ThrudTheBarbarian/pbxl/website/pbxl.rw/Pages/2-Progress/Data/AEAC4389-E904-44D9-B1DD-189116DEF3CA.jpg

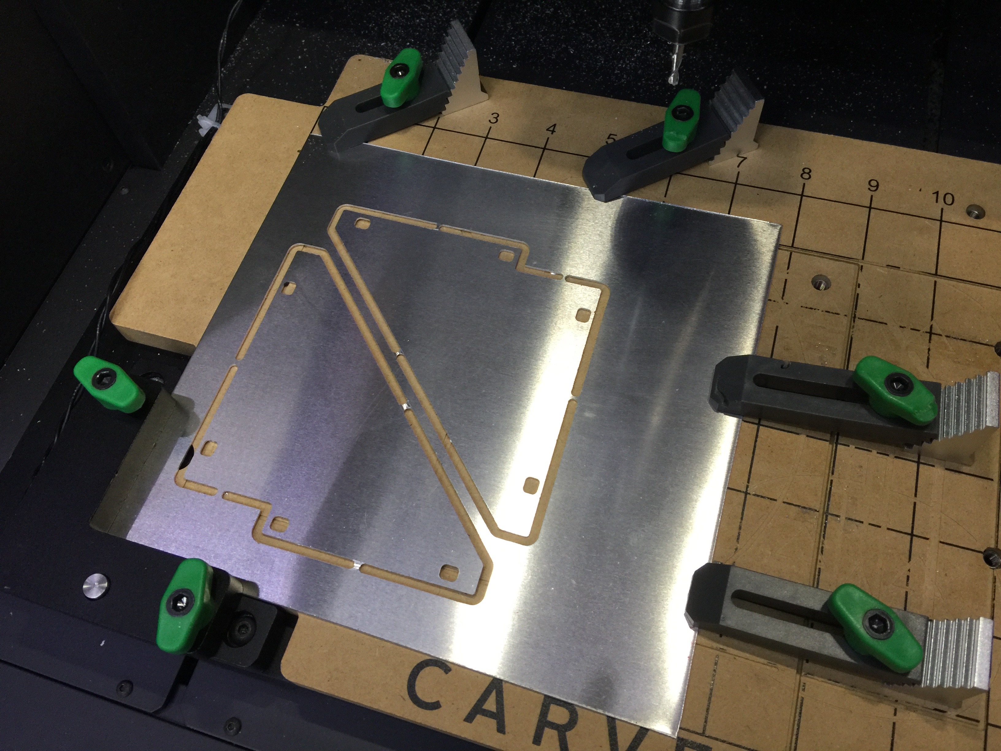
website/pbxl.rw/Pages/2-Progress/Data/AEAC4389-E904-44D9-B1DD-189116DEF3CA.jpg
