ThrudTheBarbarian/pbxl/website/pbxl.rw/Pages/6-The-enclosure/Data/C4889342-5B7F-4F15-AAC2-C0760A052CDE.jpg

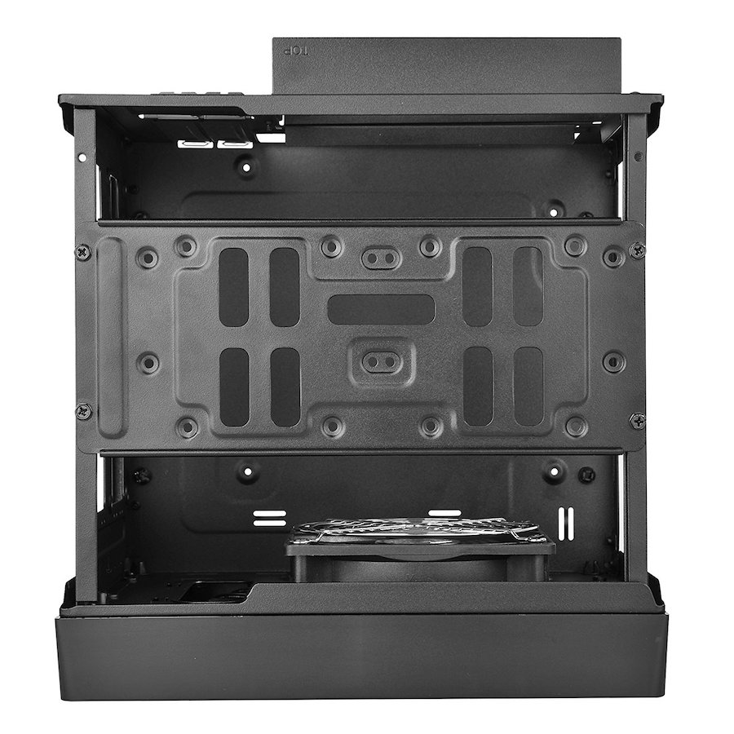
website/pbxl.rw/Pages/6-The-enclosure/Data/C4889342-5B7F-4F15-AAC2-C0760A052CDE.jpg
