ThrudTheBarbarian/pbxl/README.md

# pbxl
Experiment in using an XMOS chip for a low latency serial connection to enable a parallel bus expansion on the Atari XL/XE

# Website
This is very much a work-in-progress, but the website rendered from the source herein [is available here](http://pbxl.oobergeek.net/)
