ThrudTheBarbarian/pbxl/hw/pbxl/pbxl.runs/impl_1/.init_design.begin.rst

<?xml version="1.0"?>
<ProcessHandle Version="1" Minor="0">
    <Process Command=".planAhead." Owner="simon" Host="Vivado" Pid="18662">
    </Process>
</ProcessHandle>
