ThrudTheBarbarian/pbxl/hw/pbxl/pbxl.runs/impl_1/.vivado.begin.rst

<?xml version="1.0"?>
<ProcessHandle Version="1" Minor="0">
    <Process Command="vivado" Owner="simon" Host="Vivado" Pid="18620">
    </Process>
</ProcessHandle>
