ThrudTheBarbarian/pbxl/boards/xe-exerciser/xmosio1.png

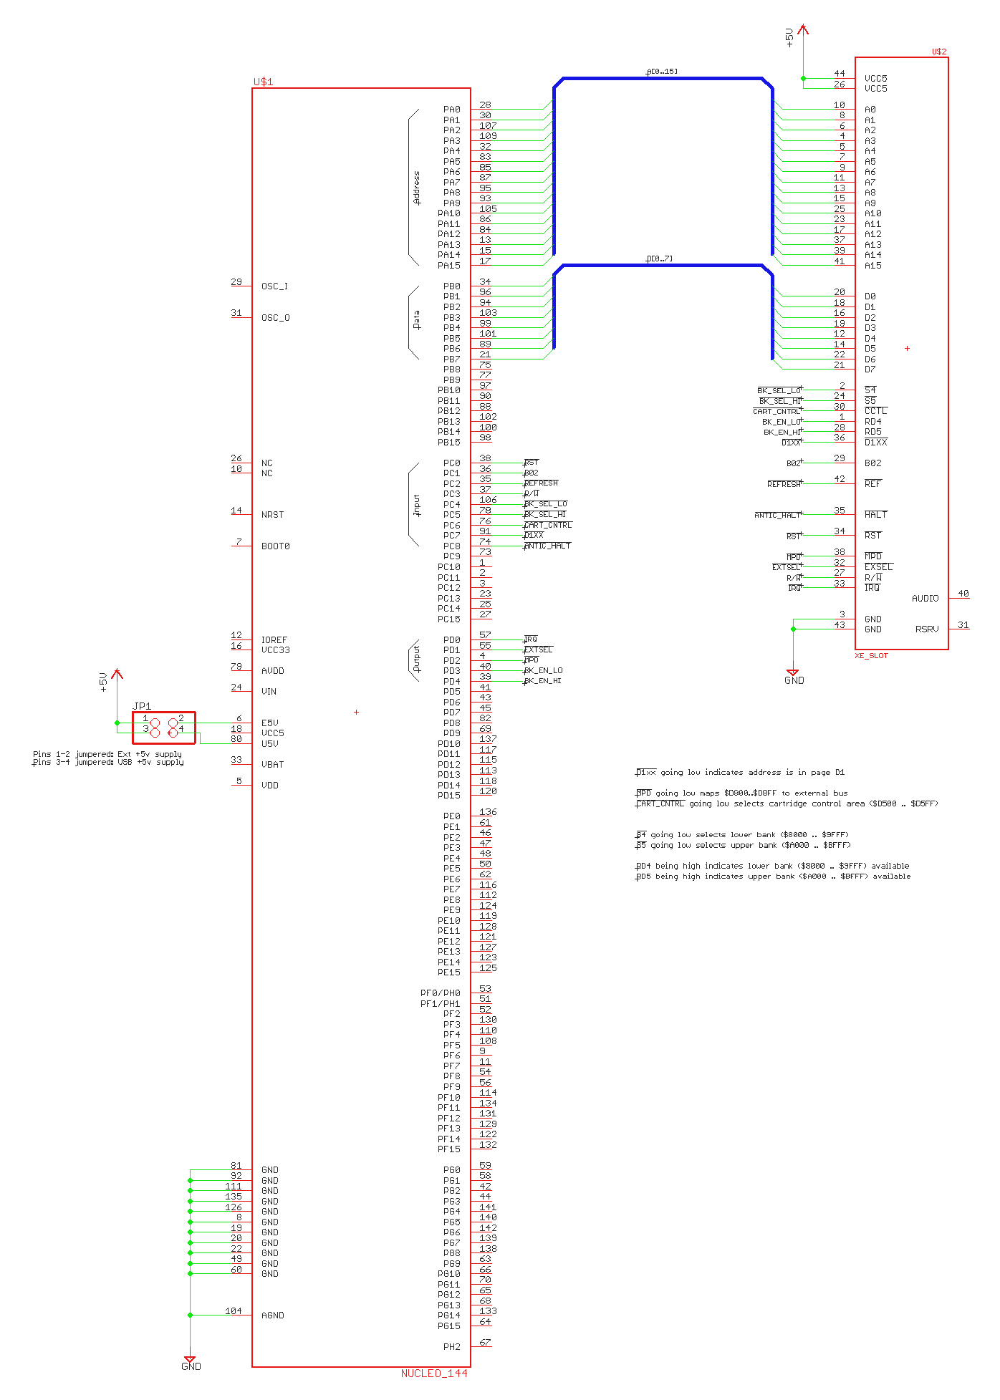
boards/xe-exerciser/xmosio1.png
