ThrudTheBarbarian/pbxl/boards/xio2/psu/3v3.png

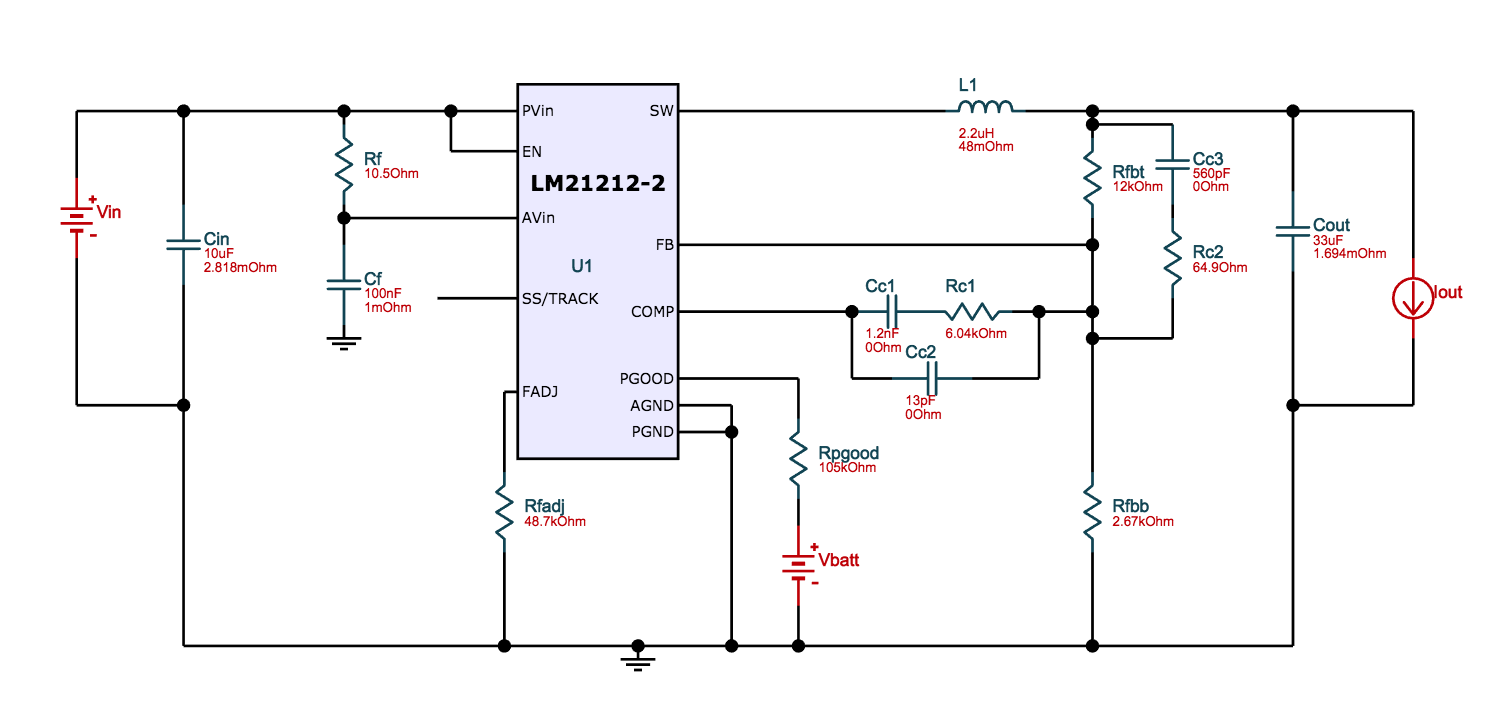
boards/xio2/psu/3v3.png
