ThrudTheBarbarian/pbxl/imgs/xlpb-busIO-rev0.png

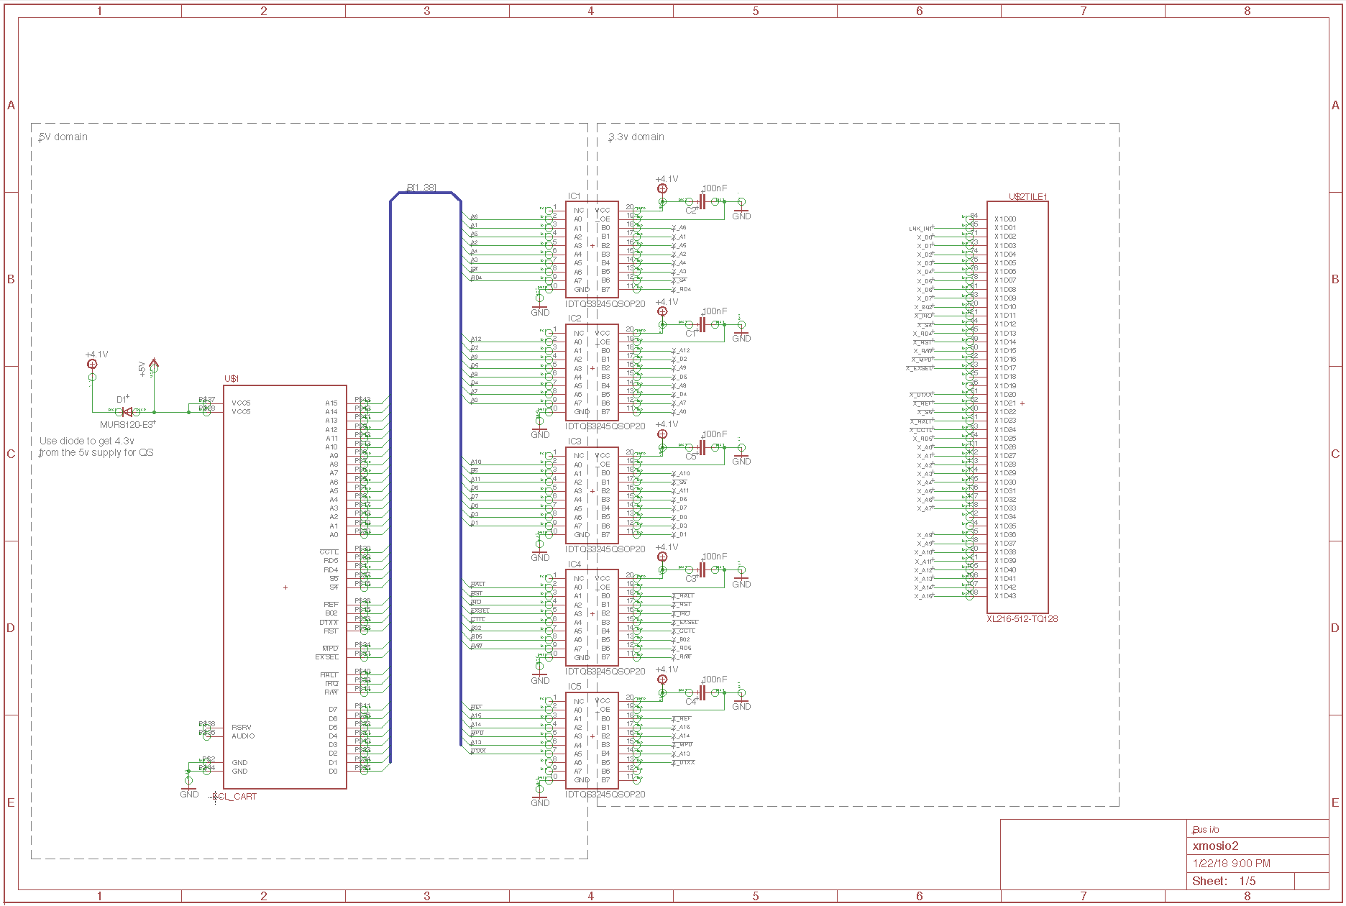
imgs/xlpb-busIO-rev0.png
