ThrudTheBarbarian/pbxl/imgs/xlpb-jtag-rev0.png

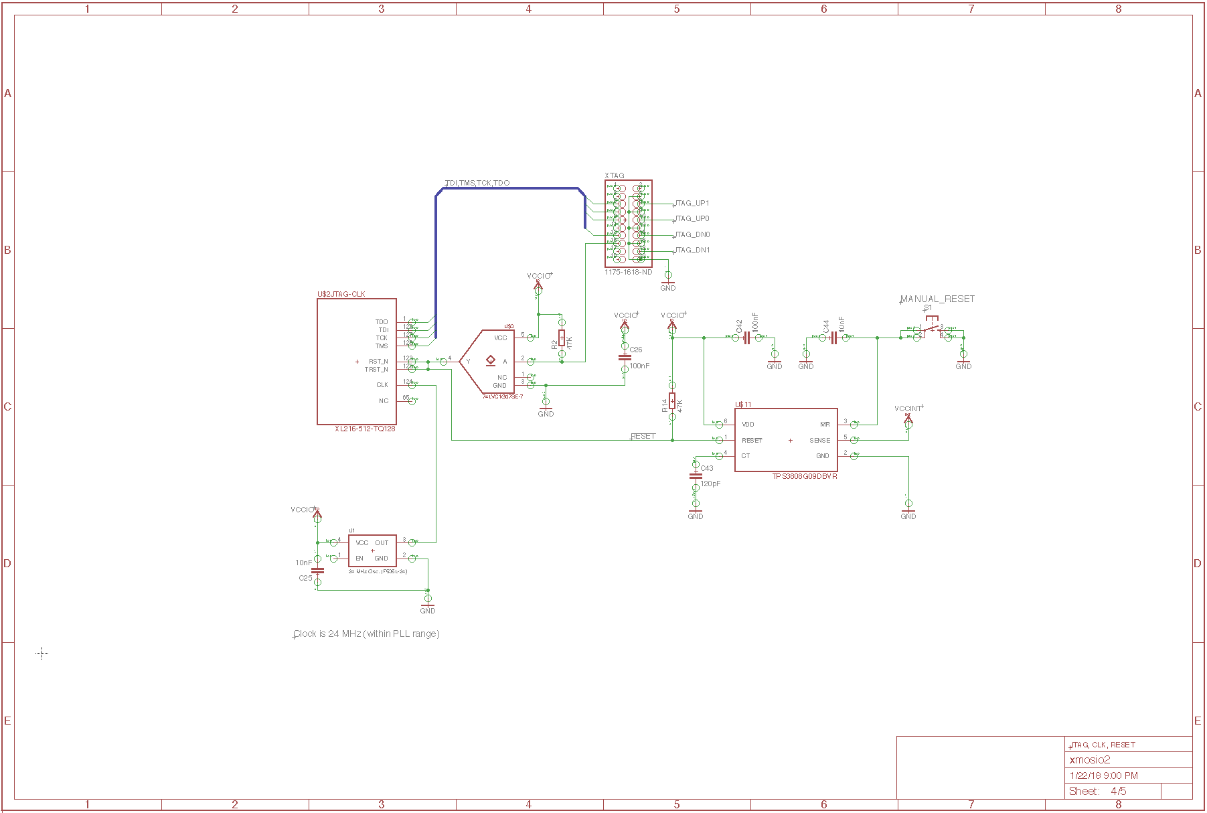
imgs/xlpb-jtag-rev0.png
