ThrudTheBarbarian/pbxl/imgs/xlpb-link-rev0.png

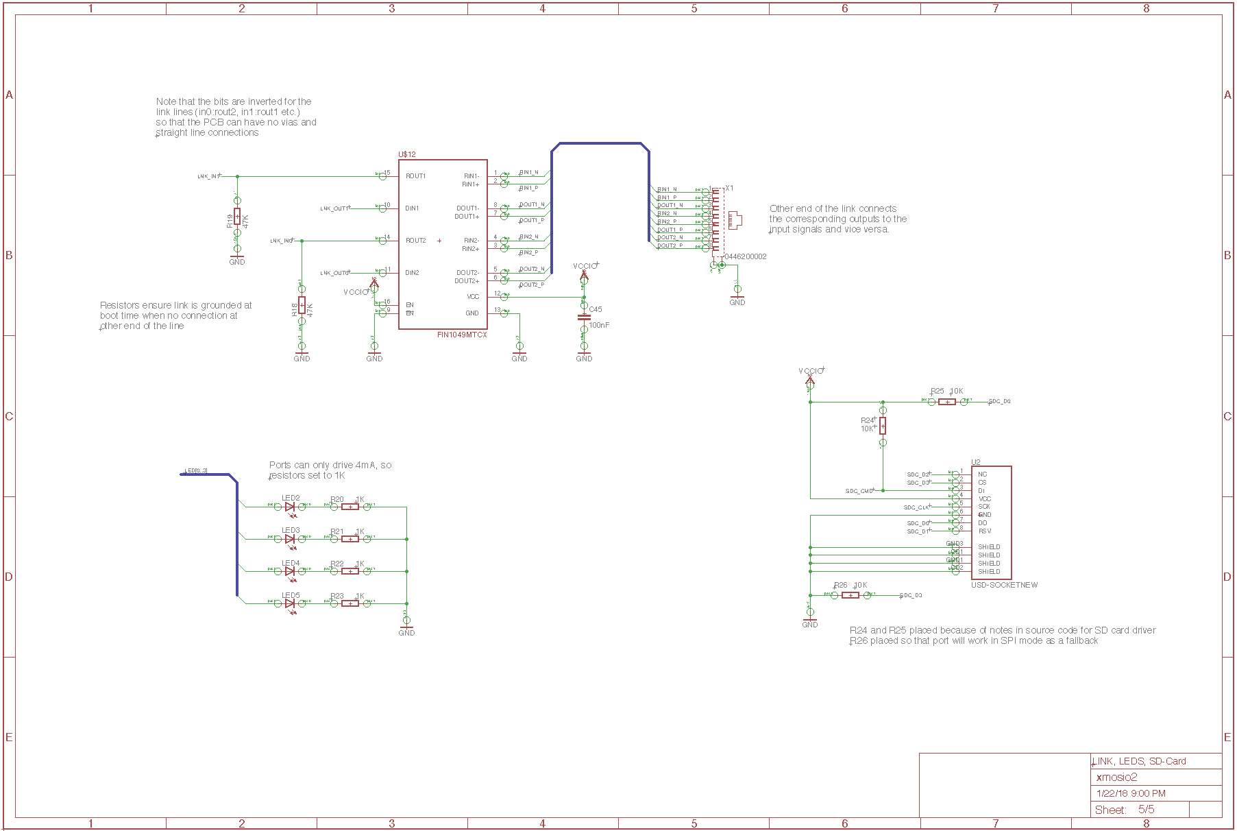
imgs/xlpb-link-rev0.png
