ThrudTheBarbarian/pbxl/imgs/xlpb-memory-rev0.png

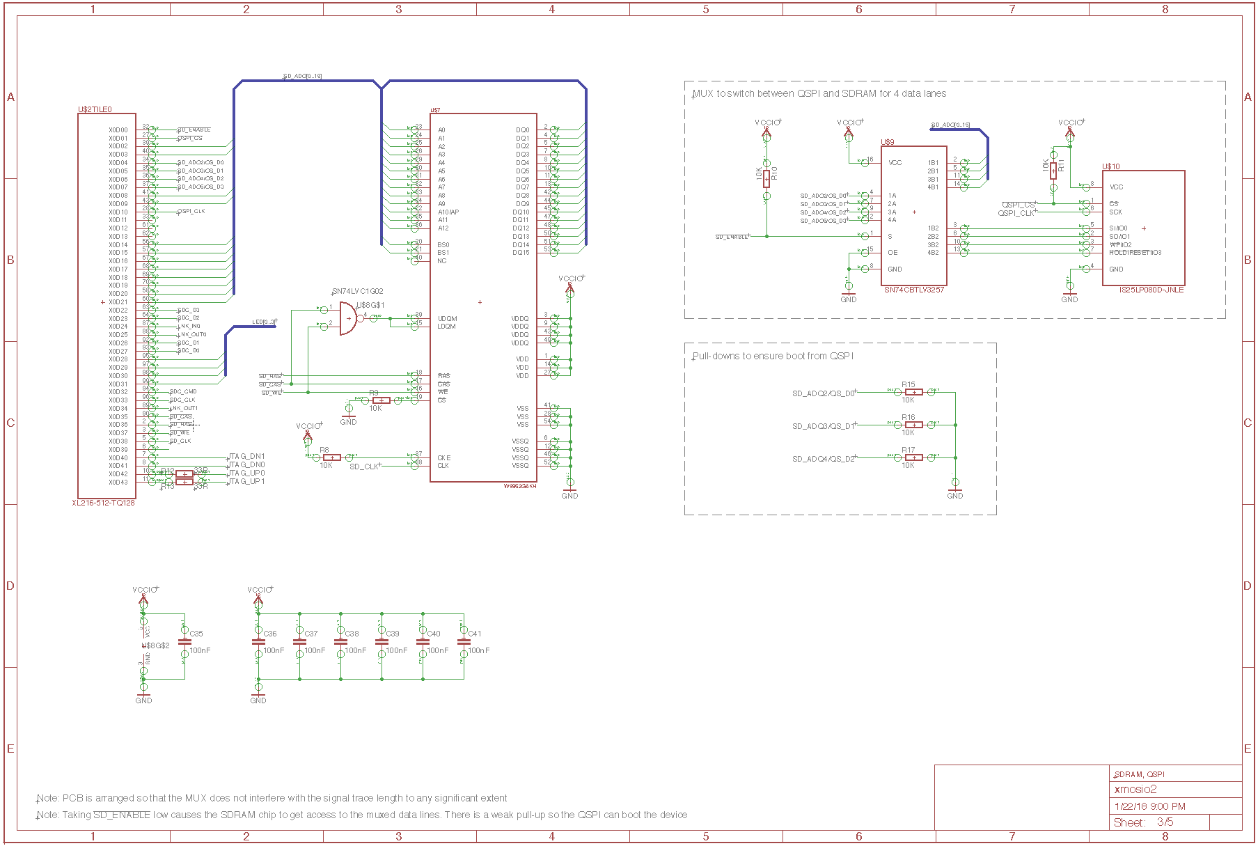
imgs/xlpb-memory-rev0.png
