ThrudTheBarbarian/pbxl/imgs/xlpb-memory-rev1.png

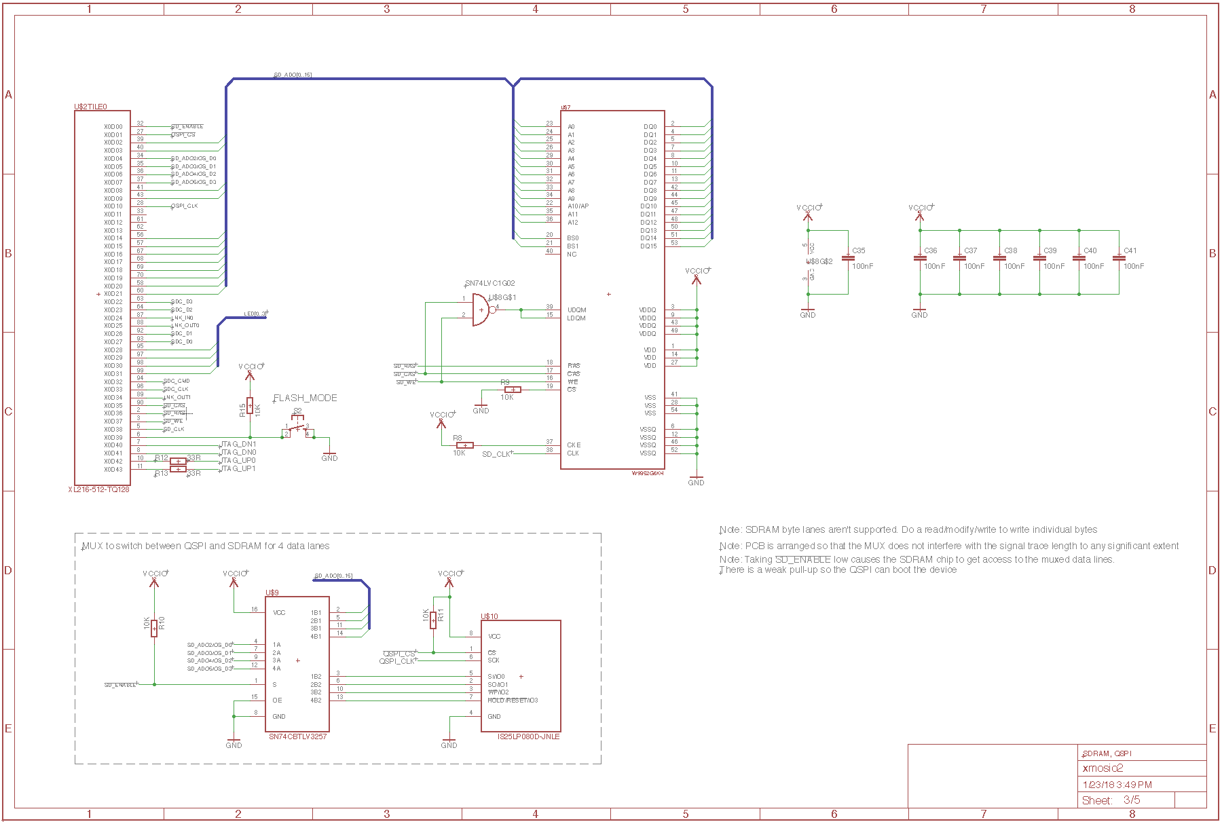
imgs/xlpb-memory-rev1.png
