ThrudTheBarbarian/pbxl/imgs/xlpb-power-rev0.png

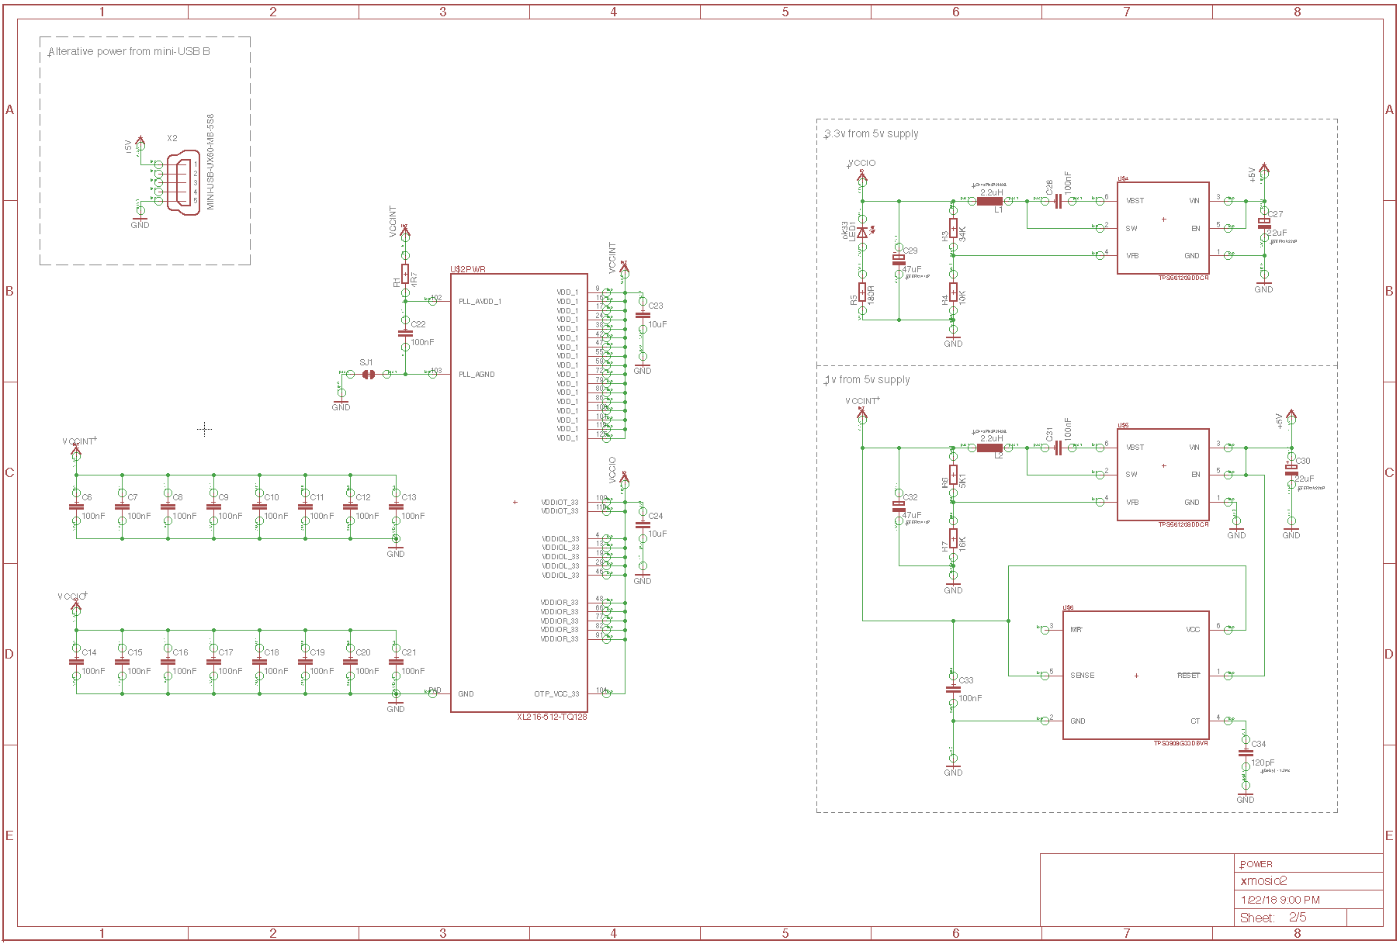
imgs/xlpb-power-rev0.png
