ThrudTheBarbarian/pbxl/imgs/xlpb-power-rev1.png

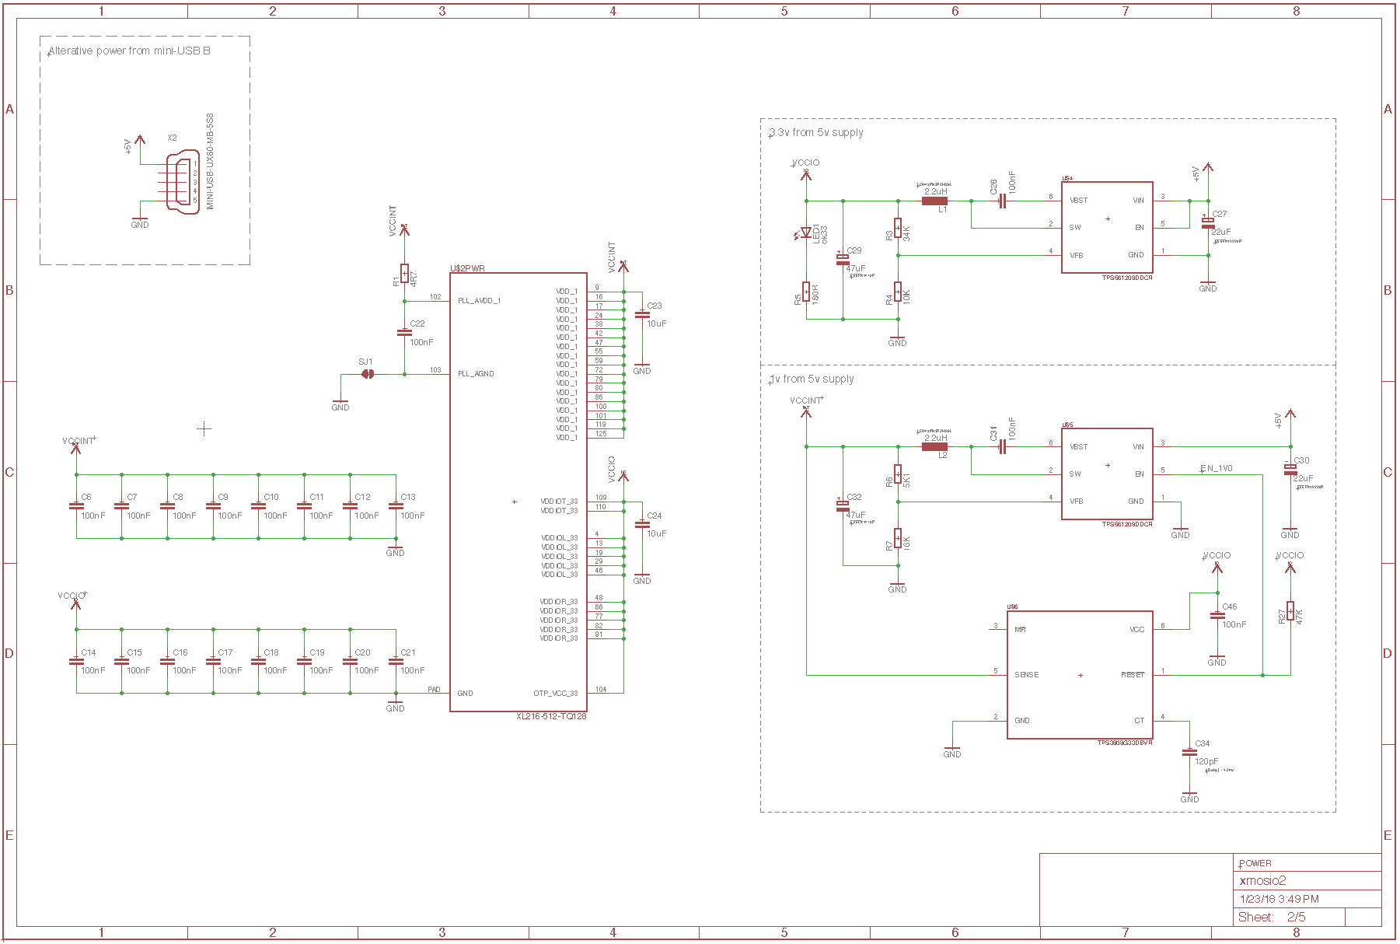
imgs/xlpb-power-rev1.png
