ThrudTheBarbarian/pbxl/imgs/xlpb-routed-board-rev1.png

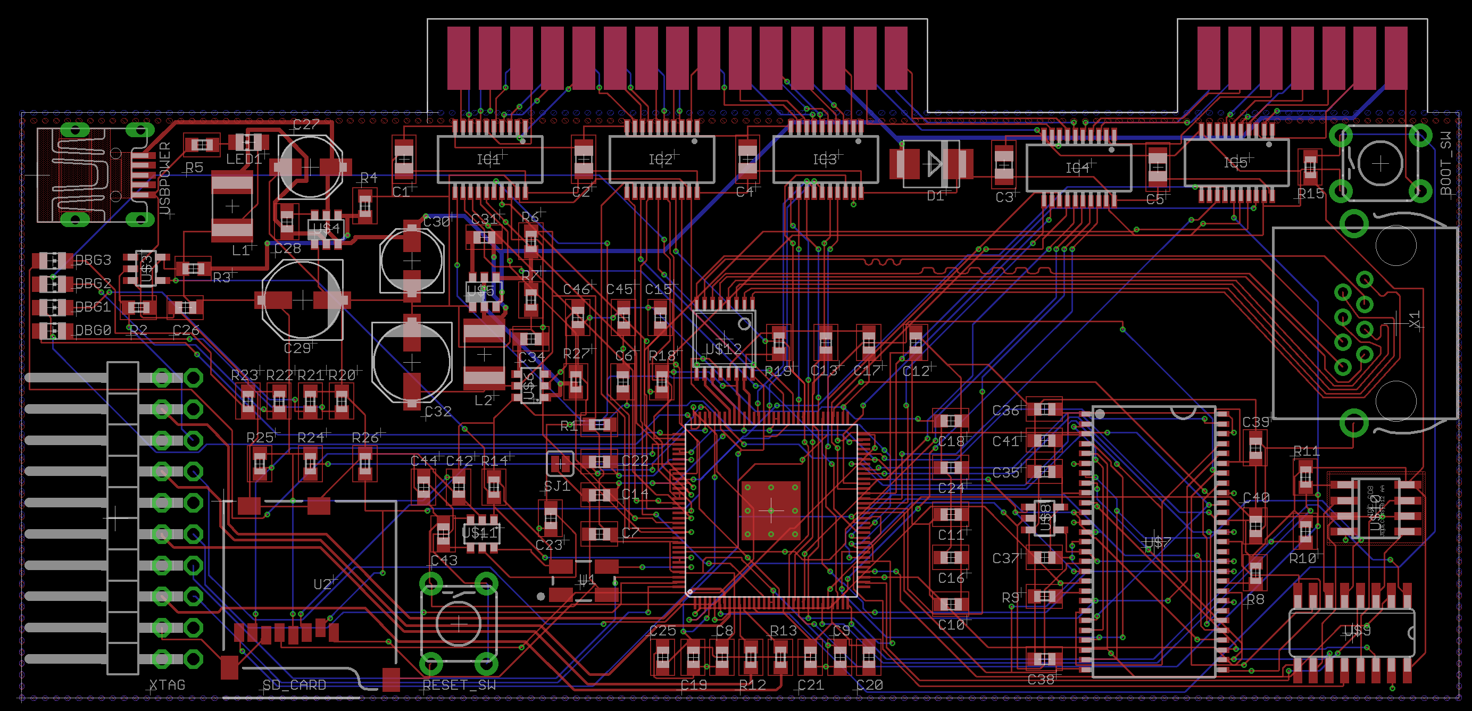
imgs/xlpb-routed-board-rev1.png
