ThrudTheBarbarian/pbxl/imgs/zoomed-in-route.png

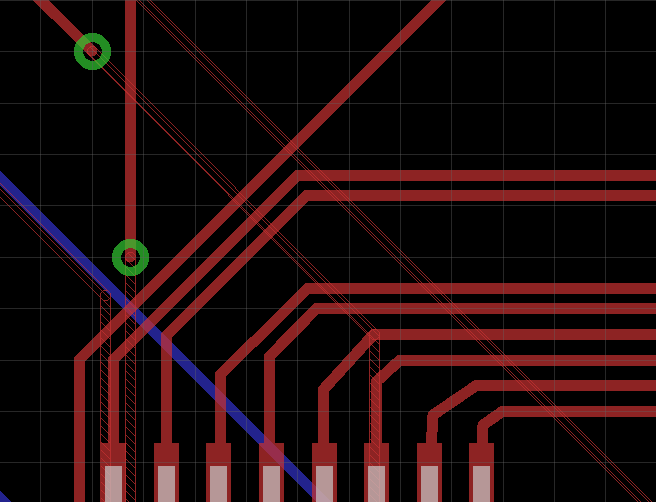
imgs/zoomed-in-route.png
