ThrudTheBarbarian/pbxl/website/pbxl.rw/Pages/2-Progress/Data/1A350FC6-FAAA-49F8-BF6E-91D656A8CBC7.png

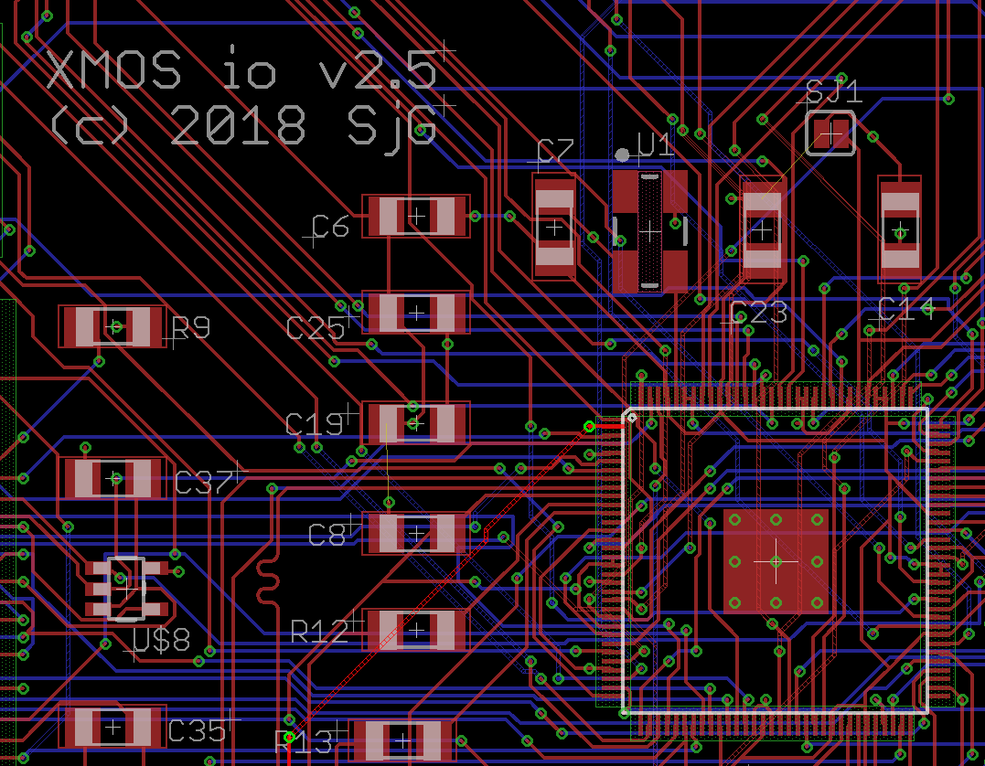
website/pbxl.rw/Pages/2-Progress/Data/1A350FC6-FAAA-49F8-BF6E-91D656A8CBC7.png
