ThrudTheBarbarian/pbxl/website/pbxl.rw/Pages/2-Progress/Data/1B0F9AB8-F616-453C-8693-A7A7A7DEBB77.png

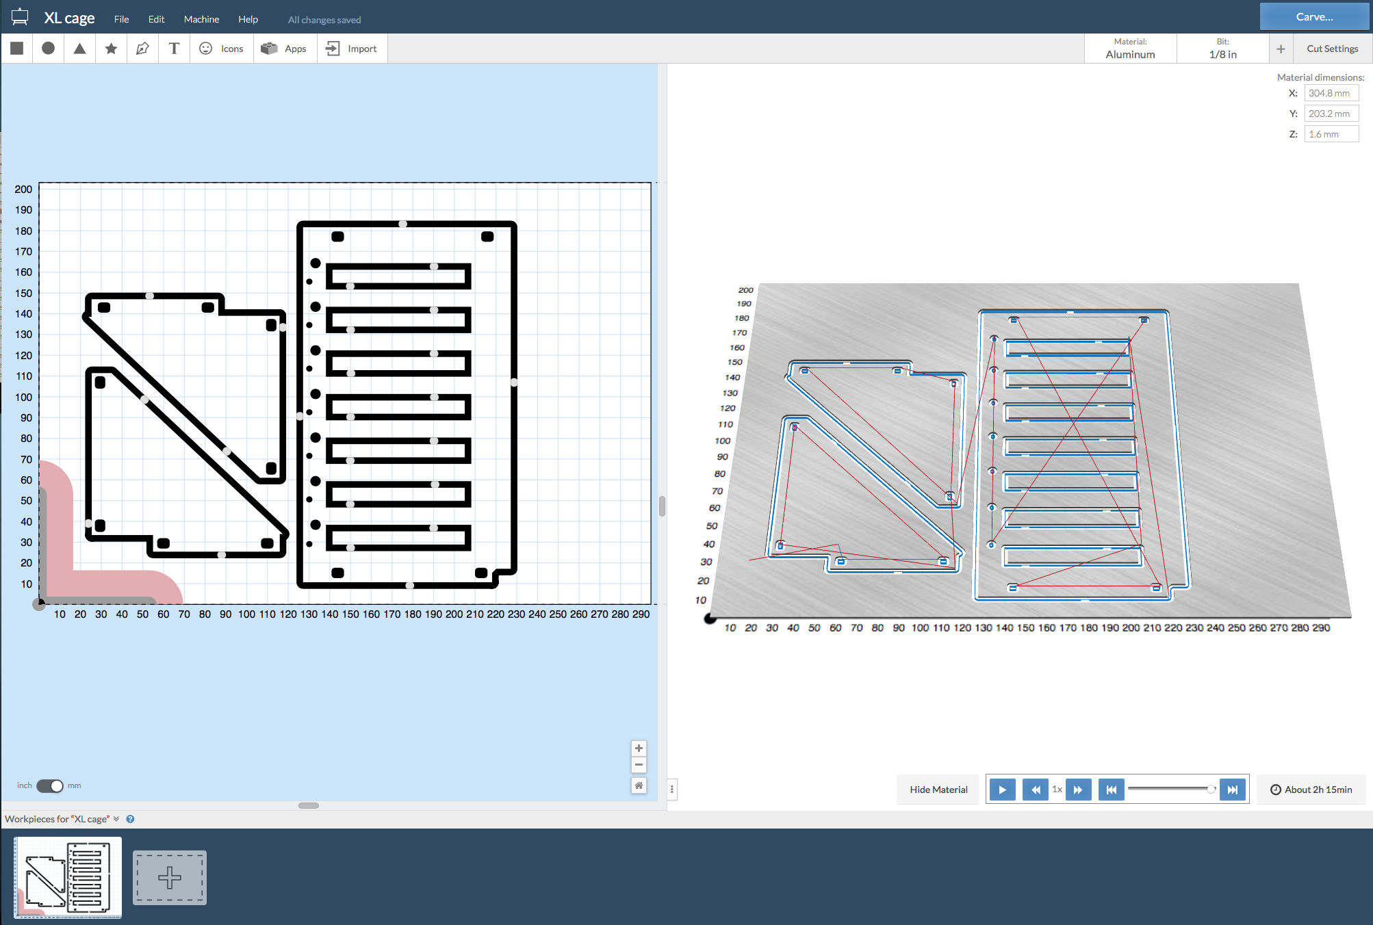
website/pbxl.rw/Pages/2-Progress/Data/1B0F9AB8-F616-453C-8693-A7A7A7DEBB77.png
