ThrudTheBarbarian/pbxl/website/pbxl.rw/Pages/2-Progress/Data/1C7E738A-D3AA-4D1F-9418-3796041D196C.png

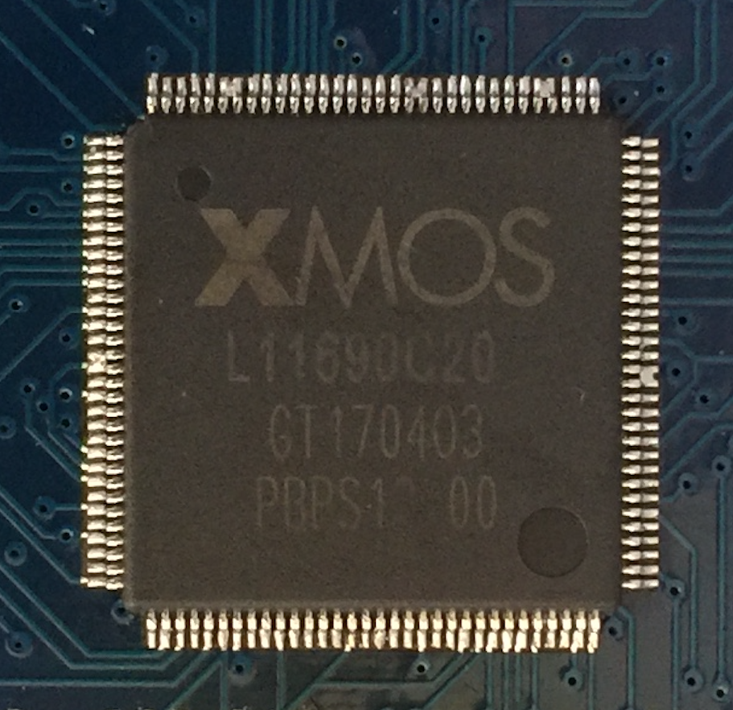
website/pbxl.rw/Pages/2-Progress/Data/1C7E738A-D3AA-4D1F-9418-3796041D196C.png
