ThrudTheBarbarian/pbxl/website/pbxl.rw/Pages/2-Progress/Data/3DAB0634-6217-4E3C-A701-534463F90A3D.jpg

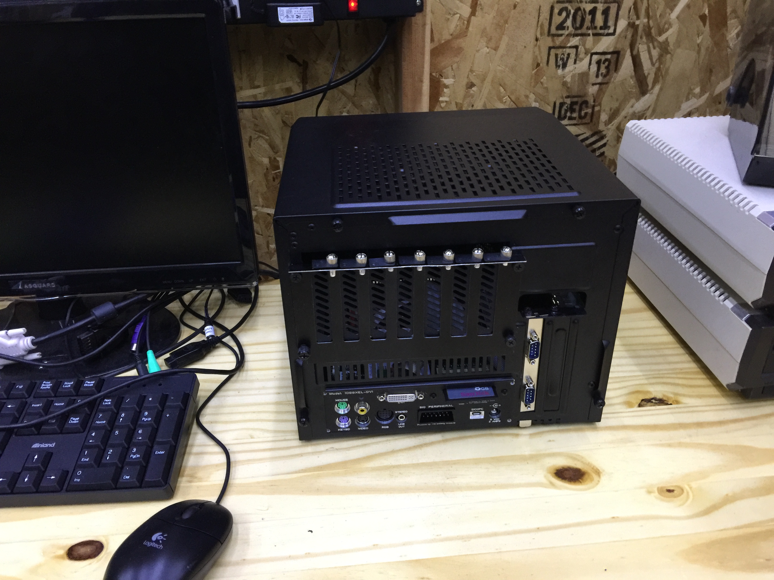
website/pbxl.rw/Pages/2-Progress/Data/3DAB0634-6217-4E3C-A701-534463F90A3D.jpg
