ThrudTheBarbarian/pbxl/website/pbxl.rw/Pages/2-Progress/Data/3F3F6195-A5A8-46CB-91DC-41BE8269B786.jpg

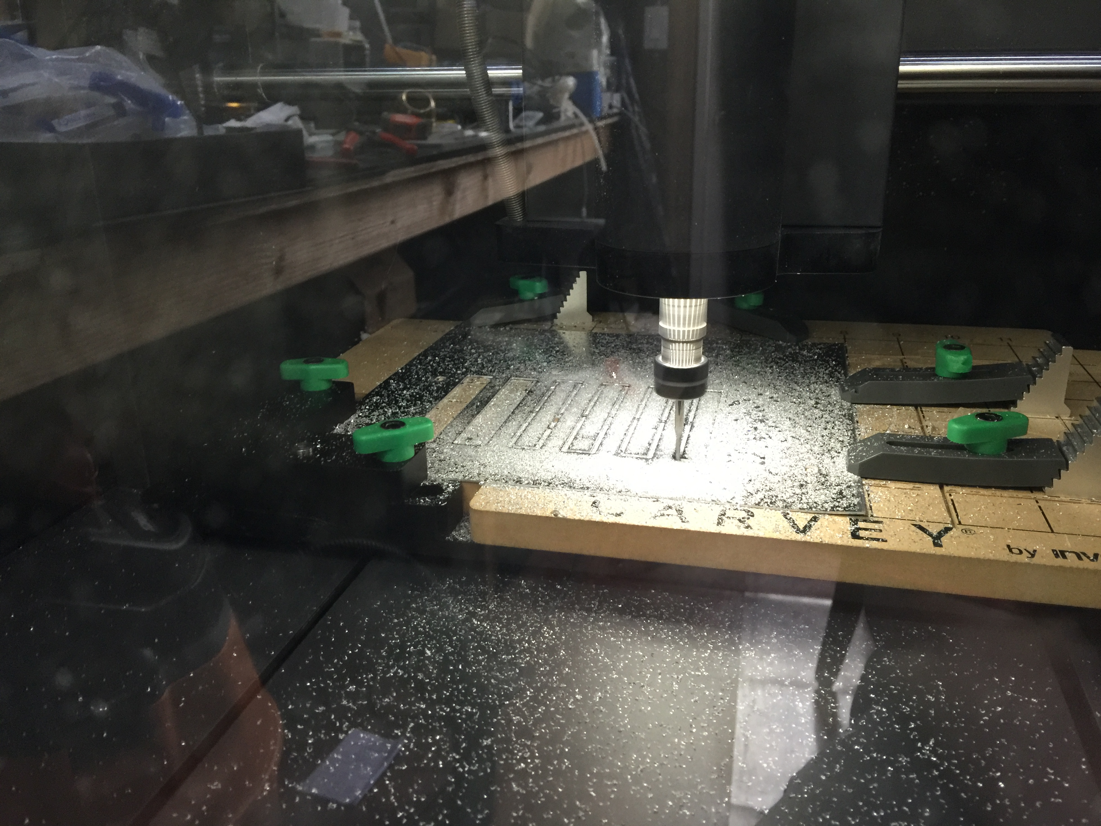
website/pbxl.rw/Pages/2-Progress/Data/3F3F6195-A5A8-46CB-91DC-41BE8269B786.jpg
