ThrudTheBarbarian/pbxl/website/pbxl.rw/Pages/2-Progress/Data/3F03274B-317E-43D0-84CB-64CE96064F75.jpg

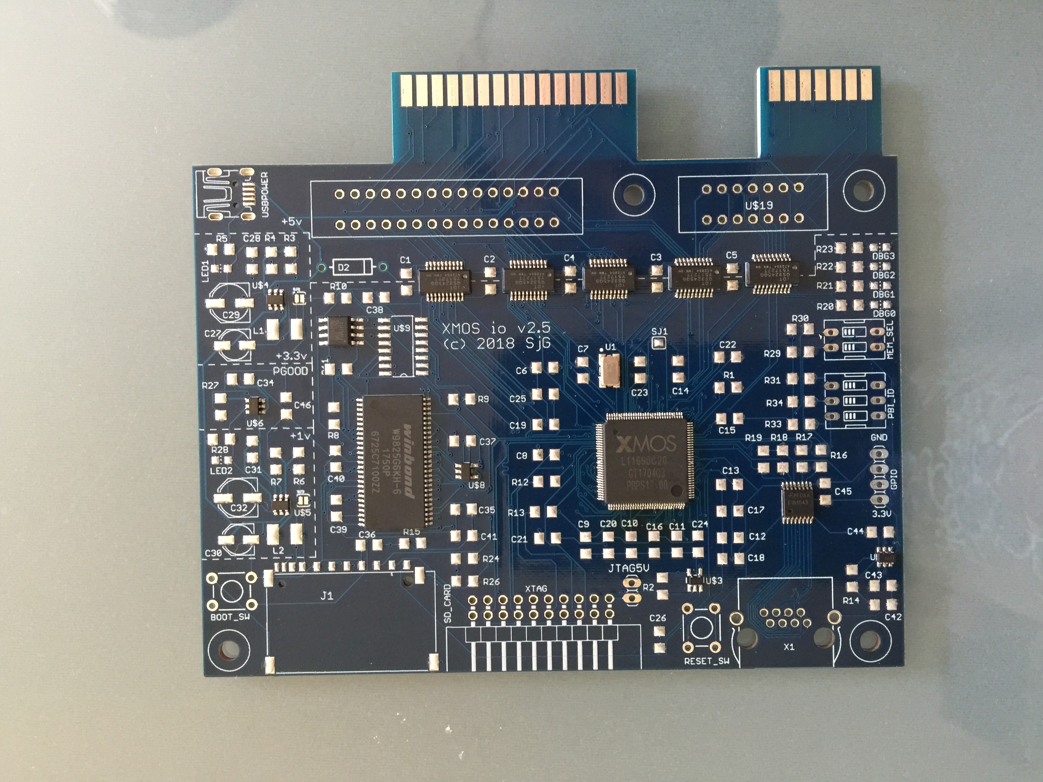
website/pbxl.rw/Pages/2-Progress/Data/3F03274B-317E-43D0-84CB-64CE96064F75.jpg
