ThrudTheBarbarian/pbxl/website/pbxl.rw/Pages/2-Progress/Data/5CC2CB33-A0F2-4685-B665-45586ACAD55F.jpg

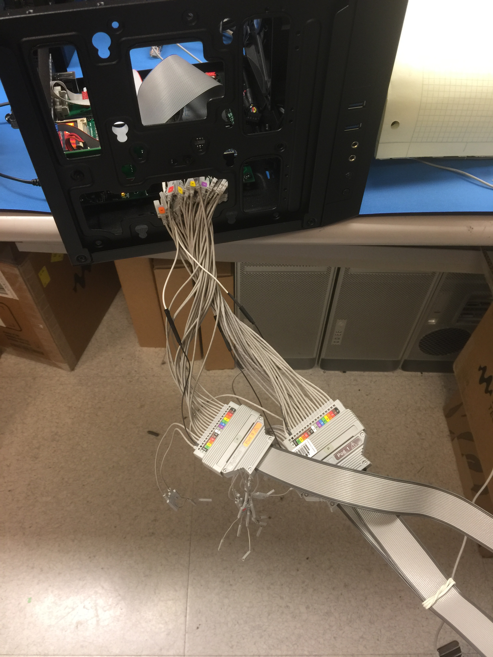
website/pbxl.rw/Pages/2-Progress/Data/5CC2CB33-A0F2-4685-B665-45586ACAD55F.jpg
