ThrudTheBarbarian/pbxl/website/pbxl.rw/Pages/2-Progress/Data/5F7FCE03-E13B-475F-921D-7E2F098FD537.png

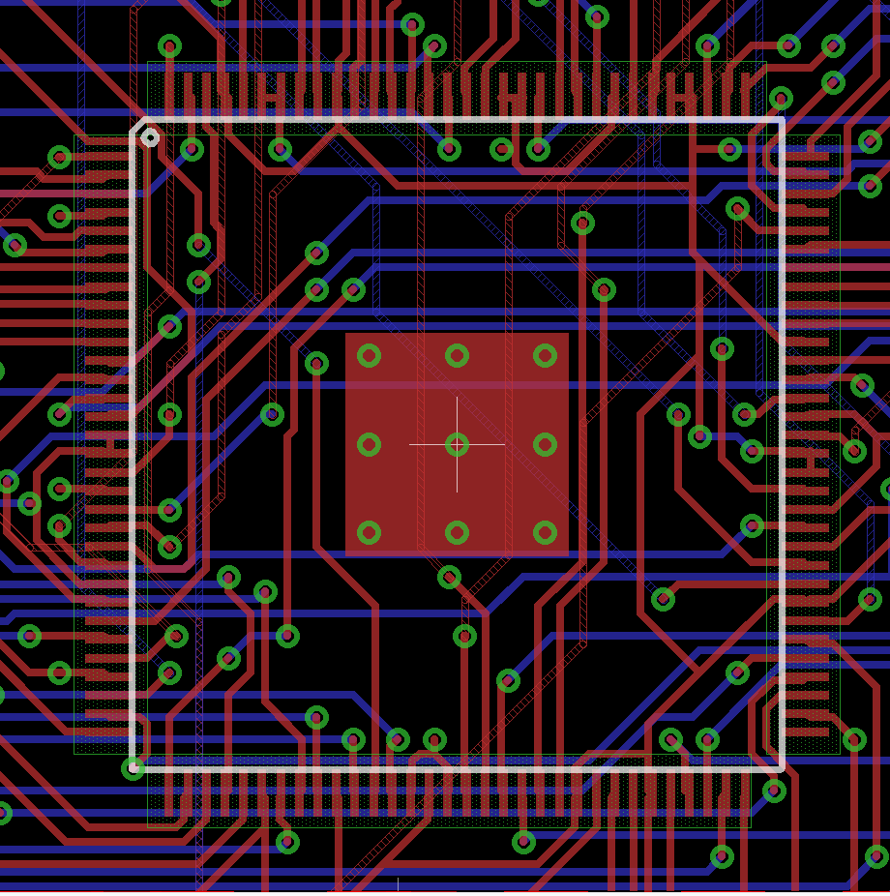
website/pbxl.rw/Pages/2-Progress/Data/5F7FCE03-E13B-475F-921D-7E2F098FD537.png
