ThrudTheBarbarian/pbxl/website/pbxl.rw/Pages/2-Progress/Data/06B7E34B-8387-4882-8F7E-89500C3B1F9D.jpg

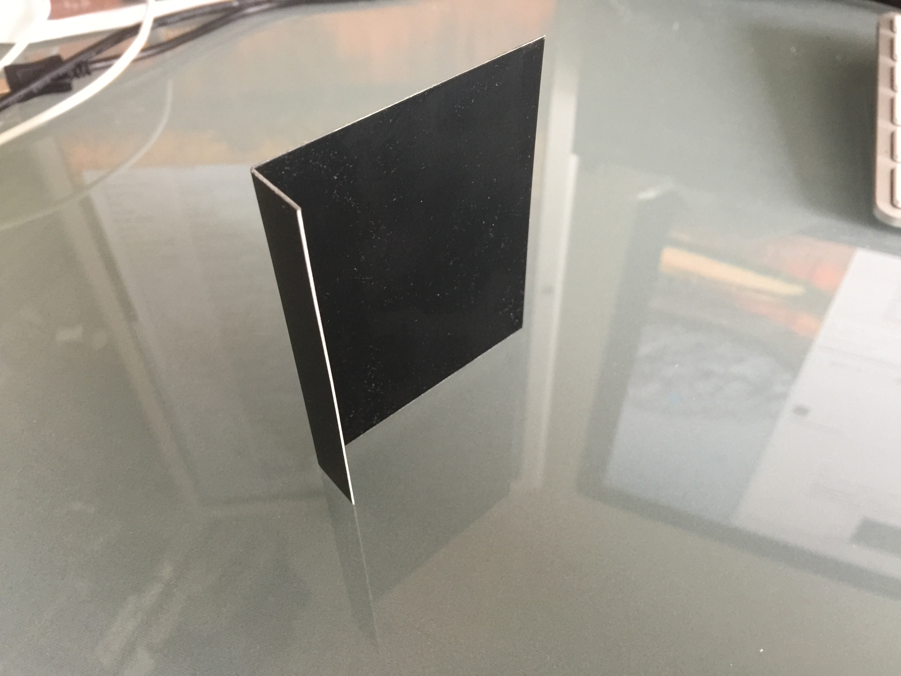
website/pbxl.rw/Pages/2-Progress/Data/06B7E34B-8387-4882-8F7E-89500C3B1F9D.jpg
