ThrudTheBarbarian/pbxl/website/pbxl.rw/Pages/2-Progress/Data/6BC99DC7-3BBD-4747-B467-B94AFF8781F9.jpg

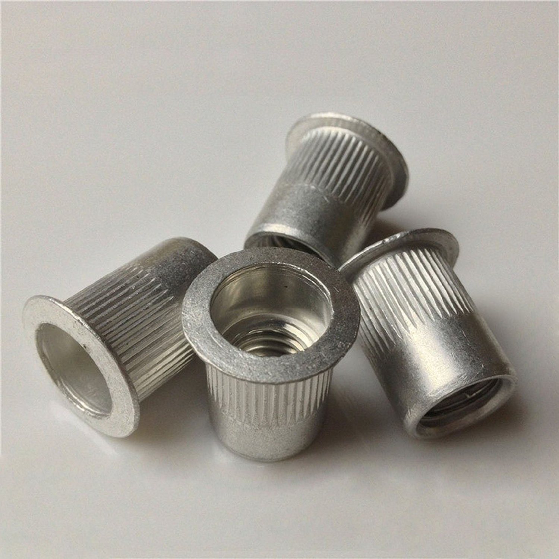
website/pbxl.rw/Pages/2-Progress/Data/6BC99DC7-3BBD-4747-B467-B94AFF8781F9.jpg
