ThrudTheBarbarian/pbxl/website/pbxl.rw/Pages/2-Progress/Data/06FAD4F0-FE67-4289-85A9-1B1E6EAB6E25.jpg

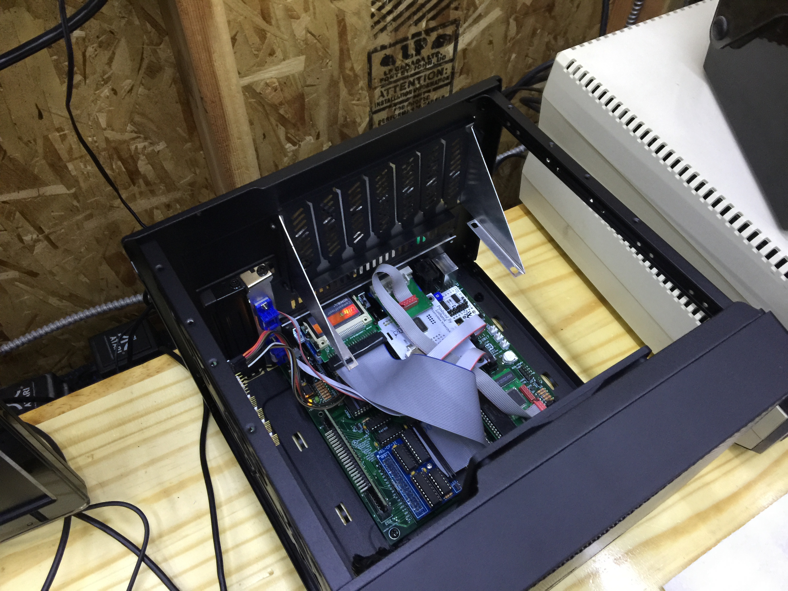
website/pbxl.rw/Pages/2-Progress/Data/06FAD4F0-FE67-4289-85A9-1B1E6EAB6E25.jpg
