ThrudTheBarbarian/pbxl/website/pbxl.rw/Pages/2-Progress/Data/6FC45C67-8954-4B09-AA56-C07B580DA92F.jpg

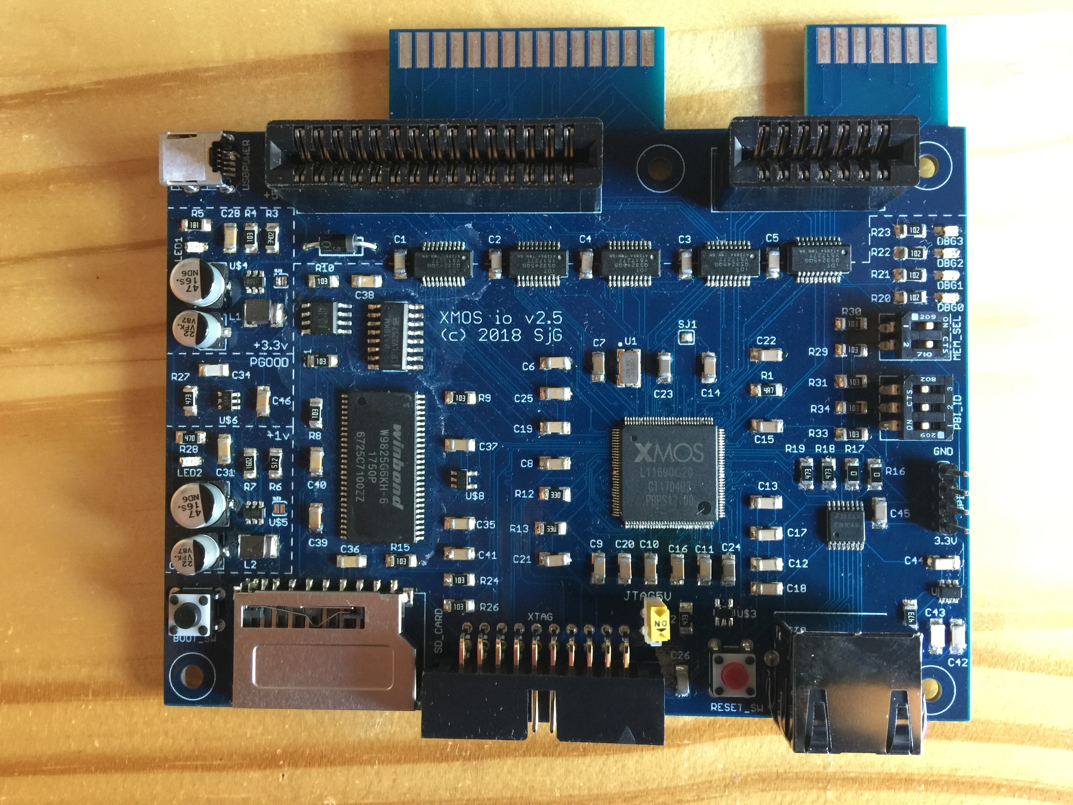
website/pbxl.rw/Pages/2-Progress/Data/6FC45C67-8954-4B09-AA56-C07B580DA92F.jpg
