ThrudTheBarbarian/pbxl/website/pbxl.rw/Pages/2-Progress/Data/7B0A3223-FBE9-4E8A-93E4-F989F4B66E8E.jpg

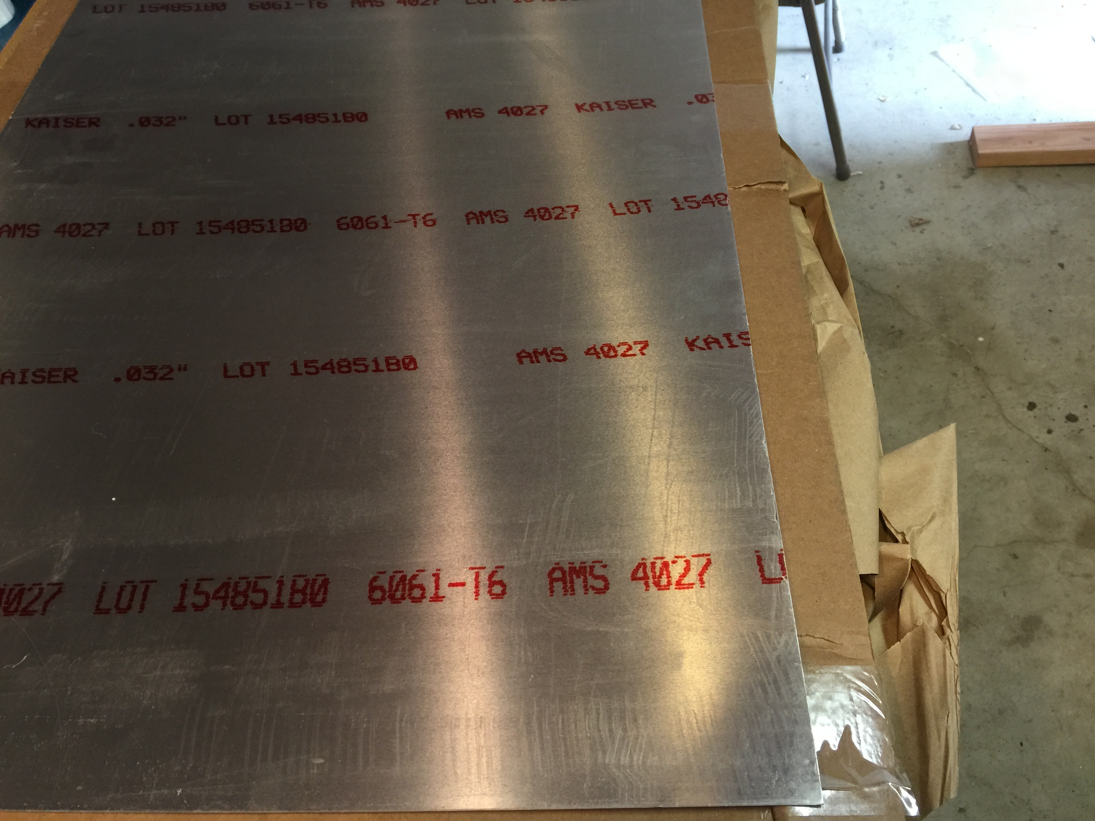
website/pbxl.rw/Pages/2-Progress/Data/7B0A3223-FBE9-4E8A-93E4-F989F4B66E8E.jpg
