ThrudTheBarbarian/pbxl/website/pbxl.rw/Pages/2-Progress/Data/7CF725A2-19D4-4DD7-BCF8-48ADAD6159C0.jpg

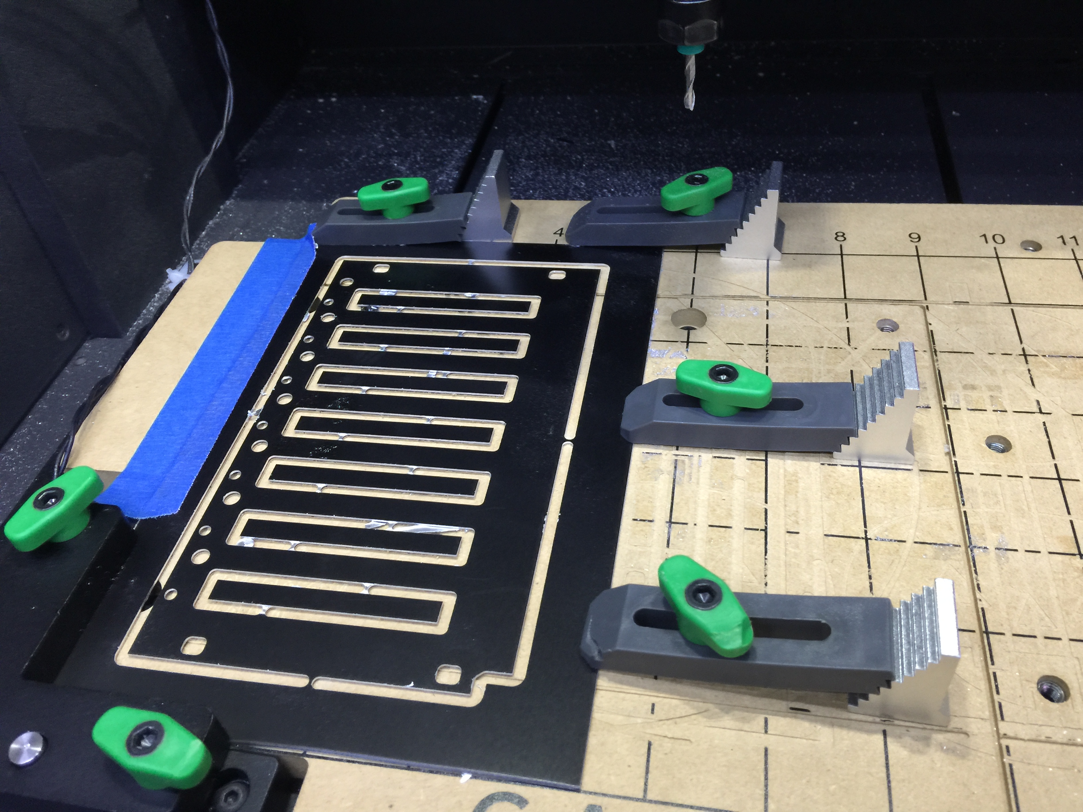
website/pbxl.rw/Pages/2-Progress/Data/7CF725A2-19D4-4DD7-BCF8-48ADAD6159C0.jpg
