ThrudTheBarbarian/pbxl/website/pbxl.rw/Pages/2-Progress/Data/7DB78293-6F2E-43C0-B8BA-ECDFAC49E958.jpg

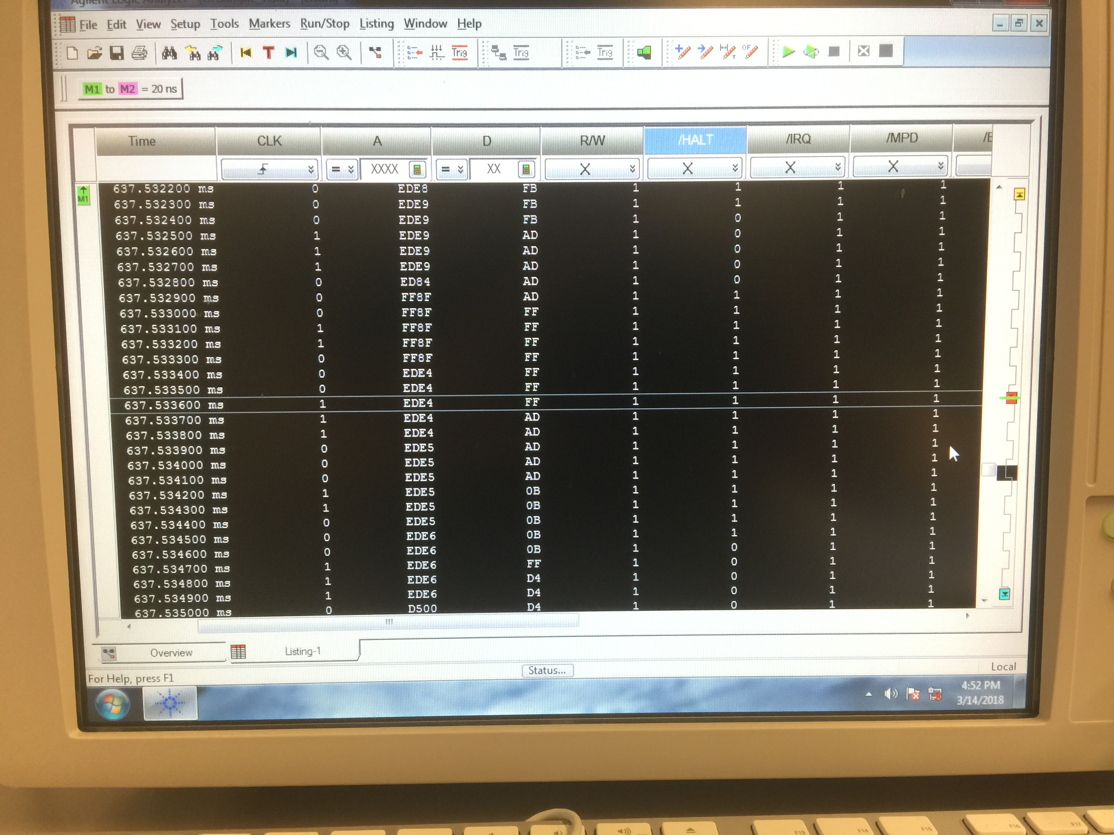
website/pbxl.rw/Pages/2-Progress/Data/7DB78293-6F2E-43C0-B8BA-ECDFAC49E958.jpg
