ThrudTheBarbarian/pbxl/website/pbxl.rw/Pages/2-Progress/Data/8A59CD9B-30BB-4BA9-A502-34492A075070.JPG

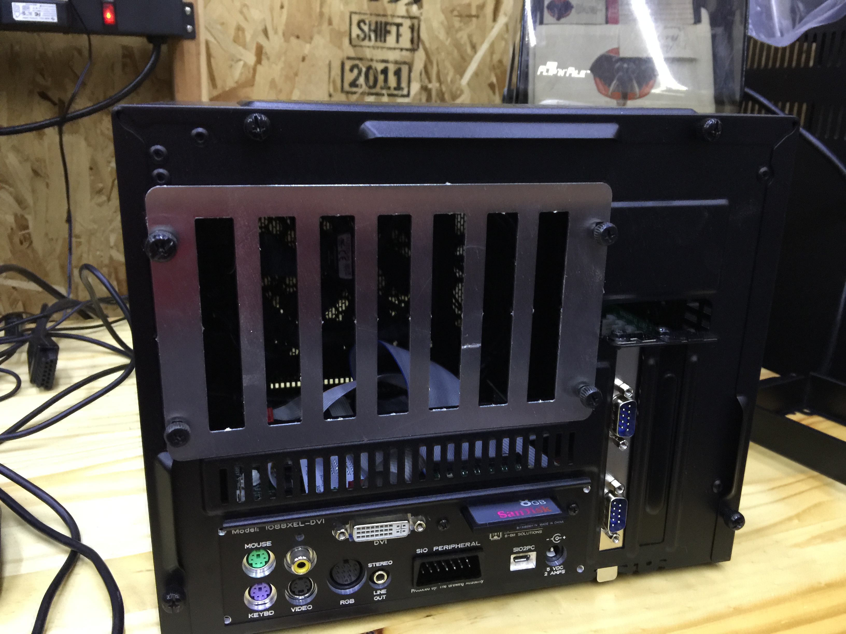
website/pbxl.rw/Pages/2-Progress/Data/8A59CD9B-30BB-4BA9-A502-34492A075070.JPG
