ThrudTheBarbarian/pbxl/website/pbxl.rw/Pages/2-Progress/Data/38C9F0C9-8961-4E3B-AE92-ED53AC3FBF26.jpg

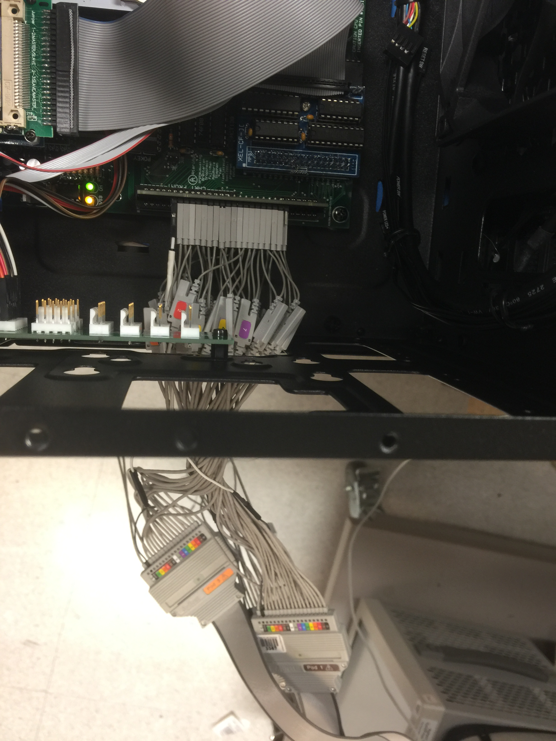
website/pbxl.rw/Pages/2-Progress/Data/38C9F0C9-8961-4E3B-AE92-ED53AC3FBF26.jpg
