ThrudTheBarbarian/pbxl/website/pbxl.rw/Pages/2-Progress/Data/78F31251-1B67-4E1D-B63C-D52C30075A63.jpg

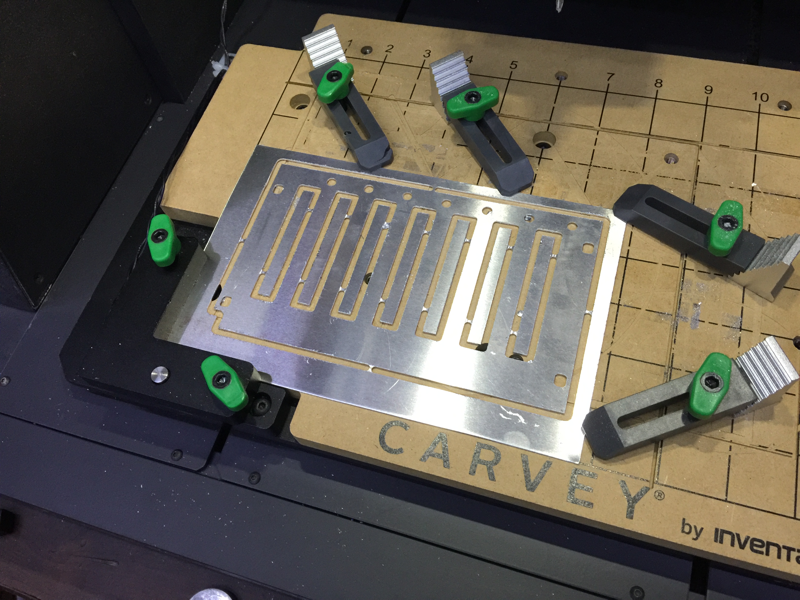
website/pbxl.rw/Pages/2-Progress/Data/78F31251-1B67-4E1D-B63C-D52C30075A63.jpg
