ThrudTheBarbarian/pbxl/website/pbxl.rw/Pages/2-Progress/Data/87D786F8-1D3A-4F75-9190-DF4FFAADDA2C.jpg

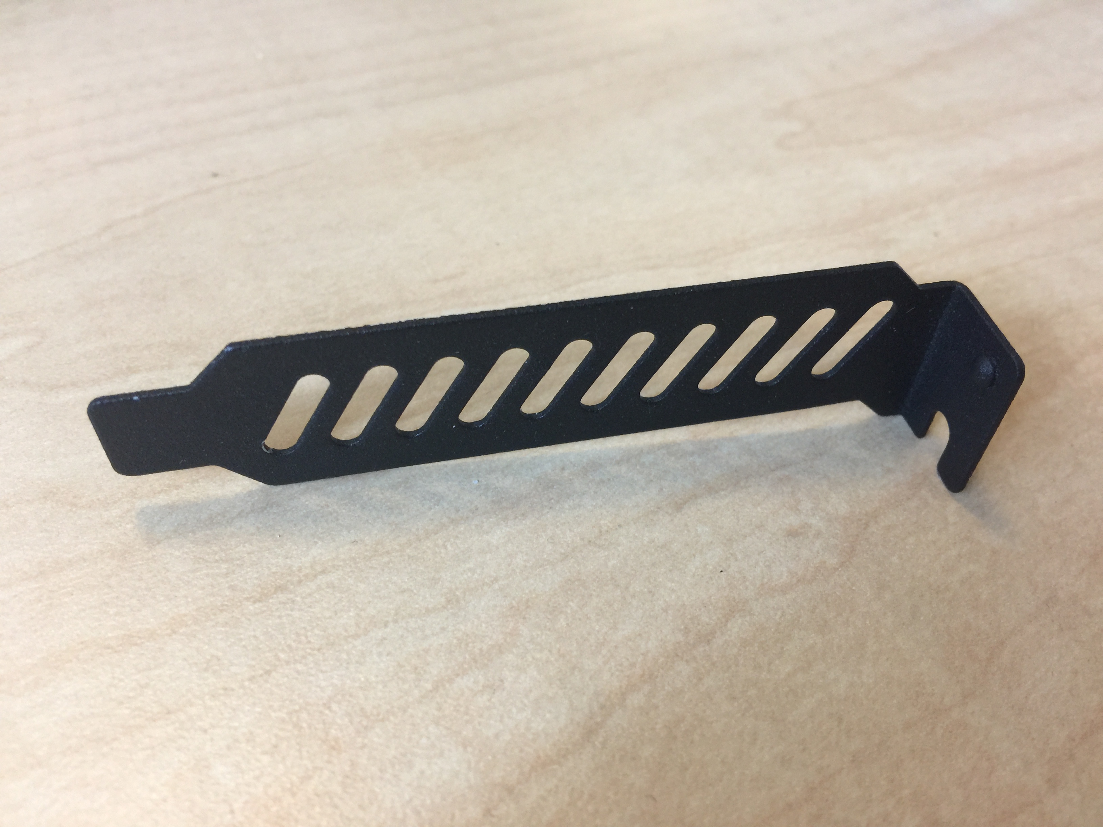
website/pbxl.rw/Pages/2-Progress/Data/87D786F8-1D3A-4F75-9190-DF4FFAADDA2C.jpg
