ThrudTheBarbarian/pbxl/website/pbxl.rw/Pages/2-Progress/Data/146CF28D-24D1-49DC-A463-8CF554C7178F.jpg

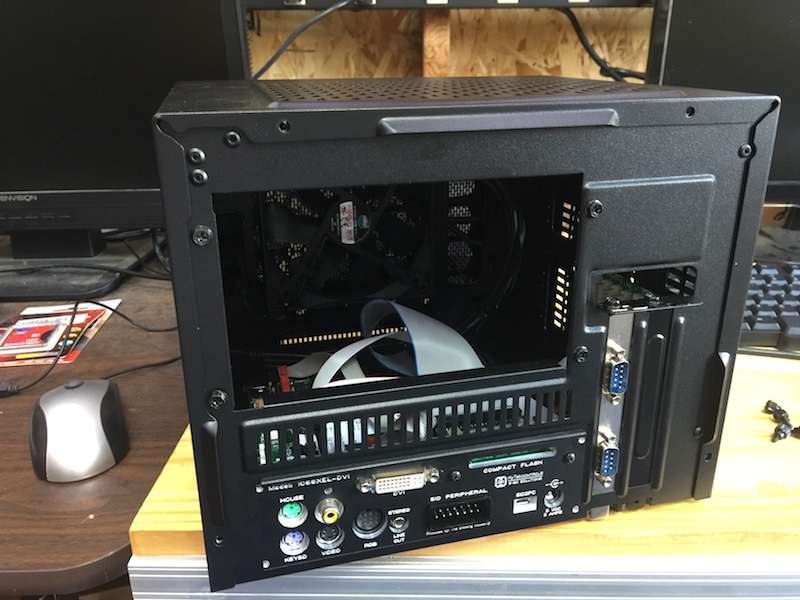
website/pbxl.rw/Pages/2-Progress/Data/146CF28D-24D1-49DC-A463-8CF554C7178F.jpg
