ThrudTheBarbarian/pbxl/website/pbxl.rw/Pages/2-Progress/Data/261C4EFC-F541-462F-B96D-8059C96550FF.png

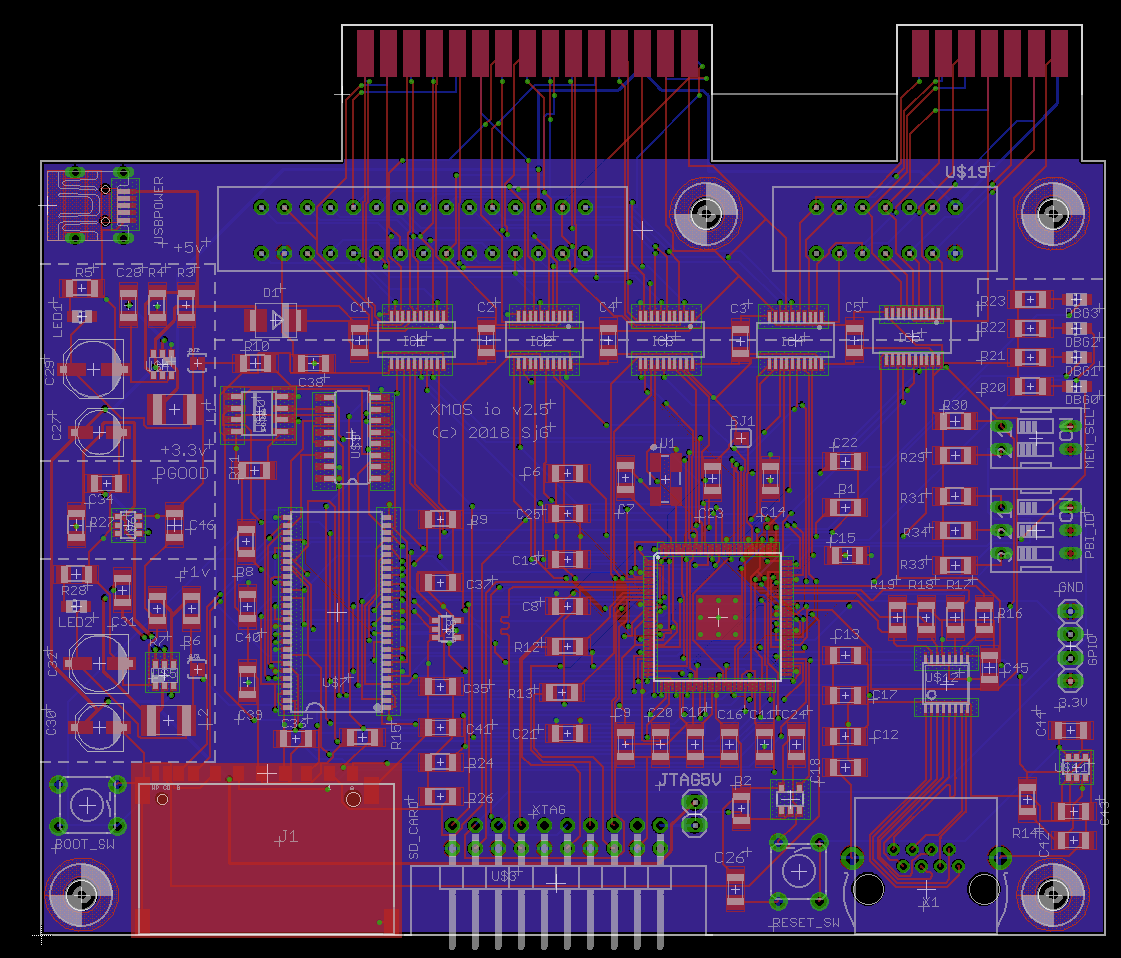
website/pbxl.rw/Pages/2-Progress/Data/261C4EFC-F541-462F-B96D-8059C96550FF.png
