ThrudTheBarbarian/pbxl/website/pbxl.rw/Pages/2-Progress/Data/331CB91B-5984-4092-9C85-3CFB9A391ABF.jpg

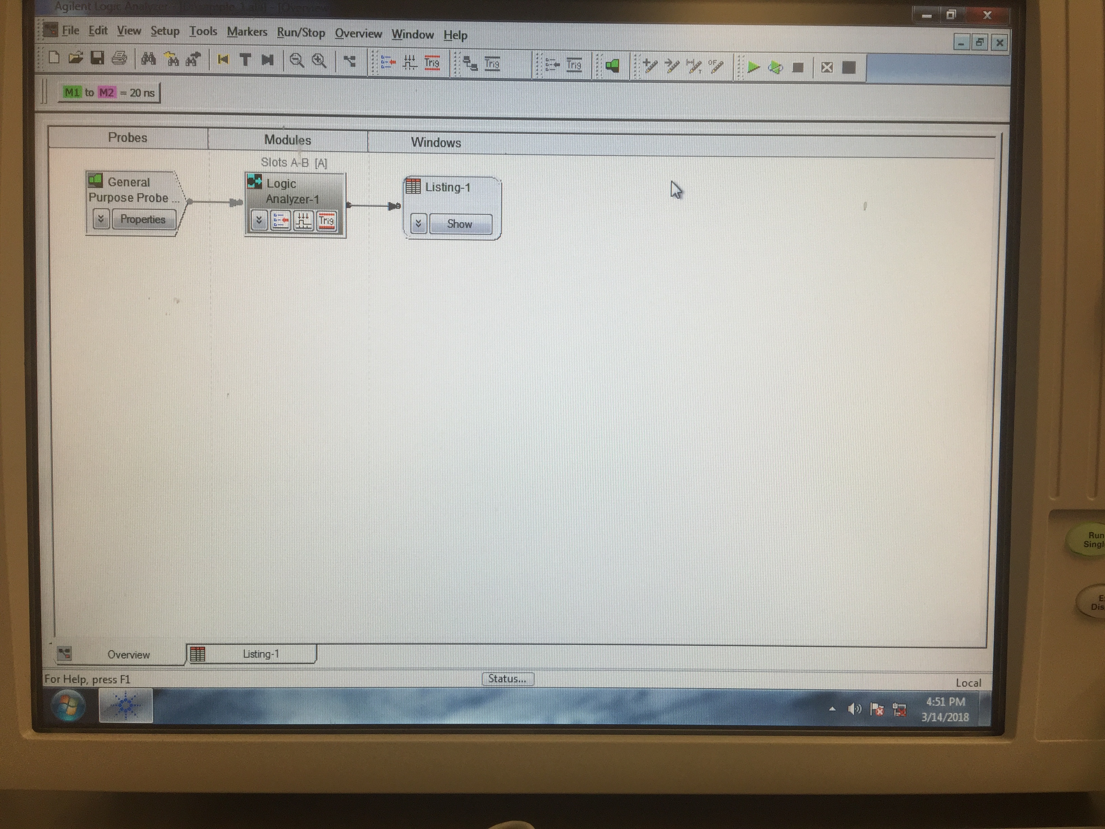
website/pbxl.rw/Pages/2-Progress/Data/331CB91B-5984-4092-9C85-3CFB9A391ABF.jpg
