ThrudTheBarbarian/pbxl/website/pbxl.rw/Pages/2-Progress/Data/589AABD0-D153-48F8-93D9-5920D872CB2B.jpg

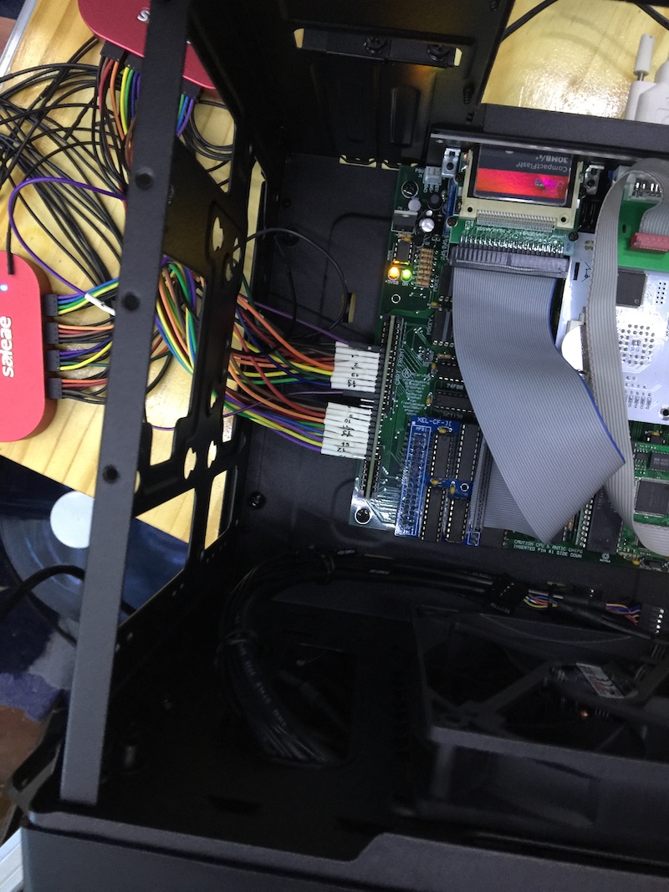
website/pbxl.rw/Pages/2-Progress/Data/589AABD0-D153-48F8-93D9-5920D872CB2B.jpg
