ThrudTheBarbarian/pbxl/website/pbxl.rw/Pages/2-Progress/Data/6675A190-3AD3-4C51-B484-77A3CD570724.png

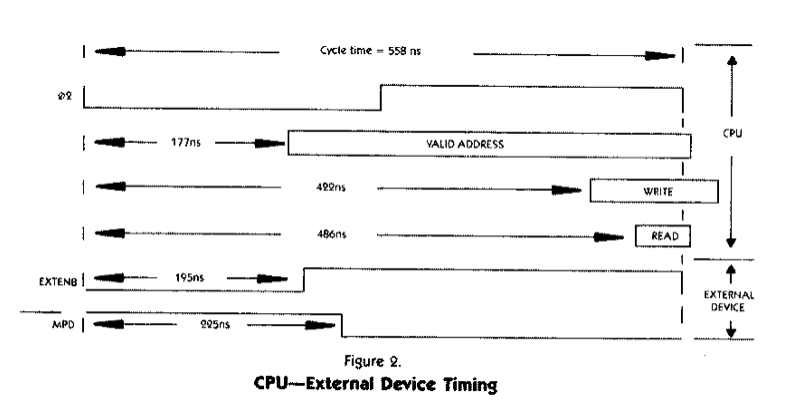
website/pbxl.rw/Pages/2-Progress/Data/6675A190-3AD3-4C51-B484-77A3CD570724.png
