ThrudTheBarbarian/pbxl/website/pbxl.rw/Pages/2-Progress/Data/45282906-F959-4F5A-A95E-FE16CF3B2C88.jpg

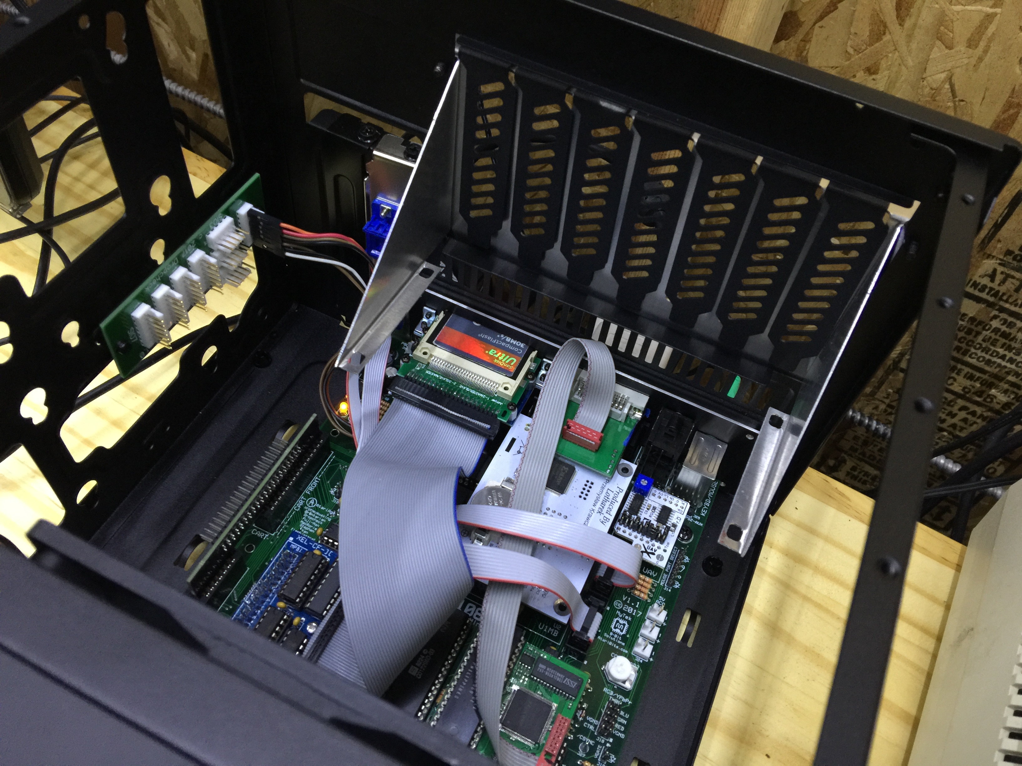
website/pbxl.rw/Pages/2-Progress/Data/45282906-F959-4F5A-A95E-FE16CF3B2C88.jpg
