ThrudTheBarbarian/pbxl/website/pbxl.rw/Pages/2-Progress/Data/82369402-14E8-40AA-8590-1A6C87807267.png

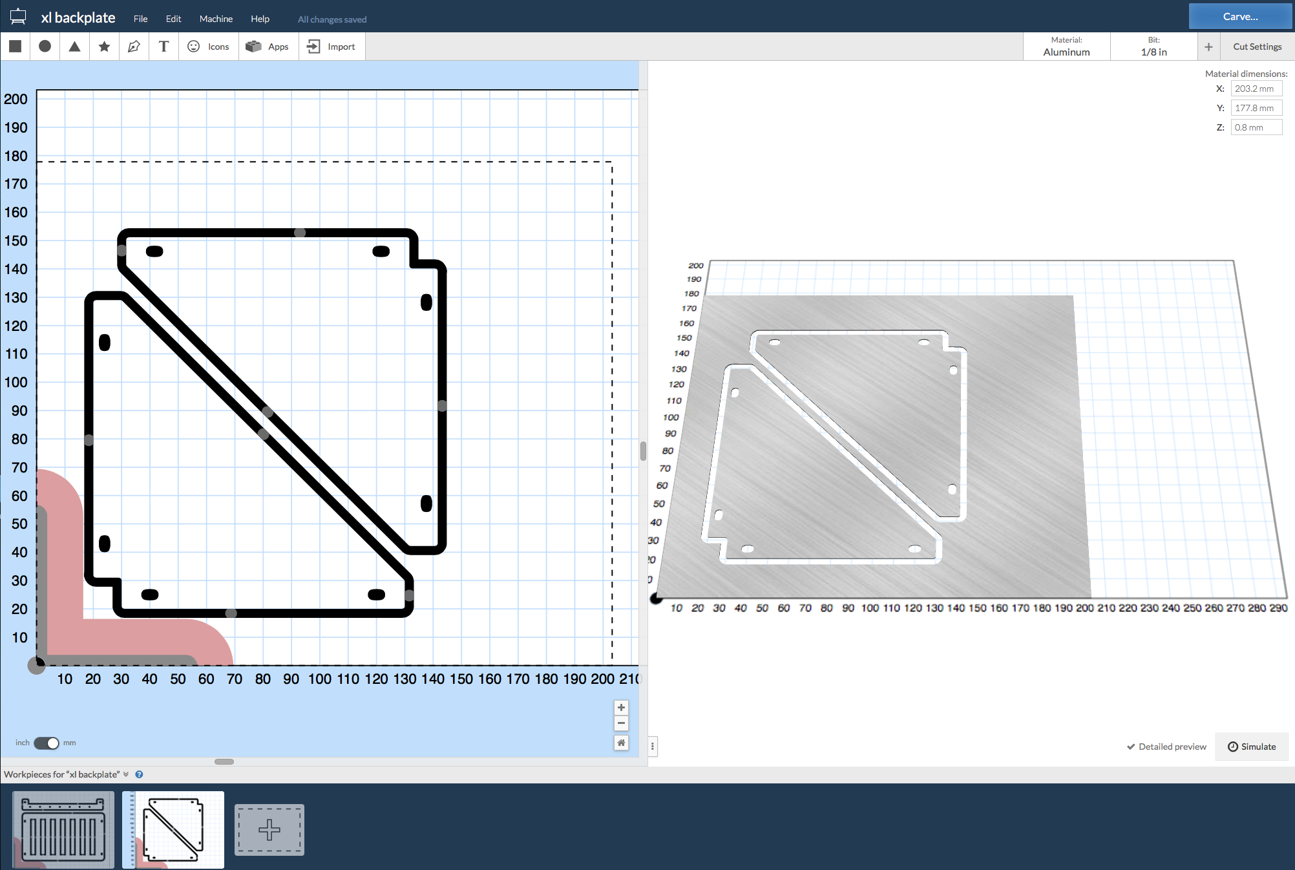
website/pbxl.rw/Pages/2-Progress/Data/82369402-14E8-40AA-8590-1A6C87807267.png
