ThrudTheBarbarian/pbxl/website/pbxl.rw/Pages/2-Progress/Data/A6DD7AC5-D022-4B90-A764-D63F6088FE23.png

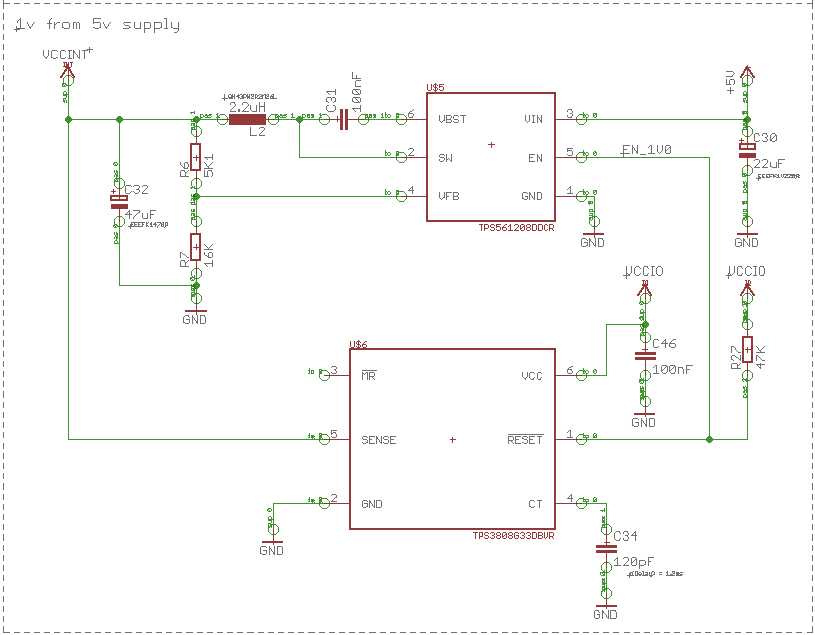
website/pbxl.rw/Pages/2-Progress/Data/A6DD7AC5-D022-4B90-A764-D63F6088FE23.png
