ThrudTheBarbarian/pbxl/website/pbxl.rw/Pages/2-Progress/Data/A2934AA8-5D58-4473-A058-EDF0BA59CC09.png

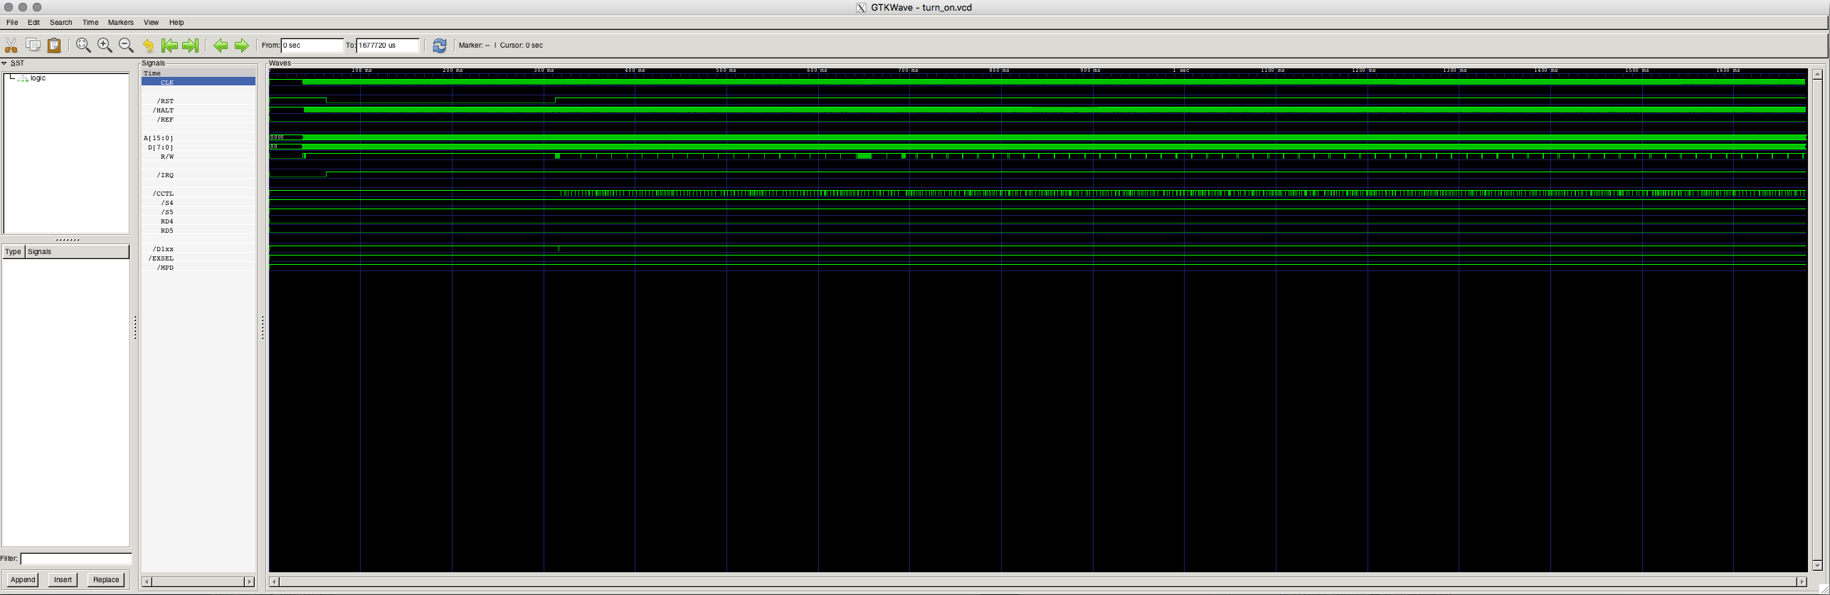
website/pbxl.rw/Pages/2-Progress/Data/A2934AA8-5D58-4473-A058-EDF0BA59CC09.png
