ThrudTheBarbarian/pbxl/website/pbxl.rw/Pages/2-Progress/Data/A16139D2-92C0-49A2-8C9E-1875E58BAA2E.jpg

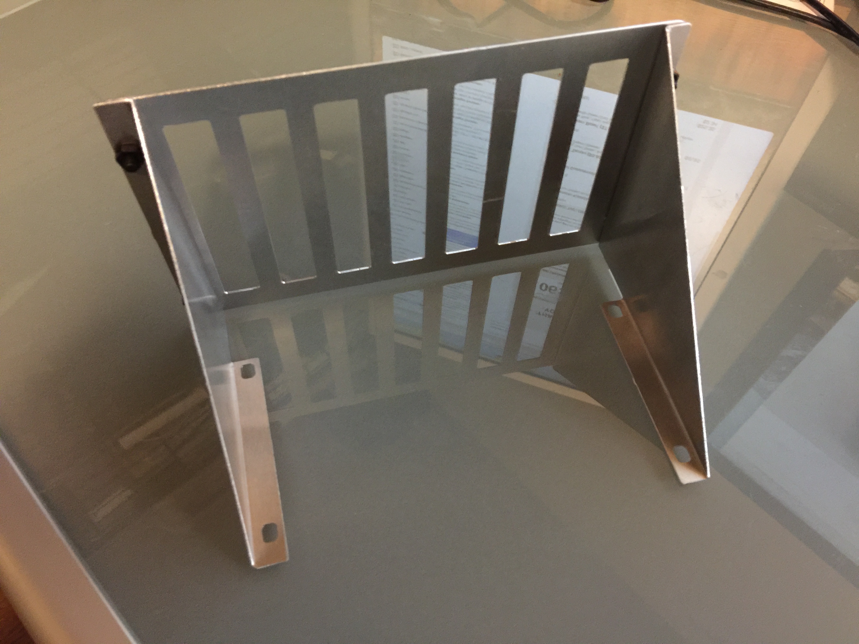
website/pbxl.rw/Pages/2-Progress/Data/A16139D2-92C0-49A2-8C9E-1875E58BAA2E.jpg
