ThrudTheBarbarian/pbxl/website/pbxl.rw/Pages/2-Progress/Data/A88727F7-F2F6-42A9-ADD3-FC5E96ADD854.png

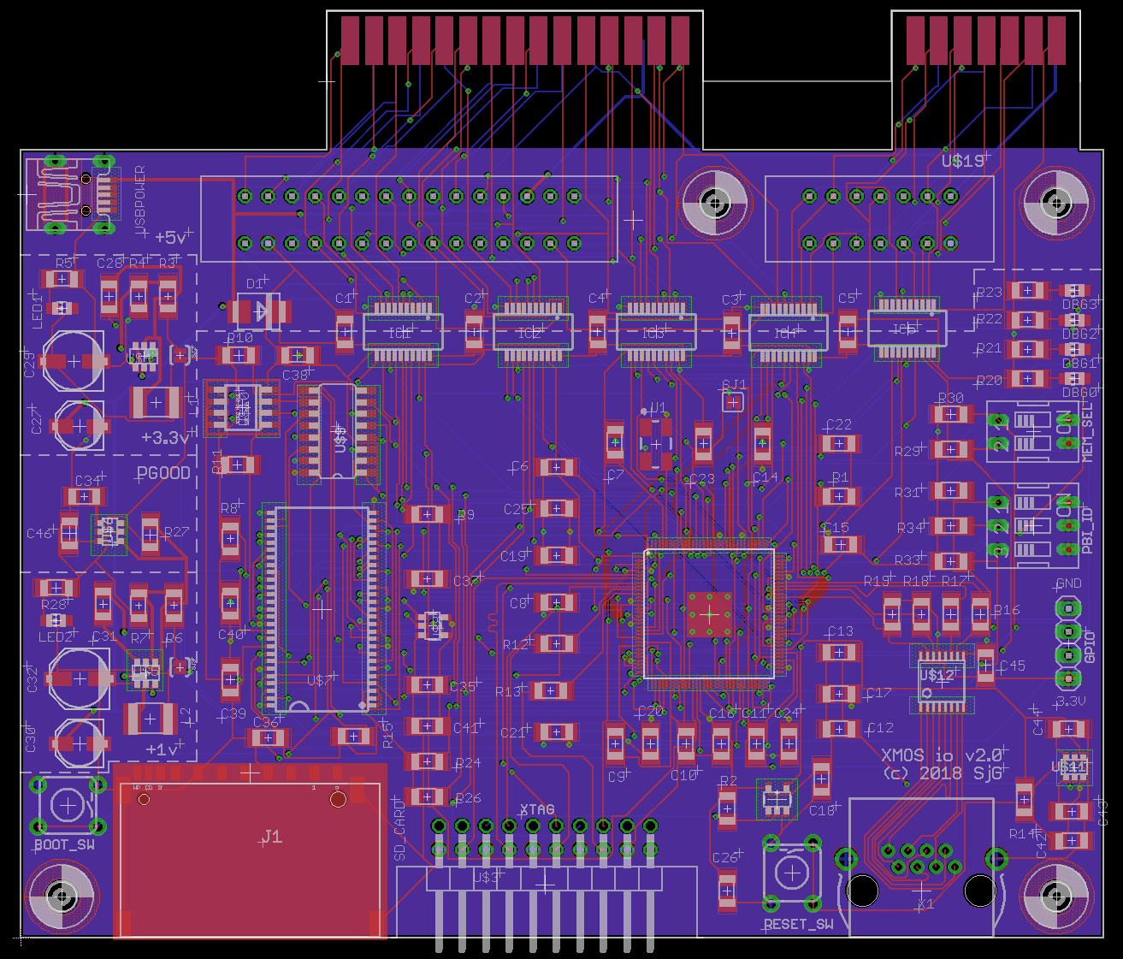
website/pbxl.rw/Pages/2-Progress/Data/A88727F7-F2F6-42A9-ADD3-FC5E96ADD854.png
