ThrudTheBarbarian/pbxl/website/pbxl.rw/Pages/2-Progress/Data/AC8FD956-4C89-40C6-AFB7-C1FC07A9840D.png

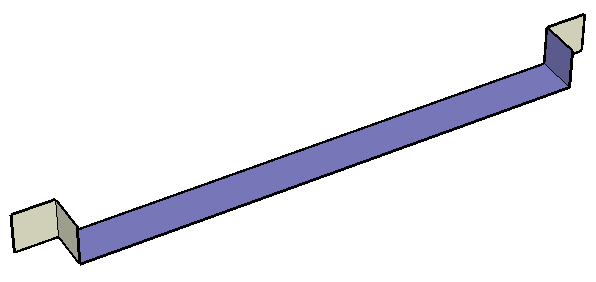
website/pbxl.rw/Pages/2-Progress/Data/AC8FD956-4C89-40C6-AFB7-C1FC07A9840D.png
