ThrudTheBarbarian/pbxl/website/pbxl.rw/Pages/2-Progress/Data/B6DF8273-8B79-47C0-8FD9-C0D449EE5A9A.jpg

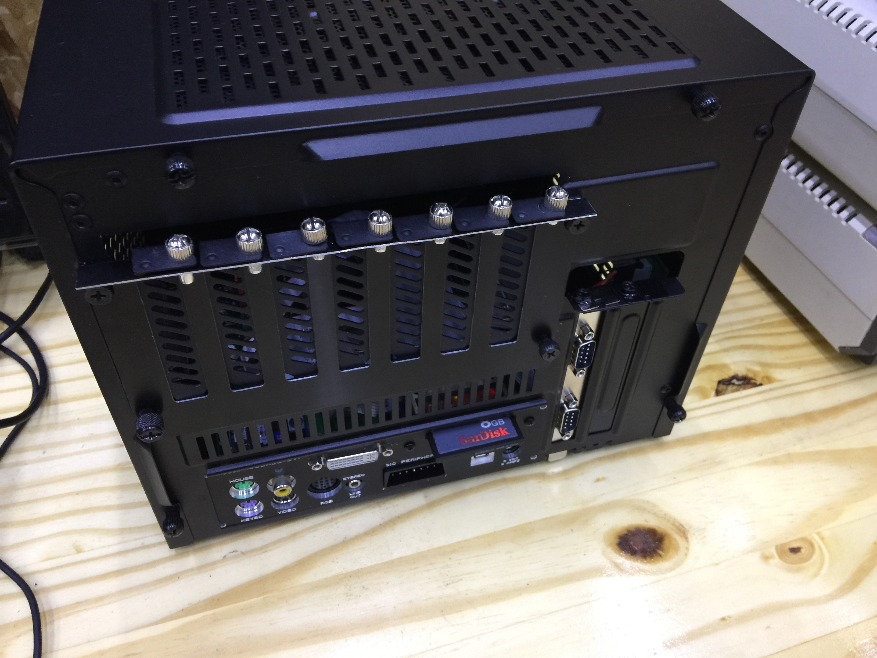
website/pbxl.rw/Pages/2-Progress/Data/B6DF8273-8B79-47C0-8FD9-C0D449EE5A9A.jpg
