ThrudTheBarbarian/pbxl/website/pbxl.rw/Pages/2-Progress/Data/B7114F96-F85A-4B28-BB74-99EFAB77251B.jpg

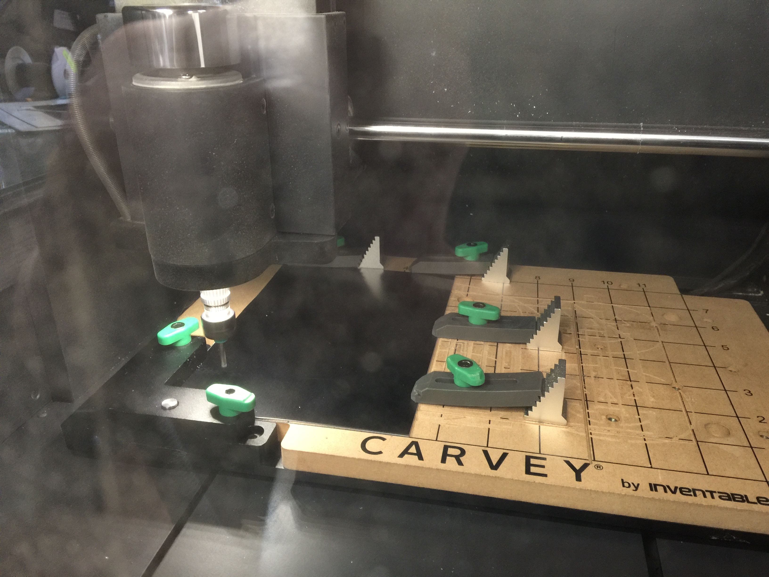
website/pbxl.rw/Pages/2-Progress/Data/B7114F96-F85A-4B28-BB74-99EFAB77251B.jpg
