ThrudTheBarbarian/pbxl/website/pbxl.rw/Pages/2-Progress/Data/B45187A0-F26F-4826-B8A0-4420ED7F6C90.jpg

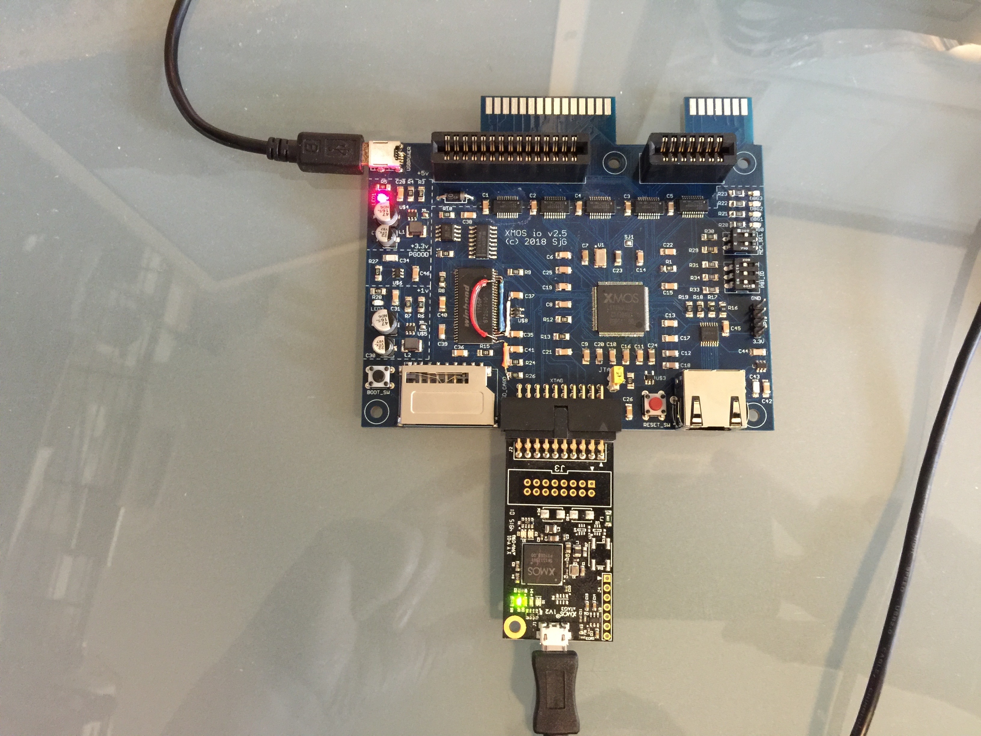
website/pbxl.rw/Pages/2-Progress/Data/B45187A0-F26F-4826-B8A0-4420ED7F6C90.jpg
