ThrudTheBarbarian/pbxl/website/pbxl.rw/Pages/2-Progress/Data/BB25885C-DA74-44DB-BC5F-6EC5020062B4.png

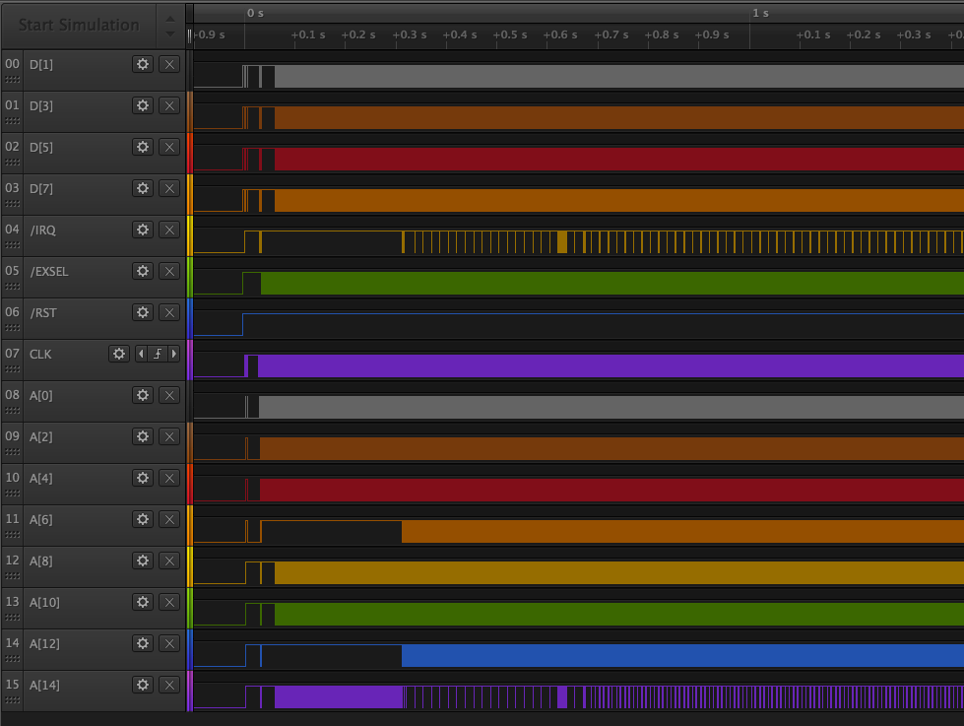
website/pbxl.rw/Pages/2-Progress/Data/BB25885C-DA74-44DB-BC5F-6EC5020062B4.png
