ThrudTheBarbarian/pbxl/website/pbxl.rw/Pages/2-Progress/Data/C0BE3A01-F758-4718-A5FE-A69D795C2E4D.jpg

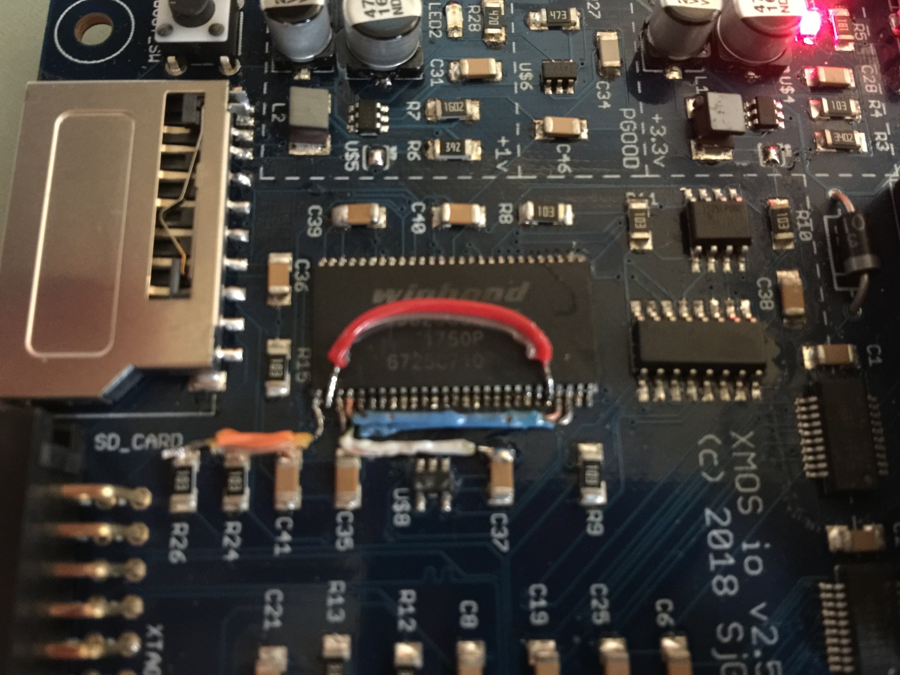
website/pbxl.rw/Pages/2-Progress/Data/C0BE3A01-F758-4718-A5FE-A69D795C2E4D.jpg
