ThrudTheBarbarian/pbxl/website/pbxl.rw/Pages/2-Progress/Data/CFB682DE-7B10-45DA-AEE5-957E081EAF88.png

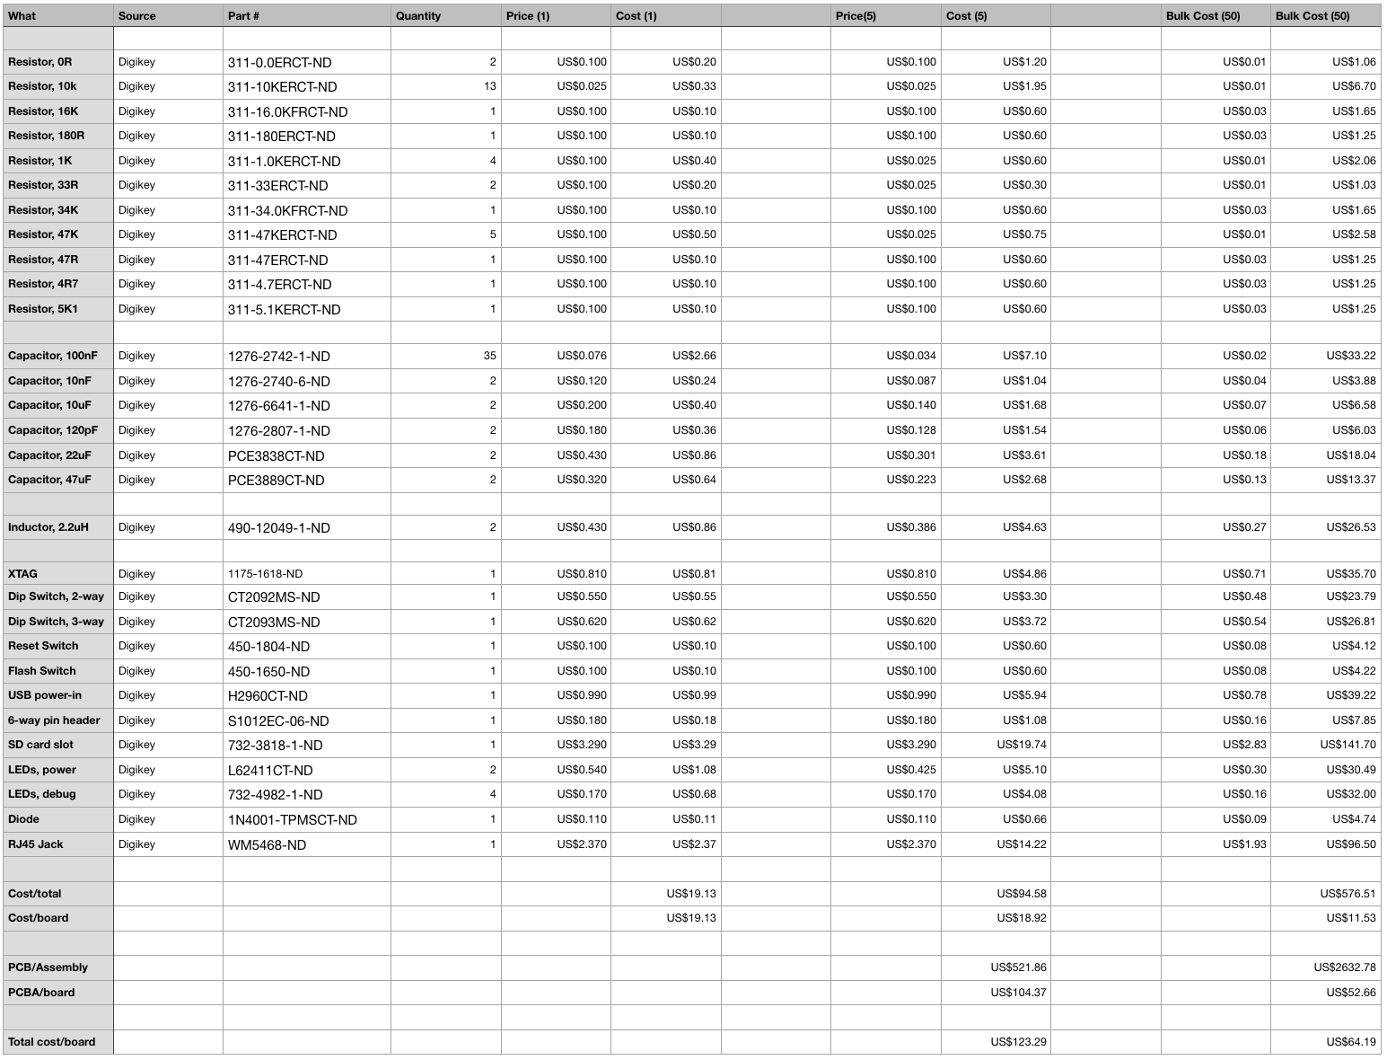
website/pbxl.rw/Pages/2-Progress/Data/CFB682DE-7B10-45DA-AEE5-957E081EAF88.png
