ThrudTheBarbarian/pbxl/website/pbxl.rw/Pages/2-Progress/Data/D1C436AF-8D83-49B9-AD28-31A185A0E86A.jpg

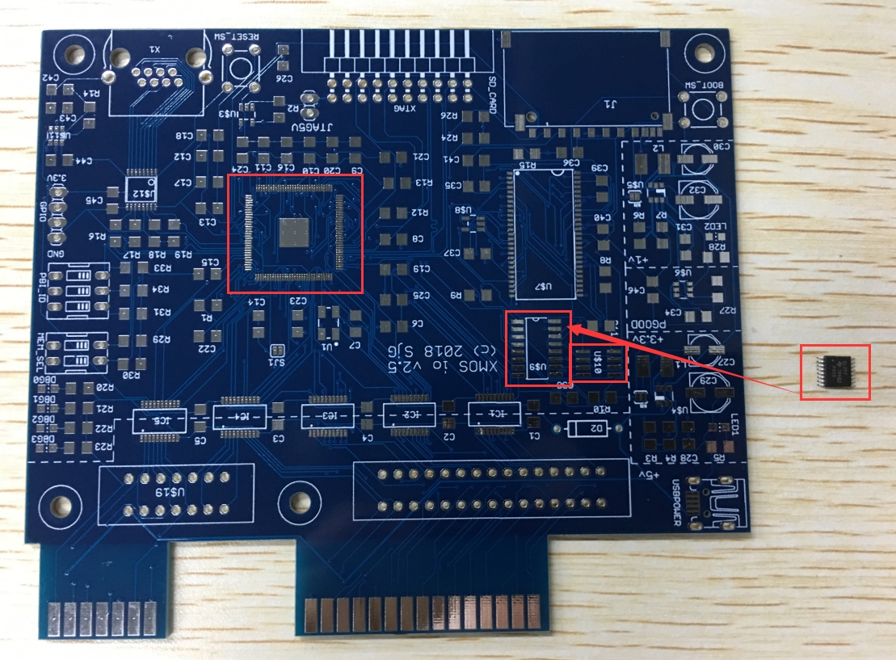
website/pbxl.rw/Pages/2-Progress/Data/D1C436AF-8D83-49B9-AD28-31A185A0E86A.jpg
