ThrudTheBarbarian/pbxl/website/pbxl.rw/Pages/2-Progress/Data/D5DB81C8-ABF0-4D70-8782-67A87FB63F66.jpg

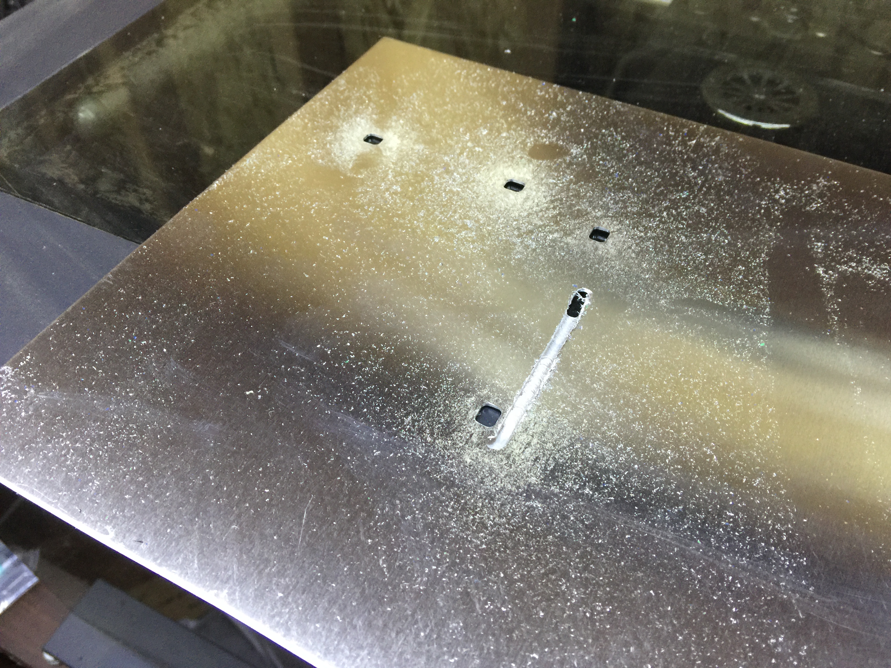
website/pbxl.rw/Pages/2-Progress/Data/D5DB81C8-ABF0-4D70-8782-67A87FB63F66.jpg
