ThrudTheBarbarian/pbxl/website/pbxl.rw/Pages/2-Progress/Data/D7944C23-1750-45FF-9232-091A6A3717B3.jpg

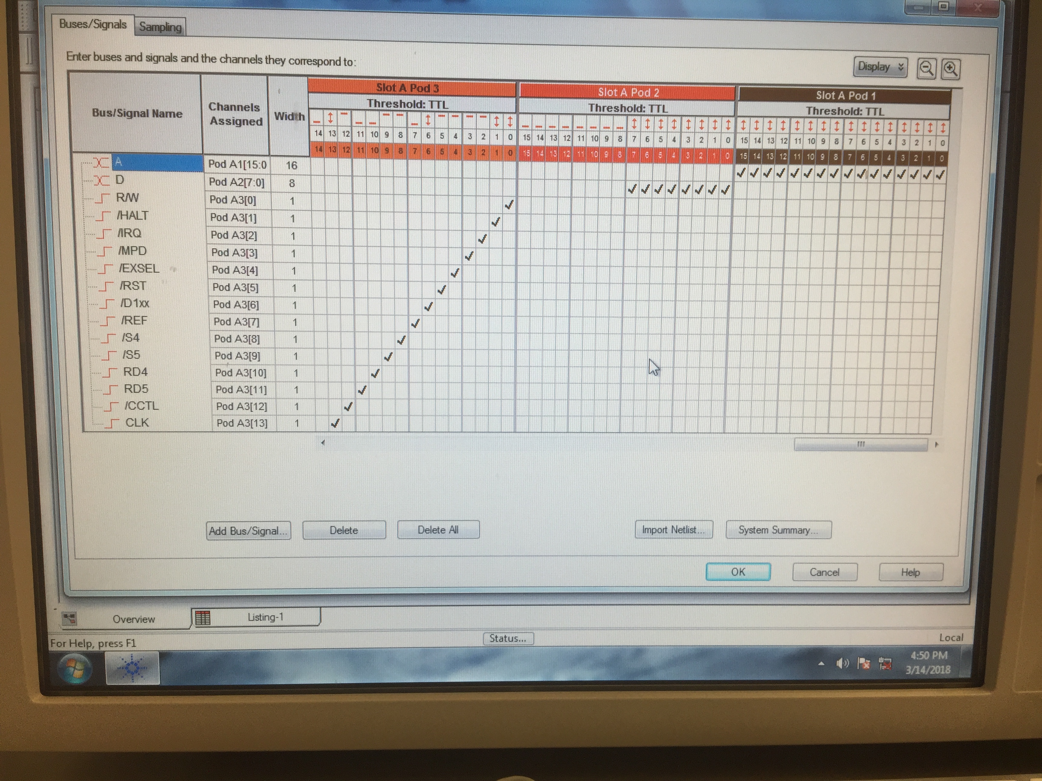
website/pbxl.rw/Pages/2-Progress/Data/D7944C23-1750-45FF-9232-091A6A3717B3.jpg
