ThrudTheBarbarian/pbxl/website/pbxl.rw/Pages/2-Progress/Data/D8520D41-46E7-4EC3-ACCF-3909A682DB44.jpg

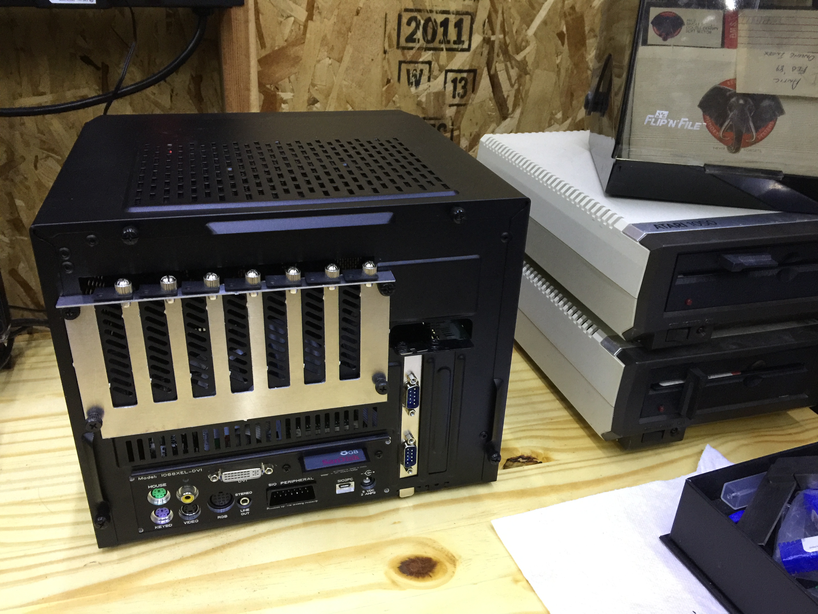
website/pbxl.rw/Pages/2-Progress/Data/D8520D41-46E7-4EC3-ACCF-3909A682DB44.jpg
