ThrudTheBarbarian/pbxl/website/pbxl.rw/Pages/2-Progress/Data/DB3F88DC-6A53-439A-A944-35F645B88EC8.jpg

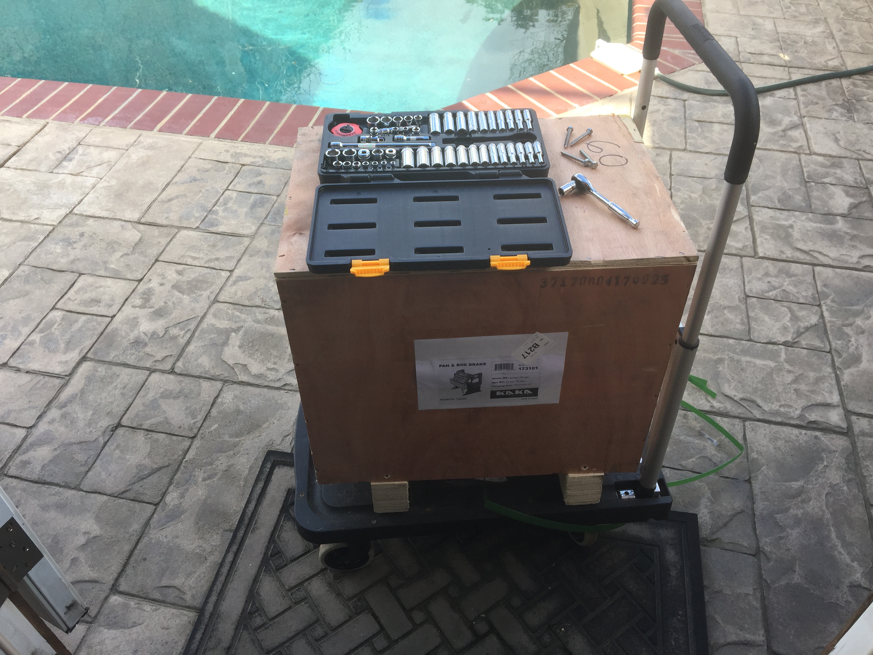
website/pbxl.rw/Pages/2-Progress/Data/DB3F88DC-6A53-439A-A944-35F645B88EC8.jpg
