ThrudTheBarbarian/pbxl/website/pbxl.rw/Pages/2-Progress/Data/DCC796F3-8E62-4DAA-9A6B-33CB4E6FF8F5.jpg

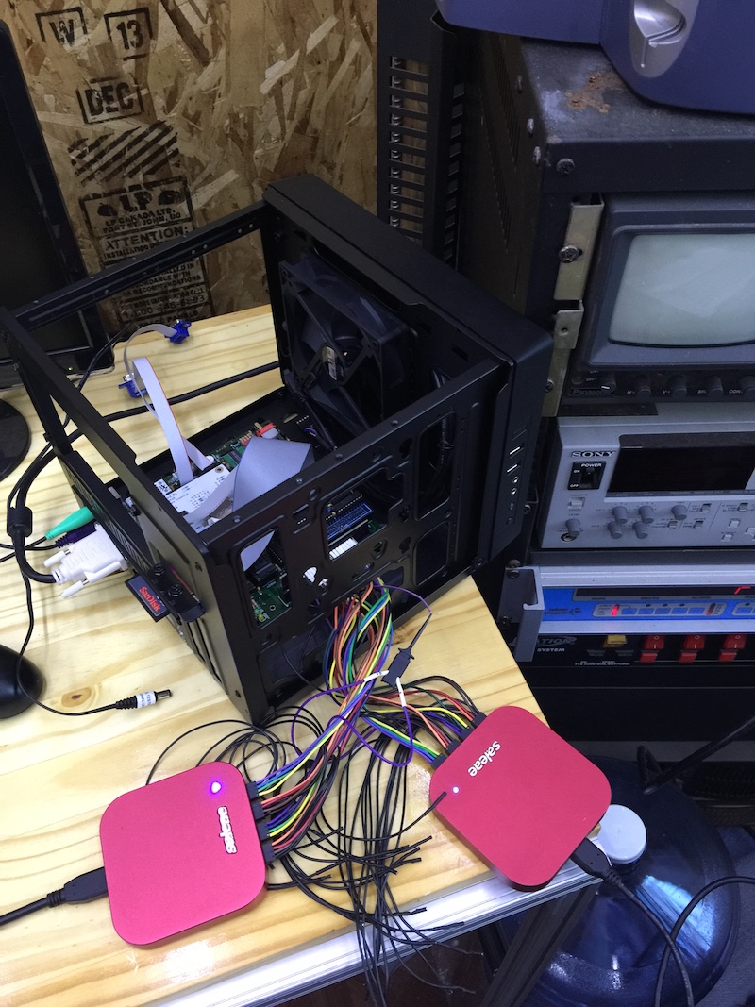
website/pbxl.rw/Pages/2-Progress/Data/DCC796F3-8E62-4DAA-9A6B-33CB4E6FF8F5.jpg
