ThrudTheBarbarian/pbxl/website/pbxl.rw/Pages/2-Progress/Data/DF3951EA-8D8B-4525-BED2-0F28436C87BA.jpg

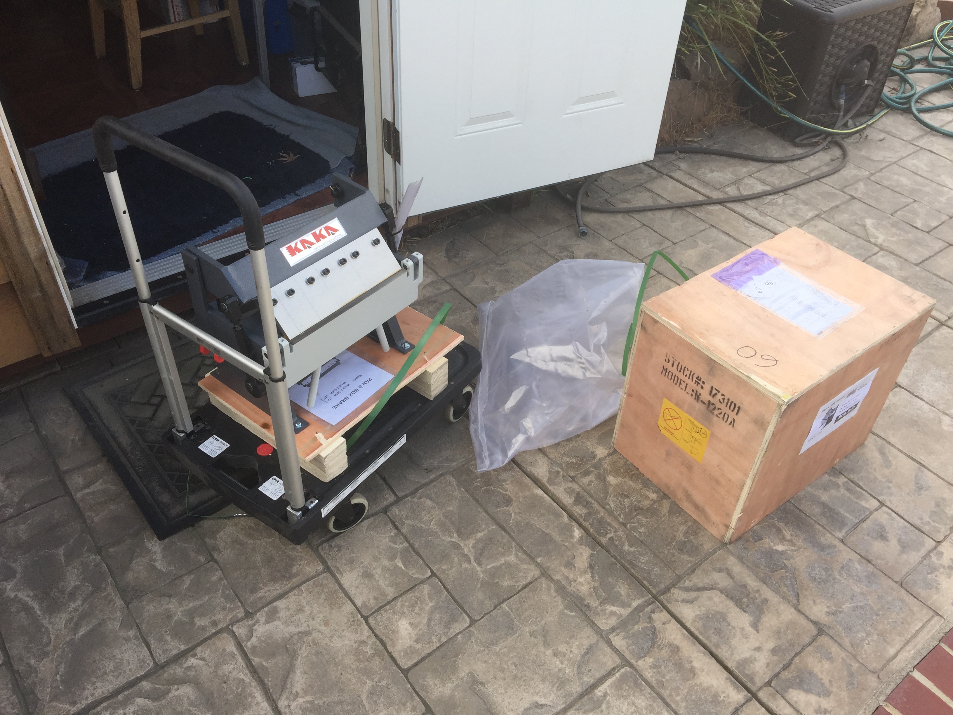
website/pbxl.rw/Pages/2-Progress/Data/DF3951EA-8D8B-4525-BED2-0F28436C87BA.jpg
