ThrudTheBarbarian/pbxl/website/pbxl.rw/Pages/2-Progress/Data/E445CAB0-1863-4663-99D9-233D3ED9F70E.png

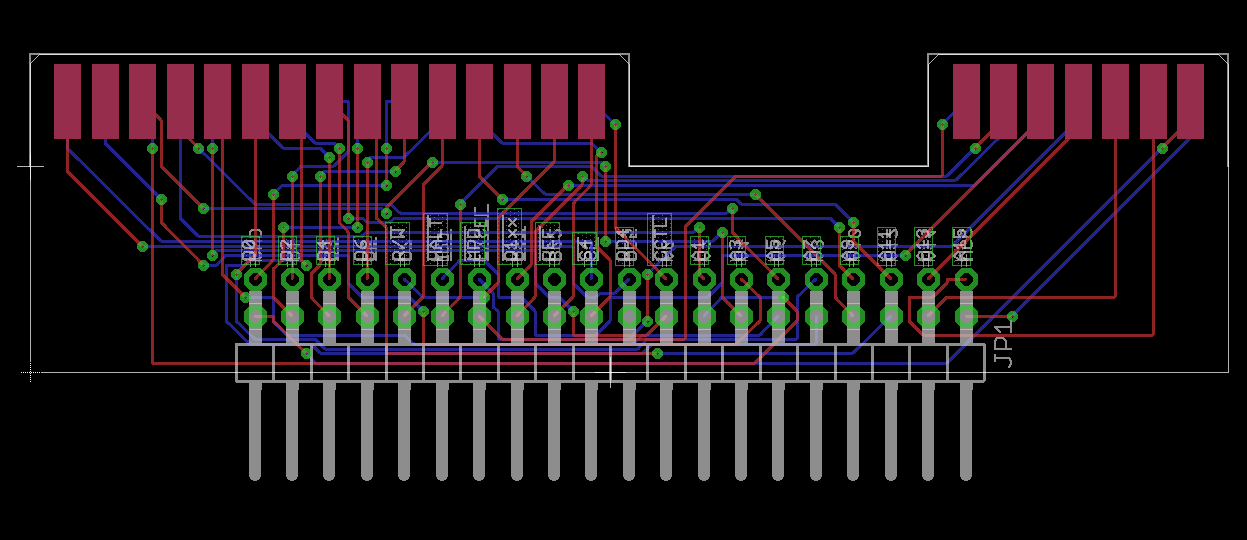
website/pbxl.rw/Pages/2-Progress/Data/E445CAB0-1863-4663-99D9-233D3ED9F70E.png
