ThrudTheBarbarian/pbxl/website/pbxl.rw/Pages/2-Progress/Data/E530C799-76DF-4D09-950D-A2A87CCC2CC5.png

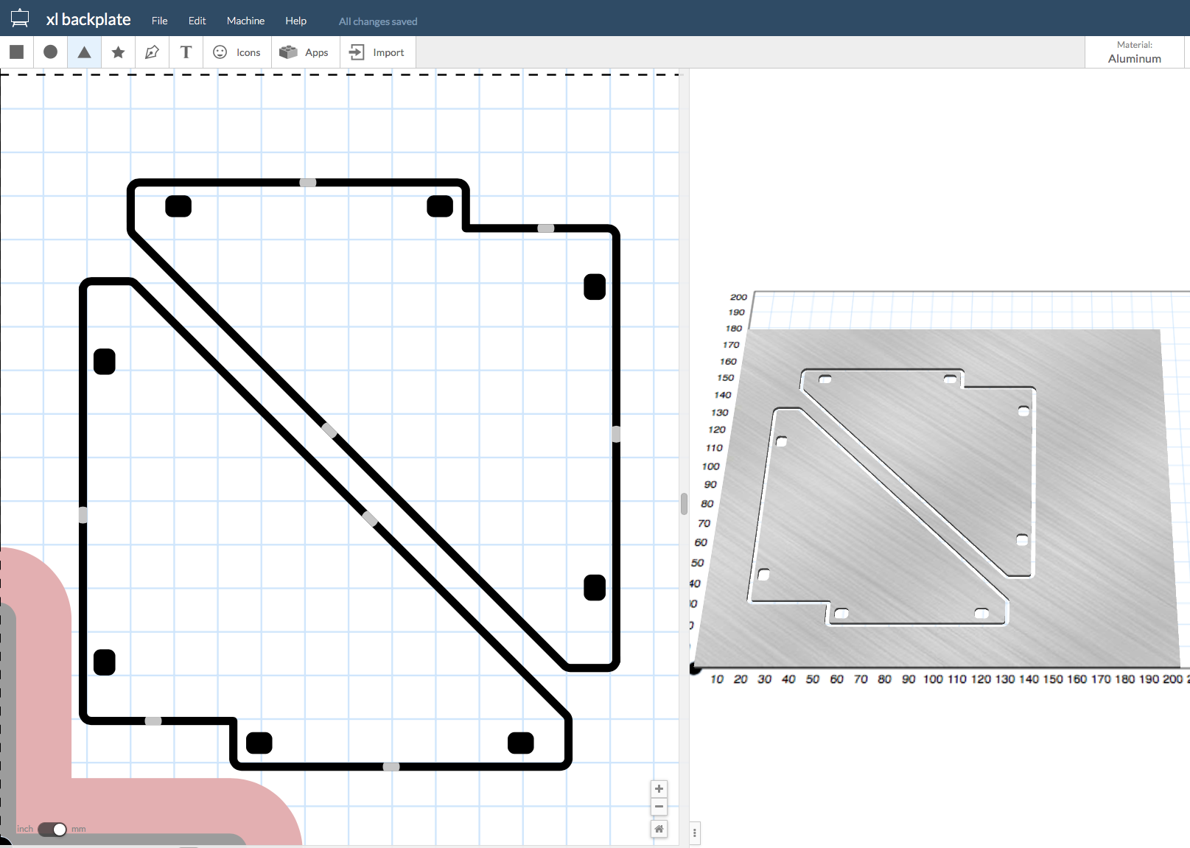
website/pbxl.rw/Pages/2-Progress/Data/E530C799-76DF-4D09-950D-A2A87CCC2CC5.png
