ThrudTheBarbarian/pbxl/website/pbxl.rw/Pages/2-Progress/Data/E590FEB3-E240-43C0-8AFB-A93F93A2E492.jpg

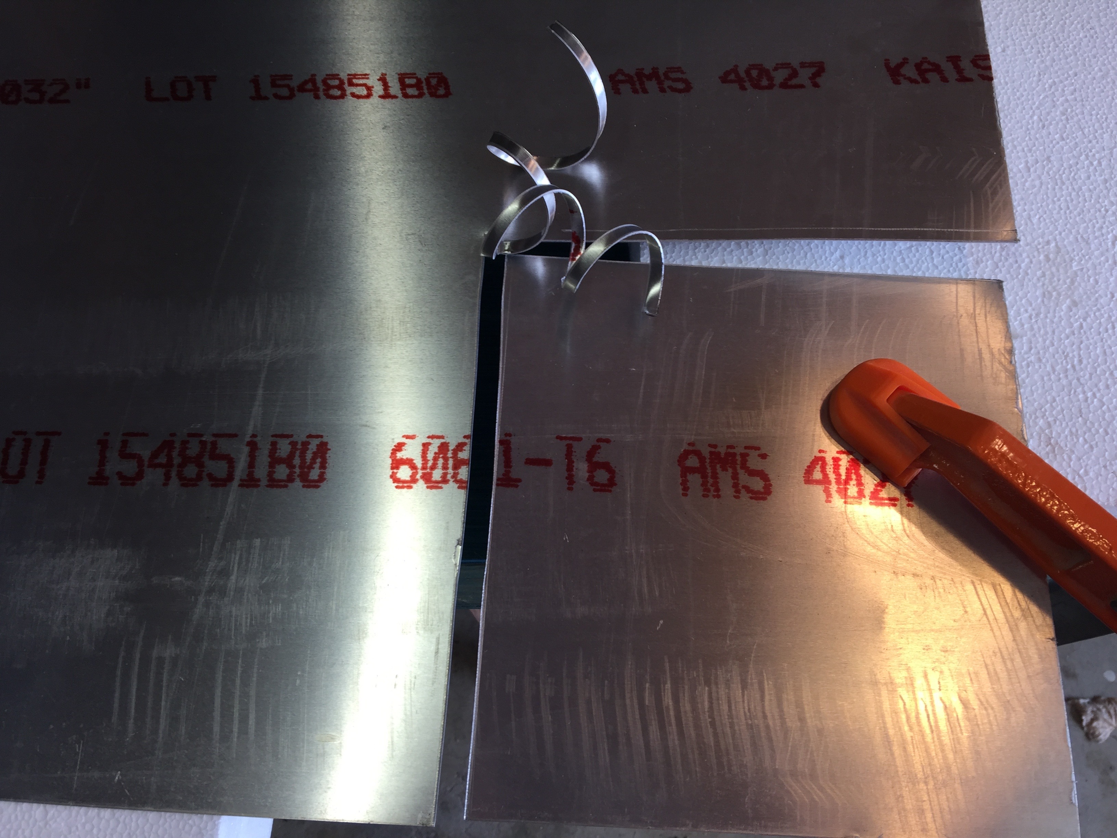
website/pbxl.rw/Pages/2-Progress/Data/E590FEB3-E240-43C0-8AFB-A93F93A2E492.jpg
