ThrudTheBarbarian/pbxl/website/pbxl.rw/Pages/2-Progress/Data/EBDE493E-234D-483C-BEE6-01FFAE6F1A57.jpg

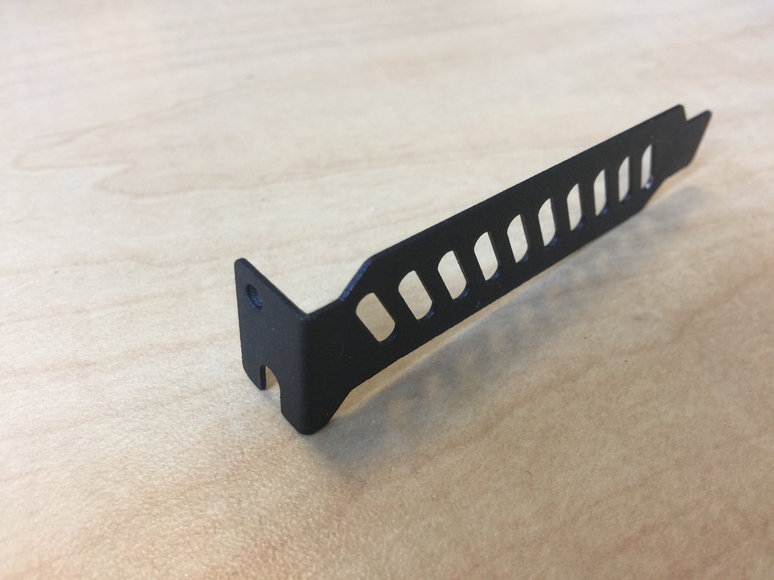
website/pbxl.rw/Pages/2-Progress/Data/EBDE493E-234D-483C-BEE6-01FFAE6F1A57.jpg
