ThrudTheBarbarian/pbxl/website/pbxl.rw/Pages/2-Progress/Data/F7F00349-A713-4A98-959A-40FA8D65E59A.jpg

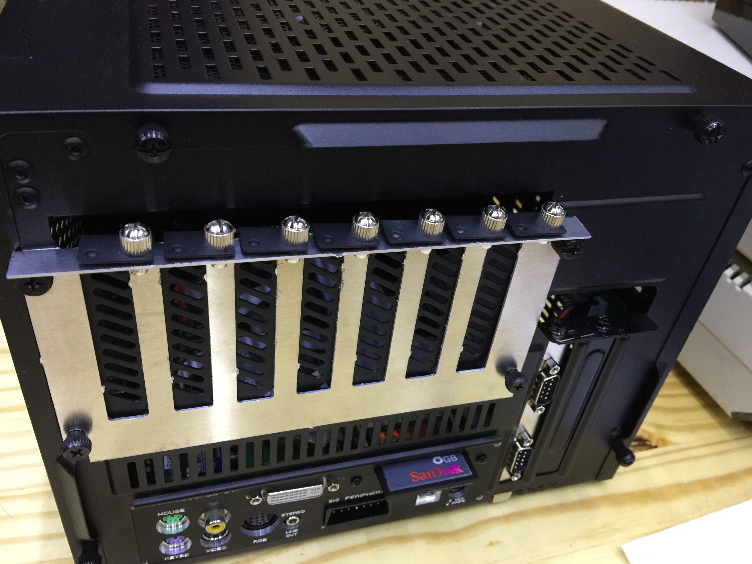
website/pbxl.rw/Pages/2-Progress/Data/F7F00349-A713-4A98-959A-40FA8D65E59A.jpg
