ThrudTheBarbarian/pbxl/website/pbxl.rw/Pages/2-Progress/Data/F41C7EBC-DC7A-47FB-87FA-54A247C47D12.jpg

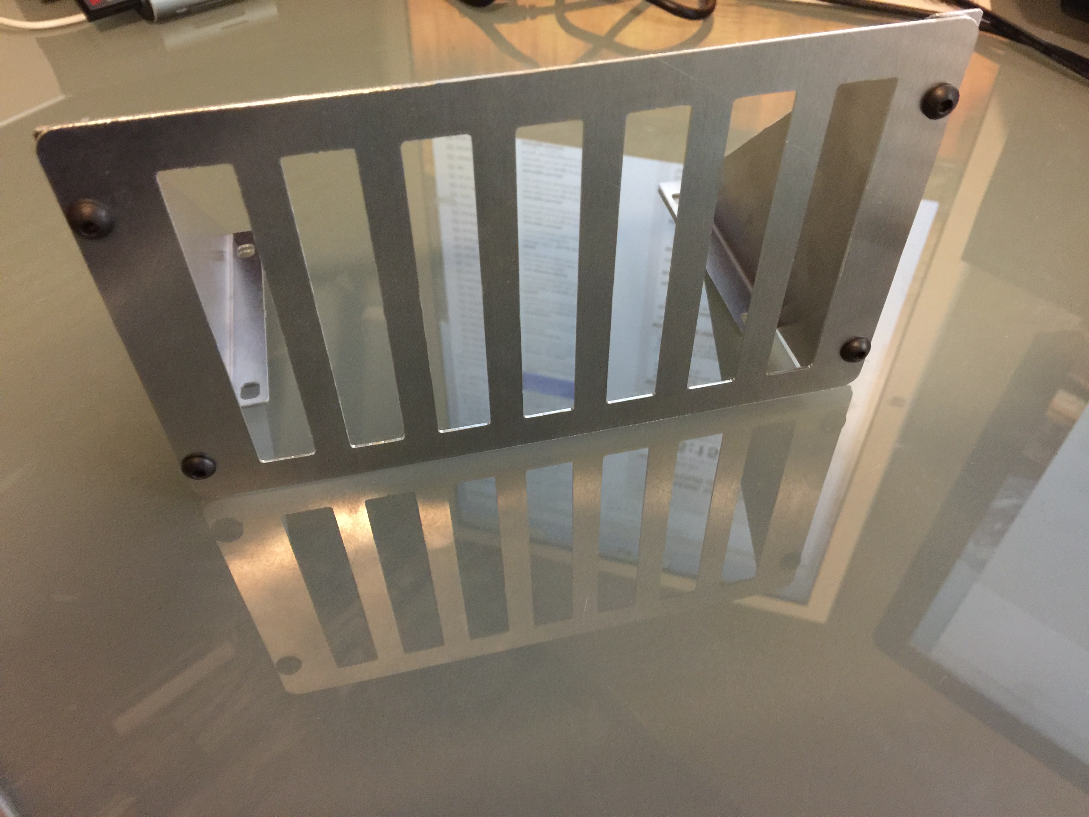
website/pbxl.rw/Pages/2-Progress/Data/F41C7EBC-DC7A-47FB-87FA-54A247C47D12.jpg
