ThrudTheBarbarian/pbxl/website/pbxl.rw/Pages/2-Progress/Data/F73B7778-95B4-4600-BED9-7BFD2E3639DC.png

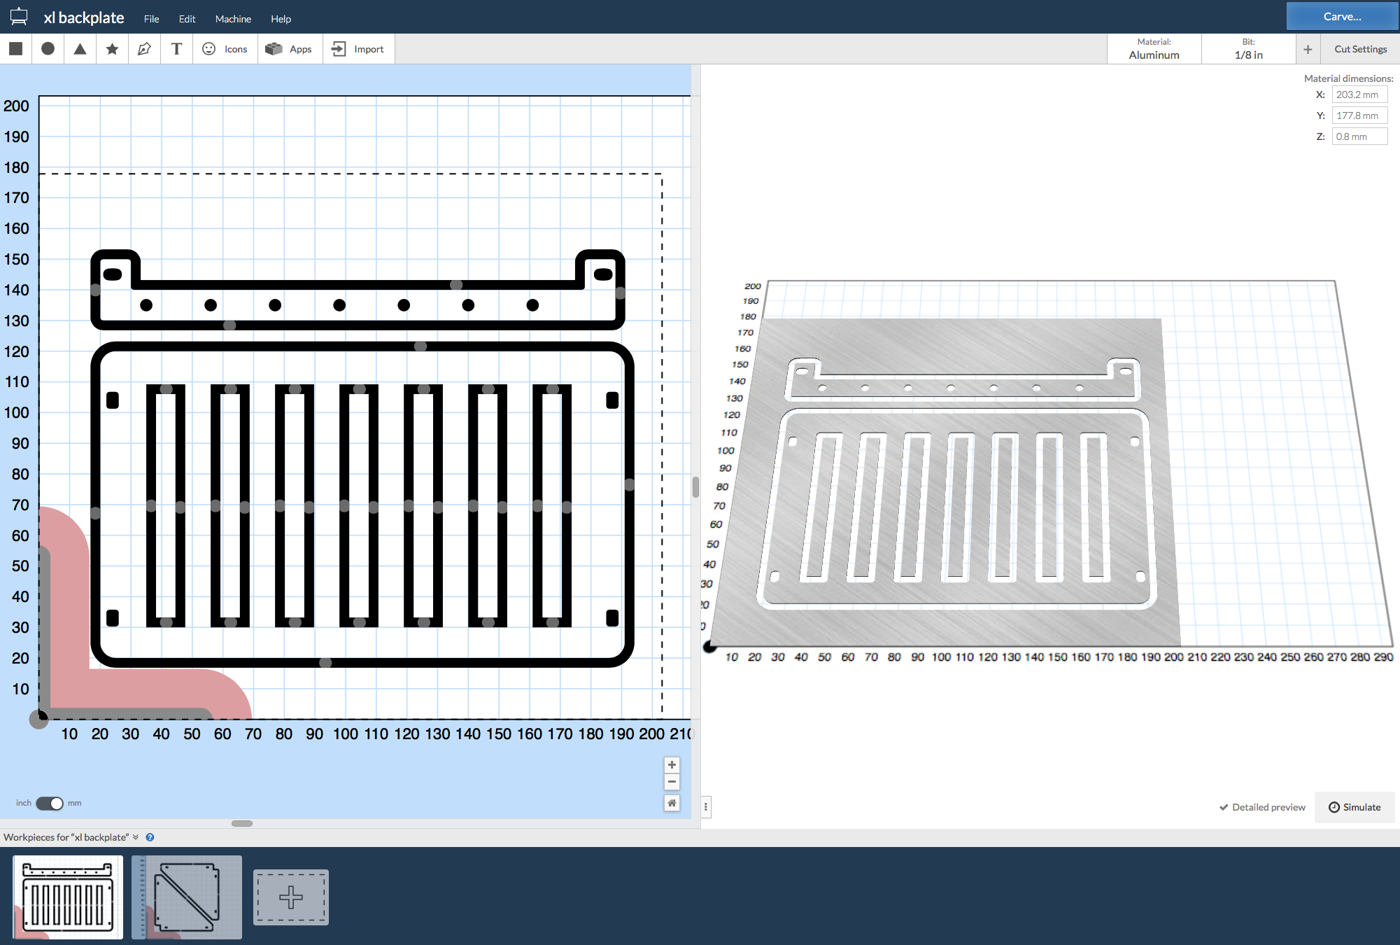
website/pbxl.rw/Pages/2-Progress/Data/F73B7778-95B4-4600-BED9-7BFD2E3639DC.png
