ThrudTheBarbarian/pbxl/website/pbxl.rw/Pages/2-Progress/Data/FDBC1EDF-8A50-4124-A497-71A75E78D663.jpg

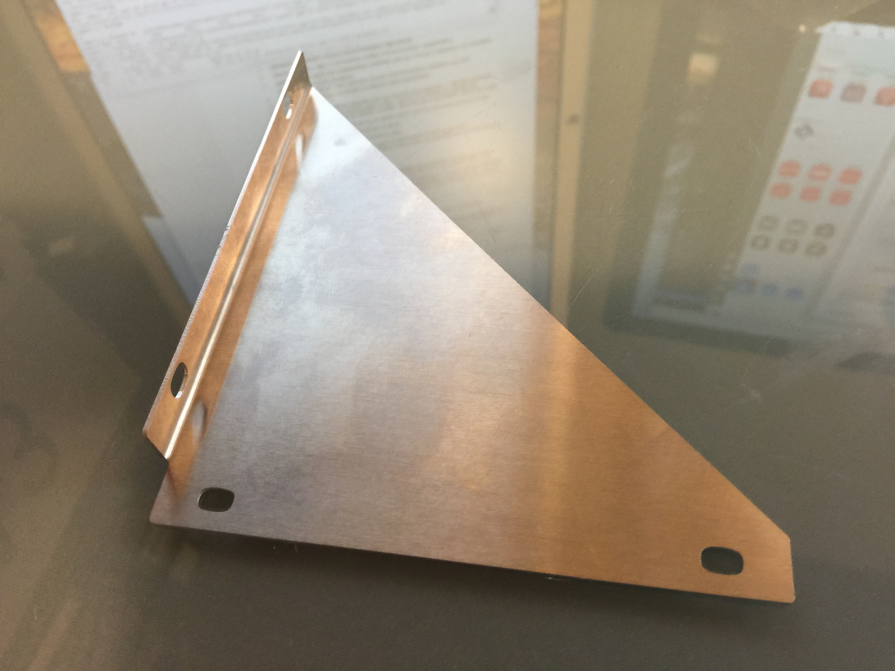
website/pbxl.rw/Pages/2-Progress/Data/FDBC1EDF-8A50-4124-A497-71A75E78D663.jpg
