ThrudTheBarbarian/pbxl/website/pbxl.rw/Pages/4-XE-host-interface/Data/44118A78-9129-46F3-9CF6-D8EB9EAC10F1.png

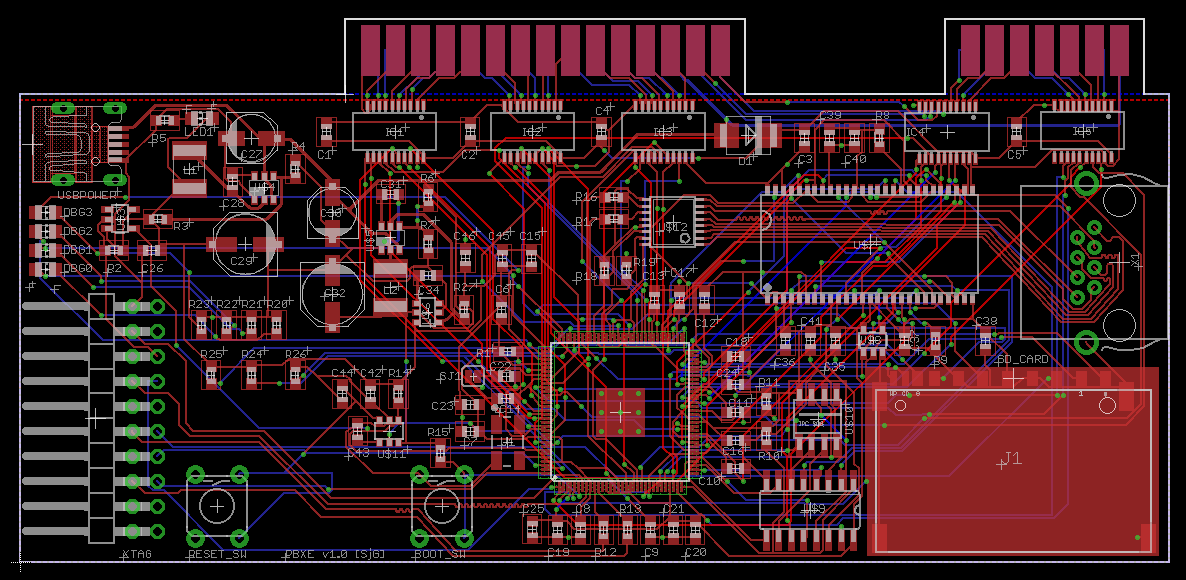
website/pbxl.rw/Pages/4-XE-host-interface/Data/44118A78-9129-46F3-9CF6-D8EB9EAC10F1.png
