ThrudTheBarbarian/pbxl/website/pbxl.rw/Pages/6-The-enclosure/Data/27C27285-6C47-4E54-B190-17540A1E5A02.jpg

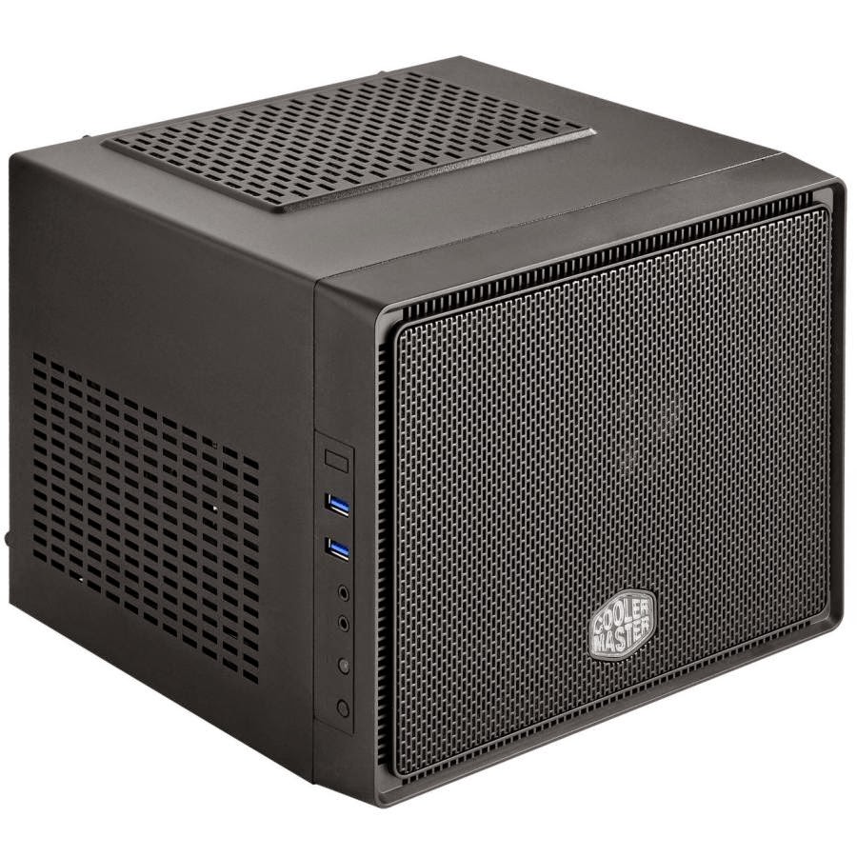
website/pbxl.rw/Pages/6-The-enclosure/Data/27C27285-6C47-4E54-B190-17540A1E5A02.jpg
