ThrudTheBarbarian/pbxl/website/pbxl.rw/Pages/6-The-enclosure/Data/30D5E725-C5A1-47A5-B91E-494CABE6ED99.jpg

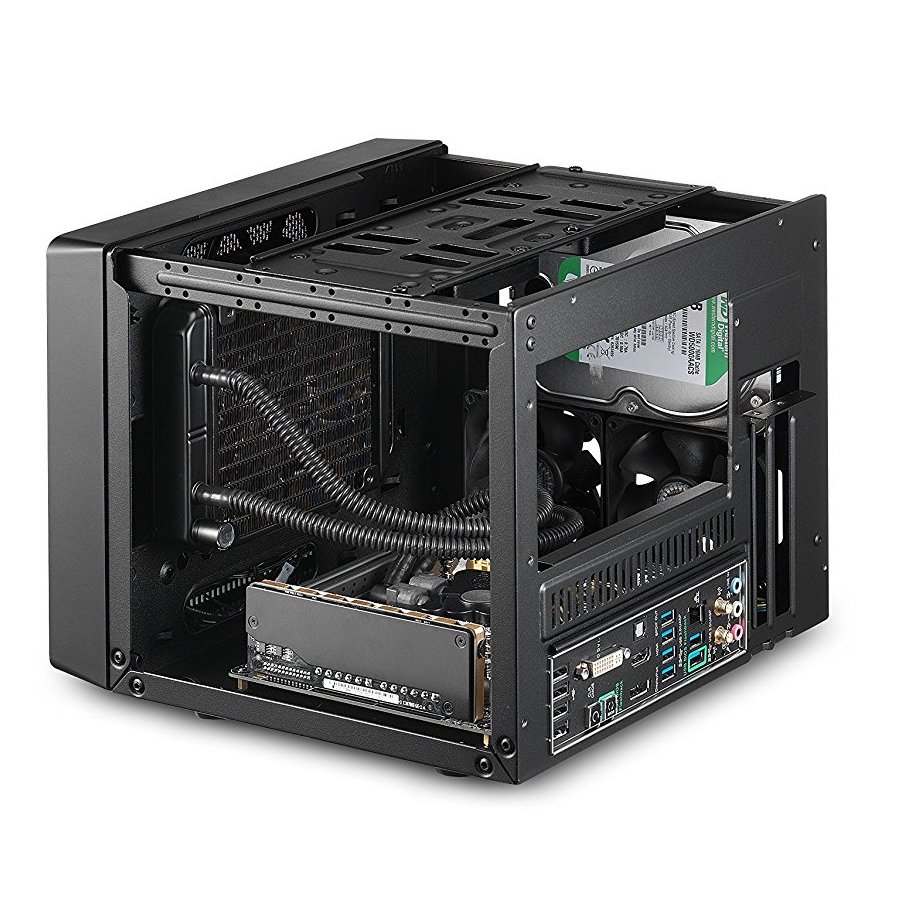
website/pbxl.rw/Pages/6-The-enclosure/Data/30D5E725-C5A1-47A5-B91E-494CABE6ED99.jpg
