ThrudTheBarbarian/pbxl/website/pbxl.rw/Pages/6-The-enclosure/Data/62E57BA1-33AF-46D4-B0F1-0B756D0F4243.jpg

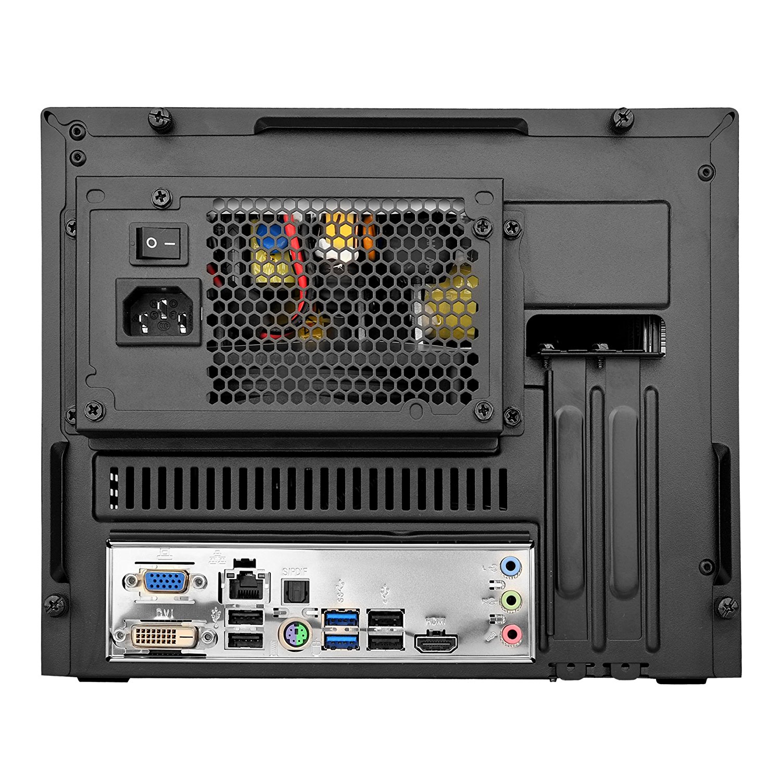
website/pbxl.rw/Pages/6-The-enclosure/Data/62E57BA1-33AF-46D4-B0F1-0B756D0F4243.jpg
