ThrudTheBarbarian/pbxl/boards/xio5/xio5.csv

Part | Value | Device | Package | Description | ALLIED_NUMBER | ALLIED_PRICE-STOCK | DESCRIPTION | HEIGHT | MANUFACTURER_NAME | MANUFACTURER_PART_NUMBER | MOUSER_PART_NUMBER | MOUSER_PRICE-STOCK | NOSTUFF | POPULARITY | RS_PART_NUMBER | RS_PRICE-STOCK | SPICEPREFIX | USE
C1 | 0.1uF | C-EUC0201 | C0201 | CAPACITOR, European symbol |  |  |  |  |  |  |  |  |  |  |  |  | C | GRM033C71C104KE14D
C2 | 0.1uF | C-EUC0201 | C0201 | CAPACITOR, European symbol |  |  |  |  |  |  |  |  |  |  |  |  | C | GRM033C71C104KE14D
C3 | 0.1uF | C-EUC0201 | C0201 | CAPACITOR, European symbol |  |  |  |  |  |  |  |  |  |  |  |  | C | GRM033C71C104KE14D
C4 | 0.1uF | C-EUC0201 | C0201 | CAPACITOR, European symbol |  |  |  |  |  |  |  |  |  |  |  |  | C | GRM033C71C104KE14D
C5 | 0.1uF | C-EUC0201 | C0201 | CAPACITOR, European symbol |  |  |  |  |  |  |  |  |  |  |  |  | C | GRM033C71C104KE14D
C6 | 0.1uF | C-EUC0201 | C0201 | CAPACITOR, European symbol |  |  |  |  |  |  |  |  |  |  |  |  | C | GRM033C71C104KE14D
C7 | 0.1uF | C-EUC0201 | C0201 | CAPACITOR, European symbol |  |  |  |  |  |  |  |  |  |  |  |  | C | GRM033C71C104KE14D
C8 | 0.1uF | C-EUC0201 | C0201 | CAPACITOR, European symbol |  |  |  |  |  |  |  |  |  |  |  |  | C | GRM033C71C104KE14D
C9 | 0.1uF | C-EUC0201 | C0201 | CAPACITOR, European symbol |  |  |  |  |  |  |  |  |  |  |  |  | C | GRM033C71C104KE14D
C10 | 0.1uF | C-EUC0201 | C0201 | CAPACITOR, European symbol |  |  |  |  |  |  |  |  |  |  |  |  | C | GRM033C71C104KE14D
C11 | 0.1uF | C-EUC0201 | C0201 | CAPACITOR, European symbol |  |  |  |  |  |  |  |  |  |  |  |  | C | GRM033C71C104KE14D
C12 | 0.1uF | C-EUC0201 | C0201 | CAPACITOR, European symbol |  |  |  |  |  |  |  |  |  |  |  |  | C | GRM033C71C104KE14D
C13 | 0.1uF | C-EUC0201 | C0201 | CAPACITOR, European symbol |  |  |  |  |  |  |  |  |  |  |  |  | C | GRM033C71C104KE14D
C14 | 0.1uF | C-EUC0201 | C0201 | CAPACITOR, European symbol |  |  |  |  |  |  |  |  |  |  |  |  | C | GRM033C71C104KE14D
C15 | 0.1uF | C-EUC0201 | C0201 | CAPACITOR, European symbol |  |  |  |  |  |  |  |  |  |  |  |  | C | GRM033C71C104KE14D
C16 | 0.1uF | C-EUC0201 | C0201 | CAPACITOR, European symbol |  |  |  |  |  |  |  |  |  |  |  |  | C | GRM033C71C104KE14D
C17 | 0.1uF | C-EUC0201 | C0201 | CAPACITOR, European symbol |  |  |  |  |  |  |  |  |  |  |  |  | C | GRM033C71C104KE14D
C18 | 0.1uF | C-EUC0201 | C0201 | CAPACITOR, European symbol |  |  |  |  |  |  |  |  |  |  |  |  | C | GRM033C71C104KE14D
C53 | 0.1uF | C-EUC0201 | C0201 | CAPACITOR, European symbol |  |  |  |  |  |  |  |  |  |  |  |  | C | GRM033C71C104KE14D
C54 | 0.1uF | C-EUC0201 | C0201 | CAPACITOR, European symbol |  |  |  |  |  |  |  |  |  |  |  |  | C | GRM033C71C104KE14D
C55 | 0.1uF | C-EUC0201 | C0201 | CAPACITOR, European symbol |  |  |  |  |  |  |  |  |  |  |  |  | C | GRM033C71C104KE14D
C56 | 0.1uF | C-EUC0201 | C0201 | CAPACITOR, European symbol |  |  |  |  |  |  |  |  |  |  |  |  | C | GRM033C71C104KE14D
C57 | 0.1uF | C-EUC0201 | C0201 | CAPACITOR, European symbol |  |  |  |  |  |  |  |  |  |  |  |  | C | GRM033C71C104KE14D
C60 | 0.1uF | C-EUC0201 | C0201 | CAPACITOR, European symbol |  |  |  |  |  |  |  |  |  |  |  |  | C | GRM033C71C104KE14D
C63 | 0.1uF | C-EUC0201 | C0201 | CAPACITOR, European symbol |  |  |  |  |  |  |  |  |  |  |  |  | C | GRM033C71C104KE14D
C65 | 0.1uF | C-EUC0201 | C0201 | CAPACITOR, European symbol |  |  |  |  |  |  |  |  |  |  |  |  | C | GRM033C71C104KE14D
C67 | 0.1uF | C-EUC0201 | C0201 | CAPACITOR, European symbol |  |  |  |  |  |  |  |  |  |  |  |  | C | GRM033C71C104KE14D
C68 | 0.1uF | C-EUC0201 | C0201 | CAPACITOR, European symbol |  |  |  |  |  |  |  |  |  |  |  |  | C | GRM033C71C104KE14D
C71 | 0.1uF | C-EUC0201 | C0201 | CAPACITOR, European symbol |  |  |  |  |  |  |  |  |  |  |  |  | C | GRM033C71C104KE14D
C72 | 0.1uF | C-EUC0201 | C0201 | CAPACITOR, European symbol |  |  |  |  |  |  |  |  |  |  |  |  | C | GRM033C71C104KE14D
C81 | 0.1uF | C-EUC0201 | C0201 | CAPACITOR, European symbol |  |  |  |  |  |  |  |  |  |  |  |  | C | GRM033C71C104KE14D
CARTRIDGE | 5650118-1 | A8_CART | A8_CART | This is the Atari Cartridge port part - Digikey part |  |  |  |  |  |  |  |  |  |  |  |  |  | 5650118-1
H3 | MOUNT-HOLE4.1 | MOUNT-HOLE4.1 | 4,1 | MOUNTING HOLE with drill center marker |  |  |  |  |  |  |  |  | 1
H6 | MOUNT-HOLE4.1 | MOUNT-HOLE4.1 | 4,1 | MOUNTING HOLE with drill center marker |  |  |  |  |  |  |  |  | 1
H7 | MOUNT-HOLE4.1 | MOUNT-HOLE4.1 | 4,1 | MOUNTING HOLE with drill center marker |  |  |  |  |  |  |  |  | 1
H8 | MOUNT-HOLE4.1 | MOUNT-HOLE4.1 | 4,1 | MOUNTING HOLE with drill center marker |  |  |  |  |  |  |  |  | 1
IC1 | SN74LVC138APWR | TC74LCX138FT | SOP65P640X120-16N | Toshiba TC74LCX138FT, Decoder, Demultiplexer, 1-of-8, Inverting, 1.65 3.6 V, 16-Pin TSSOP |  |  | Toshiba TC74LCX138FT, Decoder, Demultiplexer, 1-of-8, Inverting, 1.65 3.6 V, 16-Pin TSSOP | 1.2mm | Toshiba | TC74LCX138FT | N/A | https://www.mouser.com/Search/Refine.aspx?Keyword=N%2FA |  |  | 4063409 | http://uk.rs-online.com/web/p/products/4063409 |  | SN74LVC138APWR
IC2 | XRA1405IL24-F | XRA1405IL24-F | QFN50P400X400X100-25N | Interface - I/O Expanders 16 Bit SPI GPIO Expander |  |  | Interface - I/O Expanders 16 Bit SPI GPIO Expander | 1mm | MaxLinear | XRA1405IL24-F | 701-XRA1405IL24-F | https://www.mouser.com/Search/Refine.aspx?Keyword=701-XRA1405IL24-F |  |  |  |  |  | XRA1405IL24-F
J1 | 98424-G52-14ALF | 98424-G52-14ALF | 98424G5214ALF | Headers & Wire Housings Shrd Hdr, SMT,Dbl Rw 14P, Vertical, .76um | 70236917 | https://www.alliedelec.com/amphenolicc-98424-g52-14alf/70236917/ | Headers & Wire Housings Shrd Hdr, SMT,Dbl Rw 14P, Vertical, .76um | 7mm | Amphenol | 98424-G52-14ALF | 649-98424-G52-14ALF | https://www.mouser.com/Search/Refine.aspx?Keyword=649-98424-G52-14ALF |  |  | 1822960 | http://uk.rs-online.com/web/p/products/1822960 |  | 98424-G52-14ALF
JP1 |  | PINHD-1X7 | 1X07 | PIN HEADER |  |  |  |  |  |  |  |  | 1 | 0
JP2 |  | PINHD-2X20_2.00 | 2X20M | PIN HEADER |  |  |  |  |  |  |  |  |  |  |  |  |  | SBH21-NBPN-D20-ST-BK
JP3 |  | PINHD-2X10_2.00 | 2X10M | PIN HEADER |  |  |  |  |  |  |  |  | 1
JP4 |  | PINHD-2X04_2.00 | 2X04M | PIN HEADER |  |  |  |  |  |  |  |  | 1
JP5 |  | PINHD-2X04_2.00 | 2X04M | PIN HEADER |  |  |  |  |  |  |  |  | 1
LD_0P1 | SML-D12D1WT86 | LEDCHIPLED_0603 | CHIPLED_0603 | LED |  |  |  |  |  |  |  |  |  |  |  |  |  | SML-D12D1WT86
LD_1P | SML-D12D1WT86 | LEDCHIPLED_0603 | CHIPLED_0603 | LED |  |  |  |  |  |  |  |  |  |  |  |  |  | SML-D12D1WT86
LD_2P | SML-D12D1WT86 | LEDCHIPLED_0603 | CHIPLED_0603 | LED |  |  |  |  |  |  |  |  |  |  |  |  |  | SML-D12D1WT86
LD_3P | SML-D12D1WT86 | LEDCHIPLED_0603 | CHIPLED_0603 | LED |  |  |  |  |  |  |  |  |  |  |  |  |  | SML-D12D1WT86
LD_4P | SML-D12D1WT86 | LEDCHIPLED_0603 | CHIPLED_0603 | LED |  |  |  |  |  |  |  |  |  |  |  |  |  | SML-D12D1WT86
LVL_AHI | SN74LVC8T245 | SN74LVC8T245 | TSSOP24 |  |  |  |  |  |  |  |  |  |  |  |  |  |  | SN74LVC8T245PWR
LVL_ALO | SN74LVC8T245 | SN74LVC8T245 | TSSOP24 |  |  |  |  |  |  |  |  |  |  |  |  |  |  | SN74LVC8T245PWR
LVL_D | SN74LVC8T245 | SN74LVC8T245 | TSSOP24 |  |  |  |  |  |  |  |  |  |  |  |  |  |  | SN74LVC8T245PWR
R1 | 22R | R-EU_R0201 | R0201 | RESISTOR, European symbol |  |  |  |  |  |  |  |  |  |  |  |  | R | RC0603J220CS
R2 | 10K | R-EU_R0201 | R0201 | RESISTOR, European symbol |  |  |  |  |  |  |  |  |  |  |  |  | R | ERJ-1GNJ103C
R3 | 10K | R-EU_R0201 | R0201 | RESISTOR, European symbol |  |  |  |  |  |  |  |  |  |  |  |  | R | ERJ-1GNJ103C
R4 | 10K | R-EU_R0201 | R0201 | RESISTOR, European symbol |  |  |  |  |  |  |  |  |  |  |  |  | R | ERJ-1GNJ103C
R5 | 10K | R-EU_R0201 | R0201 | RESISTOR, European symbol |  |  |  |  |  |  |  |  |  |  |  |  | R | ERJ-1GNJ103C
R6 | 22R | R-EU_R0201 | R0201 | RESISTOR, European symbol |  |  |  |  |  |  |  |  |  |  |  |  | R | RC0603J220CS
R10 | 10K | R-EU_R0201 | R0201 | RESISTOR, European symbol |  |  |  |  |  |  |  |  |  |  |  |  | R | ERJ-1GNJ103C
R13 | 10K | R-EU_R0201 | R0201 | RESISTOR, European symbol |  |  |  |  |  |  |  |  |  |  |  |  | R | ERJ-1GNJ103C
R19 | 10K | R-EU_R0201 | R0201 | RESISTOR, European symbol |  |  |  |  |  |  |  |  |  |  |  |  | R | ERJ-1GNJ103C
R21 | 10K | R-EU_R0201 | R0201 | RESISTOR, European symbol |  |  |  |  |  |  |  |  |  |  |  |  | R | ERJ-1GNJ103C
R22 | 10K | R-EU_R0201 | R0201 | RESISTOR, European symbol |  |  |  |  |  |  |  |  |  |  |  |  | R | ERJ-1GNJ103C
R25 | 10K | R-EU_R0201 | R0201 | RESISTOR, European symbol |  |  |  |  |  |  |  |  |  |  |  |  | R | ERJ-1GNJ103C
R26 | 10K | R-EU_R0201 | R0201 | RESISTOR, European symbol |  |  |  |  |  |  |  |  |  |  |  |  | R | ERJ-1GNJ103C
R27 | 59R | R-EU_R0402 | R0402 | RESISTOR, European symbol |  |  |  |  |  |  |  |  |  |  |  |  | R | RMCF0402FT59R0
R61 | 10K | R-EU_R0201 | R0201 | RESISTOR, European symbol |  |  |  |  |  |  |  |  |  |  |  |  | R | ERJ-1GNJ103C
R62 | 10K | R-EU_R0201 | R0201 | RESISTOR, European symbol |  |  |  |  |  |  |  |  |  |  |  |  | R | ERJ-1GNJ103C
R63 | 10K | R-EU_R0201 | R0201 | RESISTOR, European symbol |  |  |  |  |  |  |  |  |  |  |  |  | R | ERJ-1GNJ103C
R64 | 10K | R-EU_R0201 | R0201 | RESISTOR, European symbol |  |  |  |  |  |  |  |  |  |  |  |  | R | ERJ-1GNJ103C
R65 | 10K | R-EU_R0201 | R0201 | RESISTOR, European symbol |  |  |  |  |  |  |  |  |  |  |  |  | R | ERJ-1GNJ103C
R98 | 59R | R-EU_R0402 | R0402 | RESISTOR, European symbol |  |  |  |  |  |  |  |  |  |  |  |  | R | RMCF0402FT59R0
R101 | 59R | R-EU_R0402 | R0402 | RESISTOR, European symbol |  |  |  |  |  |  |  |  |  |  |  |  | R | RMCF0402FT59R0
R104 | 59R | R-EU_R0402 | R0402 | RESISTOR, European symbol |  |  |  |  |  |  |  |  |  |  |  |  | R | RMCF0402FT59R0
R107 | 59R | R-EU_R0402 | R0402 | RESISTOR, European symbol |  |  |  |  |  |  |  |  |  |  |  |  | R | RMCF0402FT59R0
SLOT0 | PCIE_64 | PCIE_64 | PCI-E_64 |  |  |  |  |  |  |  |  |  |  |  |  |  |  | 10018783-10201TLF
SLOT1 | PCIE_64 | PCIE_64 | PCI-E_64 |  |  |  |  |  |  |  |  |  |  |  |  |  |  | 10018783-10201TLF
SLOT2 | PCIE_64 | PCIE_64 | PCI-E_64 |  |  |  |  |  |  |  |  |  |  |  |  |  |  | 10018783-10201TLF
SLOT3 | PCIE_64 | PCIE_64 | PCI-E_64 |  |  |  |  |  |  |  |  |  |  |  |  |  |  | 10018783-10201TLF
SLOT4 | PCIE_64 | PCIE_64 | PCI-E_64 |  |  |  |  |  |  |  |  |  |  |  |  |  |  | 10018783-10201TLF
U$1 | MPBI+ | MPBI+ | 2X25 |  |  |  |  |  |  |  |  |  | 1
U$3 | MINI-SAS | MINI-SAS | MINI-SAS | Mini-SAS connector, right angle through hole |  |  |  |  |  |  |  |  |  |  |  |  |  | 1888019-4
U$4 | 74LVC1T45GWSOT866 | 74LVC1T45GWSOT866 | SOT886 |  |  |  |  |  |  |  |  |  |  |  |  |  |  | 74LVCH1T45GS,132
U$5 | 74LVC1T45GWSOT866 | 74LVC1T45GWSOT866 | SOT886 |  |  |  |  |  |  |  |  |  |  |  |  |  |  | 74LVCH1T45GS,132
U$6 | 74LVC1T45GWSOT866 | 74LVC1T45GWSOT866 | SOT886 |  |  |  |  |  |  |  |  |  |  |  |  |  |  | 74LVCH1T45GS,132
U$8 | 74LVC1T45GWSOT866 | 74LVC1T45GWSOT866 | SOT886 |  |  |  |  |  |  |  |  |  |  |  |  |  |  | 74LVCH1T45GS,132
U$9 | 74LVC1T45GWSOT866 | 74LVC1T45GWSOT866 | SOT886 |  |  |  |  |  |  |  |  |  |  |  |  |  |  | 74LVCH1T45GS,132
U$14 | 74LVC1T45GWSOT866 | 74LVC1T45GWSOT866 | SOT886 |  |  |  |  |  |  |  |  |  |  |  |  |  |  | 74LVCH1T45GS,132
U$15 | 74LVC1T45GWSOT866 | 74LVC1T45GWSOT866 | SOT886 |  |  |  |  |  |  |  |  |  |  |  |  |  |  | 74LVCH1T45GS,132
U$16 | 74LVC1T45GWSOT866 | 74LVC1T45GWSOT866 | SOT886 |  |  |  |  |  |  |  |  |  |  |  |  |  |  | 74LVCH1T45GS,132
U$17 | 74LVC1T45GWSOT866 | 74LVC1T45GWSOT866 | SOT886 |  |  |  |  |  |  |  |  |  |  |  |  |  |  | 74LVCH1T45GS,132
ZTURN | ZTURN | ZTURN | ZTURN |  |  |  |  |  |  |  |  |  | 1
