ThrudTheBarbarian/pbxl/boards/xio2/xio2.csv

Part | Value | Device | Package | Description | AVAILABILITY | DATASHEETURL | DESCRIPTION | FREQUENCY | IMAX | MANUFACTURER_NAME | MANUFACTURER_PART_NUMBER | MF | MKTG_PACKAGE | MP | MPN | NOSTUFF | NSID | OC_FARNELL | OC_NEWARK | PACKAGE | PRICE | SPICEPREFIX | USE | VALUE | VENDOR
ADV7125 | ADV7125 | ADV7125 | QFN50P700X700X100-49T495 |  |  |  |  |  |  |  |  |  |  |  |  |  |  |  |  |  |  |  | ADV7125BCPZ170
ARCH_ID | 209-4MS | SW_DIP-4 | EDG-04 | DIP SWITCH |  |  |  |  |  |  |  |  |  |  |  |  |  |  |  |  |  |  | 209-4MS
A_MUX | TS3A27518EPWR | TS3A27518E | TSSOP24 |  |  |  |  |  |  |  |  |  |  |  |  |  |  |  |  |  |  |  | TS3A27518EPWR
BOOT_MODE | 209-3MS | SW_DIP-3 | EDG-03 | DIP SWITCH |  |  |  |  |  |  |  |  |  |  |  |  |  |  |  |  |  |  | 209-3MS
C1 | 10uF | C-EUC0402K | C0402K | CAPACITOR, European symbol |  |  |  |  |  |  |  |  |  |  |  |  |  |  |  |  |  | C | GRM155C80J106ME11D
C2 | 0.1uF | C-EUC0201 | C0201 | CAPACITOR, European symbol |  |  |  |  |  |  |  |  |  |  |  |  |  |  |  |  |  | C | GRM033C71C104KE14D
C3 | 0.1uF | C-EUC0201 | C0201 | CAPACITOR, European symbol |  |  |  |  |  |  |  |  |  |  |  |  |  |  |  |  |  | C | GRM033C71C104KE14D
C4 | 0.1uF | C-EUC0201 | C0201 | CAPACITOR, European symbol |  |  |  |  |  |  |  |  |  |  |  |  |  |  |  |  |  | C | GRM033C71C104KE14D
C5 | 0.1uF | C-EUC0201 | C0201 | CAPACITOR, European symbol |  |  |  |  |  |  |  |  |  |  |  |  |  |  |  |  |  | C | GRM033C71C104KE14D
C6 | 0.1uF | C-EUC0201 | C0201 | CAPACITOR, European symbol |  |  |  |  |  |  |  |  |  |  |  |  |  |  |  |  |  | C | GRM033C71C104KE14D
C7 | 0.1uF | C-EUC0201 | C0201 | CAPACITOR, European symbol |  |  |  |  |  |  |  |  |  |  |  |  |  |  |  |  |  | C | GRM033C71C104KE14D
C8 | 0.1uF | C-EUC0201 | C0201 | CAPACITOR, European symbol |  |  |  |  |  |  |  |  |  |  |  |  |  |  |  |  |  | C | GRM033C71C104KE14D
C9 | 0.1uF | C-EUC0201 | C0201 | CAPACITOR, European symbol |  |  |  |  |  |  |  |  |  |  |  |  |  |  |  |  |  | C | GRM033C71C104KE14D
C10 | 0.1uF | C-EUC0201 | C0201 | CAPACITOR, European symbol |  |  |  |  |  |  |  |  |  |  |  |  |  |  |  |  |  | C | GRM033C71C104KE14D
C11 | 10uF | C-EUC0805 | C0805 | CAPACITOR, European symbol |  |  |  |  |  |  |  |  |  |  |  |  |  |  |  |  |  | C | C2012X6S1C106K085AC
C12 | 22uF | C-EUC2012 | C2012 | CAPACITOR, European symbol |  |  |  |  |  |  |  |  |  |  |  |  |  |  |  |  |  | C | CL21A226MOCLRNC
C13 | 0.1uF | C-EUC0201 | C0201 | CAPACITOR, European symbol |  |  |  |  |  |  |  |  |  |  |  |  |  |  |  |  |  | C | GRM033C71C104KE14D
C14 | 16pF | C-EUC0201 | C0201 | CAPACITOR, European symbol |  |  |  |  |  |  |  |  |  |  |  |  |  |  |  |  |  | C | GRM0335C1H160JA01D
C15 | 16pF | C-EUC0201 | C0201 | CAPACITOR, European symbol |  |  |  |  |  |  |  |  |  |  |  |  |  |  |  |  |  | C | GRM0335C1H160JA01D
C16 | 0.1uF | C-EUC0201 | C0201 | CAPACITOR, European symbol |  |  |  |  |  |  |  |  |  |  |  |  |  |  |  |  |  | C | GRM033C71C104KE14D
C17 | 2.2uF | C-EUC0201 | C0201 | CAPACITOR, European symbol |  |  |  |  |  |  |  |  |  |  |  |  |  |  |  |  |  | C | GRM033R60J225ME47D
C18 | 2.2uF | C-EUC0201 | C0201 | CAPACITOR, European symbol |  |  |  |  |  |  |  |  |  |  |  |  |  |  |  |  |  | C | GRM033R60J225ME47D
C19 | 0.1uF | C-EUC0201 | C0201 | CAPACITOR, European symbol |  |  |  |  |  |  |  |  |  |  |  |  |  |  |  |  |  | C | GRM033C71C104KE14D
C20 | 0.1uF | C-EUC0201 | C0201 | CAPACITOR, European symbol |  |  |  |  |  |  |  |  |  |  |  |  |  |  |  |  |  | C | GRM033C71C104KE14D
C21 | 0.1uF | C-EUC0201 | C0201 | CAPACITOR, European symbol |  |  |  |  |  |  |  |  |  |  |  |  |  |  |  |  |  | C | GRM033C71C104KE14D
C22 | 0.1uF | C-EUC0201 | C0201 | CAPACITOR, European symbol |  |  |  |  |  |  |  |  |  |  |  |  |  |  |  |  |  | C | GRM033C71C104KE14D
C23 | 0.1uF | C-EUC0201 | C0201 | CAPACITOR, European symbol |  |  |  |  |  |  |  |  |  |  |  |  |  |  |  |  |  | C | GRM033C71C104KE14D
C24 | 0.1uF | C-EUC0201 | C0201 | CAPACITOR, European symbol |  |  |  |  |  |  |  |  |  |  |  |  |  |  |  |  |  | C | GRM033C71C104KE14D
C25 | 0.1uF | C-EUC0201 | C0201 | CAPACITOR, European symbol |  |  |  |  |  |  |  |  |  |  |  |  |  |  |  |  |  | C | GRM033C71C104KE14D
C26 | 0.1uF | C-EUC0201 | C0201 | CAPACITOR, European symbol |  |  |  |  |  |  |  |  |  |  |  |  |  |  |  |  |  | C | GRM033C71C104KE14D
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
C145 | 560pF | C-EUC0402 | C0402 | CAPACITOR, European symbol |  |  |  |  |  |  |  |  |  |  |  |  |  |  |  |  |  | C | CL05C561JB5NNNC
C146 | 33uF | C-EUC0805 | C0805 | CAPACITOR, European symbol |  |  |  |  |  |  |  |  |  |  |  |  |  |  |  |  |  | C | C2012X5R1A336M125AC
C167 | 0.1uF | C-EUC0201 | C0201 | CAPACITOR, European symbol |  |  |  |  |  |  |  |  |  |  |  |  |  |  |  |  |  | C | GRM033C71C104KE14D
C168 | 0.1uF | C-EUC0201 | C0201 | CAPACITOR, European symbol |  |  |  |  |  |  |  |  |  |  |  |  |  |  |  |  |  | C | GRM033C71C104KE14D
C169 | 0.1uF | C-EUC0201 | C0201 | CAPACITOR, European symbol |  |  |  |  |  |  |  |  |  |  |  |  |  |  |  |  |  | C | GRM033C71C104KE14D
C170 | 0.1uF | C-EUC0201 | C0201 | CAPACITOR, European symbol |  |  |  |  |  |  |  |  |  |  |  |  |  |  |  |  |  | C | GRM033C71C104KE14D
C171 | 0.1uF | C-EUC0201 | C0201 | CAPACITOR, European symbol |  |  |  |  |  |  |  |  |  |  |  |  |  |  |  |  |  | C | GRM033C71C104KE14D
C172 | 0.1uF | C-EUC0201 | C0201 | CAPACITOR, European symbol |  |  |  |  |  |  |  |  |  |  |  |  |  |  |  |  |  | C | GRM033C71C104KE14D
C173 | 1uF | C-EUC0201 | C0201 | CAPACITOR, European symbol |  |  |  |  |  |  |  |  |  |  |  |  |  |  |  |  |  | C | CL03A105MO3NRNH
C177 | 4.7uF | C-EUC0201 | C0201 | CAPACITOR, European symbol |  |  |  |  |  |  |  |  |  |  |  |  |  |  |  |  |  | C | GRM035R60J475ME15D
CARTRIDGE | 5650118-1 | A8_CART | A8_CART |  |  |  |  |  |  |  |  |  |  |  |  |  |  |  |  |  |  |  | 5650118-1
D1 | BAT54S | BAT54S | SOT23 | Schottky Diodes |  |  |  |  |  |  |  |  |  |  |  |  |  |  |  |  |  |  | BAT54SFILMY
D2 | BAT54S | BAT54S | SOT23 | Schottky Diodes |  |  |  |  |  |  |  |  |  |  |  |  |  |  |  |  |  |  | BAT54SFILMY
DBG0 | YELLOW_LED | LED0603 | CHIPLED_0603 | LED |  |  |  |  |  |  |  |  |  |  |  |  |  |  |  |  |  |  | LTST-C191KFKT
DBG1 | YELLOW_LED | LED0603 | CHIPLED_0603 | LED |  |  |  |  |  |  |  |  |  |  |  |  |  |  |  |  |  |  | LTST-C191KFKT
DBG2 | YELLOW_LED | LED0603 | CHIPLED_0603 | LED |  |  |  |  |  |  |  |  |  |  |  |  |  |  |  |  |  |  | LTST-C191KFKT
EXPANSION |  | PINHD-2X6 | 2X06 | PIN HEADER |  |  |  |  |  |  |  |  |  |  |  | true
EXP_POWER |  | PINHD-1X2 | 1X02 | PIN HEADER |  |  |  |  |  |  |  |  |  |  |  | true
FPGA_1_0 | TLV62095 | TLV62095 | QFN50P310X310X100-16 |  |  |  |  |  |  |  |  |  |  |  |  |  |  |  |  |  |  |  | TLV62095RGTR
FPGA_CFG | W25Q80DVSNIG | SPIFLASH_SOIC8 | SOIC8_150MIL | SOIC8 SPI Flash |  |  |  |  |  |  |  |  |  |  |  |  |  |  |  |  |  |  | MT25QU128ABA1ESE-0SIT TR
FPGA_DONE | LTST-C191KFKT | LED0603 | CHIPLED_0603 | LED |  |  |  |  |  |  |  |  |  |  |  |  |  |  |  |  |  |  | SML-D12D1WT86
FPGA_PROG | XILINX-JTAG | XILINX-JTAG | 332-14 |  |  |  |  |  |  |  |  |  |  |  |  |  |  |  |  |  |  |  | SBH21-NBPN-D07-ST-BK
H1 | MOUNT-HOLE3.2 | MOUNT-HOLE3.2 | 3,2 | MOUNTING HOLE with drill center marker |  |  |  |  |  |  |  |  |  |  |  | true
H2 | MOUNT-HOLE3.2 | MOUNT-HOLE3.2 | 3,2 | MOUNTING HOLE with drill center marker |  |  |  |  |  |  |  |  |  |  |  | true
H4 | MOUNT-HOLE3.2 | MOUNT-HOLE3.2 | 3,2 | MOUNTING HOLE with drill center marker |  |  |  |  |  |  |  |  |  |  |  | true
H5 | MOUNT-HOLE3.2 | MOUNT-HOLE3.2 | 3,2 | MOUNTING HOLE with drill center marker |  |  |  |  |  |  |  |  |  |  |  | true
HOST_IO |  | PINHD-2X20/90 | 2X20/90 | PIN HEADER |  |  |  |  |  |  |  |  |  |  |  | true
IO_EXP | MCP23S17T-E/SS | MCP23S17T-E/SS | SSOP28 |  |  |  |  |  |  |  |  |  |  |  |  |  |  |  |  |  |  |  | MCP23S17T-E/SS
J1 | 12401598E4#2A | 12401598E4#2A | AMPHENOL_12401598E4#2A | Usb Jack 3.1, C Type, 24 Pin, Ho | Unavailable |  | Usb Type C / Tape & Reel |  |  |  |  | Amphenol Commercial |  | 12401598E4#2A |  |  |  |  |  | None | None |  | 12401598E4#2A
L1 | 1.5uH | L-EUL5650M | L5650M | INDUCTOR, European symbol |  |  |  |  |  |  |  |  |  |  |  |  |  |  |  |  |  | L | ASPI-0530LR-1R5M-T2
L2 | 2.2uH | PA4332 | RESC4137X200 |  |  |  |  |  |  |  |  |  |  |  |  |  |  |  |  |  |  |  | PA4332.222NLT
L3 | 470nH | DFE18SANR47MG0L | L0603 |  |  |  |  |  |  |  |  |  |  |  |  |  |  |  |  |  |  |  | DFE18SANR47MG0L
LD_0ACT | LTST-C191KRKT | LEDCHIPLED_0603 | CHIPLED_0603 | LED |  |  |  |  |  |  |  |  |  |  |  |  |  |  |  |  |  |  | 150060RS75000
LD_0P | SML-D12D1WT86 | LEDCHIPLED_0603 | CHIPLED_0603 | LED |  |  |  |  |  |  |  |  |  |  |  |  |  |  |  |  |  |  | SML-D12D1WT86
LD_1ACT | LTST-C191KRKT | LEDCHIPLED_0603 | CHIPLED_0603 | LED |  |  |  |  |  |  |  |  |  |  |  |  |  |  |  |  |  |  | 150060RS75000
LD_1P | SML-D12D1WT86 | LEDCHIPLED_0603 | CHIPLED_0603 | LED |  |  |  |  |  |  |  |  |  |  |  |  |  |  |  |  |  |  | SML-D12D1WT86
LD_2ACT | LTST-C191KRKT | LEDCHIPLED_0603 | CHIPLED_0603 | LED |  |  |  |  |  |  |  |  |  |  |  |  |  |  |  |  |  |  | 150060RS75000
LD_2P | SML-D12D1WT86 | LEDCHIPLED_0603 | CHIPLED_0603 | LED |  |  |  |  |  |  |  |  |  |  |  |  |  |  |  |  |  |  | SML-D12D1WT86
LD_3ACT | LTST-C191KRKT | LEDCHIPLED_0603 | CHIPLED_0603 | LED |  |  |  |  |  |  |  |  |  |  |  |  |  |  |  |  |  |  | 150060RS75000
LD_3P | SML-D12D1WT86 | LEDCHIPLED_0603 | CHIPLED_0603 | LED |  |  |  |  |  |  |  |  |  |  |  |  |  |  |  |  |  |  | SML-D12D1WT86
LD_4ACT | LTST-C191KRKT | LEDCHIPLED_0603 | CHIPLED_0603 | LED |  |  |  |  |  |  |  |  |  |  |  |  |  |  |  |  |  |  | 150060RS75000
LD_4P | SML-D12D1WT86 | LEDCHIPLED_0603 | CHIPLED_0603 | LED |  |  |  |  |  |  |  |  |  |  |  |  |  |  |  |  |  |  | SML-D12D1WT86
LD_7DBG0 | IN-S63BTA | LEDCHIPLED_0603 | CHIPLED_0603 | LED |  |  |  |  |  |  |  |  |  |  |  |  |  |  |  |  |  |  | ASMT-RA45-AP932
LD_7DBG1 | IN-S63BTA | LEDCHIPLED_0603 | CHIPLED_0603 | LED |  |  |  |  |  |  |  |  |  |  |  |  |  |  |  |  |  |  | ASMT-RA45-AP932
LD_7DBG2 | IN-S63BTA | LEDCHIPLED_0603 | CHIPLED_0603 | LED |  |  |  |  |  |  |  |  |  |  |  |  |  |  |  |  |  |  | ASMT-RA45-AP932
LD_AUX | LTST-S270GKT | LEDCHIPLED_0603 | CHIPLED_0603 | LED |  |  |  |  |  |  |  |  |  |  |  |  |  |  |  |  |  |  | LTST-S270GKT
LD_INT | LTST-S270GKT | LEDCHIPLED_0603 | CHIPLED_0603 | LED |  |  |  |  |  |  |  |  |  |  |  |  |  |  |  |  |  |  | LTST-S270GKT
LD_V33 | LTST-S270GKT | LEDCHIPLED_0603 | CHIPLED_0603 | LED |  |  |  |  |  |  |  |  |  |  |  |  |  |  |  |  |  |  | LTST-S270GKT
LVL_AHI | SN74LVC8T245 | SN74LVC8T245 | TSSOP24 |  |  |  |  |  |  |  |  |  |  |  |  |  |  |  |  |  |  |  | SN74LVC8T245PWR
LVL_ALO | SN74LVC8T245 | SN74LVC8T245 | TSSOP24 |  |  |  |  |  |  |  |  |  |  |  |  |  |  |  |  |  |  |  | SN74LVC8T245PWR
LVL_D | SN74LVC8T245 | SN74LVC8T245 | TSSOP24 |  |  |  |  |  |  |  |  |  |  |  |  |  |  |  |  |  |  |  | SN74LVC8T245PWR
MEM_ID | 209-2MS | SW_DIP-2 | EDG-02 | DIP SWITCH |  |  |  |  |  |  |  |  |  |  |  |  |  |  |  |  |  |  | 209-2MS
MUX-HI | IDTQS3VH257 | IDTQS3VH257 | SO16 |  |  |  |  |  |  |  |  |  |  |  |  |  |  |  |  |  |  |  | QS3VH257S1G
MUX-LO | IDTQS3VH257 | IDTQS3VH257 | SO16 |  |  |  |  |  |  |  |  |  |  |  |  |  |  |  |  |  |  |  | QS3VH257S1G
OSC1 | 50 MHz oscillator | OSCILLATOR3.2X2.5 | OSC_3.2X2.5MM | Oscillators |  |  |  |  |  |  |  |  |  |  |  |  |  |  |  |  |  |  | SIT8008BI-23-33S-50.000000G
PEXT_10 |  | PINHD-1X2 | 1X02 | PIN HEADER |  |  |  |  |  |  |  |  |  |  |  | true
PEXT_18 |  | PINHD-1X2 | 1X02 | PIN HEADER |  |  |  |  |  |  |  |  |  |  |  | true
PEXT_33 |  | PINHD-2X2 | 2X02 | PIN HEADER |  |  |  |  |  |  |  |  |  |  |  | true
PID | 209-3MS | SW_DIP-3 | EDG-03 | DIP SWITCH |  |  |  |  |  |  |  |  |  |  |  |  |  |  |  |  |  |  | 209-3MS
POWER | dc5vin | CONN-POWER-JACK-2.1MM(DC-005) | DCJ3P-14.2X11.0X9.0MM | 320120003 |  |  |  |  |  |  |  |  |  |  | DC-005 |  |  |  |  |  |  |  | PJ-102AH | DC-005
PSW | NCP380 | NCP380 | SOT23-6 |  |  |  |  |  |  |  |  |  |  |  |  |  |  |  |  |  |  |  | NCP380HSNAJAAT1G
Q1 | BSS138 | BSS123 | SOT23 | N-CHANNEL MOS FET |  |  |  |  |  |  |  |  |  |  |  |  |  |  |  |  |  |  | BSS138
Q2 | BSS138 | BSS123 | SOT23 | N-CHANNEL MOS FET |  |  |  |  |  |  |  |  |  |  |  |  |  |  |  |  |  |  | BSS138
Q3 | BC817-16LT3G | TRANSISTOR_NPN | SOT23-R | NPN Transistor |  |  |  |  |  |  |  |  |  |  |  |  |  |  |  |  |  |  | BC817-16LT3G
Q4 | BC817-16LT3G | TRANSISTOR_NPN | SOT23-R | NPN Transistor |  |  |  |  |  |  |  |  |  |  |  |  |  |  |  |  |  |  | BC817-16LT3G
R1 | 0R | R-EU_R0201 | R0201 | RESISTOR, European symbol |  |  |  |  |  |  |  |  |  |  |  |  |  |  |  |  |  | R | RC0201JR-070RL
R2 | 130R | R-EU_R0402 | R0402 | RESISTOR, European symbol |  |  |  |  |  |  |  |  |  |  |  |  |  |  |  |  |  | R | RMCF0402JT130R
R3 | 130R | R-EU_R0402 | R0402 | RESISTOR, European symbol |  |  |  |  |  |  |  |  |  |  |  |  |  |  |  |  |  | R | RMCF0402JT130R
R4 | 130R | R-EU_R0402 | R0402 | RESISTOR, European symbol |  |  |  |  |  |  |  |  |  |  |  |  |  |  |  |  |  | R | RMCF0402JT130R
R5 | 0R | R-EU_R0201 | R0201 | RESISTOR, European symbol |  |  |  |  |  |  |  |  |  |  |  | TRUE |  |  |  |  |  | R
R6 | 47K | R-EU_R0201 | R0201 | RESISTOR, European symbol |  |  |  |  |  |  |  |  |  |  |  |  |  |  |  |  |  | R | RMCF0201JT47K0
R7 | 47K | R-EU_R0201 | R0201 | RESISTOR, European symbol |  |  |  |  |  |  |  |  |  |  |  |  |  |  |  |  |  | R | RMCF0201JT47K0
R8 | 47K | R-EU_R0201 | R0201 | RESISTOR, European symbol |  |  |  |  |  |  |  |  |  |  |  |  |  |  |  |  |  | R | RMCF0201JT47K0
R9 | 47K | R-EU_R0201 | R0201 | RESISTOR, European symbol |  |  |  |  |  |  |  |  |  |  |  |  |  |  |  |  |  | R | RMCF0201JT47K0
R10 | 560R | R-EU_R0201 | R0201 | RESISTOR, European symbol |  |  |  |  |  |  |  |  |  |  |  |  |  |  |  |  |  | R | RC0201FR-07560RL
R11 | 1K | R-EU_R0201 | R0201 | RESISTOR, European symbol |  |  |  |  |  |  |  |  |  |  |  |  |  |  |  |  |  | R | RC0201JR-071KL
R12 | 1K | R-EU_R0201 | R0201 | RESISTOR, European symbol |  |  |  |  |  |  |  |  |  |  |  |  |  |  |  |  |  | R | RC0201JR-071KL
R13 | 1K | R-EU_R0201 | R0201 | RESISTOR, European symbol |  |  |  |  |  |  |  |  |  |  |  |  |  |  |  |  |  | R | RC0201JR-071KL
R14 | 47K | R-EU_R0201 | R0201 | RESISTOR, European symbol |  |  |  |  |  |  |  |  |  |  |  |  |  |  |  |  |  | R | RMCF0201JT47K0
R15 | 47K | R-EU_R0201 | R0201 | RESISTOR, European symbol |  |  |  |  |  |  |  |  |  |  |  |  |  |  |  |  |  | R | RMCF0201JT47K0
R16 | 47K | R-EU_R0201 | R0201 | RESISTOR, European symbol |  |  |  |  |  |  |  |  |  |  |  |  |  |  |  |  |  | R | RMCF0201JT47K0
R17 | 47K | R-EU_R0201 | R0201 | RESISTOR, European symbol |  |  |  |  |  |  |  |  |  |  |  |  |  |  |  |  |  | R | RMCF0201JT47K0
R18 | 47K | R-EU_R0201 | R0201 | RESISTOR, European symbol |  |  |  |  |  |  |  |  |  |  |  |  |  |  |  |  |  | R | RMCF0201JT47K0
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
R120 | 10K | R-EU_R0201 | R0201 | RESISTOR, European symbol |  |  |  |  |  |  |  |  |  |  |  |  |  |  |  |  |  | R | ERJ-1GNJ103C
R121 | 10K | R-EU_R0201 | R0201 | RESISTOR, European symbol |  |  |  |  |  |  |  |  |  |  |  |  |  |  |  |  |  | R | ERJ-1GNJ103C
R122 | 1K | R-EU_R0201 | R0201 | RESISTOR, European symbol |  |  |  |  |  |  |  |  |  |  |  |  |  |  |  |  |  | R | RC0201JR-071KL
R123 | 1K | R-EU_R0201 | R0201 | RESISTOR, European symbol |  |  |  |  |  |  |  |  |  |  |  |  |  |  |  |  |  | R | RC0201JR-071KL
R124 | 1K | R-EU_R0201 | R0201 | RESISTOR, European symbol |  |  |  |  |  |  |  |  |  |  |  |  |  |  |  |  |  | R | RC0201JR-071KL
R125 | 47K | R-EU_R0201 | R0201 | RESISTOR, European symbol |  |  |  |  |  |  |  |  |  |  |  |  |  |  |  |  |  | R | RMCF0201JT47K0
R126 | 47K | R-EU_R0201 | R0201 | RESISTOR, European symbol |  |  |  |  |  |  |  |  |  |  |  |  |  |  |  |  |  | R | RMCF0201JT47K0
R127 | 47K | R-EU_R0201 | R0201 | RESISTOR, European symbol |  |  |  |  |  |  |  |  |  |  |  |  |  |  |  |  |  | R | RMCF0201JT47K0
R128 | 1K | R-EU_R0201 | R0201 | RESISTOR, European symbol |  |  |  |  |  |  |  |  |  |  |  |  |  |  |  |  |  | R | RC0201JR-071KL
R129 | 499K | R-EU_R0402 | R0402 | RESISTOR, European symbol |  |  |  |  |  |  |  |  |  |  |  |  |  |  |  |  |  | R | ERJ-2RKF4993X
R130 | 40.2K | R-EU_R0402 | R0402 | RESISTOR, European symbol |  |  |  |  |  |  |  |  |  |  |  |  |  |  |  |  |  | R | RMCF0402FT40K2
R131 | 160K | R-EU_R0402 | R0402 | RESISTOR, European symbol |  |  |  |  |  |  |  |  |  |  |  |  |  |  |  |  |  | R | RMCF0402JT160K
R133 | 10.5R | R-EU_R0402 | R0402 | RESISTOR, European symbol |  |  |  |  |  |  |  |  |  |  |  |  |  |  |  |  |  | R | CRCW040210R5FKED
R134 | 48.7K | R-EU_R0402 | R0402 | RESISTOR, European symbol |  |  |  |  |  |  |  |  |  |  |  |  |  |  |  |  |  | R | CRCW040248K7FKED
R135 | 6.04K | R-EU_R0805 | R0805 | RESISTOR, European symbol |  |  |  |  |  |  |  |  |  |  |  |  |  |  |  |  |  | R | ERJ-6ENF6041V
R136 | 12K | R-EU_R0805 | R0805 | RESISTOR, European symbol |  |  |  |  |  |  |  |  |  |  |  |  |  |  |  |  |  | R | RR1220P-123-D
R137 | 2.67K | R-EU_R0402 | R0402 | RESISTOR, European symbol |  |  |  |  |  |  |  |  |  |  |  |  |  |  |  |  |  | R | CRCW04022K67FKED
R138 | 64.9R | R-EU_R0402 | R0402 | RESISTOR, European symbol |  |  |  |  |  |  |  |  |  |  |  |  |  |  |  |  |  | R | CRCW040264R9FKED
R139 | 105K | R-EU_R0201 | R0201 | RESISTOR, European symbol |  |  |  |  |  |  |  |  |  |  |  |  |  |  |  |  |  | R | RC0201FR-07105KL
RESET_S7 | Tac-switch | TAC_SWITCHPTH | TACTILE-PTH | Momentary Switch |  |  |  |  |  |  |  |  |  |  |  |  |  |  |  |  |  |  | 1825910-6
RESET_XIO | TAC_SWITCH | TAC_SWITCHPTH | TACTILE-PTH | Momentary Switch |  |  |  |  |  |  |  |  |  |  |  |  |  |  |  |  |  |  | 1825910-6
SDRAM | IS42S32160F-7TLI | IS42S32160F-7TLI | SOP50P1176X120-86 |  |  |  |  |  |  |  |  |  |  |  |  |  |  |  |  |  |  |  | IS42S32160F-7TLI
SD_SLOT | 5025700893 | MICROSD_MOLEX_5025700893 | 5025700893 | Molex 5025700893 MicroSD Normal Mount SMT Connector |  |  |  |  |  |  |  |  |  |  |  |  |  |  |  |  |  |  | 5025700893
SERIAL0 | 9-way D | DB9 | DB9 | DB9 Connector |  |  |  |  |  |  |  |  |  |  |  |  |  |  |  |  |  |  | D09P33E4GX00LF
SERIAL_BUF0 | MAX3232ECDR | MAX3232CSE | SO16 | True RS-232 Transceivers 3.0V to 5.5V, Low-Power |  |  |  |  |  |  |  |  |  |  | MAX3232CSE |  |  | 9725490 | 90C2890 |  |  |  | MAX3232ECDR
SLOT0 | PCIE_64 | PCIE_64 | PCI-E_64 |  |  |  |  |  |  |  |  |  |  |  |  |  |  |  |  |  |  |  | 10018783-10201TLF
SLOT1 | PCIE_64 | PCIE_64 | PCI-E_64 |  |  |  |  |  |  |  |  |  |  |  |  |  |  |  |  |  |  |  | 10018783-10201TLF
SLOT2 | PCIE_64 | PCIE_64 | PCI-E_64 |  |  |  |  |  |  |  |  |  |  |  |  |  |  |  |  |  |  |  | 10018783-10201TLF
SLOT3 | PCIE_64 | PCIE_64 | PCI-E_64 |  |  |  |  |  |  |  |  |  |  |  |  |  |  |  |  |  |  |  | 10018783-10201TLF
SLOT4 | PCIE_64 | PCIE_64 | PCI-E_64 |  |  |  |  |  |  |  |  |  |  |  |  |  |  |  |  |  |  |  | 10018783-10201TLF
SPI_DBG |  | PINHD-1X5 | 1X05 | PIN HEADER |  |  |  |  |  |  |  |  |  |  |  | true
U$5 | 74LVC1T45GWSOT866 | 74LVC1T45GWSOT866 | SOT886 |  |  |  |  |  |  |  |  |  |  |  |  |  |  |  |  |  |  |  | 74LVCH1T45GS,132
U$6 | 74LVC1T45GWSOT866 | 74LVC1T45GWSOT866 | SOT886 |  |  |  |  |  |  |  |  |  |  |  |  |  |  |  |  |  |  |  | 74LVCH1T45GS,132
U$7 | 74LVC1T45GWSOT866 | 74LVC1T45GWSOT866 | SOT886 |  |  |  |  |  |  |  |  |  |  |  |  |  |  |  |  |  |  |  | 74LVCH1T45GS,132
U$8 | 74LVC1T45GWSOT866 | 74LVC1T45GWSOT866 | SOT886 |  |  |  |  |  |  |  |  |  |  |  |  |  |  |  |  |  |  |  | 74LVCH1T45GS,132
USB | MINI-USB-UX60-MB-5ST | MINI-USB-UX60-MB-5ST | UX60-MB-5ST | MINI USB Connector |  |  |  |  |  |  |  |  |  |  |  |  |  | unknown | unknown |  |  |  | UX60-MB-5ST
USB_ESD | PUSB2X4YH | PUSB2X4YH | SOT363 |  |  |  |  |  |  |  |  |  |  |  |  |  |  |  |  |  |  |  | PUSB2X4YH
VGA | 15-way D | DB15 | DB15 | DB15 / VGA right angle through-hole female connector. |  |  |  |  |  |  |  |  |  |  |  |  |  |  |  |  |  |  | ICD15S13E4GX00LF
VREG_18 | TPS62087RLTR | TPS62087RLTR | RLT0007A |  |  | httpwww.ti.comproducttps62087 |  | 100000.0 | 3.0 | Texas Instruments | TPS62087RLTR |  | TPS62087 |  |  |  | TPS62087RLTR |  |  | TPS62087 |  |  | TPS62087RLTR |  | Texas Instruments
VREG_33 | LM21212 | LM21212 | HTSSOP20 |  |  |  |  |  |  |  |  |  |  |  |  |  |  |  |  |  |  |  | LM21212MHX-2/NOPB
VREG_MON | TPS3808G33DBVR | TPS3808DBVR | SOT23-6 |  |  |  |  |  |  |  |  |  |  |  |  |  |  |  |  |  |  |  | TPS3808G33DBVR
VREG_VGA | AD1580ARTZ | AD1580ARTZ | SOT23 |  |  |  |  |  |  |  |  |  |  |  |  |  |  |  |  |  |  |  | AD1580ARTZ-REEL7
XC7S25 | XC7S25 | XC7S25 | BGA196C100P14X14_1500X1500X146 |  |  |  |  |  |  |  |  |  |  |  |  |  |  |  |  |  |  |  | XC7S25-2FTGB196I
XIO | STM32H743-XIO | STM32H743-XIO | BGA289C80P17X17_1400X1400X110 |  |  |  |  |  |  |  |  |  |  |  |  |  |  |  |  |  |  |  | STM32H743XIH6
XIO-SWD | XIO_JTAG | STM_DEBUG | SWD_DEBUG |  |  |  |  |  |  |  |  |  |  |  |  |  |  |  |  |  |  |  | FTSH-105-01-LM-DV-K-P-TR
XSPI5_DBG |  | PINHD-1X3 | 1X03 | PIN HEADER |  |  |  |  |  |  |  |  |  |  |  | TRUE
XSPI6_DBG |  | PINHD-1X3 | 1X03 | PIN HEADER |  |  |  |  |  |  |  |  |  |  |  | TRUE
Y2 | FA-238 25.0000MB-K3 | CRYSTALTHIN | CRYSTAL_3.2X2.5 | Crystals |  |  |  |  |  |  |  |  |  |  |  |  |  |  |  |  |  |  | FA-238 25.0000MB-K3
