ThrudTheBarbarian/pbxl/boards/xio2/errata.html

# Problems on the boards from run #1

- VREG_33 chip is rotated by 180 degrees. Placement error

# Suggestions for rev-2

- Place pin-1 markers on MUX-HI and MUX-LO
- Place 'ON SIDE' text for all DIP switches
- Place better pin-1 marker for VREG_33
- Place pin-1 marker for IO_EXP
- Move XSPI6_DBG up slightly, to compensate for Xilinx connector
- Place +/- around all LEDs
- Check cartridge placement so close to serial port
- Add gnd connectors
- Add pinouts for serial i/o (2 and 6)>
- USART2 has TX/RX inverted at the 9-way D>
- Move the SD card closer to the MCU, swap position with DIP switches
