ThrudTheBarbarian/pbxl/boards/xio2/xio2.pdf

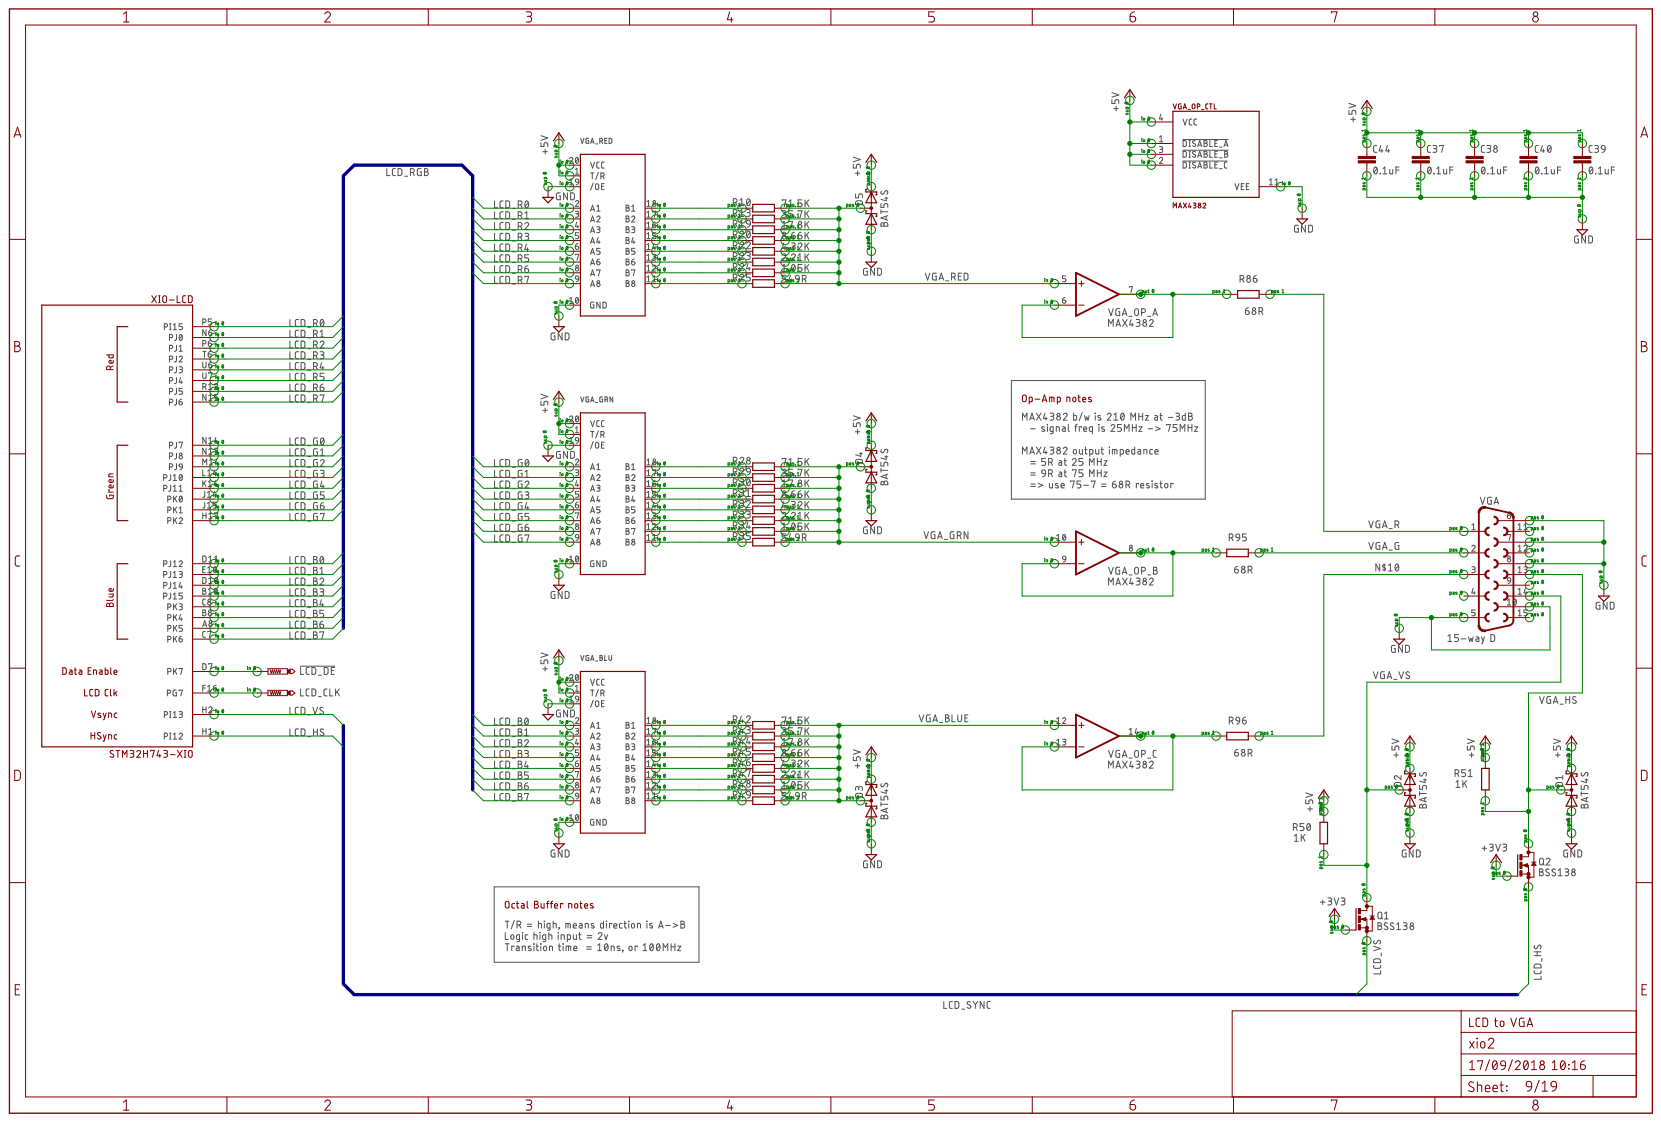
[picture p97: page 1]
