ThrudTheBarbarian/pbxl/(list of files, drawings)

Other design files:
boards/xio5/xio5.dsn
