ThrudTheBarbarian/pbxl/boards/xe-lvl/xe-lvl.brd

## EAGLE design boards/xe-lvl/xe-lvl.brd (2019-09-23)

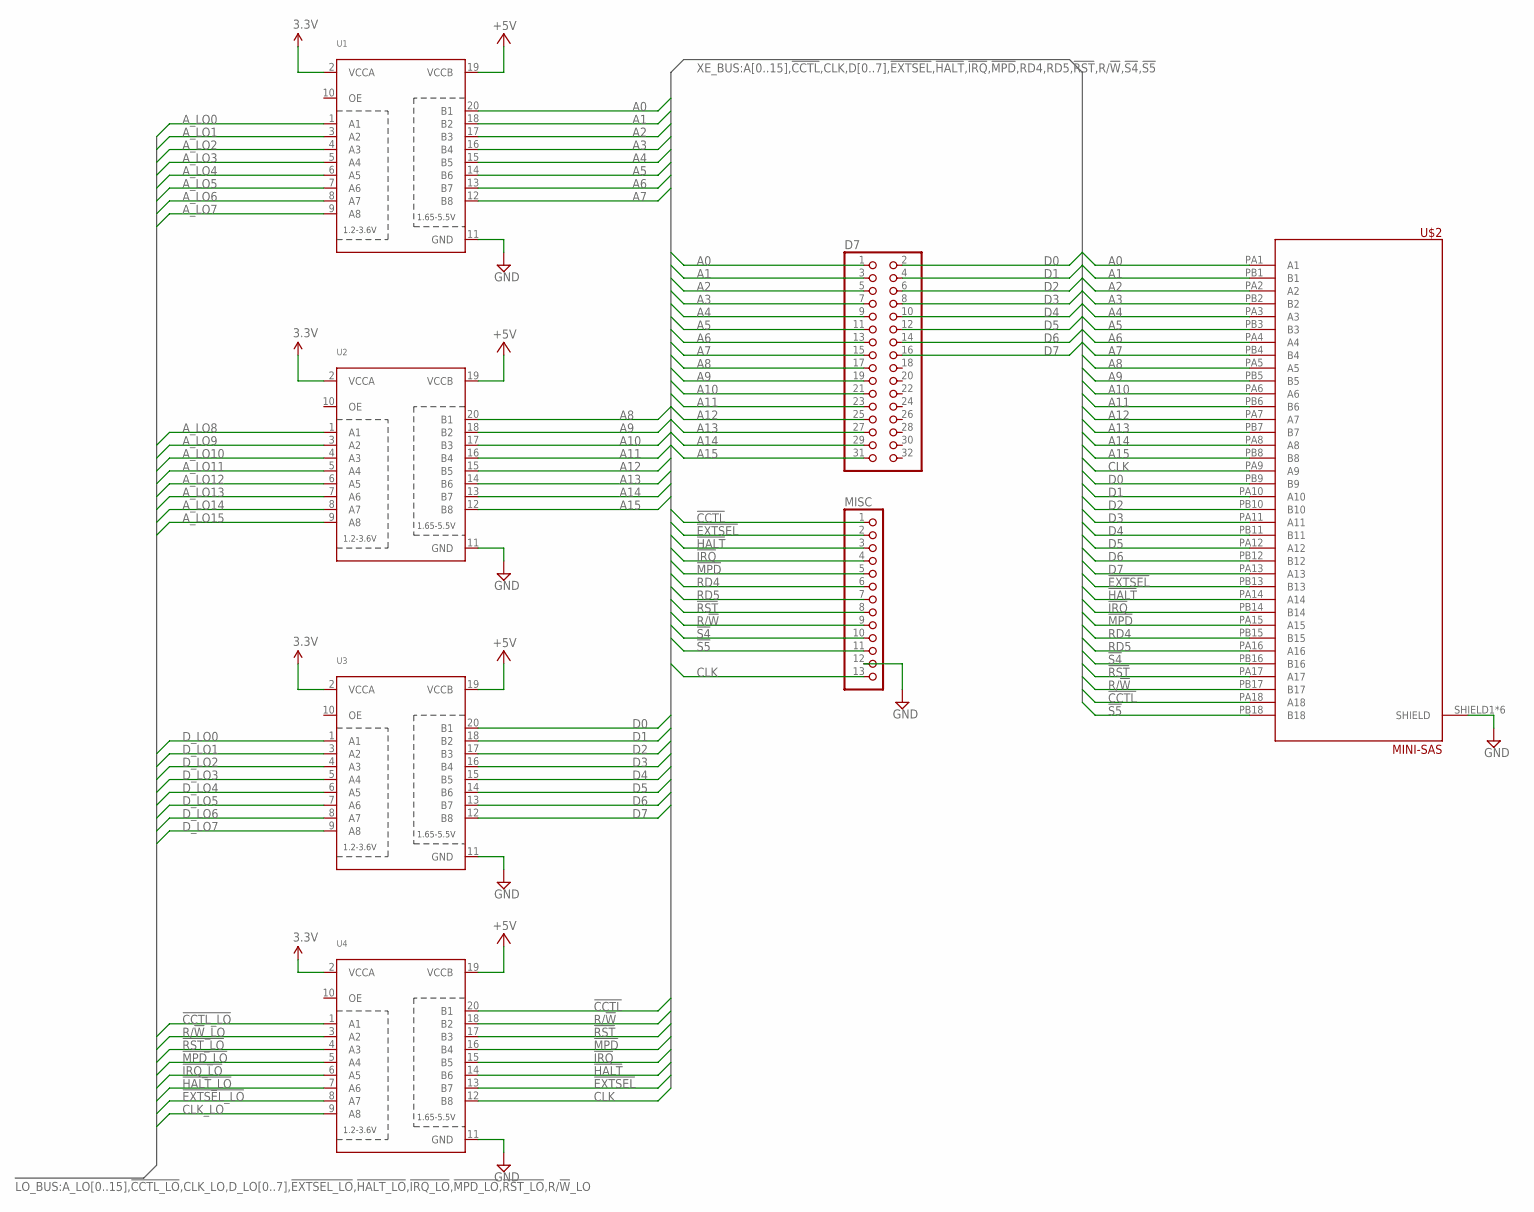
[picture p98: schematic xe-lvl.sch, sheet 1, BUS i/o]

Parts:
D7: PINHD-2X16; 2X16
MISC: PINHD-1X13; 1X13
U1, U2, U3, U4: TXB0108PWR; TSSOP20
U$2: MINI-SAS

Connections:
3.3V: U1.2 (VCCA), U2.2 (VCCA), U3.2 (VCCA), U4.2 (VCCA); also elsewhere on the board
!CCTL!: MISC.1, U4.20 (B1), U$2.PA18 (A18)
!CCTL_LO!: U4.1 (A1)
!EXTSEL!: MISC.2, U4.13 (B7), U$2.PB13 (B13)
!EXTSEL_LO!: U4.8 (A7)
!HALT!: MISC.3, U4.14 (B6), U$2.PA14 (A14)
!HALT_LO!: U4.7 (A6)
!IRQ!: MISC.4, U4.15 (B5), U$2.PB14 (B14)
!IRQ_LO!: U4.6 (A5)
!MPD!: MISC.5, U4.16 (B4), U$2.PA15 (A15)
!MPD_LO!: U4.5 (A4)
!RST!: MISC.8, U4.17 (B3), U$2.PA17 (A17); also elsewhere on the board
!RST_LO!: U4.4 (A3)
!S4!: MISC.10, U$2.PB16 (B16)
!S5!: MISC.11, U$2.PB18 (B18)
+5V: U1.19 (VCCB), U2.19 (VCCB), U3.19 (VCCB), U4.19 (VCCB); also elsewhere on the board
A0: D7.1, U1.20 (B1), U$2.PA1 (A1)
A1: D7.3, U1.18 (B2), U$2.PB1 (B1)
A2: D7.5, U1.17 (B3), U$2.PA2 (A2)
A3: D7.7, U1.16 (B4), U$2.PB2 (B2)
A4: D7.9, U1.15 (B5), U$2.PA3 (A3)
A5: D7.11, U1.14 (B6), U$2.PB3 (B3)
A6: D7.13, U1.13 (B7), U$2.PA4 (A4)
A7: D7.15, U1.12 (B8), U$2.PB4 (B4)
A8: D7.17, U2.20 (B1), U$2.PA5 (A5)
A9: D7.19, U2.18 (B2), U$2.PB5 (B5)
A10: D7.21, U2.17 (B3), U$2.PA6 (A6)
A11: D7.23, U2.16 (B4), U$2.PB6 (B6)
A12: D7.25, U2.15 (B5), U$2.PA7 (A7)
A13: D7.27, U2.14 (B6), U$2.PB7 (B7)
A14: D7.29, U2.13 (B7), U$2.PA8 (A8)
A15: D7.31, U2.12 (B8), U$2.PB8 (B8)
A_LO0: U1.1 (A1)
A_LO1: U1.3 (A2)
A_LO2: U1.4 (A3)
A_LO3: U1.5 (A4)
A_LO4: U1.6 (A5)
A_LO5: U1.7 (A6)
A_LO6: U1.8 (A7)
A_LO7: U1.9 (A8)
A_LO8: U2.1 (A1)
A_LO9: U2.3 (A2)
A_LO10: U2.4 (A3)
A_LO11: U2.5 (A4)
A_LO12: U2.6 (A5)
A_LO13: U2.7 (A6)
A_LO14: U2.8 (A7)
A_LO15: U2.9 (A8)
CLK: MISC.13, U4.12 (B8), U$2.PA9 (A9)
CLK_LO: U4.9 (A8)
D0: D7.2, U3.20 (B1), U$2.PB9 (B9)
D1: D7.4, U3.18 (B2), U$2.PA10 (A10)
D2: D7.6, U3.17 (B3), U$2.PB10 (B10)
D3: D7.8, U3.16 (B4), U$2.PA11 (A11)
D4: D7.10, U3.15 (B5), U$2.PB11 (B11)
D5: D7.12, U3.14 (B6), U$2.PA12 (A12)
D6: D7.14, U3.13 (B7), U$2.PB12 (B12)
D7: D7.16, U3.12 (B8), U$2.PA13 (A13)
D_LO0: U3.1 (A1)
D_LO1: U3.3 (A2)
D_LO2: U3.4 (A3)
D_LO3: U3.5 (A4)
D_LO4: U3.6 (A5)
D_LO5: U3.7 (A6)
D_LO6: U3.8 (A7)
D_LO7: U3.9 (A8)
GND: MISC.12, U1.11 (GND), U2.11 (GND), U3.11 (GND), U4.11 (GND), U$2.SHIELD1 (SHIELD), U$2.SHIELD2 (SHIELD), U$2.SHIELD3 (SHIELD), U$2.SHIELD4 (SHIELD), U$2.SHIELD5 (SHIELD), U$2.SHIELD6 (SHIELD); also elsewhere on the board
R/!W!: MISC.9, U4.18 (B2), U$2.PB17 (B17)
R/!W!_LO: U4.3 (A2)
RD4: MISC.6, U$2.PB15 (B15)
RD5: MISC.7, U$2.PA16 (A16)

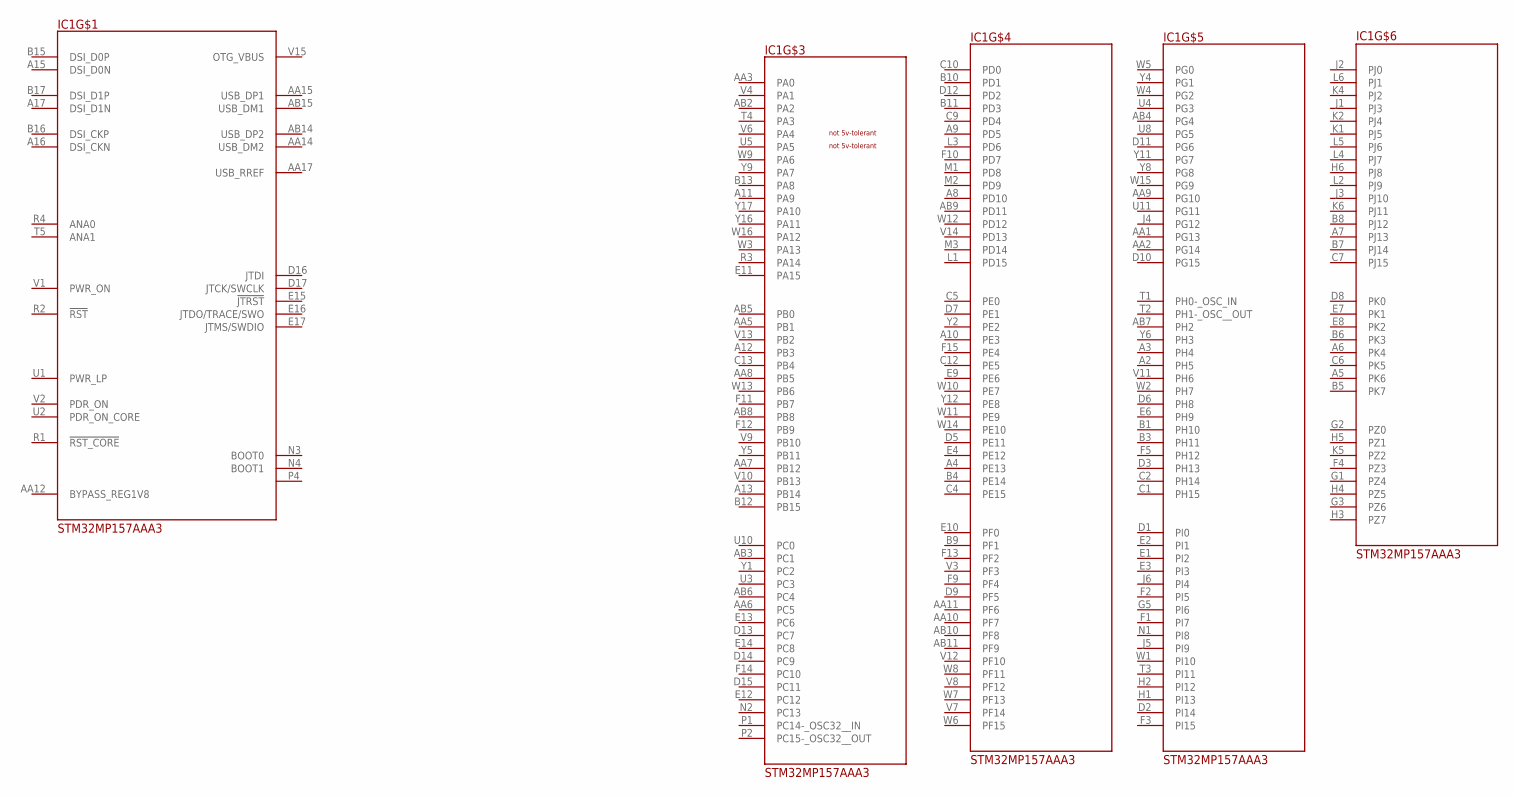
[picture p99: schematic xe-lvl.sch, sheet 2]

Parts:
IC1: STM32MP157AAA3; BGA448C80P22X22_1800X1800X127

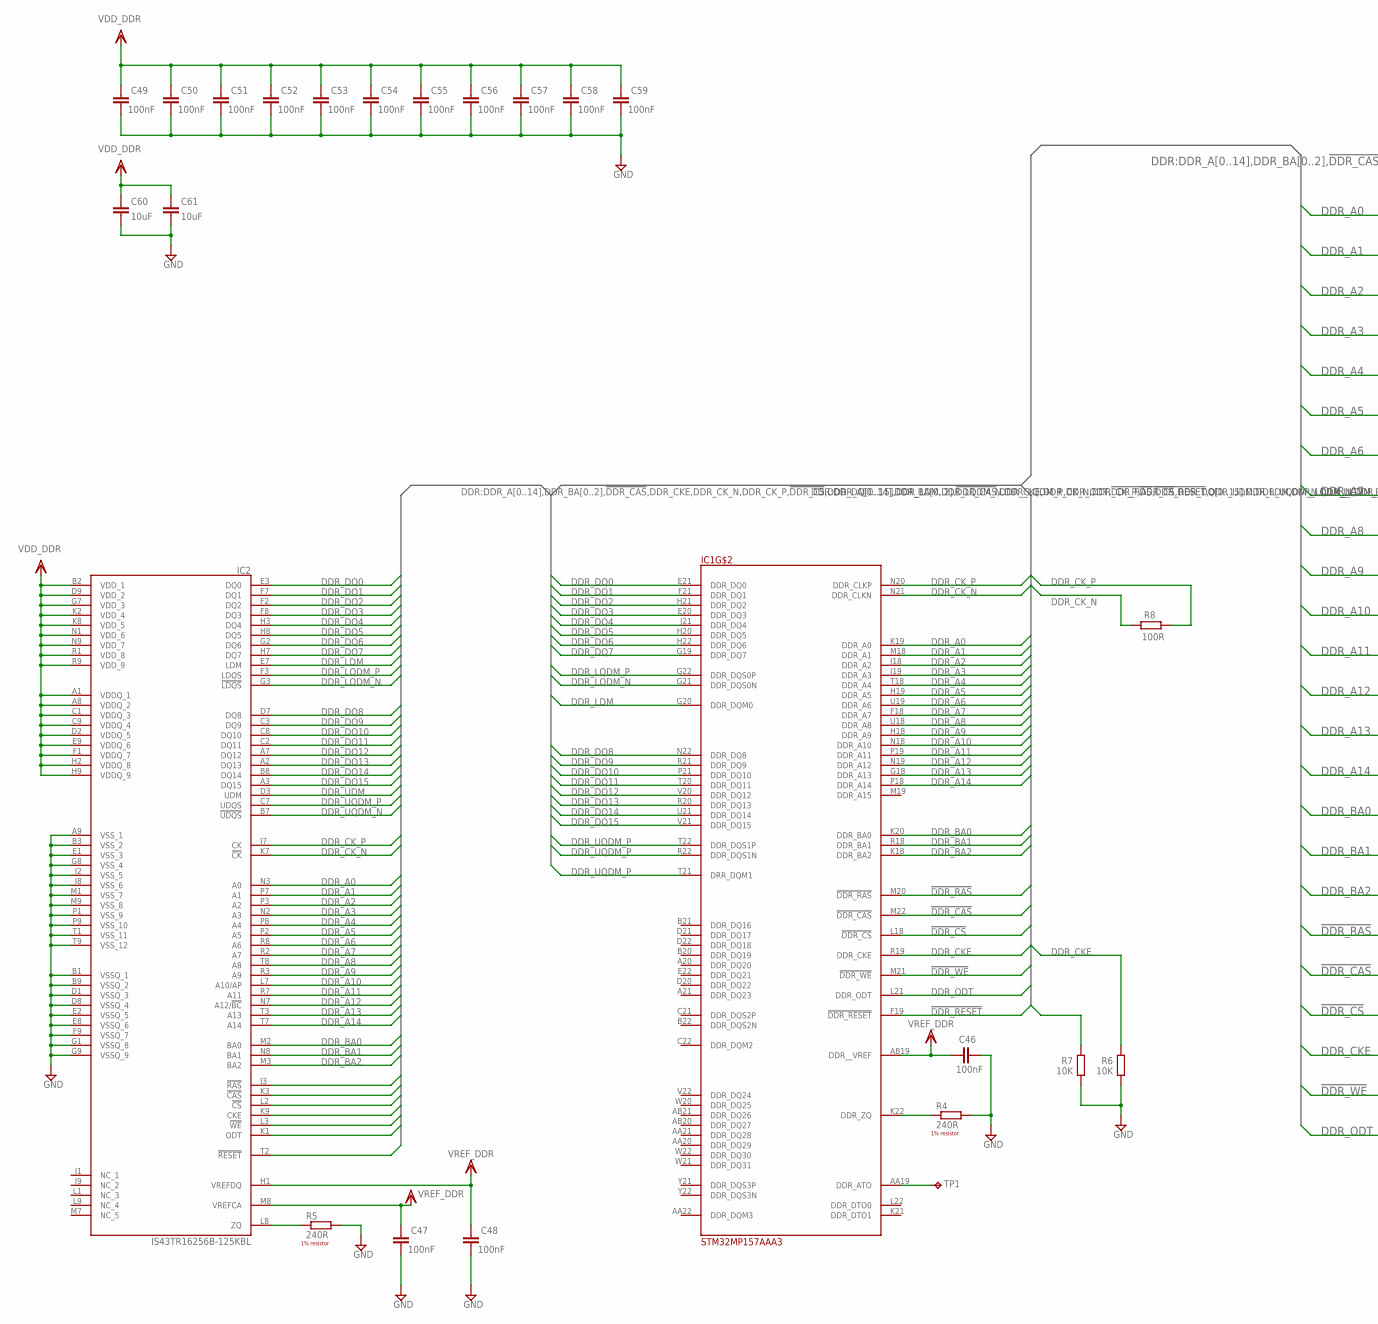
[picture p100: schematic xe-lvl.sch, sheet 3, Memory, part in row 1, column 1]

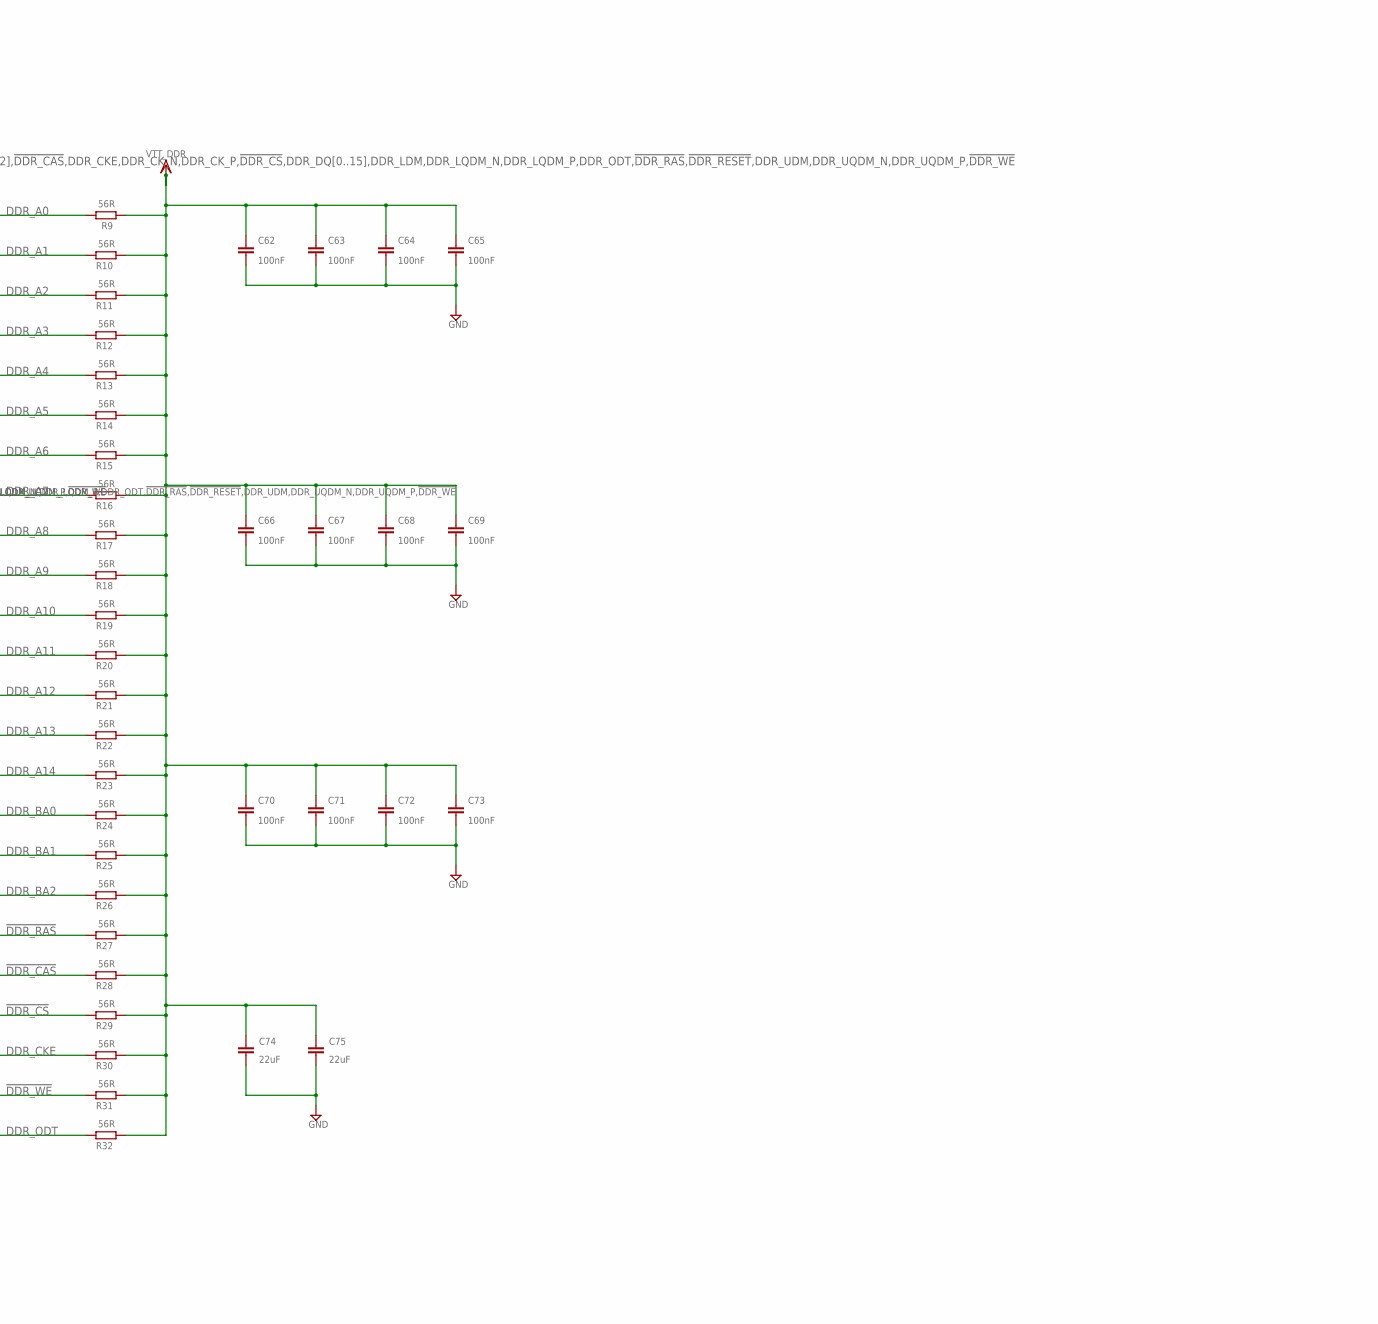
[picture p101: schematic xe-lvl.sch, sheet 3, Memory, part in row 1, column 2]

Parts:
C46, C47, C48, C49, C50, C51, C52, C53, C54, C55, C56, C57, C58, C59, C62, C63, C64, C65, C66, C67, C68, C69, C70, C71, C72, C73: 100nF; C0201
C60, C61: 10uF; C0402
C74, C75: 22uF; C0402
IC1: STM32MP157AAA3; BGA448C80P22X22_1800X1800X127
IC2: IS43TR16256B-125KBL; BGA96C80P9X16_800X1400X120
R4, R5: 240R; R0201
R6, R7: 10K; R0201
R8: 100R; R0201
R9, R10, R11, R12, R13, R14, R15, R16, R17, R18, R19, R20, R21, R22, R23, R24, R25, R26, R27, R28, R29, R30, R31, R32: 56R; R0201
TP1: TPB1,27; B1,27

Connections:
!DDR_CAS!: IC1.M22 (!DDR_CAS!), IC2.K3 (!CAS!), R28.1
!DDR_CS!: IC1.L18 (!DDR_CS!), IC2.L2 (!CS!), R29.1
!DDR_RAS!: IC1.M20 (!DDR_RAS!), IC2.J3 (!RAS!), R27.1
!DDR_RESET!: IC1.F19 (!DDR_RESET!), IC2.T2 (!RESET!), R7.2
!DDR_WE!: IC1.M21 (!DDR_WE!), IC2.L3 (!WE!), R31.1
DDR_A0: IC1.K19 (DDR_A0), IC2.N3 (A0), R9.1
DDR_A1: IC1.M18 (DDR_A1), IC2.P7 (A1), R10.1
DDR_A2: IC1.J18 (DDR_A2), IC2.P3 (A2), R11.1
DDR_A3: IC1.J19 (DDR_A3), IC2.N2 (A3), R12.1
DDR_A4: IC1.T18 (DDR_A4), IC2.P8 (A4), R13.1
DDR_A5: IC1.H19 (DDR_A5), IC2.P2 (A5), R14.1
DDR_A6: IC1.U19 (DDR_A6), IC2.R8 (A6), R15.1
DDR_A7: IC1.F18 (DDR_A7), IC2.R2 (A7), R16.1
DDR_A8: IC1.U18 (DDR_A8), IC2.T8 (A8), R17.1
DDR_A9: IC1.H18 (DDR_A9), IC2.R3 (A9), R18.1
DDR_A10: IC1.N18 (DDR_A10), IC2.L7 (A10/AP), R19.1
DDR_A11: IC1.P19 (DDR_A11), IC2.R7 (A11), R20.1
DDR_A12: IC1.N19 (DDR_A12), IC2.N7 (A12/!BC!), R21.1
DDR_A13: IC1.G18 (DDR_A13), IC2.T3 (A13), R22.1
DDR_A14: IC1.P18 (DDR_A14), IC2.T7 (A14), R23.1
DDR_BA0: IC1.K20 (DDR_BA0), IC2.M2 (BA0), R24.1
DDR_BA1: IC1.R18 (DDR_BA1), IC2.N8 (BA1), R25.1
DDR_BA2: IC1.K18 (DDR_BA2), IC2.M3 (BA2), R26.1
DDR_CKE: IC1.R19 (DDR_CKE), IC2.K9 (CKE), R6.2, R30.1
DDR_CK_N: IC1.N21 (DDR_CLKN), IC2.K7 (!CK!), R8.2
DDR_CK_P: IC1.N20 (DDR_CLKP), IC2.J7 (CK), R8.1
DDR_DQ0: IC1.E21 (DDR_DQ0), IC2.E3 (DQ0)
DDR_DQ1: IC1.F21 (DDR_DQ1), IC2.F7 (DQ1)
DDR_DQ2: IC1.H21 (DDR_DQ2), IC2.F2 (DQ2)
DDR_DQ3: IC1.E20 (DDR_DQ3), IC2.F8 (DQ3)
DDR_DQ4: IC1.J21 (DDR_DQ4), IC2.H3 (DQ4)
DDR_DQ5: IC1.H20 (DDR_DQ5), IC2.H8 (DQ5)
DDR_DQ6: IC1.H22 (DDR_DQ6), IC2.G2 (DQ6)
DDR_DQ7: IC1.G19 (DDR_DQ7), IC2.H7 (DQ7)
DDR_DQ8: IC1.N22 (DDR_DQ8), IC2.D7 (DQ8)
DDR_DQ9: IC1.R21 (DDR_DQ9), IC2.C3 (DQ9)
DDR_DQ10: IC1.P21 (DDR_DQ10), IC2.C8 (DQ10)
DDR_DQ11: IC1.T20 (DDR_DQ11), IC2.C2 (DQ11)
DDR_DQ12: IC1.V20 (DDR_DQ12), IC2.A7 (DQ12)
DDR_DQ13: IC1.R20 (DDR_DQ13), IC2.A2 (DQ13)
DDR_DQ14: IC1.U21 (DDR_DQ14), IC2.B8 (DQ14)
DDR_DQ15: IC1.V21 (DDR_DQ15), IC2.A3 (DQ15)
DDR_LDM: IC1.G20 (DDR_DQM0), IC2.E7 (LDM)
DDR_LQDM_N: IC1.G21 (DDR_DQS0N), IC2.G3 (!LDQS!)
DDR_LQDM_P: IC1.G22 (DDR_DQS0P), IC2.F3 (LDQS)
DDR_ODT: IC1.L21 (DDR_ODT), IC2.K1 (ODT), R32.1
DDR_UDM: IC1.T21 (DRR_DQM1), IC2.D3 (UDM)
DDR_UQDM_N: IC1.R22 (DDR_DQS1N), IC2.B7 (!UDQS!)
DDR_UQDM_P: IC1.T22 (DDR_DQS1P), IC2.C7 (UDQS)
GND: C46.2, C47.1, C48.1, C49.1, C50.1, C51.1, C52.1, C53.1, C54.1, C55.1, C56.1, C57.1, C58.1, C59.1, C60.2, C61.2, C62.1, C63.1, C64.1, C65.1, C66.1, C67.1, C68.1, C69.1, C70.1, C71.1, C72.1, C73.1, C74.1, C75.1, IC2.A9 (VSS_1), IC2.B1 (VSSQ_1), IC2.B3 (VSS_2), IC2.B9 (VSSQ_2), IC2.D1 (VSSQ_3), IC2.D8 (VSSQ_4), IC2.E1 (VSS_3), IC2.E2 (VSSQ_5), IC2.E8 (VSSQ_6), IC2.F9 (VSSQ_7), IC2.G1 (VSSQ_8), IC2.G8 (VSS_4), IC2.G9 (VSSQ_9), IC2.J2 (VSS_5), IC2.J8 (VSS_6), IC2.M1 (VSS_7), IC2.M9 (VSS_8), IC2.P1 (VSS_9), IC2.P9 (VSS_10), IC2.T1 (VSS_11), IC2.T9 (VSS_12), R4.2, R5.2, R6.1, R7.1; also elsewhere on the board
unnamed: IC1.K22 (DDR_ZQ), R4.1
unnamed: IC1.AA19 (DDR_ATO), TP1.TP
unnamed: IC2.L8 (ZQ), R5.1
VDD_DDR: C49.2, C50.2, C51.2, C52.2, C53.2, C54.2, C55.2, C56.2, C57.2, C58.2, C59.2, C60.1, C61.1, IC2.A1 (VDDQ_1), IC2.A8 (VDDQ_2), IC2.B2 (VDD_1), IC2.C1 (VDDQ_3), IC2.C9 (VDDQ_4), IC2.D2 (VDDQ_5), IC2.D9 (VDD_2), IC2.E9 (VDDQ_6), IC2.F1 (VDDQ_7), IC2.G7 (VDD_3), IC2.H2 (VDDQ_8), IC2.H9 (VDDQ_9), IC2.K2 (VDD_4), IC2.K8 (VDD_5), IC2.N1 (VDD_6), IC2.N9 (VDD_7), IC2.R1 (VDD_8), IC2.R9 (VDD_9); also elsewhere on the board
VREF_DDR: C46.1, C47.2, C48.2, IC1.AB19 (DDR__VREF), IC2.H1 (VREFDQ), IC2.M8 (VREFCA); also elsewhere on the board
VTT_DDR: C62.2, C63.2, C64.2, C65.2, C66.2, C67.2, C68.2, C69.2, C70.2, C71.2, C72.2, C73.2, C74.2, C75.2, R9.2, R10.2, R11.2, R12.2, R13.2, R14.2, R15.2, R16.2, R17.2, R18.2, R19.2, R20.2, R21.2, R22.2, R23.2, R24.2, R25.2, R26.2, R27.2, R28.2, R29.2, R30.2, R31.2, R32.2; also elsewhere on the board

Notes on the sheet:
1% resistor

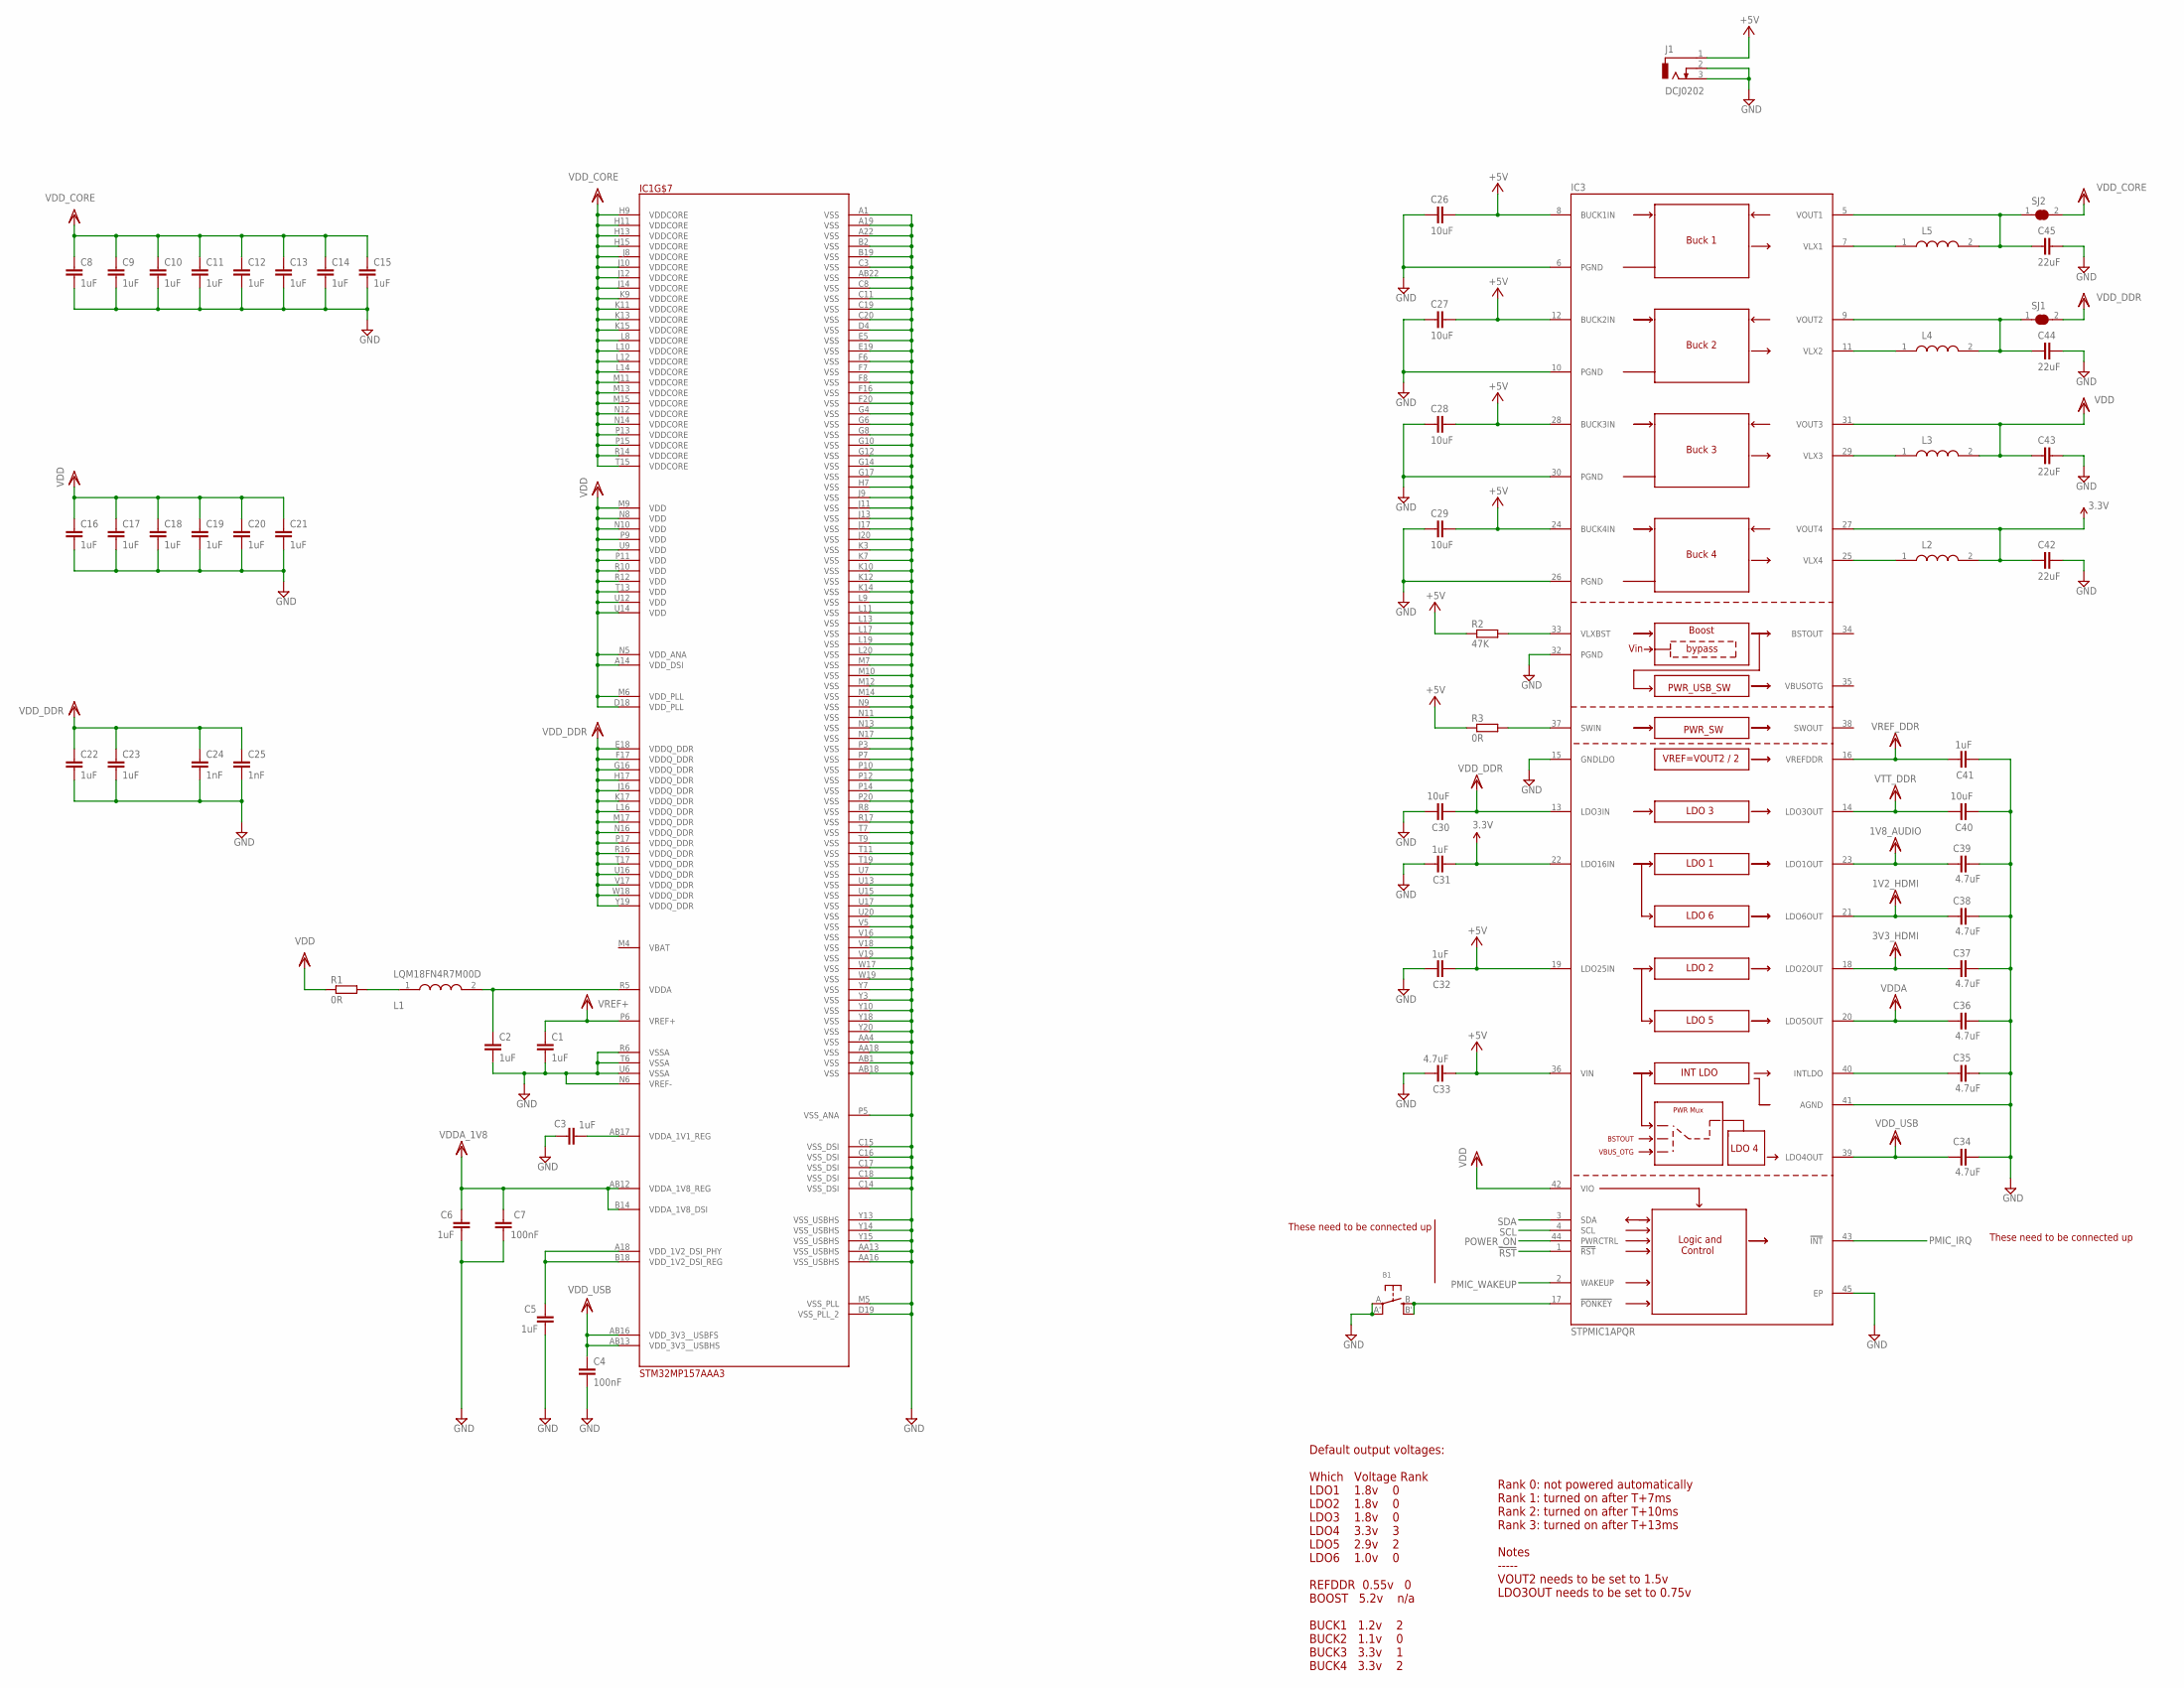
[picture p102: schematic xe-lvl.sch, sheet 4, STM Power]

Parts:
B1: SWITCH_TACT_SMT; EVQ-Q2
C1, C2, C3, C5, C6, C8, C9, C10, C11, C12, C13, C14, C15, C16, C17, C18, C19, C20, C21, C22, C23, C31, C32, C41: 1uF; C0201
C4, C7: 100nF; C0201
C24, C25: 1nF; C0201
C26, C27, C28, C29, C30, C40: 10uF; C0402
C33, C34, C35, C36, C37, C38, C39: 4.7uF; C0201
C42, C43, C44, C45: 22uF; C0402
IC1: STM32MP157AAA3; BGA448C80P22X22_1800X1800X127
IC3: STPMIC1APQR; QFN40P500X600X80-45N
J1: DCJ0202
L1: LQM18FN4R7M00D; INDC1608X90N
L2, L3, L4, L5: DFE252012P-1ROM=P2; INDC2520X120N
R1, R3: 0R; R0201
R2: 47K; R0201
SJ1, SJ2: SOLDERJUMPER_CLOSEDPERM

Connections:
1V2_HDMI: C38.1, IC3.21 (LDO6OUT)
1V8_AUDIO: C39.1, IC3.23 (LDO1OUT)
3.3V: C31.1, C42.1, IC3.22 (LDO16IN), IC3.27 (VOUT4), L2.2; also elsewhere on the board
3V3_HDMI: C37.1, IC3.18 (LDO2OUT)
!RST!: IC3.1 (!RST!); also elsewhere on the board
+5V: C26.2, C27.2, C28.2, C29.2, C32.1, C33.1, IC3.8 (BUCK1IN), IC3.12 (BUCK2IN), IC3.19 (LDO25IN), IC3.24 (BUCK4IN), IC3.28 (BUCK3IN), IC3.36 (VIN), J1.1, R2.1, R3.1; also elsewhere on the board
GND: B1.A, B1.A' (P1), C1.2, C2.2, C3.1, C4.2, C5.1, C6.1, C7.1, C8.2, C9.2, C10.2, C11.2, C12.2, C13.2, C14.2, C15.2, C16.2, C17.2, C18.2, C19.2, C20.2, C21.2, C22.2, C23.2, C24.2, C25.2, C26.1, C27.1, C28.1, C29.1, C30.2, C31.2, C32.2, C33.2, C34.2, C35.2, C36.2, C37.2, C38.2, C39.2, C40.1, C41.1, C42.2, C43.2, C44.2, C45.2, IC1.A1 (VSS), IC1.A19 (VSS), IC1.A22 (VSS), IC1.AA4 (VSS), IC1.AA13 (VSS_USBHS), IC1.AA16 (VSS_USBHS), IC1.AA18 (VSS), IC1.AB1 (VSS), IC1.AB18 (VSS), IC1.AB22 (VSS), IC1.B2 (VSS), IC1.B19 (VSS), IC1.C3 (VSS), IC1.C8 (VSS), IC1.C11 (VSS), IC1.C14 (VSS_DSI), IC1.C15 (VSS_DSI), IC1.C16 (VSS_DSI), IC1.C17 (VSS_DSI), IC1.C18 (VSS_DSI), IC1.C19 (VSS), IC1.C20 (VSS), IC1.D4 (VSS), IC1.D19 (VSS_PLL_2), IC1.E5 (VSS), IC1.E19 (VSS), IC1.F6 (VSS), IC1.F7 (VSS), IC1.F8 (VSS), IC1.F16 (VSS), IC1.F20 (VSS), IC1.G4 (VSS), IC1.G6 (VSS), IC1.G8 (VSS), IC1.G10 (VSS), IC1.G12 (VSS), IC1.G14 (VSS), IC1.G17 (VSS), IC1.H7 (VSS), IC1.J9 (VSS), IC1.J11 (VSS), IC1.J13 (VSS), IC1.J17 (VSS), IC1.J20 (VSS), IC1.K3 (VSS), IC1.K7 (VSS), IC1.K10 (VSS), IC1.K12 (VSS), IC1.K14 (VSS), IC1.L9 (VSS), IC1.L11 (VSS), IC1.L13 (VSS), IC1.L17 (VSS), IC1.L19 (VSS), IC1.L20 (VSS), IC1.M5 (VSS_PLL), IC1.M7 (VSS), IC1.M10 (VSS), IC1.M12 (VSS), IC1.M14 (VSS), IC1.N6 (VREF-), IC1.N9 (VSS), IC1.N11 (VSS), IC1.N13 (VSS), IC1.N17 (VSS), IC1.P3 (VSS), IC1.P5 (VSS_ANA), IC1.P7 (VSS), IC1.P10 (VSS), IC1.P12 (VSS), IC1.P14 (VSS), IC1.P20 (VSS), IC1.R6 (VSSA), IC1.R8 (VSS), IC1.R17 (VSS), IC1.T6 (VSSA), IC1.T7 (VSS), IC1.T9 (VSS), IC1.T11 (VSS), IC1.T19 (VSS), IC1.U6 (VSSA), IC1.U7 (VSS), IC1.U13 (VSS), IC1.U15 (VSS), IC1.U17 (VSS), IC1.U20 (VSS), IC1.V5 (VSS), IC1.V16 (VSS), IC1.V18 (VSS), IC1.V19 (VSS), IC1.W17 (VSS), IC1.W19 (VSS), IC1.Y3 (VSS), IC1.Y7 (VSS), IC1.Y10 (VSS), IC1.Y13 (VSS_USBHS), IC1.Y14 (VSS_USBHS), IC1.Y15 (VSS_USBHS), IC1.Y18 (VSS), IC1.Y20 (VSS), IC3.6 (PGND), IC3.10 (PGND), IC3.15 (GNDLDO), IC3.26 (PGND), IC3.30 (PGND), IC3.32 (PGND), IC3.41 (AGND), IC3.45 (EP), J1.2, J1.3; also elsewhere on the board
unnamed: C2.1, IC1.R5 (VDDA), L1.2
unnamed: L1.1, R1.2
unnamed: C3.2, IC1.AB17 (VDDA_1V1_REG)
unnamed: C5.2, IC1.A18 (VDD_1V2_DSI_PHY), IC1.B18 (VDD_1V2_DSI_REG)
unnamed: IC3.33 (VLXBST), R2.2
unnamed: B1.B (S), B1.B' (S1), IC3.17 (!PONKEY!)
unnamed: IC3.37 (SWIN), R3.2
unnamed: C35.1, IC3.40 (INTLDO)
unnamed: IC3.25 (VLX4), L2.1
unnamed: IC3.29 (VLX3), L3.1
unnamed: IC3.11 (VLX2), L4.1
unnamed: C44.1, IC3.9 (VOUT2), L4.2, SJ1.1
unnamed: IC3.7 (VLX1), L5.1
unnamed: C45.1, IC3.5 (VOUT1), L5.2, SJ2.1
PMIC_IRQ: IC3.43 (!INT!)
PMIC_WAKEUP: IC3.2 (WAKEUP)
POWER_ON: IC3.44 (PWRCTRL)
SCL: IC3.4 (SCL)
SDA: IC3.3 (SDA)
VDD: C16.1, C17.1, C18.1, C19.1, C20.1, C21.1, C43.1, IC1.A14 (VDD_DSI), IC1.D18 (VDD_PLL), IC1.M6 (VDD_PLL), IC1.M9 (VDD), IC1.N5 (VDD_ANA), IC1.N8 (VDD), IC1.N10 (VDD), IC1.P9 (VDD), IC1.P11 (VDD), IC1.R10 (VDD), IC1.R12 (VDD), IC1.T13 (VDD), IC1.U9 (VDD), IC1.U12 (VDD), IC1.U14 (VDD), IC3.31 (VOUT3), IC3.42 (VIO), L3.2, R1.1
VDDA: C36.1, IC3.20 (LDO5OUT)
VDDA_1V8: C6.2, C7.2, IC1.AB12 (VDDA_1V8_REG), IC1.B14 (VDDA_1V8_DSI)
VDD_CORE: C8.1, C9.1, C10.1, C11.1, C12.1, C13.1, C14.1, C15.1, IC1.H9 (VDDCORE), IC1.H11 (VDDCORE), IC1.H13 (VDDCORE), IC1.H15 (VDDCORE), IC1.J8 (VDDCORE), IC1.J10 (VDDCORE), IC1.J12 (VDDCORE), IC1.J14 (VDDCORE), IC1.K9 (VDDCORE), IC1.K11 (VDDCORE), IC1.K13 (VDDCORE), IC1.K15 (VDDCORE), IC1.L8 (VDDCORE), IC1.L10 (VDDCORE), IC1.L12 (VDDCORE), IC1.L14 (VDDCORE), IC1.M11 (VDDCORE), IC1.M13 (VDDCORE), IC1.M15 (VDDCORE), IC1.N12 (VDDCORE), IC1.N14 (VDDCORE), IC1.P13 (VDDCORE), IC1.P15 (VDDCORE), IC1.R14 (VDDCORE), IC1.T15 (VDDCORE), SJ2.2
VDD_DDR: C22.1, C23.1, C24.1, C25.1, C30.1, IC1.E18 (VDDQ_DDR), IC1.F17 (VDDQ_DDR), IC1.G16 (VDDQ_DDR), IC1.H17 (VDDQ_DDR), IC1.J16 (VDDQ_DDR), IC1.K17 (VDDQ_DDR), IC1.L16 (VDDQ_DDR), IC1.M17 (VDDQ_DDR), IC1.N16 (VDDQ_DDR), IC1.P17 (VDDQ_DDR), IC1.R16 (VDDQ_DDR), IC1.T17 (VDDQ_DDR), IC1.U16 (VDDQ_DDR), IC1.V17 (VDDQ_DDR), IC1.W18 (VDDQ_DDR), IC1.Y19 (VDDQ_DDR), IC3.13 (LDO3IN), SJ1.2; also elsewhere on the board
VDD_USB: C4.1, C34.1, IC1.AB13 (VDD_3V3__USBHS), IC1.AB16 (VDD_3V3__USBFS), IC3.39 (LDO4OUT)
VREF+: C1.1, IC1.P6 (VREF+)
VREF_DDR: C41.2, IC3.16 (VREFDDR); also elsewhere on the board
VTT_DDR: C40.2, IC3.14 (LDO3OUT); also elsewhere on the board

Notes on the sheet:
These need to be connected up
Default output voltages: Which Voltage Rank LDO1 1.8v 0 LDO2 1.8v 0 LDO3 1.8v 0 LDO4 3.3v 3 LDO5 2.9v 2 LDO6 1.0v 0 REFDDR 0.55v 0 BOOST 5.2v n/a BUCK1 1.2v 2 BUCK2 1.1v 0 BUCK3 3.3v 1 BUCK4 3.3v 2
Rank 0: not powered automatically Rank 1: turned on after T+7ms Rank 2: turned on after T+10ms Rank 3: turned on after T+13ms Notes ----- VOUT2 needs to be set to 1.5v LDO3OUT needs to be set to 0.75v

Board: 4 copper layers, 127 parts (48 on the bottom side), 117 nets, no tracks yet.
