ThrudTheBarbarian/pbxl/boards/xio6/xio.brd

## EAGLE design boards/xio6/xio.brd (2019-09-23)

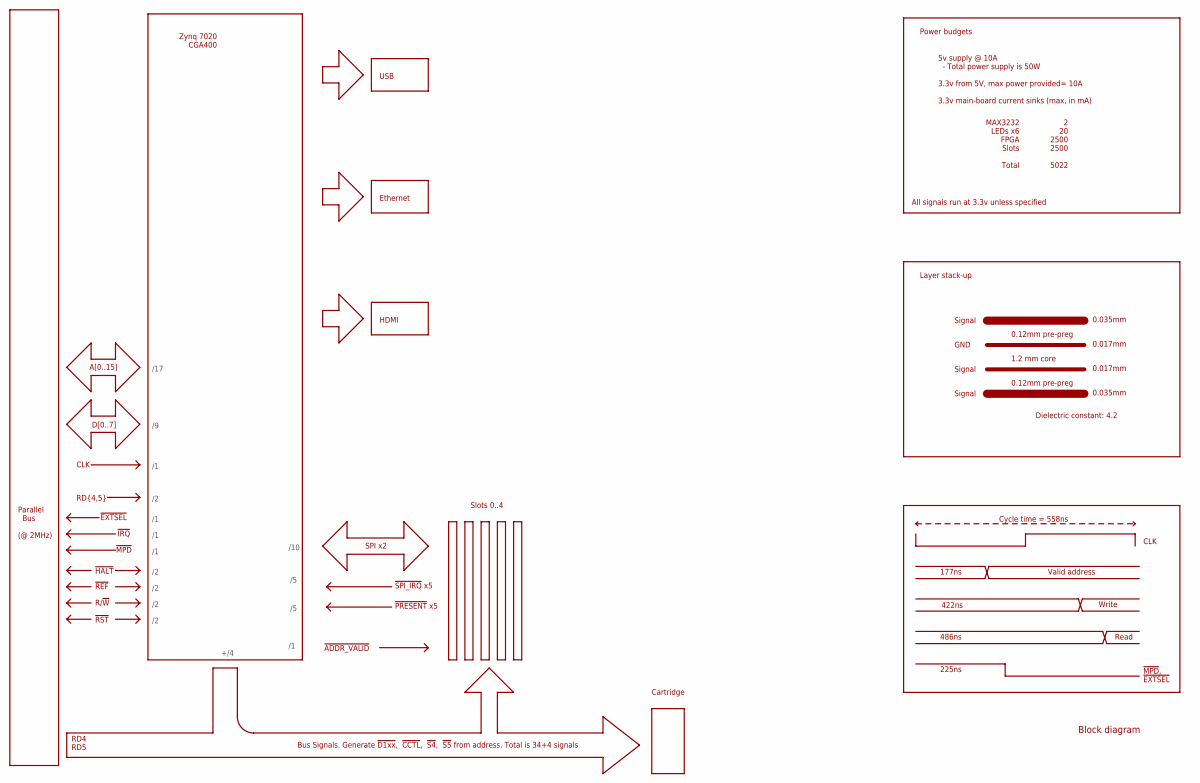
[picture p103: schematic xio.sch, sheet 1, Block diagram]

Notes on the sheet:
Slots 0..4
Bus Signals. Generate !D1xx!, !CCTL!, !S4!, !S5! from address. Total is 34+4 signals
5v supply @ 10A - Total power supply is 50W 3.3v from 5V, max power provided= 10A 3.3v main-board current sinks (max, in mA)
MAX3232 LEDs x6 FPGA Slots Total
2 20 2500 2500 5022
1.2 mm core
0.12mm pre-preg
0.035mm
0.017mm
Layer stack-up
GND
Dielectric constant: 4.2
Cycle time = 558ns
Valid address
Write
Read
177ns
422ns
486ns
225ns
!MPD!, !EXTSEL!
CLK
Power budgets
Zynq 7020 CGA400
HDMI
Signal
Block diagram
Parallel Bus (@ 2MHz)
A[0..15]
D[0..7]
RD{4,5}
!MPD!
!IRQ!
!EXTSEL!
!HALT!
!REF!
R/!W!
/17
!ADDR_VALID!
+/4
Cartridge
All signals run at 3.3v unless specified
!RST!
SPI x2
!SPI_IRQ! x5
/10
RD4 RD5
!PRESENT! x5
Ethernet
USB

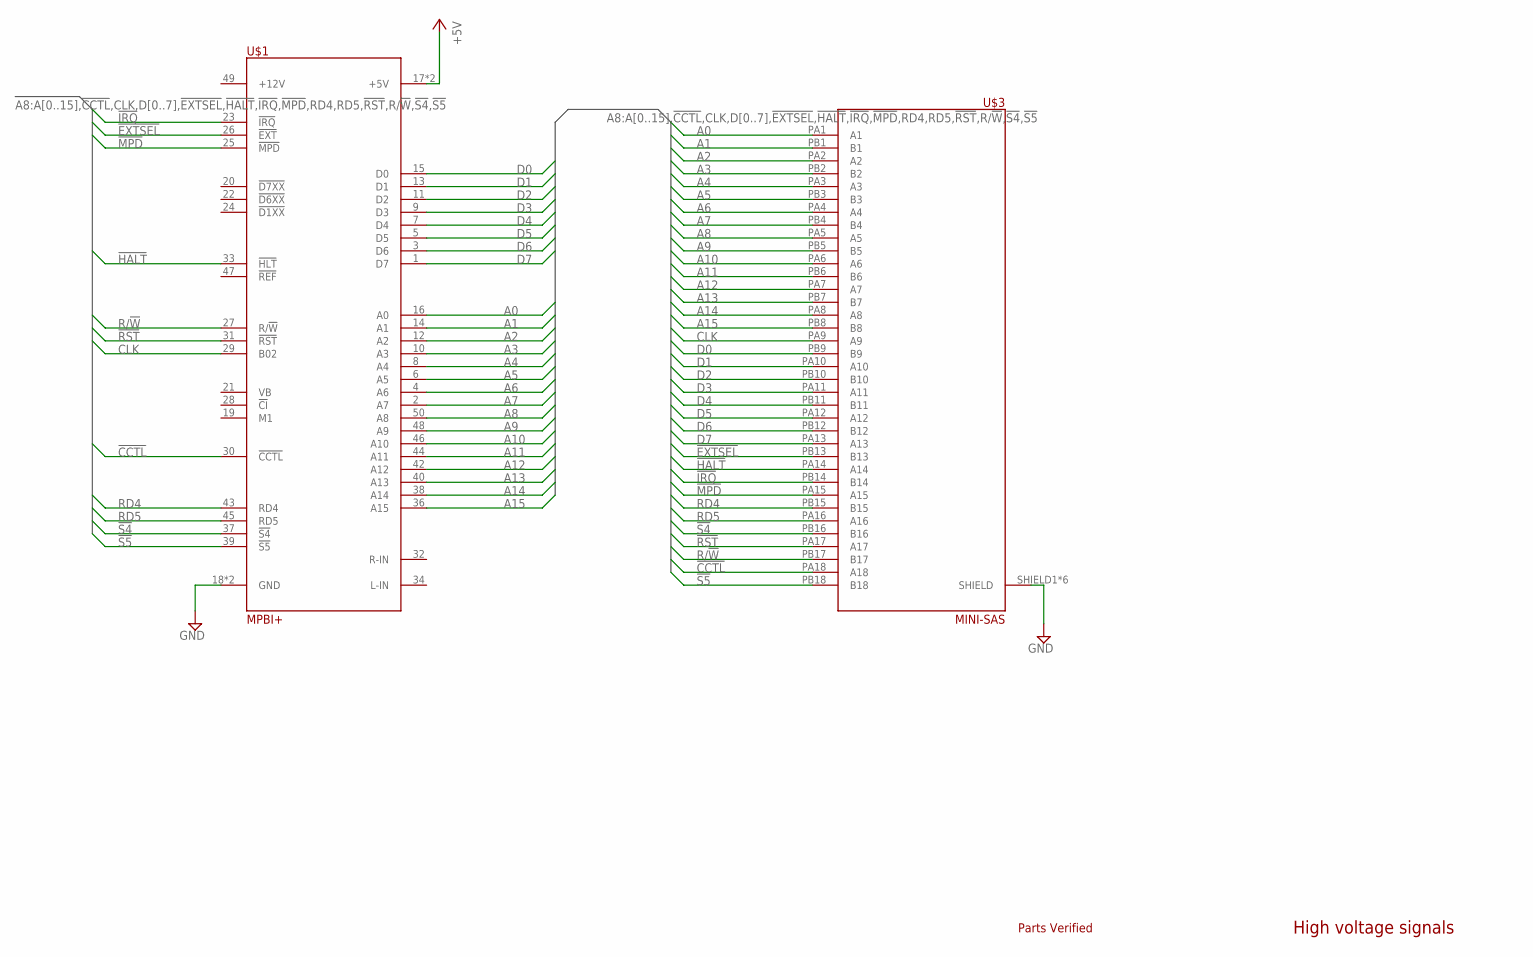
[picture p104: schematic xio.sch, sheet 2, High voltage signalling]

Parts:
U$1: MPBI+; 2X25
U$3: MINI-SAS

Connections:
!CCTL!: U$1.30 (!CCTL!), U$3.PA18 (A18)
!EXTSEL!: U$1.26 (!EXT!), U$3.PB13 (B13)
!HALT!: U$1.33 (!HLT!), U$3.PA14 (A14)
!IRQ!: U$1.23 (!IRQ!), U$3.PB14 (B14)
!MPD!: U$1.25 (!MPD!), U$3.PA15 (A15)
!RST!: U$1.31 (!RST!), U$3.PA17 (A17)
!S4!: U$1.37 (!S4!), U$3.PB16 (B16)
!S5!: U$1.39 (!S5!), U$3.PB18 (B18)
+5V: U$1.17 (+5V), U$1.41 (+5V); also elsewhere on the board
A0: U$1.16 (A0), U$3.PA1 (A1); also elsewhere on the board
A1: U$1.14 (A1), U$3.PB1 (B1); also elsewhere on the board
A2: U$1.12 (A2), U$3.PA2 (A2); also elsewhere on the board
A3: U$1.10 (A3), U$3.PB2 (B2); also elsewhere on the board
A4: U$1.8 (A4), U$3.PA3 (A3); also elsewhere on the board
A5: U$1.6 (A5), U$3.PB3 (B3); also elsewhere on the board
A6: U$1.4 (A6), U$3.PA4 (A4); also elsewhere on the board
A7: U$1.2 (A7), U$3.PB4 (B4); also elsewhere on the board
A8: U$1.50 (A8), U$3.PA5 (A5); also elsewhere on the board
A9: U$1.48 (A9), U$3.PB5 (B5); also elsewhere on the board
A10: U$1.46 (A10), U$3.PA6 (A6); also elsewhere on the board
A11: U$1.44 (A11), U$3.PB6 (B6); also elsewhere on the board
A12: U$1.42 (A12), U$3.PA7 (A7); also elsewhere on the board
A13: U$1.40 (A13), U$3.PB7 (B7); also elsewhere on the board
A14: U$1.38 (A14), U$3.PA8 (A8); also elsewhere on the board
A15: U$1.36 (A15), U$3.PB8 (B8); also elsewhere on the board
CLK: U$1.29 (B02), U$3.PA9 (A9)
D0: U$1.15 (D0), U$3.PB9 (B9); also elsewhere on the board
D1: U$1.13 (D1), U$3.PA10 (A10); also elsewhere on the board
D2: U$1.11 (D2), U$3.PB10 (B10); also elsewhere on the board
D3: U$1.9 (D3), U$3.PA11 (A11); also elsewhere on the board
D4: U$1.7 (D4), U$3.PB11 (B11); also elsewhere on the board
D5: U$1.5 (D5), U$3.PA12 (A12); also elsewhere on the board
D6: U$1.3 (D6), U$3.PB12 (B12); also elsewhere on the board
D7: U$1.1 (D7), U$3.PA13 (A13); also elsewhere on the board
GND: U$1.18 (GND), U$1.35 (GND), U$3.SHIELD1 (SHIELD), U$3.SHIELD2 (SHIELD), U$3.SHIELD3 (SHIELD), U$3.SHIELD4 (SHIELD), U$3.SHIELD5 (SHIELD), U$3.SHIELD6 (SHIELD); also elsewhere on the board
R/!W!: U$1.27 (R/!W!), U$3.PB17 (B17)
RD4: U$1.43 (RD4), U$3.PB15 (B15)
RD5: U$1.45 (RD5), U$3.PA16 (A16)

Notes on the sheet:
High voltage signals
Parts Verified
