ThrudTheBarbarian/pbxl/boards/xio6/xio.brd

## EAGLE design boards/xio6/xio.brd (continued)

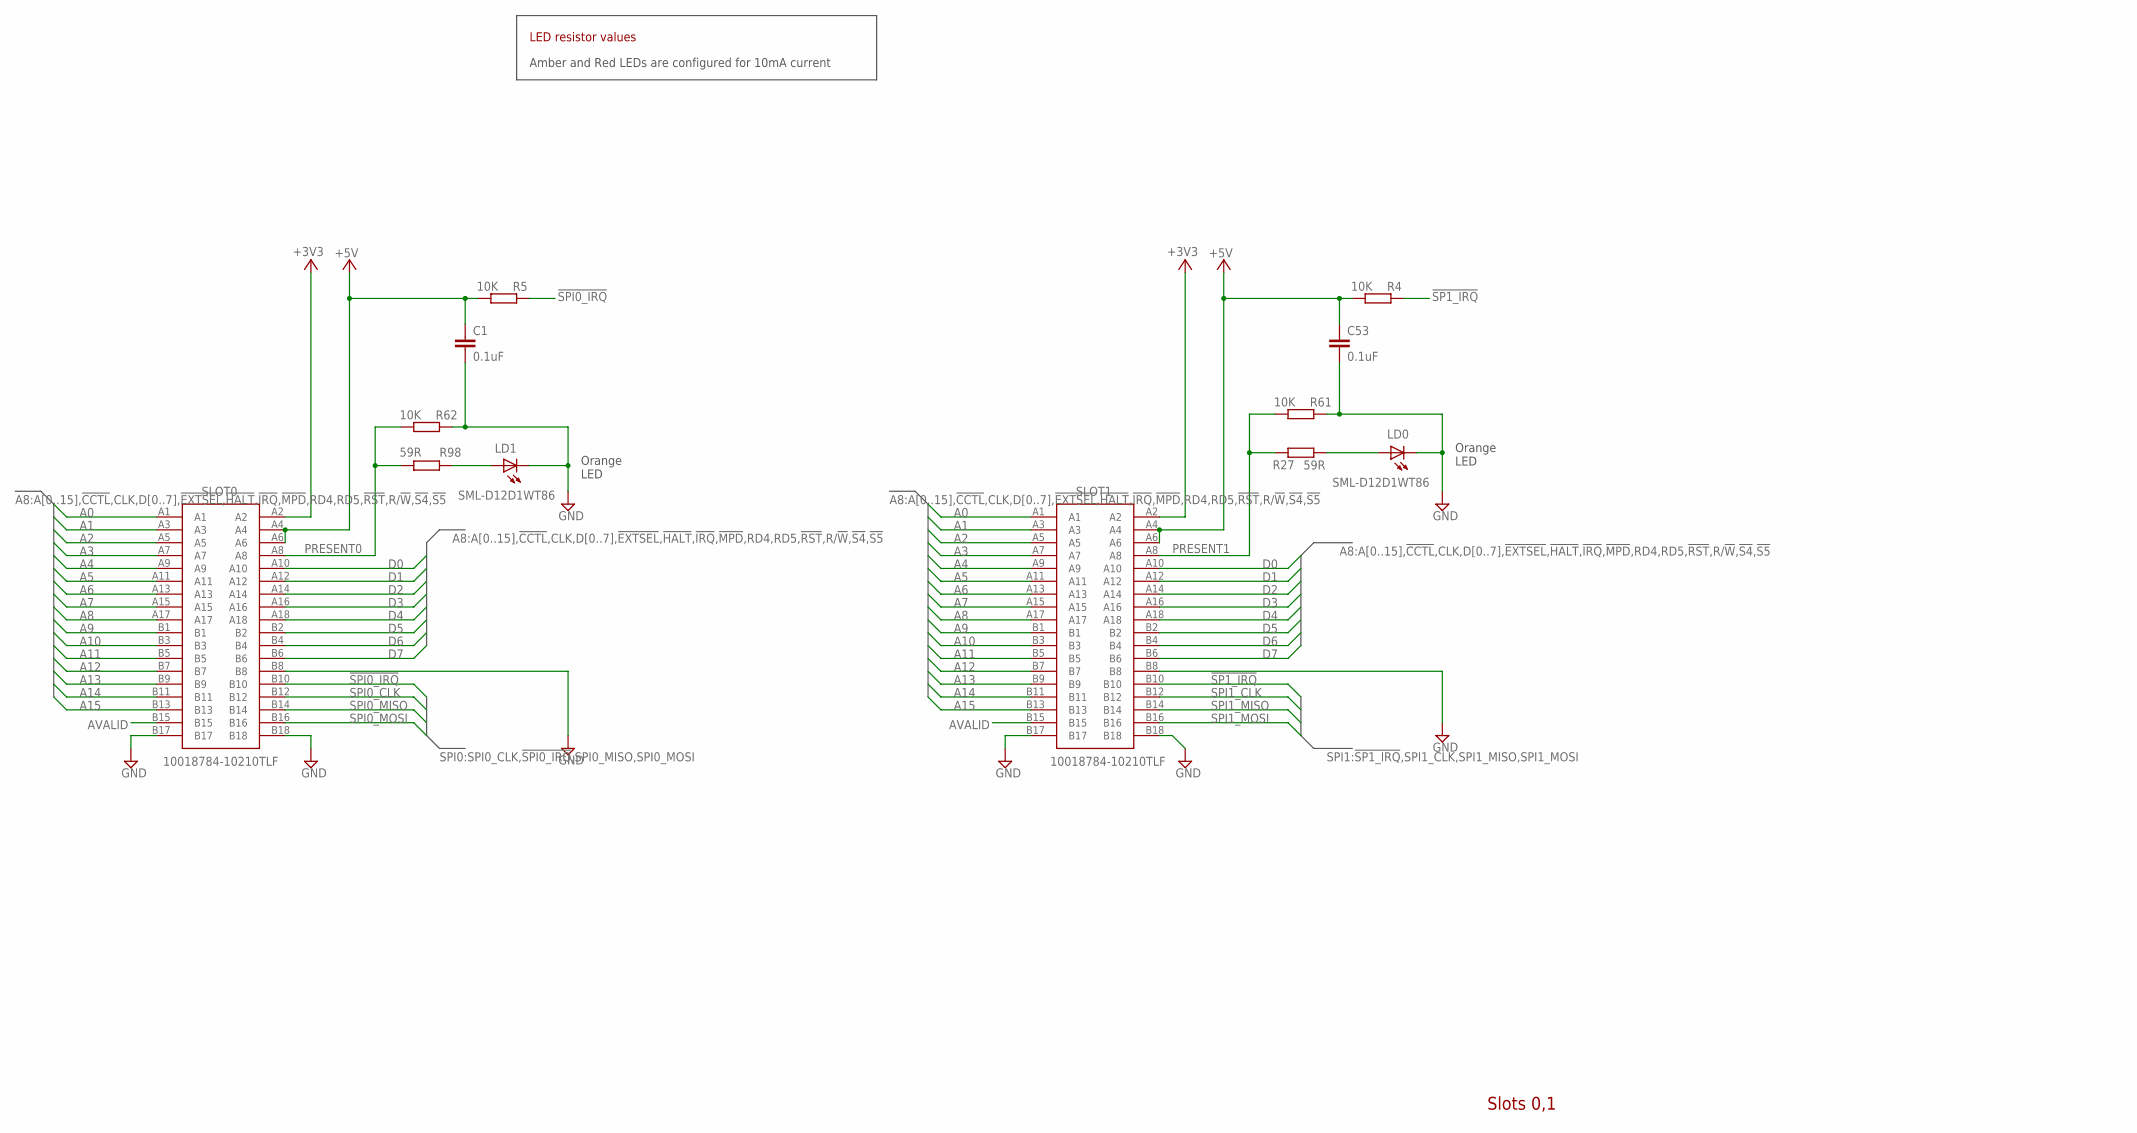
[picture p105: schematic xio.sch, sheet 3, Expansion slots 0 & 1]

Parts:
C1, C53: 0.1uF; C0201
LD0, LD1: SML-D12D1WT86; CHIPLED_0603
R4, R5, R61, R62: 10K; R0201
R27, R98: 59R; R0402
SLOT0, SLOT1: 10018784-10210TLF; 1001878410210TLF

Connections:
!SP1_IRQ!: R4.2, SLOT1.B10
!SPI0_IRQ!: R5.2, SLOT0.B10
+3V3: SLOT0.A2, SLOT1.A2; also elsewhere on the board
+5V: C1.1, C53.1, R4.1, R5.1, SLOT0.A4, SLOT0.A6, SLOT1.A4, SLOT1.A6; also elsewhere on the board
A0: SLOT0.A1, SLOT1.A1; also elsewhere on the board
A1: SLOT0.A3, SLOT1.A3; also elsewhere on the board
A2: SLOT0.A5, SLOT1.A5; also elsewhere on the board
A3: SLOT0.A7, SLOT1.A7; also elsewhere on the board
A4: SLOT0.A9, SLOT1.A9; also elsewhere on the board
A5: SLOT0.A11, SLOT1.A11; also elsewhere on the board
A6: SLOT0.A13, SLOT1.A13; also elsewhere on the board
A7: SLOT0.A15, SLOT1.A15; also elsewhere on the board
A8: SLOT0.A17, SLOT1.A17; also elsewhere on the board
A9: SLOT0.B1, SLOT1.B1; also elsewhere on the board
A10: SLOT0.B3, SLOT1.B3; also elsewhere on the board
A11: SLOT0.B5, SLOT1.B5; also elsewhere on the board
A12: SLOT0.B7, SLOT1.B7; also elsewhere on the board
A13: SLOT0.B9, SLOT1.B9; also elsewhere on the board
A14: SLOT0.B11, SLOT1.B11; also elsewhere on the board
A15: SLOT0.B13, SLOT1.B13; also elsewhere on the board
AVALID: SLOT0.B15, SLOT1.B15; also elsewhere on the board
D0: SLOT0.A10, SLOT1.A10; also elsewhere on the board
D1: SLOT0.A12, SLOT1.A12; also elsewhere on the board
D2: SLOT0.A14, SLOT1.A14; also elsewhere on the board
D3: SLOT0.A16, SLOT1.A16; also elsewhere on the board
D4: SLOT0.A18, SLOT1.A18; also elsewhere on the board
D5: SLOT0.B2, SLOT1.B2; also elsewhere on the board
D6: SLOT0.B4, SLOT1.B4; also elsewhere on the board
D7: SLOT0.B6, SLOT1.B6; also elsewhere on the board
GND: C1.2, C53.2, LD0.C, LD1.C, R61.2, R62.2, SLOT0.B8, SLOT0.B17, SLOT0.B18, SLOT1.B8, SLOT1.B17, SLOT1.B18; also elsewhere on the board
unnamed: LD1.A, R98.2
unnamed: LD0.A, R27.2
PRESENT0: R62.1, R98.1, SLOT0.A8
PRESENT1: R27.1, R61.1, SLOT1.A8
SPI0_CLK: SLOT0.B12
SPI0_MISO: SLOT0.B14
SPI0_MOSI: SLOT0.B16
SPI1_CLK: SLOT1.B12
SPI1_MISO: SLOT1.B14
SPI1_MOSI: SLOT1.B16

Notes on the sheet:
Slots 0,1
Orange LED
Amber and Red LEDs are configured for 10mA current
LED resistor values

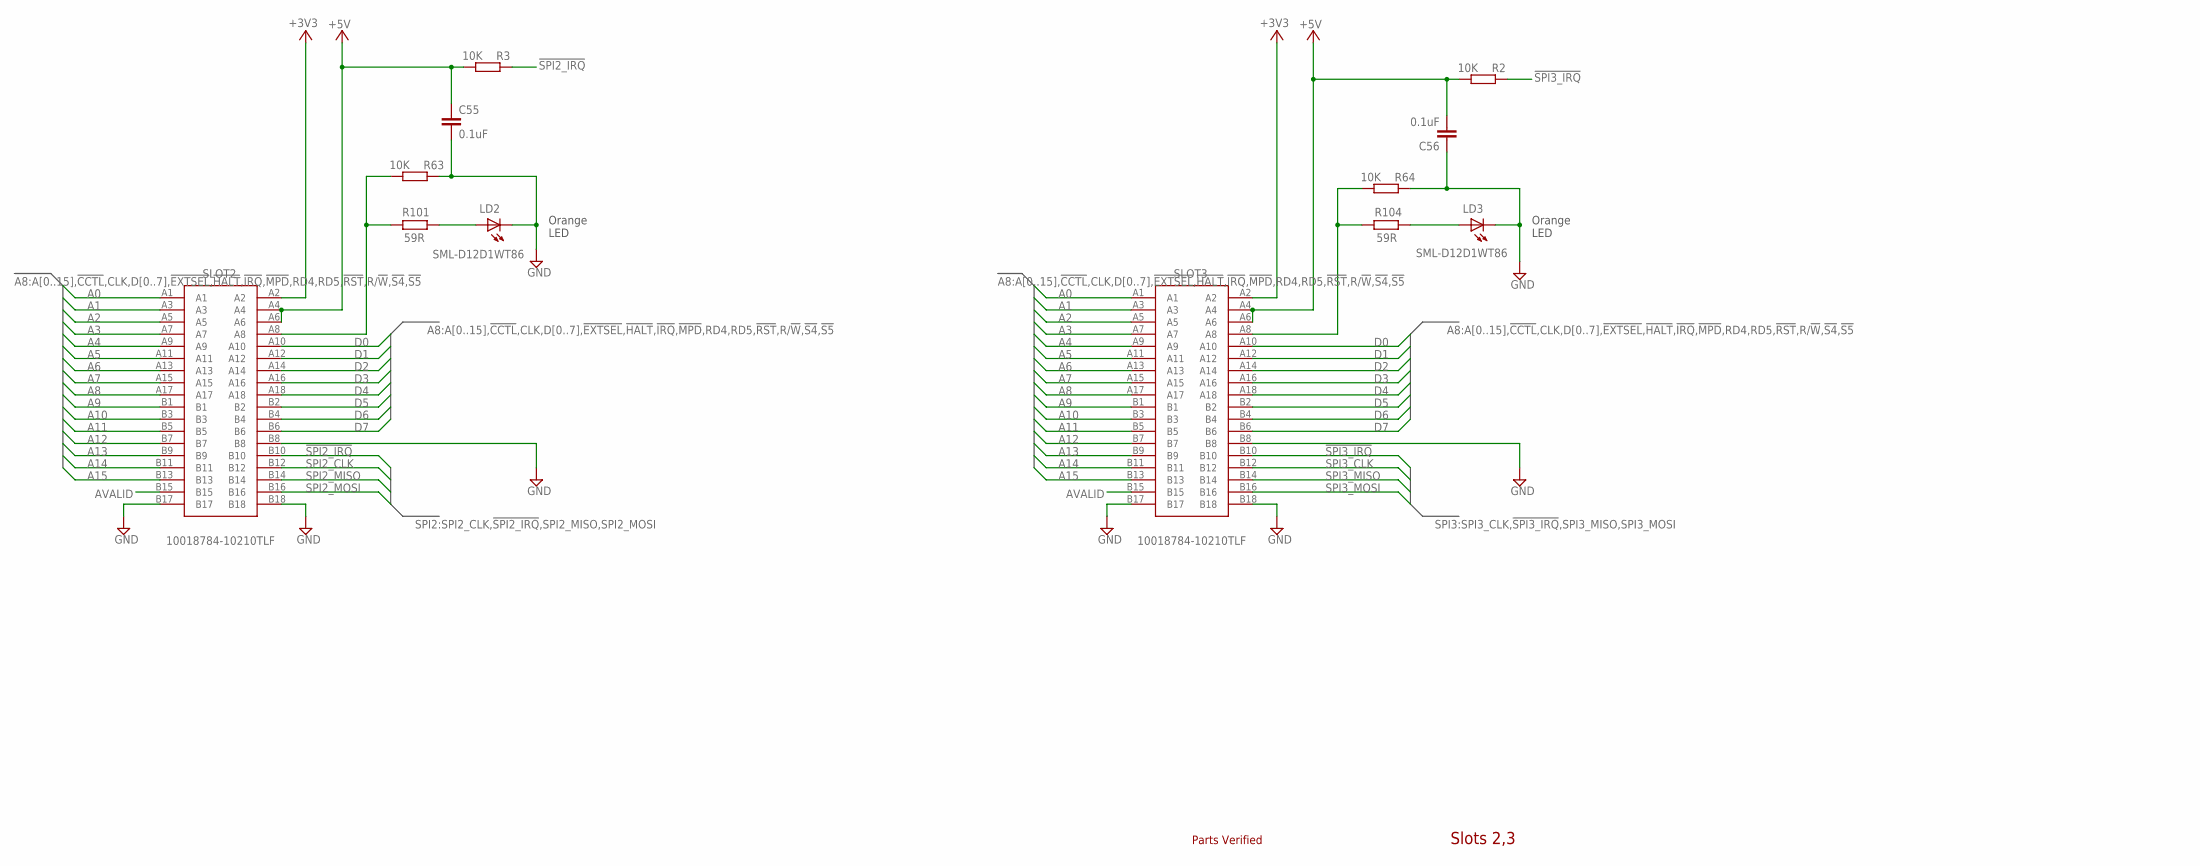
[picture p106: schematic xio.sch, sheet 4, Expansion slots 2 & 3]

Parts:
C55, C56: 0.1uF; C0201
LD2, LD3: SML-D12D1WT86; CHIPLED_0603
R2, R3, R63, R64: 10K; R0201
R101, R104: 59R; R0402
SLOT2, SLOT3: 10018784-10210TLF; 1001878410210TLF

Connections:
!SPI2_IRQ!: R3.2, SLOT2.B10
!SPI3_IRQ!: R2.2, SLOT3.B10
+3V3: SLOT2.A2, SLOT3.A2; also elsewhere on the board
+5V: C55.1, C56.2, R2.1, R3.1, SLOT2.A4, SLOT2.A6, SLOT3.A4, SLOT3.A6; also elsewhere on the board
A0: SLOT2.A1, SLOT3.A1; also elsewhere on the board
A1: SLOT2.A3, SLOT3.A3; also elsewhere on the board
A2: SLOT2.A5, SLOT3.A5; also elsewhere on the board
A3: SLOT2.A7, SLOT3.A7; also elsewhere on the board
A4: SLOT2.A9, SLOT3.A9; also elsewhere on the board
A5: SLOT2.A11, SLOT3.A11; also elsewhere on the board
A6: SLOT2.A13, SLOT3.A13; also elsewhere on the board
A7: SLOT2.A15, SLOT3.A15; also elsewhere on the board
A8: SLOT2.A17, SLOT3.A17; also elsewhere on the board
A9: SLOT2.B1, SLOT3.B1; also elsewhere on the board
A10: SLOT2.B3, SLOT3.B3; also elsewhere on the board
A11: SLOT2.B5, SLOT3.B5; also elsewhere on the board
A12: SLOT2.B7, SLOT3.B7; also elsewhere on the board
A13: SLOT2.B9, SLOT3.B9; also elsewhere on the board
A14: SLOT2.B11, SLOT3.B11; also elsewhere on the board
A15: SLOT2.B13, SLOT3.B13; also elsewhere on the board
AVALID: SLOT2.B15, SLOT3.B15; also elsewhere on the board
D0: SLOT2.A10, SLOT3.A10; also elsewhere on the board
D1: SLOT2.A12, SLOT3.A12; also elsewhere on the board
D2: SLOT2.A14, SLOT3.A14; also elsewhere on the board
D3: SLOT2.A16, SLOT3.A16; also elsewhere on the board
D4: SLOT2.A18, SLOT3.A18; also elsewhere on the board
D5: SLOT2.B2, SLOT3.B2; also elsewhere on the board
D6: SLOT2.B4, SLOT3.B4; also elsewhere on the board
D7: SLOT2.B6, SLOT3.B6; also elsewhere on the board
GND: C55.2, C56.1, LD2.C, LD3.C, R63.2, R64.2, SLOT2.B8, SLOT2.B17, SLOT2.B18, SLOT3.B8, SLOT3.B17, SLOT3.B18; also elsewhere on the board
unnamed: LD2.A, R101.2
unnamed: R64.1, R104.1, SLOT3.A8
unnamed: R63.1, R101.1, SLOT2.A8
unnamed: LD3.A, R104.2
SPI2_CLK: SLOT2.B12
SPI2_MISO: SLOT2.B14
SPI2_MOSI: SLOT2.B16
SPI3_CLK: SLOT3.B12
SPI3_MISO: SLOT3.B14
SPI3_MOSI: SLOT3.B16

Notes on the sheet:
Slots 2,3
Orange LED
Parts Verified

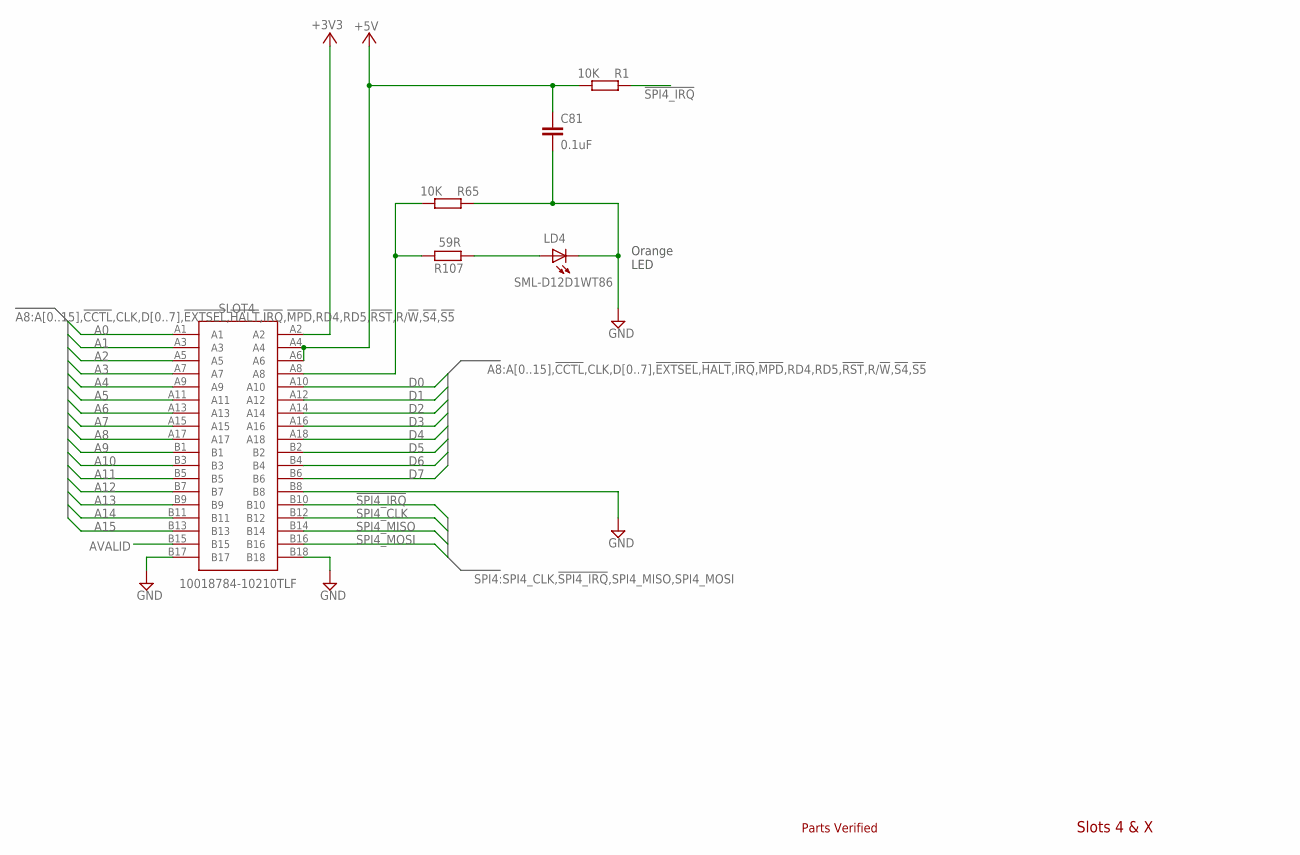
[picture p107: schematic xio.sch, sheet 5, Expansion slot 4 and Internal]

Parts:
C81: 0.1uF; C0201
LD4: SML-D12D1WT86; CHIPLED_0603
R1, R65: 10K; R0201
R107: 59R; R0402
SLOT4: 10018784-10210TLF; 1001878410210TLF

Connections:
!SPI4_IRQ!: R1.2, SLOT4.B10
+3V3: SLOT4.A2; also elsewhere on the board
+5V: C81.1, R1.1, SLOT4.A4, SLOT4.A6; also elsewhere on the board
A0: SLOT4.A1; also elsewhere on the board
A1: SLOT4.A3; also elsewhere on the board
A2: SLOT4.A5; also elsewhere on the board
A3: SLOT4.A7; also elsewhere on the board
A4: SLOT4.A9; also elsewhere on the board
A5: SLOT4.A11; also elsewhere on the board
A6: SLOT4.A13; also elsewhere on the board
A7: SLOT4.A15; also elsewhere on the board
A8: SLOT4.A17; also elsewhere on the board
A9: SLOT4.B1; also elsewhere on the board
A10: SLOT4.B3; also elsewhere on the board
A11: SLOT4.B5; also elsewhere on the board
A12: SLOT4.B7; also elsewhere on the board
A13: SLOT4.B9; also elsewhere on the board
A14: SLOT4.B11; also elsewhere on the board
A15: SLOT4.B13; also elsewhere on the board
AVALID: SLOT4.B15; also elsewhere on the board
D0: SLOT4.A10; also elsewhere on the board
D1: SLOT4.A12; also elsewhere on the board
D2: SLOT4.A14; also elsewhere on the board
D3: SLOT4.A16; also elsewhere on the board
D4: SLOT4.A18; also elsewhere on the board
D5: SLOT4.B2; also elsewhere on the board
D6: SLOT4.B4; also elsewhere on the board
D7: SLOT4.B6; also elsewhere on the board
GND: C81.2, LD4.C, R65.2, SLOT4.B8, SLOT4.B17, SLOT4.B18; also elsewhere on the board
unnamed: R65.1, R107.1, SLOT4.A8
unnamed: LD4.A, R107.2
SPI4_CLK: SLOT4.B12
SPI4_MISO: SLOT4.B14
SPI4_MOSI: SLOT4.B16

Notes on the sheet:
Slots 4 & X
Orange LED
Parts Verified

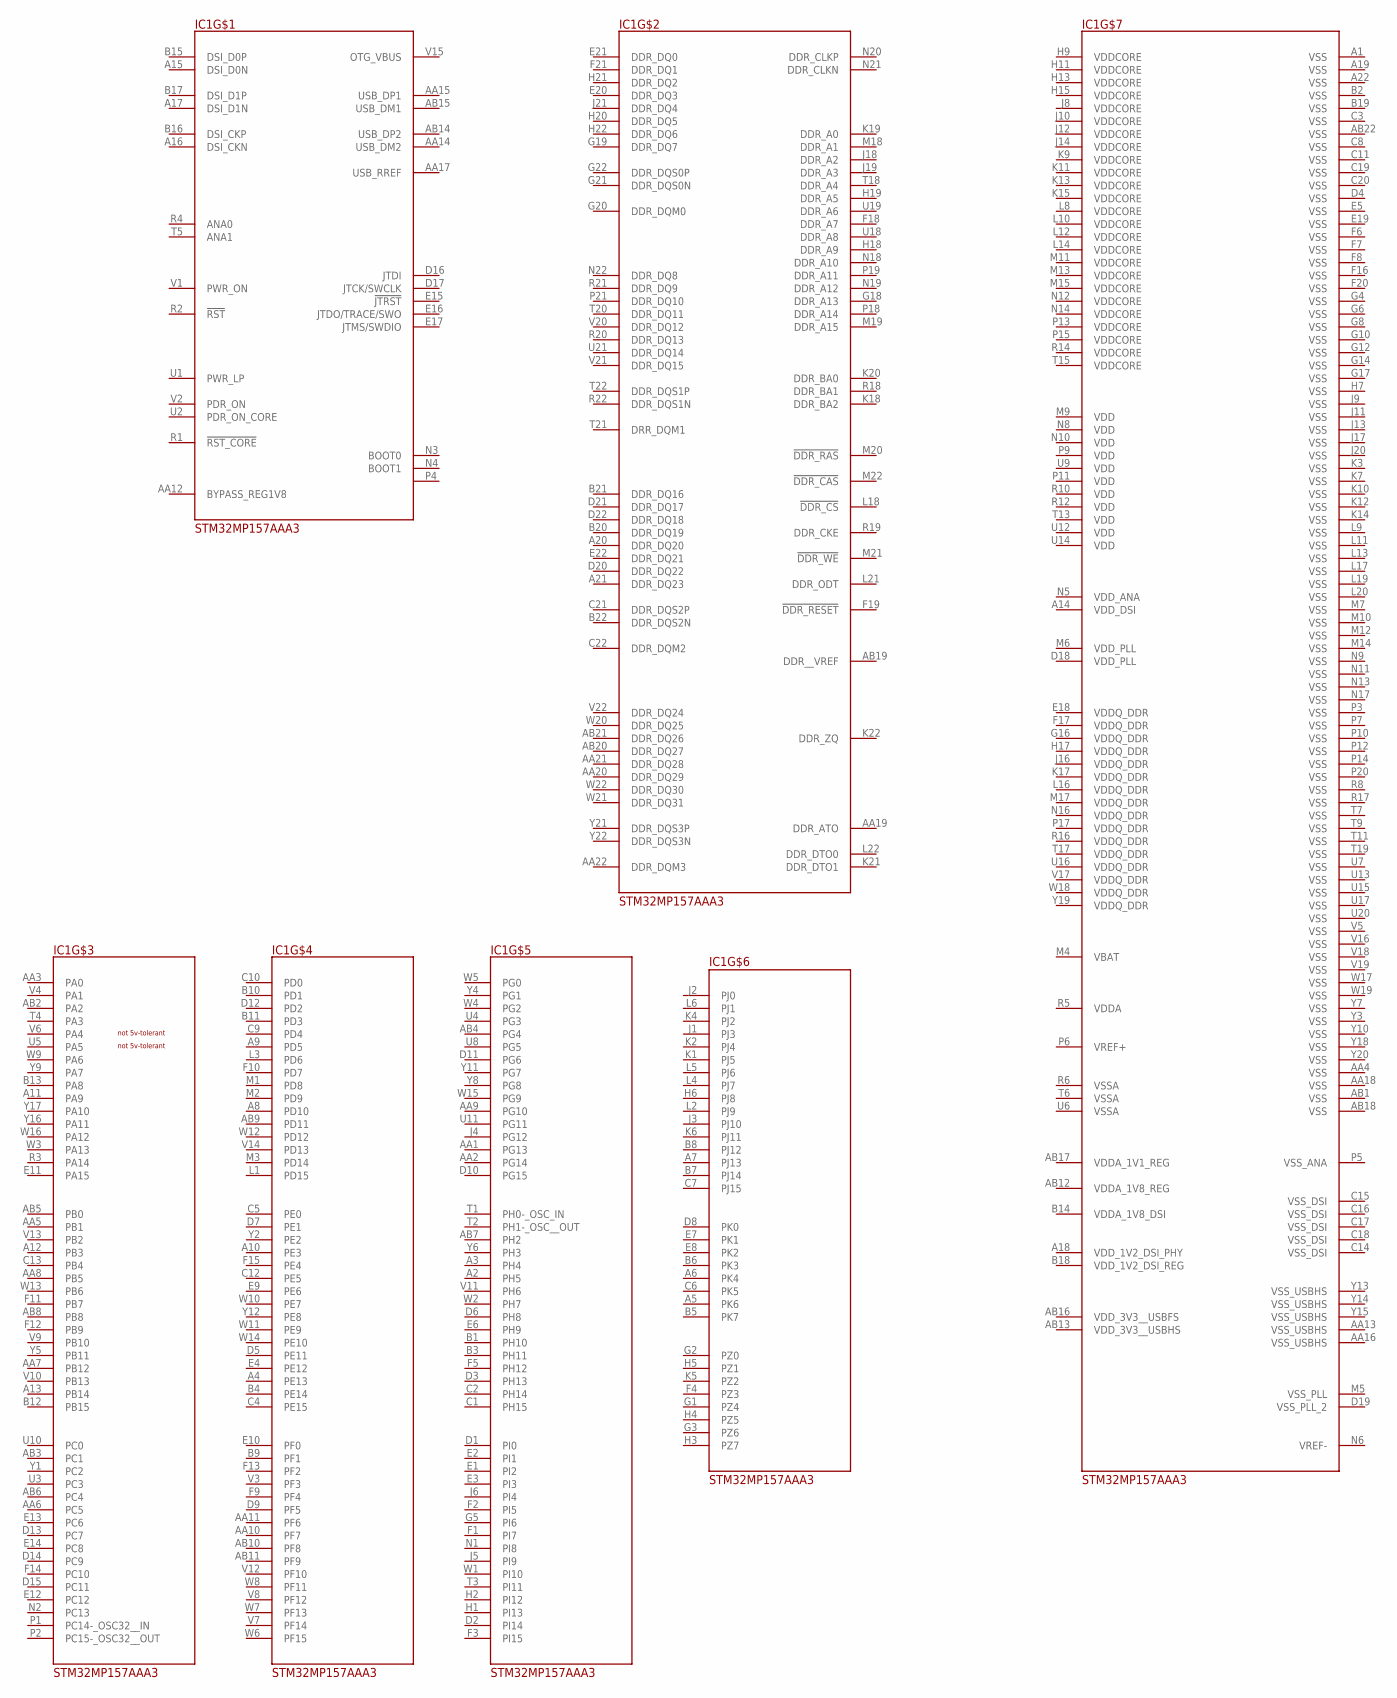
[picture p108: schematic xio.sch, sheet 6]

Parts:
IC1: STM32MP157AAA3; BGA448C80P22X22_1800X1800X127

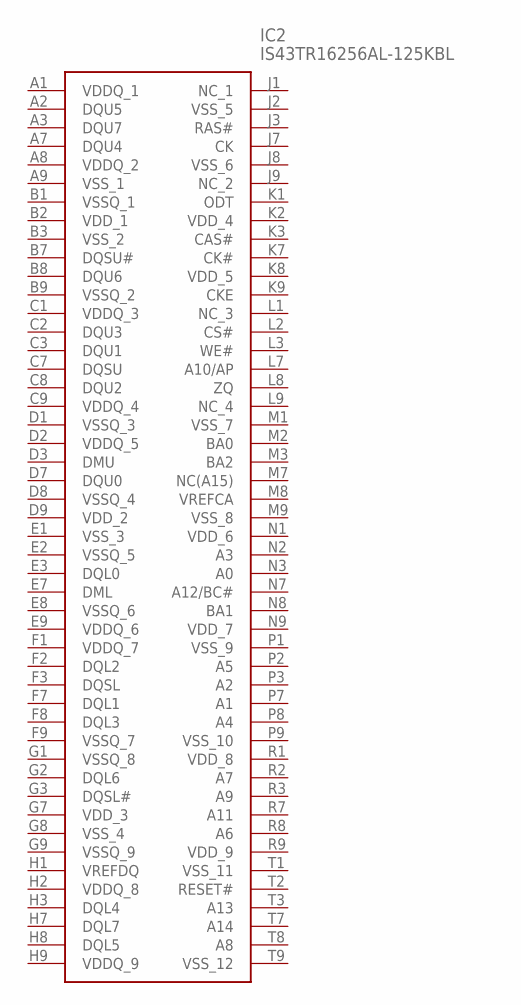
[picture p109: schematic xio.sch, sheet 7]

Parts:
IC2: IS43TR16256AL-125KBL; BGA96C80P9X16_900X1300X120

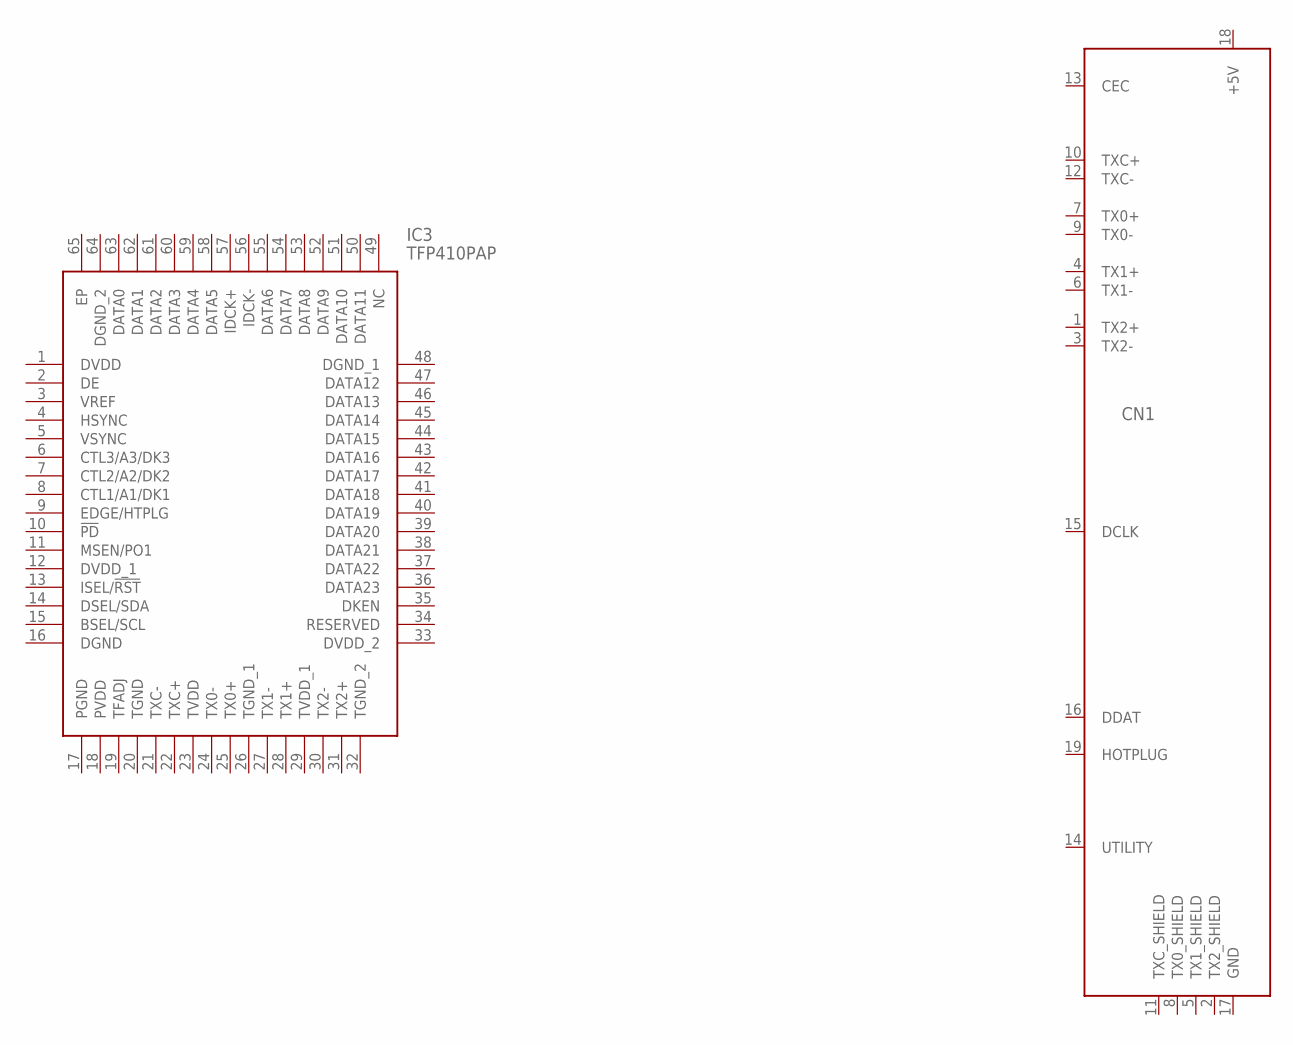
[picture p110: schematic xio.sch, sheet 8]

Parts:
CN1: HDMI_MOLEX_47151-0001
IC3: TFP410PAP; QFP50P1200X1200X120-65N

Connections:
+5V: CN1.18 (+5V); also elsewhere on the board
DGND: IC3.16 (DGND)
DGND_1: IC3.48 (DGND_1)
DGND_2: IC3.64 (DGND_2)
DVDD: IC3.1 (DVDD)
DVDD_1: IC3.12 (DVDD_1)
DVDD_2: IC3.33 (DVDD_2)
GND: CN1.17 (GND), CN1.P$1 (GND), CN1.P$2 (GND), CN1.P$3 (GND), CN1.P$4 (GND); also elsewhere on the board
PGND: IC3.17 (PGND)
PVDD: IC3.18 (PVDD)
TGND: IC3.20 (TGND)
TGND_1: IC3.26 (TGND_1)
TGND_2: IC3.32 (TGND_2)
TVDD: IC3.23 (TVDD)
TVDD_1: IC3.29 (TVDD_1)
TX0_SHIELD: CN1.8 (TX0_SHIELD)
TX1_SHIELD: CN1.5 (TX1_SHIELD)
TX2_SHIELD: CN1.2 (TX2_SHIELD)
TXC_SHIELD: CN1.11 (TXC_SHIELD)

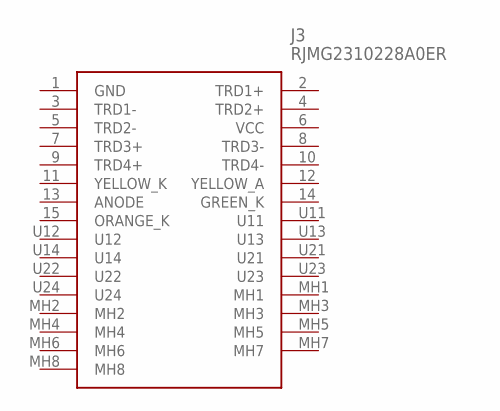
[picture p111: schematic xio.sch, sheet 9]

Parts:
J3: RJMG2310228A0ER

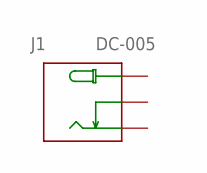
[picture p112: schematic xio.sch, sheet 10]

Parts:
J1: DC-005; DCJ3P-14.2X11.0X9.0MM

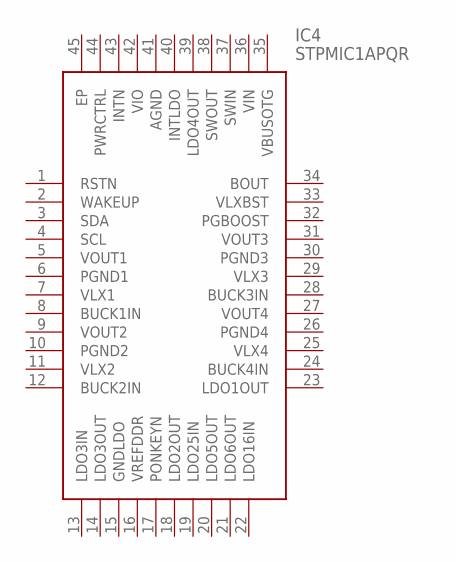
[picture p113: schematic xio.sch, sheet 11]

Parts:
IC4: STPMIC1APQR; QFN40P500X600X80-45N

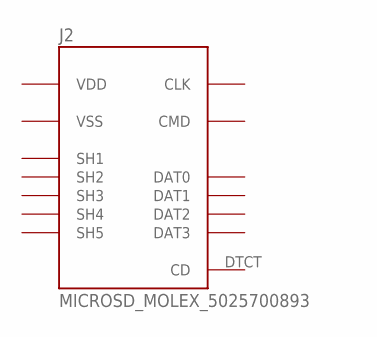
[picture p114: schematic xio.sch, sheet 12]

Parts:
J2: MICROSD_MOLEX_5025700893; 5025700893

Connections:
SH1: J2.GND0 (SH1)
SH2: J2.GND1 (SH2)
SH3: J2.GND2 (SH3)
SH4: J2.GND3 (SH4)
SH5: J2.GND4 (SH5)
VDD: J2.P$4 (VDD)
VSS: J2.P$6 (VSS)

Board: 4 copper layers, 40 parts (0 on the bottom side), 55 nets, no tracks yet.
