ThrudTheBarbarian/pbxl/boards/xio5/xio5.brd

## EAGLE design boards/xio5/xio5.brd (continued)

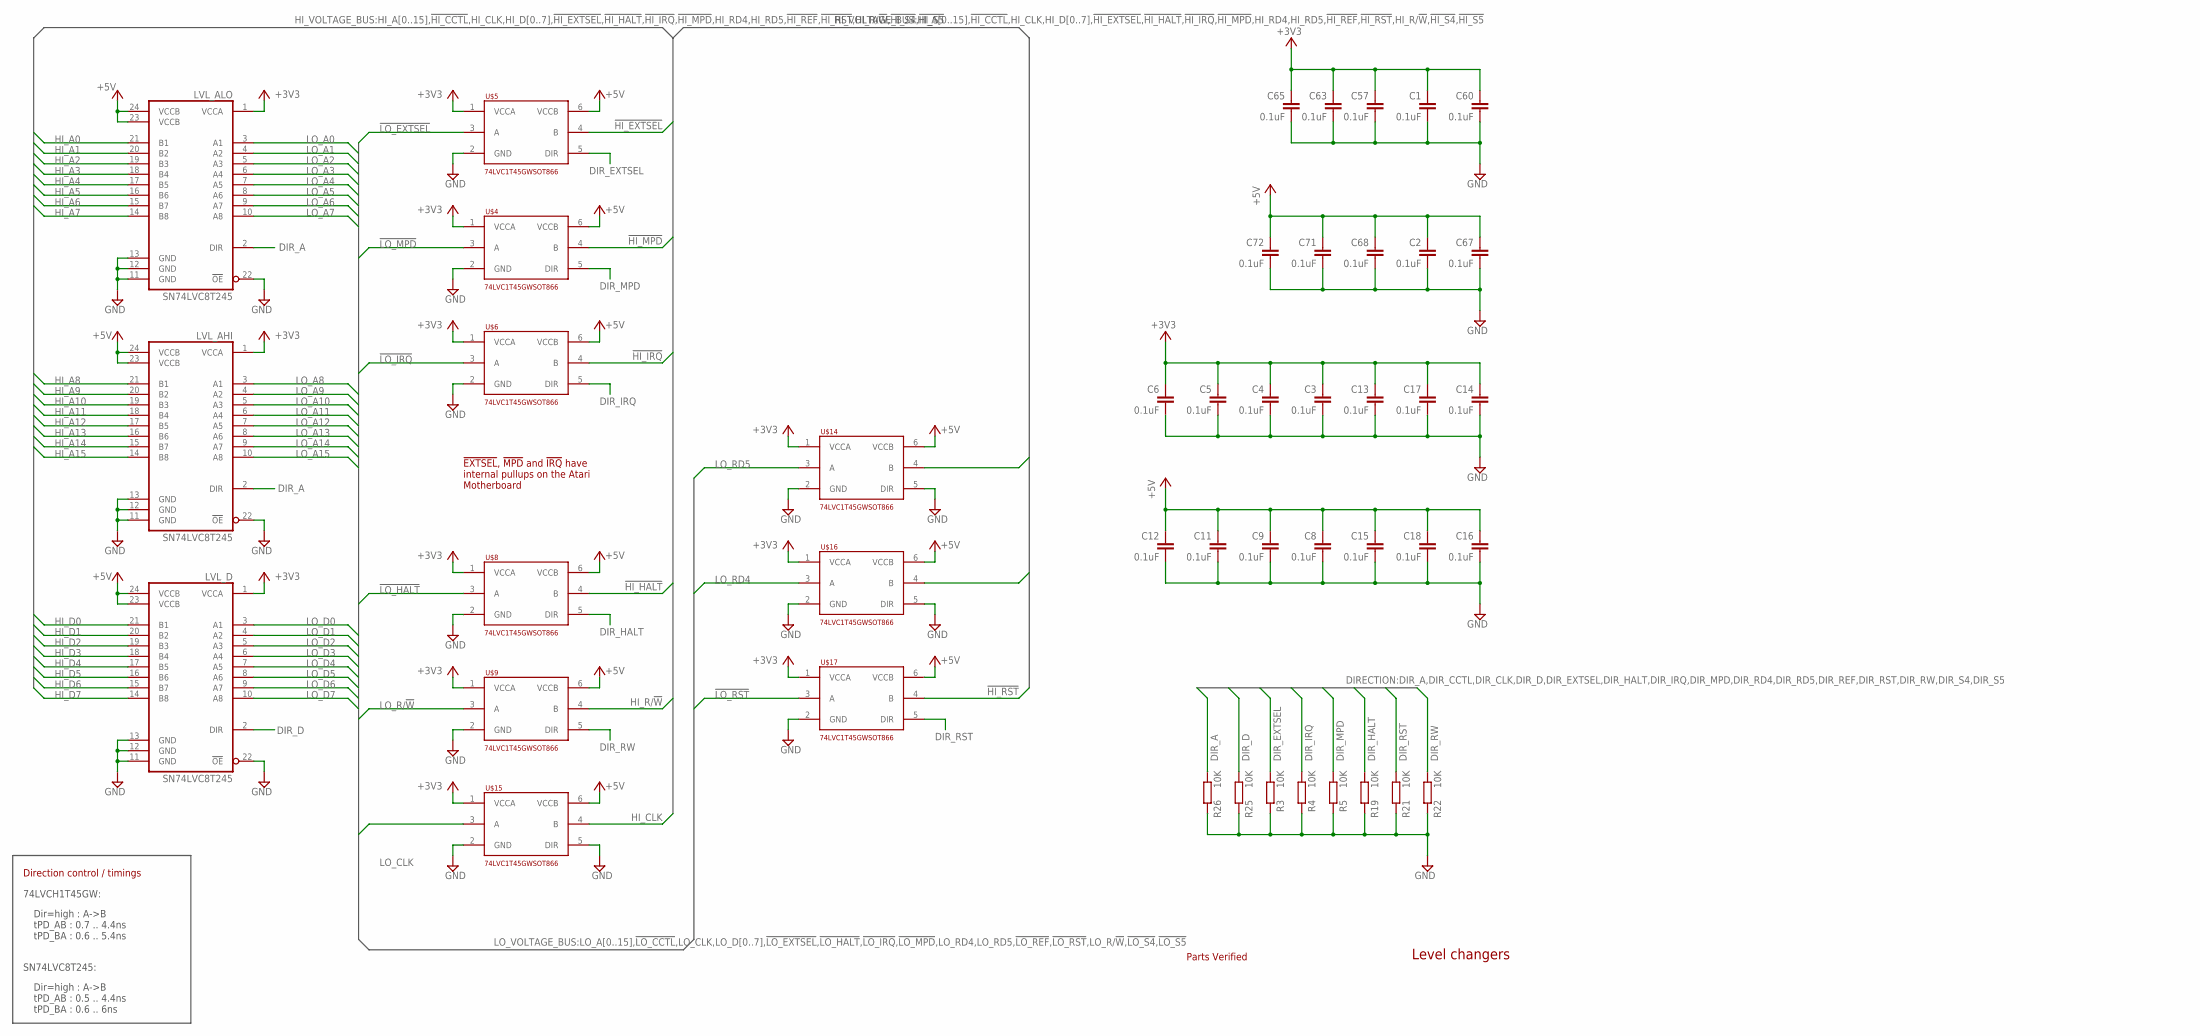
[picture p116: schematic xio5.sch, sheet 3, Level changers]

Parts:
C1, C2, C3, C4, C5, C6, C8, C9, C11, C12, C13, C14, C15, C16, C17, C18, C57, C60, C63, C65, C67, C68, C71, C72: 0.1uF; C0201
LVL_AHI: SN74LVC8T245; TSSOP24
LVL_ALO: SN74LVC8T245; TSSOP24
LVL_D: SN74LVC8T245; TSSOP24
R3, R4, R5, R19, R21, R22, R25, R26: 10K; R0201
U$4, U$5, U$6, U$8, U$9, U$14, U$15, U$16, U$17: 74LVC1T45GWSOT866; SOT886

Connections:
!HI_EXTSEL!: U$5.4 (B); also elsewhere on the board
!HI_HALT!: U$8.4 (B); also elsewhere on the board
!HI_IRQ!: U$6.4 (B); also elsewhere on the board
!HI_MPD!: U$4.4 (B); also elsewhere on the board
!HI_RST!: U$17.4 (B); also elsewhere on the board
!LO_EXTSEL!: U$5.3 (A); also elsewhere on the board
!LO_HALT!: U$8.3 (A); also elsewhere on the board
!LO_IRQ!: U$6.3 (A); also elsewhere on the board
!LO_MPD!: U$4.3 (A); also elsewhere on the board
!LO_RST!: U$17.3 (A); also elsewhere on the board
+3V3: C1.1, C3.1, C4.1, C5.1, C6.1, C13.1, C14.1, C17.1, C57.1, C60.1, C63.1, C65.1, LVL_AHI.1 (VCCA), LVL_ALO.1 (VCCA), LVL_D.1 (VCCA), U$4.1 (VCCA), U$5.1 (VCCA), U$6.1 (VCCA), U$8.1 (VCCA), U$9.1 (VCCA), U$14.1 (VCCA), U$15.1 (VCCA), U$16.1 (VCCA), U$17.1 (VCCA); also elsewhere on the board
+5V: C2.1, C8.1, C9.1, C11.1, C12.1, C15.1, C16.1, C18.1, C67.1, C68.1, C71.1, C72.1, LVL_AHI.23 (VCCB), LVL_AHI.24 (VCCB), LVL_ALO.23 (VCCB), LVL_ALO.24 (VCCB), LVL_D.23 (VCCB), LVL_D.24 (VCCB), U$4.6 (VCCB), U$5.6 (VCCB), U$6.6 (VCCB), U$8.6 (VCCB), U$9.6 (VCCB), U$14.6 (VCCB), U$15.6 (VCCB), U$16.6 (VCCB), U$17.6 (VCCB); also elsewhere on the board
DIR_A: LVL_AHI.2 (DIR), LVL_ALO.2 (DIR), R26.1; also elsewhere on the board
DIR_D: LVL_D.2 (DIR), R25.1; also elsewhere on the board
DIR_EXTSEL: R3.1, U$5.5 (DIR); also elsewhere on the board
DIR_HALT: R19.1, U$8.5 (DIR); also elsewhere on the board
DIR_IRQ: R4.1, U$6.5 (DIR); also elsewhere on the board
DIR_MPD: R5.1, U$4.5 (DIR); also elsewhere on the board
DIR_RST: R21.1, U$17.5 (DIR); also elsewhere on the board
DIR_RW: R22.1, U$9.5 (DIR); also elsewhere on the board
GND: C1.2, C2.2, C3.2, C4.2, C5.2, C6.2, C8.2, C9.2, C11.2, C12.2, C13.2, C14.2, C15.2, C16.2, C17.2, C18.2, C57.2, C60.2, C63.2, C65.2, C67.2, C68.2, C71.2, C72.2, LVL_AHI.11 (GND), LVL_AHI.12 (GND), LVL_AHI.13 (GND), LVL_AHI.22 (!OE!), LVL_ALO.11 (GND), LVL_ALO.12 (GND), LVL_ALO.13 (GND), LVL_ALO.22 (!OE!), LVL_D.11 (GND), LVL_D.12 (GND), LVL_D.13 (GND), LVL_D.22 (!OE!), R3.2, R4.2, R5.2, R19.2, R21.2, R22.2, R25.2, R26.2, U$4.2 (GND), U$5.2 (GND), U$6.2 (GND), U$8.2 (GND), U$9.2 (GND), U$14.2 (GND), U$14.5 (DIR), U$15.2 (GND), U$15.5 (DIR), U$16.2 (GND), U$16.5 (DIR), U$17.2 (GND); also elsewhere on the board
HI_A0: LVL_ALO.21 (B1); also elsewhere on the board
HI_A1: LVL_ALO.20 (B2); also elsewhere on the board
HI_A2: LVL_ALO.19 (B3); also elsewhere on the board
HI_A3: LVL_ALO.18 (B4); also elsewhere on the board
HI_A4: LVL_ALO.17 (B5); also elsewhere on the board
HI_A5: LVL_ALO.16 (B6); also elsewhere on the board
HI_A6: LVL_ALO.15 (B7); also elsewhere on the board
HI_A7: LVL_ALO.14 (B8); also elsewhere on the board
HI_A8: LVL_AHI.21 (B1); also elsewhere on the board
HI_A9: LVL_AHI.20 (B2); also elsewhere on the board
HI_A10: LVL_AHI.19 (B3); also elsewhere on the board
HI_A11: LVL_AHI.18 (B4); also elsewhere on the board
HI_A12: LVL_AHI.17 (B5); also elsewhere on the board
HI_A13: LVL_AHI.16 (B6); also elsewhere on the board
HI_A14: LVL_AHI.15 (B7); also elsewhere on the board
HI_A15: LVL_AHI.14 (B8); also elsewhere on the board
HI_CLK: U$15.4 (B); also elsewhere on the board
HI_D0: LVL_D.21 (B1); also elsewhere on the board
HI_D1: LVL_D.20 (B2); also elsewhere on the board
HI_D2: LVL_D.19 (B3); also elsewhere on the board
HI_D3: LVL_D.18 (B4); also elsewhere on the board
HI_D4: LVL_D.17 (B5); also elsewhere on the board
HI_D5: LVL_D.16 (B6); also elsewhere on the board
HI_D6: LVL_D.15 (B7); also elsewhere on the board
HI_D7: LVL_D.14 (B8); also elsewhere on the board
HI_R/!W!: U$9.4 (B); also elsewhere on the board
HI_RD4: U$16.4 (B); also elsewhere on the board
HI_RD5: U$14.4 (B); also elsewhere on the board
LO_A0: LVL_ALO.3 (A1); also elsewhere on the board
LO_A1: LVL_ALO.4 (A2); also elsewhere on the board
LO_A2: LVL_ALO.5 (A3); also elsewhere on the board
LO_A3: LVL_ALO.6 (A4); also elsewhere on the board
LO_A4: LVL_ALO.7 (A5); also elsewhere on the board
LO_A5: LVL_ALO.8 (A6); also elsewhere on the board
LO_A6: LVL_ALO.9 (A7); also elsewhere on the board
LO_A7: LVL_ALO.10 (A8); also elsewhere on the board
LO_A8: LVL_AHI.3 (A1); also elsewhere on the board
LO_A9: LVL_AHI.4 (A2); also elsewhere on the board
LO_A10: LVL_AHI.5 (A3); also elsewhere on the board
LO_A11: LVL_AHI.6 (A4); also elsewhere on the board
LO_A12: LVL_AHI.7 (A5); also elsewhere on the board
LO_A13: LVL_AHI.8 (A6); also elsewhere on the board
LO_A14: LVL_AHI.9 (A7); also elsewhere on the board
LO_A15: LVL_AHI.10 (A8); also elsewhere on the board
LO_CLK: U$15.3 (A); also elsewhere on the board
LO_D0: LVL_D.3 (A1); also elsewhere on the board
LO_D1: LVL_D.4 (A2); also elsewhere on the board
LO_D2: LVL_D.5 (A3); also elsewhere on the board
LO_D3: LVL_D.6 (A4); also elsewhere on the board
LO_D4: LVL_D.7 (A5); also elsewhere on the board
LO_D5: LVL_D.8 (A6); also elsewhere on the board
LO_D6: LVL_D.9 (A7); also elsewhere on the board
LO_D7: LVL_D.10 (A8); also elsewhere on the board
LO_R/!W!: U$9.3 (A); also elsewhere on the board
LO_RD4: U$16.3 (A); also elsewhere on the board
LO_RD5: U$14.3 (A); also elsewhere on the board

Notes on the sheet:
Dir=high : A->B tPD_AB : 0.7 .. 4.4ns tPD_BA : 0.6 .. 5.4ns
74LVCH1T45GW:
SN74LVC8T245:
Dir=high : A->B tPD_AB : 0.5 .. 4.4ns tPD_BA : 0.6 .. 6ns
Direction control / timings
Level changers
!EXTSEL!, !MPD! and !IRQ! have internal pullups on the Atari Motherboard
Parts Verified

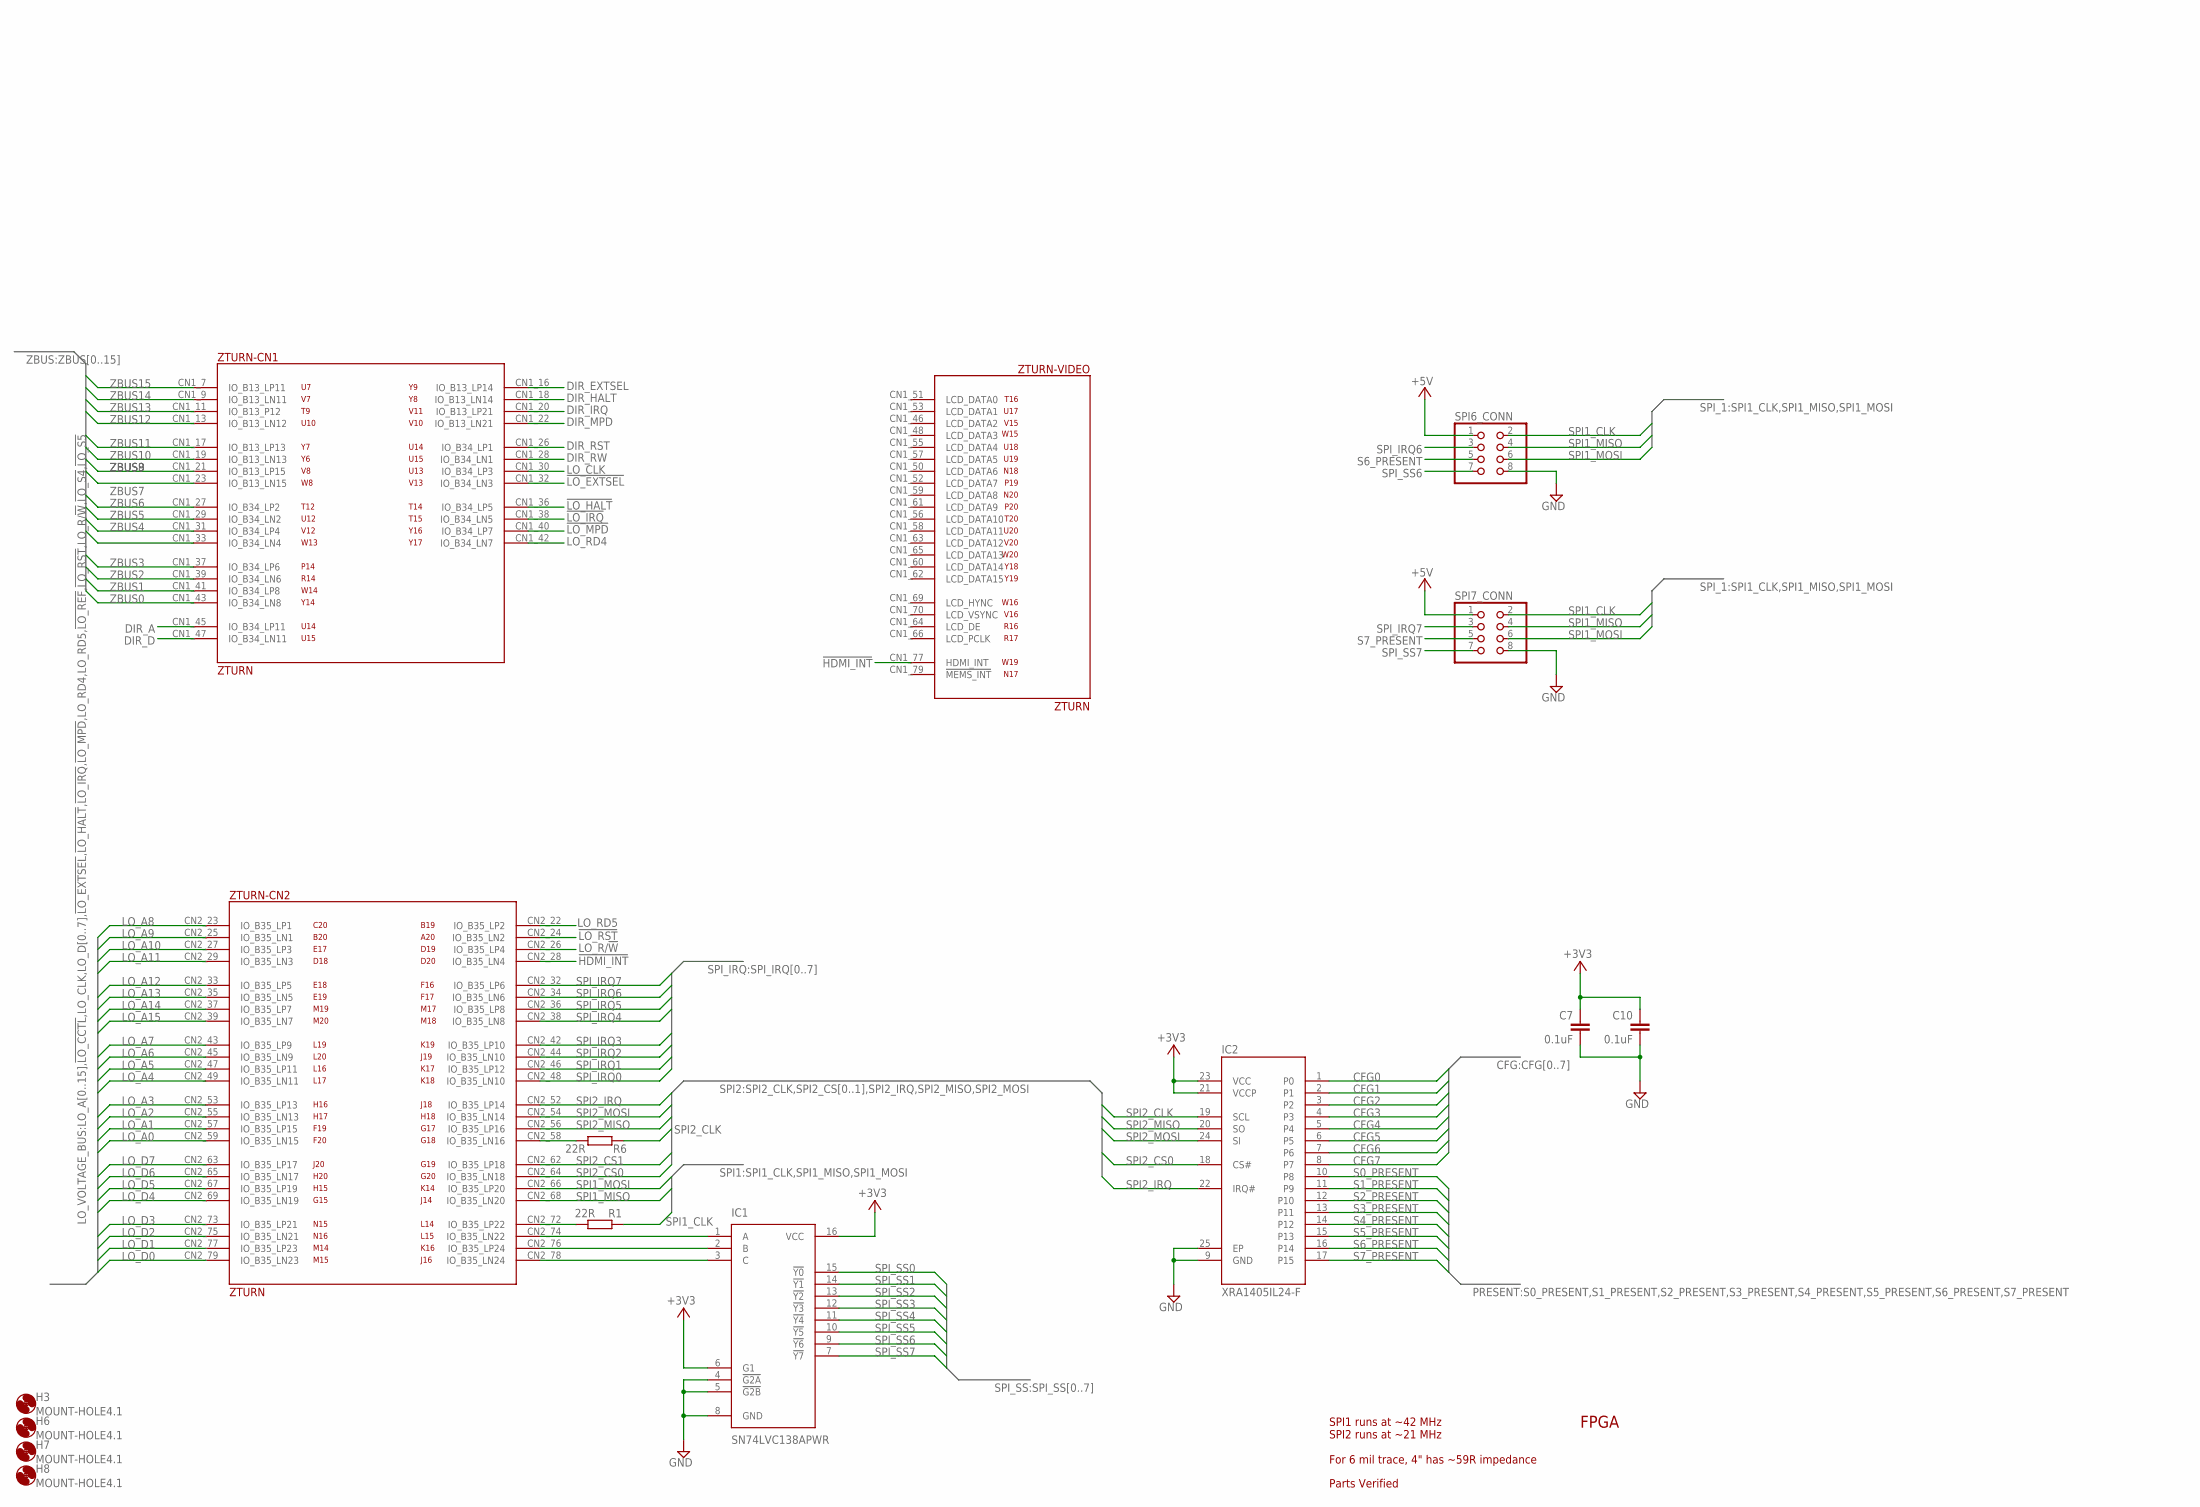
[picture p117: schematic xio5.sch, sheet 4, FPGA]

Parts:
C7, C10: 0.1uF; C0201
H3, H6, H7, H8: MOUNT-HOLE4.1; 4,1
IC1: SN74LVC138APWR; SOP65P640X120-16N
IC2: XRA1405IL24-F; QFN50P400X400X100-25N
R1, R6: 22R; R0201
SPI6_CONN, SPI7_CONN: PINHD-2X04_2.00; 2X04M
ZTURN: ZTURN

Connections:
!HDMI_INT!: ZTURN.CN1_77 (HDMI_INT), ZTURN.CN2_28 (IO_B35_LN4)
!LO_EXTSEL!: ZTURN.CN1_32 (IO_B34_LN3); also elsewhere on the board
!LO_HALT!: ZTURN.CN1_36 (IO_B34_LP5); also elsewhere on the board
!LO_IRQ!: ZTURN.CN1_38 (IO_B34_LN5); also elsewhere on the board
!LO_MPD!: ZTURN.CN1_40 (IO_B34_LP7); also elsewhere on the board
!LO_RST!: ZTURN.CN2_24 (IO_B35_LN2); also elsewhere on the board
+3V3: C7.1, C10.1, IC1.6 (G1), IC1.16 (VCC), IC2.21 (VCCP), IC2.23 (VCC); also elsewhere on the board
+5V: SPI6_CONN.1, SPI7_CONN.1; also elsewhere on the board
CFG0: IC2.1 (P0); also elsewhere on the board
CFG1: IC2.2 (P1); also elsewhere on the board
CFG2: IC2.3 (P2); also elsewhere on the board
CFG3: IC2.4 (P3); also elsewhere on the board
CFG4: IC2.5 (P4); also elsewhere on the board
CFG5: IC2.6 (P5); also elsewhere on the board
CFG6: IC2.7 (P6); also elsewhere on the board
CFG7: IC2.8 (P7); also elsewhere on the board
DIR_A: ZTURN.CN1_45 (IO_B34_LP11); also elsewhere on the board
DIR_D: ZTURN.CN1_47 (IO_B34_LN11); also elsewhere on the board
DIR_EXTSEL: ZTURN.CN1_16 (IO_B13_LP14); also elsewhere on the board
DIR_HALT: ZTURN.CN1_18 (IO_B13_LN14); also elsewhere on the board
DIR_IRQ: ZTURN.CN1_20 (IO_B13_LP21); also elsewhere on the board
DIR_MPD: ZTURN.CN1_22 (IO_B13_LN21); also elsewhere on the board
DIR_RST: ZTURN.CN1_26 (IO_B34_LP1); also elsewhere on the board
DIR_RW: ZTURN.CN1_28 (IO_B34_LN1); also elsewhere on the board
GND: C7.2, C10.2, IC1.4 (!G2A), IC1.5 (!G2B), IC1.8 (GND), IC2.9 (GND), IC2.25 (EP), SPI6_CONN.8, SPI7_CONN.8; also elsewhere on the board
LO_A0: ZTURN.CN2_59 (IO_B35_LN15); also elsewhere on the board
LO_A1: ZTURN.CN2_57 (IO_B35_LP15); also elsewhere on the board
LO_A2: ZTURN.CN2_55 (IO_B35_LN13); also elsewhere on the board
LO_A3: ZTURN.CN2_53 (IO_B35_LP13); also elsewhere on the board
LO_A4: ZTURN.CN2_49 (IO_B35_LN11); also elsewhere on the board
LO_A5: ZTURN.CN2_47 (IO_B35_LP11); also elsewhere on the board
LO_A6: ZTURN.CN2_45 (IO_B35_LN9); also elsewhere on the board
LO_A7: ZTURN.CN2_43 (IO_B35_LP9); also elsewhere on the board
LO_A8: ZTURN.CN2_23 (IO_B35_LP1); also elsewhere on the board
LO_A9: ZTURN.CN2_25 (IO_B35_LN1); also elsewhere on the board
LO_A10: ZTURN.CN2_27 (IO_B35_LP3); also elsewhere on the board
LO_A11: ZTURN.CN2_29 (IO_B35_LN3); also elsewhere on the board
LO_A12: ZTURN.CN2_33 (IO_B35_LP5); also elsewhere on the board
LO_A13: ZTURN.CN2_35 (IO_B35_LN5); also elsewhere on the board
LO_A14: ZTURN.CN2_37 (IO_B35_LP7); also elsewhere on the board
LO_A15: ZTURN.CN2_39 (IO_B35_LN7); also elsewhere on the board
LO_CLK: ZTURN.CN1_30 (IO_B34_LP3); also elsewhere on the board
LO_D0: ZTURN.CN2_79 (IO_B35_LN23); also elsewhere on the board
LO_D1: ZTURN.CN2_77 (IO_B35_LP23); also elsewhere on the board
LO_D2: ZTURN.CN2_75 (IO_B35_LN21); also elsewhere on the board
LO_D3: ZTURN.CN2_73 (IO_B35_LP21); also elsewhere on the board
LO_D4: ZTURN.CN2_69 (IO_B35_LN19); also elsewhere on the board
LO_D5: ZTURN.CN2_67 (IO_B35_LP19); also elsewhere on the board
LO_D6: ZTURN.CN2_65 (IO_B35_LN17); also elsewhere on the board
LO_D7: ZTURN.CN2_63 (IO_B35_LP17); also elsewhere on the board
LO_R/!W!: ZTURN.CN2_26 (IO_B35_LP4); also elsewhere on the board
LO_RD4: ZTURN.CN1_42 (IO_B34_LN7); also elsewhere on the board
LO_RD5: ZTURN.CN2_22 (IO_B35_LP2); also elsewhere on the board
unnamed: IC1.1 (A), ZTURN.CN2_74 (IO_B35_LN22)
unnamed: IC1.2 (B), ZTURN.CN2_76 (IO_B35_LP24)
unnamed: IC1.3 (C), ZTURN.CN2_78 (IO_B35_LN24)
unnamed: R1.1, ZTURN.CN2_72 (IO_B35_LP22)
unnamed: R6.1, ZTURN.CN2_58 (IO_B35_LN16)
S0_PRESENT: IC2.10 (P8); also elsewhere on the board
S1_PRESENT: IC2.11 (P9); also elsewhere on the board
S2_PRESENT: IC2.12 (P10); also elsewhere on the board
S3_PRESENT: IC2.13 (P11); also elsewhere on the board
S4_PRESENT: IC2.14 (P12); also elsewhere on the board
S5_PRESENT: IC2.15 (P13); also elsewhere on the board
S6_PRESENT: IC2.16 (P14), SPI6_CONN.5
S7_PRESENT: IC2.17 (P15), SPI7_CONN.5
SPI1_CLK: R1.2, SPI6_CONN.2, SPI7_CONN.2; also elsewhere on the board
SPI1_MISO: SPI6_CONN.4, SPI7_CONN.4, ZTURN.CN2_68 (IO_B35_LN20); also elsewhere on the board
SPI1_MOSI: SPI6_CONN.6, SPI7_CONN.6, ZTURN.CN2_66 (IO_B35_LP20); also elsewhere on the board
SPI2_CLK: IC2.19 (SCL), R6.2; also elsewhere on the board
SPI2_CS0: IC2.18 (CS#), ZTURN.CN2_64 (IO_B35_LN18)
SPI2_CS1: ZTURN.CN2_62 (IO_B35_LP18); also elsewhere on the board
SPI2_IRQ: IC2.22 (IRQ#), ZTURN.CN2_52 (IO_B35_LP14); also elsewhere on the board
SPI2_MISO: IC2.20 (SO), ZTURN.CN2_56 (IO_B35_LP16); also elsewhere on the board
SPI2_MOSI: IC2.24 (SI), ZTURN.CN2_54 (IO_B35_LN14); also elsewhere on the board
SPI_IRQ0: ZTURN.CN2_48 (IO_B35_LN10); also elsewhere on the board
SPI_IRQ1: ZTURN.CN2_46 (IO_B35_LP12); also elsewhere on the board
SPI_IRQ2: ZTURN.CN2_44 (IO_B35_LN10); also elsewhere on the board
SPI_IRQ3: ZTURN.CN2_42 (IO_B35_LP10); also elsewhere on the board
SPI_IRQ4: ZTURN.CN2_38 (IO_B35_LN8); also elsewhere on the board
SPI_IRQ5: ZTURN.CN2_36 (IO_B35_LP8); also elsewhere on the board
SPI_IRQ6: SPI6_CONN.3, ZTURN.CN2_34 (IO_B35_LN6)
SPI_IRQ7: SPI7_CONN.3, ZTURN.CN2_32 (IO_B35_LP6)
SPI_SS0: IC1.15 (!Y0); also elsewhere on the board
SPI_SS1: IC1.14 (!Y1); also elsewhere on the board
SPI_SS2: IC1.13 (!Y2); also elsewhere on the board
SPI_SS3: IC1.12 (!Y3); also elsewhere on the board
SPI_SS4: IC1.11 (!Y4); also elsewhere on the board
SPI_SS5: IC1.10 (!Y5); also elsewhere on the board
SPI_SS6: IC1.9 (!Y6), SPI6_CONN.7
SPI_SS7: IC1.7 (!Y7), SPI7_CONN.7
ZBUS0: ZTURN.CN1_43 (IO_B34_LN8); also elsewhere on the board
ZBUS1: ZTURN.CN1_41 (IO_B34_LP8); also elsewhere on the board
ZBUS2: ZTURN.CN1_39 (IO_B34_LN6); also elsewhere on the board
ZBUS3: ZTURN.CN1_37 (IO_B34_LP6); also elsewhere on the board
ZBUS4: ZTURN.CN1_33 (IO_B34_LN4); also elsewhere on the board
ZBUS5: ZTURN.CN1_31 (IO_B34_LP4); also elsewhere on the board
ZBUS6: ZTURN.CN1_29 (IO_B34_LN2); also elsewhere on the board
ZBUS7: ZTURN.CN1_27 (IO_B34_LP2); also elsewhere on the board
ZBUS8: ZTURN.CN1_23 (IO_B13_LN15); also elsewhere on the board
ZBUS9: ZTURN.CN1_21 (IO_B13_LP15); also elsewhere on the board
ZBUS10: ZTURN.CN1_19 (IO_B13_LN13); also elsewhere on the board
ZBUS11: ZTURN.CN1_17 (IO_B13_LP13); also elsewhere on the board
ZBUS12: ZTURN.CN1_13 (IO_B13_LN12); also elsewhere on the board
ZBUS13: ZTURN.CN1_11 (IO_B13_P12); also elsewhere on the board
ZBUS14: ZTURN.CN1_9 (IO_B13_LN11); also elsewhere on the board
ZBUS15: ZTURN.CN1_7 (IO_B13_LP11); also elsewhere on the board

Notes on the sheet:
FPGA
SPI1 runs at ~42 MHz SPI2 runs at ~21 MHz For 6 mil trace, 4" has ~59R impedance
Parts Verified

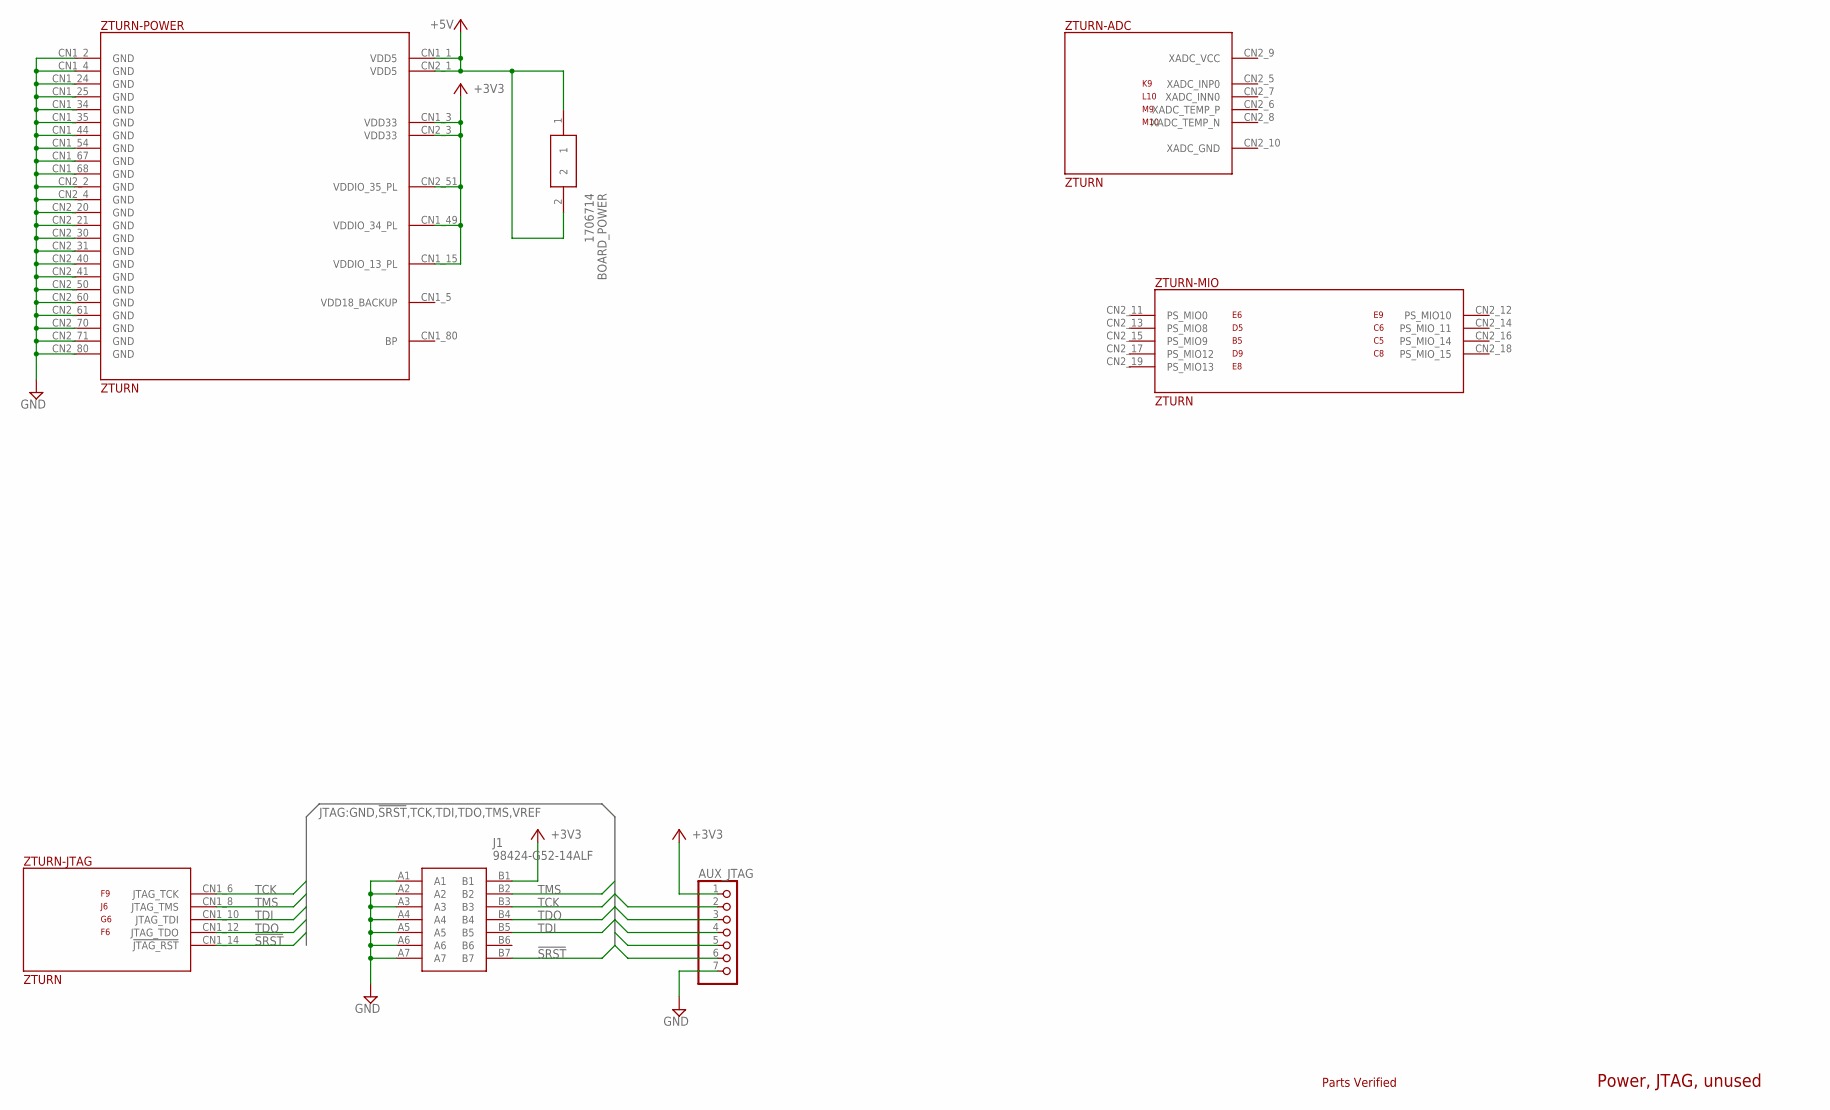
[picture p118: schematic xio5.sch, sheet 5, Power, JTAG, Unused pins]

Parts:
AUX_JTAG: PINHD-1X7; 1X07
BOARD_POWER: 1706714
J1: 98424-G52-14ALF; 98424G5214ALF
ZTURN: ZTURN

Connections:
!SRST!: AUX_JTAG.6, J1.B7, ZTURN.CN1_14 (!JTAG_RST!)
+3V3: AUX_JTAG.1, J1.B1, ZTURN.CN1_3 (VDD33), ZTURN.CN1_15 (VDDIO_13_PL), ZTURN.CN1_49 (VDDIO_34_PL), ZTURN.CN2_3 (VDD33), ZTURN.CN2_51 (VDDIO_35_PL); also elsewhere on the board
+5V: BOARD_POWER.1, BOARD_POWER.2, ZTURN.CN1_1 (VDD5), ZTURN.CN2_1 (VDD5); also elsewhere on the board
GND: AUX_JTAG.7, J1.A1, J1.A2, J1.A3, J1.A4, J1.A5, J1.A6, J1.A7, ZTURN.CN1_2 (GND), ZTURN.CN1_4 (GND), ZTURN.CN1_24 (GND), ZTURN.CN1_25 (GND), ZTURN.CN1_34 (GND), ZTURN.CN1_35 (GND), ZTURN.CN1_44 (GND), ZTURN.CN1_54 (GND), ZTURN.CN1_67 (GND), ZTURN.CN1_68 (GND), ZTURN.CN2_2 (GND), ZTURN.CN2_4 (GND), ZTURN.CN2_20 (GND), ZTURN.CN2_21 (GND), ZTURN.CN2_30 (GND), ZTURN.CN2_31 (GND), ZTURN.CN2_40 (GND), ZTURN.CN2_41 (GND), ZTURN.CN2_50 (GND), ZTURN.CN2_60 (GND), ZTURN.CN2_61 (GND), ZTURN.CN2_70 (GND), ZTURN.CN2_71 (GND), ZTURN.CN2_80 (GND); also elsewhere on the board
TCK: AUX_JTAG.3, J1.B3, ZTURN.CN1_6 (JTAG_TCK)
TDI: AUX_JTAG.5, J1.B5, ZTURN.CN1_10 (JTAG_TDI)
TDO: AUX_JTAG.4, J1.B4, ZTURN.CN1_12 (JTAG_TDO)
TMS: AUX_JTAG.2, J1.B2, ZTURN.CN1_8 (JTAG_TMS)

Notes on the sheet:
Power, JTAG, unused
Parts Verified

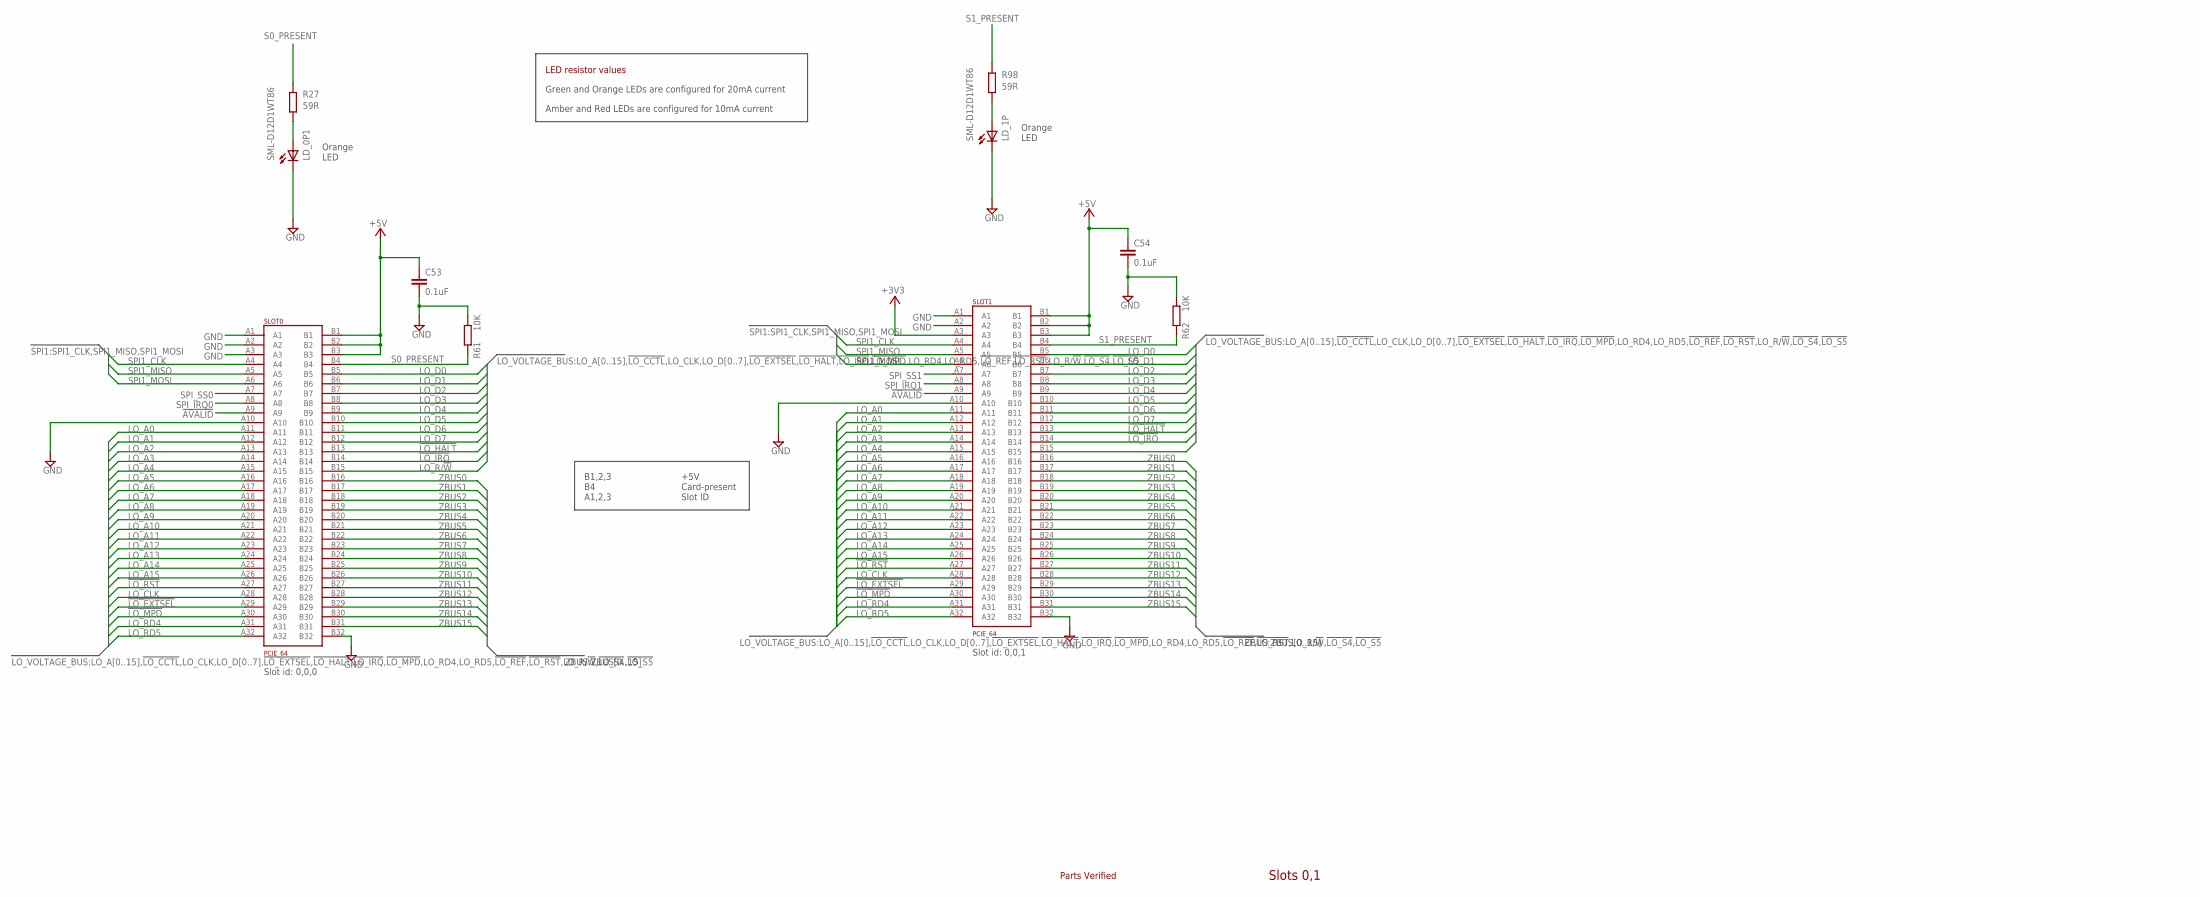
[picture p119: schematic xio5.sch, sheet 6, Expansion slots 0 & 1]

Parts:
C53, C54: 0.1uF; C0201
LD_0P1, LD_1P: SML-D12D1WT86; CHIPLED_0603
R27, R98: 59R; R0402
R61, R62: 10K; R0201
SLOT0, SLOT1: PCIE_64; PCI-E_64

Connections:
!AVALID!: SLOT0.A9, SLOT1.A9; also elsewhere on the board
!LO_EXTSEL!: SLOT0.A29, SLOT1.A29; also elsewhere on the board
!LO_HALT!: SLOT0.B13, SLOT1.B13; also elsewhere on the board
!LO_IRQ!: SLOT0.B14, SLOT1.B14; also elsewhere on the board
!LO_MPD!: SLOT0.A30, SLOT1.A30; also elsewhere on the board
!LO_RST!: SLOT0.A27, SLOT1.A27; also elsewhere on the board
+3V3: SLOT1.A3; also elsewhere on the board
+5V: C53.1, C54.1, SLOT0.B1, SLOT0.B2, SLOT0.B3, SLOT1.B1, SLOT1.B2, SLOT1.B3; also elsewhere on the board
GND: C53.2, C54.2, LD_0P1.C, LD_1P.C, R61.1, R62.1, SLOT0.A1, SLOT0.A2, SLOT0.A3, SLOT0.A10, SLOT0.B32, SLOT1.A1, SLOT1.A2, SLOT1.A10, SLOT1.B32; also elsewhere on the board
LO_A0: SLOT0.A11, SLOT1.A11; also elsewhere on the board
LO_A1: SLOT0.A12, SLOT1.A12; also elsewhere on the board
LO_A2: SLOT0.A13, SLOT1.A13; also elsewhere on the board
LO_A3: SLOT0.A14, SLOT1.A14; also elsewhere on the board
LO_A4: SLOT0.A15, SLOT1.A15; also elsewhere on the board
LO_A5: SLOT0.A16, SLOT1.A16; also elsewhere on the board
LO_A6: SLOT0.A17, SLOT1.A17; also elsewhere on the board
LO_A7: SLOT0.A18, SLOT1.A18; also elsewhere on the board
LO_A8: SLOT0.A19, SLOT1.A19; also elsewhere on the board
LO_A9: SLOT0.A20, SLOT1.A20; also elsewhere on the board
LO_A10: SLOT0.A21, SLOT1.A21; also elsewhere on the board
LO_A11: SLOT0.A22, SLOT1.A22; also elsewhere on the board
LO_A12: SLOT0.A23, SLOT1.A23; also elsewhere on the board
LO_A13: SLOT0.A24, SLOT1.A24; also elsewhere on the board
LO_A14: SLOT0.A25, SLOT1.A25; also elsewhere on the board
LO_A15: SLOT0.A26, SLOT1.A26; also elsewhere on the board
LO_CLK: SLOT0.A28, SLOT1.A28; also elsewhere on the board
LO_D0: SLOT0.B5, SLOT1.B5; also elsewhere on the board
LO_D1: SLOT0.B6, SLOT1.B6; also elsewhere on the board
LO_D2: SLOT0.B7, SLOT1.B7; also elsewhere on the board
LO_D3: SLOT0.B8, SLOT1.B8; also elsewhere on the board
LO_D4: SLOT0.B9, SLOT1.B9; also elsewhere on the board
LO_D5: SLOT0.B10, SLOT1.B10; also elsewhere on the board
LO_D6: SLOT0.B11, SLOT1.B11; also elsewhere on the board
LO_D7: SLOT0.B12, SLOT1.B12; also elsewhere on the board
LO_R/!W!: SLOT0.B15, SLOT1.B15; also elsewhere on the board
LO_RD4: SLOT0.A31, SLOT1.A31; also elsewhere on the board
LO_RD5: SLOT0.A32, SLOT1.A32; also elsewhere on the board
unnamed: LD_0P1.A, R27.2
unnamed: LD_1P.A, R98.2
S0_PRESENT: R27.1, R61.2, SLOT0.B4; also elsewhere on the board
S1_PRESENT: R62.2, R98.1, SLOT1.B4; also elsewhere on the board
SPI1_CLK: SLOT0.A4, SLOT1.A4; also elsewhere on the board
SPI1_MISO: SLOT0.A5, SLOT1.A5; also elsewhere on the board
SPI1_MOSI: SLOT0.A6, SLOT1.A6; also elsewhere on the board
SPI_IRQ0: SLOT0.A8; also elsewhere on the board
SPI_IRQ1: SLOT1.A8; also elsewhere on the board
SPI_SS0: SLOT0.A7; also elsewhere on the board
SPI_SS1: SLOT1.A7; also elsewhere on the board
ZBUS0: SLOT0.B16, SLOT1.B16; also elsewhere on the board
ZBUS1: SLOT0.B17, SLOT1.B17; also elsewhere on the board
ZBUS2: SLOT0.B18, SLOT1.B18; also elsewhere on the board
ZBUS3: SLOT0.B19, SLOT1.B19; also elsewhere on the board
ZBUS4: SLOT0.B20, SLOT1.B20; also elsewhere on the board
ZBUS5: SLOT0.B21, SLOT1.B21; also elsewhere on the board
ZBUS6: SLOT0.B22, SLOT1.B22; also elsewhere on the board
ZBUS7: SLOT0.B23, SLOT1.B23; also elsewhere on the board
ZBUS8: SLOT0.B24, SLOT1.B24; also elsewhere on the board
ZBUS9: SLOT0.B25, SLOT1.B25; also elsewhere on the board
ZBUS10: SLOT0.B26, SLOT1.B26; also elsewhere on the board
ZBUS11: SLOT0.B27, SLOT1.B27; also elsewhere on the board
ZBUS12: SLOT0.B28, SLOT1.B28; also elsewhere on the board
ZBUS13: SLOT0.B29, SLOT1.B29; also elsewhere on the board
ZBUS14: SLOT0.B30, SLOT1.B30; also elsewhere on the board
ZBUS15: SLOT0.B31, SLOT1.B31; also elsewhere on the board

Notes on the sheet:
Slots 0,1
Slot id: 0,0,0
Slot id: 0,0,1
B1,2,3 B4 A1,2,3
+5V Card-present Slot ID
Orange LED
Green and Orange LEDs are configured for 20mA current
Amber and Red LEDs are configured for 10mA current
LED resistor values
Parts Verified
