ThrudTheBarbarian/pbxl/boards/xio5/xio5.brd

## EAGLE design boards/xio5/xio5.brd (continued)

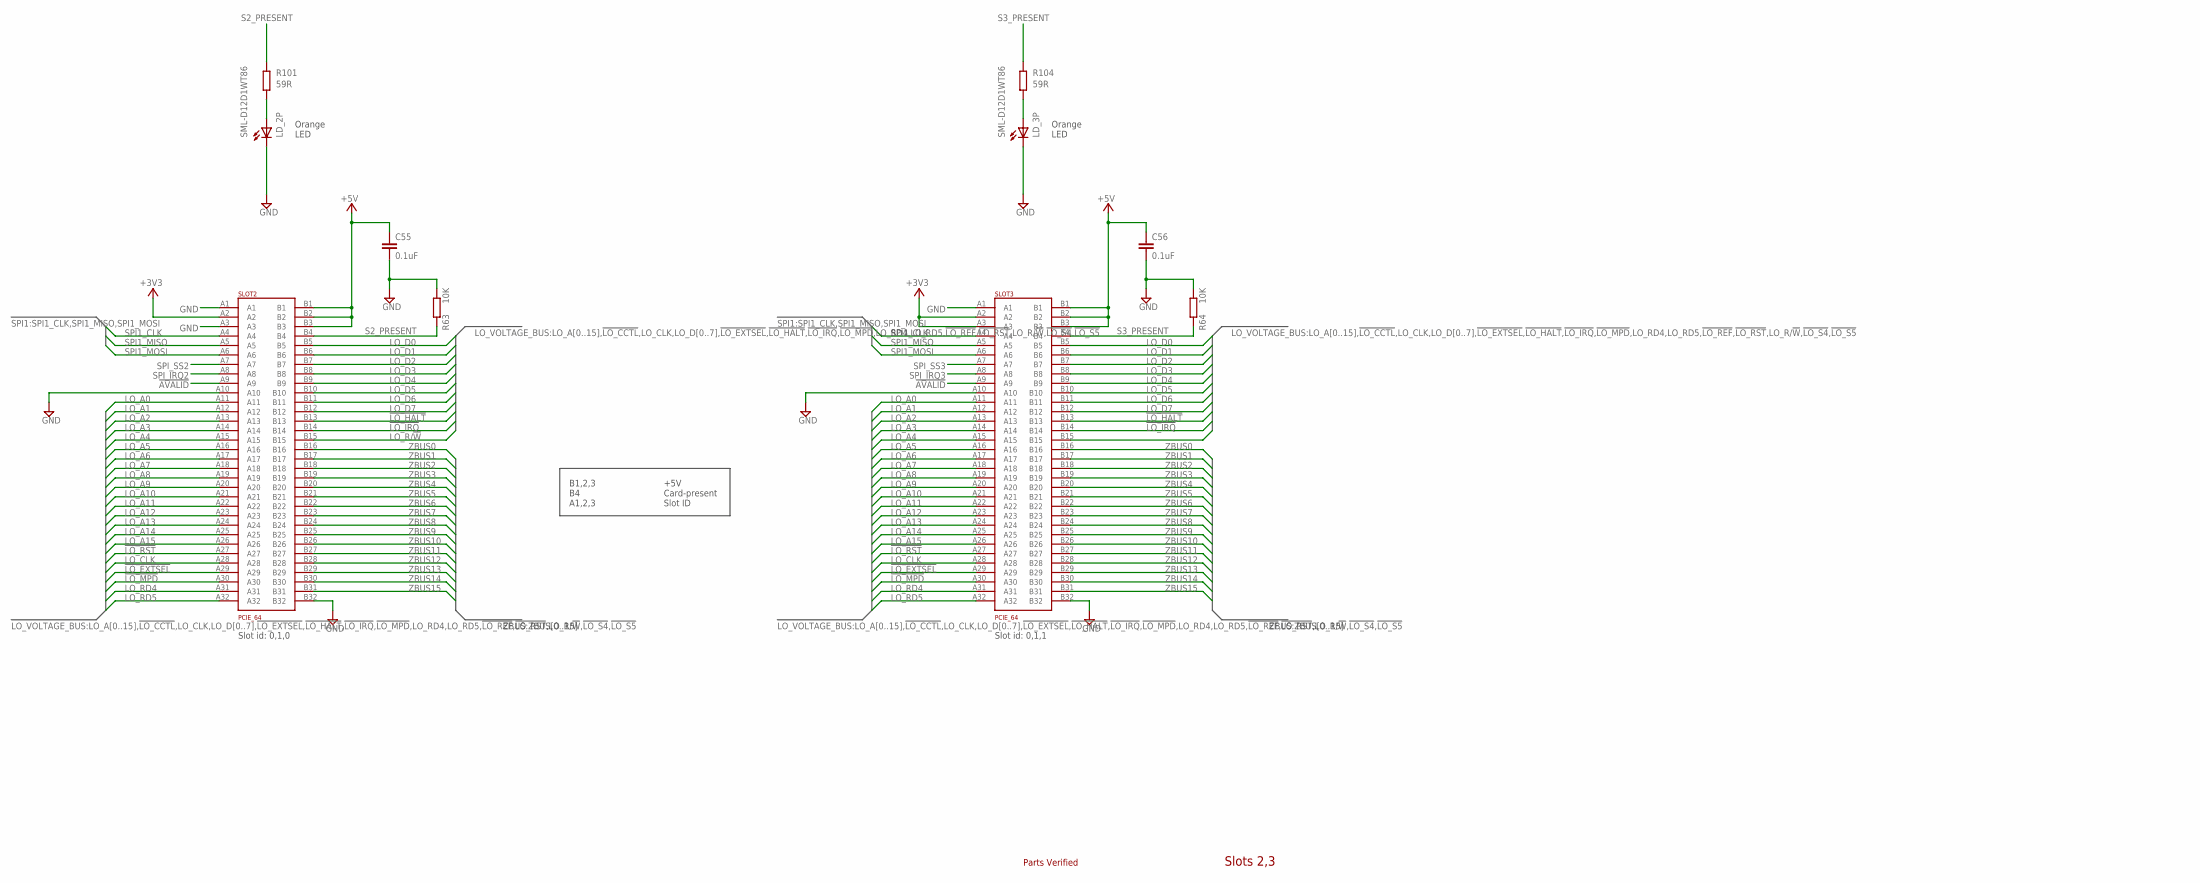
[picture p120: schematic xio5.sch, sheet 7, Expansion slots 2 & 3]

Parts:
C55, C56: 0.1uF; C0201
LD_2P, LD_3P: SML-D12D1WT86; CHIPLED_0603
R63, R64: 10K; R0201
R101, R104: 59R; R0402
SLOT2, SLOT3: PCIE_64; PCI-E_64

Connections:
!AVALID!: SLOT2.A9, SLOT3.A9; also elsewhere on the board
!LO_EXTSEL!: SLOT2.A29, SLOT3.A29; also elsewhere on the board
!LO_HALT!: SLOT2.B13, SLOT3.B13; also elsewhere on the board
!LO_IRQ!: SLOT2.B14, SLOT3.B14; also elsewhere on the board
!LO_MPD!: SLOT2.A30, SLOT3.A30; also elsewhere on the board
!LO_RST!: SLOT2.A27, SLOT3.A27; also elsewhere on the board
+3V3: SLOT2.A2, SLOT3.A2, SLOT3.A3; also elsewhere on the board
+5V: C55.1, C56.1, SLOT2.B1, SLOT2.B2, SLOT2.B3, SLOT3.B1, SLOT3.B2, SLOT3.B3; also elsewhere on the board
GND: C55.2, C56.2, LD_2P.C, LD_3P.C, R63.1, R64.1, SLOT2.A1, SLOT2.A3, SLOT2.A10, SLOT2.B32, SLOT3.A1, SLOT3.A10, SLOT3.B32; also elsewhere on the board
LO_A0: SLOT2.A11, SLOT3.A11; also elsewhere on the board
LO_A1: SLOT2.A12, SLOT3.A12; also elsewhere on the board
LO_A2: SLOT2.A13, SLOT3.A13; also elsewhere on the board
LO_A3: SLOT2.A14, SLOT3.A14; also elsewhere on the board
LO_A4: SLOT2.A15, SLOT3.A15; also elsewhere on the board
LO_A5: SLOT2.A16, SLOT3.A16; also elsewhere on the board
LO_A6: SLOT2.A17, SLOT3.A17; also elsewhere on the board
LO_A7: SLOT2.A18, SLOT3.A18; also elsewhere on the board
LO_A8: SLOT2.A19, SLOT3.A19; also elsewhere on the board
LO_A9: SLOT2.A20, SLOT3.A20; also elsewhere on the board
LO_A10: SLOT2.A21, SLOT3.A21; also elsewhere on the board
LO_A11: SLOT2.A22, SLOT3.A22; also elsewhere on the board
LO_A12: SLOT2.A23, SLOT3.A23; also elsewhere on the board
LO_A13: SLOT2.A24, SLOT3.A24; also elsewhere on the board
LO_A14: SLOT2.A25, SLOT3.A25; also elsewhere on the board
LO_A15: SLOT2.A26, SLOT3.A26; also elsewhere on the board
LO_CLK: SLOT2.A28, SLOT3.A28; also elsewhere on the board
LO_D0: SLOT2.B5, SLOT3.B5; also elsewhere on the board
LO_D1: SLOT2.B6, SLOT3.B6; also elsewhere on the board
LO_D2: SLOT2.B7, SLOT3.B7; also elsewhere on the board
LO_D3: SLOT2.B8, SLOT3.B8; also elsewhere on the board
LO_D4: SLOT2.B9, SLOT3.B9; also elsewhere on the board
LO_D5: SLOT2.B10, SLOT3.B10; also elsewhere on the board
LO_D6: SLOT2.B11, SLOT3.B11; also elsewhere on the board
LO_D7: SLOT2.B12, SLOT3.B12; also elsewhere on the board
LO_R/!W!: SLOT2.B15, SLOT3.B15; also elsewhere on the board
LO_RD4: SLOT2.A31, SLOT3.A31; also elsewhere on the board
LO_RD5: SLOT2.A32, SLOT3.A32; also elsewhere on the board
unnamed: LD_2P.A, R101.2
unnamed: LD_3P.A, R104.2
S2_PRESENT: R63.2, R101.1, SLOT2.B4; also elsewhere on the board
S3_PRESENT: R64.2, R104.1, SLOT3.B4; also elsewhere on the board
SPI1_CLK: SLOT2.A4, SLOT3.A4; also elsewhere on the board
SPI1_MISO: SLOT2.A5, SLOT3.A5; also elsewhere on the board
SPI1_MOSI: SLOT2.A6, SLOT3.A6; also elsewhere on the board
SPI_IRQ2: SLOT2.A8; also elsewhere on the board
SPI_IRQ3: SLOT3.A8; also elsewhere on the board
SPI_SS2: SLOT2.A7; also elsewhere on the board
SPI_SS3: SLOT3.A7; also elsewhere on the board
ZBUS0: SLOT2.B16, SLOT3.B16; also elsewhere on the board
ZBUS1: SLOT2.B17, SLOT3.B17; also elsewhere on the board
ZBUS2: SLOT2.B18, SLOT3.B18; also elsewhere on the board
ZBUS3: SLOT2.B19, SLOT3.B19; also elsewhere on the board
ZBUS4: SLOT2.B20, SLOT3.B20; also elsewhere on the board
ZBUS5: SLOT2.B21, SLOT3.B21; also elsewhere on the board
ZBUS6: SLOT2.B22, SLOT3.B22; also elsewhere on the board
ZBUS7: SLOT2.B23, SLOT3.B23; also elsewhere on the board
ZBUS8: SLOT2.B24, SLOT3.B24; also elsewhere on the board
ZBUS9: SLOT2.B25, SLOT3.B25; also elsewhere on the board
ZBUS10: SLOT2.B26, SLOT3.B26; also elsewhere on the board
ZBUS11: SLOT2.B27, SLOT3.B27; also elsewhere on the board
ZBUS12: SLOT2.B28, SLOT3.B28; also elsewhere on the board
ZBUS13: SLOT2.B29, SLOT3.B29; also elsewhere on the board
ZBUS14: SLOT2.B30, SLOT3.B30; also elsewhere on the board
ZBUS15: SLOT2.B31, SLOT3.B31; also elsewhere on the board

Notes on the sheet:
Slots 2,3
Slot id: 0,1,0
Slot id: 0,1,1
B1,2,3 B4 A1,2,3
+5V Card-present Slot ID
Orange LED
Parts Verified

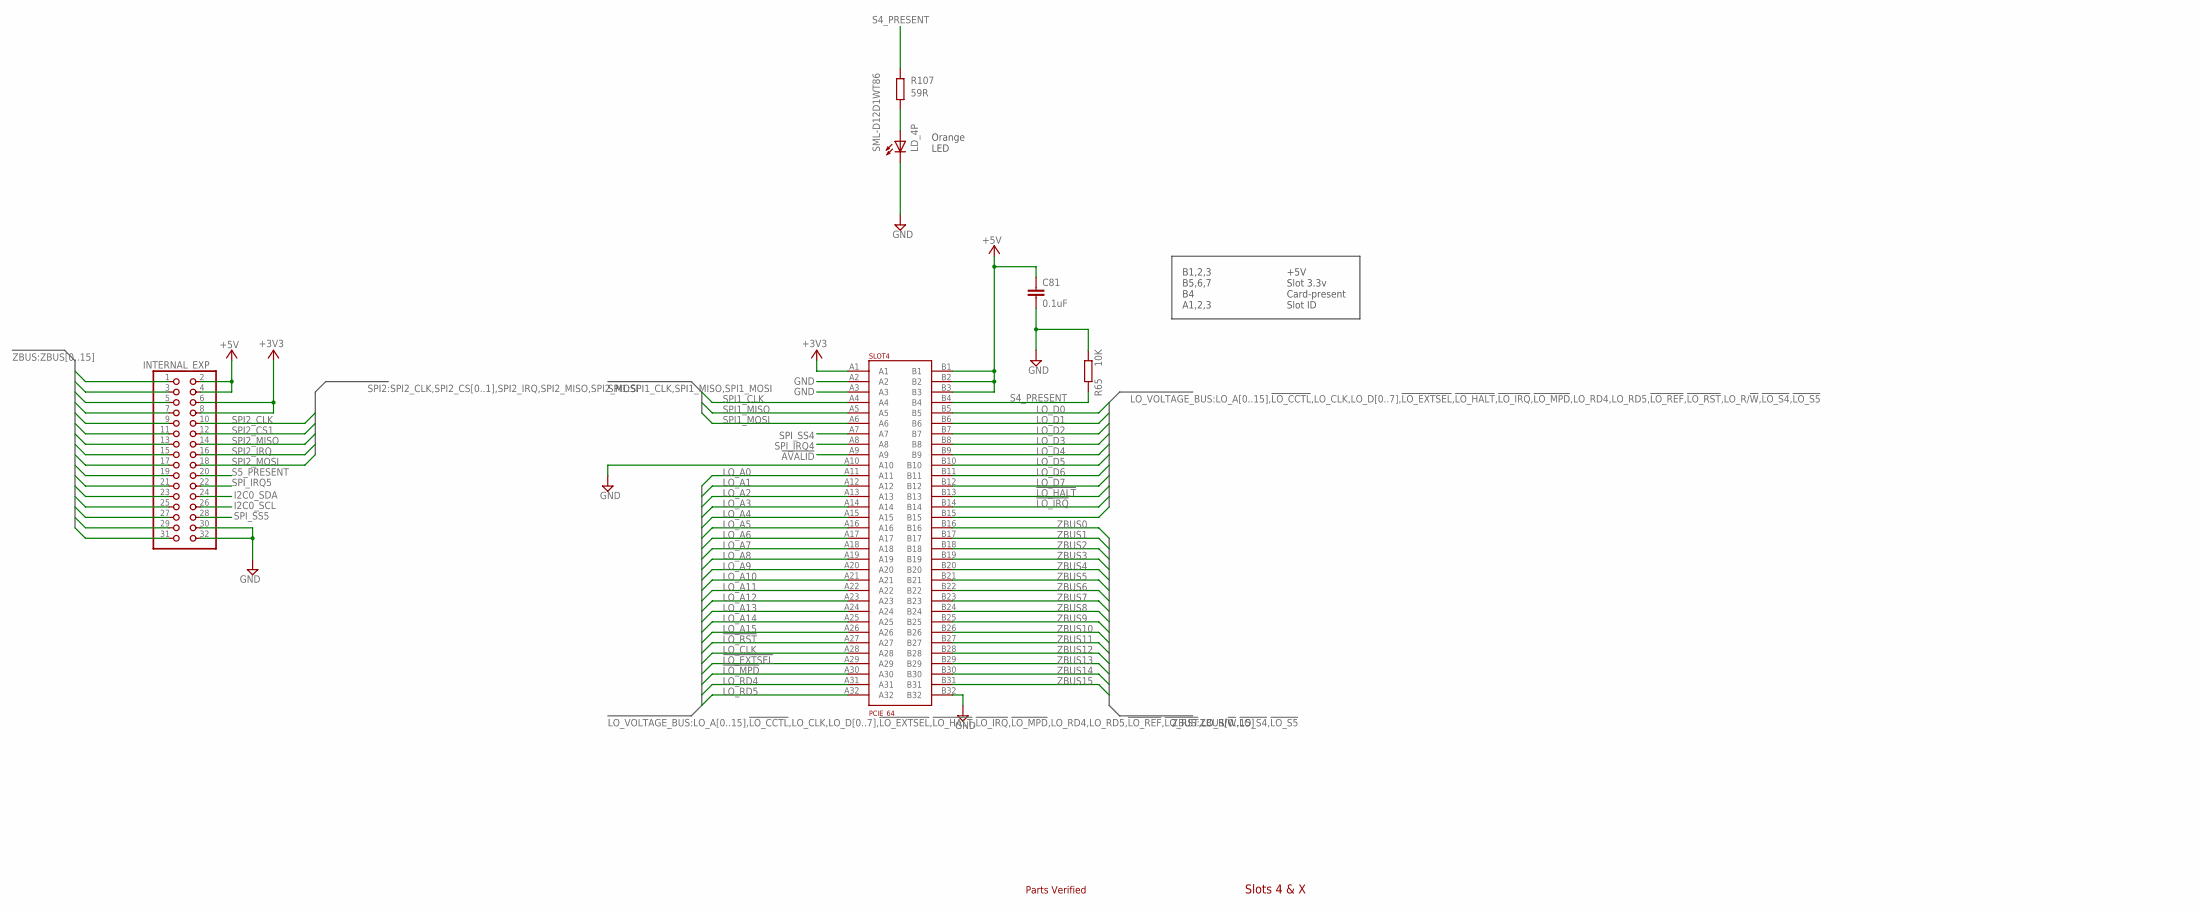
[picture p121: schematic xio5.sch, sheet 8, Expansion slot 4 and Internal]

Parts:
C81: 0.1uF; C0201
INTERNAL_EXP: PINHD-2X16_2.00; 2X16M
LD_4P: SML-D12D1WT86; CHIPLED_0603
R65: 10K; R0201
R107: 59R; R0402
SLOT4: PCIE_64; PCI-E_64

Connections:
!AVALID!: SLOT4.A9; also elsewhere on the board
!LO_EXTSEL!: SLOT4.A29; also elsewhere on the board
!LO_HALT!: SLOT4.B13; also elsewhere on the board
!LO_IRQ!: SLOT4.B14; also elsewhere on the board
!LO_MPD!: SLOT4.A30; also elsewhere on the board
!LO_RST!: SLOT4.A27; also elsewhere on the board
+3V3: INTERNAL_EXP.6, INTERNAL_EXP.8, SLOT4.A1; also elsewhere on the board
+5V: C81.1, INTERNAL_EXP.2, INTERNAL_EXP.4, SLOT4.B1, SLOT4.B2, SLOT4.B3; also elsewhere on the board
GND: C81.2, INTERNAL_EXP.30, INTERNAL_EXP.32, LD_4P.C, R65.1, SLOT4.A2, SLOT4.A3, SLOT4.A10, SLOT4.B32; also elsewhere on the board
I2C0_SCL: INTERNAL_EXP.26; also elsewhere on the board
I2C0_SDA: INTERNAL_EXP.24; also elsewhere on the board
LO_A0: SLOT4.A11; also elsewhere on the board
LO_A1: SLOT4.A12; also elsewhere on the board
LO_A2: SLOT4.A13; also elsewhere on the board
LO_A3: SLOT4.A14; also elsewhere on the board
LO_A4: SLOT4.A15; also elsewhere on the board
LO_A5: SLOT4.A16; also elsewhere on the board
LO_A6: SLOT4.A17; also elsewhere on the board
LO_A7: SLOT4.A18; also elsewhere on the board
LO_A8: SLOT4.A19; also elsewhere on the board
LO_A9: SLOT4.A20; also elsewhere on the board
LO_A10: SLOT4.A21; also elsewhere on the board
LO_A11: SLOT4.A22; also elsewhere on the board
LO_A12: SLOT4.A23; also elsewhere on the board
LO_A13: SLOT4.A24; also elsewhere on the board
LO_A14: SLOT4.A25; also elsewhere on the board
LO_A15: SLOT4.A26; also elsewhere on the board
LO_CLK: SLOT4.A28; also elsewhere on the board
LO_D0: SLOT4.B5; also elsewhere on the board
LO_D1: SLOT4.B6; also elsewhere on the board
LO_D2: SLOT4.B7; also elsewhere on the board
LO_D3: SLOT4.B8; also elsewhere on the board
LO_D4: SLOT4.B9; also elsewhere on the board
LO_D5: SLOT4.B10; also elsewhere on the board
LO_D6: SLOT4.B11; also elsewhere on the board
LO_D7: SLOT4.B12; also elsewhere on the board
LO_R/!W!: SLOT4.B15; also elsewhere on the board
LO_RD4: SLOT4.A31; also elsewhere on the board
LO_RD5: SLOT4.A32; also elsewhere on the board
unnamed: LD_4P.A, R107.2
S4_PRESENT: R65.2, R107.1, SLOT4.B4; also elsewhere on the board
S5_PRESENT: INTERNAL_EXP.20; also elsewhere on the board
SPI1_CLK: SLOT4.A4; also elsewhere on the board
SPI1_MISO: SLOT4.A5; also elsewhere on the board
SPI1_MOSI: SLOT4.A6; also elsewhere on the board
SPI2_CLK: INTERNAL_EXP.10; also elsewhere on the board
SPI2_CS1: INTERNAL_EXP.12; also elsewhere on the board
SPI2_IRQ: INTERNAL_EXP.16; also elsewhere on the board
SPI2_MISO: INTERNAL_EXP.14; also elsewhere on the board
SPI2_MOSI: INTERNAL_EXP.18; also elsewhere on the board
SPI_IRQ4: SLOT4.A8; also elsewhere on the board
SPI_IRQ5: INTERNAL_EXP.22; also elsewhere on the board
SPI_SS4: SLOT4.A7; also elsewhere on the board
SPI_SS5: INTERNAL_EXP.28; also elsewhere on the board
ZBUS0: INTERNAL_EXP.31, SLOT4.B16; also elsewhere on the board
ZBUS1: INTERNAL_EXP.29, SLOT4.B17; also elsewhere on the board
ZBUS2: INTERNAL_EXP.27, SLOT4.B18; also elsewhere on the board
ZBUS3: INTERNAL_EXP.25, SLOT4.B19; also elsewhere on the board
ZBUS4: INTERNAL_EXP.23, SLOT4.B20; also elsewhere on the board
ZBUS5: INTERNAL_EXP.21, SLOT4.B21; also elsewhere on the board
ZBUS6: INTERNAL_EXP.19, SLOT4.B22; also elsewhere on the board
ZBUS7: INTERNAL_EXP.17, SLOT4.B23; also elsewhere on the board
ZBUS8: INTERNAL_EXP.15, SLOT4.B24; also elsewhere on the board
ZBUS9: INTERNAL_EXP.13, SLOT4.B25; also elsewhere on the board
ZBUS10: INTERNAL_EXP.11, SLOT4.B26; also elsewhere on the board
ZBUS11: INTERNAL_EXP.9, SLOT4.B27; also elsewhere on the board
ZBUS12: INTERNAL_EXP.7, SLOT4.B28; also elsewhere on the board
ZBUS13: INTERNAL_EXP.5, SLOT4.B29; also elsewhere on the board
ZBUS14: INTERNAL_EXP.3, SLOT4.B30; also elsewhere on the board
ZBUS15: INTERNAL_EXP.1, SLOT4.B31; also elsewhere on the board

Notes on the sheet:
Slots 4 & X
B1,2,3 B5,6,7 B4 A1,2,3
+5V Slot 3.3v Card-present Slot ID
Orange LED
Parts Verified

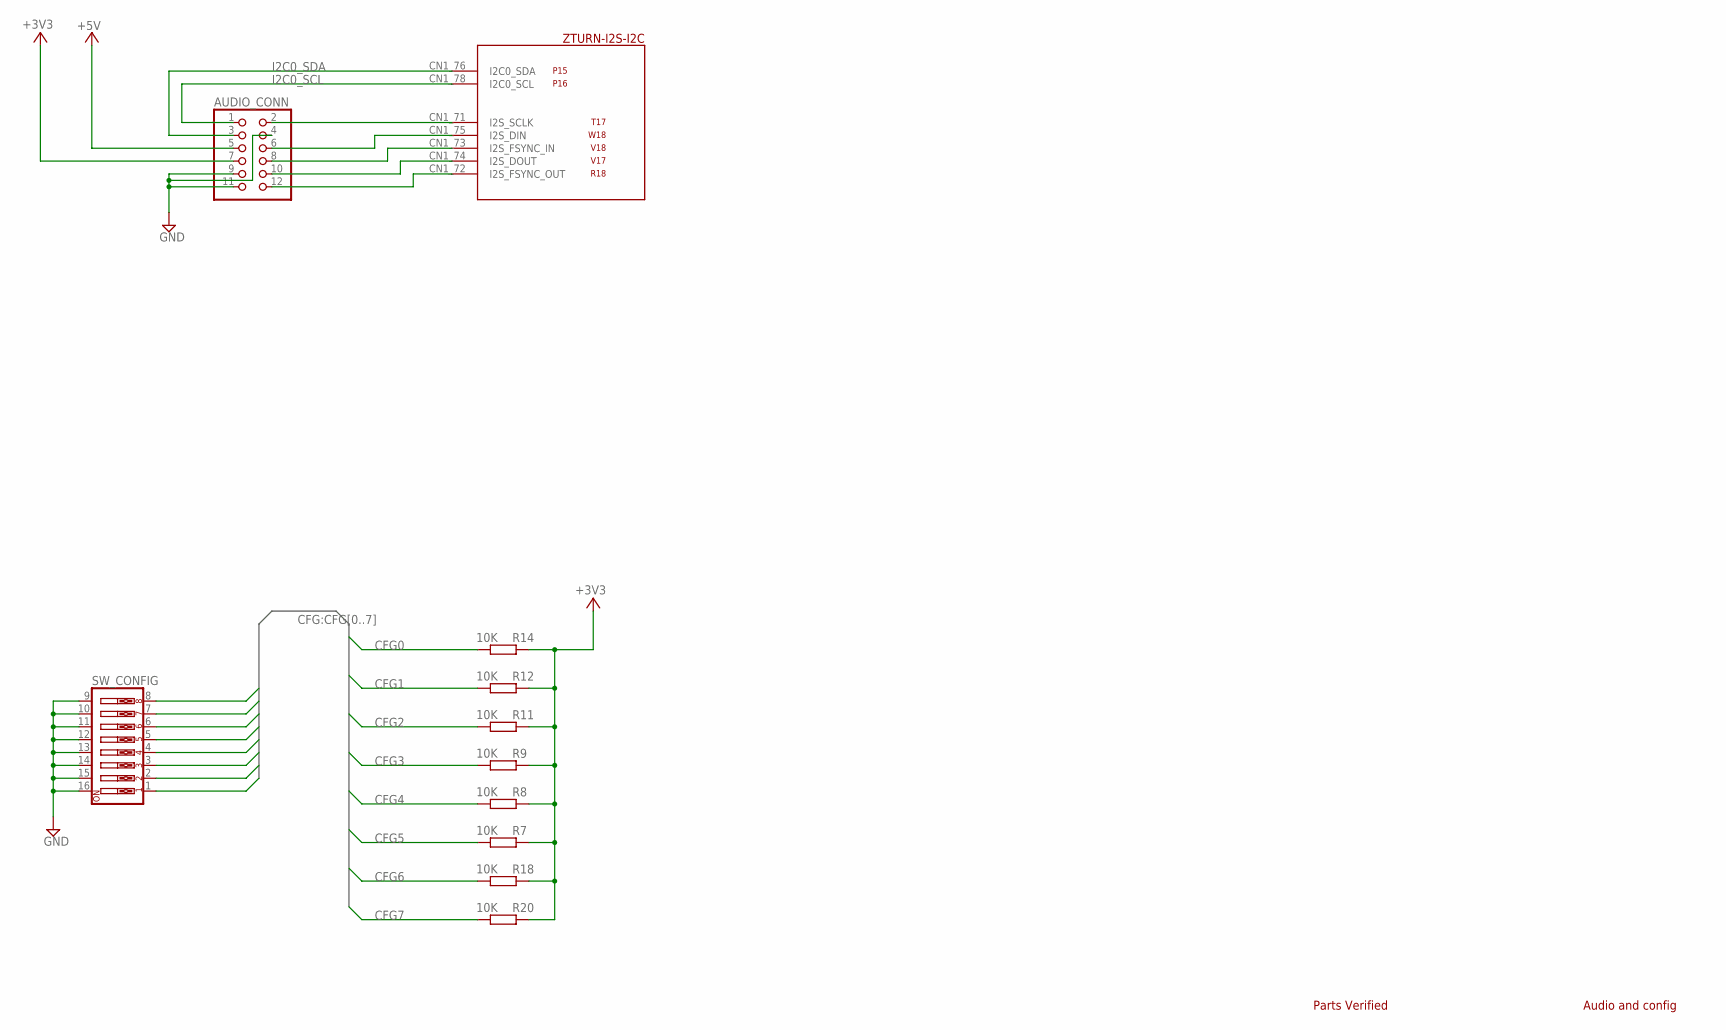
[picture p122: schematic xio5.sch, sheet 9, Audio and Config]

Parts:
AUDIO_CONN: PINHD-2X06_2.00; 2X06M
R7, R8, R9, R11, R12, R14, R18, R20: 10K; R0201
SW_CONFIG: SW_DIP-8; DIPSWITCH-08
ZTURN: ZTURN

Connections:
+3V3: AUDIO_CONN.7, R7.2, R8.2, R9.2, R11.2, R12.2, R14.2, R18.2, R20.2; also elsewhere on the board
+5V: AUDIO_CONN.5; also elsewhere on the board
CFG0: R14.1, SW_CONFIG.1; also elsewhere on the board
CFG1: R12.1, SW_CONFIG.2; also elsewhere on the board
CFG2: R11.1, SW_CONFIG.3; also elsewhere on the board
CFG3: R9.1, SW_CONFIG.4; also elsewhere on the board
CFG4: R8.1, SW_CONFIG.5; also elsewhere on the board
CFG5: R7.1, SW_CONFIG.6; also elsewhere on the board
CFG6: R18.1, SW_CONFIG.7; also elsewhere on the board
CFG7: R20.1, SW_CONFIG.8; also elsewhere on the board
GND: AUDIO_CONN.4, AUDIO_CONN.9, AUDIO_CONN.11, SW_CONFIG.9, SW_CONFIG.10, SW_CONFIG.11, SW_CONFIG.12, SW_CONFIG.13, SW_CONFIG.14, SW_CONFIG.15, SW_CONFIG.16; also elsewhere on the board
I2C0_SCL: AUDIO_CONN.1, ZTURN.CN1_78 (I2C0_SCL); also elsewhere on the board
I2C0_SDA: AUDIO_CONN.3, ZTURN.CN1_76 (I2C0_SDA); also elsewhere on the board
unnamed: AUDIO_CONN.2, ZTURN.CN1_71 (I2S_SCLK)
unnamed: AUDIO_CONN.12, ZTURN.CN1_72 (I2S_FSYNC_OUT)
unnamed: AUDIO_CONN.10, ZTURN.CN1_74 (I2S_DOUT)
unnamed: AUDIO_CONN.8, ZTURN.CN1_73 (I2S_FSYNC_IN)
unnamed: AUDIO_CONN.6, ZTURN.CN1_75 (I2S_DIN)

Notes on the sheet:
Audio and config
Parts Verified

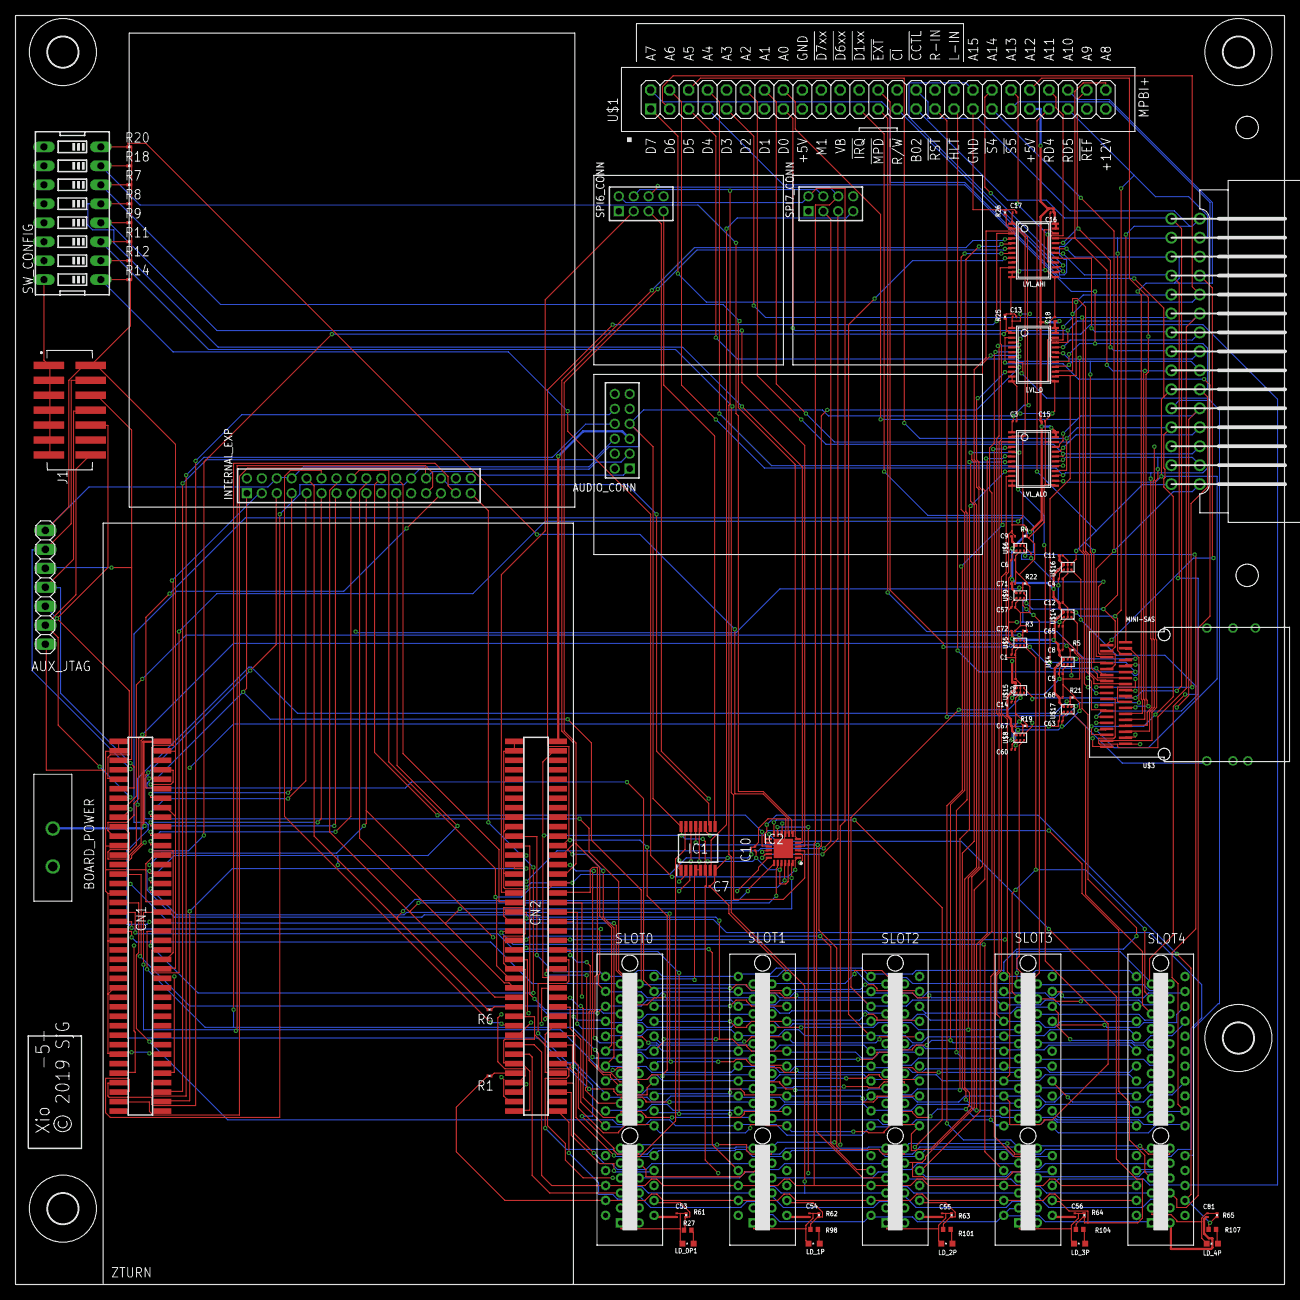
[picture p123: board xio5.brd from above]

Board: 6 copper layers, 170.0 x 170.0 mm, 99 parts (0 on the bottom side), 161 nets.
