ThrudTheBarbarian/pbxl/boards/xio4_mez/xio4_mez.brd

## EAGLE design boards/xio4_mez/xio4_mez.brd (2019-09-06)

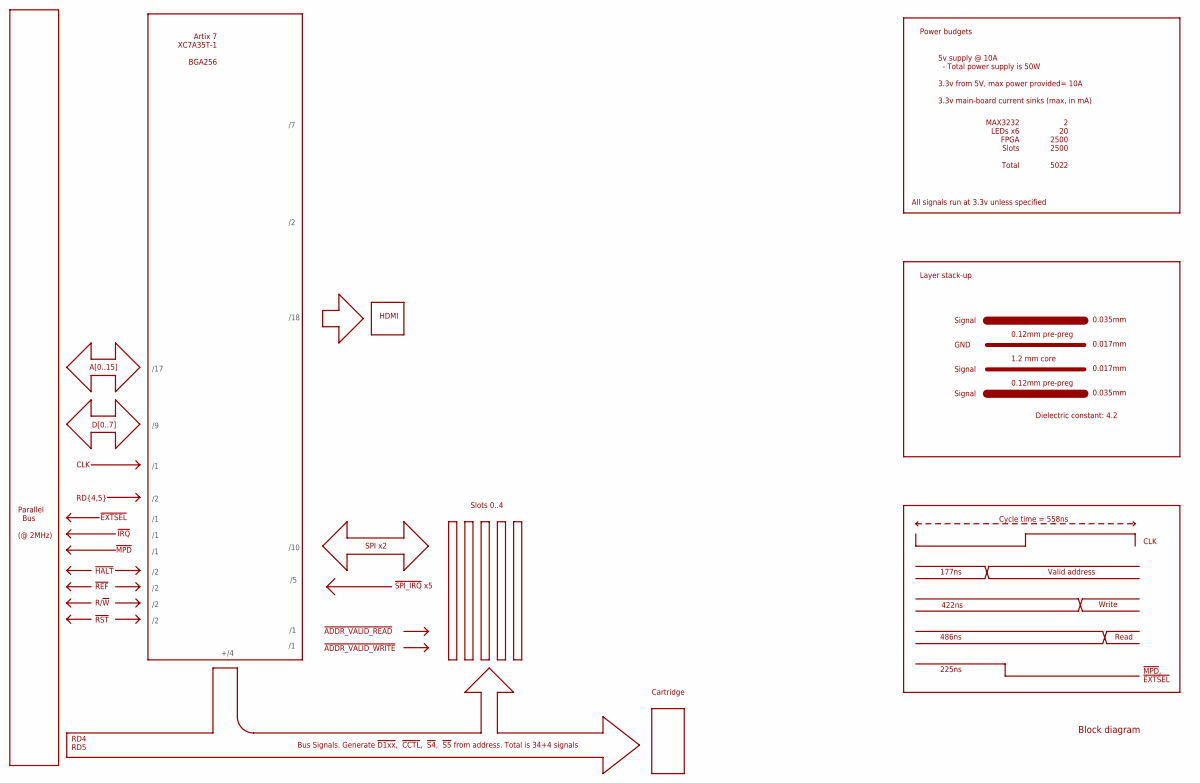
[picture p124: schematic xio4_mez.sch, sheet 1, Block diagram]

Notes on the sheet:
Slots 0..4
Bus Signals. Generate !D1xx!, !CCTL!, !S4!, !S5! from address. Total is 34+4 signals
5v supply @ 10A - Total power supply is 50W 3.3v from 5V, max power provided= 10A 3.3v main-board current sinks (max, in mA)
MAX3232 LEDs x6 FPGA Slots Total
2 20 2500 2500 5022
1.2 mm core
0.12mm pre-preg
0.035mm
0.017mm
Layer stack-up
GND
Dielectric constant: 4.2
Cycle time = 558ns
Valid address
Write
Read
177ns
422ns
486ns
225ns
!MPD!, !EXTSEL!
CLK
Power budgets
Artix 7 XC7A35T-1 BGA256
HDMI
Signal
Block diagram
Parallel Bus (@ 2MHz)
A[0..15]
D[0..7]
RD{4,5}
!MPD!
!IRQ!
!EXTSEL!
!HALT!
!REF!
R/!W!
/17
!ADDR_VALID_READ!
!ADDR_VALID_WRITE!
+/4
Cartridge
All signals run at 3.3v unless specified
!RST!
SPI x2
!SPI_IRQ! x5
/10
RD4 RD5
/18

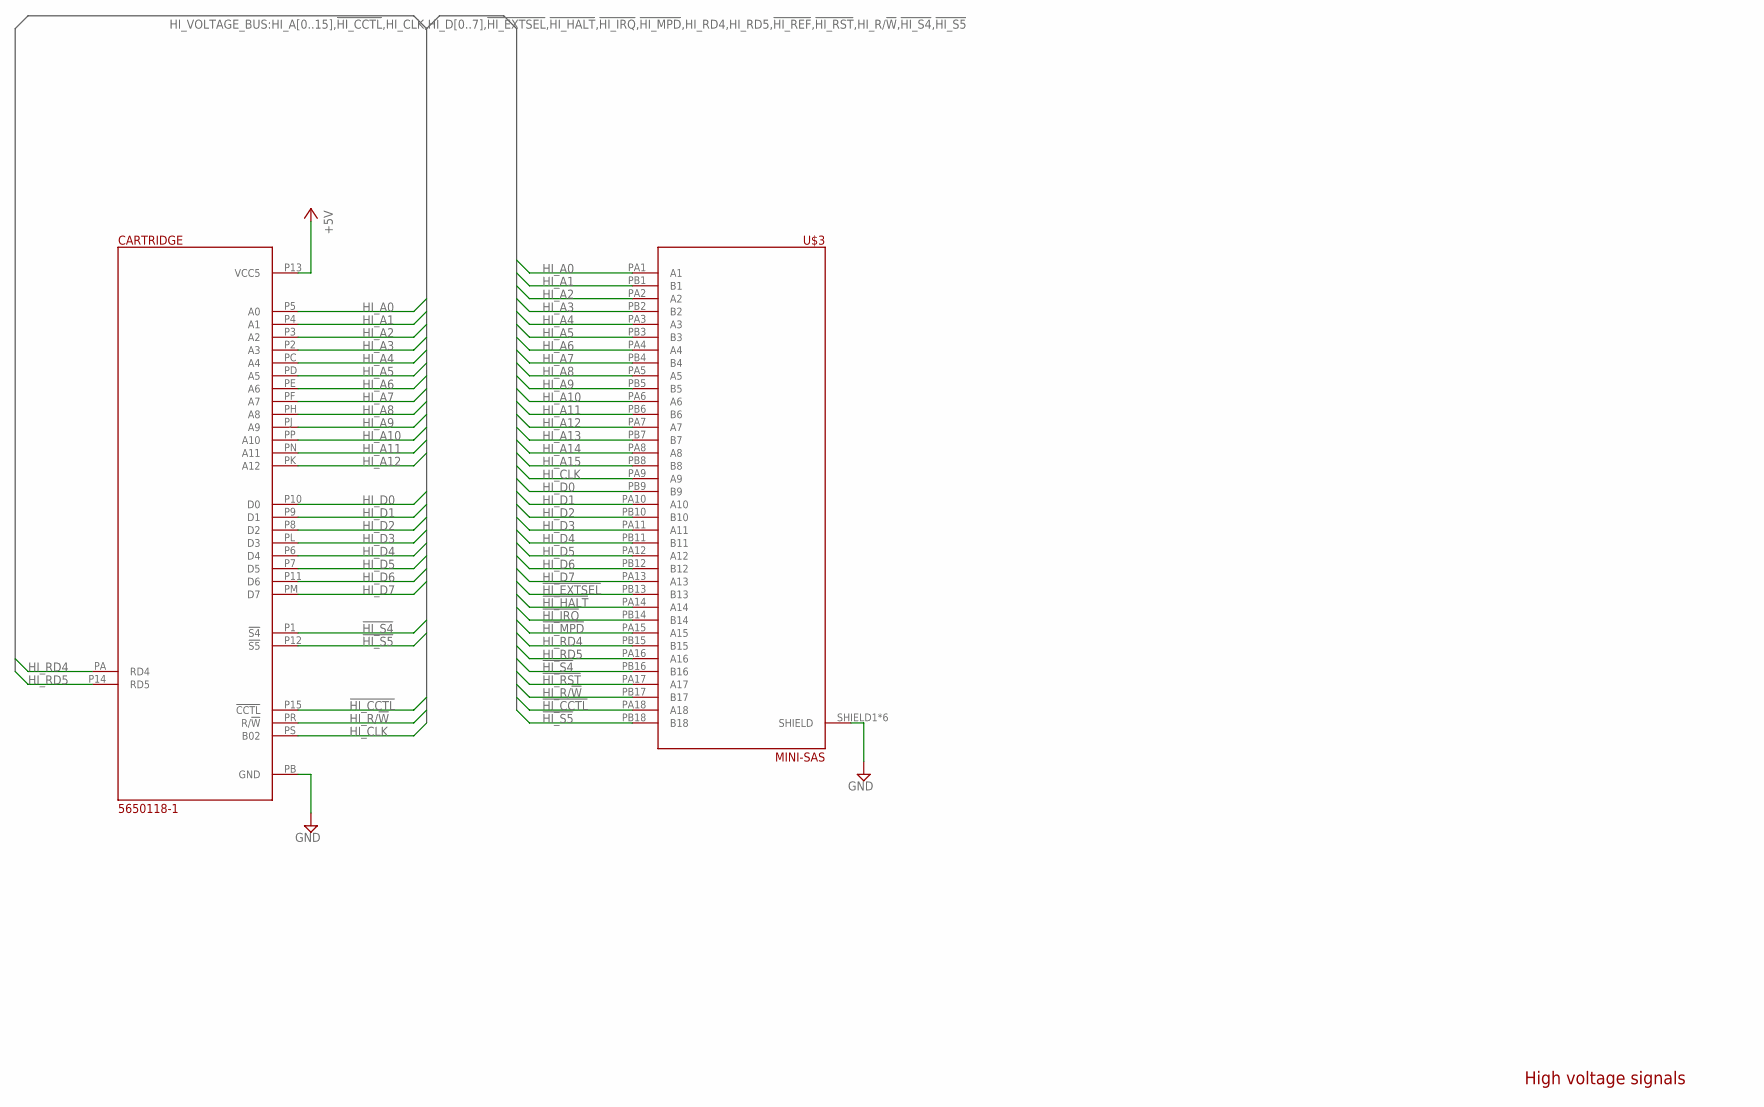
[picture p125: schematic xio4_mez.sch, sheet 2, High voltage signalling]

Parts:
CARTRIDGE: 5650118-1; A8_CART
U$3: MINI-SAS

Connections:
!HI_CCTL!: CARTRIDGE.P15 (!CCTL!), U$3.PA18 (A18)
!HI_EXTSEL!: U$3.PB13 (B13); also elsewhere on the board
!HI_HALT!: U$3.PA14 (A14); also elsewhere on the board
!HI_IRQ!: U$3.PB14 (B14); also elsewhere on the board
!HI_MPD!: U$3.PA15 (A15); also elsewhere on the board
!HI_RST!: U$3.PA17 (A17); also elsewhere on the board
!HI_S4!: CARTRIDGE.P1 (!S4!), U$3.PB16 (B16)
!HI_S5!: CARTRIDGE.P12 (!S5!), U$3.PB18 (B18)
+5V: CARTRIDGE.P13 (VCC5); also elsewhere on the board
GND: CARTRIDGE.PB (GND), U$3.SHIELD1 (SHIELD), U$3.SHIELD2 (SHIELD), U$3.SHIELD3 (SHIELD), U$3.SHIELD4 (SHIELD), U$3.SHIELD5 (SHIELD), U$3.SHIELD6 (SHIELD); also elsewhere on the board
HI_A0: CARTRIDGE.P5 (A0), U$3.PA1 (A1); also elsewhere on the board
HI_A1: CARTRIDGE.P4 (A1), U$3.PB1 (B1); also elsewhere on the board
HI_A2: CARTRIDGE.P3 (A2), U$3.PA2 (A2); also elsewhere on the board
HI_A3: CARTRIDGE.P2 (A3), U$3.PB2 (B2); also elsewhere on the board
HI_A4: CARTRIDGE.PC (A4), U$3.PA3 (A3); also elsewhere on the board
HI_A5: CARTRIDGE.PD (A5), U$3.PB3 (B3); also elsewhere on the board
HI_A6: CARTRIDGE.PE (A6), U$3.PA4 (A4); also elsewhere on the board
HI_A7: CARTRIDGE.PF (A7), U$3.PB4 (B4); also elsewhere on the board
HI_A8: CARTRIDGE.PH (A8), U$3.PA5 (A5); also elsewhere on the board
HI_A9: CARTRIDGE.PJ (A9), U$3.PB5 (B5); also elsewhere on the board
HI_A10: CARTRIDGE.PP (A10), U$3.PA6 (A6); also elsewhere on the board
HI_A11: CARTRIDGE.PN (A11), U$3.PB6 (B6); also elsewhere on the board
HI_A12: CARTRIDGE.PK (A12), U$3.PA7 (A7); also elsewhere on the board
HI_A13: U$3.PB7 (B7); also elsewhere on the board
HI_A14: U$3.PA8 (A8); also elsewhere on the board
HI_A15: U$3.PB8 (B8); also elsewhere on the board
HI_CLK: CARTRIDGE.PS (B02), U$3.PA9 (A9); also elsewhere on the board
HI_D0: CARTRIDGE.P10 (D0), U$3.PB9 (B9); also elsewhere on the board
HI_D1: CARTRIDGE.P9 (D1), U$3.PA10 (A10); also elsewhere on the board
HI_D2: CARTRIDGE.P8 (D2), U$3.PB10 (B10); also elsewhere on the board
HI_D3: CARTRIDGE.PL (D3), U$3.PA11 (A11); also elsewhere on the board
HI_D4: CARTRIDGE.P6 (D4), U$3.PB11 (B11); also elsewhere on the board
HI_D5: CARTRIDGE.P7 (D5), U$3.PA12 (A12); also elsewhere on the board
HI_D6: CARTRIDGE.P11 (D6), U$3.PB12 (B12); also elsewhere on the board
HI_D7: CARTRIDGE.PM (D7), U$3.PA13 (A13); also elsewhere on the board
HI_R/!W!: CARTRIDGE.PR (R/!W!), U$3.PB17 (B17); also elsewhere on the board
HI_RD4: CARTRIDGE.PA (RD4), U$3.PB15 (B15); also elsewhere on the board
HI_RD5: CARTRIDGE.P14 (RD5), U$3.PA16 (A16); also elsewhere on the board

Notes on the sheet:
High voltage signals
