ThrudTheBarbarian/pbxl/boards/xio4_mez/xio4_mez.brd

## EAGLE design boards/xio4_mez/xio4_mez.brd (continued)

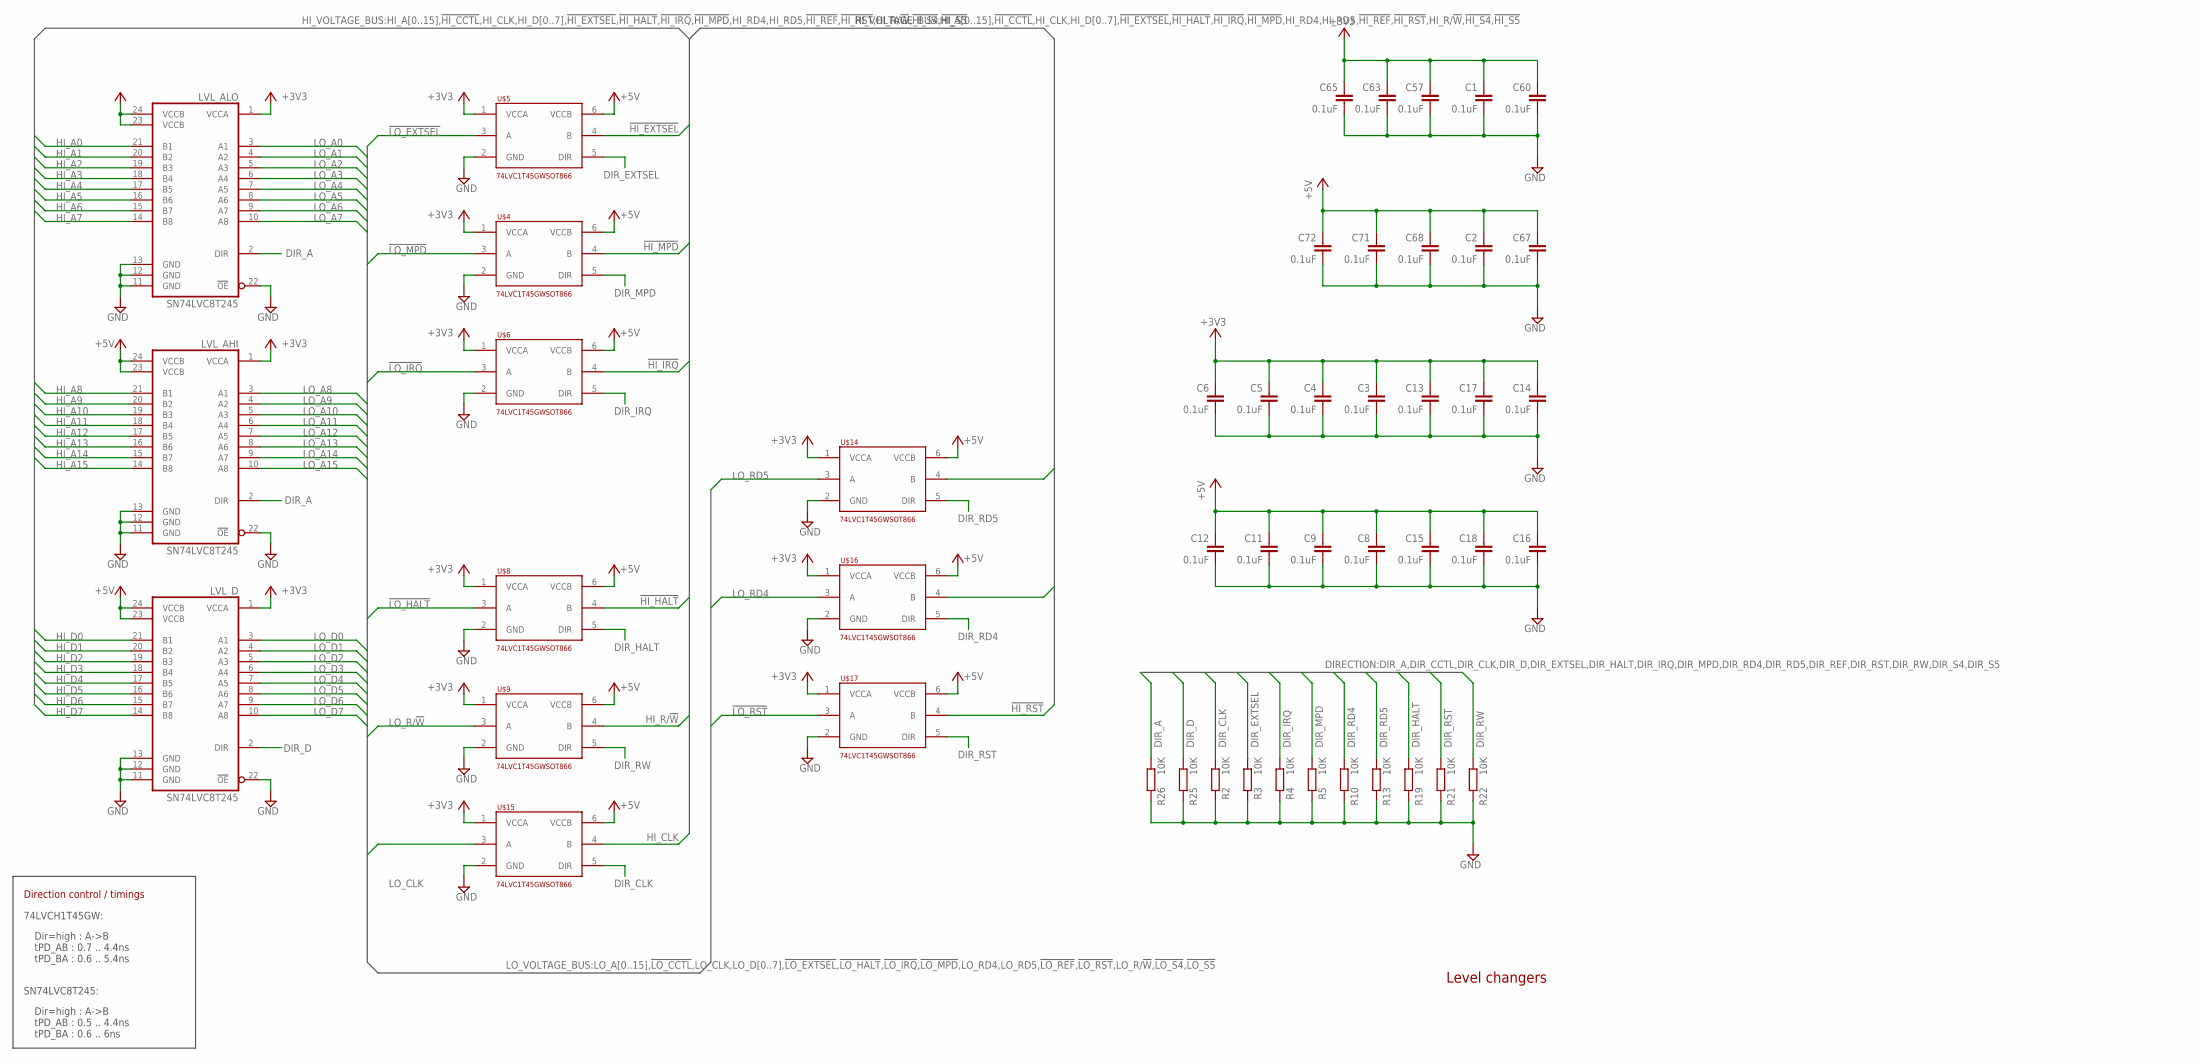
[picture p126: schematic xio4_mez.sch, sheet 3, Level changers]

Parts:
C1, C2, C3, C4, C5, C6, C8, C9, C11, C12, C13, C14, C15, C16, C17, C18, C57, C60, C63, C65, C67, C68, C71, C72: 0.1uF; C0201
LVL_AHI: SN74LVC8T245; TSSOP24
LVL_ALO: SN74LVC8T245; TSSOP24
LVL_D: SN74LVC8T245; TSSOP24
R2, R3, R4, R5, R10, R13, R19, R21, R22, R25, R26: 10K; R0201
U$4, U$5, U$6, U$8, U$9, U$14, U$15, U$16, U$17: 74LVC1T45GWSOT866; SOT886

Connections:
!HI_EXTSEL!: U$5.4 (B); also elsewhere on the board
!HI_HALT!: U$8.4 (B); also elsewhere on the board
!HI_IRQ!: U$6.4 (B); also elsewhere on the board
!HI_MPD!: U$4.4 (B); also elsewhere on the board
!HI_RST!: U$17.4 (B); also elsewhere on the board
!LO_EXTSEL!: U$5.3 (A); also elsewhere on the board
!LO_HALT!: U$8.3 (A); also elsewhere on the board
!LO_IRQ!: U$6.3 (A); also elsewhere on the board
!LO_MPD!: U$4.3 (A); also elsewhere on the board
!LO_RST!: U$17.3 (A); also elsewhere on the board
+3V3: C1.1, C3.1, C4.1, C5.1, C6.1, C13.1, C14.1, C17.1, C57.1, C60.1, C63.1, C65.1, LVL_AHI.1 (VCCA), LVL_ALO.1 (VCCA), LVL_D.1 (VCCA), U$4.1 (VCCA), U$5.1 (VCCA), U$6.1 (VCCA), U$8.1 (VCCA), U$9.1 (VCCA), U$14.1 (VCCA), U$15.1 (VCCA), U$16.1 (VCCA), U$17.1 (VCCA)
+5V: C2.1, C8.1, C9.1, C11.1, C12.1, C15.1, C16.1, C18.1, C67.1, C68.1, C71.1, C72.1, LVL_AHI.23 (VCCB), LVL_AHI.24 (VCCB), LVL_ALO.23 (VCCB), LVL_ALO.24 (VCCB), LVL_D.23 (VCCB), LVL_D.24 (VCCB), U$4.6 (VCCB), U$5.6 (VCCB), U$6.6 (VCCB), U$8.6 (VCCB), U$9.6 (VCCB), U$14.6 (VCCB), U$15.6 (VCCB), U$16.6 (VCCB), U$17.6 (VCCB); also elsewhere on the board
DIR_A: LVL_AHI.2 (DIR), LVL_ALO.2 (DIR), R26.1; also elsewhere on the board
DIR_CLK: R2.1, U$15.5 (DIR); also elsewhere on the board
DIR_D: LVL_D.2 (DIR), R25.1; also elsewhere on the board
DIR_EXTSEL: R3.1, U$5.5 (DIR); also elsewhere on the board
DIR_HALT: R19.1, U$8.5 (DIR); also elsewhere on the board
DIR_IRQ: R4.1, U$6.5 (DIR); also elsewhere on the board
DIR_MPD: R5.1, U$4.5 (DIR); also elsewhere on the board
DIR_RD4: R10.1, U$16.5 (DIR); also elsewhere on the board
DIR_RD5: R13.1, U$14.5 (DIR); also elsewhere on the board
DIR_RST: R21.1, U$17.5 (DIR); also elsewhere on the board
DIR_RW: R22.1, U$9.5 (DIR); also elsewhere on the board
GND: C1.2, C2.2, C3.2, C4.2, C5.2, C6.2, C8.2, C9.2, C11.2, C12.2, C13.2, C14.2, C15.2, C16.2, C17.2, C18.2, C57.2, C60.2, C63.2, C65.2, C67.2, C68.2, C71.2, C72.2, LVL_AHI.11 (GND), LVL_AHI.12 (GND), LVL_AHI.13 (GND), LVL_AHI.22 (!OE!), LVL_ALO.11 (GND), LVL_ALO.12 (GND), LVL_ALO.13 (GND), LVL_ALO.22 (!OE!), LVL_D.11 (GND), LVL_D.12 (GND), LVL_D.13 (GND), LVL_D.22 (!OE!), R2.2, R3.2, R4.2, R5.2, R10.2, R13.2, R19.2, R21.2, R22.2, R25.2, R26.2, U$4.2 (GND), U$5.2 (GND), U$6.2 (GND), U$8.2 (GND), U$9.2 (GND), U$14.2 (GND), U$15.2 (GND), U$16.2 (GND), U$17.2 (GND); also elsewhere on the board
HI_A0: LVL_ALO.21 (B1); also elsewhere on the board
HI_A1: LVL_ALO.20 (B2); also elsewhere on the board
HI_A2: LVL_ALO.19 (B3); also elsewhere on the board
HI_A3: LVL_ALO.18 (B4); also elsewhere on the board
HI_A4: LVL_ALO.17 (B5); also elsewhere on the board
HI_A5: LVL_ALO.16 (B6); also elsewhere on the board
HI_A6: LVL_ALO.15 (B7); also elsewhere on the board
HI_A7: LVL_ALO.14 (B8); also elsewhere on the board
HI_A8: LVL_AHI.21 (B1); also elsewhere on the board
HI_A9: LVL_AHI.20 (B2); also elsewhere on the board
HI_A10: LVL_AHI.19 (B3); also elsewhere on the board
HI_A11: LVL_AHI.18 (B4); also elsewhere on the board
HI_A12: LVL_AHI.17 (B5); also elsewhere on the board
HI_A13: LVL_AHI.16 (B6); also elsewhere on the board
HI_A14: LVL_AHI.15 (B7); also elsewhere on the board
HI_A15: LVL_AHI.14 (B8); also elsewhere on the board
HI_CLK: U$15.4 (B); also elsewhere on the board
HI_D0: LVL_D.21 (B1); also elsewhere on the board
HI_D1: LVL_D.20 (B2); also elsewhere on the board
HI_D2: LVL_D.19 (B3); also elsewhere on the board
HI_D3: LVL_D.18 (B4); also elsewhere on the board
HI_D4: LVL_D.17 (B5); also elsewhere on the board
HI_D5: LVL_D.16 (B6); also elsewhere on the board
HI_D6: LVL_D.15 (B7); also elsewhere on the board
HI_D7: LVL_D.14 (B8); also elsewhere on the board
HI_R/!W!: U$9.4 (B); also elsewhere on the board
HI_RD4: U$16.4 (B); also elsewhere on the board
HI_RD5: U$14.4 (B); also elsewhere on the board
LO_A0: LVL_ALO.3 (A1); also elsewhere on the board
LO_A1: LVL_ALO.4 (A2); also elsewhere on the board
LO_A2: LVL_ALO.5 (A3); also elsewhere on the board
LO_A3: LVL_ALO.6 (A4); also elsewhere on the board
LO_A4: LVL_ALO.7 (A5); also elsewhere on the board
LO_A5: LVL_ALO.8 (A6); also elsewhere on the board
LO_A6: LVL_ALO.9 (A7); also elsewhere on the board
LO_A7: LVL_ALO.10 (A8); also elsewhere on the board
LO_A8: LVL_AHI.3 (A1); also elsewhere on the board
LO_A9: LVL_AHI.4 (A2); also elsewhere on the board
LO_A10: LVL_AHI.5 (A3); also elsewhere on the board
LO_A11: LVL_AHI.6 (A4); also elsewhere on the board
LO_A12: LVL_AHI.7 (A5); also elsewhere on the board
LO_A13: LVL_AHI.8 (A6); also elsewhere on the board
LO_A14: LVL_AHI.9 (A7); also elsewhere on the board
LO_A15: LVL_AHI.10 (A8); also elsewhere on the board
LO_CLK: U$15.3 (A); also elsewhere on the board
LO_D0: LVL_D.3 (A1); also elsewhere on the board
LO_D1: LVL_D.4 (A2); also elsewhere on the board
LO_D2: LVL_D.5 (A3); also elsewhere on the board
LO_D3: LVL_D.6 (A4); also elsewhere on the board
LO_D4: LVL_D.7 (A5); also elsewhere on the board
LO_D5: LVL_D.8 (A6); also elsewhere on the board
LO_D6: LVL_D.9 (A7); also elsewhere on the board
LO_D7: LVL_D.10 (A8); also elsewhere on the board
LO_R/!W!: U$9.3 (A); also elsewhere on the board
LO_RD4: U$16.3 (A); also elsewhere on the board
LO_RD5: U$14.3 (A); also elsewhere on the board

Notes on the sheet:
Dir=high : A->B tPD_AB : 0.7 .. 4.4ns tPD_BA : 0.6 .. 5.4ns
74LVCH1T45GW:
SN74LVC8T245:
Dir=high : A->B tPD_AB : 0.5 .. 4.4ns tPD_BA : 0.6 .. 6ns
Direction control / timings
Level changers

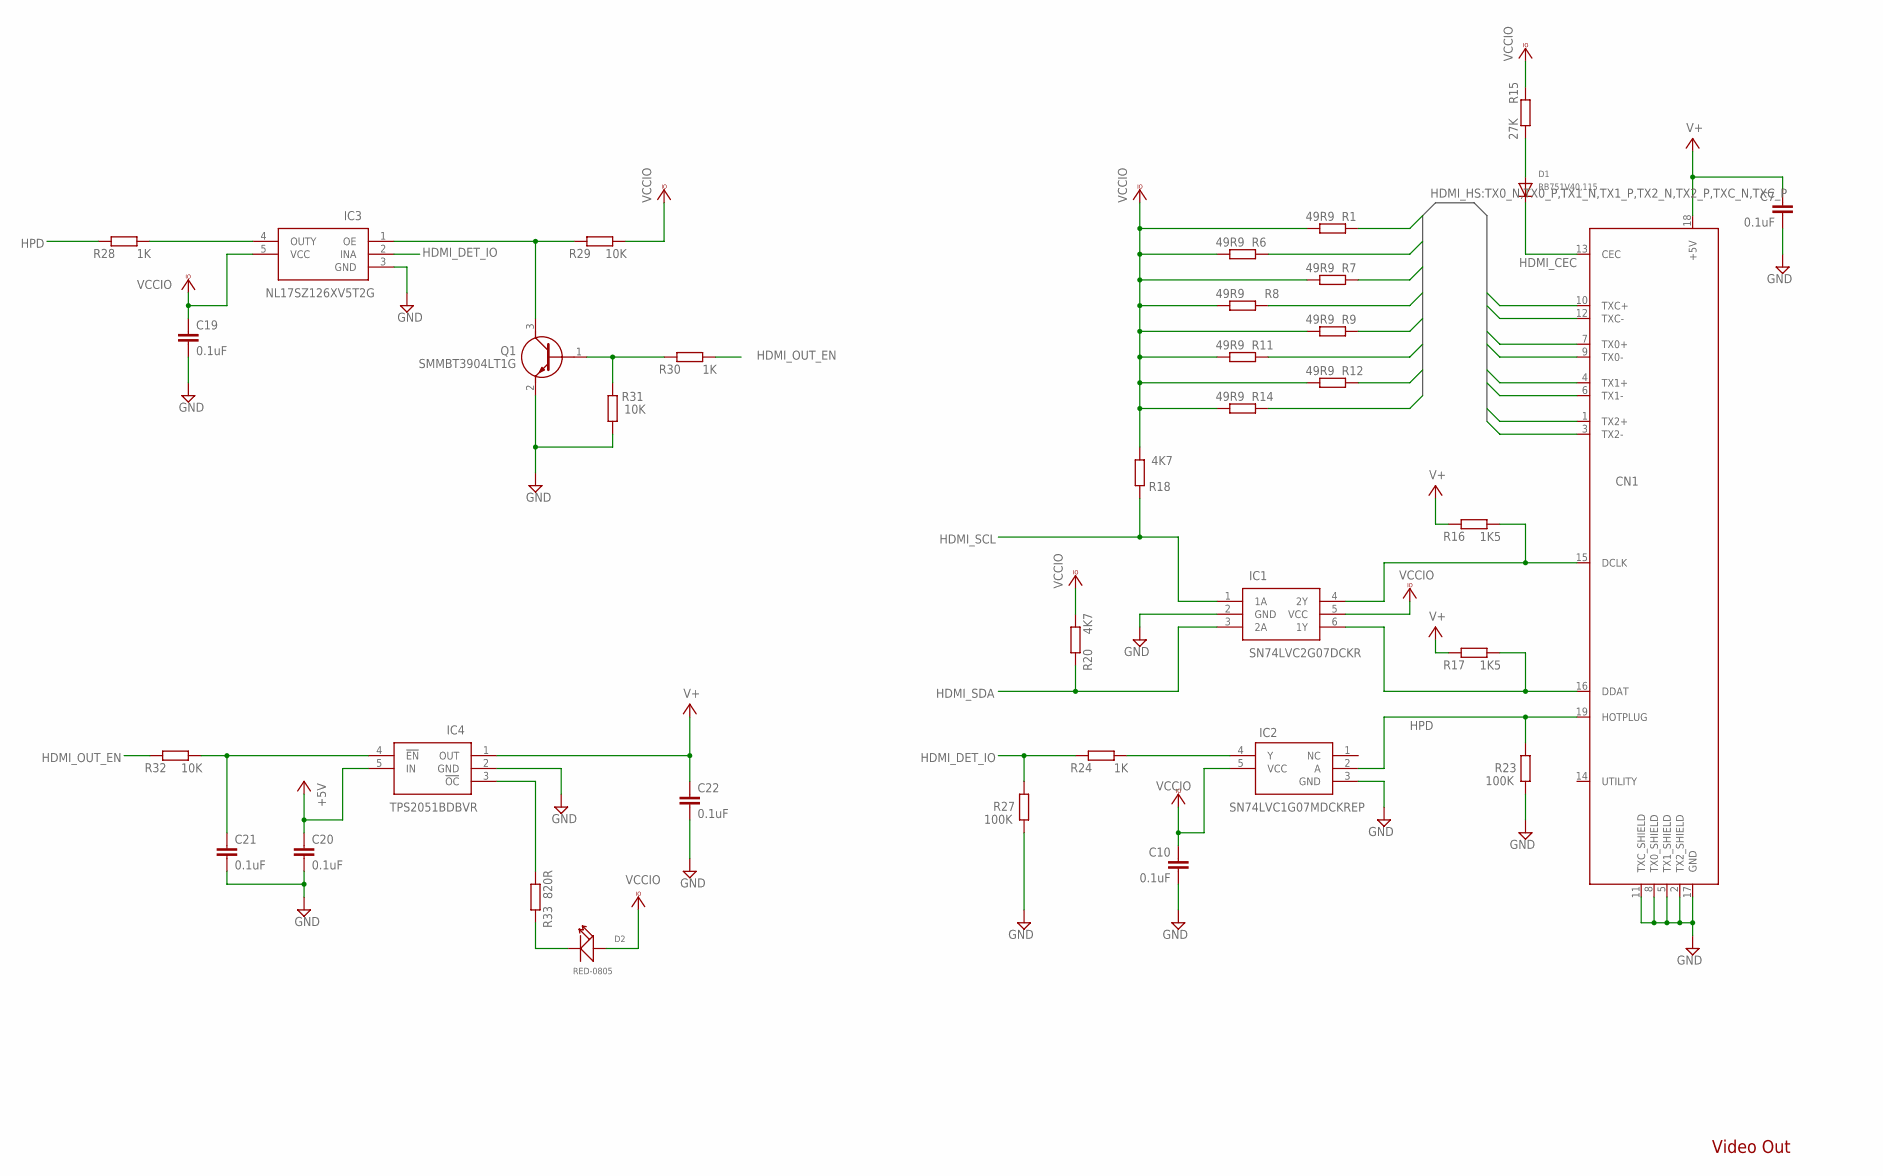
[picture p127: schematic xio4_mez.sch, sheet 4, Video out]

Parts:
C7, C10, C19, C20, C21, C22: 0.1uF; C0201
CN1: HDMI_MOLEX_47151-0001
D1: RB751V40,115; SOD-323
D2: RED-0805; LED-0805
IC1: SN74LVC2G07DCKR; SOT65P210X110X6N
IC2: SN74LVC1G07MDCKREP; SOT65P210X110-5N
IC3: NL17SZ126XV5T2G; SOTFL50P160X60-5N
IC4: TPS2051BDBVR; SOT95P280X145-5N
Q1: SMMBT3904LT1G; SOT96P237X111-3N
R1, R6, R7, R8, R9, R11, R12, R14: 49R9; R0201
R15: 27K; R0201
R16, R17: 1K5; R0201
R18, R20: 4K7; R0201
R23, R27: 100K; R0201
R24, R28, R30: 1K; R0201
R29, R31, R32: 10K; R0201
R33: 820R; R0201

Connections:
+5V: C20.1, IC4.5 (IN); also elsewhere on the board
GND: C7.2, C10.2, C19.2, C20.2, C21.2, C22.2, CN1.2 (TX2_SHIELD), CN1.5 (TX1_SHIELD), CN1.8 (TX0_SHIELD), CN1.11 (TXC_SHIELD), CN1.17 (GND), CN1.P$1 (GND), CN1.P$2 (GND), CN1.P$3 (GND), CN1.P$4 (GND), IC1.2 (GND), IC2.3 (GND), IC3.3 (GND), IC4.2 (GND), Q1.2 (E), R23.1, R27.1, R31.2; also elsewhere on the board
HDMI_CEC: CN1.13 (CEC), D1.C
HDMI_DET_IO: IC3.2 (INA), R24.2, R27.2; also elsewhere on the board
HDMI_OUT_EN: R30.1, R32.2; also elsewhere on the board
HDMI_SCL: IC1.1 (1A), R18.2; also elsewhere on the board
HDMI_SDA: IC1.3 (2A), R20.2; also elsewhere on the board
HPD: CN1.19 (HOTPLUG), IC2.2 (A), R23.2, R28.2
unnamed: CN1.16 (DDAT), IC1.6 (1Y), R17.1
unnamed: D1.A, R15.1
unnamed: CN1.15 (DCLK), IC1.4 (2Y), R16.1
unnamed: IC3.1 (OE), Q1.3 (C), R29.2
unnamed: IC2.4 (Y), R24.1
unnamed: IC3.4 (OUTY), R28.1
unnamed: Q1.1 (B), R30.2, R31.1
unnamed: C21.1, IC4.4 (!EN), R32.1
unnamed: IC4.3 (!OC), R33.1
unnamed: D2.-, R33.2
TX0_N: CN1.9 (TX0-), R1.2; also elsewhere on the board
TX0_P: CN1.7 (TX0+), R6.2; also elsewhere on the board
TX1_N: CN1.6 (TX1-), R7.2; also elsewhere on the board
TX1_P: CN1.4 (TX1+), R8.2; also elsewhere on the board
TX2_N: CN1.3 (TX2-), R9.2; also elsewhere on the board
TX2_P: CN1.1 (TX2+), R11.2; also elsewhere on the board
TXC_N: CN1.12 (TXC-), R12.2; also elsewhere on the board
TXC_P: CN1.10 (TXC+), R14.2; also elsewhere on the board
V+: C7.1, C22.1, CN1.18 (+5V), IC4.1 (OUT), R16.2, R17.2
VCCIO: C10.1, C19.1, D2.+, IC1.5 (VCC), IC2.5 (VCC), IC3.5 (VCC), R1.1, R6.1, R7.1, R8.1, R9.1, R11.1, R12.1, R14.1, R15.2, R18.1, R20.1, R29.1; also elsewhere on the board

Notes on the sheet:
Video Out

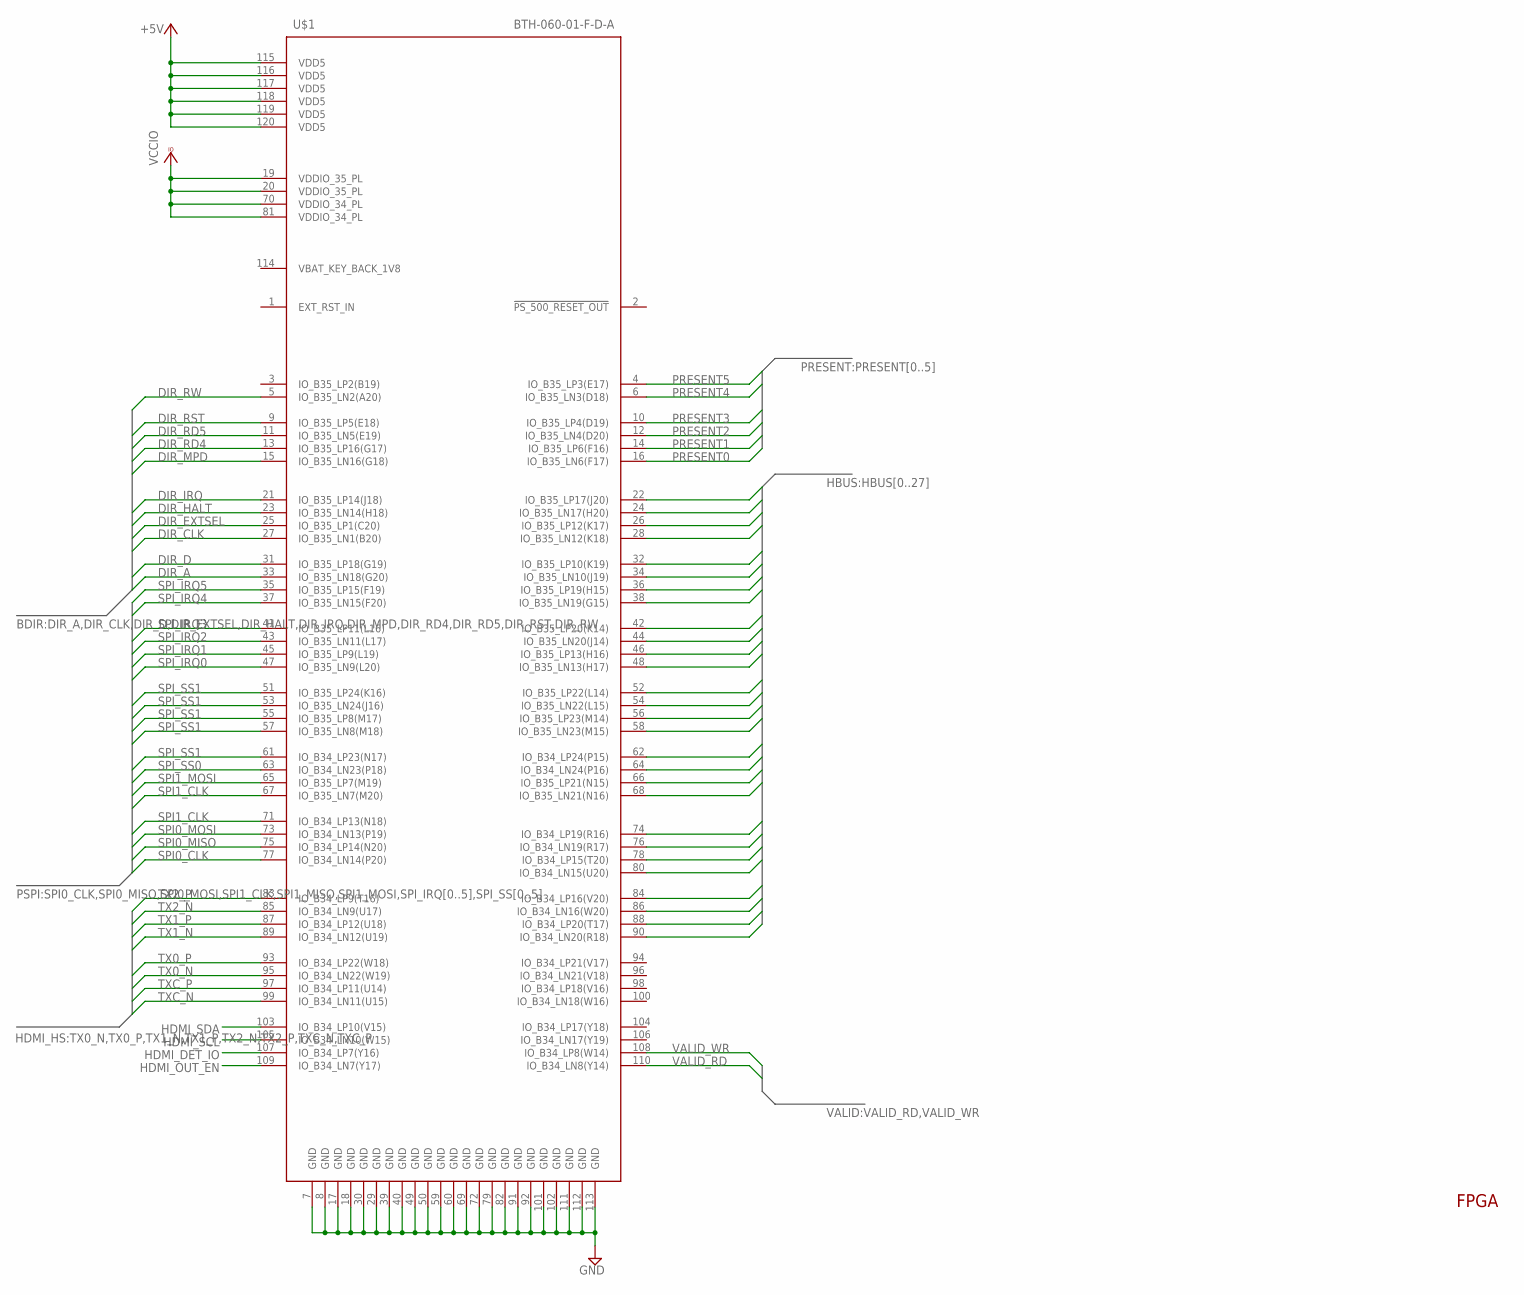
[picture p128: schematic xio4_mez.sch, sheet 5, FPGA]

Parts:
U$1: BTH-060-01-F-D-A

Connections:
+5V: U$1.115 (VDD5), U$1.116 (VDD5), U$1.117 (VDD5), U$1.118 (VDD5), U$1.119 (VDD5), U$1.120 (VDD5); also elsewhere on the board
DIR_A: U$1.33 (IO_B35_LN18(G20)); also elsewhere on the board
DIR_CLK: U$1.27 (IO_B35_LN1(B20)); also elsewhere on the board
DIR_D: U$1.31 (IO_B35_LP18(G19)); also elsewhere on the board
DIR_EXTSEL: U$1.25 (IO_B35_LP1(C20)); also elsewhere on the board
DIR_HALT: U$1.23 (IO_B35_LN14(H18)); also elsewhere on the board
DIR_IRQ: U$1.21 (IO_B35_LP14(J18)); also elsewhere on the board
DIR_MPD: U$1.15 (IO_B35_LN16(G18)); also elsewhere on the board
DIR_RD4: U$1.13 (IO_B35_LP16(G17)); also elsewhere on the board
DIR_RD5: U$1.11 (IO_B35_LN5(E19)); also elsewhere on the board
DIR_RST: U$1.9 (IO_B35_LP5(E18)); also elsewhere on the board
DIR_RW: U$1.5 (IO_B35_LN2(A20)); also elsewhere on the board
GND: U$1.7 (GND), U$1.8 (GND), U$1.17 (GND), U$1.18 (GND), U$1.29 (GND), U$1.30 (GND), U$1.39 (GND), U$1.40 (GND), U$1.49 (GND), U$1.50 (GND), U$1.59 (GND), U$1.60 (GND), U$1.69 (GND), U$1.72 (GND), U$1.79 (GND), U$1.82 (GND), U$1.91 (GND), U$1.92 (GND), U$1.101 (GND), U$1.102 (GND), U$1.111 (GND), U$1.112 (GND), U$1.113 (GND); also elsewhere on the board
HBUS0: U$1.22 (IO_B35_LP17(J20)); also elsewhere on the board
HBUS1: U$1.24 (IO_B35_LN17(H20)); also elsewhere on the board
HBUS2: U$1.26 (IO_B35_LP12(K17)); also elsewhere on the board
HBUS3: U$1.28 (IO_B35_LN12(K18)); also elsewhere on the board
HBUS4: U$1.32 (IO_B35_LP10(K19)); also elsewhere on the board
HBUS5: U$1.34 (IO_B35_LN10(J19)); also elsewhere on the board
HBUS6: U$1.36 (IO_B35_LP19(H15)); also elsewhere on the board
HBUS7: U$1.38 (IO_B35_LN19(G15)); also elsewhere on the board
HBUS8: U$1.42 (IO_B35_LP20(K14)); also elsewhere on the board
HBUS9: U$1.44 (IO_B35_LN20(J14)); also elsewhere on the board
HBUS10: U$1.46 (IO_B35_LP13(H16)); also elsewhere on the board
HBUS11: U$1.48 (IO_B35_LN13(H17)); also elsewhere on the board
HBUS12: U$1.52 (IO_B35_LP22(L14)); also elsewhere on the board
HBUS13: U$1.54 (IO_B35_LN22(L15)); also elsewhere on the board
HBUS14: U$1.56 (IO_B35_LP23(M14)); also elsewhere on the board
HBUS15: U$1.58 (IO_B35_LN23(M15)); also elsewhere on the board
HBUS16: U$1.62 (IO_B34_LP24(P15)); also elsewhere on the board
HBUS17: U$1.64 (IO_B34_LN24(P16)); also elsewhere on the board
HBUS18: U$1.66 (IO_B35_LP21(N15)); also elsewhere on the board
HBUS19: U$1.68 (IO_B35_LN21(N16)); also elsewhere on the board
HBUS20: U$1.74 (IO_B34_LP19(R16)); also elsewhere on the board
HBUS21: U$1.76 (IO_B34_LN19(R17)); also elsewhere on the board
HBUS22: U$1.78 (IO_B34_LP15(T20)); also elsewhere on the board
HBUS23: U$1.80 (IO_B34_LN15(U20)); also elsewhere on the board
HBUS24: U$1.84 (IO_B34_LP16(V20)); also elsewhere on the board
HBUS25: U$1.86 (IO_B34_LN16(W20)); also elsewhere on the board
HBUS26: U$1.88 (IO_B34_LP20(T17)); also elsewhere on the board
HBUS27: U$1.90 (IO_B34_LN20(R18)); also elsewhere on the board
HDMI_DET_IO: U$1.107 (IO_B34_LP7(Y16)); also elsewhere on the board
HDMI_OUT_EN: U$1.109 (IO_B34_LN7(Y17)); also elsewhere on the board
HDMI_SCL: U$1.105 (IO_B34_LN10(W15)); also elsewhere on the board
HDMI_SDA: U$1.103 (IO_B34_LP10(V15)); also elsewhere on the board
PRESENT0: U$1.16 (IO_B35_LN6(F17)); also elsewhere on the board
PRESENT1: U$1.14 (IO_B35_LP6(F16)); also elsewhere on the board
PRESENT2: U$1.12 (IO_B35_LN4(D20)); also elsewhere on the board
PRESENT3: U$1.10 (IO_B35_LP4(D19)); also elsewhere on the board
PRESENT4: U$1.6 (IO_B35_LN3(D18)); also elsewhere on the board
PRESENT5: U$1.4 (IO_B35_LP3(E17)); also elsewhere on the board
SPI0_CLK: U$1.77 (IO_B34_LN14(P20)); also elsewhere on the board
SPI0_MISO: U$1.75 (IO_B34_LP14(N20)); also elsewhere on the board
SPI0_MOSI: U$1.73 (IO_B34_LN13(P19)); also elsewhere on the board
SPI1_CLK: U$1.71 (IO_B34_LP13(N18)); also elsewhere on the board
SPI1_MISO: U$1.67 (IO_B35_LN7(M20)); also elsewhere on the board
SPI1_MOSI: U$1.65 (IO_B35_LP7(M19)); also elsewhere on the board
SPI_IRQ0: U$1.47 (IO_B35_LN9(L20)); also elsewhere on the board
SPI_IRQ1: U$1.45 (IO_B35_LP9(L19)); also elsewhere on the board
SPI_IRQ2: U$1.43 (IO_B35_LN11(L17)); also elsewhere on the board
SPI_IRQ3: U$1.41 (IO_B35_LP11(L16)); also elsewhere on the board
SPI_IRQ4: U$1.37 (IO_B35_LN15(F20)); also elsewhere on the board
SPI_IRQ5: U$1.35 (IO_B35_LP15(F19)); also elsewhere on the board
SPI_SS0: U$1.63 (IO_B34_LN23(P18)); also elsewhere on the board
SPI_SS1: U$1.61 (IO_B34_LP23(N17)); also elsewhere on the board
SPI_SS2: U$1.57 (IO_B35_LN8(M18)); also elsewhere on the board
SPI_SS3: U$1.55 (IO_B35_LP8(M17)); also elsewhere on the board
SPI_SS4: U$1.53 (IO_B35_LN24(J16)); also elsewhere on the board
SPI_SS5: U$1.51 (IO_B35_LP24(K16)); also elsewhere on the board
TX0_N: U$1.95 (IO_B34_LN22(W19)); also elsewhere on the board
TX0_P: U$1.93 (IO_B34_LP22(W18)); also elsewhere on the board
TX1_N: U$1.89 (IO_B34_LN12(U19)); also elsewhere on the board
TX1_P: U$1.87 (IO_B34_LP12(U18)); also elsewhere on the board
TX2_N: U$1.85 (IO_B34_LN9(U17)); also elsewhere on the board
TX2_P: U$1.83 (IO_B34_LP9(T16)); also elsewhere on the board
TXC_N: U$1.99 (IO_B34_LN11(U15)); also elsewhere on the board
TXC_P: U$1.97 (IO_B34_LP11(U14)); also elsewhere on the board
VALID_RD: U$1.110 (IO_B34_LN8(Y14)); also elsewhere on the board
VALID_WR: U$1.108 (IO_B34_LP8(W14)); also elsewhere on the board
VCCIO: U$1.19 (VDDIO_35_PL), U$1.20 (VDDIO_35_PL), U$1.70 (VDDIO_34_PL), U$1.81 (VDDIO_34_PL); also elsewhere on the board

Notes on the sheet:
FPGA

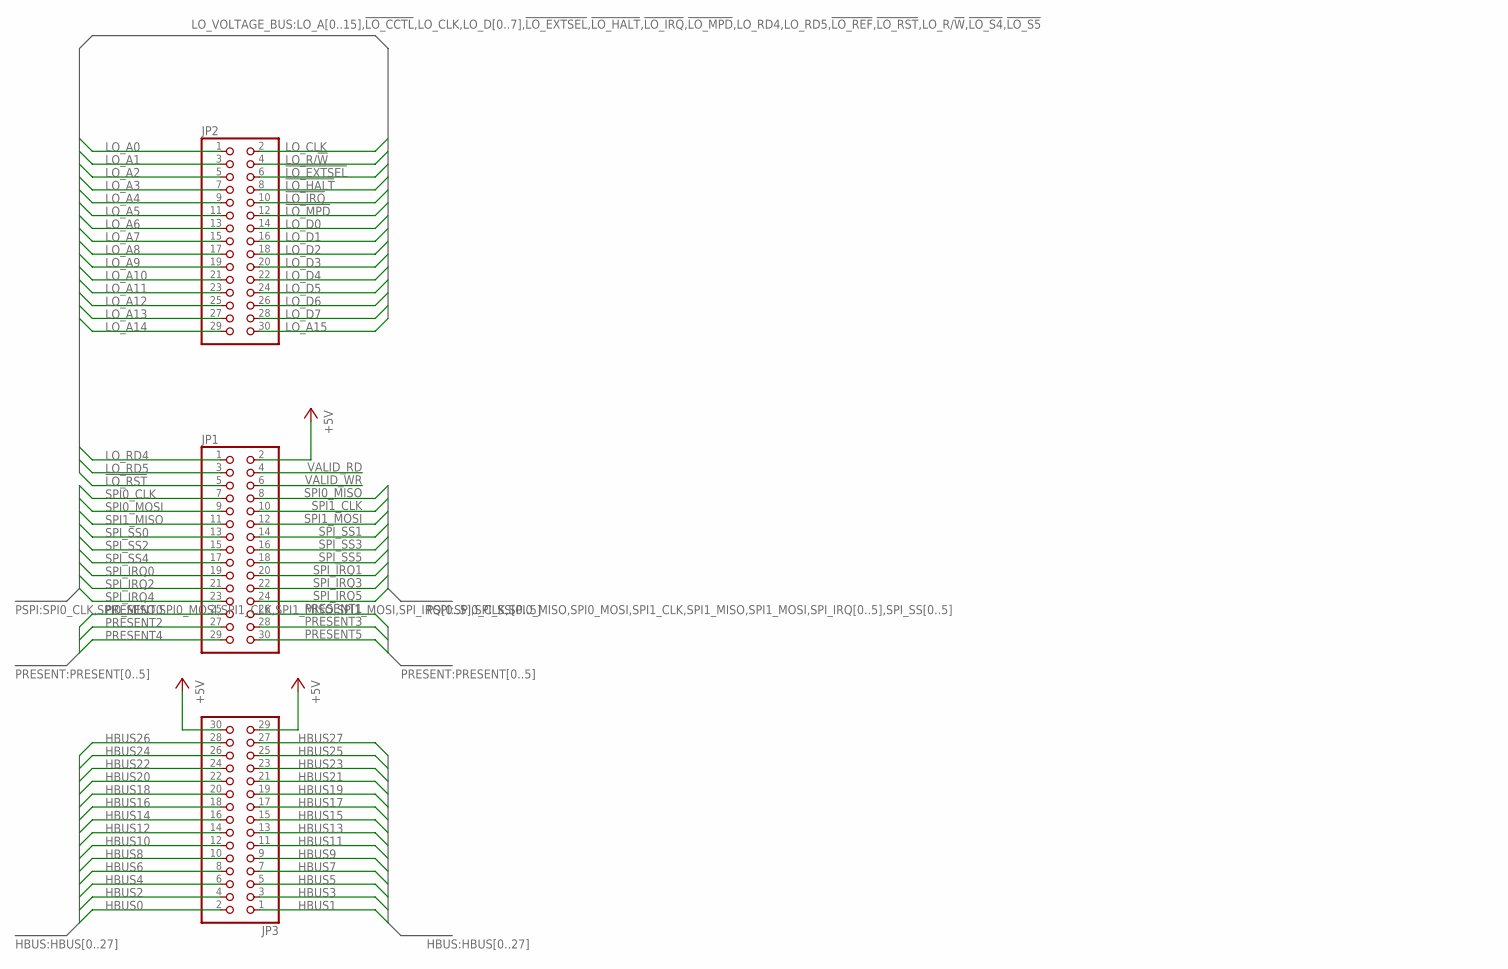
[picture p129: schematic xio4_mez.sch, sheet 6]

Parts:
JP1, JP2, JP3: PINHD-2X15_2.54-SMD; 2X15SMD

Connections:
!LO_EXTSEL!: JP2.6; also elsewhere on the board
!LO_HALT!: JP2.8; also elsewhere on the board
!LO_IRQ!: JP2.10; also elsewhere on the board
!LO_MPD!: JP2.12; also elsewhere on the board
!LO_RST!: JP1.5; also elsewhere on the board
+5V: JP1.2, JP3.29, JP3.30; also elsewhere on the board
HBUS0: JP3.2; also elsewhere on the board
HBUS1: JP3.1; also elsewhere on the board
HBUS2: JP3.4; also elsewhere on the board
HBUS3: JP3.3; also elsewhere on the board
HBUS4: JP3.6; also elsewhere on the board
HBUS5: JP3.5; also elsewhere on the board
HBUS6: JP3.8; also elsewhere on the board
HBUS7: JP3.7; also elsewhere on the board
HBUS8: JP3.10; also elsewhere on the board
HBUS9: JP3.9; also elsewhere on the board
HBUS10: JP3.12; also elsewhere on the board
HBUS11: JP3.11; also elsewhere on the board
HBUS12: JP3.14; also elsewhere on the board
HBUS13: JP3.13; also elsewhere on the board
HBUS14: JP3.16; also elsewhere on the board
HBUS15: JP3.15; also elsewhere on the board
HBUS16: JP3.18; also elsewhere on the board
HBUS17: JP3.17; also elsewhere on the board
HBUS18: JP3.20; also elsewhere on the board
HBUS19: JP3.19; also elsewhere on the board
HBUS20: JP3.22; also elsewhere on the board
HBUS21: JP3.21; also elsewhere on the board
HBUS22: JP3.24; also elsewhere on the board
HBUS23: JP3.23; also elsewhere on the board
HBUS24: JP3.26; also elsewhere on the board
HBUS25: JP3.25; also elsewhere on the board
HBUS26: JP3.28; also elsewhere on the board
HBUS27: JP3.27; also elsewhere on the board
LO_A0: JP2.1; also elsewhere on the board
LO_A1: JP2.3; also elsewhere on the board
LO_A2: JP2.5; also elsewhere on the board
LO_A3: JP2.7; also elsewhere on the board
LO_A4: JP2.9; also elsewhere on the board
LO_A5: JP2.11; also elsewhere on the board
LO_A6: JP2.13; also elsewhere on the board
LO_A7: JP2.15; also elsewhere on the board
LO_A8: JP2.17; also elsewhere on the board
LO_A9: JP2.19; also elsewhere on the board
LO_A10: JP2.21; also elsewhere on the board
LO_A11: JP2.23; also elsewhere on the board
LO_A12: JP2.25; also elsewhere on the board
LO_A13: JP2.27; also elsewhere on the board
LO_A14: JP2.29; also elsewhere on the board
LO_A15: JP2.30; also elsewhere on the board
LO_CLK: JP2.2; also elsewhere on the board
LO_D0: JP2.14; also elsewhere on the board
LO_D1: JP2.16; also elsewhere on the board
LO_D2: JP2.18; also elsewhere on the board
LO_D3: JP2.20; also elsewhere on the board
LO_D4: JP2.22; also elsewhere on the board
LO_D5: JP2.24; also elsewhere on the board
LO_D6: JP2.26; also elsewhere on the board
LO_D7: JP2.28; also elsewhere on the board
LO_R/!W!: JP2.4; also elsewhere on the board
LO_RD4: JP1.1; also elsewhere on the board
LO_RD5: JP1.3; also elsewhere on the board
PRESENT0: JP1.25; also elsewhere on the board
PRESENT1: JP1.26; also elsewhere on the board
PRESENT2: JP1.27; also elsewhere on the board
PRESENT3: JP1.28; also elsewhere on the board
PRESENT4: JP1.29; also elsewhere on the board
PRESENT5: JP1.30; also elsewhere on the board
SPI0_CLK: JP1.7; also elsewhere on the board
SPI0_MISO: JP1.8; also elsewhere on the board
SPI0_MOSI: JP1.9; also elsewhere on the board
SPI1_CLK: JP1.10; also elsewhere on the board
SPI1_MISO: JP1.11; also elsewhere on the board
SPI1_MOSI: JP1.12; also elsewhere on the board
SPI_IRQ0: JP1.19; also elsewhere on the board
SPI_IRQ1: JP1.20; also elsewhere on the board
SPI_IRQ2: JP1.21; also elsewhere on the board
SPI_IRQ3: JP1.22; also elsewhere on the board
SPI_IRQ4: JP1.23; also elsewhere on the board
SPI_IRQ5: JP1.24; also elsewhere on the board
SPI_SS0: JP1.13; also elsewhere on the board
SPI_SS1: JP1.14; also elsewhere on the board
SPI_SS2: JP1.15; also elsewhere on the board
SPI_SS3: JP1.16; also elsewhere on the board
SPI_SS4: JP1.17; also elsewhere on the board
SPI_SS5: JP1.18; also elsewhere on the board
VALID_RD: JP1.4; also elsewhere on the board
VALID_WR: JP1.6; also elsewhere on the board

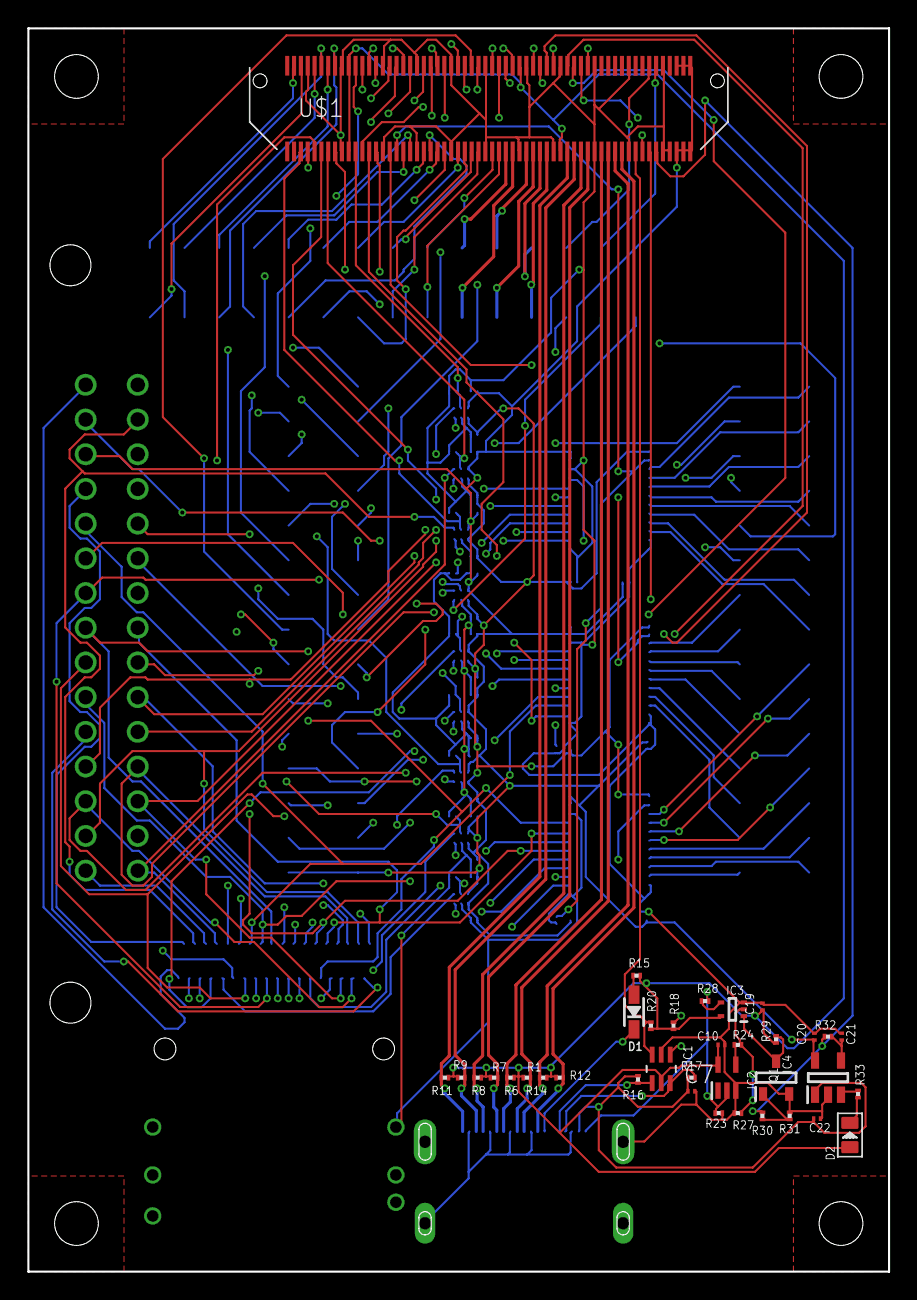
[picture p130: board xio4_mez.brd from above]

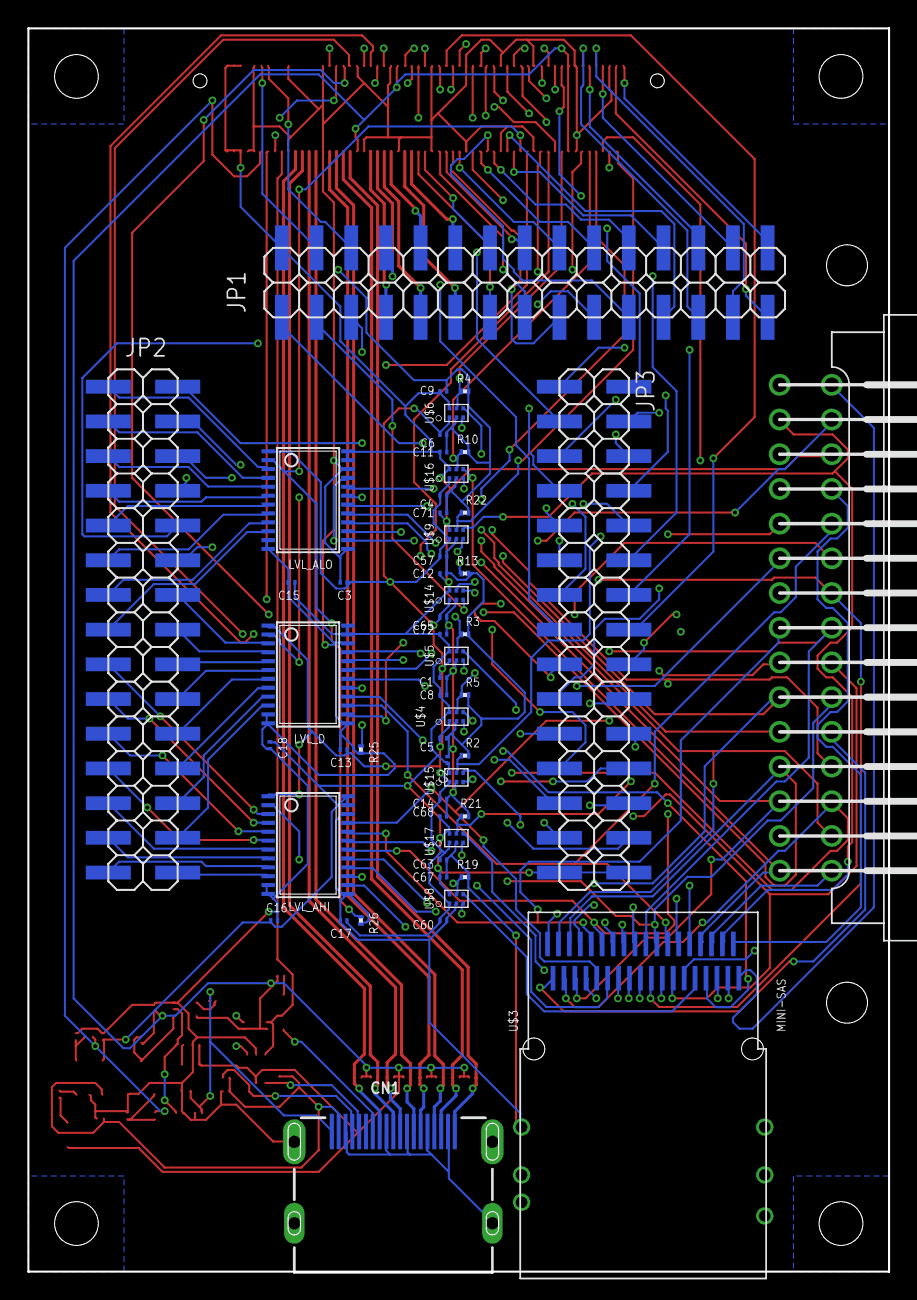
[picture p131: board xio4_mez.brd from below]

Board: 4 copper layers, 63.0 x 91.0 mm, 89 parts (53 on the bottom side), 163 nets.
