ThrudTheBarbarian/pbxl/boards/xio4/xio4.brd

## EAGLE design boards/xio4/xio4.brd (2019-09-04)

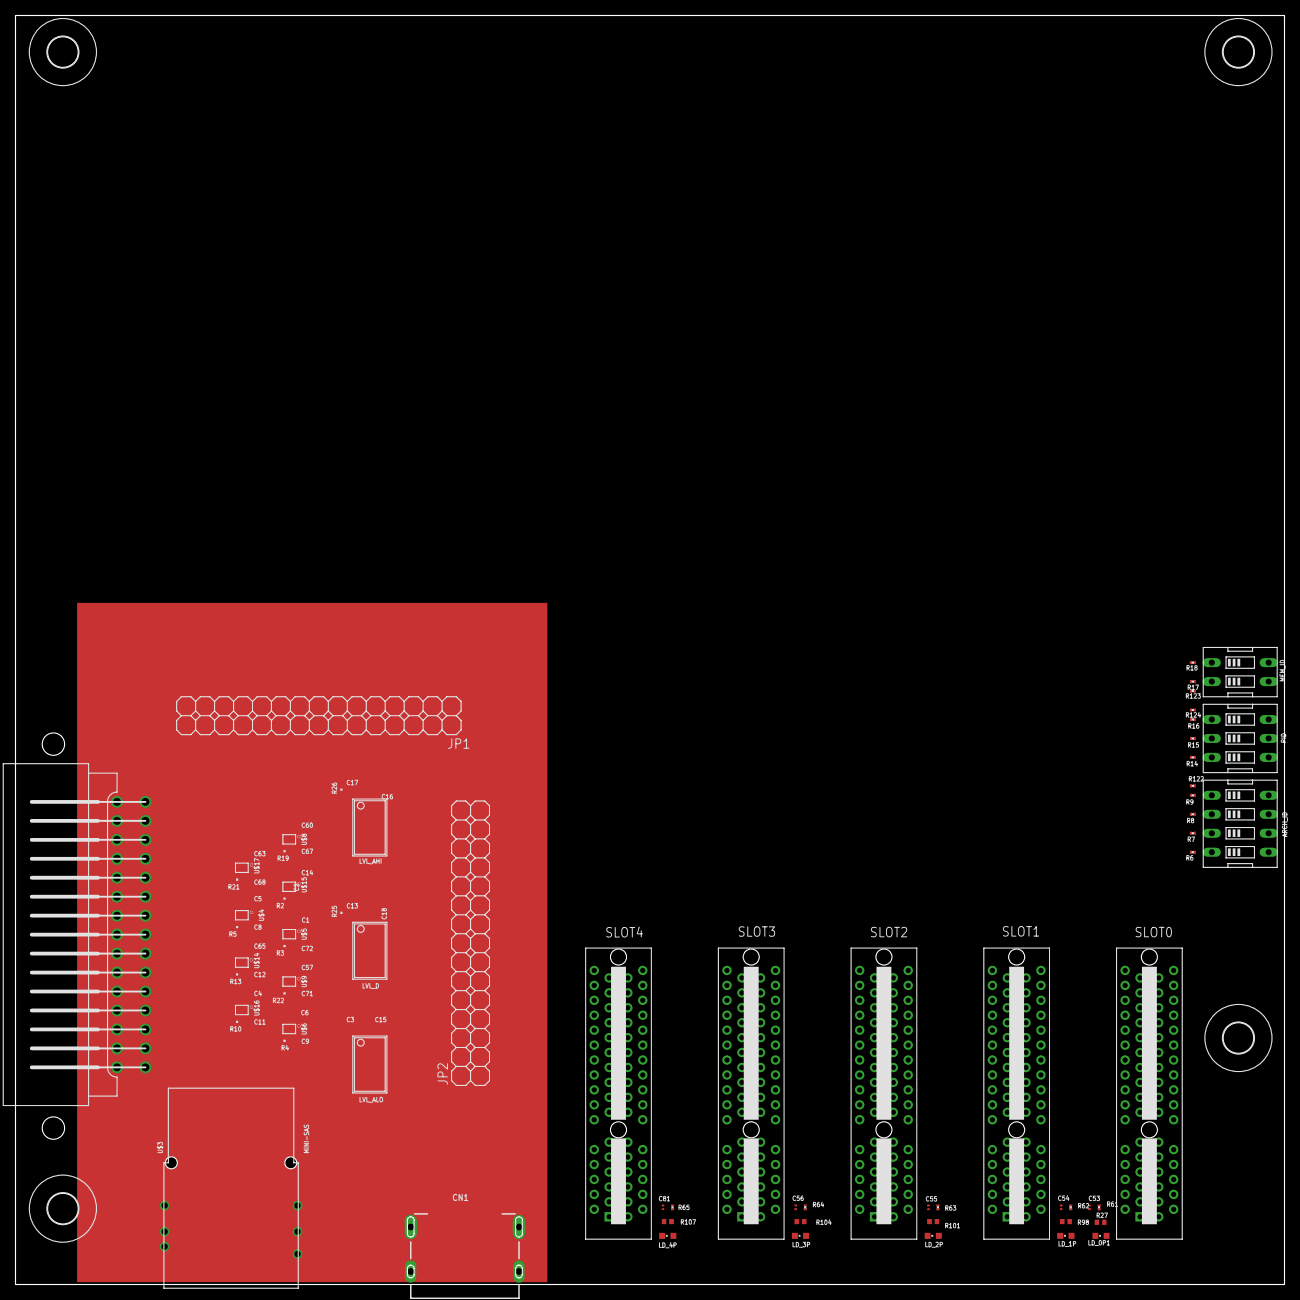
[picture p132: board xio4.brd from above]

Board: 4 copper layers, 170.0 x 170.0 mm, 96 parts (0 on the bottom side), 123 nets, no tracks yet.

Parts:
ARCH_ID: 209-4MS; EDG-04
C1, C2, C3, C4, C5, C6, C8, C9, C11, C12, C13, C14, C15, C16, C17, C18, C53, C54, C55, C56, C57, C60, C63, C65, C67, C68, C71, C72, C81: 0.1uF; C0201
CARTRIDGE: 5650118-1; A8_CART
CN1: HDMI_MOLEX_47151-0001
H3, H6, H7, H8: MOUNT-HOLE4.1; 4,1
JP1, JP2: 2X15SMD
LD_0P1, LD_1P, LD_2P, LD_3P, LD_4P: SML-D12D1WT86; CHIPLED_0603
LVL_AHI: SN74LVC8T245; TSSOP24
LVL_ALO: SN74LVC8T245; TSSOP24
LVL_D: SN74LVC8T245; TSSOP24
MEM_ID: 209-2MS; EDG-02
PID: 209-3MS; EDG-03
R2, R3, R4, R5, R10, R13, R19, R21, R22, R25, R26, R61, R62, R63, R64, R65: 10K; R0201
R6, R7, R8, R9, R14, R15, R16, R17, R18: 47K; R0201
R27, R98, R101, R104, R107: 59R; R0402
R122, R123, R124: 1K; R0201
SLOT0, SLOT1, SLOT2, SLOT3, SLOT4: PCIE_64; PCI-E_64
U$3: MINI-SAS
U$4, U$5, U$6, U$8, U$9, U$14, U$15, U$16, U$17: 74LVC1T45GWSOT866; SOT886

Connections:
!HI_CCTL!: CARTRIDGE.P15, U$3.PA18
!HI_EXTSEL!: U$3.PB13, U$5.4
!HI_HALT!: U$3.PA14, U$8.4
!HI_IRQ!: U$3.PB14, U$6.4
!HI_MPD!: U$3.PA15, U$4.4
!HI_RST!: U$3.PA17, U$17.4
!HI_S4!: CARTRIDGE.P1, U$3.PB16
!HI_S5!: CARTRIDGE.P12, U$3.PB18
!LO_CCTL!: SLOT0.A27, SLOT1.A27, SLOT2.A27, SLOT3.A27, SLOT4.A27
!LO_EXTSEL!: SLOT0.A29, SLOT1.A29, SLOT2.A29, SLOT3.A29, SLOT4.A29, U$5.3
!LO_HALT!: SLOT0.B13, SLOT1.B13, SLOT2.B13, SLOT3.B13, SLOT4.B13, U$8.3
!LO_IRQ!: SLOT0.B14, SLOT1.B14, SLOT2.B14, SLOT3.B14, SLOT4.B14, U$6.3
!LO_MPD!: SLOT0.A30, SLOT1.A30, SLOT2.A30, SLOT3.A30, SLOT4.A30, U$4.3
!LO_REF!: SLOT0.B15, SLOT1.B15, SLOT2.B15, SLOT3.B15, SLOT4.B15
!LO_RST!: SLOT0.B16, SLOT1.B16, SLOT2.B16, SLOT3.B16, SLOT4.B16, U$17.3
+3V3: C1.1, C3.1, C4.1, C5.1, C6.1, C13.1, C14.1, C17.1, C57.1, C60.1, C63.1, C65.1, LVL_AHI.1, LVL_ALO.1, LVL_D.1, R122.1, R123.1, R124.1, SLOT1.A3, SLOT2.A2, SLOT3.A2, SLOT3.A3, SLOT4.A1, U$4.1, U$5.1, U$6.1, U$8.1, U$9.1, U$14.1, U$15.1, U$16.1, U$17.1
+5V: C2.1, C8.1, C9.1, C11.1, C12.1, C15.1, C16.1, C18.1, C53.1, C54.1, C55.1, C56.1, C67.1, C68.1, C71.1, C72.1, C81.1, CARTRIDGE.P13, CN1.18, LVL_AHI.23, LVL_AHI.24, LVL_ALO.23, LVL_ALO.24, LVL_D.23, LVL_D.24, SLOT0.B1, SLOT0.B2, SLOT0.B3, SLOT1.B1, SLOT1.B2, SLOT1.B3, SLOT2.B1, SLOT2.B2, SLOT2.B3, SLOT3.B1, SLOT3.B2, SLOT3.B3, SLOT4.B1, SLOT4.B2, SLOT4.B3, U$4.6, U$5.6, U$6.6, U$8.6, U$9.6, U$14.6, U$15.6, U$16.6, U$17.6
ARCH0: ARCH_ID.1, R9.1
ARCH1: ARCH_ID.2, R8.1
ARCH2: ARCH_ID.3, R7.1
ARCH3: ARCH_ID.4, R6.1
DIR_A: LVL_AHI.2, LVL_ALO.2, R26.1
DIR_CLK: R2.1, U$15.5
DIR_D: LVL_D.2, R25.1
DIR_EXTSEL: R3.1, U$5.5
DIR_HALT: R19.1, U$8.5
DIR_IRQ: R4.1, U$6.5
DIR_MPD: R5.1, U$4.5
DIR_RD4: R10.1, U$16.5
DIR_RD5: R13.1, U$14.5
DIR_RST: R21.1, U$17.5
DIR_RW: R22.1, U$9.5
GND: C1.2, C2.2, C3.2, C4.2, C5.2, C6.2, C8.2, C9.2, C11.2, C12.2, C13.2, C14.2, C15.2, C16.2, C17.2, C18.2, C53.2, C54.2, C55.2, C56.2, C57.2, C60.2, C63.2, C65.2, C67.2, C68.2, C71.2, C72.2, C81.2, CARTRIDGE.PB, CN1.17, CN1.P$1, CN1.P$2, CN1.P$3, CN1.P$4, LD_0P1.C, LD_1P.C, LD_2P.C, LD_3P.C, LD_4P.C, LVL_AHI.11, LVL_AHI.12, LVL_AHI.13, LVL_AHI.22, LVL_ALO.11, LVL_ALO.12, LVL_ALO.13, LVL_ALO.22, LVL_D.11, LVL_D.12, LVL_D.13, LVL_D.22, R2.2, R3.2, R4.2, R5.2, R6.2, R7.2, R8.2, R9.2, R10.2, R13.2, R14.2, R15.2, R16.2, R17.2, R18.2, R19.2, R21.2, R22.2, R25.2, R26.2, R61.1, R62.1, R63.1, R64.1, R65.1, SLOT0.A1, SLOT0.A2, SLOT0.A3, SLOT0.A4, SLOT0.A5, SLOT0.B32, SLOT1.A1, SLOT1.A2, SLOT1.A4, SLOT1.A5, SLOT1.B32, SLOT2.A1, SLOT2.A3, SLOT2.A4, SLOT2.A5, SLOT2.B32, SLOT3.A1, SLOT3.A4, SLOT3.A5, SLOT3.B32, SLOT4.A2, SLOT4.A3, SLOT4.A4, SLOT4.A5, SLOT4.B32, U$3.SHIELD1, U$3.SHIELD2, U$3.SHIELD3, U$3.SHIELD4, U$3.SHIELD5, U$3.SHIELD6, U$4.2, U$5.2, U$6.2, U$8.2, U$9.2, U$14.2, U$15.2, U$16.2, U$17.2
HBUS0: SLOT0.B18, SLOT1.B18, SLOT2.B18, SLOT3.B18, SLOT4.B18
HBUS1: SLOT0.B19, SLOT1.B19, SLOT2.B19, SLOT3.B19, SLOT4.B19
HBUS2: SLOT0.B20, SLOT1.B20, SLOT2.B20, SLOT3.B20, SLOT4.B20
HBUS3: SLOT0.B21, SLOT1.B21, SLOT2.B21, SLOT3.B21, SLOT4.B21
HBUS4: SLOT0.B22, SLOT1.B22, SLOT2.B22, SLOT3.B22, SLOT4.B22
HBUS5: SLOT0.B23, SLOT1.B23, SLOT2.B23, SLOT3.B23, SLOT4.B23
HBUS6: SLOT0.B24, SLOT1.B24, SLOT2.B24, SLOT3.B24, SLOT4.B24
HBUS7: SLOT0.B25, SLOT1.B25, SLOT2.B25, SLOT3.B25, SLOT4.B25
HBUS8: SLOT0.B26, SLOT1.B26, SLOT2.B26, SLOT3.B26, SLOT4.B26
HBUS9: SLOT0.B27, SLOT1.B27, SLOT2.B27, SLOT3.B27, SLOT4.B27
HBUS10: SLOT0.B28, SLOT1.B28, SLOT2.B28, SLOT3.B28, SLOT4.B28
HBUS11: SLOT0.B29, SLOT1.B29, SLOT2.B29, SLOT3.B29, SLOT4.B29
HBUS12: SLOT0.B30, SLOT1.B30, SLOT2.B30, SLOT3.B30, SLOT4.B30
HBUS13: SLOT0.B31, SLOT1.B31, SLOT2.B31, SLOT3.B31, SLOT4.B31
HI_A0: CARTRIDGE.P5, LVL_ALO.21, U$3.PA1
HI_A1: CARTRIDGE.P4, LVL_ALO.20, U$3.PB1
HI_A2: CARTRIDGE.P3, LVL_ALO.19, U$3.PA2
HI_A3: CARTRIDGE.P2, LVL_ALO.18, U$3.PB2
HI_A4: CARTRIDGE.PC, LVL_ALO.17, U$3.PA3
HI_A5: CARTRIDGE.PD, LVL_ALO.16, U$3.PB3
HI_A6: CARTRIDGE.PE, LVL_ALO.15, U$3.PA4
HI_A7: CARTRIDGE.PF, LVL_ALO.14, U$3.PB4
HI_A8: CARTRIDGE.PH, LVL_AHI.21, U$3.PA5
HI_A9: CARTRIDGE.PJ, LVL_AHI.20, U$3.PB5
HI_A10: CARTRIDGE.PP, LVL_AHI.19, U$3.PA6
HI_A11: CARTRIDGE.PN, LVL_AHI.18, U$3.PB6
HI_A12: CARTRIDGE.PK, LVL_AHI.17, U$3.PA7
HI_A13: LVL_AHI.16, U$3.PB7
HI_A14: LVL_AHI.15, U$3.PA8
HI_A15: LVL_AHI.14, U$3.PB8
HI_CLK: CARTRIDGE.PS, U$3.PA9, U$15.4
HI_D0: CARTRIDGE.P10, LVL_D.21, U$3.PB9
HI_D1: CARTRIDGE.P9, LVL_D.20, U$3.PA10
HI_D2: CARTRIDGE.P8, LVL_D.19, U$3.PB10
HI_D3: CARTRIDGE.PL, LVL_D.18, U$3.PA11
HI_D4: CARTRIDGE.P6, LVL_D.17, U$3.PB11
HI_D5: CARTRIDGE.P7, LVL_D.16, U$3.PA12
HI_D6: CARTRIDGE.P11, LVL_D.15, U$3.PB12
HI_D7: CARTRIDGE.PM, LVL_D.14, U$3.PA13
HI_R/!W!: CARTRIDGE.PR, U$3.PB17, U$9.4
HI_RD4: CARTRIDGE.PA, U$3.PB15, U$16.4
HI_RD5: CARTRIDGE.P14, U$3.PA16, U$14.4
LO_A0: LVL_ALO.3, SLOT0.A11, SLOT1.A11, SLOT2.A11, SLOT3.A11, SLOT4.A11
LO_A1: LVL_ALO.4, SLOT0.A12, SLOT1.A12, SLOT2.A12, SLOT3.A12, SLOT4.A12
LO_A2: LVL_ALO.5, SLOT0.A13, SLOT1.A13, SLOT2.A13, SLOT3.A13, SLOT4.A13
LO_A3: LVL_ALO.6, SLOT0.A14, SLOT1.A14, SLOT2.A14, SLOT3.A14, SLOT4.A14
LO_A4: LVL_ALO.7, SLOT0.A15, SLOT1.A15, SLOT2.A15, SLOT3.A15, SLOT4.A15
LO_A5: LVL_ALO.8, SLOT0.A16, SLOT1.A16, SLOT2.A16, SLOT3.A16, SLOT4.A16
LO_A6: LVL_ALO.9, SLOT0.A17, SLOT1.A17, SLOT2.A17, SLOT3.A17, SLOT4.A17
LO_A7: LVL_ALO.10, SLOT0.A18, SLOT1.A18, SLOT2.A18, SLOT3.A18, SLOT4.A18
LO_A8: LVL_AHI.3, SLOT0.A19, SLOT1.A19, SLOT2.A19, SLOT3.A19, SLOT4.A19
LO_A9: LVL_AHI.4, SLOT0.A20, SLOT1.A20, SLOT2.A20, SLOT3.A20, SLOT4.A20
LO_A10: LVL_AHI.5, SLOT0.A21, SLOT1.A21, SLOT2.A21, SLOT3.A21, SLOT4.A21
LO_A11: LVL_AHI.6, SLOT0.A22, SLOT1.A22, SLOT2.A22, SLOT3.A22, SLOT4.A22
LO_A12: LVL_AHI.7, SLOT0.A23, SLOT1.A23, SLOT2.A23, SLOT3.A23, SLOT4.A23
LO_A13: LVL_AHI.8, SLOT0.A24, SLOT1.A24, SLOT2.A24, SLOT3.A24, SLOT4.A24
LO_A14: LVL_AHI.9, SLOT0.A25, SLOT1.A25, SLOT2.A25, SLOT3.A25, SLOT4.A25
LO_A15: LVL_AHI.10, SLOT0.A26, SLOT1.A26, SLOT2.A26, SLOT3.A26, SLOT4.A26
LO_CLK: SLOT0.A28, SLOT1.A28, SLOT2.A28, SLOT3.A28, SLOT4.A28, U$15.3
LO_D0: LVL_D.3, SLOT0.B5, SLOT1.B5, SLOT2.B5, SLOT3.B5, SLOT4.B5
LO_D1: LVL_D.4, SLOT0.B6, SLOT1.B6, SLOT2.B6, SLOT3.B6, SLOT4.B6
LO_D2: LVL_D.5, SLOT0.B7, SLOT1.B7, SLOT2.B7, SLOT3.B7, SLOT4.B7
LO_D3: LVL_D.6, SLOT0.B8, SLOT1.B8, SLOT2.B8, SLOT3.B8, SLOT4.B8
LO_D4: LVL_D.7, SLOT0.B9, SLOT1.B9, SLOT2.B9, SLOT3.B9, SLOT4.B9
LO_D5: LVL_D.8, SLOT0.B10, SLOT1.B10, SLOT2.B10, SLOT3.B10, SLOT4.B10
LO_D6: LVL_D.9, SLOT0.B11, SLOT1.B11, SLOT2.B11, SLOT3.B11, SLOT4.B11
LO_D7: LVL_D.10, SLOT0.B12, SLOT1.B12, SLOT2.B12, SLOT3.B12, SLOT4.B12
LO_R/!W!: SLOT0.B17, SLOT1.B17, SLOT2.B17, SLOT3.B17, SLOT4.B17, U$9.3
LO_RD4: SLOT0.A31, SLOT1.A31, SLOT2.A31, SLOT3.A31, SLOT4.A31, U$16.3
LO_RD5: SLOT0.A32, SLOT1.A32, SLOT2.A32, SLOT3.A32, SLOT4.A32, U$14.3
MEM0: MEM_ID.1, R18.1
MEM1: MEM_ID.2, R17.1
unnamed: LD_0P1.A, R27.2
unnamed: ARCH_ID.5, ARCH_ID.6, ARCH_ID.7, ARCH_ID.8, R122.2
unnamed: MEM_ID.3, MEM_ID.4, R123.2
unnamed: PID.4, PID.5, PID.6, R124.2
unnamed: LD_1P.A, R98.2
unnamed: LD_2P.A, R101.2
unnamed: LD_3P.A, R104.2
unnamed: LD_4P.A, R107.2
PID0: PID.1, R16.1
PID1: PID.2, R15.1
PID2: PID.3, R14.1
S0_PRESENT: R27.1, R61.2, SLOT0.B4
S1_PRESENT: R62.2, R98.1, SLOT1.B4
S2_PRESENT: R63.2, R101.1, SLOT2.B4
S3_PRESENT: R64.2, R104.1, SLOT3.B4
S4_PRESENT: R65.2, R107.1, SLOT4.B4
VALID_RD: SLOT0.A7, SLOT1.A7, SLOT2.A7, SLOT3.A7, SLOT4.A7
VALID_WR: SLOT0.A6, SLOT1.A6, SLOT2.A6, SLOT3.A6, SLOT4.A6
