ThrudTheBarbarian/pbxl/boards/xe-sas/xe-sas.brd

## EAGLE design boards/xe-sas/xe-sas.brd (2019-09-03)

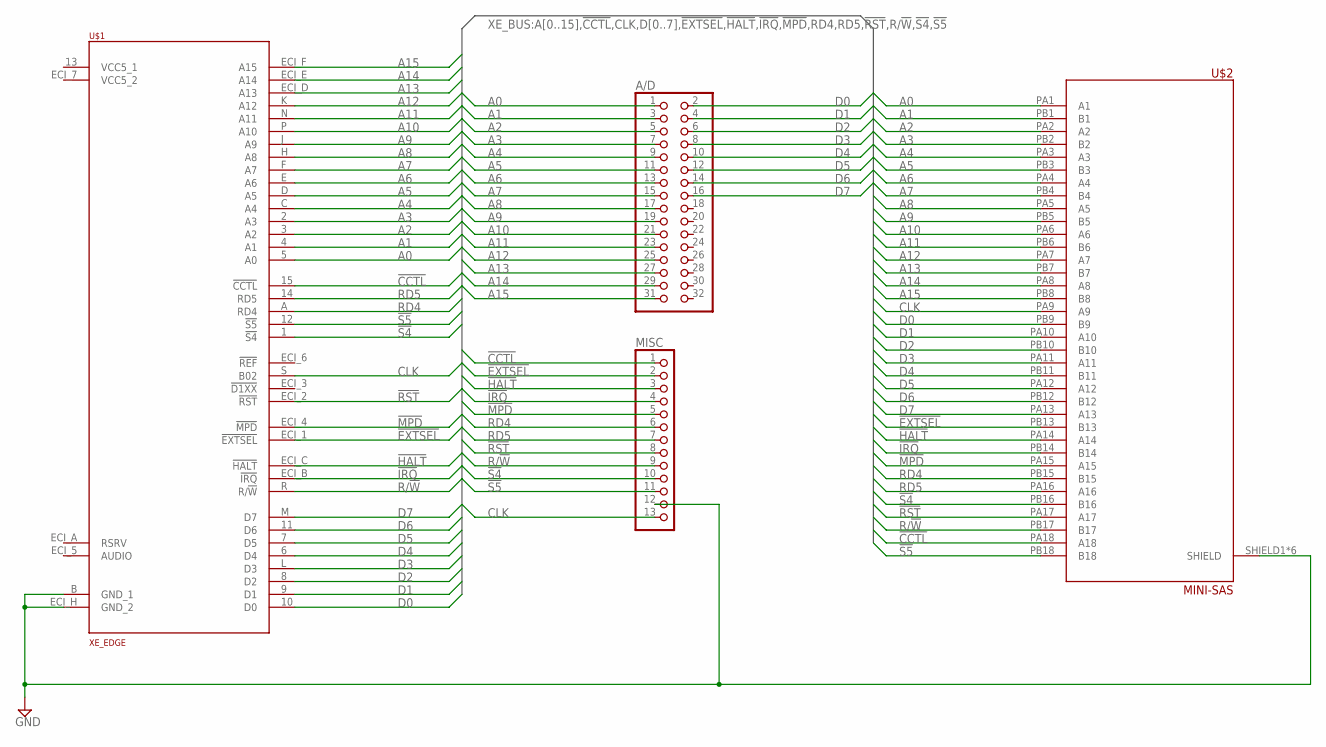
[picture p133: schematic xe-sas.sch, BUS i/o]

Parts:
A/D: PINHD-2X16; 2X16
MISC: PINHD-1X13; 1X13
U$1: XE_EDGE
U$2: MINI-SAS

Connections:
!CCTL!: MISC.1, U$1.15 (!CCTL!), U$2.PA18 (A18)
!EXTSEL!: MISC.2, U$1.ECI_1 (!EXTSEL!), U$2.PB13 (B13)
!HALT!: MISC.3, U$1.ECI_C (!HALT!), U$2.PA14 (A14)
!IRQ!: MISC.4, U$1.ECI_B (!IRQ!), U$2.PB14 (B14)
!MPD!: MISC.5, U$1.ECI_4 (!MPD!), U$2.PA15 (A15)
!RST!: MISC.8, U$1.ECI_2 (!RST!), U$2.PA17 (A17)
!S4!: MISC.10, U$1.1 (!S4!), U$2.PB16 (B16)
!S5!: MISC.11, U$1.12 (!S5!), U$2.PB18 (B18)
A0: A/D.1, U$1.5 (A0), U$2.PA1 (A1)
A1: A/D.3, U$1.4 (A1), U$2.PB1 (B1)
A2: A/D.5, U$1.3 (A2), U$2.PA2 (A2)
A3: A/D.7, U$1.2 (A3), U$2.PB2 (B2)
A4: A/D.9, U$1.C (A4), U$2.PA3 (A3)
A5: A/D.11, U$1.D (A5), U$2.PB3 (B3)
A6: A/D.13, U$1.E (A6), U$2.PA4 (A4)
A7: A/D.15, U$1.F (A7), U$2.PB4 (B4)
A8: A/D.17, U$1.H (A8), U$2.PA5 (A5)
A9: A/D.19, U$1.J (A9), U$2.PB5 (B5)
A10: A/D.21, U$1.P (A10), U$2.PA6 (A6)
A11: A/D.23, U$1.N (A11), U$2.PB6 (B6)
A12: A/D.25, U$1.K (A12), U$2.PA7 (A7)
A13: A/D.27, U$1.ECI_D (A13), U$2.PB7 (B7)
A14: A/D.29, U$1.ECI_E (A14), U$2.PA8 (A8)
A15: A/D.31, U$1.ECI_F (A15), U$2.PB8 (B8)
CLK: MISC.13, U$1.S (B02), U$2.PA9 (A9)
D0: A/D.2, U$1.10 (D0), U$2.PB9 (B9)
D1: A/D.4, U$1.9 (D1), U$2.PA10 (A10)
D2: A/D.6, U$1.8 (D2), U$2.PB10 (B10)
D3: A/D.8, U$1.L (D3), U$2.PA11 (A11)
D4: A/D.10, U$1.6 (D4), U$2.PB11 (B11)
D5: A/D.12, U$1.7 (D5), U$2.PA12 (A12)
D6: A/D.14, U$1.11 (D6), U$2.PB12 (B12)
D7: A/D.16, U$1.M (D7), U$2.PA13 (A13)
GND: MISC.12, U$1.B (GND_1), U$1.ECI_H (GND_2), U$2.SHIELD1 (SHIELD), U$2.SHIELD2 (SHIELD), U$2.SHIELD3 (SHIELD), U$2.SHIELD4 (SHIELD), U$2.SHIELD5 (SHIELD), U$2.SHIELD6 (SHIELD)
R/!W!: MISC.9, U$1.R (R/!W!), U$2.PB17 (B17)
RD4: MISC.6, U$1.A (RD4), U$2.PB15 (B15)
RD5: MISC.7, U$1.14 (RD5), U$2.PA16 (A16)

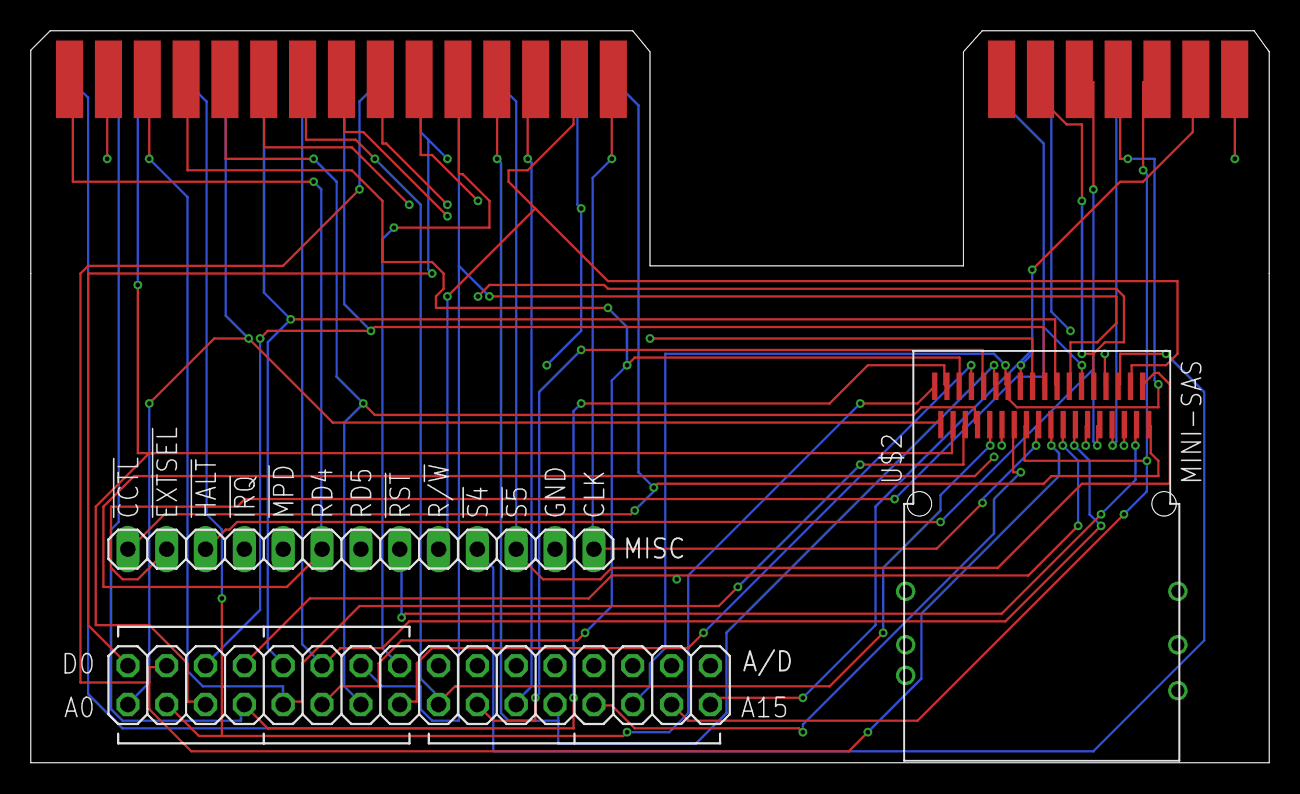
[picture p134: board xe-sas.brd from above]

Board: 4 copper layers, 81.0 x 47.9 mm, 4 parts (0 on the bottom side), 37 nets.
