ThrudTheBarbarian/pbxl/boards/xio2/xio2.brd

## EAGLE design boards/xio2/xio2.brd (2018-10-31)

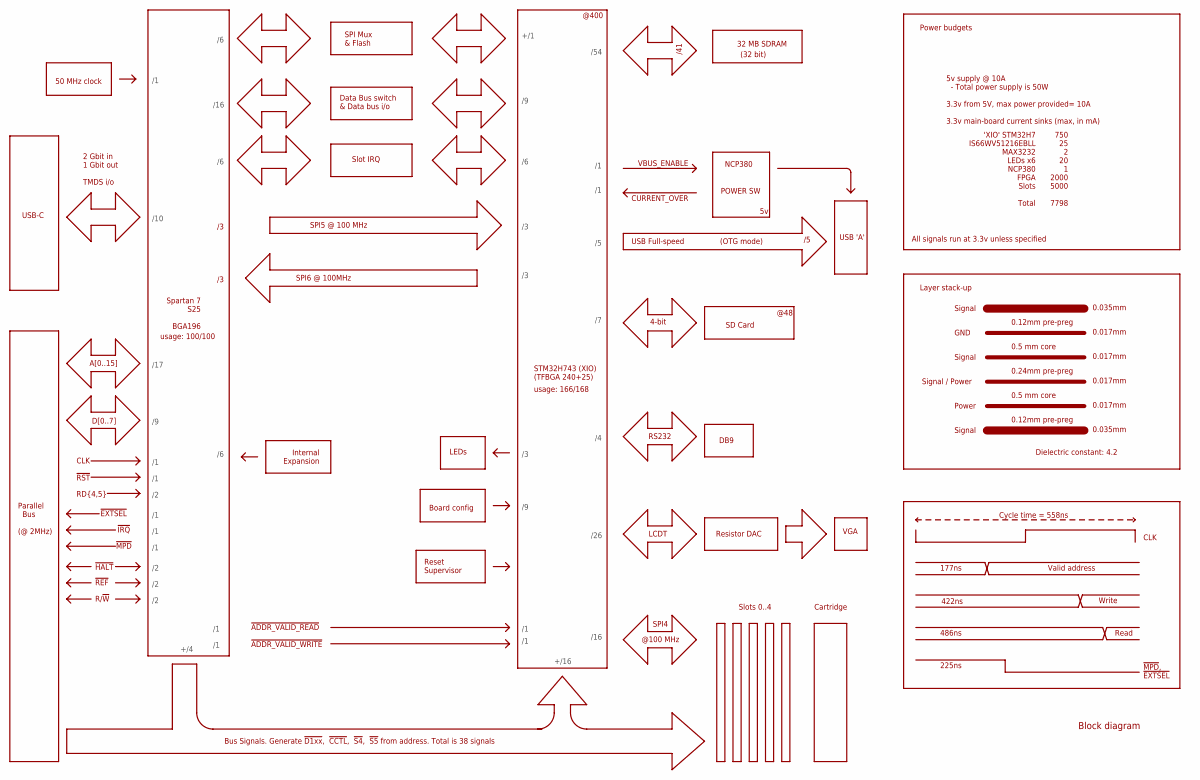
[picture p135: schematic xio2.sch, sheet 1, Block diagram]

Notes on the sheet:
USB-C
STM32H743 (XIO) (TFBGA 240+25)
SPI4
@100 MHz
Slots 0..4
Bus Signals. Generate !D1xx!, !CCTL!, !S4!, !S5! from address. Total is 38 signals
RS232
32 MB SDRAM
/41
(32 bit)
POWER SW
USB Full-speed
CURRENT_OVER
VBUS_ENABLE
SD Card
@48
@400
NCP380
(OTG mode)
USB 'A'
DB9
5v supply @ 10A - Total power supply is 50W 3.3v from 5V, max power provided= 10A 3.3v main-board current sinks (max, in mA)
'XIO' STM32H7 IS66WV51216EBLL MAX3232 LEDs x6 NCP380 FPGA Slots Total
750 25 2 20 1 2000 5000 7798
0.5 mm core
0.12mm pre-preg
0.035mm
0.017mm
Layer stack-up
GND
Power
Dielectric constant: 4.2
Cycle time = 558ns
Valid address
Write
Read
177ns
422ns
486ns
225ns
!MPD!, !EXTSEL!
CLK
Power budgets
Spartan 7 S25 BGA196
LCDT
Resistor DAC
VGA
2 Gbit in 1 Gbit out TMDS i/o
4-bit
SPI Mux & Flash
Signal / Power
Signal
0.24mm pre-preg
Block diagram
Reset Supervisor
Board config
LEDs
SPI5 @ 100 MHz
SPI6 @ 100MHz
Parallel Bus (@ 2MHz)
A[0..15]
D[0..7]
!RST!
RD{4,5}
!MPD!
!IRQ!
!EXTSEL!
!HALT!
!REF!
R/!W!
/17
!ADDR_VALID_READ!
!ADDR_VALID_WRITE!
+/4
+/1
Data Bus switch & Data bus i/o
/16
Slot IRQ
50 MHz clock
/10
usage: 100/100
/54
/26
usage: 166/168
+/16
Cartridge
Internal Expansion
All signals run at 3.3v unless specified

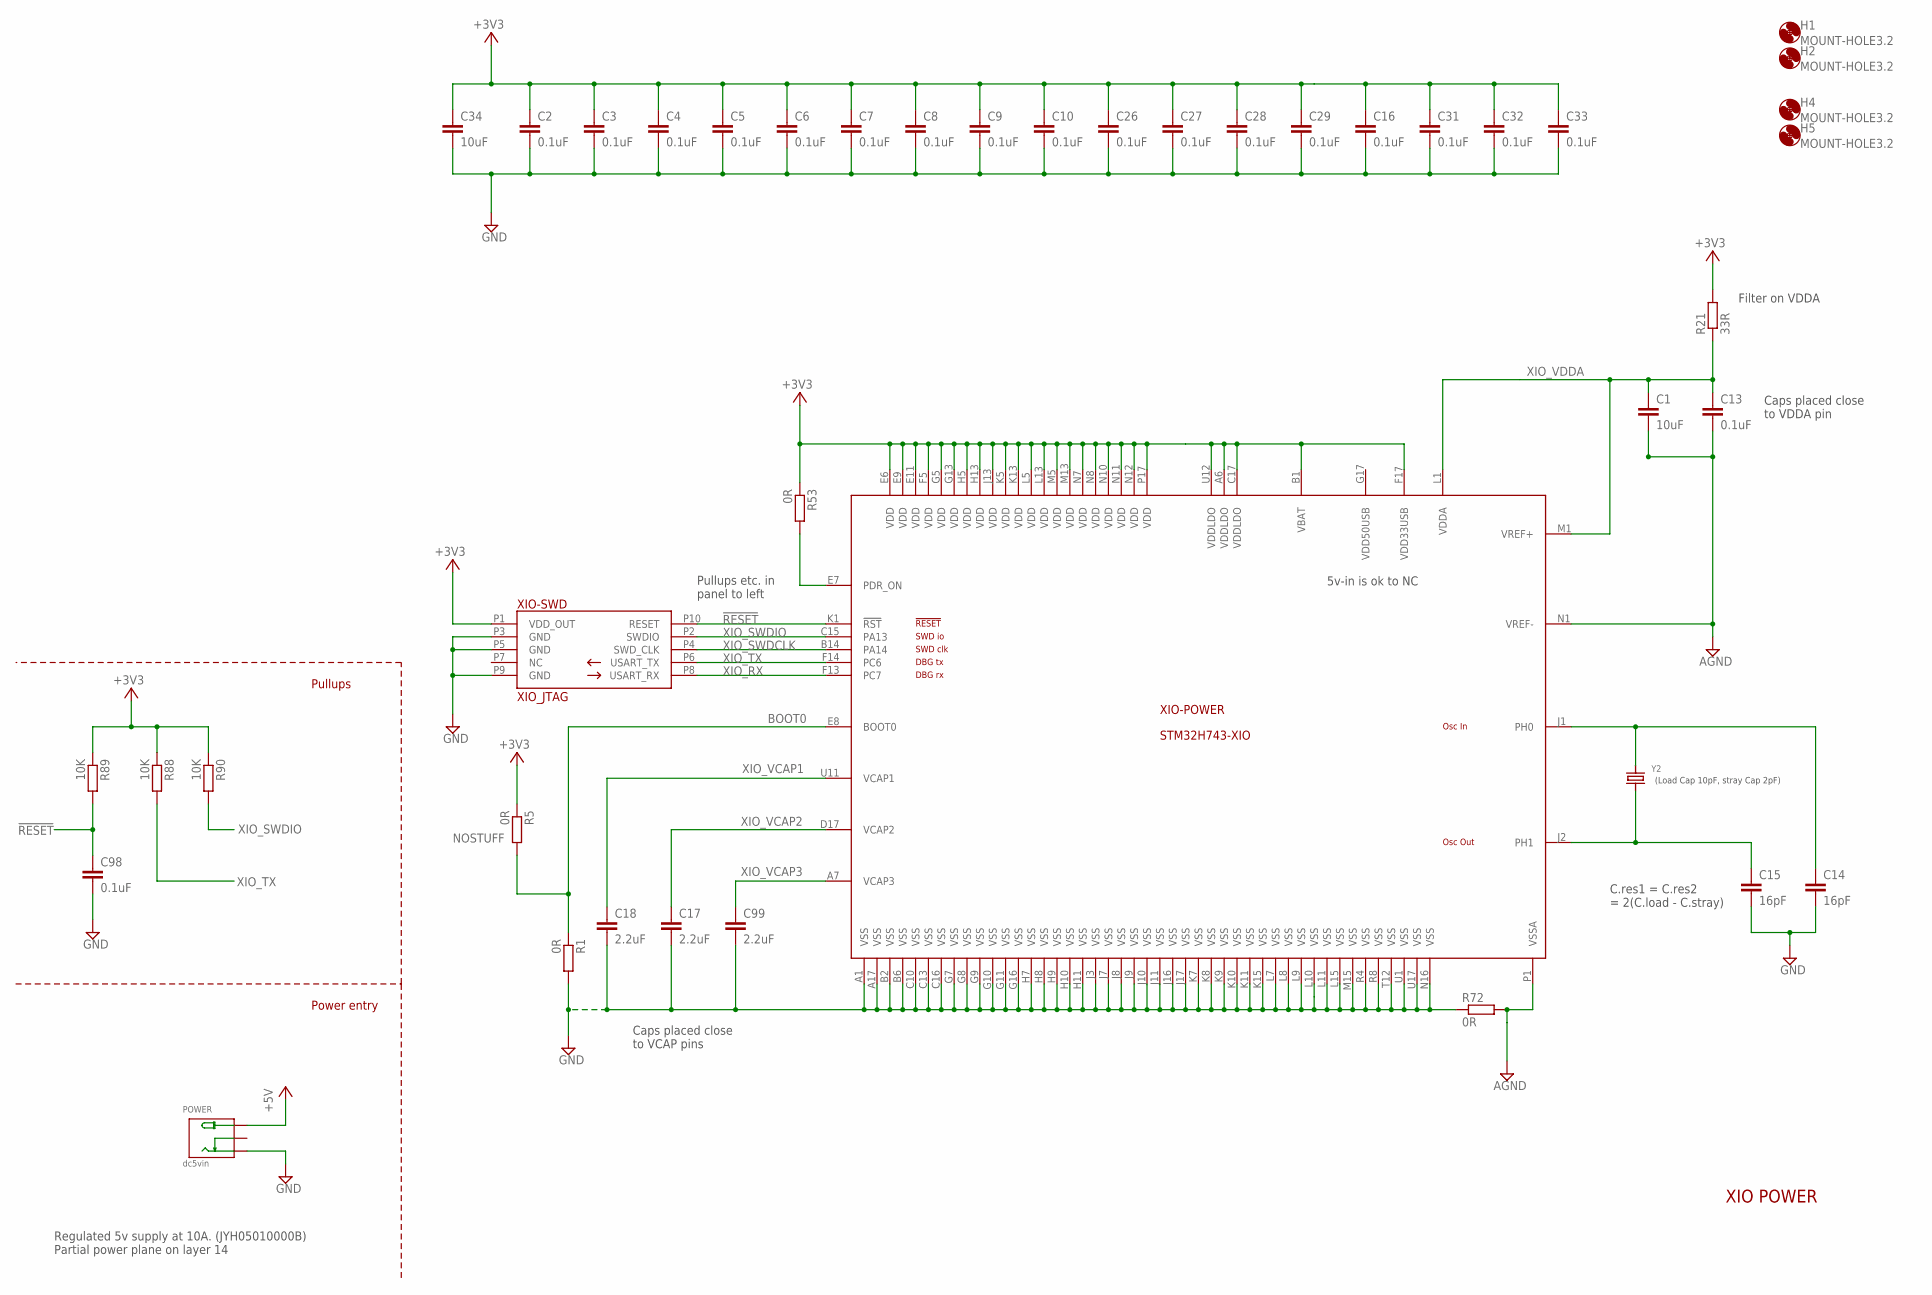
[picture p136: schematic xio2.sch, sheet 2, XIO Power]

Parts:
C1, C34: 10uF; C0402K
C2, C3, C4, C5, C6, C7, C8, C9, C10, C13, C16, C26, C27, C28, C29, C31, C32, C33, C98: 0.1uF; C0201
C14, C15: 16pF; C0201
C17, C18, C99: 2.2uF; C0201
H1, H2, H4, H5: MOUNT-HOLE3.2; 3,2
POWER: dc5vin; DCJ3P-14.2X11.0X9.0MM
R1, R5, R53, R72: 0R; R0201
R21: 33R; R0201
R88, R89, R90: 10K; R0201
XIO: STM32H743-XIO; BGA289C80P17X17_1400X1400X110
XIO-SWD: XIO_JTAG; SWD_DEBUG
Y2: FA-238 25.0000MB-K3; CRYSTAL_3.2X2.5

Connections:
!RESET!: C98.1, R89.2, XIO.K1 (!RST!), XIO-SWD.P10 (RESET); also elsewhere on the board
+3V3: C2.1, C3.1, C4.1, C5.1, C6.1, C7.1, C8.1, C9.1, C10.1, C16.1, C26.1, C27.1, C28.1, C29.1, C31.1, C32.1, C33.1, C34.1, R5.1, R21.2, R53.1, R88.1, R89.1, R90.1, XIO.A6 (VDDLDO), XIO.B1 (VBAT), XIO.C17 (VDDLDO), XIO.E6 (VDD), XIO.E9 (VDD), XIO.E11 (VDD), XIO.F5 (VDD), XIO.F17 (VDD33USB), XIO.G5 (VDD), XIO.G13 (VDD), XIO.H5 (VDD), XIO.H13 (VDD), XIO.J13 (VDD), XIO.K5 (VDD), XIO.K13 (VDD), XIO.L5 (VDD), XIO.L13 (VDD), XIO.M5 (VDD), XIO.M13 (VDD), XIO.N7 (VDD), XIO.N8 (VDD), XIO.N10 (VDD), XIO.N11 (VDD), XIO.N12 (VDD), XIO.P17 (VDD), XIO.U12 (VDDLDO), XIO-SWD.P1 (VDD_OUT); also elsewhere on the board
+5V: POWER.+; also elsewhere on the board
AGND: C1.2, C13.2, R72.2, XIO.N1 (VREF-), XIO.P1 (VSSA)
BOOT0: R1.1, R5.2, XIO.E8 (BOOT0)
GND: C2.2, C3.2, C4.2, C5.2, C6.2, C7.2, C8.2, C9.2, C10.2, C14.2, C15.2, C16.2, C17.2, C18.2, C26.2, C27.2, C28.2, C29.2, C31.2, C32.2, C33.2, C34.2, C98.2, C99.2, POWER.-1 (-), R1.2, R72.1, XIO.A1 (VSS), XIO.A17 (VSS), XIO.B2 (VSS), XIO.B6 (VSS), XIO.C10 (VSS), XIO.C13 (VSS), XIO.C16 (VSS), XIO.G7 (VSS), XIO.G8 (VSS), XIO.G9 (VSS), XIO.G10 (VSS), XIO.G11 (VSS), XIO.G16 (VSS), XIO.H7 (VSS), XIO.H8 (VSS), XIO.H9 (VSS), XIO.H10 (VSS), XIO.H11 (VSS), XIO.J3 (VSS), XIO.J7 (VSS), XIO.J8 (VSS), XIO.J9 (VSS), XIO.J10 (VSS), XIO.J11 (VSS), XIO.J16 (VSS), XIO.J17 (VSS), XIO.K7 (VSS), XIO.K8 (VSS), XIO.K9 (VSS), XIO.K10 (VSS), XIO.K11 (VSS), XIO.K15 (VSS), XIO.L7 (VSS), XIO.L8 (VSS), XIO.L9 (VSS), XIO.L10 (VSS), XIO.L11 (VSS), XIO.L15 (VSS), XIO.M15 (VSS), XIO.N16 (VSS), XIO.R4 (VSS), XIO.R8 (VSS), XIO.T12 (VSS), XIO.U1 (VSS), XIO.U17 (VSS), XIO-SWD.P3 (GND), XIO-SWD.P5 (GND), XIO-SWD.P9 (GND); also elsewhere on the board
PDR_ON: R53.2, XIO.E7 (PDR_ON)
XIO_CLK_IN: C14.1, XIO.J1 (PH0), Y2.2
XIO_CLK_OUT: C15.1, XIO.J2 (PH1), Y2.1
XIO_RX: XIO.F13 (PC7), XIO-SWD.P8 (USART_RX)
XIO_SWDCLK: XIO.B14 (PA14), XIO-SWD.P4 (SWD_CLK)
XIO_SWDIO: R90.2, XIO.C15 (PA13), XIO-SWD.P2 (SWDIO)
XIO_TX: R88.2, XIO.F14 (PC6), XIO-SWD.P6 (USART_TX)
XIO_VCAP1: C18.1, XIO.U11 (VCAP1)
XIO_VCAP2: C17.1, XIO.D17 (VCAP2)
XIO_VCAP3: C99.1, XIO.A7 (VCAP3)
XIO_VDDA: C1.1, C13.1, R21.1, XIO.L1 (VDDA), XIO.M1 (VREF+)

Notes on the sheet:
Power entry
XIO POWER
Regulated 5v supply at 10A. (JYH05010000B) Partial power plane on layer 14
Caps placed close to VDDA pin
Caps placed close to VCAP pins
(Load Cap 10pF, stray Cap 2pF)
Pullups
Filter on VDDA
Pullups etc. in panel to left
C.res1 = C.res2 = 2(C.load - C.stray)
5v-in is ok to NC

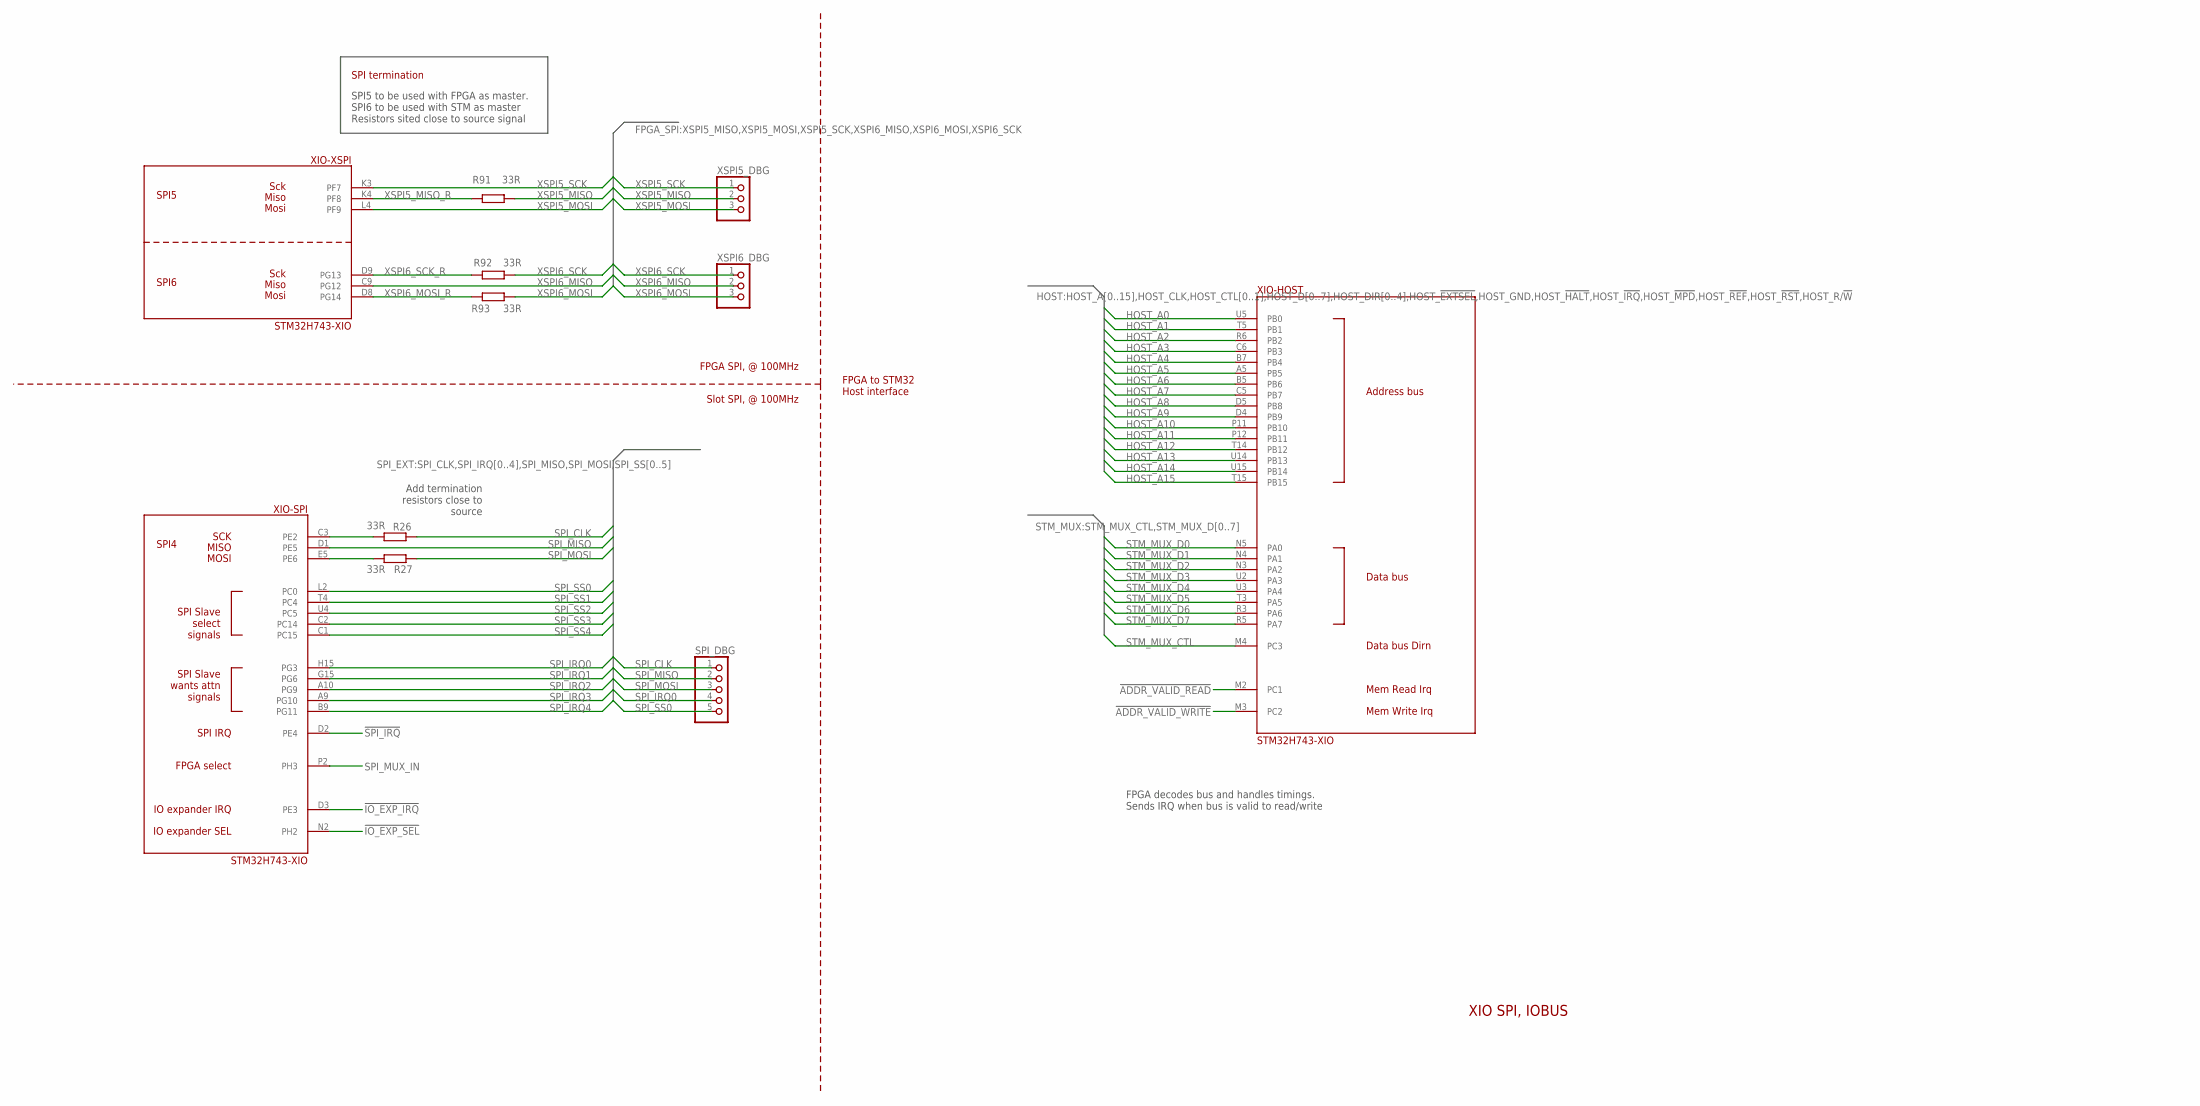
[picture p137: schematic xio2.sch, sheet 3, XIO SPI, IO-BUS]

Parts:
R26, R27, R91, R92, R93: 33R; R0201
SPI_DBG: PINHD-1X5; 1X05
XIO: STM32H743-XIO; BGA289C80P17X17_1400X1400X110
XSPI5_DBG, XSPI6_DBG: PINHD-1X3; 1X03

Connections:
!ADDR_VALID_READ!: XIO.M2 (PC1); also elsewhere on the board
!ADDR_VALID_WRITE!: XIO.M3 (PC2); also elsewhere on the board
!IO_EXP_IRQ!: XIO.D3 (PE3); also elsewhere on the board
!IO_EXP_SEL!: XIO.N2 (PH2); also elsewhere on the board
!SPI_IRQ!: XIO.D2 (PE4); also elsewhere on the board
HOST_A0: XIO.U5 (PB0); also elsewhere on the board
HOST_A1: XIO.T5 (PB1); also elsewhere on the board
HOST_A2: XIO.R6 (PB2); also elsewhere on the board
HOST_A3: XIO.C6 (PB3); also elsewhere on the board
HOST_A4: XIO.B7 (PB4); also elsewhere on the board
HOST_A5: XIO.A5 (PB5); also elsewhere on the board
HOST_A6: XIO.B5 (PB6); also elsewhere on the board
HOST_A7: XIO.C5 (PB7); also elsewhere on the board
HOST_A8: XIO.D5 (PB8); also elsewhere on the board
HOST_A9: XIO.D4 (PB9); also elsewhere on the board
HOST_A10: XIO.P11 (PB10); also elsewhere on the board
HOST_A11: XIO.P12 (PB11); also elsewhere on the board
HOST_A12: XIO.T14 (PB12); also elsewhere on the board
HOST_A13: XIO.U14 (PB13); also elsewhere on the board
HOST_A14: XIO.U15 (PB14); also elsewhere on the board
HOST_A15: XIO.T15 (PB15); also elsewhere on the board
unnamed: R26.2, XIO.C3 (PE2)
unnamed: R27.2, XIO.E5 (PE6)
SPI_CLK: R26.1, SPI_DBG.1; also elsewhere on the board
SPI_IRQ0: SPI_DBG.4, XIO.H15 (PG3); also elsewhere on the board
SPI_IRQ1: XIO.G15 (PG6); also elsewhere on the board
SPI_IRQ2: XIO.A10 (PG9); also elsewhere on the board
SPI_IRQ3: XIO.A9 (PG10); also elsewhere on the board
SPI_IRQ4: XIO.B9 (PG11); also elsewhere on the board
SPI_MISO: SPI_DBG.2, XIO.D1 (PE5); also elsewhere on the board
SPI_MOSI: R27.1, SPI_DBG.3; also elsewhere on the board
SPI_MUX_IN: XIO.P2 (PH3); also elsewhere on the board
SPI_SS0: SPI_DBG.5, XIO.L2 (PC0); also elsewhere on the board
SPI_SS1: XIO.T4 (PC4); also elsewhere on the board
SPI_SS2: XIO.U4 (PC5); also elsewhere on the board
SPI_SS3: XIO.C2 (PC14); also elsewhere on the board
SPI_SS4: XIO.C1 (PC15); also elsewhere on the board
STM_MUX_CTL: XIO.M4 (PC3); also elsewhere on the board
STM_MUX_D0: XIO.N5 (PA0); also elsewhere on the board
STM_MUX_D1: XIO.N4 (PA1); also elsewhere on the board
STM_MUX_D2: XIO.N3 (PA2); also elsewhere on the board
STM_MUX_D3: XIO.U2 (PA3); also elsewhere on the board
STM_MUX_D4: XIO.U3 (PA4); also elsewhere on the board
STM_MUX_D5: XIO.T3 (PA5); also elsewhere on the board
STM_MUX_D6: XIO.R3 (PA6); also elsewhere on the board
STM_MUX_D7: XIO.R5 (PA7); also elsewhere on the board
XSPI5_MISO: R91.2, XSPI5_DBG.2; also elsewhere on the board
XSPI5_MISO_R: R91.1, XIO.K4 (PF8)
XSPI5_MOSI: XIO.L4 (PF9), XSPI5_DBG.3; also elsewhere on the board
XSPI5_SCK: XIO.K3 (PF7), XSPI5_DBG.1; also elsewhere on the board
XSPI6_MISO: XIO.C9 (PG12), XSPI6_DBG.2; also elsewhere on the board
XSPI6_MOSI: R93.2, XSPI6_DBG.3; also elsewhere on the board
XSPI6_MOSI_R: R93.1, XIO.D8 (PG14)
XSPI6_SCK: R92.2, XSPI6_DBG.1; also elsewhere on the board
XSPI6_SCK_R: R92.1, XIO.D9 (PG13)

Notes on the sheet:
Slot SPI, @ 100MHz
XIO SPI, IOBUS
Add termination resistors close to source
SPI5 to be used with FPGA as master. SPI6 to be used with STM as master Resistors sited close to source signal
FPGA SPI, @ 100MHz
FPGA to STM32 Host interface
SPI termination
FPGA decodes bus and handles timings. Sends IRQ when bus is valid to read/write
