ThrudTheBarbarian/pbxl/boards/xio2/xio2.brd

## EAGLE design boards/xio2/xio2.brd (continued)

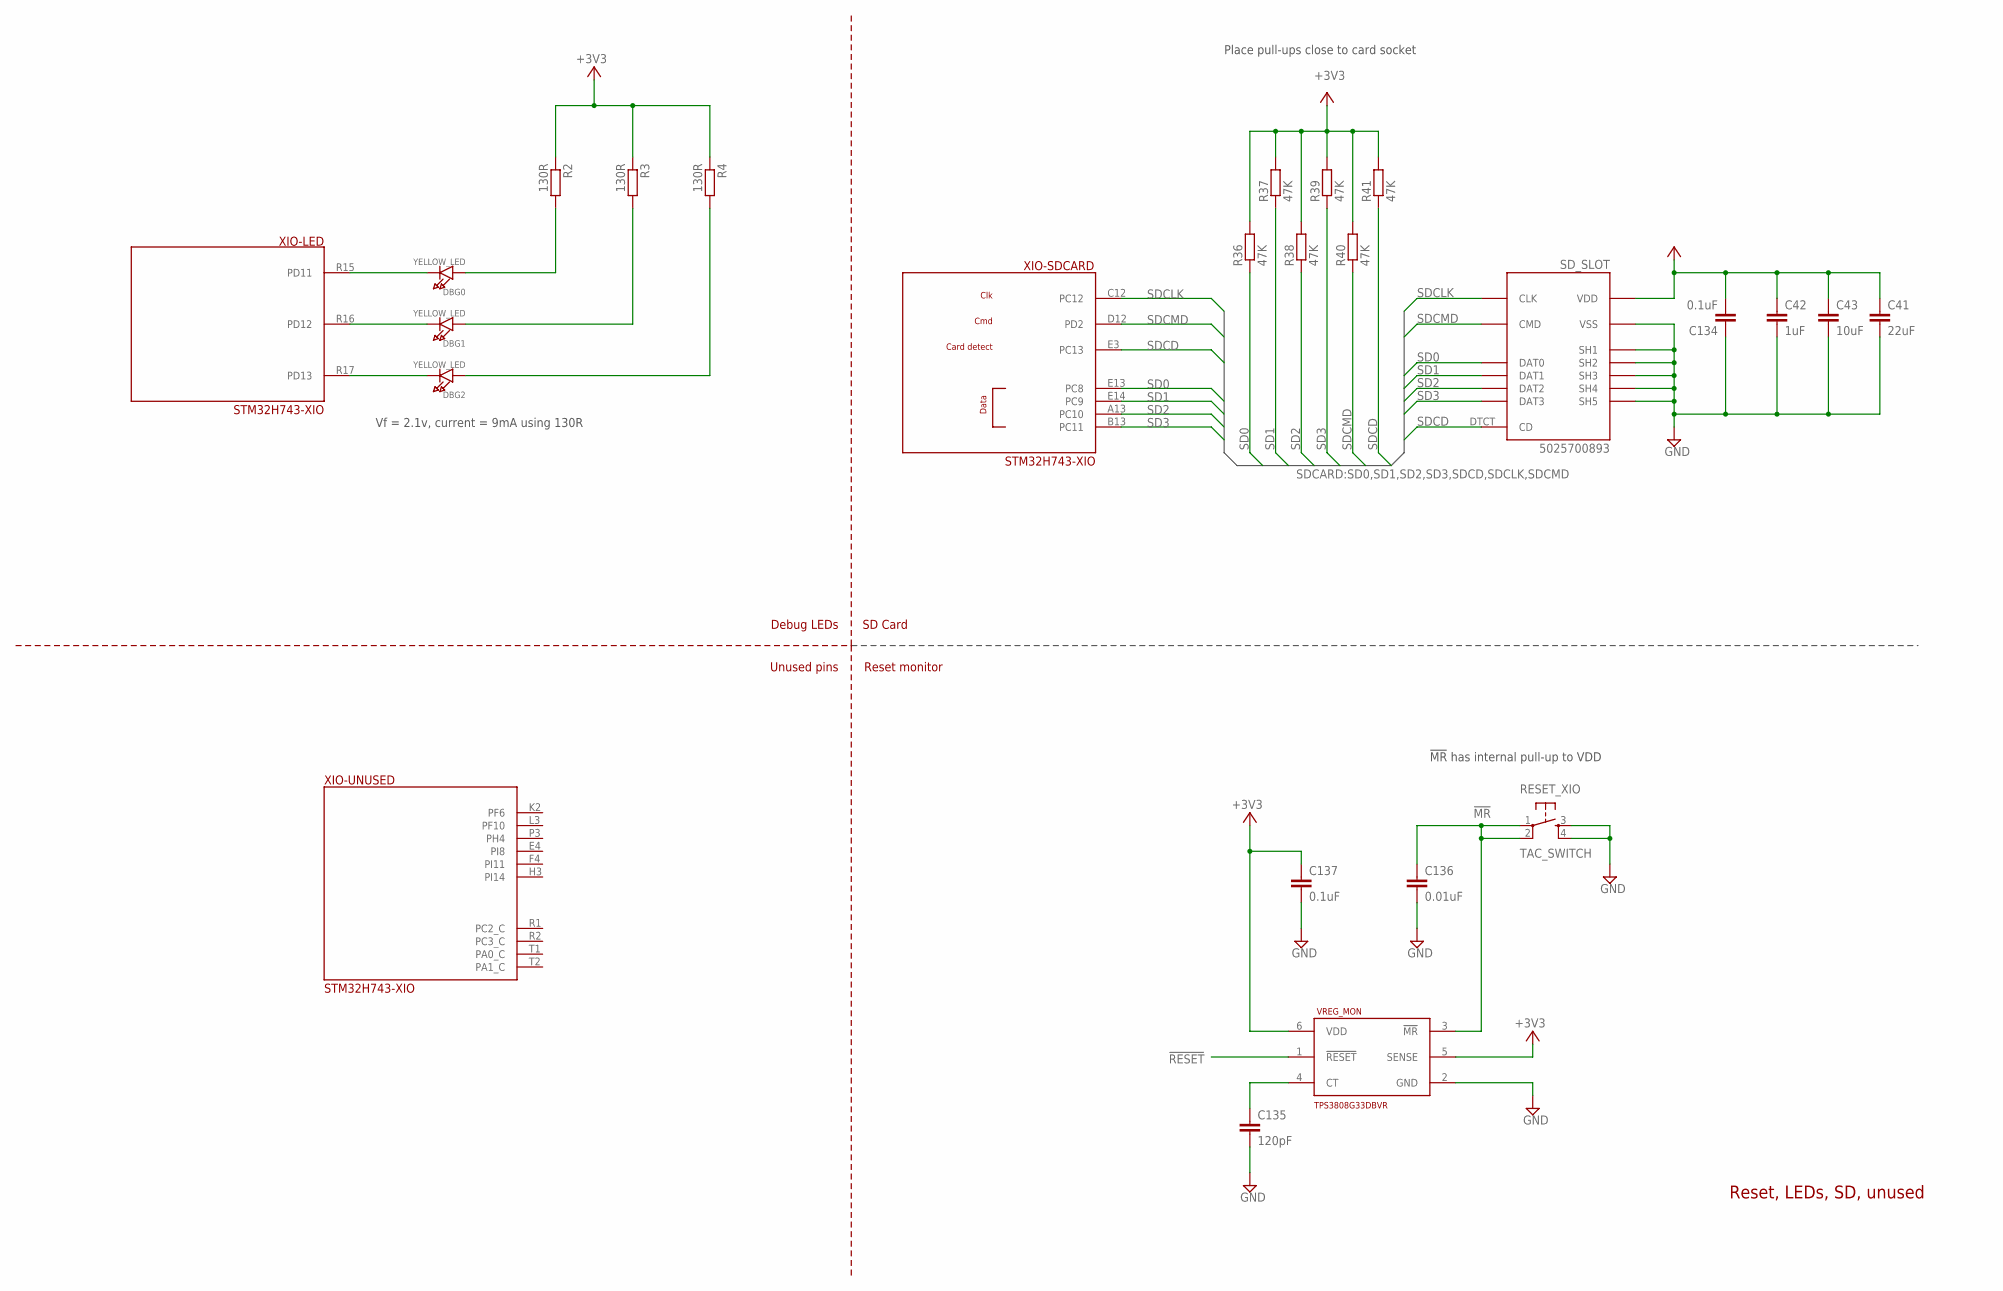
[picture p138: schematic xio2.sch, sheet 4, Reset / GPIO / Leds / SD card]

Parts:
C41: 22uF; C0805
C42: 1uF; C0201
C43: 10uF; C0402K
C134, C137: 0.1uF; C0201
C135: 120pF; C0201
C136: 0.01uF; C0201
DBG0, DBG1, DBG2: YELLOW_LED; CHIPLED_0603
R2, R3, R4: 130R; R0402
R36, R37, R38, R39, R40, R41: 47K; R0402
RESET_XIO: TAC_SWITCH; TACTILE-PTH
SD_SLOT: 5025700893
VREG_MON: TPS3808G33DBVR; SOT23-6
XIO: STM32H743-XIO; BGA289C80P17X17_1400X1400X110

Connections:
!MR!: C136.1, RESET_XIO.1, RESET_XIO.2, VREG_MON.3 (!MR!)
!RESET!: VREG_MON.1 (!RESET!); also elsewhere on the board
+3V3: C41.1, C42.1, C43.1, C134.2, C137.1, R2.1, R3.1, R4.1, R36.2, R37.2, R38.2, R39.2, R40.2, R41.2, SD_SLOT.P$4 (VDD), VREG_MON.5 (SENSE), VREG_MON.6 (VDD); also elsewhere on the board
GND: C41.2, C42.2, C43.2, C134.1, C135.2, C136.2, C137.2, RESET_XIO.3, RESET_XIO.4, SD_SLOT.GND0 (SH1), SD_SLOT.GND1 (SH2), SD_SLOT.GND2 (SH3), SD_SLOT.GND3 (SH4), SD_SLOT.GND4 (SH5), SD_SLOT.P$6 (VSS), VREG_MON.2 (GND); also elsewhere on the board
unnamed: DBG0.A, R2.2
unnamed: DBG0.C, XIO.R15 (PD11)
unnamed: DBG1.C, XIO.R16 (PD12)
unnamed: DBG2.C, XIO.R17 (PD13)
unnamed: DBG1.A, R3.2
unnamed: DBG2.A, R4.2
unnamed: C135.1, VREG_MON.4 (CT)
SD0: R36.1, SD_SLOT.P$7 (DAT0), XIO.E13 (PC8)
SD1: R37.1, SD_SLOT.P$8 (DAT1), XIO.E14 (PC9)
SD2: R38.1, SD_SLOT.P$1 (DAT2), XIO.A13 (PC10)
SD3: R39.1, SD_SLOT.P$2 (DAT3), XIO.B13 (PC11)
SDCD: R41.1, SD_SLOT.DTCT (CD), XIO.E3 (PC13)
SDCLK: SD_SLOT.P$5 (CLK), XIO.C12
SDCMD: R40.1, SD_SLOT.P$3 (CMD), XIO.D12 (PD2)

Notes on the sheet:
Debug LEDs
Unused pins
Reset, LEDs, SD, unused
Reset monitor
!MR! has internal pull-up to VDD
SD Card
Place pull-ups close to card socket
Vf = 2.1v, current = 9mA using 130R

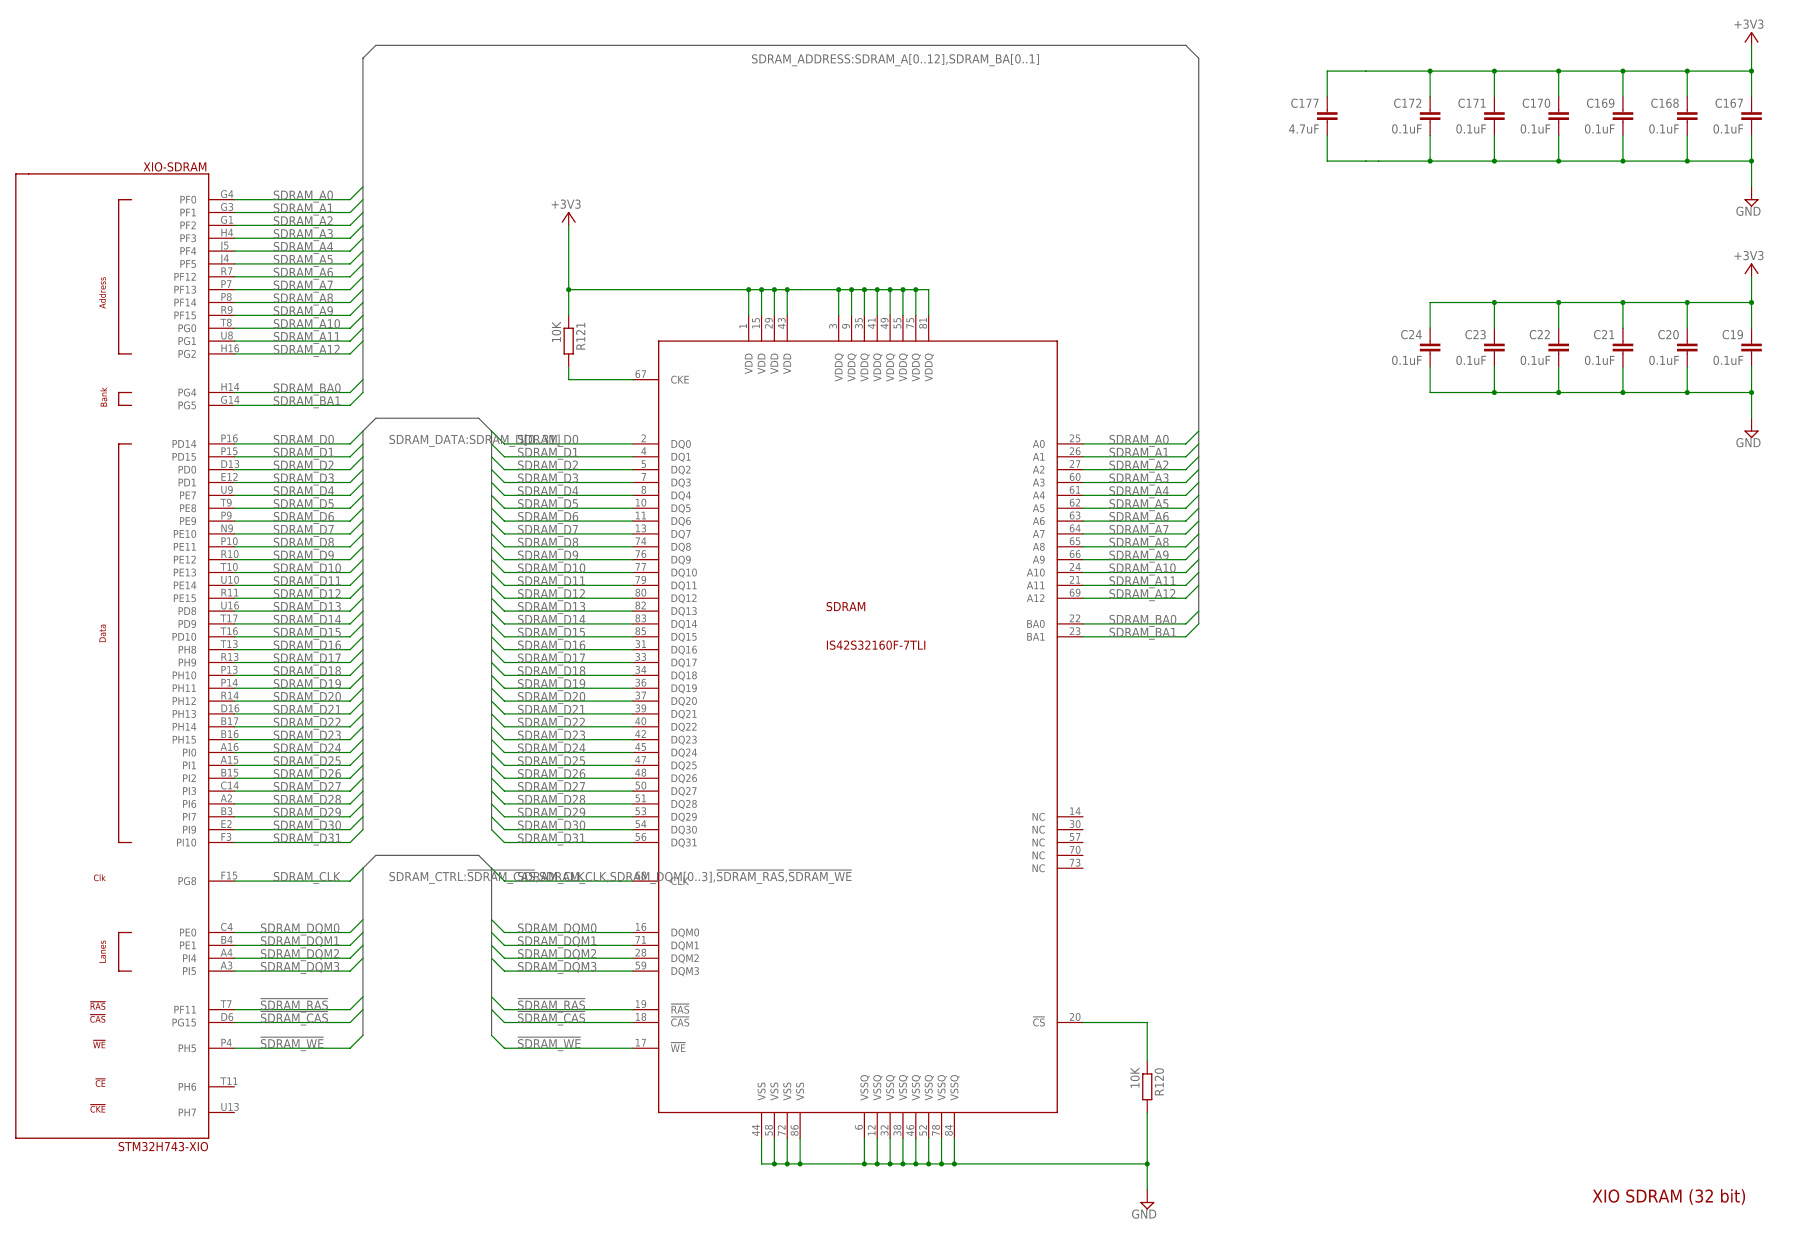
[picture p139: schematic xio2.sch, sheet 5, XIO SDRAM]

Parts:
C19, C20, C21, C22, C23, C24, C167, C168, C169, C170, C171, C172: 0.1uF; C0201
C177: 4.7uF; C0201
R120, R121: 10K; R0201
SDRAM: IS42S32160F-7TLI; SOP50P1176X120-86
XIO: STM32H743-XIO; BGA289C80P17X17_1400X1400X110

Connections:
!SDRAM_CAS!: SDRAM.18 (!CAS!), XIO.D6 (PG15)
!SDRAM_RAS!: SDRAM.19 (!RAS!), XIO.T7 (PF11)
!SDRAM_WE!: SDRAM.17 (!WE!), XIO.P4 (PH5)
+3V3: C19.1, C20.1, C21.1, C22.1, C23.1, C24.1, C167.1, C168.1, C169.1, C170.1, C171.1, C172.1, C177.1, R121.1, SDRAM.1 (VDD), SDRAM.3 (VDDQ), SDRAM.9 (VDDQ), SDRAM.15 (VDD), SDRAM.29 (VDD), SDRAM.35 (VDDQ), SDRAM.41 (VDDQ), SDRAM.43 (VDD), SDRAM.49 (VDDQ), SDRAM.55 (VDDQ), SDRAM.75 (VDDQ), SDRAM.81 (VDDQ); also elsewhere on the board
GND: C19.2, C20.2, C21.2, C22.2, C23.2, C24.2, C167.2, C168.2, C169.2, C170.2, C171.2, C172.2, C177.2, R120.2, SDRAM.6 (VSSQ), SDRAM.12 (VSSQ), SDRAM.32 (VSSQ), SDRAM.38 (VSSQ), SDRAM.44 (VSS), SDRAM.46 (VSSQ), SDRAM.52 (VSSQ), SDRAM.58 (VSS), SDRAM.72 (VSS), SDRAM.78 (VSSQ), SDRAM.84 (VSSQ), SDRAM.86 (VSS); also elsewhere on the board
unnamed: R121.2, SDRAM.67 (CKE)
unnamed: R120.1, SDRAM.20 (!CS!)
SDRAM_A0: SDRAM.25 (A0), XIO.G4 (PF0)
SDRAM_A1: SDRAM.26 (A1), XIO.G3 (PF1)
SDRAM_A2: SDRAM.27 (A2), XIO.G1 (PF2)
SDRAM_A3: SDRAM.60 (A3), XIO.H4 (PF3)
SDRAM_A4: SDRAM.61 (A4), XIO.J5 (PF4)
SDRAM_A5: SDRAM.62 (A5), XIO.J4 (PF5)
SDRAM_A6: SDRAM.63 (A6), XIO.R7 (PF12)
SDRAM_A7: SDRAM.64 (A7), XIO.P7 (PF13)
SDRAM_A8: SDRAM.65 (A8), XIO.P8 (PF14)
SDRAM_A9: SDRAM.66 (A9), XIO.R9 (PF15)
SDRAM_A10: SDRAM.24 (A10), XIO.T8 (PG0)
SDRAM_A11: SDRAM.21 (A11), XIO.U8 (PG1)
SDRAM_A12: SDRAM.69 (A12), XIO.H16 (PG2)
SDRAM_BA0: SDRAM.22 (BA0), XIO.H14 (PG4)
SDRAM_BA1: SDRAM.23 (BA1), XIO.G14 (PG5)
SDRAM_CLK: SDRAM.68 (CLK), XIO.F15 (PG8)
SDRAM_D0: SDRAM.2 (DQ0), XIO.P16 (PD14)
SDRAM_D1: SDRAM.4 (DQ1), XIO.P15 (PD15)
SDRAM_D2: SDRAM.5 (DQ2), XIO.D13 (PD0)
SDRAM_D3: SDRAM.7 (DQ3), XIO.E12 (PD1)
SDRAM_D4: SDRAM.8 (DQ4), XIO.U9 (PE7)
SDRAM_D5: SDRAM.10 (DQ5), XIO.T9 (PE8)
SDRAM_D6: SDRAM.11 (DQ6), XIO.P9 (PE9)
SDRAM_D7: SDRAM.13 (DQ7), XIO.N9 (PE10)
SDRAM_D8: SDRAM.74 (DQ8), XIO.P10 (PE11)
SDRAM_D9: SDRAM.76 (DQ9), XIO.R10 (PE12)
SDRAM_D10: SDRAM.77 (DQ10), XIO.T10 (PE13)
SDRAM_D11: SDRAM.79 (DQ11), XIO.U10 (PE14)
SDRAM_D12: SDRAM.80 (DQ12), XIO.R11 (PE15)
SDRAM_D13: SDRAM.82 (DQ13), XIO.U16 (PD8)
SDRAM_D14: SDRAM.83 (DQ14), XIO.T17 (PD9)
SDRAM_D15: SDRAM.85 (DQ15), XIO.T16 (PD10)
SDRAM_D16: SDRAM.31 (DQ16), XIO.T13 (PH8)
SDRAM_D17: SDRAM.33 (DQ17), XIO.R13 (PH9)
SDRAM_D18: SDRAM.34 (DQ18), XIO.P13 (PH10)
SDRAM_D19: SDRAM.36 (DQ19), XIO.P14 (PH11)
SDRAM_D20: SDRAM.37 (DQ20), XIO.R14 (PH12)
SDRAM_D21: SDRAM.39 (DQ21), XIO.D16 (PH13)
SDRAM_D22: SDRAM.40 (DQ22), XIO.B17 (PH14)
SDRAM_D23: SDRAM.42 (DQ23), XIO.B16 (PH15)
SDRAM_D24: SDRAM.45 (DQ24), XIO.A16 (PI0)
SDRAM_D25: SDRAM.47 (DQ25), XIO.A15 (PI1)
SDRAM_D26: SDRAM.48 (DQ26), XIO.B15 (PI2)
SDRAM_D27: SDRAM.50 (DQ27), XIO.C14 (PI3)
SDRAM_D28: SDRAM.51 (DQ28), XIO.A2 (PI6)
SDRAM_D29: SDRAM.53 (DQ29), XIO.B3 (PI7)
SDRAM_D30: SDRAM.54 (DQ30), XIO.E2 (PI9)
SDRAM_D31: SDRAM.56 (DQ31), XIO.F3 (PI10)
SDRAM_DQM0: SDRAM.16 (DQM0), XIO.C4 (PE0)
SDRAM_DQM1: SDRAM.71 (DQM1), XIO.B4 (PE1)
SDRAM_DQM2: SDRAM.28 (DQM2), XIO.A4 (PI4)
SDRAM_DQM3: SDRAM.59 (DQM3), XIO.A3 (PI5)

Notes on the sheet:
XIO SDRAM (32 bit)

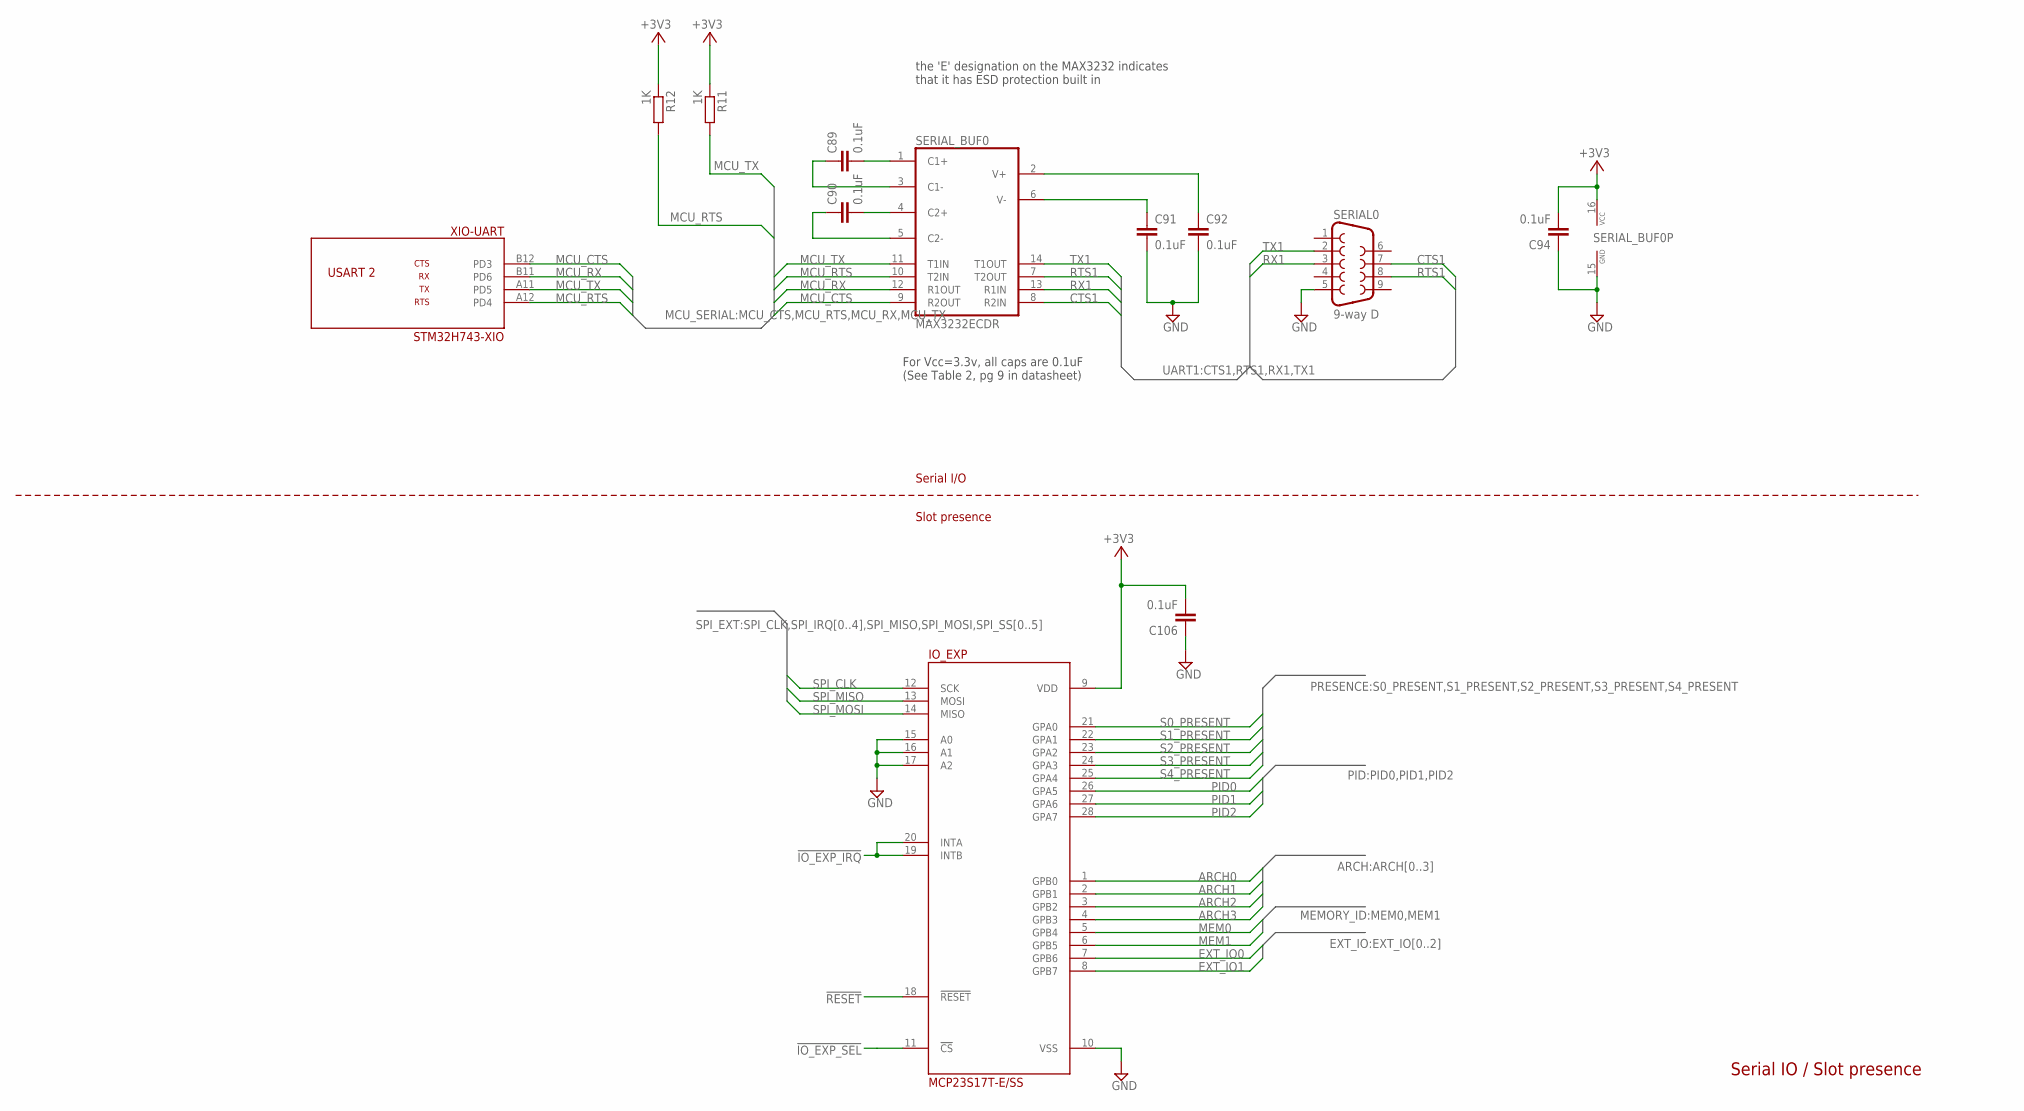
[picture p140: schematic xio2.sch, sheet 6, XIO Serial I/O]

Parts:
C89, C90, C91, C92, C94, C106: 0.1uF; C0201
IO_EXP: MCP23S17T-E/SS; SSOP28
R11, R12: 1K; R0201
SERIAL0: 9-way D; DB9
SERIAL_BUF0: MAX3232ECDR; SO16
XIO: STM32H743-XIO; BGA289C80P17X17_1400X1400X110

Connections:
!IO_EXP_IRQ!: IO_EXP.19 (INTB), IO_EXP.20 (INTA); also elsewhere on the board
!IO_EXP_SEL!: IO_EXP.11 (!CS!); also elsewhere on the board
!RESET!: IO_EXP.18 (!RESET!); also elsewhere on the board
+3V3: C94.2, C106.2, IO_EXP.9 (VDD), R11.1, R12.1, SERIAL_BUF0.16 (VCC); also elsewhere on the board
ARCH0: IO_EXP.1 (GPB0); also elsewhere on the board
ARCH1: IO_EXP.2 (GPB1); also elsewhere on the board
ARCH2: IO_EXP.3 (GPB2); also elsewhere on the board
ARCH3: IO_EXP.4 (GPB3); also elsewhere on the board
CTS1: SERIAL0.7, SERIAL_BUF0.8 (R2IN)
EXT_IO0: IO_EXP.7 (GPB6); also elsewhere on the board
EXT_IO1: IO_EXP.8 (GPB7); also elsewhere on the board
GND: C91.2, C92.2, C94.1, C106.1, IO_EXP.10 (VSS), IO_EXP.15 (A0), IO_EXP.16 (A1), IO_EXP.17 (A2), SERIAL0.5, SERIAL_BUF0.15 (GND); also elsewhere on the board
MCU_CTS: SERIAL_BUF0.9 (R2OUT), XIO.B12 (PD3)
MCU_RTS: R12.2, SERIAL_BUF0.10 (T2IN), XIO.A12 (PD4)
MCU_RX: SERIAL_BUF0.12 (R1OUT), XIO.B11 (PD6)
MCU_TX: R11.2, SERIAL_BUF0.11 (T1IN), XIO.A11 (PD5)
MEM0: IO_EXP.5 (GPB4); also elsewhere on the board
MEM1: IO_EXP.6 (GPB5); also elsewhere on the board
unnamed: C89.2, SERIAL_BUF0.1 (C1+)
unnamed: C89.1, SERIAL_BUF0.3 (C1-)
unnamed: C90.2, SERIAL_BUF0.4 (C2+)
unnamed: C90.1, SERIAL_BUF0.5 (C2-)
unnamed: C91.1, SERIAL_BUF0.6 (V-)
unnamed: C92.1, SERIAL_BUF0.2 (V+)
PID0: IO_EXP.26 (GPA5); also elsewhere on the board
PID1: IO_EXP.27 (GPA6); also elsewhere on the board
PID2: IO_EXP.28 (GPA7); also elsewhere on the board
RTS1: SERIAL0.8, SERIAL_BUF0.7 (T2OUT)
RX1: SERIAL0.3, SERIAL_BUF0.13 (R1IN)
S0_PRESENT: IO_EXP.21 (GPA0); also elsewhere on the board
S1_PRESENT: IO_EXP.22 (GPA1); also elsewhere on the board
S2_PRESENT: IO_EXP.23 (GPA2); also elsewhere on the board
S3_PRESENT: IO_EXP.24 (GPA3); also elsewhere on the board
S4_PRESENT: IO_EXP.25 (GPA4); also elsewhere on the board
SPI_CLK: IO_EXP.12 (SCK); also elsewhere on the board
SPI_MISO: IO_EXP.13 (MOSI); also elsewhere on the board
SPI_MOSI: IO_EXP.14 (MISO); also elsewhere on the board
TX1: SERIAL0.2, SERIAL_BUF0.14 (T1OUT)

Notes on the sheet:
Serial IO / Slot presence
For Vcc=3.3v, all caps are 0.1uF (See Table 2, pg 9 in datasheet)
the 'E' designation on the MAX3232 indicates that it has ESD protection built in
Serial I/O
Slot presence

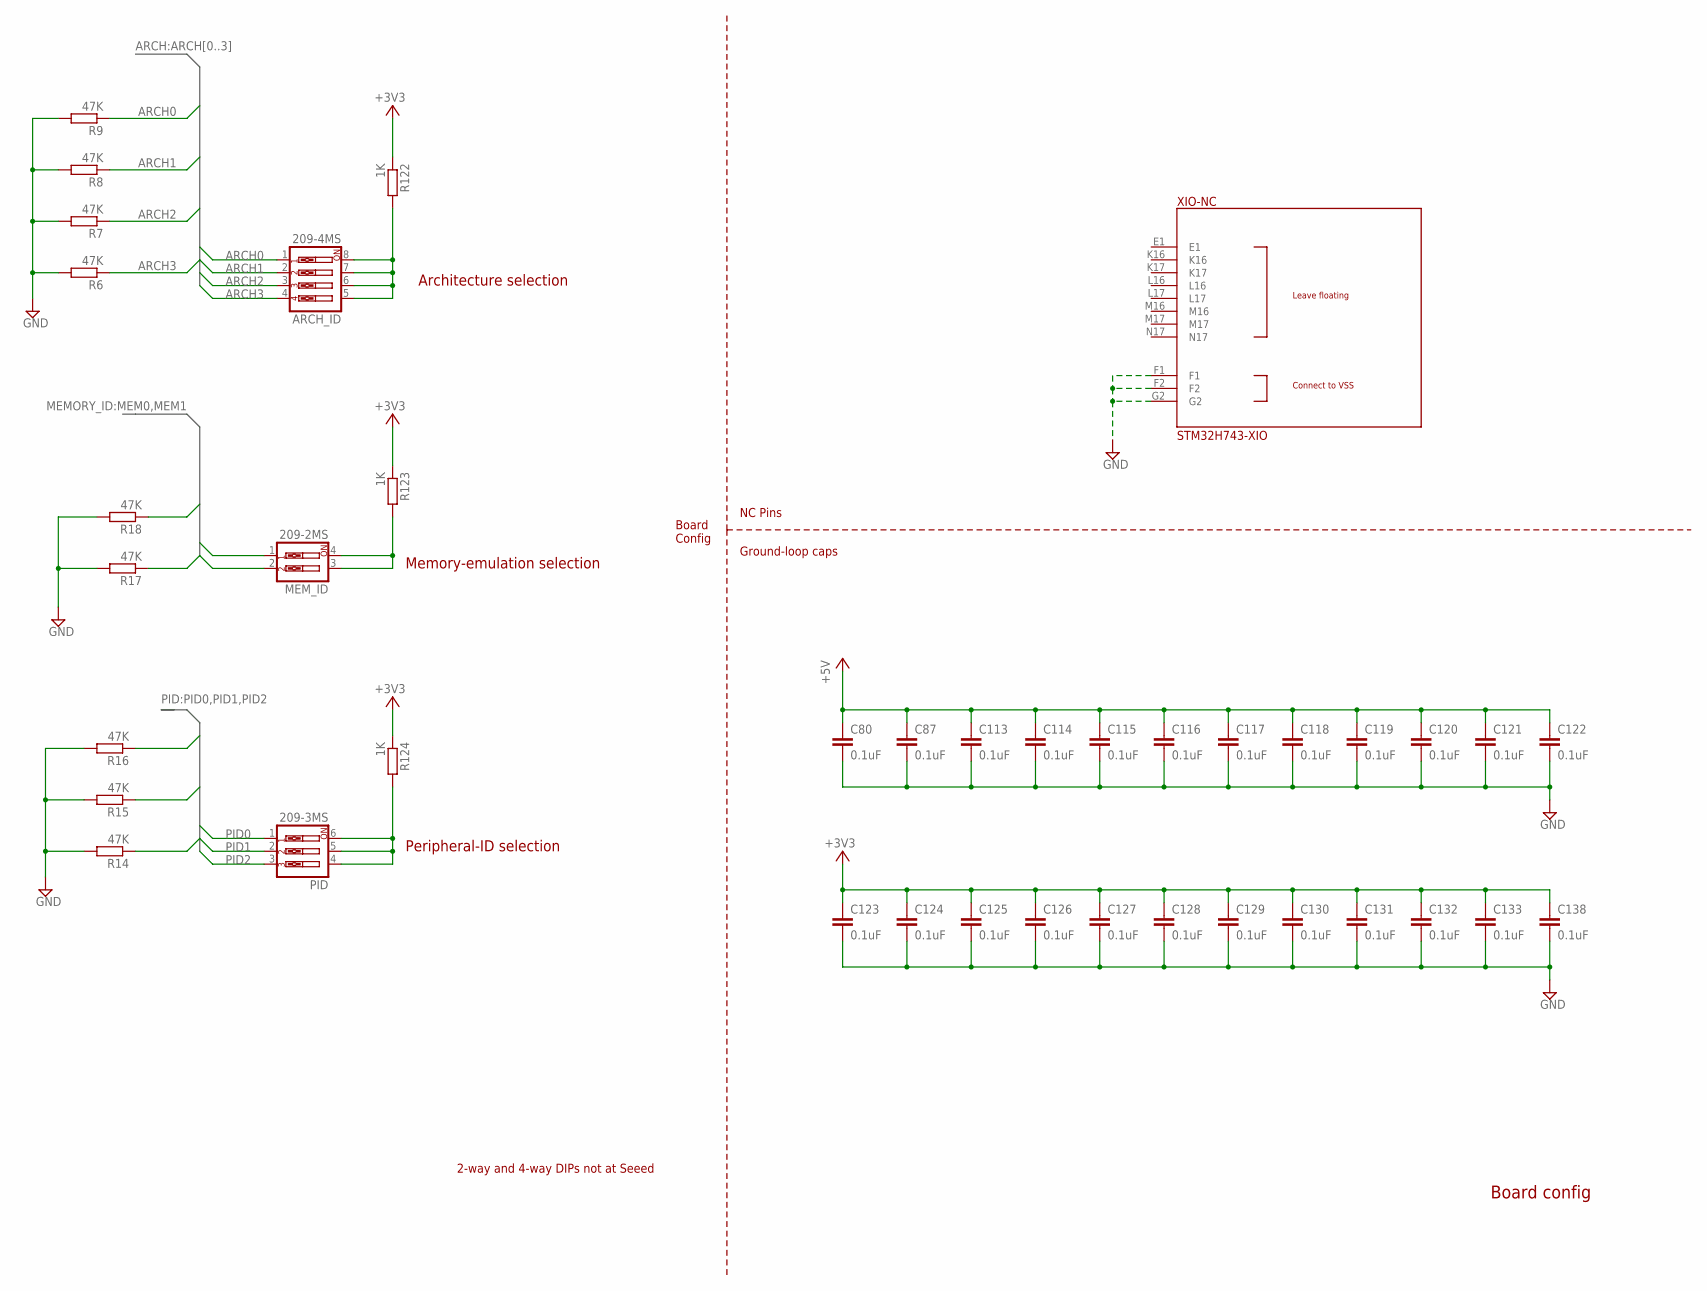
[picture p141: schematic xio2.sch, sheet 7, Board config]

Parts:
ARCH_ID: 209-4MS; EDG-04
C80, C87, C113, C114, C115, C116, C117, C118, C119, C120, C121, C122, C123, C124, C125, C126, C127, C128, C129, C130, C131, C132, C133, C138: 0.1uF; C0201
MEM_ID: 209-2MS; EDG-02
PID: 209-3MS; EDG-03
R6, R7, R8, R9, R14, R15, R16, R17, R18: 47K; R0201
R122, R123, R124: 1K; R0201
XIO: STM32H743-XIO; BGA289C80P17X17_1400X1400X110

Connections:
+3V3: C123.1, C124.1, C125.1, C126.1, C127.1, C128.1, C129.1, C130.1, C131.1, C132.1, C133.1, C138.1, R122.1, R123.1, R124.1; also elsewhere on the board
+5V: C80.1, C87.1, C113.1, C114.1, C115.1, C116.1, C117.1, C118.1, C119.1, C120.1, C121.1, C122.1; also elsewhere on the board
ARCH0: ARCH_ID.1, R9.1; also elsewhere on the board
ARCH1: ARCH_ID.2, R8.1; also elsewhere on the board
ARCH2: ARCH_ID.3, R7.1; also elsewhere on the board
ARCH3: ARCH_ID.4, R6.1; also elsewhere on the board
GND: C80.2, C87.2, C113.2, C114.2, C115.2, C116.2, C117.2, C118.2, C119.2, C120.2, C121.2, C122.2, C123.2, C124.2, C125.2, C126.2, C127.2, C128.2, C129.2, C130.2, C131.2, C132.2, C133.2, C138.2, R6.2, R7.2, R8.2, R9.2, R14.2, R15.2, R16.2, R17.2, R18.2, XIO.F1, XIO.F2, XIO.G2; also elsewhere on the board
MEM0: MEM_ID.1, R18.1; also elsewhere on the board
MEM1: MEM_ID.2, R17.1; also elsewhere on the board
unnamed: ARCH_ID.5, ARCH_ID.6, ARCH_ID.7, ARCH_ID.8, R122.2
unnamed: MEM_ID.3, MEM_ID.4, R123.2
unnamed: PID.4, PID.5, PID.6, R124.2
PID0: PID.1, R16.1; also elsewhere on the board
PID1: PID.2, R15.1; also elsewhere on the board
PID2: PID.3, R14.1; also elsewhere on the board

Notes on the sheet:
Architecture selection
Peripheral-ID selection
Memory-emulation selection
Board config
Board Config
NC Pins
Ground-loop caps
2-way and 4-way DIPs not at Seeed

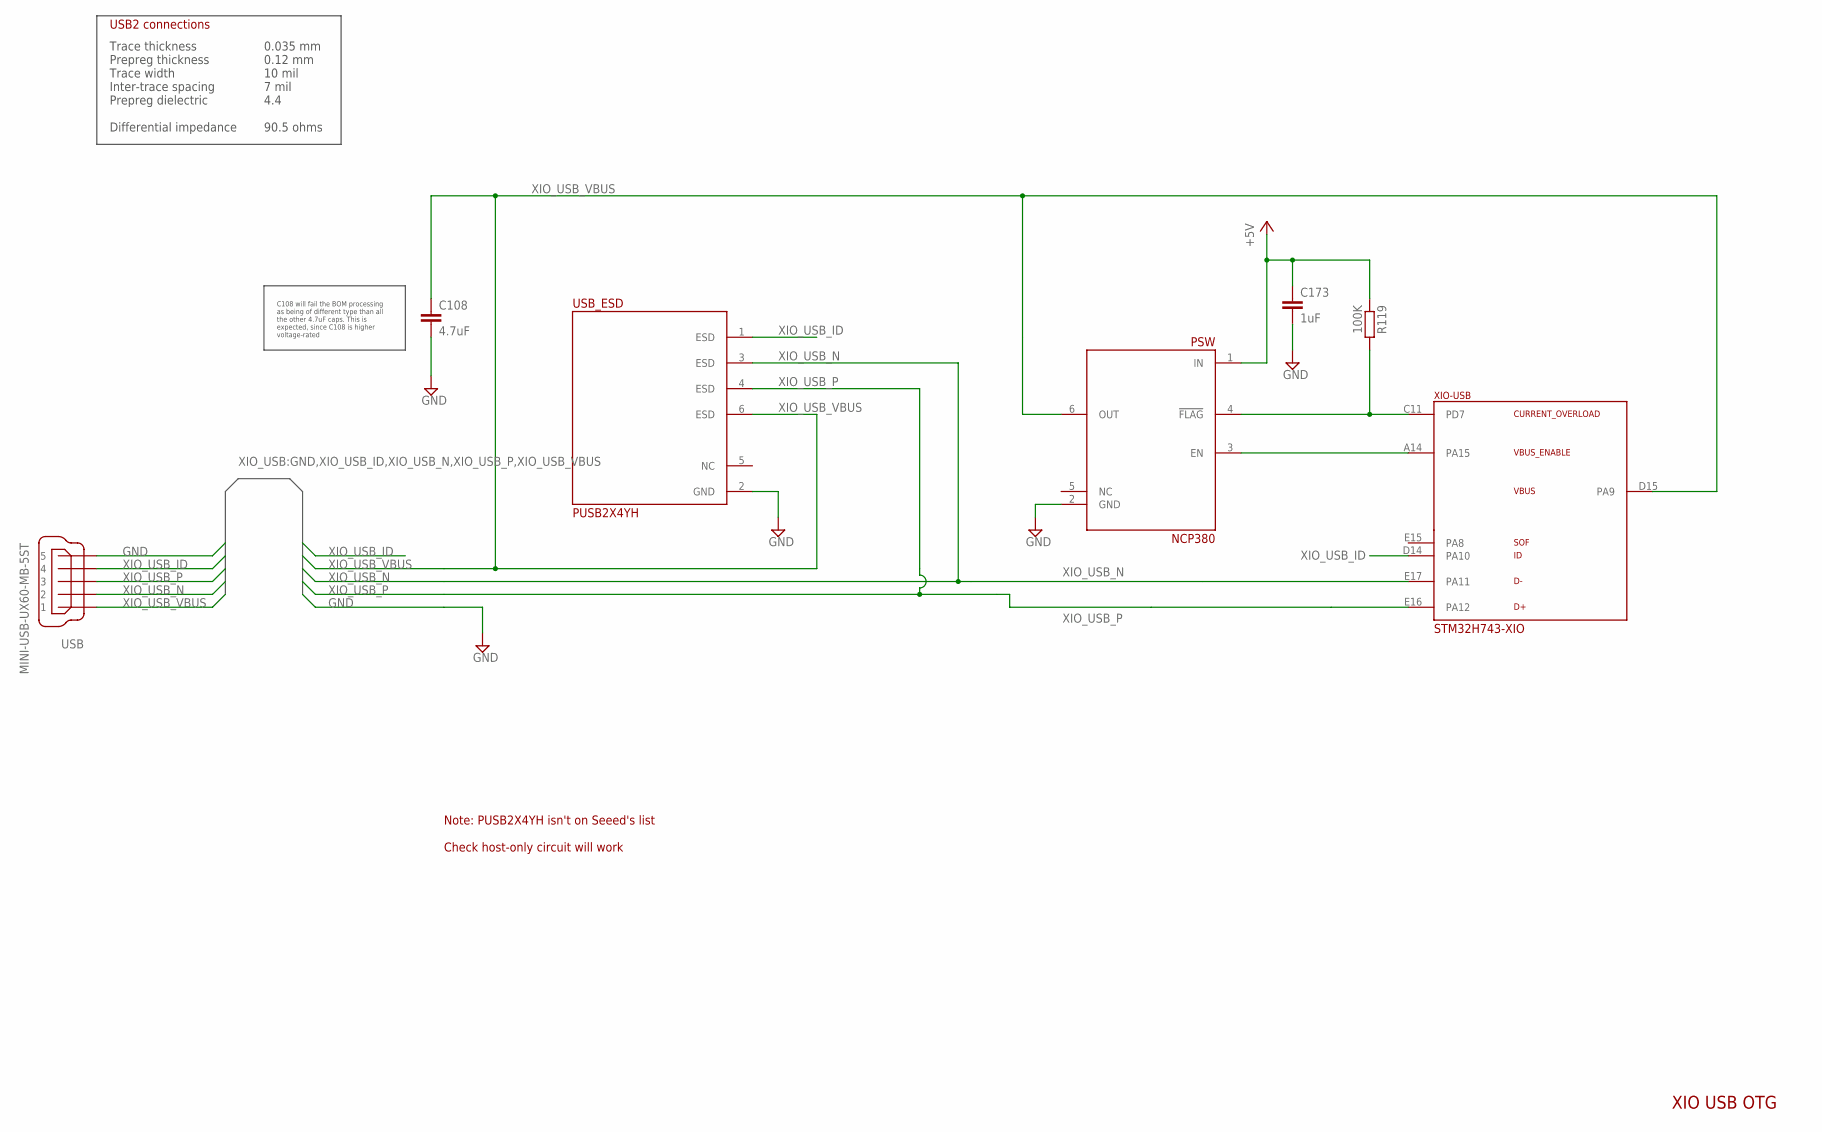
[picture p142: schematic xio2.sch, sheet 8, XIO USB OTG]

Parts:
C108: 4.7uF; C0402
C173: 1uF; C0201
PSW: NCP380; SOT23-6
R119: 100K; R0201
USB: MINI-USB-UX60-MB-5ST; UX60-MB-5ST
USB_ESD: PUSB2X4YH; SOT363
XIO: STM32H743-XIO; BGA289C80P17X17_1400X1400X110

Connections:
+5V: C173.1, PSW.1 (IN), R119.1; also elsewhere on the board
GND: C108.2, C173.2, PSW.2 (GND), USB.5, USB_ESD.2 (GND); also elsewhere on the board
unnamed: PSW.3 (EN), XIO.A14 (PA15)
unnamed: PSW.4 (!FLAG!), R119.2, XIO.C11 (PD7)
XIO_USB_ID: USB.4, USB_ESD.1 (ESD), XIO.D14 (PA10)
XIO_USB_N: USB.2, USB_ESD.3 (ESD), XIO.E17 (PA11)
XIO_USB_P: USB.3, USB_ESD.4 (ESD), XIO.E16 (PA12)
XIO_USB_VBUS: C108.1, PSW.6 (OUT), USB.1, USB_ESD.6 (ESD), XIO.D15 (PA9)

Notes on the sheet:
XIO USB OTG
Trace thickness Prepreg thickness Trace width Inter-trace spacing Prepreg dielectric Differential impedance
0.035 mm 0.12 mm 10 mil 7 mil 4.4 90.5 ohms
USB2 connections
Note: PUSB2X4YH isn't on Seeed's list Check host-only circuit will work
C108 will fail the BOM processing as being of different type than all the other 4.7uF caps. This is expected, since C108 is higher voltage-rated

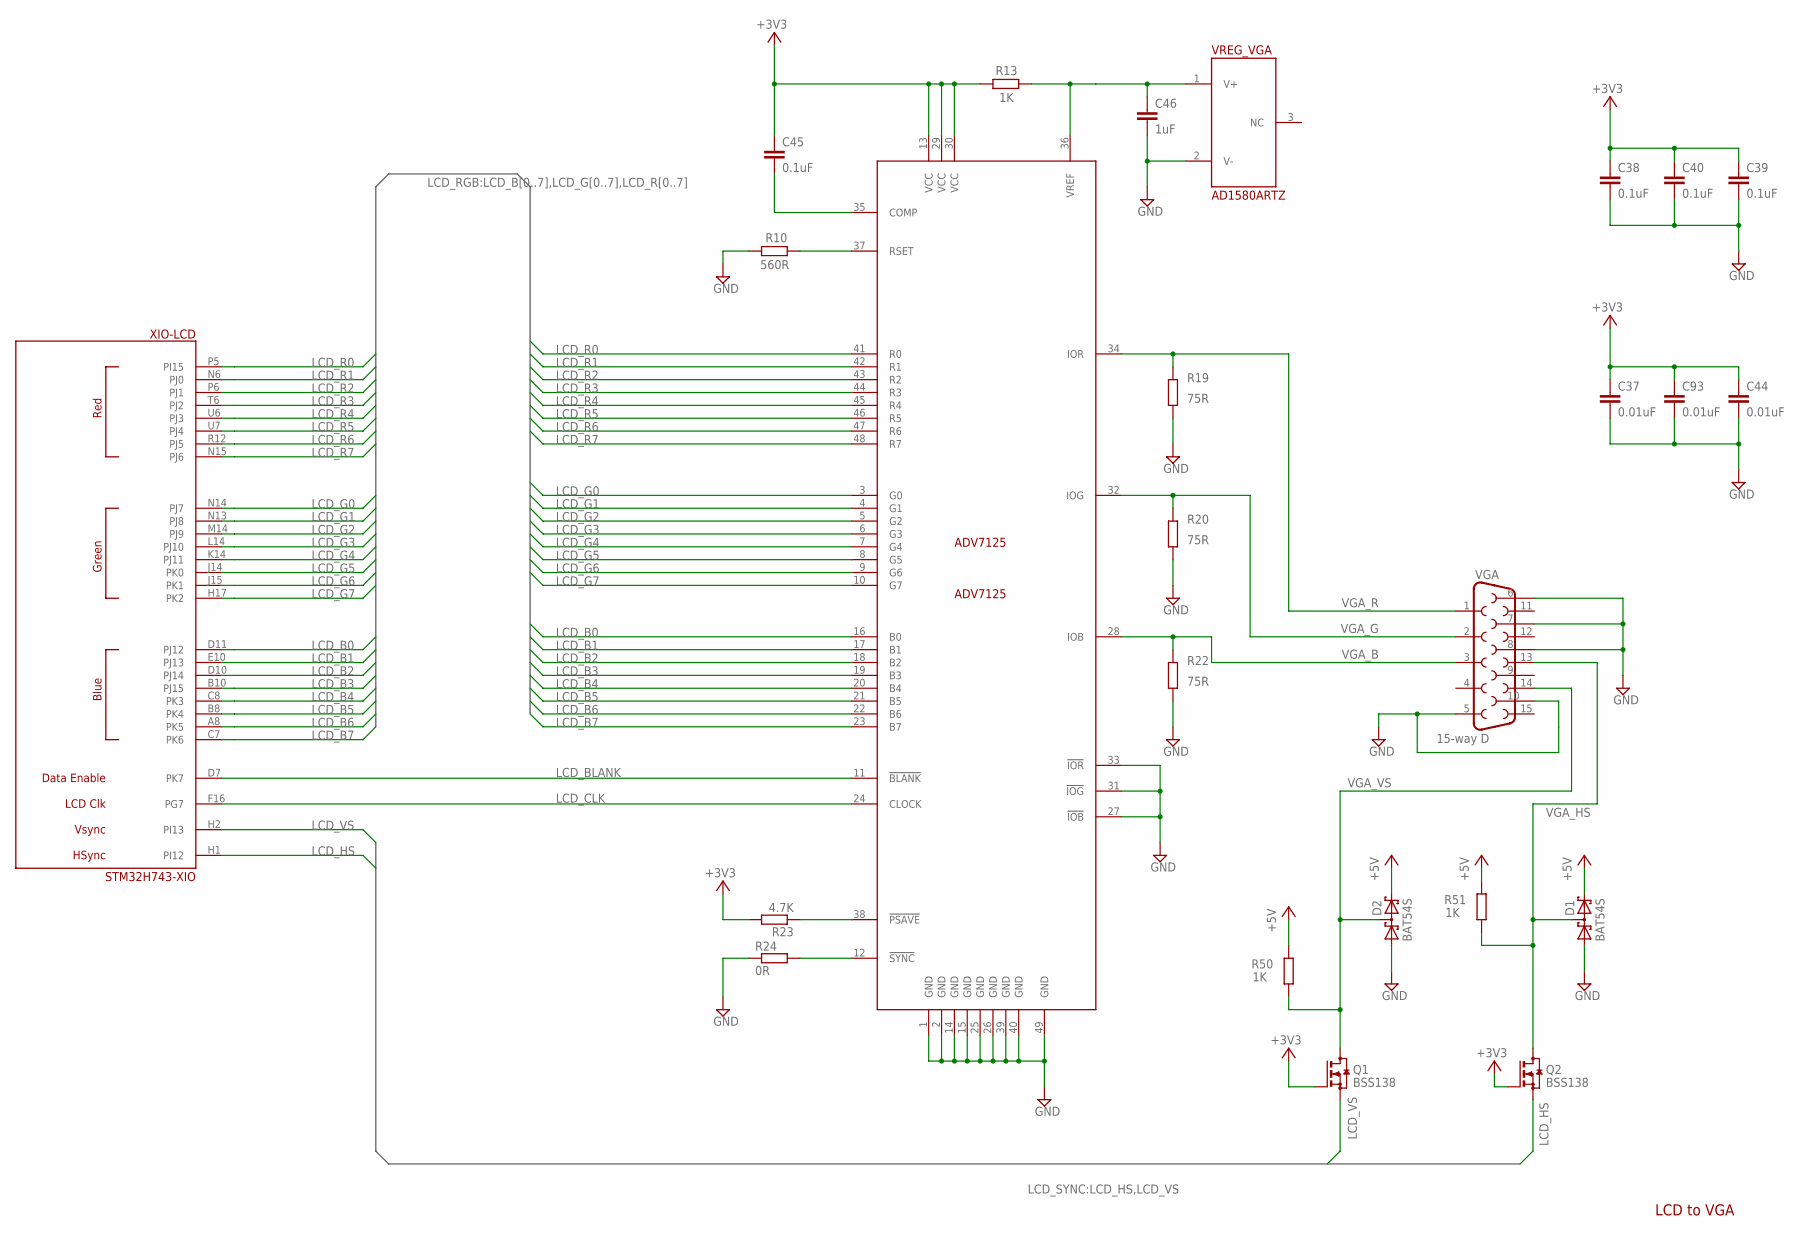
[picture p143: schematic xio2.sch, sheet 9, LTDC VGA]

Parts:
ADV7125: ADV7125; QFN50P700X700X100-49T495
C37, C44, C93: 0.01uF; C0201
C38, C39, C40, C45: 0.1uF; C0201
C46: 1uF; C0201
D1, D2: BAT54S; SOT23
Q1, Q2: BSS138; SOT23
R10: 560R; R0201
R13, R50, R51: 1K; R0201
R19, R20, R22: 75R; R0201
R23: 4.7K; R0201
R24: 0R; R0201
VGA: 15-way D; DB15
VREG_VGA: AD1580ARTZ; SOT23
XIO: STM32H743-XIO; BGA289C80P17X17_1400X1400X110

Connections:
+3V3: ADV7125.13 (VCC), ADV7125.29 (VCC), ADV7125.30 (VCC), C37.1, C38.1, C39.1, C40.1, C44.1, C45.1, C93.1, Q1.1 (G), Q2.1 (G), R13.2, R23.2; also elsewhere on the board
+5V: D1.2 (C2), D2.2 (C2), R50.1, R51.1; also elsewhere on the board
GND: ADV7125.1 (GND), ADV7125.2 (GND), ADV7125.14 (GND), ADV7125.15 (GND), ADV7125.25 (GND), ADV7125.26 (GND), ADV7125.27 (!IOB!), ADV7125.31 (!IOG!), ADV7125.33 (!IOR!), ADV7125.39 (GND), ADV7125.40 (GND), ADV7125.49 (GND), C37.2, C38.2, C39.2, C40.2, C44.2, C46.2, C93.2, D1.1 (A1), D2.1 (A1), R10.1, R19.2, R20.2, R22.2, R24.1, VGA.5, VGA.6, VGA.7, VGA.8, VGA.10, VREG_VGA.2 (V-); also elsewhere on the board
LCD_B0: ADV7125.16 (B0), XIO.D11 (PJ12)
LCD_B1: ADV7125.17 (B1), XIO.E10 (PJ13)
LCD_B2: ADV7125.18 (B2), XIO.D10 (PJ14)
LCD_B3: ADV7125.19 (B3), XIO.B10 (PJ15)
LCD_B4: ADV7125.20 (B4), XIO.C8 (PK3)
LCD_B5: ADV7125.21 (B5), XIO.B8 (PK4)
LCD_B6: ADV7125.22 (B6), XIO.A8 (PK5)
LCD_B7: ADV7125.23 (B7), XIO.C7 (PK6)
LCD_BLANK: ADV7125.11 (!BLANK!), XIO.D7 (PK7)
LCD_CLK: ADV7125.24 (CLOCK), XIO.F16 (PG7)
LCD_G0: ADV7125.3 (G0), XIO.N14 (PJ7)
LCD_G1: ADV7125.4 (G1), XIO.N13 (PJ8)
LCD_G2: ADV7125.5 (G2), XIO.M14 (PJ9)
LCD_G3: ADV7125.6 (G3), XIO.L14 (PJ10)
LCD_G4: ADV7125.7 (G4), XIO.K14 (PJ11)
LCD_G5: ADV7125.8 (G5), XIO.J14 (PK0)
LCD_G6: ADV7125.9 (G6), XIO.J15 (PK1)
LCD_G7: ADV7125.10 (G7), XIO.H17 (PK2)
LCD_HS: Q2.2 (S), XIO.H1 (PI12)
LCD_R0: ADV7125.41 (R0), XIO.P5 (PI15)
LCD_R1: ADV7125.42 (R1), XIO.N6 (PJ0)
LCD_R2: ADV7125.43 (R2), XIO.P6 (PJ1)
LCD_R3: ADV7125.44 (R3), XIO.T6 (PJ2)
LCD_R4: ADV7125.45 (R4), XIO.U6 (PJ3)
LCD_R5: ADV7125.46 (R5), XIO.U7 (PJ4)
LCD_R6: ADV7125.47 (R6), XIO.R12 (PJ5)
LCD_R7: ADV7125.48 (R7), XIO.N15 (PJ6)
LCD_VS: Q1.2 (S), XIO.H2 (PI13)
unnamed: ADV7125.36 (VREF), C46.1, R13.1, VREG_VGA.1 (V+)
unnamed: ADV7125.35 (COMP), C45.2
unnamed: ADV7125.38 (!PSAVE!), R23.1
unnamed: ADV7125.37 (RSET), R10.2
unnamed: ADV7125.12 (!SYNC!), R24.2
VGA_B: ADV7125.28 (IOB), R22.1, VGA.3
VGA_G: ADV7125.32 (IOG), R20.1, VGA.2
VGA_HS: D1.3 (C1A2), Q2.3 (D), R51.2, VGA.13
VGA_R: ADV7125.34 (IOR), R19.1, VGA.1
VGA_VS: D2.3 (C1A2), Q1.3 (D), R50.2, VGA.14

Notes on the sheet:
LCD to VGA
