ThrudTheBarbarian/pbxl/boards/xio2/xio2.brd

## EAGLE design boards/xio2/xio2.brd (continued)

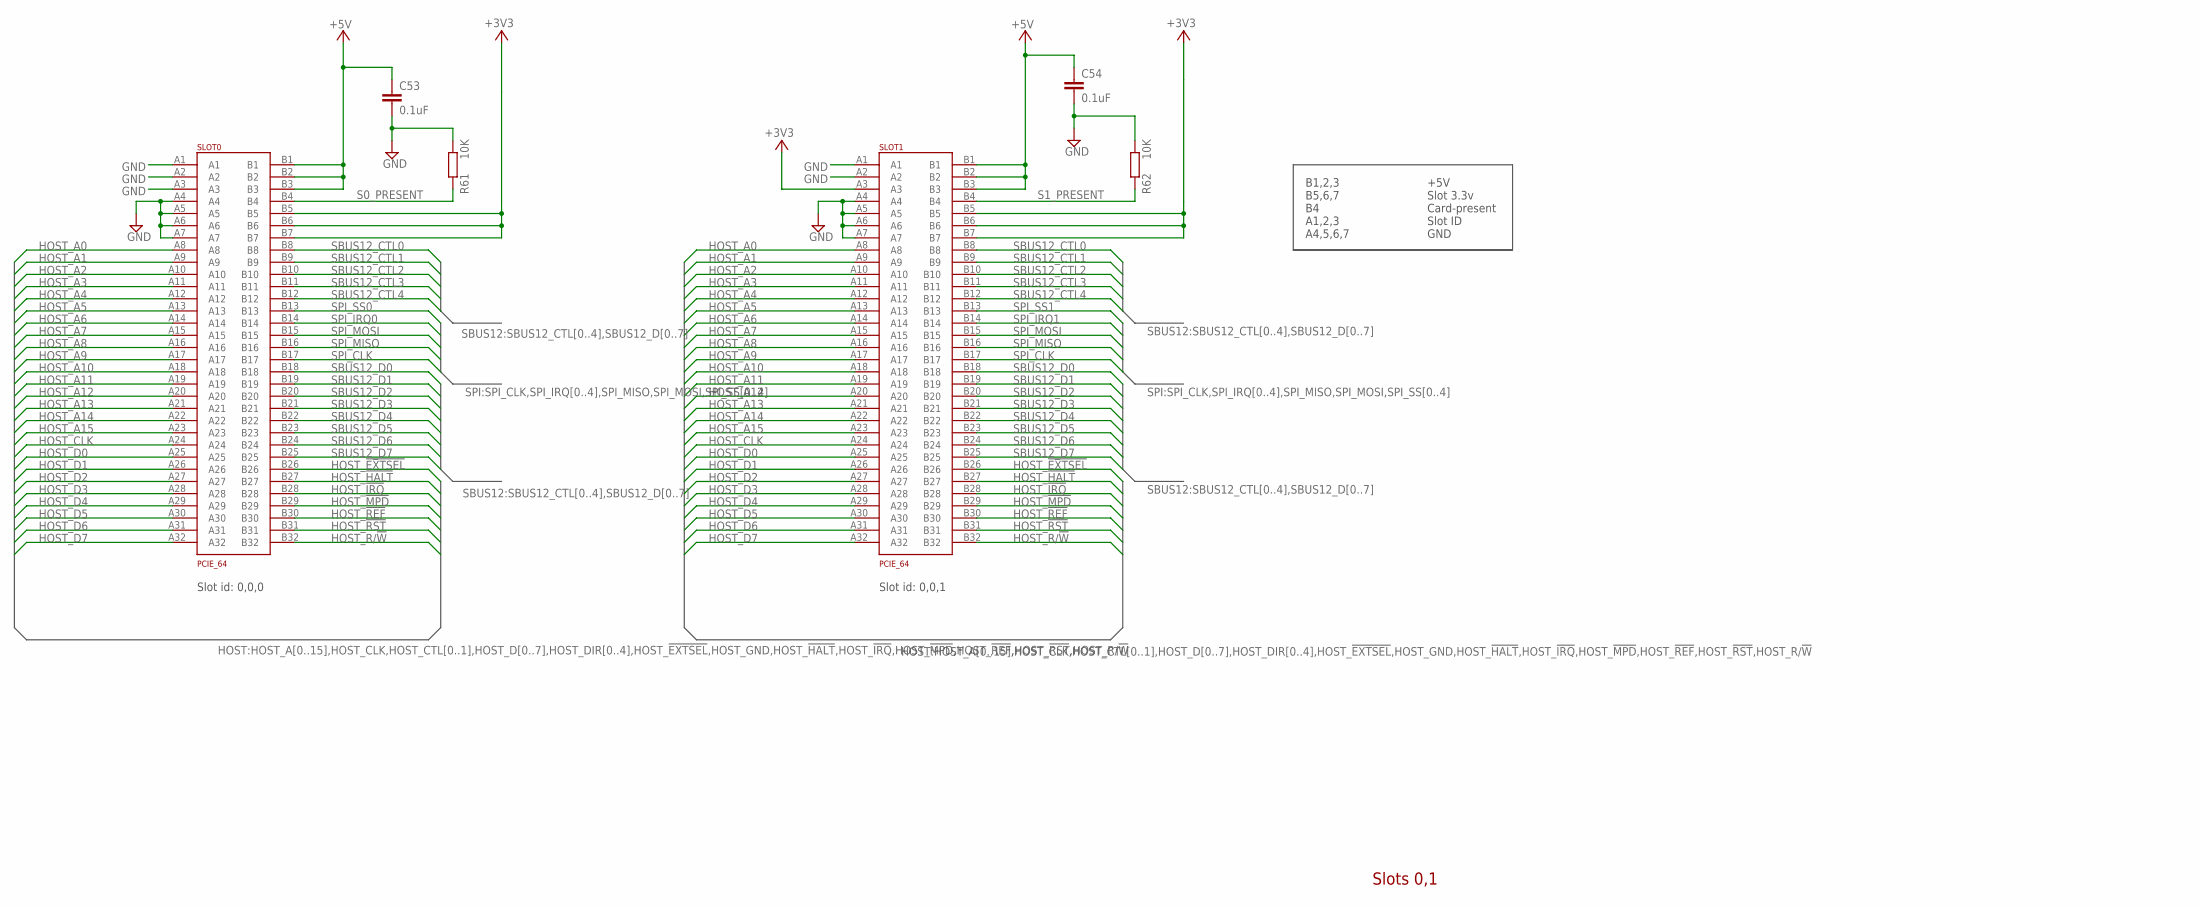
[picture p144: schematic xio2.sch, sheet 10, Expansion slots 0 & 1]

Parts:
C53, C54: 0.1uF; C0201
R61, R62: 10K; R0201
SLOT0, SLOT1: PCIE_64; PCI-E_64

Connections:
+3V3: SLOT0.B5, SLOT0.B6, SLOT0.B7, SLOT1.A3, SLOT1.B5, SLOT1.B6, SLOT1.B7; also elsewhere on the board
+5V: C53.1, C54.1, SLOT0.B1, SLOT0.B2, SLOT0.B3, SLOT1.B1, SLOT1.B2, SLOT1.B3; also elsewhere on the board
GND: C53.2, C54.2, R61.1, R62.1, SLOT0.A1, SLOT0.A2, SLOT0.A3, SLOT0.A4, SLOT0.A5, SLOT0.A6, SLOT0.A7, SLOT1.A1, SLOT1.A2, SLOT1.A4, SLOT1.A5, SLOT1.A6, SLOT1.A7; also elsewhere on the board
HOST_!EXTSEL!: SLOT0.B26, SLOT1.B26; also elsewhere on the board
HOST_!HALT!: SLOT0.B27, SLOT1.B27; also elsewhere on the board
HOST_!IRQ!: SLOT0.B28, SLOT1.B28; also elsewhere on the board
HOST_!MPD!: SLOT0.B29, SLOT1.B29; also elsewhere on the board
HOST_!REF!: SLOT0.B30, SLOT1.B30; also elsewhere on the board
HOST_!RST!: SLOT0.B31, SLOT1.B31; also elsewhere on the board
HOST_A0: SLOT0.A8, SLOT1.A8; also elsewhere on the board
HOST_A1: SLOT0.A9, SLOT1.A9; also elsewhere on the board
HOST_A2: SLOT0.A10, SLOT1.A10; also elsewhere on the board
HOST_A3: SLOT0.A11, SLOT1.A11; also elsewhere on the board
HOST_A4: SLOT0.A12, SLOT1.A12; also elsewhere on the board
HOST_A5: SLOT0.A13, SLOT1.A13; also elsewhere on the board
HOST_A6: SLOT0.A14, SLOT1.A14; also elsewhere on the board
HOST_A7: SLOT0.A15, SLOT1.A15; also elsewhere on the board
HOST_A8: SLOT0.A16, SLOT1.A16; also elsewhere on the board
HOST_A9: SLOT0.A17, SLOT1.A17; also elsewhere on the board
HOST_A10: SLOT0.A18, SLOT1.A18; also elsewhere on the board
HOST_A11: SLOT0.A19, SLOT1.A19; also elsewhere on the board
HOST_A12: SLOT0.A20, SLOT1.A20; also elsewhere on the board
HOST_A13: SLOT0.A21, SLOT1.A21; also elsewhere on the board
HOST_A14: SLOT0.A22, SLOT1.A22; also elsewhere on the board
HOST_A15: SLOT0.A23, SLOT1.A23; also elsewhere on the board
HOST_CLK: SLOT0.A24, SLOT1.A24; also elsewhere on the board
HOST_D0: SLOT0.A25, SLOT1.A25; also elsewhere on the board
HOST_D1: SLOT0.A26, SLOT1.A26; also elsewhere on the board
HOST_D2: SLOT0.A27, SLOT1.A27; also elsewhere on the board
HOST_D3: SLOT0.A28, SLOT1.A28; also elsewhere on the board
HOST_D4: SLOT0.A29, SLOT1.A29; also elsewhere on the board
HOST_D5: SLOT0.A30, SLOT1.A30; also elsewhere on the board
HOST_D6: SLOT0.A31, SLOT1.A31; also elsewhere on the board
HOST_D7: SLOT0.A32, SLOT1.A32; also elsewhere on the board
HOST_R/!W!: SLOT0.B32, SLOT1.B32; also elsewhere on the board
S0_PRESENT: R61.2, SLOT0.B4; also elsewhere on the board
S1_PRESENT: R62.2, SLOT1.B4; also elsewhere on the board
SBUS12_CTL0: SLOT0.B8, SLOT1.B8
SBUS12_CTL1: SLOT0.B9, SLOT1.B9
SBUS12_CTL2: SLOT0.B10, SLOT1.B10
SBUS12_CTL3: SLOT0.B11, SLOT1.B11
SBUS12_CTL4: SLOT0.B12, SLOT1.B12
SBUS12_D0: SLOT0.B18, SLOT1.B18
SBUS12_D1: SLOT0.B19, SLOT1.B19
SBUS12_D2: SLOT0.B20, SLOT1.B20
SBUS12_D3: SLOT0.B21, SLOT1.B21
SBUS12_D4: SLOT0.B22, SLOT1.B22
SBUS12_D5: SLOT0.B23, SLOT1.B23
SBUS12_D6: SLOT0.B24, SLOT1.B24
SBUS12_D7: SLOT0.B25, SLOT1.B25
SPI_CLK: SLOT0.B17, SLOT1.B17; also elsewhere on the board
SPI_IRQ0: SLOT0.B14; also elsewhere on the board
SPI_IRQ1: SLOT1.B14; also elsewhere on the board
SPI_MISO: SLOT0.B16, SLOT1.B16; also elsewhere on the board
SPI_MOSI: SLOT0.B15, SLOT1.B15; also elsewhere on the board
SPI_SS0: SLOT0.B13; also elsewhere on the board
SPI_SS1: SLOT1.B13; also elsewhere on the board

Notes on the sheet:
Slots 0,1
Slot id: 0,0,0
Slot id: 0,0,1
B1,2,3 B5,6,7 B4 A1,2,3 A4,5,6,7
+5V Slot 3.3v Card-present Slot ID GND

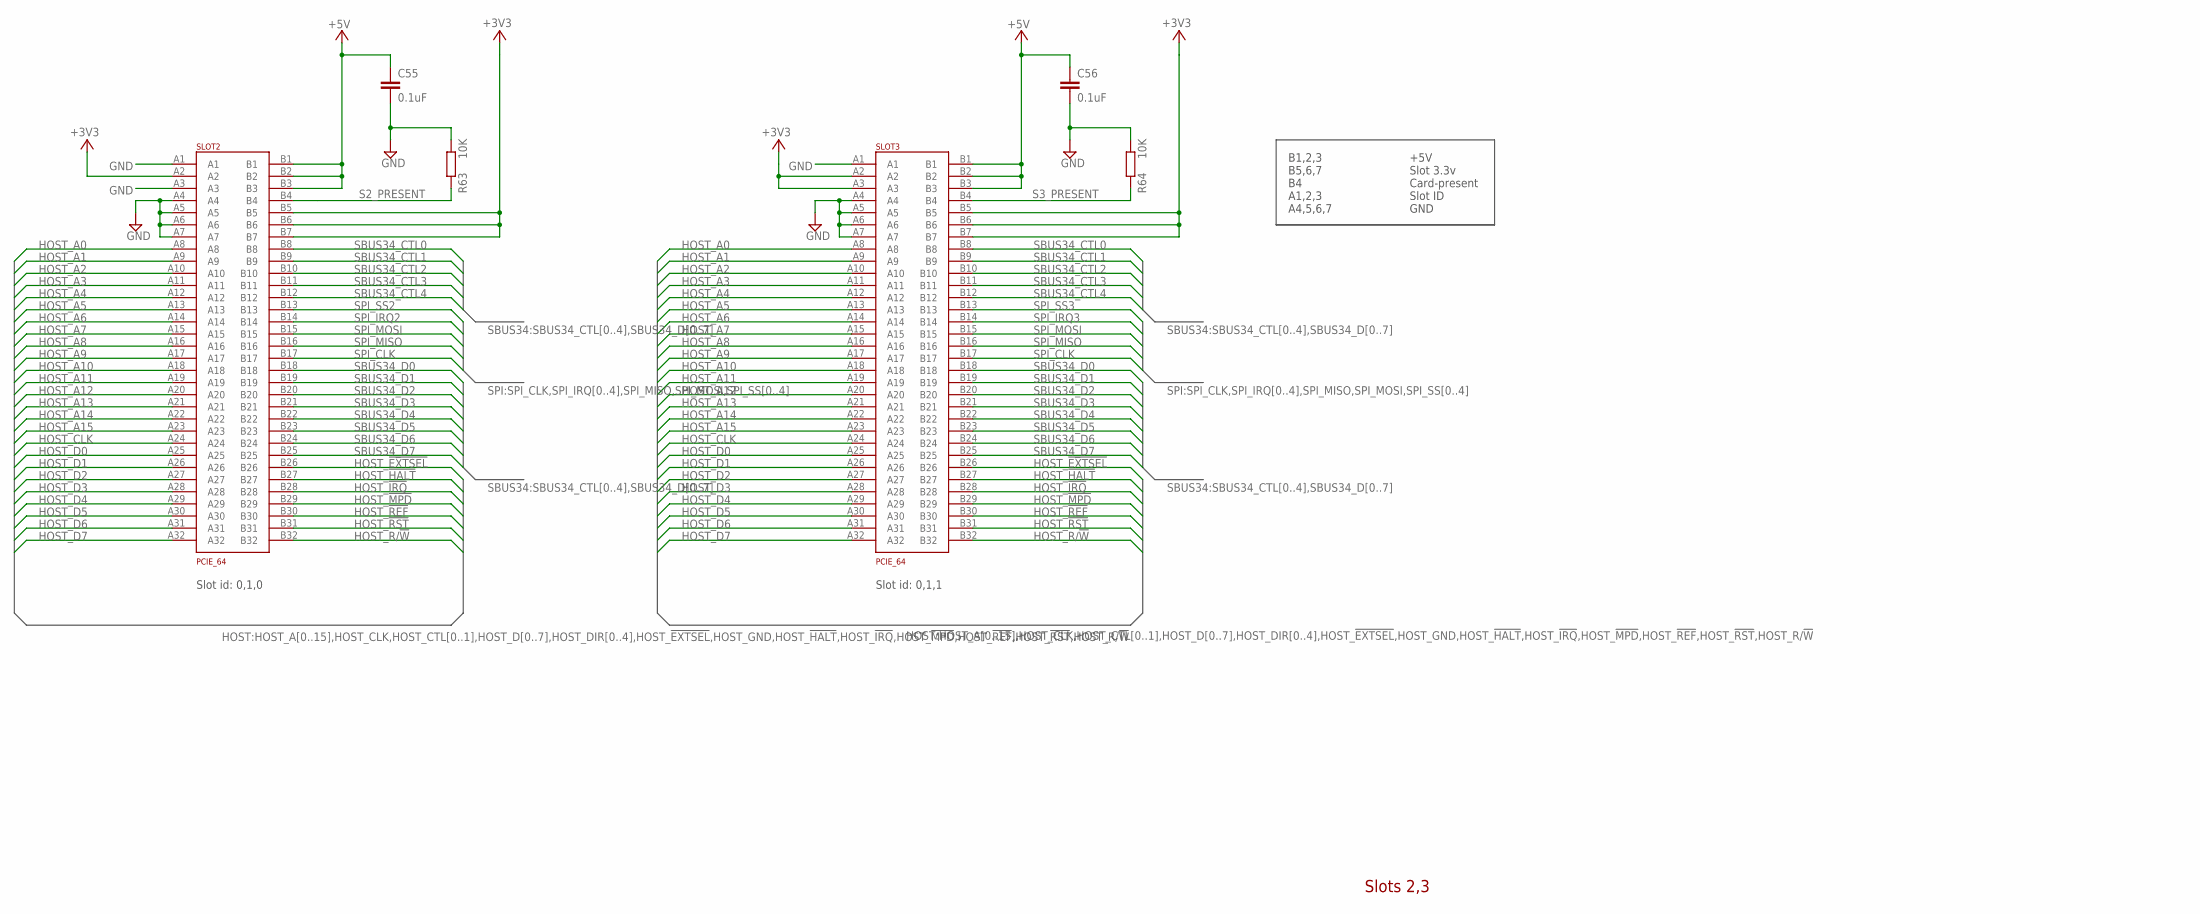
[picture p145: schematic xio2.sch, sheet 11, Expansion slots 2 & 3]

Parts:
C55, C56: 0.1uF; C0201
R63, R64: 10K; R0201
SLOT2, SLOT3: PCIE_64; PCI-E_64

Connections:
+3V3: SLOT2.A2, SLOT2.B5, SLOT2.B6, SLOT2.B7, SLOT3.A2, SLOT3.A3, SLOT3.B5, SLOT3.B6, SLOT3.B7; also elsewhere on the board
+5V: C55.1, C56.1, SLOT2.B1, SLOT2.B2, SLOT2.B3, SLOT3.B1, SLOT3.B2, SLOT3.B3; also elsewhere on the board
GND: C55.2, C56.2, R63.1, R64.1, SLOT2.A1, SLOT2.A3, SLOT2.A4, SLOT2.A5, SLOT2.A6, SLOT2.A7, SLOT3.A1, SLOT3.A4, SLOT3.A5, SLOT3.A6, SLOT3.A7; also elsewhere on the board
HOST_!EXTSEL!: SLOT2.B26, SLOT3.B26; also elsewhere on the board
HOST_!HALT!: SLOT2.B27, SLOT3.B27; also elsewhere on the board
HOST_!IRQ!: SLOT2.B28, SLOT3.B28; also elsewhere on the board
HOST_!MPD!: SLOT2.B29, SLOT3.B29; also elsewhere on the board
HOST_!REF!: SLOT2.B30, SLOT3.B30; also elsewhere on the board
HOST_!RST!: SLOT2.B31, SLOT3.B31; also elsewhere on the board
HOST_A0: SLOT2.A8, SLOT3.A8; also elsewhere on the board
HOST_A1: SLOT2.A9, SLOT3.A9; also elsewhere on the board
HOST_A2: SLOT2.A10, SLOT3.A10; also elsewhere on the board
HOST_A3: SLOT2.A11, SLOT3.A11; also elsewhere on the board
HOST_A4: SLOT2.A12, SLOT3.A12; also elsewhere on the board
HOST_A5: SLOT2.A13, SLOT3.A13; also elsewhere on the board
HOST_A6: SLOT2.A14, SLOT3.A14; also elsewhere on the board
HOST_A7: SLOT2.A15, SLOT3.A15; also elsewhere on the board
HOST_A8: SLOT2.A16, SLOT3.A16; also elsewhere on the board
HOST_A9: SLOT2.A17, SLOT3.A17; also elsewhere on the board
HOST_A10: SLOT2.A18, SLOT3.A18; also elsewhere on the board
HOST_A11: SLOT2.A19, SLOT3.A19; also elsewhere on the board
HOST_A12: SLOT2.A20, SLOT3.A20; also elsewhere on the board
HOST_A13: SLOT2.A21, SLOT3.A21; also elsewhere on the board
HOST_A14: SLOT2.A22, SLOT3.A22; also elsewhere on the board
HOST_A15: SLOT2.A23, SLOT3.A23; also elsewhere on the board
HOST_CLK: SLOT2.A24, SLOT3.A24; also elsewhere on the board
HOST_D0: SLOT2.A25, SLOT3.A25; also elsewhere on the board
HOST_D1: SLOT2.A26, SLOT3.A26; also elsewhere on the board
HOST_D2: SLOT2.A27, SLOT3.A27; also elsewhere on the board
HOST_D3: SLOT2.A28, SLOT3.A28; also elsewhere on the board
HOST_D4: SLOT2.A29, SLOT3.A29; also elsewhere on the board
HOST_D5: SLOT2.A30, SLOT3.A30; also elsewhere on the board
HOST_D6: SLOT2.A31, SLOT3.A31; also elsewhere on the board
HOST_D7: SLOT2.A32, SLOT3.A32; also elsewhere on the board
HOST_R/!W!: SLOT2.B32, SLOT3.B32; also elsewhere on the board
S2_PRESENT: R63.2, SLOT2.B4; also elsewhere on the board
S3_PRESENT: R64.2, SLOT3.B4; also elsewhere on the board
SBUS34_CTL0: SLOT2.B8, SLOT3.B8
SBUS34_CTL1: SLOT2.B9, SLOT3.B9
SBUS34_CTL2: SLOT2.B10, SLOT3.B10
SBUS34_CTL3: SLOT2.B11, SLOT3.B11
SBUS34_CTL4: SLOT2.B12, SLOT3.B12
SBUS34_D0: SLOT2.B18, SLOT3.B18
SBUS34_D1: SLOT2.B19, SLOT3.B19
SBUS34_D2: SLOT2.B20, SLOT3.B20
SBUS34_D3: SLOT2.B21, SLOT3.B21
SBUS34_D4: SLOT2.B22, SLOT3.B22
SBUS34_D5: SLOT2.B23, SLOT3.B23
SBUS34_D6: SLOT2.B24, SLOT3.B24
SBUS34_D7: SLOT2.B25, SLOT3.B25
SPI_CLK: SLOT2.B17, SLOT3.B17; also elsewhere on the board
SPI_IRQ2: SLOT2.B14; also elsewhere on the board
SPI_IRQ3: SLOT3.B14; also elsewhere on the board
SPI_MISO: SLOT2.B16, SLOT3.B16; also elsewhere on the board
SPI_MOSI: SLOT2.B15, SLOT3.B15; also elsewhere on the board
SPI_SS2: SLOT2.B13; also elsewhere on the board
SPI_SS3: SLOT3.B13; also elsewhere on the board

Notes on the sheet:
Slots 2,3
Slot id: 0,1,0
Slot id: 0,1,1
B1,2,3 B5,6,7 B4 A1,2,3 A4,5,6,7
+5V Slot 3.3v Card-present Slot ID GND

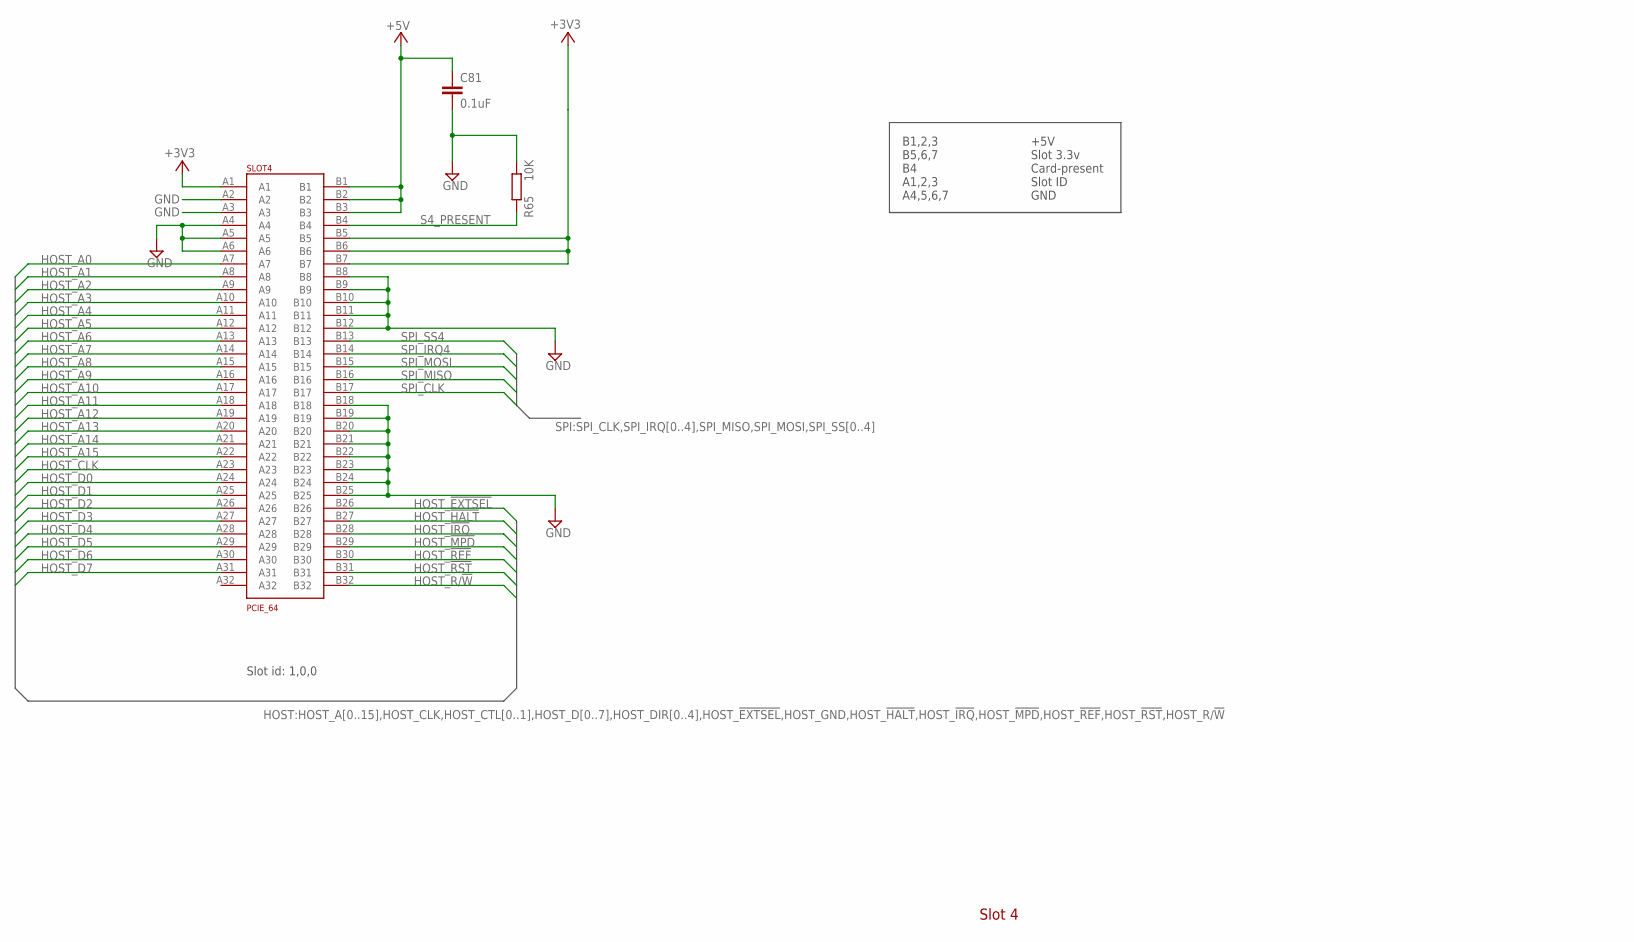
[picture p146: schematic xio2.sch, sheet 12, Expansion slots 4 & 5]

Parts:
C81: 0.1uF; C0201
R65: 10K; R0201
SLOT4: PCIE_64; PCI-E_64

Connections:
+3V3: SLOT4.A1, SLOT4.B5, SLOT4.B6, SLOT4.B7; also elsewhere on the board
+5V: C81.1, SLOT4.B1, SLOT4.B2, SLOT4.B3; also elsewhere on the board
GND: C81.2, R65.1, SLOT4.A2, SLOT4.A3, SLOT4.A4, SLOT4.A5, SLOT4.A6, SLOT4.B8, SLOT4.B9, SLOT4.B10, SLOT4.B11, SLOT4.B12, SLOT4.B18, SLOT4.B19, SLOT4.B20, SLOT4.B21, SLOT4.B22, SLOT4.B23, SLOT4.B24, SLOT4.B25; also elsewhere on the board
HOST_!EXTSEL!: SLOT4.B26; also elsewhere on the board
HOST_!HALT!: SLOT4.B27; also elsewhere on the board
HOST_!IRQ!: SLOT4.B28; also elsewhere on the board
HOST_!MPD!: SLOT4.B29; also elsewhere on the board
HOST_!REF!: SLOT4.B30; also elsewhere on the board
HOST_!RST!: SLOT4.B31; also elsewhere on the board
HOST_A0: SLOT4.A7; also elsewhere on the board
HOST_A1: SLOT4.A8; also elsewhere on the board
HOST_A2: SLOT4.A9; also elsewhere on the board
HOST_A3: SLOT4.A10; also elsewhere on the board
HOST_A4: SLOT4.A11; also elsewhere on the board
HOST_A5: SLOT4.A12; also elsewhere on the board
HOST_A6: SLOT4.A13; also elsewhere on the board
HOST_A7: SLOT4.A14; also elsewhere on the board
HOST_A8: SLOT4.A15; also elsewhere on the board
HOST_A9: SLOT4.A16; also elsewhere on the board
HOST_A10: SLOT4.A17; also elsewhere on the board
HOST_A11: SLOT4.A18; also elsewhere on the board
HOST_A12: SLOT4.A19; also elsewhere on the board
HOST_A13: SLOT4.A20; also elsewhere on the board
HOST_A14: SLOT4.A21; also elsewhere on the board
HOST_A15: SLOT4.A22; also elsewhere on the board
HOST_CLK: SLOT4.A23; also elsewhere on the board
HOST_D0: SLOT4.A24; also elsewhere on the board
HOST_D1: SLOT4.A25; also elsewhere on the board
HOST_D2: SLOT4.A26; also elsewhere on the board
HOST_D3: SLOT4.A27; also elsewhere on the board
HOST_D4: SLOT4.A28; also elsewhere on the board
HOST_D5: SLOT4.A29; also elsewhere on the board
HOST_D6: SLOT4.A30; also elsewhere on the board
HOST_D7: SLOT4.A31; also elsewhere on the board
HOST_R/!W!: SLOT4.B32; also elsewhere on the board
S4_PRESENT: R65.2, SLOT4.B4; also elsewhere on the board
SPI_CLK: SLOT4.B17; also elsewhere on the board
SPI_IRQ4: SLOT4.B14; also elsewhere on the board
SPI_MISO: SLOT4.B16; also elsewhere on the board
SPI_MOSI: SLOT4.B15; also elsewhere on the board
SPI_SS4: SLOT4.B13; also elsewhere on the board

Notes on the sheet:
Slot 4
Slot id: 1,0,0
B1,2,3 B5,6,7 B4 A1,2,3 A4,5,6,7
+5V Slot 3.3v Card-present Slot ID GND

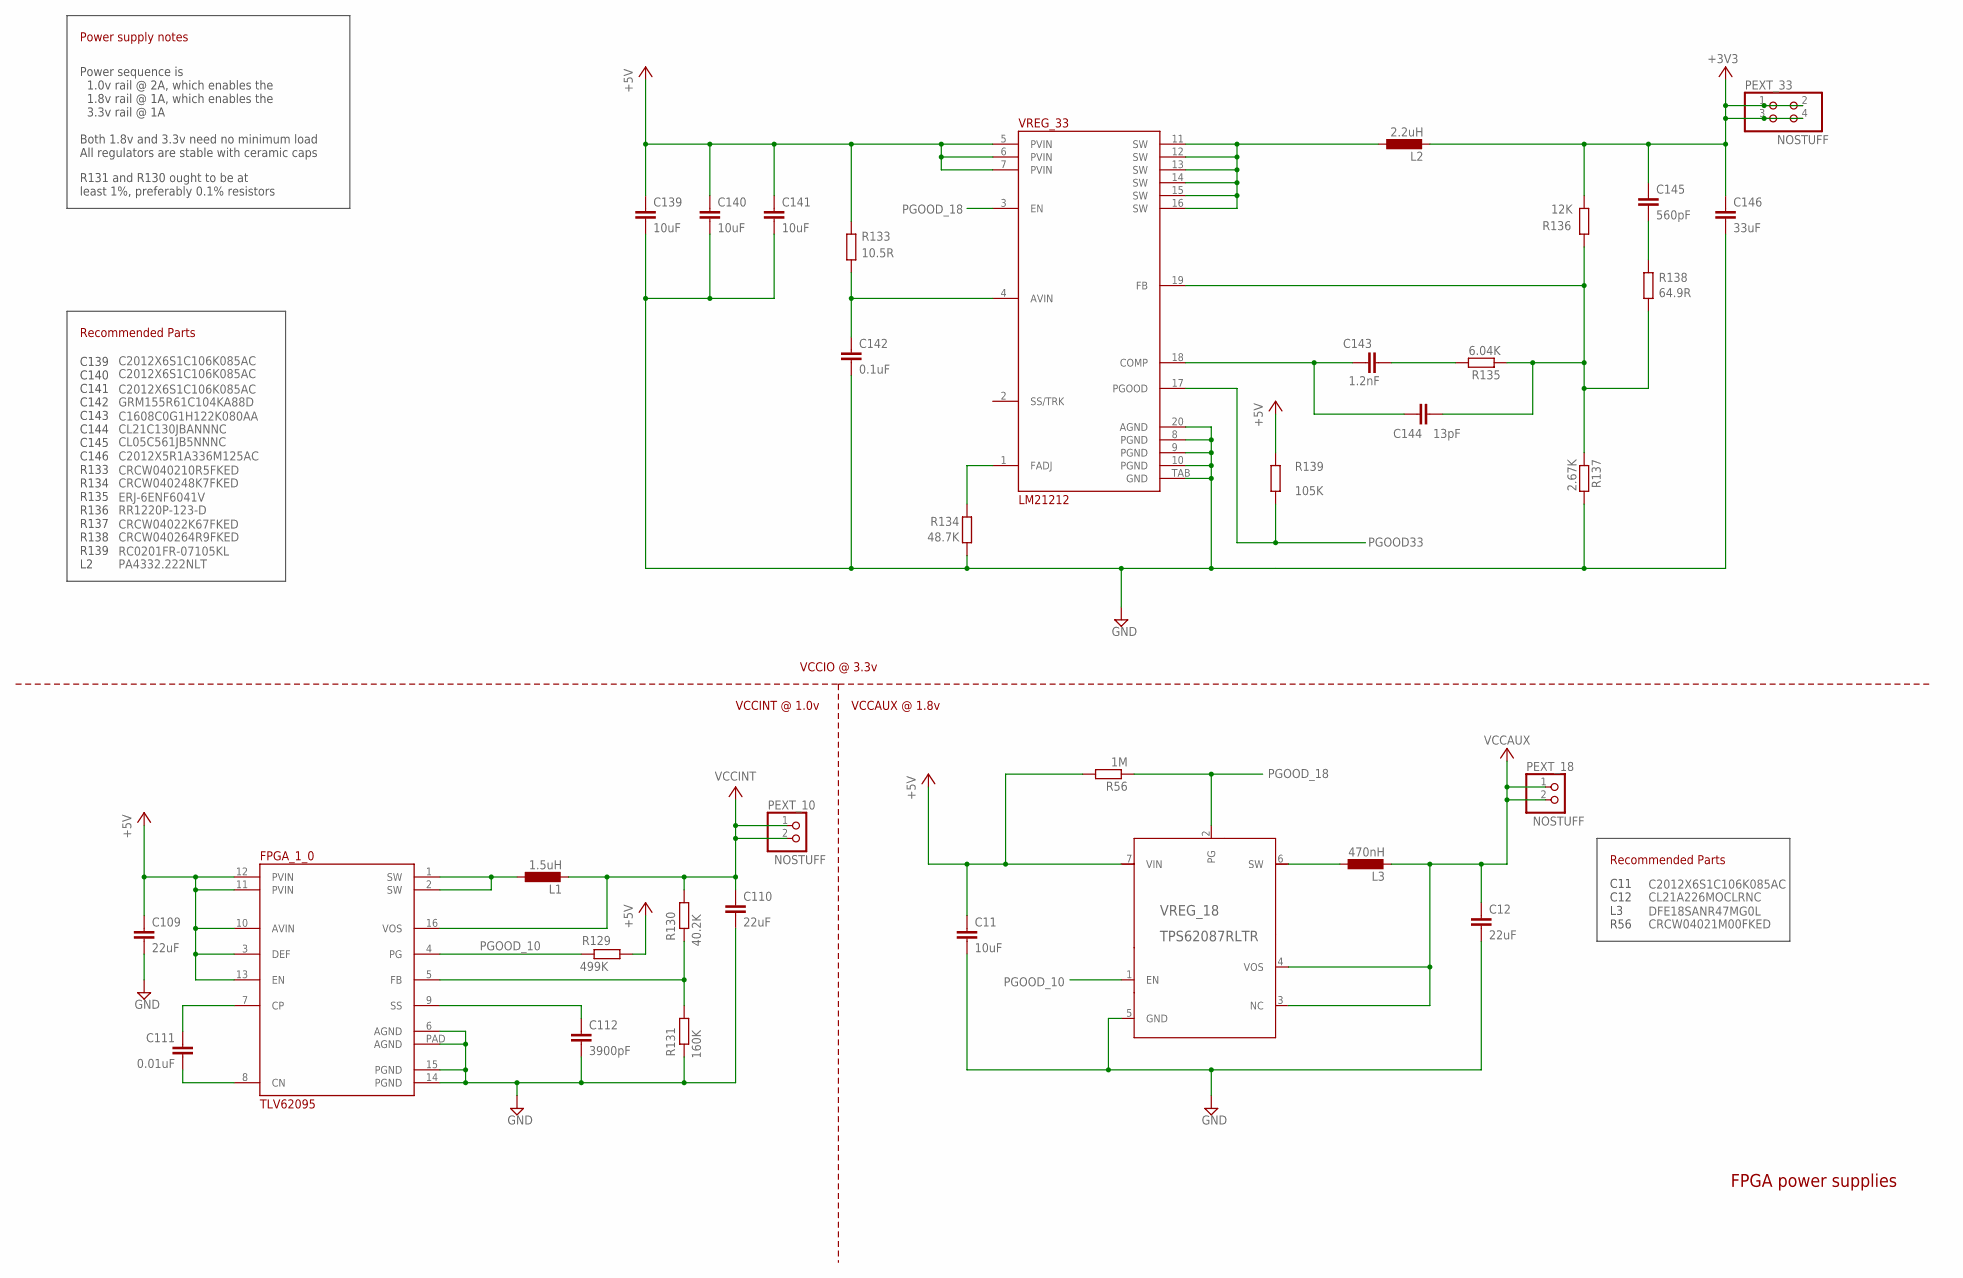
[picture p147: schematic xio2.sch, sheet 13, FPGA power supplies]

Parts:
C11, C139, C140, C141: 10uF; C0805
C12: 22uF; C2012
C109, C110: 22uF; C0805
C111: 0.01uF; C0402
C112: 3900pF; C0402
C142: 0.1uF; C0402
C143: 1.2nF; C0603
C144: 13pF; C0805
C145: 560pF; C0402
C146: 33uF; C0805
FPGA_1_0: TLV62095; QFN50P310X310X100-16
L1: 1.5uH; L5650M
L2: 2.2uH; RESC4137X200
L3: 470nH; L0603
PEXT_10, PEXT_18: PINHD-1X2; 1X02
PEXT_33: PINHD-2X2; 2X02
R56: 1M; R0402
R129: 499K; R0402
R130: 40.2K; R0402
R131: 160K; R0402
R133: 10.5R; R0402
R134: 48.7K; R0402
R135: 6.04K; R0805
R136: 12K; R0805
R137: 2.67K; R0402
R138: 64.9R; R0402
R139: 105K; R0201
VREG_18: TPS62087RLTR; RLT0007A
VREG_33: LM21212; HTSSOP20

Connections:
+3V3: C145.1, C146.1, L2.2, PEXT_33.1, PEXT_33.2, PEXT_33.3, PEXT_33.4, R136.1; also elsewhere on the board
+5V: C11.1, C109.1, C139.1, C140.1, C141.1, FPGA_1_0.3 (DEF), FPGA_1_0.10 (AVIN), FPGA_1_0.11 (PVIN), FPGA_1_0.12 (PVIN), FPGA_1_0.13 (EN), R56.2, R129.1, R133.2, R139.1, VREG_18.7 (VIN), VREG_33.5 (PVIN), VREG_33.6 (PVIN), VREG_33.7 (PVIN); also elsewhere on the board
GND: C11.2, C12.2, C109.2, C110.2, C112.2, C139.2, C140.2, C141.2, C142.2, C146.2, FPGA_1_0.6 (AGND), FPGA_1_0.14 (PGND), FPGA_1_0.15 (PGND), FPGA_1_0.PAD (AGND), R131.2, R134.1, R137.2, VREG_18.5 (GND), VREG_33.8 (PGND), VREG_33.9 (PGND), VREG_33.10 (PGND), VREG_33.20 (AGND), VREG_33.TAB (GND); also elsewhere on the board
unnamed: L3.1, VREG_18.6 (SW)
unnamed: C111.1, FPGA_1_0.7 (CP)
unnamed: C111.2, FPGA_1_0.8 (CN)
unnamed: FPGA_1_0.1 (SW), FPGA_1_0.2 (SW), L1.1
unnamed: C142.1, R133.1, VREG_33.4 (AVIN)
unnamed: FPGA_1_0.5 (FB), R130.2, R131.1
unnamed: R134.2, VREG_33.1 (FADJ)
unnamed: C112.1, FPGA_1_0.9 (SS)
unnamed: C143.1, C144.1, VREG_33.18 (COMP)
unnamed: C143.2, R135.2
unnamed: C144.2, R135.1, R136.2, R137.1, R138.2, VREG_33.19 (FB)
unnamed: C145.2, R138.1
PGOOD33: R139.2, VREG_33.17 (PGOOD)
PGOOD_10: FPGA_1_0.4 (PG), R129.2, VREG_18.1 (EN)
PGOOD_18: R56.1, VREG_18.2 (PG), VREG_33.3 (EN)
SW_OUT: L2.1, VREG_33.11 (SW), VREG_33.12 (SW), VREG_33.13 (SW), VREG_33.14 (SW), VREG_33.15 (SW), VREG_33.16 (SW)
VCCAUX: C12.1, L3.2, PEXT_18.1, PEXT_18.2, VREG_18.3 (NC), VREG_18.4 (VOS); also elsewhere on the board
VCCINT: C110.1, FPGA_1_0.16 (VOS), L1.2, PEXT_10.1, PEXT_10.2, R130.1; also elsewhere on the board

Notes on the sheet:
C139 C140 C141 C142 C143 C144 C145 C146 R133 R134 R135 R136 R137 R138 R139 L2
Recommended Parts
C11 C12 L3 R56
FPGA power supplies
VCCINT @ 1.0v
Power supply notes
Power sequence is 1.0v rail @ 2A, which enables the 1.8v rail @ 1A, which enables the 3.3v rail @ 1A Both 1.8v and 3.3v need no minimum load All regulators are stable with ceramic caps
R131 and R130 ought to be at least 1%, preferably 0.1% resistors
VCCAUX @ 1.8v
VCCIO @ 3.3v

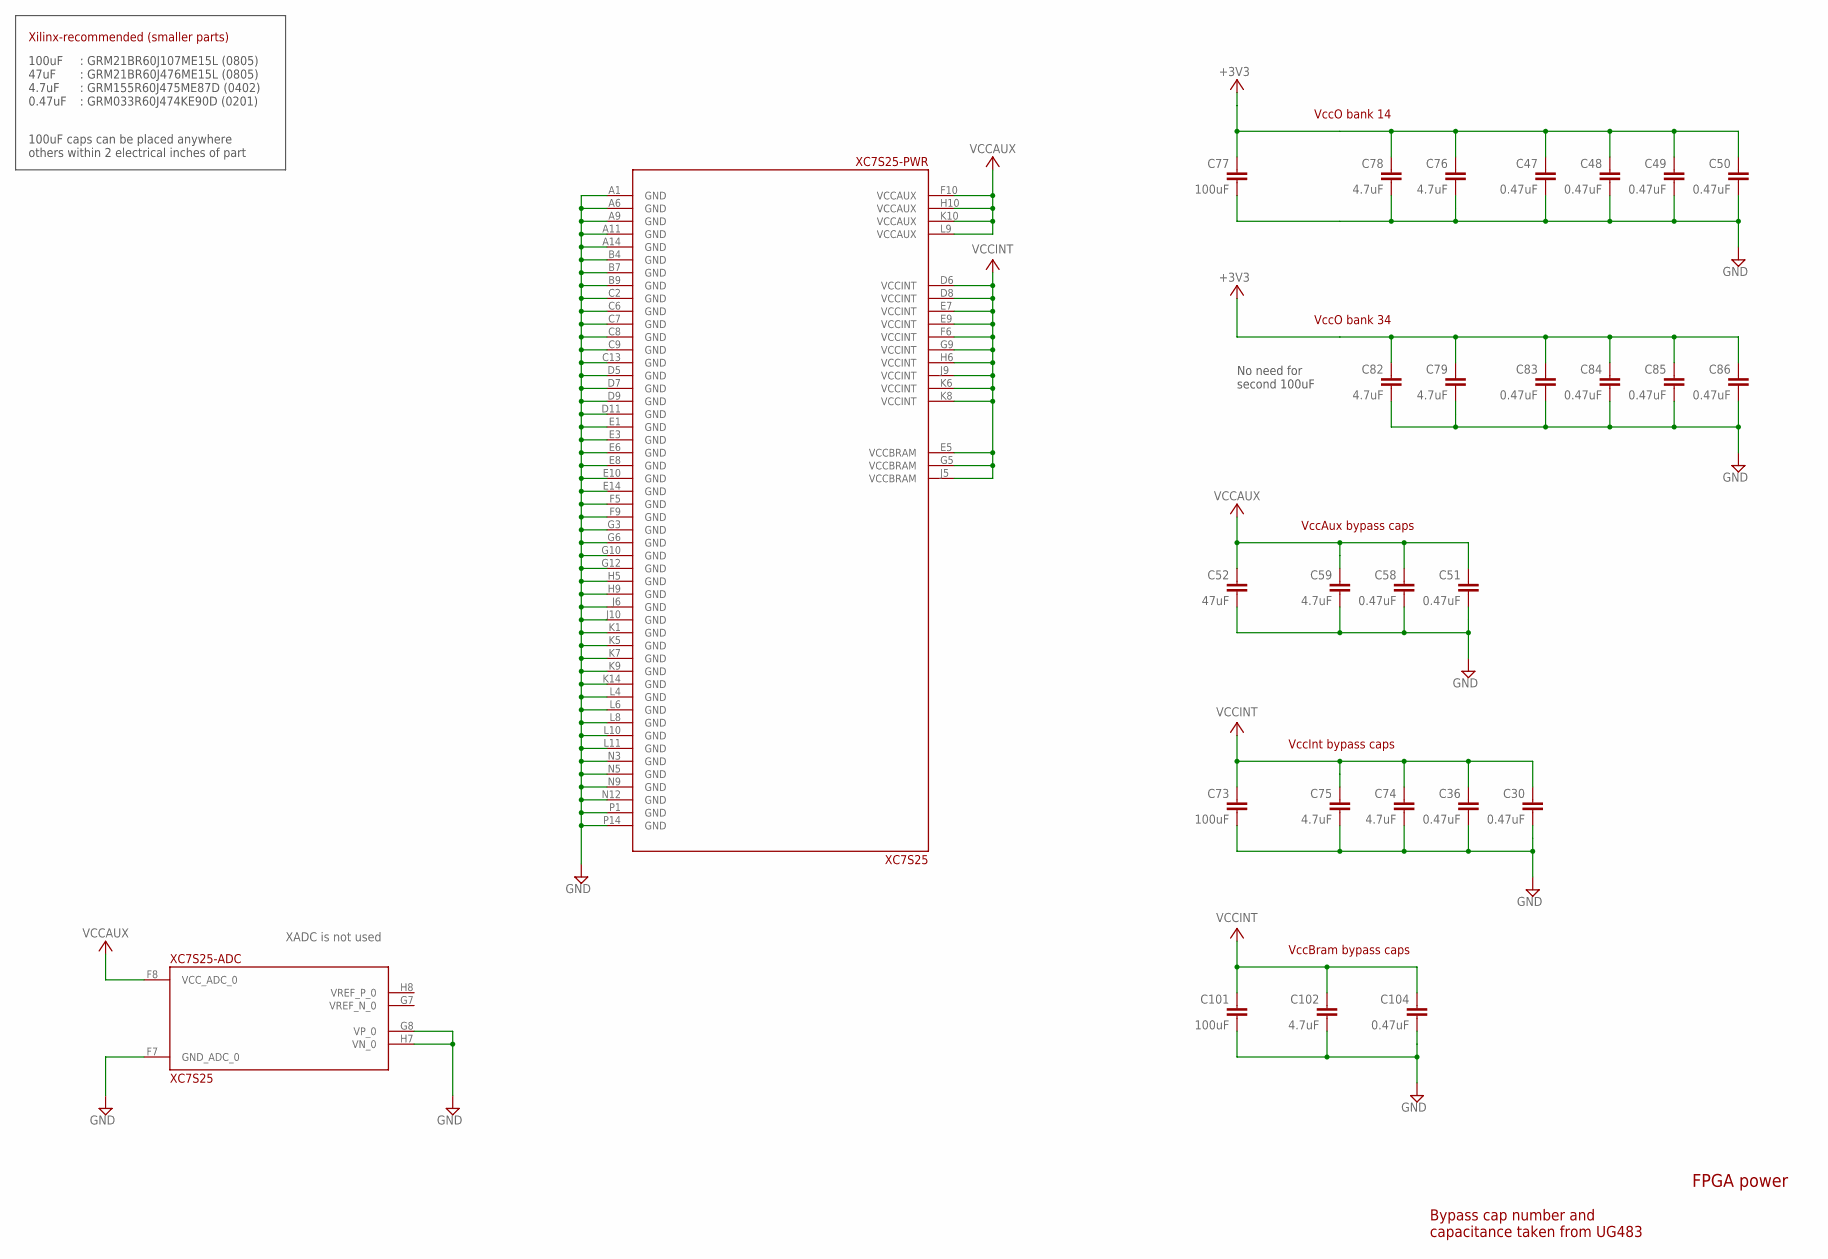
[picture p148: schematic xio2.sch, sheet 14, FPGA bypass]

Parts:
C30, C36, C47, C48, C49, C50, C51, C58, C83, C84, C85, C86, C104: 0.47uF; C0201
C52: 47uF; C0805
C59, C74, C75, C76, C78, C79, C82, C102: 4.7uF; C0402
C73, C77, C101: 100uF; C0805
XC7S25: XC7S25; BGA196C100P14X14_1500X1500X146

Connections:
+3V3: C47.1, C48.1, C49.1, C50.1, C76.1, C77.1, C78.1, C79.1, C82.1, C83.1, C84.1, C85.1, C86.1; also elsewhere on the board
GND: C30.2, C36.2, C47.2, C48.2, C49.2, C50.2, C51.2, C52.2, C58.2, C59.2, C73.2, C74.2, C75.2, C76.2, C77.2, C78.2, C79.2, C82.2, C83.2, C84.2, C85.2, C86.2, C101.2, C102.2, C104.2, XC7S25.A1 (GND), XC7S25.A6 (GND), XC7S25.A9 (GND), XC7S25.A11 (GND), XC7S25.A14 (GND), XC7S25.B4 (GND), XC7S25.B7 (GND), XC7S25.B9 (GND), XC7S25.C2 (GND), XC7S25.C6 (GND), XC7S25.C7 (GND), XC7S25.C8 (GND), XC7S25.C9 (GND), XC7S25.C13 (GND), XC7S25.D5 (GND), XC7S25.D7 (GND), XC7S25.D9 (GND), XC7S25.D11 (GND), XC7S25.E1 (GND), XC7S25.E3 (GND), XC7S25.E6 (GND), XC7S25.E8 (GND), XC7S25.E10 (GND), XC7S25.E14 (GND), XC7S25.F5 (GND), XC7S25.F7 (GND_ADC_0), XC7S25.F9 (GND), XC7S25.G3 (GND), XC7S25.G6 (GND), XC7S25.G8 (VP_0), XC7S25.G10 (GND), XC7S25.G12 (GND), XC7S25.H5 (GND), XC7S25.H7 (VN_0), XC7S25.H9 (GND), XC7S25.J6 (GND), XC7S25.J10 (GND), XC7S25.K1 (GND), XC7S25.K5 (GND), XC7S25.K7 (GND), XC7S25.K9 (GND), XC7S25.K14 (GND), XC7S25.L4 (GND), XC7S25.L6 (GND), XC7S25.L8 (GND), XC7S25.L10 (GND), XC7S25.L11 (GND), XC7S25.N3 (GND), XC7S25.N5 (GND), XC7S25.N9 (GND), XC7S25.N12 (GND), XC7S25.P1 (GND), XC7S25.P14 (GND); also elsewhere on the board
VCCAUX: C51.1, C52.1, C58.1, C59.1, XC7S25.F8 (VCC_ADC_0), XC7S25.F10 (VCCAUX), XC7S25.H10 (VCCAUX), XC7S25.K10 (VCCAUX), XC7S25.L9 (VCCAUX); also elsewhere on the board
VCCINT: C30.1, C36.1, C73.1, C74.1, C75.1, C101.1, C102.1, C104.1, XC7S25.D6 (VCCINT), XC7S25.D8 (VCCINT), XC7S25.E5 (VCCBRAM), XC7S25.E7 (VCCINT), XC7S25.E9 (VCCINT), XC7S25.F6 (VCCINT), XC7S25.G5 (VCCBRAM), XC7S25.G9 (VCCINT), XC7S25.H6 (VCCINT), XC7S25.J5 (VCCBRAM), XC7S25.J9 (VCCINT), XC7S25.K6 (VCCINT), XC7S25.K8 (VCCINT); also elsewhere on the board

Notes on the sheet:
VccAux bypass caps
VccInt bypass caps
VccO bank 14
Bypass cap number and capacitance taken from UG483
VccBram bypass caps
VccO bank 34
No need for second 100uF
100uF 47uF 4.7uF 0.47uF
: GRM21BR60J107ME15L (0805) : GRM21BR60J476ME15L (0805) : GRM155R60J475ME87D (0402) : GRM033R60J474KE90D (0201)
100uF caps can be placed anywhere others within 2 electrical inches of part
FPGA power
Xilinx-recommended (smaller parts)
XADC is not used
