ThrudTheBarbarian/pbxl/boards/xio2/xio2.brd

## EAGLE design boards/xio2/xio2.brd (continued)

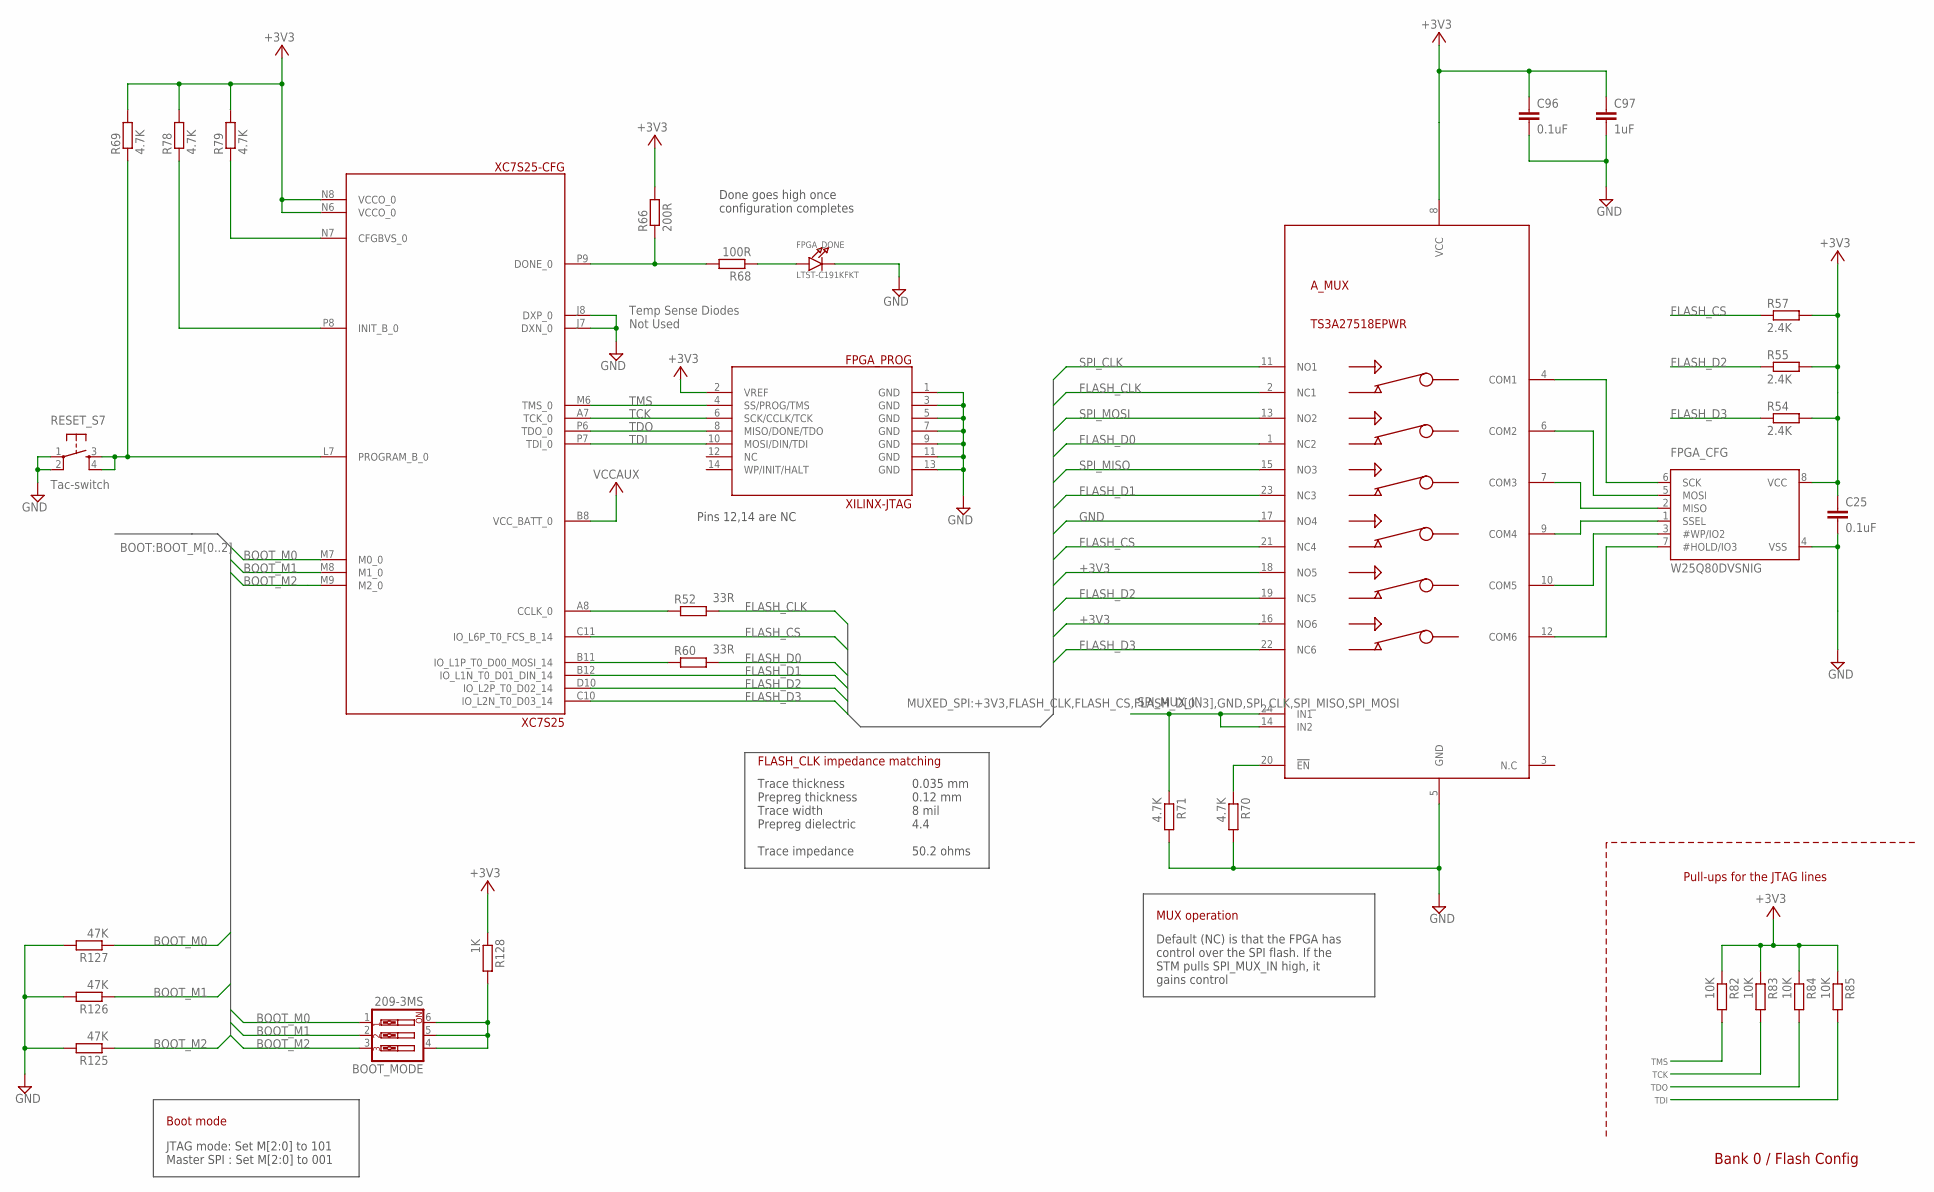
[picture p149: schematic xio2.sch, sheet 15, FPGA config, clock]

Parts:
A_MUX: TS3A27518EPWR; TSSOP24
BOOT_MODE: 209-3MS; EDG-03
C25, C96: 0.1uF; C0201
C97: 1uF; C0201
FPGA_CFG: W25Q80DVSNIG; SOIC8_150MIL
FPGA_DONE: LTST-C191KFKT; CHIPLED_0603
FPGA_PROG: XILINX-JTAG; 332-14
R52, R60: 33R; R0201
R54, R55, R57: 2.4K; R0201
R66: 200R; R0201
R68: 100R; R0402
R69, R70, R71, R78, R79: 4.7K; R0201
R82, R83, R84, R85: 10K; R0201
R125, R126, R127: 47K; R0201
R128: 1K; R0201
RESET_S7: Tac-switch; TACTILE-PTH
XC7S25: XC7S25; BGA196C100P14X14_1500X1500X146

Connections:
+3V3: A_MUX.8 (VCC), A_MUX.16 (NO6), A_MUX.18 (NO5), C25.1, C96.1, C97.1, FPGA_CFG.8 (VCC), FPGA_PROG.2 (VREF), R54.2, R55.2, R57.2, R66.2, R69.2, R78.2, R79.2, R82.1, R83.1, R84.1, R85.1, R128.1, XC7S25.N6 (VCCO_0), XC7S25.N8 (VCCO_0); also elsewhere on the board
BOOT_M0: BOOT_MODE.1, R127.1, XC7S25.M7 (M0_0)
BOOT_M1: BOOT_MODE.2, R126.1, XC7S25.M8 (M1_0)
BOOT_M2: BOOT_MODE.3, R125.1, XC7S25.M9 (M2_0)
FLASH_CLK: A_MUX.2 (NC1), R52.2
FLASH_CS: A_MUX.21 (NC4), R57.1, XC7S25.C11 (IO_L6P_T0_FCS_B_14)
FLASH_D0: A_MUX.1 (NC2), R60.2
FLASH_D1: A_MUX.23 (NC3), XC7S25.B12 (IO_L1N_T0_D01_DIN_14)
FLASH_D2: A_MUX.19 (NC5), R55.1, XC7S25.D10 (IO_L2P_T0_D02_14)
FLASH_D3: A_MUX.22 (NC6), R54.1, XC7S25.C10 (IO_L2N_T0_D03_14)
GND: A_MUX.5 (GND), A_MUX.17 (NO4), C25.2, C96.2, C97.2, FPGA_CFG.4 (VSS), FPGA_DONE.C, FPGA_PROG.1 (GND), FPGA_PROG.3 (GND), FPGA_PROG.5 (GND), FPGA_PROG.7 (GND), FPGA_PROG.9 (GND), FPGA_PROG.11 (GND), FPGA_PROG.13 (GND), R70.2, R71.2, R125.2, R126.2, R127.2, RESET_S7.1, RESET_S7.2, XC7S25.J7 (DXN_0), XC7S25.J8 (DXP_0); also elsewhere on the board
unnamed: R60.1, XC7S25.B11 (IO_L1P_T0_D00_MOSI_14)
unnamed: A_MUX.4 (COM1), FPGA_CFG.6 (SCK)
unnamed: BOOT_MODE.4, BOOT_MODE.5, BOOT_MODE.6, R128.2
unnamed: R52.1, XC7S25.A8 (CCLK_0)
unnamed: R66.1, R68.2, XC7S25.P9 (DONE_0)
unnamed: FPGA_DONE.A, R68.1
unnamed: A_MUX.6 (COM2), FPGA_CFG.5 (MOSI)
unnamed: A_MUX.7 (COM3), FPGA_CFG.2 (MISO)
unnamed: A_MUX.9 (COM4), FPGA_CFG.1 (SSEL)
unnamed: A_MUX.10 (COM5), FPGA_CFG.3 (#WP/IO2)
unnamed: A_MUX.12 (COM6), FPGA_CFG.7 (#HOLD/IO3)
unnamed: R69.1, RESET_S7.3, RESET_S7.4, XC7S25.L7 (PROGRAM_B_0)
unnamed: R78.1, XC7S25.P8 (INIT_B_0)
unnamed: A_MUX.20 (!EN!), R70.1
unnamed: R79.1, XC7S25.N7 (CFGBVS_0)
SPI_CLK: A_MUX.11 (NO1); also elsewhere on the board
SPI_MISO: A_MUX.15 (NO3); also elsewhere on the board
SPI_MOSI: A_MUX.13 (NO2); also elsewhere on the board
SPI_MUX_IN: A_MUX.14 (IN2), A_MUX.24 (IN1), R71.1; also elsewhere on the board
TCK: FPGA_PROG.6 (SCK/CCLK/TCK), R83.2, XC7S25.A7 (TCK_0)
TDI: FPGA_PROG.10 (MOSI/DIN/TDI), R85.2, XC7S25.P7 (TDI_0)
TDO: FPGA_PROG.8 (MISO/DONE/TDO), R84.2, XC7S25.P6 (TDO_0)
TMS: FPGA_PROG.4 (SS/PROG/TMS), R82.2, XC7S25.M6 (TMS_0)
VCCAUX: XC7S25.B8 (VCC_BATT_0); also elsewhere on the board

Notes on the sheet:
Bank 0 / Flash Config
Trace thickness Prepreg thickness Trace width Prepreg dielectric Trace impedance
0.035 mm 0.12 mm 8 mil 4.4 50.2 ohms
FLASH_CLK impedance matching
Default (NC) is that the FPGA has control over the SPI flash. If the STM pulls SPI_MUX_IN high, it gains control
Pins 12,14 are NC
Temp Sense Diodes Not Used
Done goes high once configuration completes
MUX operation
Boot mode
JTAG mode: Set M[2:0] to 101 Master SPI : Set M[2:0] to 001
Pull-ups for the JTAG lines

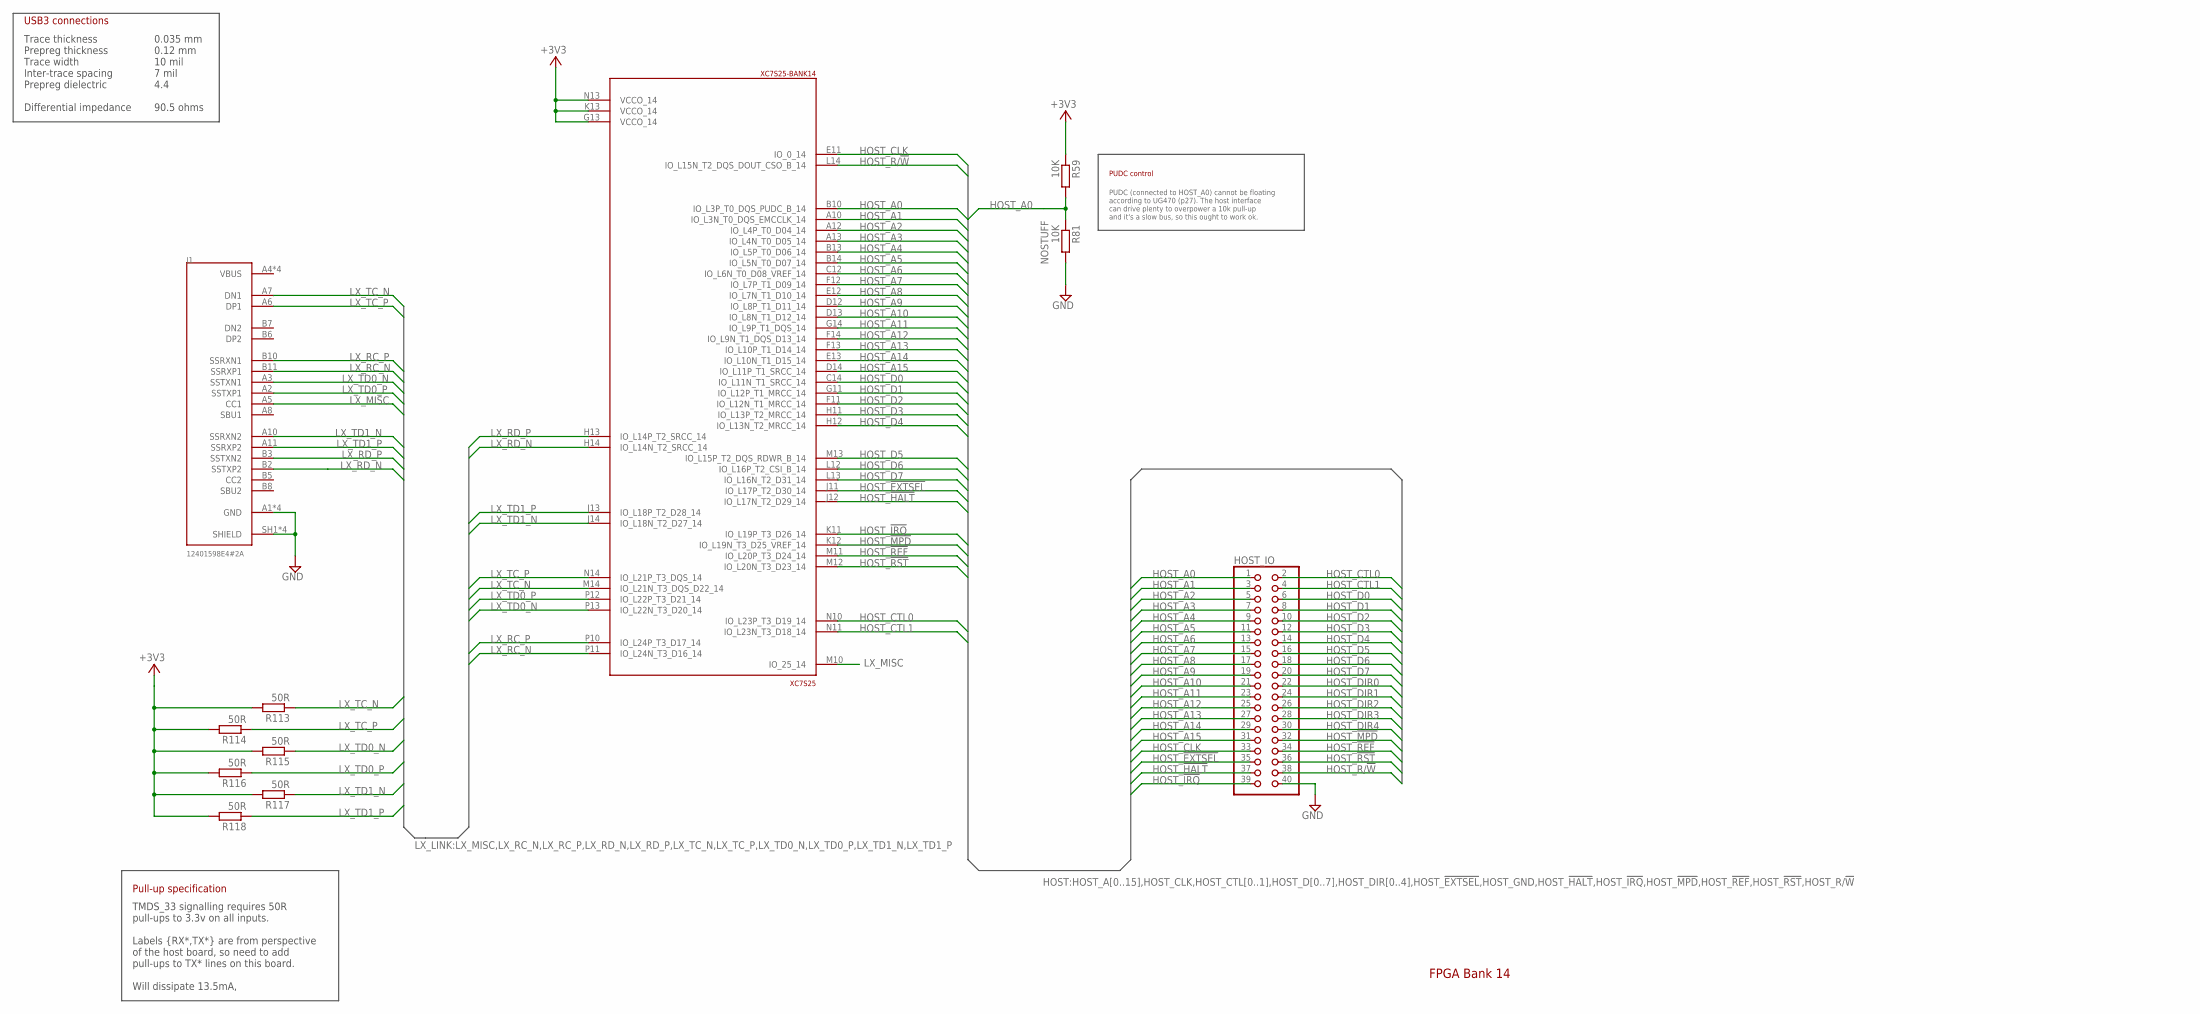
[picture p150: schematic xio2.sch, sheet 16, FPGA Bank 14]

Parts:
HOST_IO: PINHD-2X20/90; 2X20/90
J1: 12401598E4#2A; AMPHENOL_12401598E4#2A
R59, R81: 10K; R0201
R113, R114, R115, R116, R117, R118: 50R; R0201
XC7S25: XC7S25; BGA196C100P14X14_1500X1500X146

Connections:
+3V3: R59.1, R113.2, R114.2, R115.2, R116.2, R117.2, R118.2, XC7S25.G13 (VCCO_14), XC7S25.K13 (VCCO_14), XC7S25.N13 (VCCO_14); also elsewhere on the board
GND: HOST_IO.40, J1.A1 (GND), J1.A12 (GND), J1.B1 (GND), J1.B12 (GND), J1.SH1 (SHIELD), J1.SH2 (SHIELD), J1.SH3 (SHIELD), J1.SH4 (SHIELD), R81.2; also elsewhere on the board
HOST_!EXTSEL!: HOST_IO.35, XC7S25.J11 (IO_L17P_T2_D30_14); also elsewhere on the board
HOST_!HALT!: HOST_IO.37, XC7S25.J12 (IO_L17N_T2_D29_14); also elsewhere on the board
HOST_!IRQ!: HOST_IO.39, XC7S25.K11 (IO_L19P_T3_D26_14); also elsewhere on the board
HOST_!MPD!: HOST_IO.32, XC7S25.K12 (IO_L19N_T3_D25_VREF_14); also elsewhere on the board
HOST_!REF!: HOST_IO.34, XC7S25.M11 (IO_L20P_T3_D24_14); also elsewhere on the board
HOST_!RST!: HOST_IO.36, XC7S25.M12 (IO_L20N_T3_D23_14); also elsewhere on the board
HOST_A0: HOST_IO.1, R59.2, R81.1, XC7S25.B10 (IO_L3P_T0_DQS_PUDC_B_14); also elsewhere on the board
HOST_A1: HOST_IO.3, XC7S25.A10 (IO_L3N_T0_DQS_EMCCLK_14); also elsewhere on the board
HOST_A2: HOST_IO.5, XC7S25.A12 (IO_L4P_T0_D04_14); also elsewhere on the board
HOST_A3: HOST_IO.7, XC7S25.A13 (IO_L4N_T0_D05_14); also elsewhere on the board
HOST_A4: HOST_IO.9, XC7S25.B13 (IO_L5P_T0_D06_14); also elsewhere on the board
HOST_A5: HOST_IO.11, XC7S25.B14 (IO_L5N_T0_D07_14); also elsewhere on the board
HOST_A6: HOST_IO.13, XC7S25.C12 (IO_L6N_T0_D08_VREF_14); also elsewhere on the board
HOST_A7: HOST_IO.15, XC7S25.F12 (IO_L7P_T1_D09_14); also elsewhere on the board
HOST_A8: HOST_IO.17, XC7S25.E12 (IO_L7N_T1_D10_14); also elsewhere on the board
HOST_A9: HOST_IO.19, XC7S25.D12 (IO_L8P_T1_D11_14); also elsewhere on the board
HOST_A10: HOST_IO.21, XC7S25.D13 (IO_L8N_T1_D12_14); also elsewhere on the board
HOST_A11: HOST_IO.23, XC7S25.G14 (IO_L9P_T1_DQS_14); also elsewhere on the board
HOST_A12: HOST_IO.25, XC7S25.F14 (IO_L9N_T1_DQS_D13_14); also elsewhere on the board
HOST_A13: HOST_IO.27, XC7S25.F13 (IO_L10P_T1_D14_14); also elsewhere on the board
HOST_A14: HOST_IO.29, XC7S25.E13 (IO_L10N_T1_D15_14); also elsewhere on the board
HOST_A15: HOST_IO.31, XC7S25.D14 (IO_L11P_T1_SRCC_14); also elsewhere on the board
HOST_CLK: HOST_IO.33, XC7S25.E11 (IO_0_14); also elsewhere on the board
HOST_CTL0: HOST_IO.2, XC7S25.N10 (IO_L23P_T3_D19_14)
HOST_CTL1: HOST_IO.4, XC7S25.N11 (IO_L23N_T3_D18_14)
HOST_D0: HOST_IO.6, XC7S25.C14 (IO_L11N_T1_SRCC_14); also elsewhere on the board
HOST_D1: HOST_IO.8, XC7S25.G11 (IO_L12P_T1_MRCC_14); also elsewhere on the board
HOST_D2: HOST_IO.10, XC7S25.F11 (IO_L12N_T1_MRCC_14); also elsewhere on the board
HOST_D3: HOST_IO.12, XC7S25.H11 (IO_L13P_T2_MRCC_14); also elsewhere on the board
HOST_D4: HOST_IO.14, XC7S25.H12 (IO_L13N_T2_MRCC_14); also elsewhere on the board
HOST_D5: HOST_IO.16, XC7S25.M13 (IO_L15P_T2_DQS_RDWR_B_14); also elsewhere on the board
HOST_D6: HOST_IO.18, XC7S25.L12 (IO_L16P_T2_CSI_B_14); also elsewhere on the board
HOST_D7: HOST_IO.20, XC7S25.L13 (IO_L16N_T2_D31_14); also elsewhere on the board
HOST_DIR0: HOST_IO.22; also elsewhere on the board
HOST_DIR1: HOST_IO.24; also elsewhere on the board
HOST_DIR2: HOST_IO.26; also elsewhere on the board
HOST_DIR3: HOST_IO.28; also elsewhere on the board
HOST_DIR4: HOST_IO.30; also elsewhere on the board
HOST_R/!W!: HOST_IO.38, XC7S25.L14 (IO_L15N_T2_DQS_DOUT_CSO_B_14); also elsewhere on the board
LX_MISC: J1.A5 (CC1), XC7S25.M10 (IO_25_14)
LX_RC_N: J1.B11 (SSRXP1), XC7S25.P11 (IO_L24N_T3_D16_14)
LX_RC_P: J1.B10 (SSRXN1), XC7S25.P10 (IO_L24P_T3_D17_14)
LX_RD_N: J1.B2 (SSTXP2), XC7S25.H14 (IO_L14N_T2_SRCC_14)
LX_RD_P: J1.B3 (SSTXN2), XC7S25.H13 (IO_L14P_T2_SRCC_14)
LX_TC_N: J1.A7 (DN1), R113.1, XC7S25.M14 (IO_L21N_T3_DQS_D22_14)
LX_TC_P: J1.A6 (DP1), R114.1, XC7S25.N14 (IO_L21P_T3_DQS_14)
LX_TD0_N: J1.A3 (SSTXN1), R115.1, XC7S25.P13 (IO_L22N_T3_D20_14)
LX_TD0_P: J1.A2 (SSTXP1), R116.1, XC7S25.P12 (IO_L22P_T3_D21_14)
LX_TD1_N: J1.A10 (SSRXN2), R117.1, XC7S25.J14 (IO_L18N_T2_D27_14)
LX_TD1_P: J1.A11 (SSRXP2), R118.1, XC7S25.J13 (IO_L18P_T2_D28_14)

Notes on the sheet:
Trace thickness Prepreg thickness Trace width Inter-trace spacing Prepreg dielectric Differential impedance
0.035 mm 0.12 mm 10 mil 7 mil 4.4 90.5 ohms
USB3 connections
FPGA Bank 14
TMDS_33 signalling requires 50R pull-ups to 3.3v on all inputs. Labels {RX*,TX*} are from perspective of the host board, so need to add pull-ups to TX* lines on this board. Will dissipate 13.5mA,
Pull-up specification
PUDC (connected to HOST_A0) cannot be floating according to UG470 (p27). The host interface can drive plenty to overpower a 10k pull-up and it's a slow bus, so this ought to work ok.
PUDC control

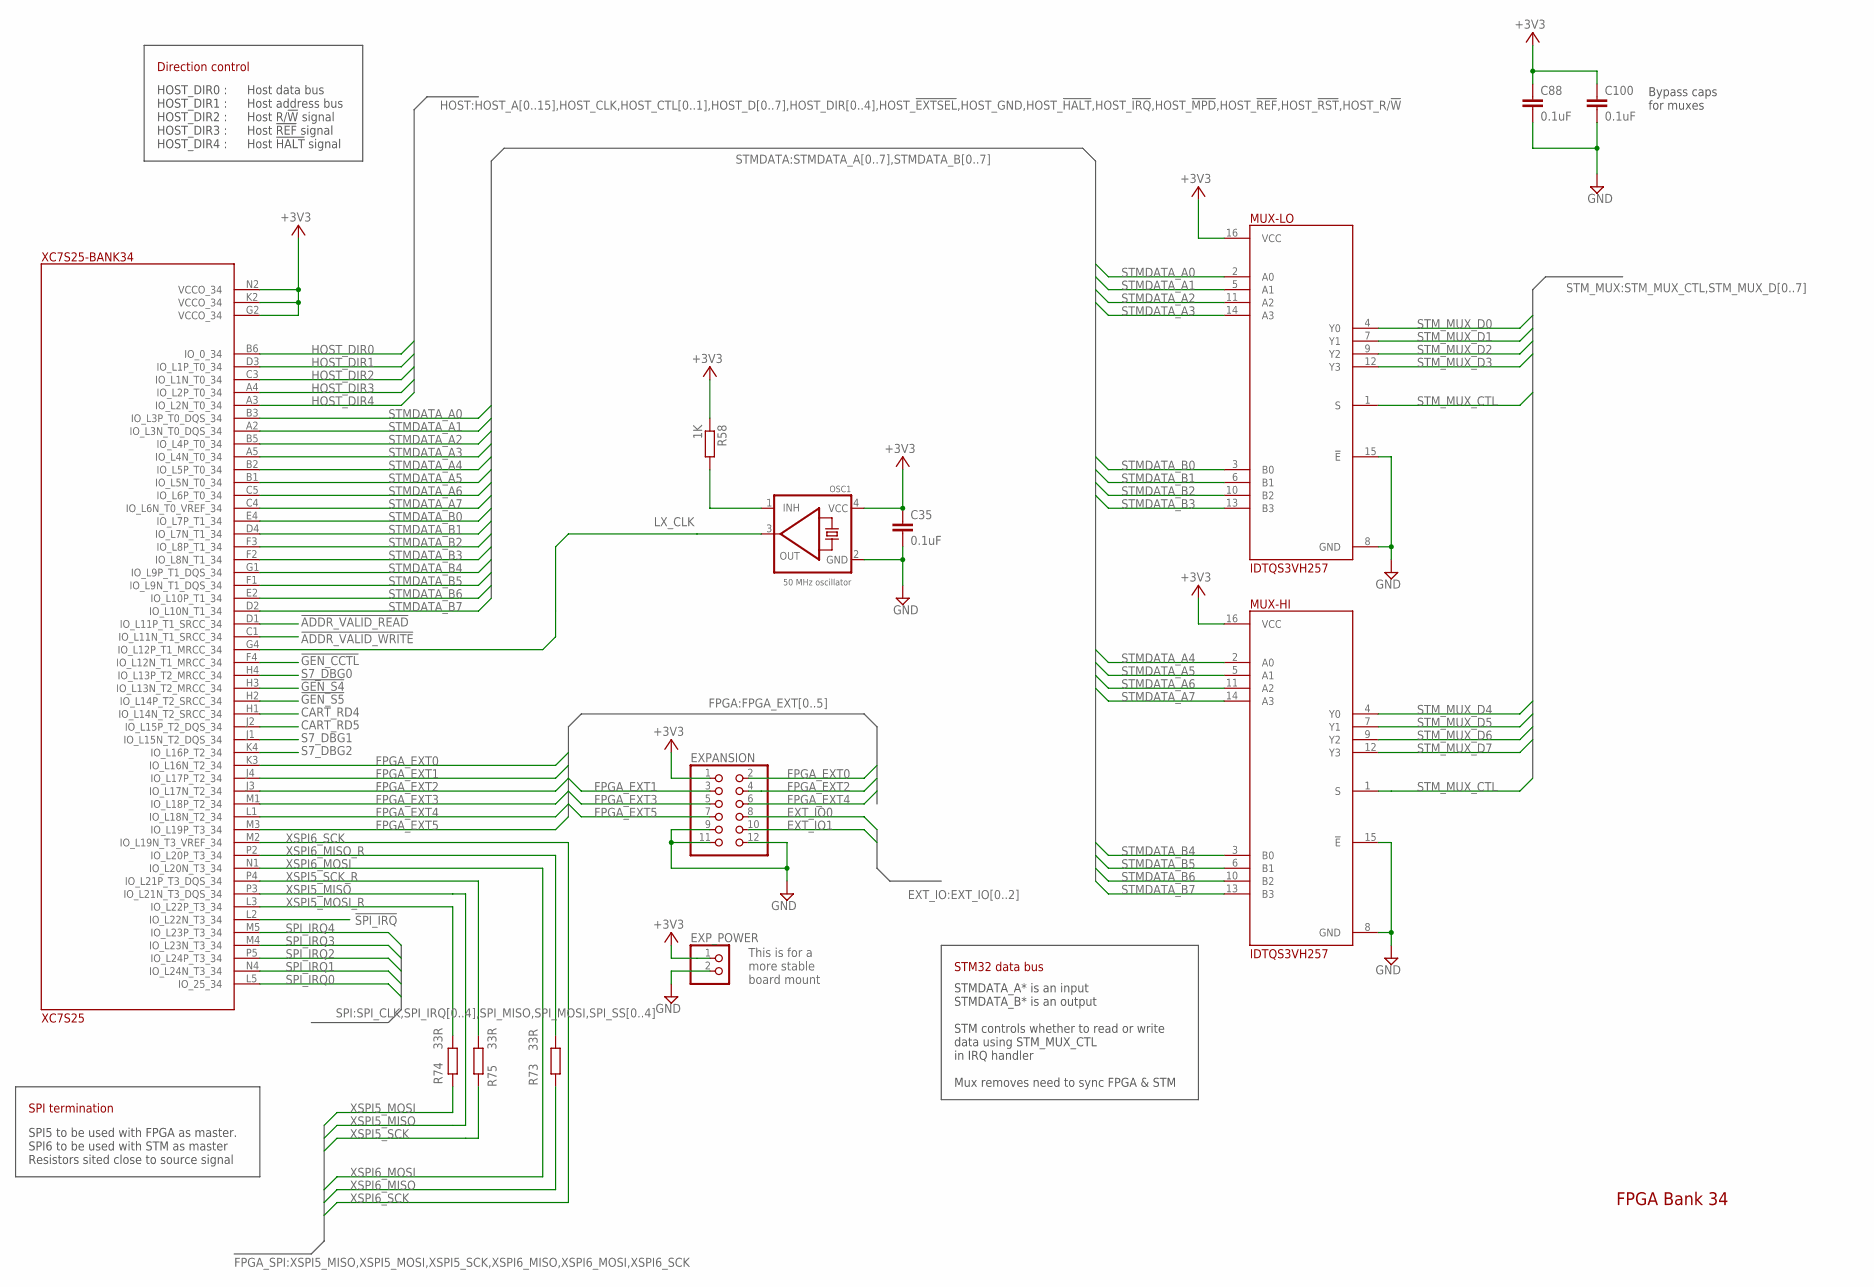
[picture p151: schematic xio2.sch, sheet 17, FPGA Bank 34]

Parts:
C35, C88, C100: 0.1uF; C0201
EXPANSION: PINHD-2X6; 2X06
EXP_POWER: PINHD-1X2; 1X02
MUX-HI: IDTQS3VH257; SO16
MUX-LO: IDTQS3VH257; SO16
OSC1: 50 MHz oscillator; OSC_3.2X2.5MM
R58: 1K; R0201
R73, R74, R75: 33R; R0201
XC7S25: XC7S25; BGA196C100P14X14_1500X1500X146

Connections:
!ADDR_VALID_READ!: XC7S25.D1 (IO_L11P_T1_SRCC_34); also elsewhere on the board
!ADDR_VALID_WRITE!: XC7S25.C1 (IO_L11N_T1_SRCC_34); also elsewhere on the board
!GEN_CCTL!: XC7S25.F4 (IO_L12N_T1_MRCC_34); also elsewhere on the board
!GEN_S4!: XC7S25.H3 (IO_L13N_T2_MRCC_34); also elsewhere on the board
!GEN_S5!: XC7S25.H2 (IO_L14P_T2_SRCC_34); also elsewhere on the board
!SPI_IRQ!: XC7S25.L2 (IO_L22N_T3_34); also elsewhere on the board
+3V3: C35.1, C88.1, C100.1, EXPANSION.1, EXP_POWER.1, MUX-HI.16 (VCC), MUX-LO.16 (VCC), OSC1.4 (VCC), R58.1, XC7S25.G2 (VCCO_34), XC7S25.K2 (VCCO_34), XC7S25.N2 (VCCO_34); also elsewhere on the board
CART_RD4: XC7S25.H1 (IO_L14N_T2_SRCC_34); also elsewhere on the board
CART_RD5: XC7S25.J2 (IO_L15P_T2_DQS_34); also elsewhere on the board
EXT_IO0: EXPANSION.8; also elsewhere on the board
EXT_IO1: EXPANSION.10; also elsewhere on the board
FPGA_EXT0: EXPANSION.2, XC7S25.K3 (IO_L16N_T2_34)
FPGA_EXT1: EXPANSION.3, XC7S25.J4 (IO_L17P_T2_34)
FPGA_EXT2: EXPANSION.4, XC7S25.J3 (IO_L17N_T2_34)
FPGA_EXT3: EXPANSION.5, XC7S25.M1 (IO_L18P_T2_34)
FPGA_EXT4: EXPANSION.6, XC7S25.L1 (IO_L18N_T2_34)
FPGA_EXT5: EXPANSION.7, XC7S25.M3 (IO_L19P_T3_34)
GND: C35.2, C88.2, C100.2, EXPANSION.9, EXPANSION.11, EXPANSION.12, EXP_POWER.2, MUX-HI.8 (GND), MUX-HI.15 (!E!), MUX-LO.8 (GND), MUX-LO.15 (!E!), OSC1.2 (GND); also elsewhere on the board
HOST_DIR0: XC7S25.B6 (IO_0_34); also elsewhere on the board
HOST_DIR1: XC7S25.D3 (IO_L1P_T0_34); also elsewhere on the board
HOST_DIR2: XC7S25.C3 (IO_L1N_T0_34); also elsewhere on the board
HOST_DIR3: XC7S25.A4 (IO_L2P_T0_34); also elsewhere on the board
HOST_DIR4: XC7S25.A3 (IO_L2N_T0_34); also elsewhere on the board
LX_CLK: OSC1.3 (OUT), XC7S25.G4 (IO_L12P_T1_MRCC_34)
unnamed: OSC1.1 (INH), R58.2
S7_DBG0: XC7S25.H4 (IO_L13P_T2_MRCC_34); also elsewhere on the board
S7_DBG1: XC7S25.J1 (IO_L15N_T2_DQS_34); also elsewhere on the board
S7_DBG2: XC7S25.K4 (IO_L16P_T2_34); also elsewhere on the board
SPI_IRQ0: XC7S25.L5 (IO_25_34); also elsewhere on the board
SPI_IRQ1: XC7S25.N4 (IO_L24N_T3_34); also elsewhere on the board
SPI_IRQ2: XC7S25.P5 (IO_L24P_T3_34); also elsewhere on the board
SPI_IRQ3: XC7S25.M4 (IO_L23N_T3_34); also elsewhere on the board
SPI_IRQ4: XC7S25.M5 (IO_L23P_T3_34); also elsewhere on the board
STMDATA_A0: MUX-LO.2 (A0), XC7S25.B3 (IO_L3P_T0_DQS_34)
STMDATA_A1: MUX-LO.5 (A1), XC7S25.A2 (IO_L3N_T0_DQS_34)
STMDATA_A2: MUX-LO.11 (A2), XC7S25.B5 (IO_L4P_T0_34)
STMDATA_A3: MUX-LO.14 (A3), XC7S25.A5 (IO_L4N_T0_34)
STMDATA_A4: MUX-HI.2 (A0), XC7S25.B2 (IO_L5P_T0_34)
STMDATA_A5: MUX-HI.5 (A1), XC7S25.B1 (IO_L5N_T0_34)
STMDATA_A6: MUX-HI.11 (A2), XC7S25.C5 (IO_L6P_T0_34)
STMDATA_A7: MUX-HI.14 (A3), XC7S25.C4 (IO_L6N_T0_VREF_34)
STMDATA_B0: MUX-LO.3 (B0), XC7S25.E4 (IO_L7P_T1_34)
STMDATA_B1: MUX-LO.6 (B1), XC7S25.D4 (IO_L7N_T1_34)
STMDATA_B2: MUX-LO.10 (B2), XC7S25.F3 (IO_L8P_T1_34)
STMDATA_B3: MUX-LO.13 (B3), XC7S25.F2 (IO_L8N_T1_34)
STMDATA_B4: MUX-HI.3 (B0), XC7S25.G1 (IO_L9P_T1_DQS_34)
STMDATA_B5: MUX-HI.6 (B1), XC7S25.F1 (IO_L9N_T1_DQS_34)
STMDATA_B6: MUX-HI.10 (B2), XC7S25.E2 (IO_L10P_T1_34)
STMDATA_B7: MUX-HI.13 (B3), XC7S25.D2 (IO_L10N_T1_34)
STM_MUX_CTL: MUX-HI.1 (S), MUX-LO.1 (S); also elsewhere on the board
STM_MUX_D0: MUX-LO.4 (Y0); also elsewhere on the board
STM_MUX_D1: MUX-LO.7 (Y1); also elsewhere on the board
STM_MUX_D2: MUX-LO.9 (Y2); also elsewhere on the board
STM_MUX_D3: MUX-LO.12 (Y3); also elsewhere on the board
STM_MUX_D4: MUX-HI.4 (Y0); also elsewhere on the board
STM_MUX_D5: MUX-HI.7 (Y1); also elsewhere on the board
STM_MUX_D6: MUX-HI.9 (Y2); also elsewhere on the board
STM_MUX_D7: MUX-HI.12 (Y3); also elsewhere on the board
XSPI5_MISO: XC7S25.P3 (IO_L21N_T3_DQS_34); also elsewhere on the board
XSPI5_MOSI: R74.1; also elsewhere on the board
XSPI5_MOSI_R: R74.2, XC7S25.L3 (IO_L22P_T3_34)
XSPI5_SCK: R75.1; also elsewhere on the board
XSPI5_SCK_R: R75.2, XC7S25.P4 (IO_L21P_T3_DQS_34)
XSPI6_MISO: R73.1; also elsewhere on the board
XSPI6_MISO_R: R73.2, XC7S25.P2 (IO_L20P_T3_34)
XSPI6_MOSI: XC7S25.N1 (IO_L20N_T3_34); also elsewhere on the board
XSPI6_SCK: XC7S25.M2 (IO_L19N_T3_VREF_34); also elsewhere on the board

Notes on the sheet:
STMDATA_A* is an input STMDATA_B* is an output STM controls whether to read or write data using STM_MUX_CTL in IRQ handler Mux removes need to sync FPGA & STM
SPI5 to be used with FPGA as master. SPI6 to be used with STM as master Resistors sited close to source signal
SPI termination
HOST_DIR0 : HOST_DIR1 : HOST_DIR2 : HOST_DIR3 : HOST_DIR4 :
Direction control
Host data bus Host address bus Host R/!W! signal Host !REF! signal Host !HALT! signal
STM32 data bus
Bypass caps for muxes
FPGA Bank 34
This is for a more stable board mount

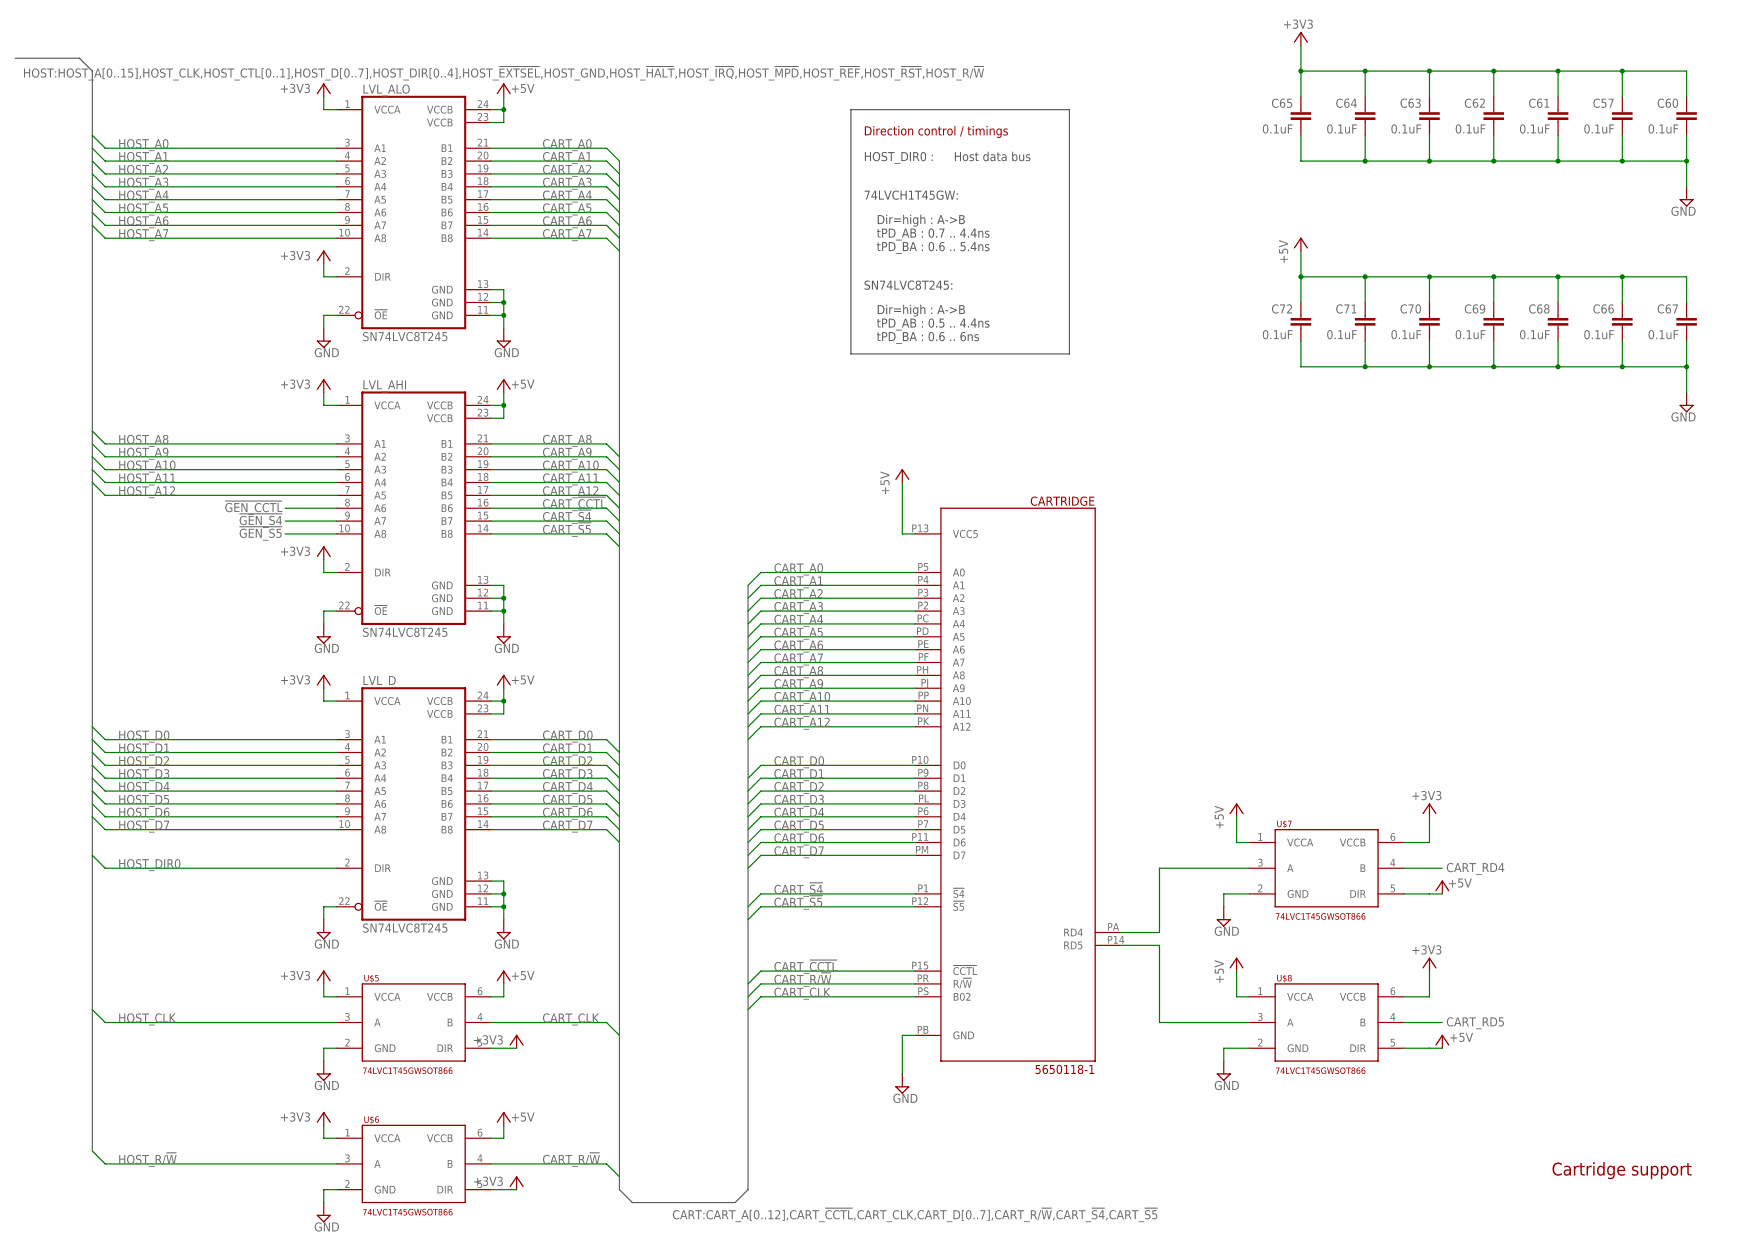
[picture p152: schematic xio2.sch, sheet 18, Cartridge port]

Parts:
C57, C60, C61, C62, C63, C64, C65, C66, C67, C68, C69, C70, C71, C72: 0.1uF; C0201
CARTRIDGE: 5650118-1; A8_CART
LVL_AHI: SN74LVC8T245; TSSOP24
LVL_ALO: SN74LVC8T245; TSSOP24
LVL_D: SN74LVC8T245; TSSOP24
U$5, U$6, U$7, U$8: 74LVC1T45GWSOT866; SOT886

Connections:
!GEN_CCTL!: LVL_AHI.8 (A6); also elsewhere on the board
!GEN_S4!: LVL_AHI.9 (A7); also elsewhere on the board
!GEN_S5!: LVL_AHI.10 (A8); also elsewhere on the board
+3V3: C57.1, C60.1, C61.1, C62.1, C63.1, C64.1, C65.1, LVL_AHI.1 (VCCA), LVL_AHI.2 (DIR), LVL_ALO.1 (VCCA), LVL_ALO.2 (DIR), LVL_D.1 (VCCA), U$5.1 (VCCA), U$5.5 (DIR), U$6.1 (VCCA), U$6.5 (DIR), U$7.6 (VCCB), U$8.6 (VCCB); also elsewhere on the board
+5V: C66.1, C67.1, C68.1, C69.1, C70.1, C71.1, C72.1, CARTRIDGE.P13 (VCC5), LVL_AHI.23 (VCCB), LVL_AHI.24 (VCCB), LVL_ALO.23 (VCCB), LVL_ALO.24 (VCCB), LVL_D.23 (VCCB), LVL_D.24 (VCCB), U$5.6 (VCCB), U$6.6 (VCCB), U$7.1 (VCCA), U$7.5 (DIR), U$8.1 (VCCA), U$8.5 (DIR); also elsewhere on the board
CART_!CCTL!: CARTRIDGE.P15 (!CCTL!), LVL_AHI.16 (B6)
CART_!S4!: CARTRIDGE.P1 (!S4!), LVL_AHI.15 (B7)
CART_!S5!: CARTRIDGE.P12 (!S5!), LVL_AHI.14 (B8)
CART_A0: CARTRIDGE.P5 (A0), LVL_ALO.21 (B1)
CART_A1: CARTRIDGE.P4 (A1), LVL_ALO.20 (B2)
CART_A2: CARTRIDGE.P3 (A2), LVL_ALO.19 (B3)
CART_A3: CARTRIDGE.P2 (A3), LVL_ALO.18 (B4)
CART_A4: CARTRIDGE.PC (A4), LVL_ALO.17 (B5)
CART_A5: CARTRIDGE.PD (A5), LVL_ALO.16 (B6)
CART_A6: CARTRIDGE.PE (A6), LVL_ALO.15 (B7)
CART_A7: CARTRIDGE.PF (A7), LVL_ALO.14 (B8)
CART_A8: CARTRIDGE.PH (A8), LVL_AHI.21 (B1)
CART_A9: CARTRIDGE.PJ (A9), LVL_AHI.20 (B2)
CART_A10: CARTRIDGE.PP (A10), LVL_AHI.19 (B3)
CART_A11: CARTRIDGE.PN (A11), LVL_AHI.18 (B4)
CART_A12: CARTRIDGE.PK (A12), LVL_AHI.17 (B5)
CART_CLK: CARTRIDGE.PS (B02), U$5.4 (B)
CART_D0: CARTRIDGE.P10 (D0), LVL_D.21 (B1)
CART_D1: CARTRIDGE.P9 (D1), LVL_D.20 (B2)
CART_D2: CARTRIDGE.P8 (D2), LVL_D.19 (B3)
CART_D3: CARTRIDGE.PL (D3), LVL_D.18 (B4)
CART_D4: CARTRIDGE.P6 (D4), LVL_D.17 (B5)
CART_D5: CARTRIDGE.P7 (D5), LVL_D.16 (B6)
CART_D6: CARTRIDGE.P11 (D6), LVL_D.15 (B7)
CART_D7: CARTRIDGE.PM (D7), LVL_D.14 (B8)
CART_R/!W!: CARTRIDGE.PR (R/!W!), U$6.4 (B)
CART_RD4: U$7.4 (B); also elsewhere on the board
CART_RD5: U$8.4 (B); also elsewhere on the board
GND: C57.2, C60.2, C61.2, C62.2, C63.2, C64.2, C65.2, C66.2, C67.2, C68.2, C69.2, C70.2, C71.2, C72.2, CARTRIDGE.PB (GND), LVL_AHI.11 (GND), LVL_AHI.12 (GND), LVL_AHI.13 (GND), LVL_AHI.22 (!OE!), LVL_ALO.11 (GND), LVL_ALO.12 (GND), LVL_ALO.13 (GND), LVL_ALO.22 (!OE!), LVL_D.11 (GND), LVL_D.12 (GND), LVL_D.13 (GND), LVL_D.22 (!OE!), U$5.2 (GND), U$6.2 (GND), U$7.2 (GND), U$8.2 (GND); also elsewhere on the board
HOST_A0: LVL_ALO.3 (A1); also elsewhere on the board
HOST_A1: LVL_ALO.4 (A2); also elsewhere on the board
HOST_A2: LVL_ALO.5 (A3); also elsewhere on the board
HOST_A3: LVL_ALO.6 (A4); also elsewhere on the board
HOST_A4: LVL_ALO.7 (A5); also elsewhere on the board
HOST_A5: LVL_ALO.8 (A6); also elsewhere on the board
HOST_A6: LVL_ALO.9 (A7); also elsewhere on the board
HOST_A7: LVL_ALO.10 (A8); also elsewhere on the board
HOST_A8: LVL_AHI.3 (A1); also elsewhere on the board
HOST_A9: LVL_AHI.4 (A2); also elsewhere on the board
HOST_A10: LVL_AHI.5 (A3); also elsewhere on the board
HOST_A11: LVL_AHI.6 (A4); also elsewhere on the board
HOST_A12: LVL_AHI.7 (A5); also elsewhere on the board
HOST_CLK: U$5.3 (A); also elsewhere on the board
HOST_D0: LVL_D.3 (A1); also elsewhere on the board
HOST_D1: LVL_D.4 (A2); also elsewhere on the board
HOST_D2: LVL_D.5 (A3); also elsewhere on the board
HOST_D3: LVL_D.6 (A4); also elsewhere on the board
HOST_D4: LVL_D.7 (A5); also elsewhere on the board
HOST_D5: LVL_D.8 (A6); also elsewhere on the board
HOST_D6: LVL_D.9 (A7); also elsewhere on the board
HOST_D7: LVL_D.10 (A8); also elsewhere on the board
HOST_DIR0: LVL_D.2 (DIR); also elsewhere on the board
HOST_R/!W!: U$6.3 (A); also elsewhere on the board
unnamed: CARTRIDGE.PA (RD4), U$7.3 (A)
unnamed: CARTRIDGE.P14 (RD5), U$8.3 (A)

Notes on the sheet:
Dir=high : A->B tPD_AB : 0.7 .. 4.4ns tPD_BA : 0.6 .. 5.4ns
74LVCH1T45GW:
SN74LVC8T245:
Dir=high : A->B tPD_AB : 0.5 .. 4.4ns tPD_BA : 0.6 .. 6ns
HOST_DIR0 :
Direction control / timings
Host data bus
Cartridge support

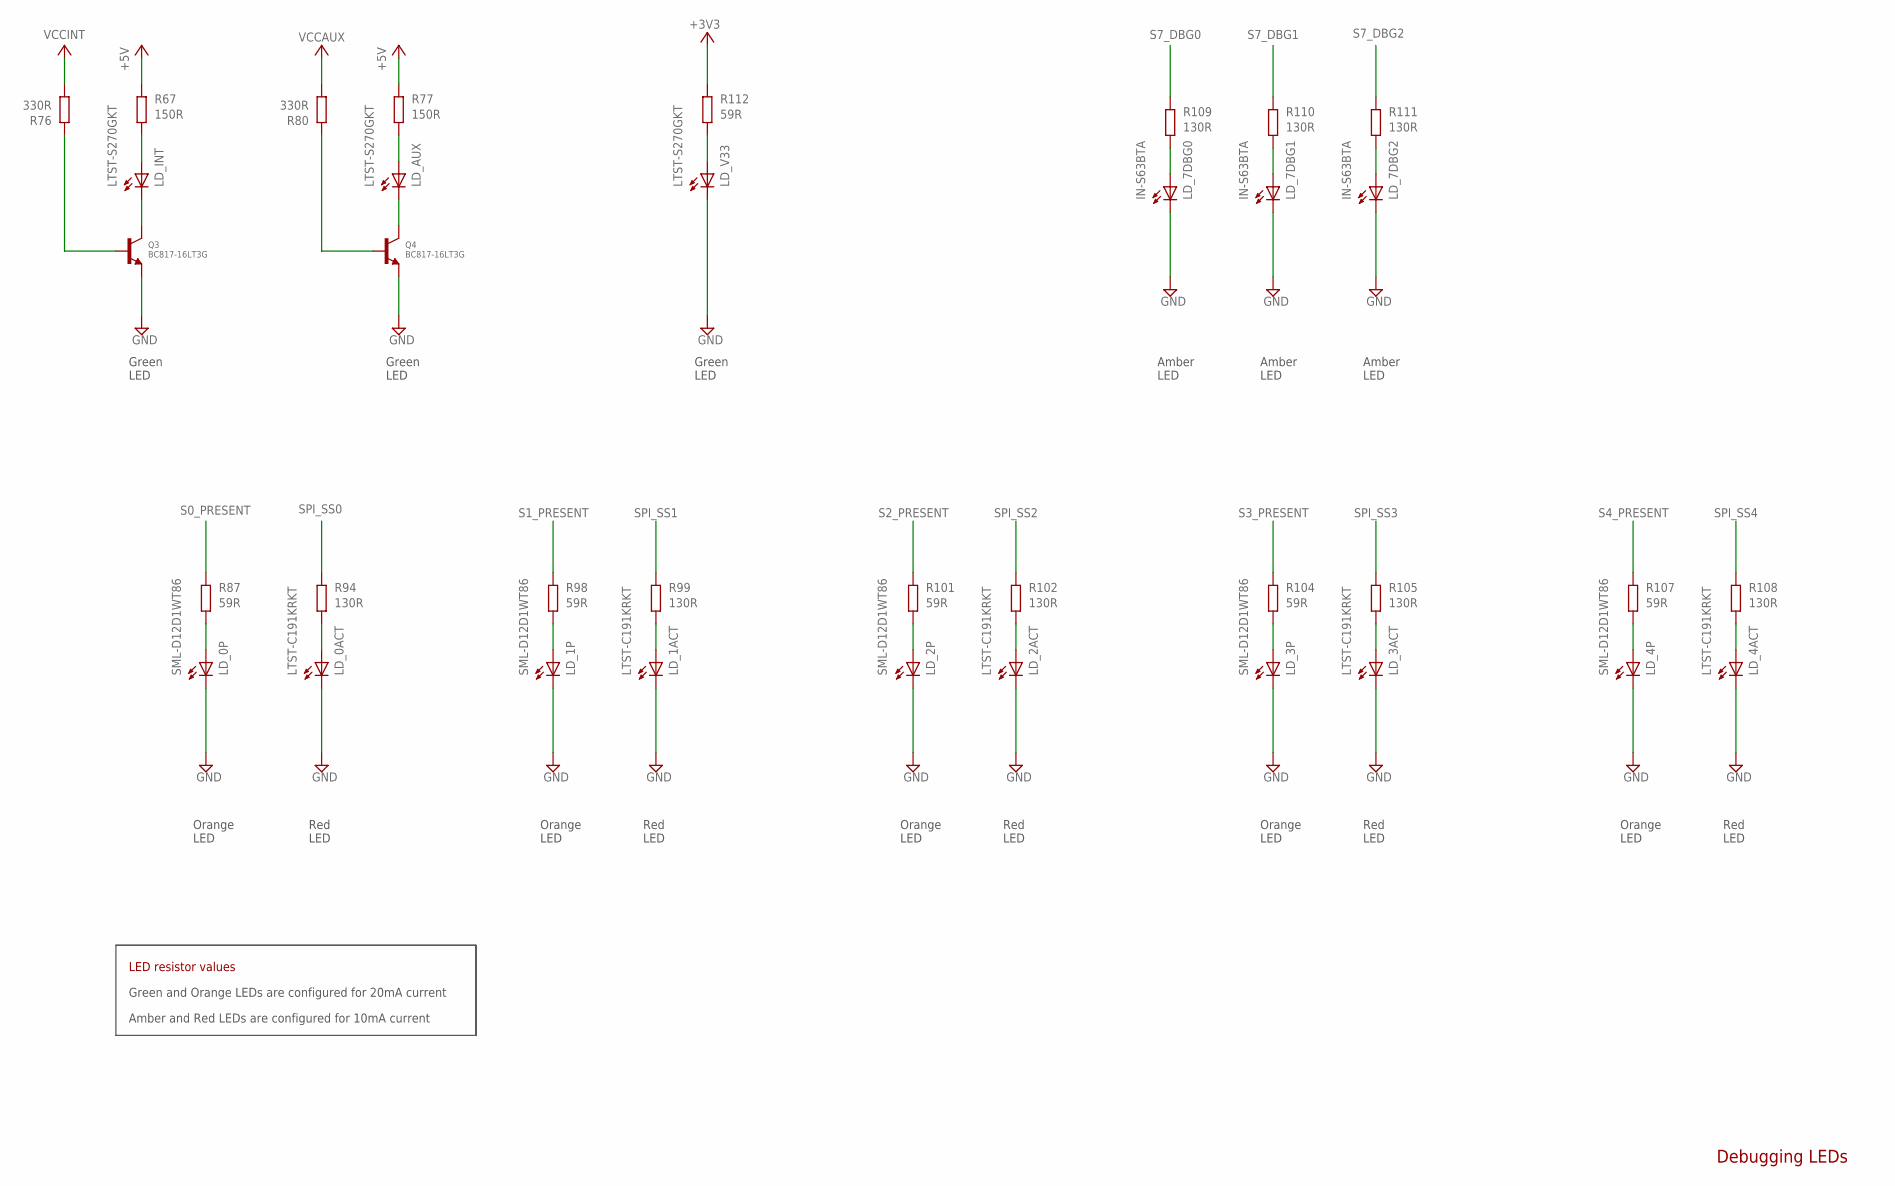
[picture p153: schematic xio2.sch, sheet 19, LEDs]

Parts:
LD_0ACT, LD_1ACT, LD_2ACT, LD_3ACT, LD_4ACT: LTST-C191KRKT; CHIPLED_0603
LD_0P, LD_1P, LD_2P, LD_3P, LD_4P: SML-D12D1WT86; CHIPLED_0603
LD_7DBG0, LD_7DBG1, LD_7DBG2: IN-S63BTA; CHIPLED_0603
LD_AUX: LTST-S270GKT; CHIPLED_0603
LD_INT: LTST-S270GKT; CHIPLED_0603
LD_V33: LTST-S270GKT; CHIPLED_0603
Q3, Q4: BC817-16LT3G; SOT23-R
R67, R77: 150R; R0402
R76, R80: 330R; R0402
R87, R98, R101, R104, R107, R112: 59R; R0402
R94, R99, R102, R105, R108, R109, R110, R111: 130R; R0402

Connections:
+3V3: R112.1; also elsewhere on the board
+5V: R67.1, R77.1; also elsewhere on the board
GND: LD_0ACT.C, LD_0P.C, LD_1ACT.C, LD_1P.C, LD_2ACT.C, LD_2P.C, LD_3ACT.C, LD_3P.C, LD_4ACT.C, LD_4P.C, LD_7DBG0.C, LD_7DBG1.C, LD_7DBG2.C, LD_V33.C, Q3.2 (E), Q4.2 (E); also elsewhere on the board
unnamed: LD_INT.A, R67.2
unnamed: Q3.1 (B), R76.1
unnamed: LD_INT.C, Q3.3 (C)
unnamed: LD_AUX.A, R77.2
unnamed: LD_0P.A, R87.2
unnamed: LD_0ACT.A, R94.2
unnamed: Q4.1 (B), R80.1
unnamed: LD_AUX.C, Q4.3 (C)
unnamed: LD_1P.A, R98.2
unnamed: LD_1ACT.A, R99.2
unnamed: LD_2P.A, R101.2
unnamed: LD_2ACT.A, R102.2
unnamed: LD_3P.A, R104.2
unnamed: LD_3ACT.A, R105.2
unnamed: LD_4P.A, R107.2
unnamed: LD_4ACT.A, R108.2
unnamed: LD_7DBG0.A, R109.2
unnamed: LD_7DBG1.A, R110.2
unnamed: LD_7DBG2.A, R111.2
unnamed: LD_V33.A, R112.2
S0_PRESENT: R87.1; also elsewhere on the board
S1_PRESENT: R98.1; also elsewhere on the board
S2_PRESENT: R101.1; also elsewhere on the board
S3_PRESENT: R104.1; also elsewhere on the board
S4_PRESENT: R107.1; also elsewhere on the board
S7_DBG0: R109.1; also elsewhere on the board
S7_DBG1: R110.1; also elsewhere on the board
S7_DBG2: R111.1; also elsewhere on the board
SPI_SS0: R94.1; also elsewhere on the board
SPI_SS1: R99.1; also elsewhere on the board
SPI_SS2: R102.1; also elsewhere on the board
SPI_SS3: R105.1; also elsewhere on the board
SPI_SS4: R108.1; also elsewhere on the board
VCCAUX: R80.2; also elsewhere on the board
VCCINT: R76.2; also elsewhere on the board

Notes on the sheet:
Debugging LEDs
Green LED
Amber LED
Orange LED
Red LED
Green and Orange LEDs are configured for 20mA current
Amber and Red LEDs are configured for 10mA current
LED resistor values
