ThrudTheBarbarian/pbxl/boards/xio2/xio2.brd

## EAGLE design boards/xio2/xio2.brd (continued)

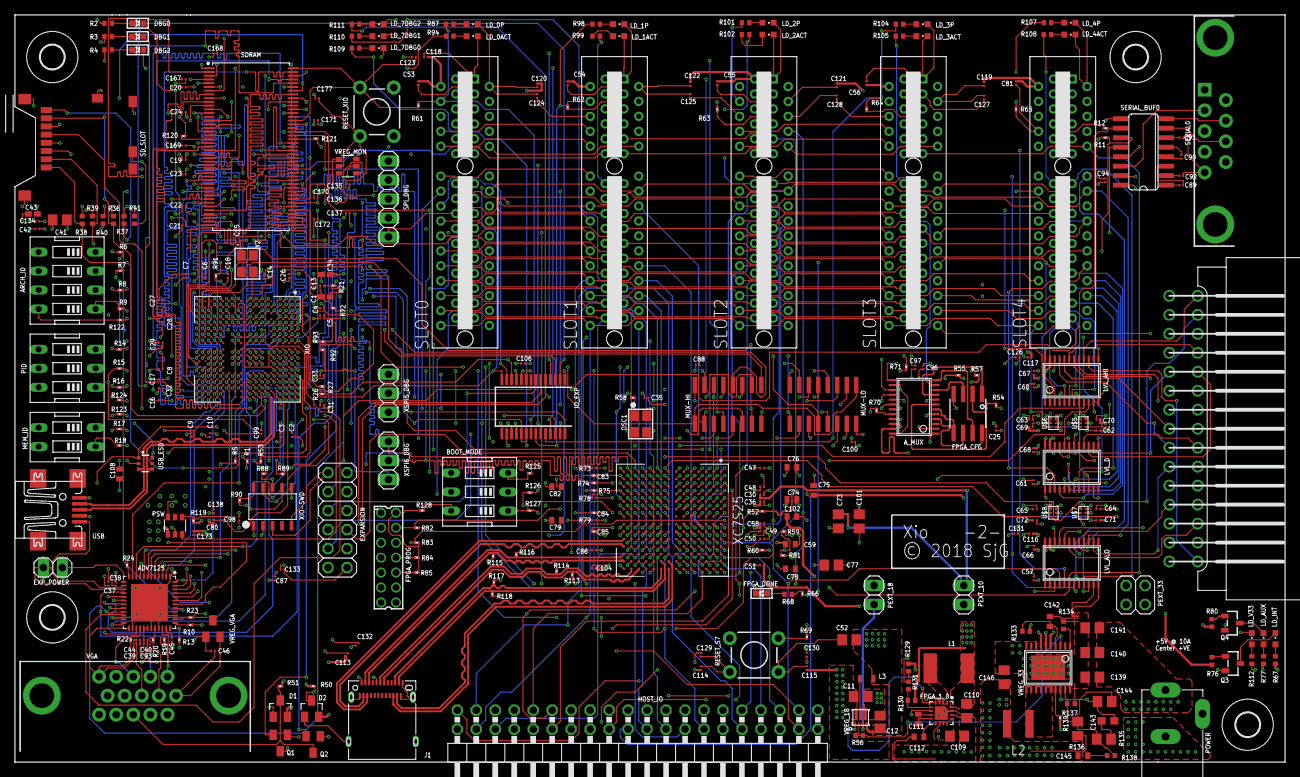
[picture p154: board xio2.brd from above]

Board: 6 copper layers, 170.0 x 100.0 mm, 352 parts (0 on the bottom side), 410 nets.
