ThrudTheBarbarian/pbxl/boards/xio/xio.brd

## EAGLE design boards/xio/xio.brd (2018-08-07, an earlier design)

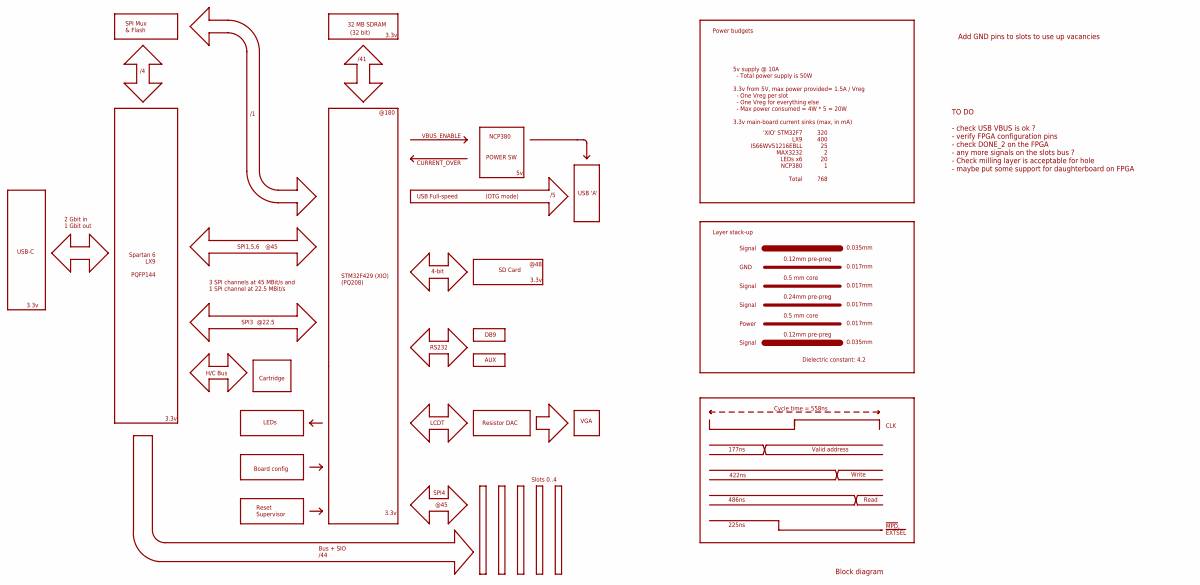
[picture p155: schematic xio.sch, sheet 1, Block diagram]

Notes on the sheet:
USB-C
3.3v
STM32F429 (XIO) (PQ208)
SPI4
@45
Slots 0..4
Bus + SIO /44
RS232
32 MB SDRAM
/41
(32 bit)
POWER SW
USB Full-speed
CURRENT_OVER
VBUS_ENABLE
SD Card
@48
@180
NCP380
(OTG mode)
USB 'A'
DB9
5v supply @ 10A - Total power supply is 50W 3.3v from 5V, max power provided= 1.5A / Vreg - One Vreg per slot - One Vreg for everything else - Max power consumed = 4W * 5 = 20W 3.3v main-board current sinks (max, in mA)
'XIO' STM32F7 LX9 IS66WV51216EBLL MAX3232 LEDs x6 NCP380 Total
320 400 25 2 20 1 768
0.5 mm core
0.12mm pre-preg
0.035mm
0.017mm
Layer stack-up
GND
Power
Dielectric constant: 4.2
Cycle time = 558ns
Valid address
Write
Read
177ns
422ns
486ns
225ns
!MPD!, !EXTSEL!
CLK
Power budgets
Spartan 6 LX9 PQFP144
AUX
LCDT
Resistor DAC
VGA
2 Gbit in 1 Gbit out
4-bit
Add GND pins to slots to use up vacancies
SPI Mux & Flash
Signal
0.24mm pre-preg
Block diagram
Reset Supervisor
Board config
LEDs
H/C Bus
Cartridge
SPI1,5,6
SPI3
@22.5
3 SPI channels at 45 MBit/s and 1 SPI channel at 22.5 MBit/s
TO DO - check USB VBUS is ok ? - verify FPGA configuration pins - check DONE_2 on the FPGA - any more signals on the slots bus ? - Check milling layer is acceptable for hole - maybe put some support for daughterboard on FPGA

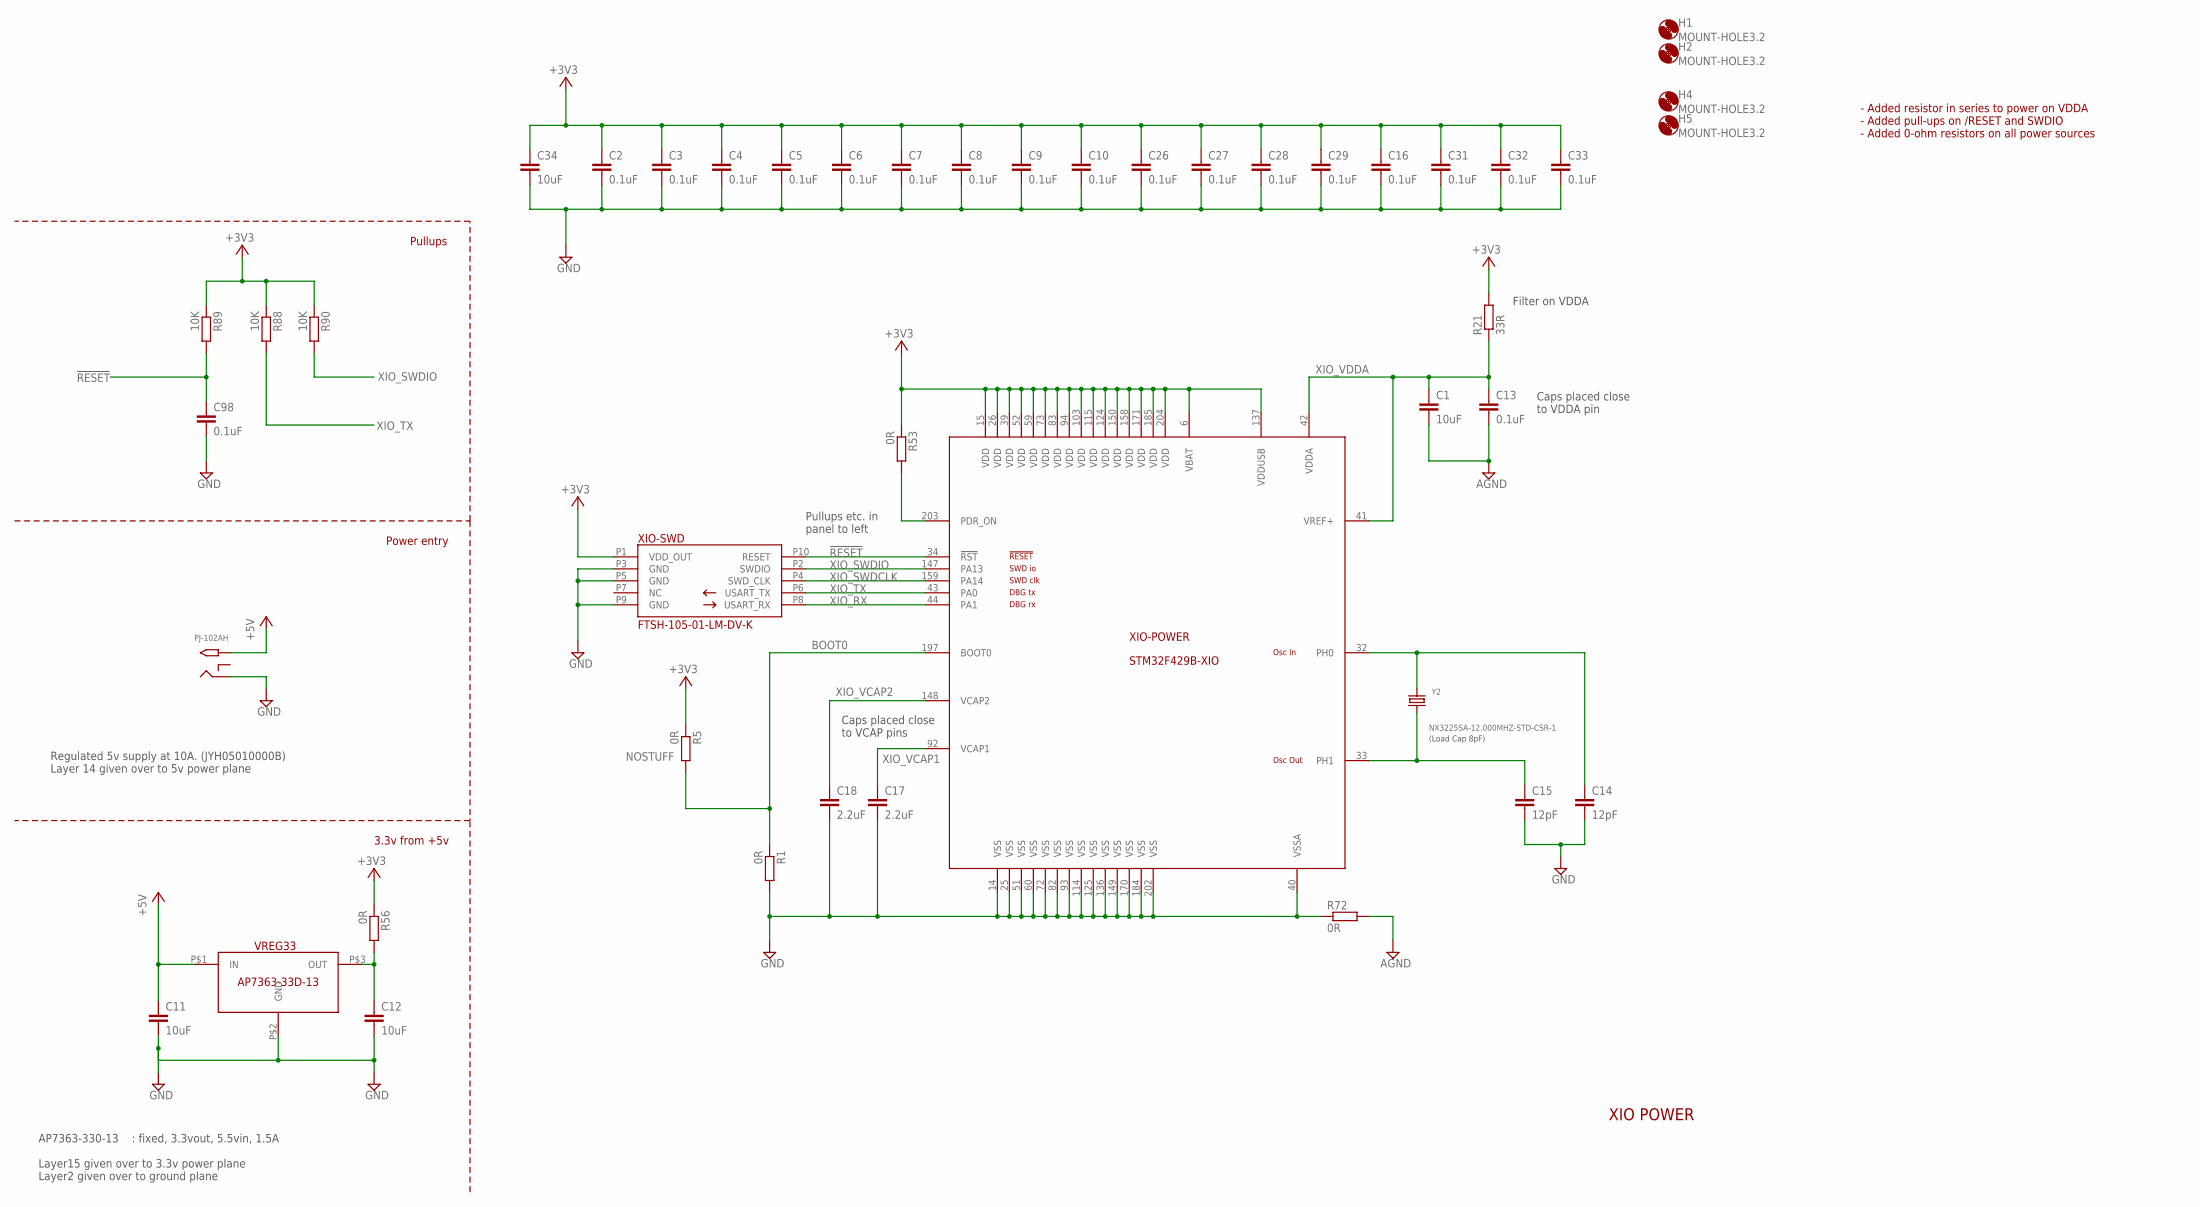
[picture p156: schematic xio.sch, sheet 2, XIO Power]

Parts:
C1, C11, C12, C34: 10uF; C0402K
C2, C3, C4, C5, C6, C7, C8, C9, C10, C13, C16, C26, C27, C28, C29, C31, C32, C33, C98: 0.1uF; C0402K
C14, C15: 12pF; C0402K
C17, C18: 2.2uF; C0402K
H1, H2, H4, H5: MOUNT-HOLE3.2; 3,2
PJ-102AH: PJ-102AH; PJ-102A
R1, R5, R53, R56, R72: 0R; R0402
R21: 33R; R0402
R88, R89, R90: 10K; R0402
VREG33: AP7363-33D-13; TO252-3L
XIO: STM32F429B-XIO; PQFP208
XIO-SWD: FTSH-105-01-LM-DV-K; SWD_DEBUG
Y2: NX3225SA-12.000MHZ-STD-CSR-1; CRYSTAL_3.2X2.5

Connections:
!RESET!: C98.1, R89.2, XIO.34 (!RST!), XIO-SWD.P10 (RESET); also elsewhere on the board
+3V3: C2.1, C3.1, C4.1, C5.1, C6.1, C7.1, C8.1, C9.1, C10.1, C16.1, C26.1, C27.1, C28.1, C29.1, C31.1, C32.1, C33.1, C34.1, R5.1, R21.2, R53.1, R56.1, R88.1, R89.1, R90.1, XIO.6 (VBAT), XIO.15 (VDD), XIO.26 (VDD), XIO.39 (VDD), XIO.52 (VDD), XIO.59 (VDD), XIO.73 (VDD), XIO.83 (VDD), XIO.94 (VDD), XIO.103 (VDD), XIO.115 (VDD), XIO.124 (VDD), XIO.137 (VDDUSB), XIO.150 (VDD), XIO.158 (VDD), XIO.171 (VDD), XIO.185 (VDD), XIO.204 (VDD), XIO-SWD.P1 (VDD_OUT); also elsewhere on the board
+5V: C11.1, PJ-102AH.TIP, VREG33.P$1 (IN); also elsewhere on the board
AGND: C1.2, C13.2, R72.2
BOOT0: R1.1, R5.2, XIO.197 (BOOT0)
GND: C2.2, C3.2, C4.2, C5.2, C6.2, C7.2, C8.2, C9.2, C10.2, C11.2, C12.2, C14.2, C15.2, C16.2, C17.2, C18.2, C26.2, C27.2, C28.2, C29.2, C31.2, C32.2, C33.2, C34.2, C98.2, PJ-102AH.RING, R1.2, R72.1, VREG33.P$2 (GND), XIO.14 (VSS), XIO.25 (VSS), XIO.40 (VSSA), XIO.51 (VSS), XIO.60 (VSS), XIO.72 (VSS), XIO.82 (VSS), XIO.93 (VSS), XIO.114 (VSS), XIO.125 (VSS), XIO.136 (VSS), XIO.149 (VSS), XIO.170 (VSS), XIO.184 (VSS), XIO.202 (VSS), XIO-SWD.P3 (GND), XIO-SWD.P5 (GND), XIO-SWD.P9 (GND); also elsewhere on the board
unnamed: C15.1, XIO.33 (PH1), Y2.1
unnamed: C14.1, XIO.32 (PH0), Y2.2
unnamed: C12.1, R56.2, VREG33.P$3 (OUT)
PDR_ON: R53.2, XIO.203 (PDR_ON)
XIO_RX: XIO.44 (PA1), XIO-SWD.P8 (USART_RX)
XIO_SWDCLK: XIO.159 (PA14), XIO-SWD.P4 (SWD_CLK)
XIO_SWDIO: R90.2, XIO.147 (PA13), XIO-SWD.P2 (SWDIO)
XIO_TX: R88.2, XIO.43 (PA0), XIO-SWD.P6 (USART_TX)
XIO_VCAP1: C17.1, XIO.92 (VCAP1)
XIO_VCAP2: C18.1, XIO.148 (VCAP2)
XIO_VDDA: C1.1, C13.1, R21.1, XIO.41 (VREF+), XIO.42 (VDDA)

Notes on the sheet:
Power entry
3.3v from +5v
XIO POWER
AP7363-330-13 : fixed, 3.3vout, 5.5vin, 1.5A Layer15 given over to 3.3v power plane Layer2 given over to ground plane
Regulated 5v supply at 10A. (JYH05010000B) Layer 14 given over to 5v power plane
Caps placed close to VDDA pin
Caps placed close to VCAP pins
(Load Cap 8pF)
Pullups
- Added resistor in series to power on VDDA - Added pull-ups on /RESET and SWDIO - Added 0-ohm resistors on all power sources
Filter on VDDA
Pullups etc. in panel to left

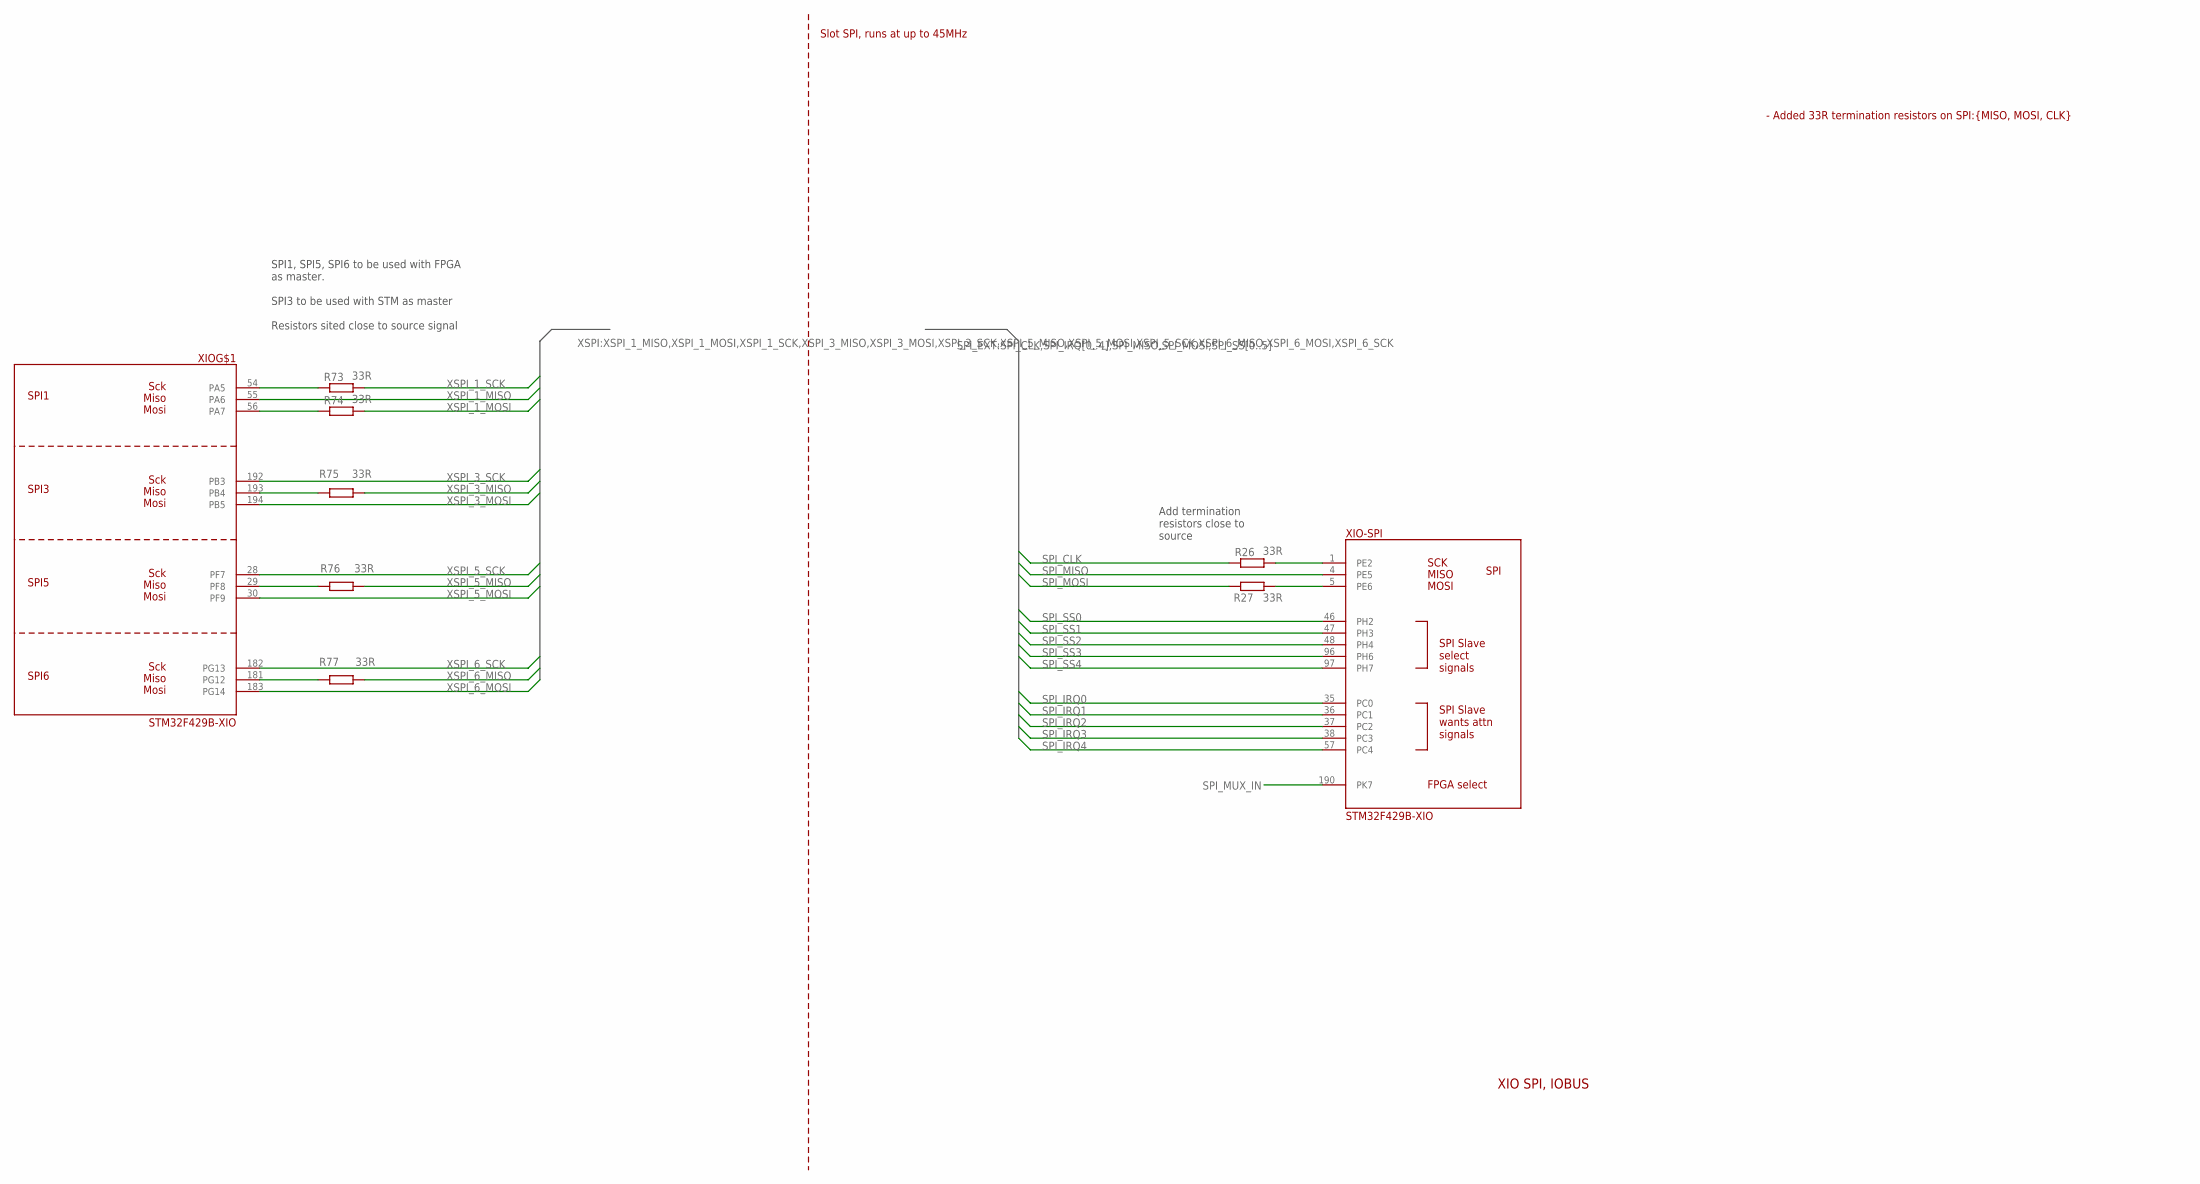
[picture p157: schematic xio.sch, sheet 3, XIO SPI, IO-BUS]

Parts:
R26, R27, R73, R74, R75, R76, R77: 33R; R0402
XIO: STM32F429B-XIO; PQFP208

Connections:
unnamed: R26.2, XIO.1 (PE2)
unnamed: R27.2, XIO.5 (PE6)
unnamed: R75.1, XIO.193 (PB4)
unnamed: R76.1, XIO.29 (PF8)
unnamed: R77.1, XIO.181 (PG12)
unnamed: R73.1, XIO.54 (PA5)
unnamed: R74.1, XIO.56 (PA7)
SPI_CLK: R26.1; also elsewhere on the board
SPI_IRQ0: XIO.35 (PC0); also elsewhere on the board
SPI_IRQ1: XIO.36 (PC1); also elsewhere on the board
SPI_IRQ2: XIO.37 (PC2); also elsewhere on the board
SPI_IRQ3: XIO.38 (PC3); also elsewhere on the board
SPI_IRQ4: XIO.57 (PC4); also elsewhere on the board
SPI_MISO: XIO.4 (PE5); also elsewhere on the board
SPI_MOSI: R27.1; also elsewhere on the board
SPI_MUX_IN: XIO.190 (PK7); also elsewhere on the board
SPI_SS0: XIO.46 (PH2); also elsewhere on the board
SPI_SS1: XIO.47 (PH3); also elsewhere on the board
SPI_SS2: XIO.48 (PH4); also elsewhere on the board
SPI_SS3: XIO.96 (PH6); also elsewhere on the board
SPI_SS4: XIO.97 (PH7); also elsewhere on the board
XSPI_1_MISO: XIO.55 (PA6); also elsewhere on the board
XSPI_1_MOSI: R74.2; also elsewhere on the board
XSPI_1_SCK: R73.2; also elsewhere on the board
XSPI_3_MISO: R75.2; also elsewhere on the board
XSPI_3_MOSI: XIO.194 (PB5); also elsewhere on the board
XSPI_3_SCK: XIO.192 (PB3); also elsewhere on the board
XSPI_5_MISO: R76.2; also elsewhere on the board
XSPI_5_MOSI: XIO.30 (PF9); also elsewhere on the board
XSPI_5_SCK: XIO.28 (PF7); also elsewhere on the board
XSPI_6_MISO: R77.2; also elsewhere on the board
XSPI_6_MOSI: XIO.183 (PG14); also elsewhere on the board
XSPI_6_SCK: XIO.182 (PG13); also elsewhere on the board

Notes on the sheet:
Slot SPI, runs at up to 45MHz
XIO SPI, IOBUS
Add termination resistors close to source
- Added 33R termination resistors on SPI:{MISO, MOSI, CLK}
SPI1, SPI5, SPI6 to be used with FPGA as master. SPI3 to be used with STM as master Resistors sited close to source signal

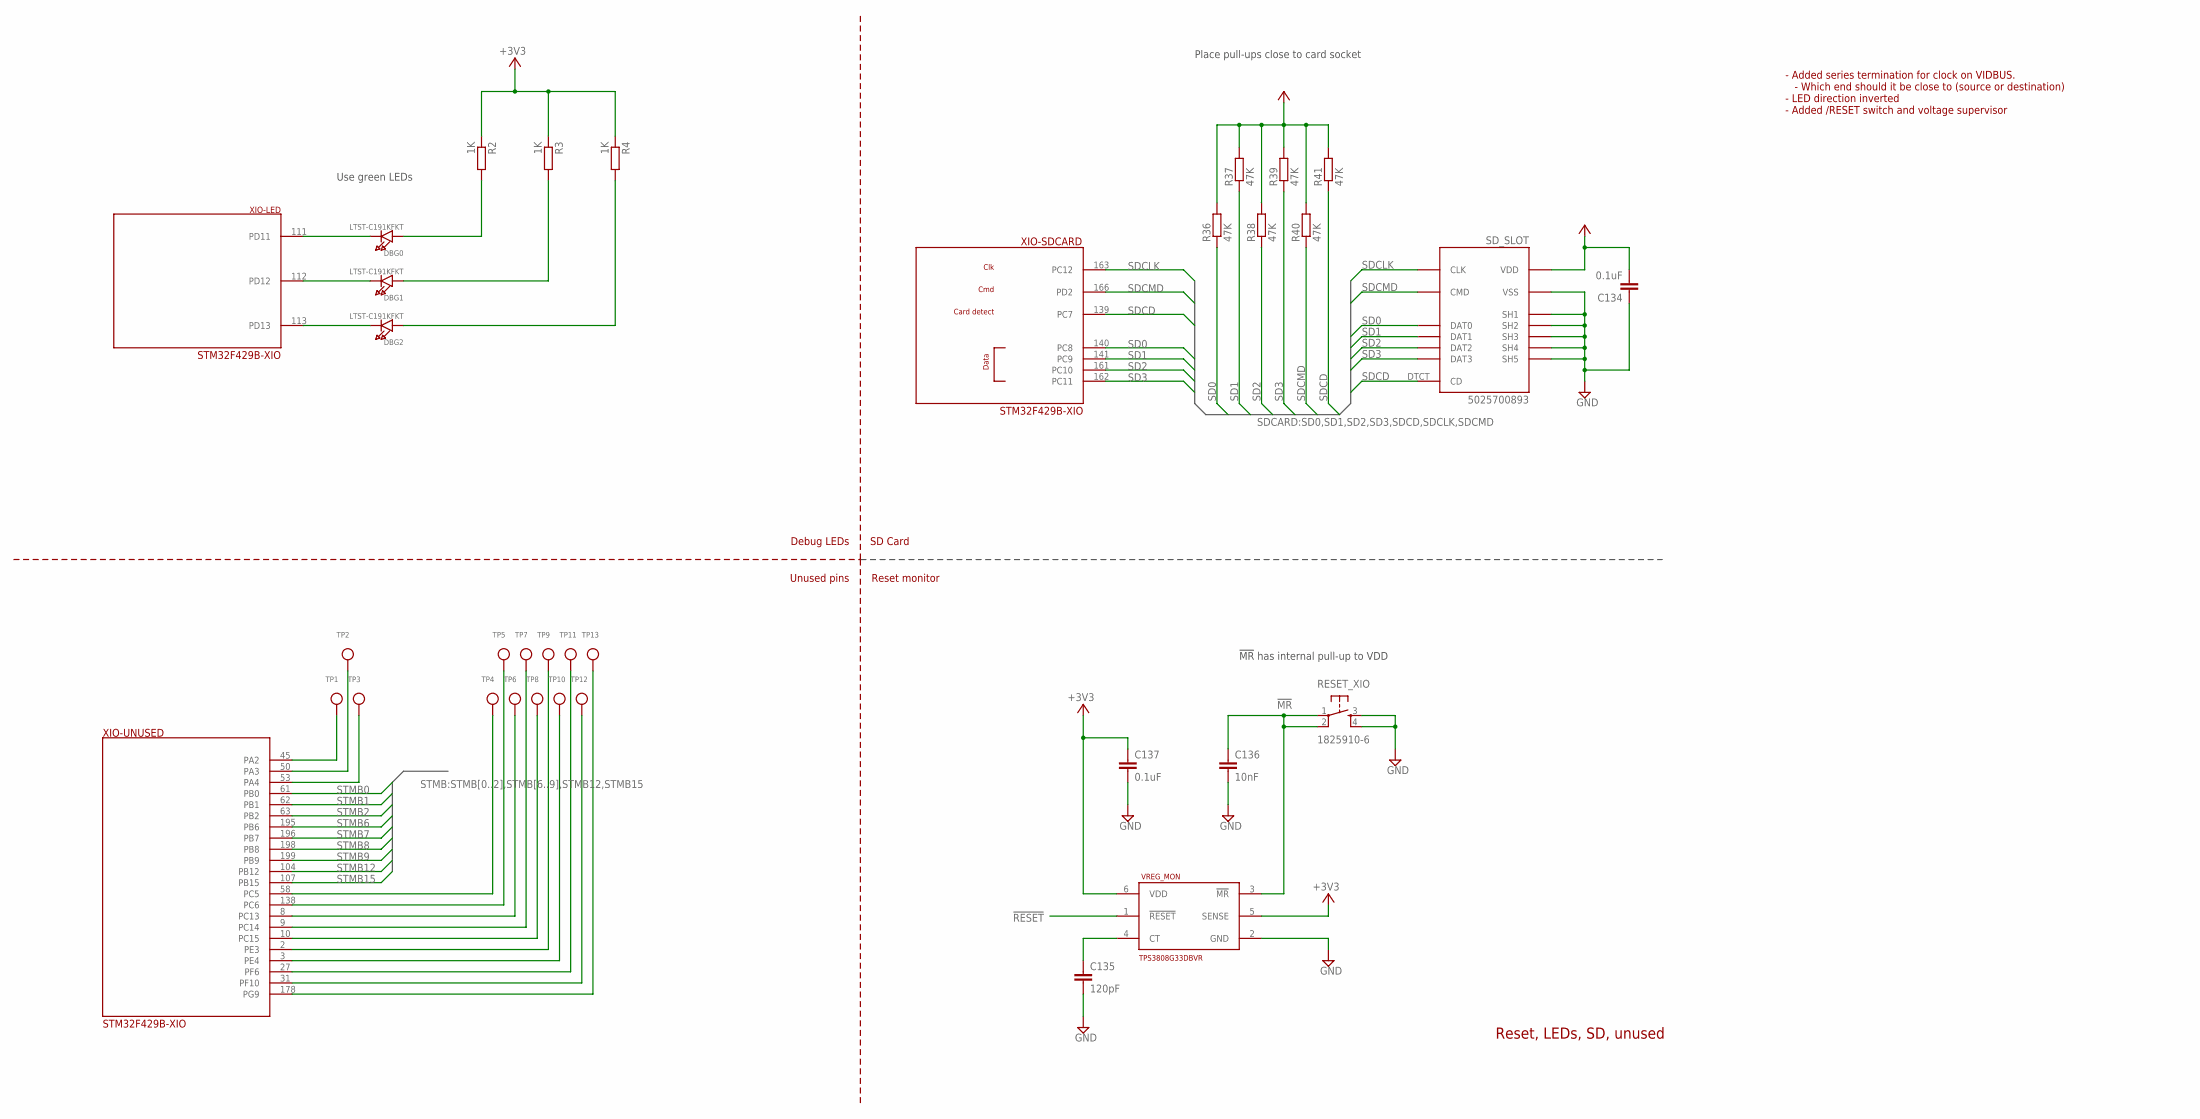
[picture p158: schematic xio.sch, sheet 4, Reset / GPIO / Leds / SD card]

Parts:
C134, C137: 0.1uF; C0402K
C135: 120pF; C0402K
C136: 10nF; C0402K
DBG0, DBG1, DBG2: LTST-C191KFKT; CHIPLED_0603
R2, R3, R4: 1K; R0402
R36, R37, R38, R39, R40, R41: 47K; R0402
RESET_XIO: 1825910-6; TACTILE-PTH
SD_SLOT: 5025700893
TP1, TP2, TP3, TP4, TP5, TP6, TP7, TP8, TP9, TP10, TP11, TP12, TP13: TESTPOINTROUND0.5MM; TESTPOINT_ROUND_0.5MM
VREG_MON: TPS3808G33DBVR; SOT23-6
XIO: STM32F429B-XIO; PQFP208

Connections:
!MR!: C136.1, RESET_XIO.1, RESET_XIO.2, VREG_MON.3 (!MR!)
!RESET!: VREG_MON.1 (!RESET!); also elsewhere on the board
+3V3: C134.2, C137.1, R2.1, R3.1, R4.1, R36.2, R37.2, R38.2, R39.2, R40.2, R41.2, SD_SLOT.P$4 (VDD), VREG_MON.5 (SENSE), VREG_MON.6 (VDD); also elsewhere on the board
GND: C134.1, C135.2, C136.2, C137.2, RESET_XIO.3, RESET_XIO.4, SD_SLOT.GND0 (SH1), SD_SLOT.GND1 (SH2), SD_SLOT.GND2 (SH3), SD_SLOT.GND3 (SH4), SD_SLOT.GND4 (SH5), SD_SLOT.P$6 (VSS), VREG_MON.2 (GND); also elsewhere on the board
unnamed: DBG0.A, R2.2
unnamed: DBG0.C, XIO.111 (PD11)
unnamed: DBG1.C, XIO.112 (PD12)
unnamed: DBG2.C, XIO.113 (PD13)
unnamed: DBG1.A, R3.2
unnamed: DBG2.A, R4.2
unnamed: C135.1, VREG_MON.4 (CT)
unnamed: TP1.P$1, XIO.45 (PA2)
unnamed: TP2.P$1, XIO.50 (PA3)
unnamed: TP3.P$1, XIO.53 (PA4)
unnamed: TP4.P$1, XIO.58 (PC5)
unnamed: TP5.P$1, XIO.138 (PC6)
unnamed: TP6.P$1, XIO.8 (PC13)
unnamed: TP7.P$1, XIO.9 (PC14)
unnamed: TP8.P$1, XIO.10 (PC15)
unnamed: TP9.P$1, XIO.2 (PE3)
unnamed: TP10.P$1, XIO.3 (PE4)
unnamed: TP11.P$1, XIO.27 (PF6)
unnamed: TP12.P$1, XIO.31 (PF10)
unnamed: TP13.P$1, XIO.178 (PG9)
SD0: R36.1, SD_SLOT.P$7 (DAT0), XIO.140 (PC8)
SD1: R37.1, SD_SLOT.P$8 (DAT1), XIO.141 (PC9)
SD2: R38.1, SD_SLOT.P$1 (DAT2), XIO.161 (PC10)
SD3: R39.1, SD_SLOT.P$2 (DAT3), XIO.162 (PC11)
SDCD: R41.1, SD_SLOT.DTCT (CD), XIO.139 (PC7)
SDCLK: SD_SLOT.P$5 (CLK), XIO.163 (PC12)
SDCMD: R40.1, SD_SLOT.P$3 (CMD), XIO.166 (PD2)
STMB0: XIO.61 (PB0); also elsewhere on the board
STMB1: XIO.62 (PB1); also elsewhere on the board
STMB2: XIO.63 (PB2); also elsewhere on the board
STMB6: XIO.195 (PB6); also elsewhere on the board
STMB7: XIO.196 (PB7); also elsewhere on the board
STMB8: XIO.198 (PB8); also elsewhere on the board
STMB9: XIO.199 (PB9); also elsewhere on the board
STMB12: XIO.104 (PB12); also elsewhere on the board
STMB15: XIO.107 (PB15); also elsewhere on the board

Notes on the sheet:
Debug LEDs
Unused pins
Reset, LEDs, SD, unused
Use green LEDs
Reset monitor
!MR! has internal pull-up to VDD
- Added series termination for clock on VIDBUS. - Which end should it be close to (source or destination) - LED direction inverted - Added /RESET switch and voltage supervisor
SD Card
Place pull-ups close to card socket

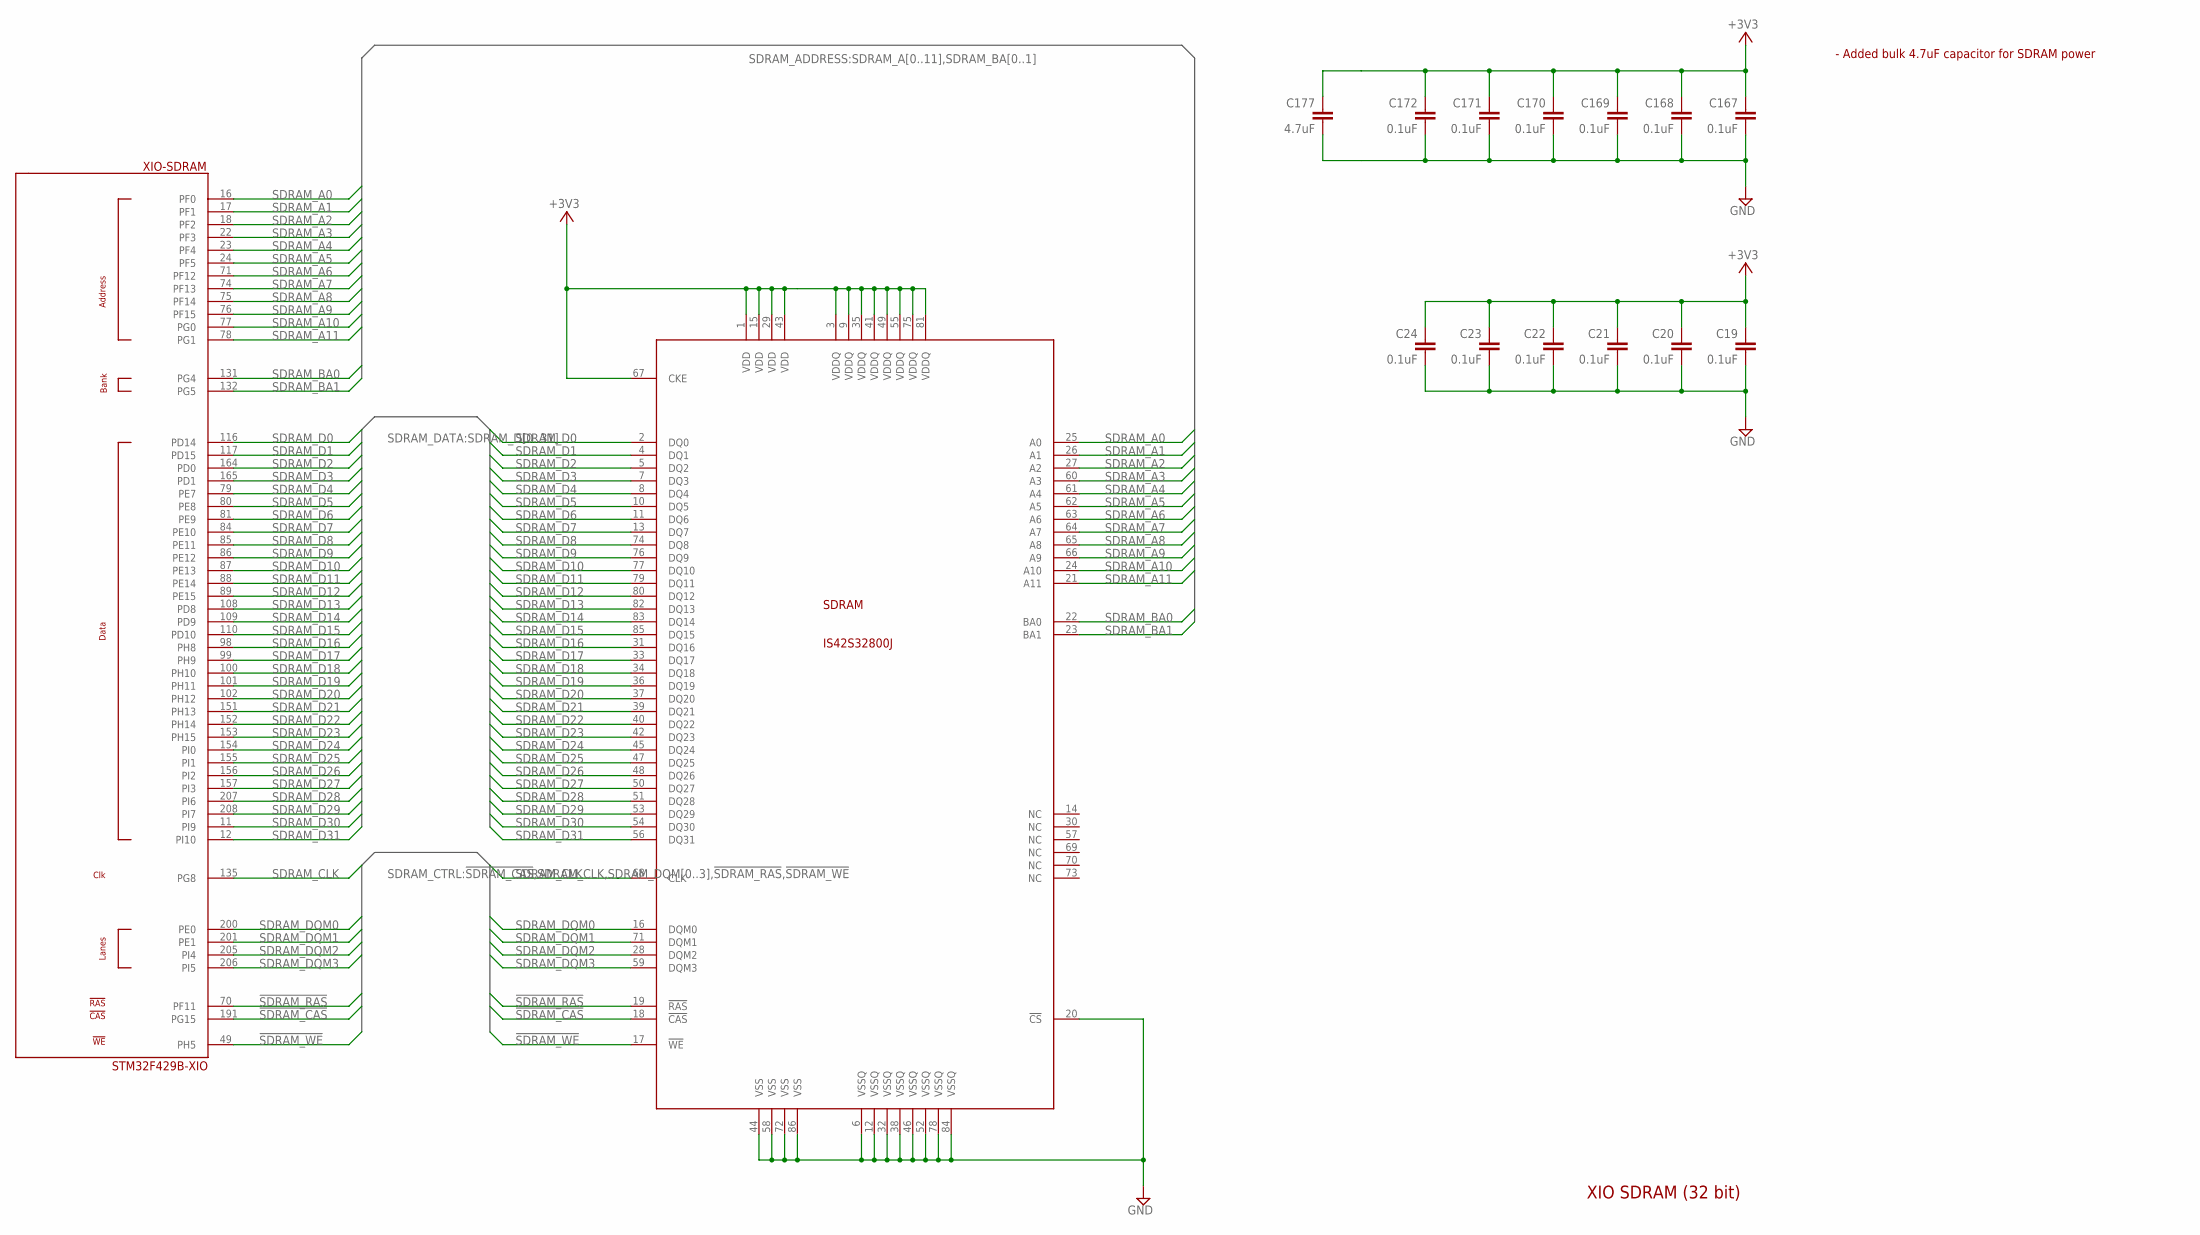
[picture p159: schematic xio.sch, sheet 5, XIO SDRAM]

Parts:
C19, C20, C21, C22, C23, C24, C167, C168, C169, C170, C171, C172: 0.1uF; C0402K
C177: 4.7uF; C0402K
SDRAM: IS42S32800J; SOP50P1176X120-86
XIO: STM32F429B-XIO; PQFP208

Connections:
!SDRAM_CAS!: SDRAM.18 (!CAS!), XIO.191 (PG15)
!SDRAM_RAS!: SDRAM.19 (!RAS!), XIO.70 (PF11)
!SDRAM_WE!: SDRAM.17 (!WE!), XIO.49 (PH5)
+3V3: C19.1, C20.1, C21.1, C22.1, C23.1, C24.1, C167.1, C168.1, C169.1, C170.1, C171.1, C172.1, C177.1, SDRAM.1 (VDD), SDRAM.3 (VDDQ), SDRAM.9 (VDDQ), SDRAM.15 (VDD), SDRAM.29 (VDD), SDRAM.35 (VDDQ), SDRAM.41 (VDDQ), SDRAM.43 (VDD), SDRAM.49 (VDDQ), SDRAM.55 (VDDQ), SDRAM.67 (CKE), SDRAM.75 (VDDQ), SDRAM.81 (VDDQ); also elsewhere on the board
GND: C19.2, C20.2, C21.2, C22.2, C23.2, C24.2, C167.2, C168.2, C169.2, C170.2, C171.2, C172.2, C177.2, SDRAM.6 (VSSQ), SDRAM.12 (VSSQ), SDRAM.20 (!CS!), SDRAM.32 (VSSQ), SDRAM.38 (VSSQ), SDRAM.44 (VSS), SDRAM.46 (VSSQ), SDRAM.52 (VSSQ), SDRAM.58 (VSS), SDRAM.72 (VSS), SDRAM.78 (VSSQ), SDRAM.84 (VSSQ), SDRAM.86 (VSS); also elsewhere on the board
SDRAM_A0: SDRAM.25 (A0), XIO.16 (PF0)
SDRAM_A1: SDRAM.26 (A1), XIO.17 (PF1)
SDRAM_A2: SDRAM.27 (A2), XIO.18 (PF2)
SDRAM_A3: SDRAM.60 (A3), XIO.22 (PF3)
SDRAM_A4: SDRAM.61 (A4), XIO.23 (PF4)
SDRAM_A5: SDRAM.62 (A5), XIO.24 (PF5)
SDRAM_A6: SDRAM.63 (A6), XIO.71 (PF12)
SDRAM_A7: SDRAM.64 (A7), XIO.74 (PF13)
SDRAM_A8: SDRAM.65 (A8), XIO.75 (PF14)
SDRAM_A9: SDRAM.66 (A9), XIO.76 (PF15)
SDRAM_A10: SDRAM.24 (A10), XIO.77 (PG0)
SDRAM_A11: SDRAM.21 (A11), XIO.78 (PG1)
SDRAM_BA0: SDRAM.22 (BA0), XIO.131 (PG4)
SDRAM_BA1: SDRAM.23 (BA1), XIO.132 (PG5)
SDRAM_CLK: SDRAM.68 (CLK), XIO.135 (PG8)
SDRAM_D0: SDRAM.2 (DQ0), XIO.116 (PD14)
SDRAM_D1: SDRAM.4 (DQ1), XIO.117 (PD15)
SDRAM_D2: SDRAM.5 (DQ2), XIO.164 (PD0)
SDRAM_D3: SDRAM.7 (DQ3), XIO.165 (PD1)
SDRAM_D4: SDRAM.8 (DQ4), XIO.79 (PE7)
SDRAM_D5: SDRAM.10 (DQ5), XIO.80 (PE8)
SDRAM_D6: SDRAM.11 (DQ6), XIO.81 (PE9)
SDRAM_D7: SDRAM.13 (DQ7), XIO.84 (PE10)
SDRAM_D8: SDRAM.74 (DQ8), XIO.85 (PE11)
SDRAM_D9: SDRAM.76 (DQ9), XIO.86 (PE12)
SDRAM_D10: SDRAM.77 (DQ10), XIO.87 (PE13)
SDRAM_D11: SDRAM.79 (DQ11), XIO.88 (PE14)
SDRAM_D12: SDRAM.80 (DQ12), XIO.89 (PE15)
SDRAM_D13: SDRAM.82 (DQ13), XIO.108 (PD8)
SDRAM_D14: SDRAM.83 (DQ14), XIO.109 (PD9)
SDRAM_D15: SDRAM.85 (DQ15), XIO.110 (PD10)
SDRAM_D16: SDRAM.31 (DQ16), XIO.98 (PH8)
SDRAM_D17: SDRAM.33 (DQ17), XIO.99 (PH9)
SDRAM_D18: SDRAM.34 (DQ18), XIO.100 (PH10)
SDRAM_D19: SDRAM.36 (DQ19), XIO.101 (PH11)
SDRAM_D20: SDRAM.37 (DQ20), XIO.102 (PH12)
SDRAM_D21: SDRAM.39 (DQ21), XIO.151 (PH13)
SDRAM_D22: SDRAM.40 (DQ22), XIO.152 (PH14)
SDRAM_D23: SDRAM.42 (DQ23), XIO.153 (PH15)
SDRAM_D24: SDRAM.45 (DQ24), XIO.154 (PI0)
SDRAM_D25: SDRAM.47 (DQ25), XIO.155 (PI1)
SDRAM_D26: SDRAM.48 (DQ26), XIO.156 (PI2)
SDRAM_D27: SDRAM.50 (DQ27), XIO.157 (PI3)
SDRAM_D28: SDRAM.51 (DQ28), XIO.207 (PI6)
SDRAM_D29: SDRAM.53 (DQ29), XIO.208 (PI7)
SDRAM_D30: SDRAM.54 (DQ30), XIO.11 (PI9)
SDRAM_D31: SDRAM.56 (DQ31), XIO.12 (PI10)
SDRAM_DQM0: SDRAM.16 (DQM0), XIO.200 (PE0)
SDRAM_DQM1: SDRAM.71 (DQM1), XIO.201 (PE1)
SDRAM_DQM2: SDRAM.28 (DQM2), XIO.205 (PI4)
SDRAM_DQM3: SDRAM.59 (DQM3), XIO.206 (PI5)

Notes on the sheet:
- Added bulk 4.7uF capacitor for SDRAM power
XIO SDRAM (32 bit)

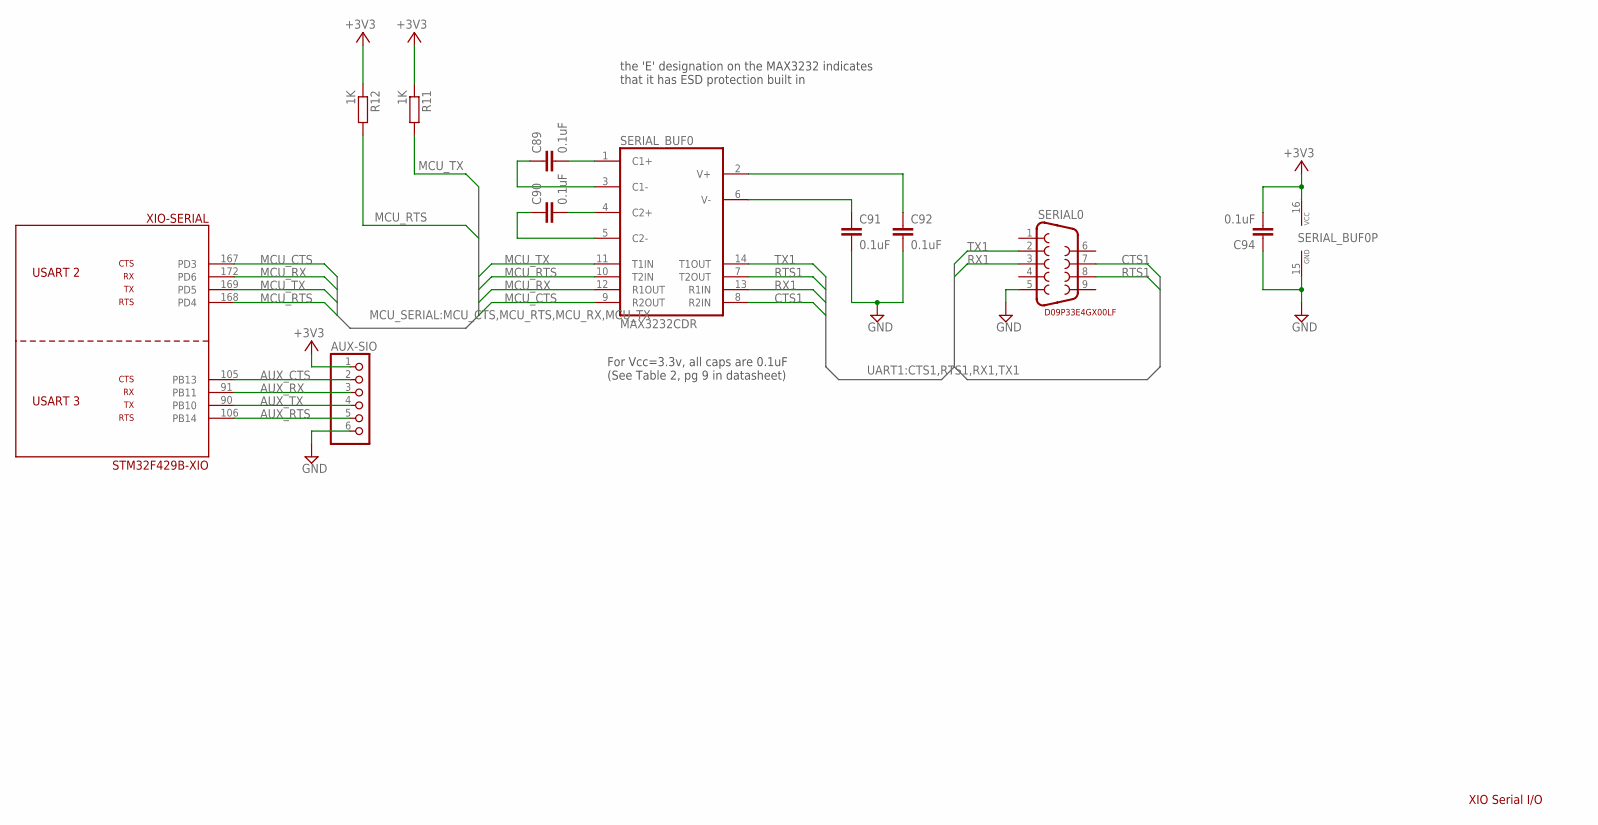
[picture p160: schematic xio.sch, sheet 6, XIO Serial I/O]

Parts:
AUX-SIO: PINHD-1X6; 1X06
C89, C90, C91, C92, C94: 0.1uF; C0402K
R11, R12: 1K; R0402
SERIAL0: DB9
SERIAL_BUF0: MAX3232CDR; SO16
XIO: STM32F429B-XIO; PQFP208

Connections:
+3V3: AUX-SIO.1, C94.2, R11.1, R12.1, SERIAL_BUF0.16 (VCC); also elsewhere on the board
AUX_CTS: AUX-SIO.2, XIO.105 (PB13)
AUX_RTS: AUX-SIO.5, XIO.106 (PB14)
AUX_RX: AUX-SIO.3, XIO.91 (PB11)
AUX_TX: AUX-SIO.4, XIO.90 (PB10)
CTS1: SERIAL0.7, SERIAL_BUF0.8 (R2IN)
GND: AUX-SIO.6, C91.2, C92.2, C94.1, SERIAL0.5, SERIAL_BUF0.15 (GND); also elsewhere on the board
MCU_CTS: SERIAL_BUF0.9 (R2OUT), XIO.167 (PD3)
MCU_RTS: R12.2, SERIAL_BUF0.10 (T2IN), XIO.168 (PD4)
MCU_RX: SERIAL_BUF0.12 (R1OUT), XIO.172 (PD6)
MCU_TX: R11.2, SERIAL_BUF0.11 (T1IN), XIO.169 (PD5)
unnamed: C89.2, SERIAL_BUF0.1 (C1+)
unnamed: C89.1, SERIAL_BUF0.3 (C1-)
unnamed: C90.2, SERIAL_BUF0.4 (C2+)
unnamed: C90.1, SERIAL_BUF0.5 (C2-)
unnamed: C91.1, SERIAL_BUF0.6 (V-)
unnamed: C92.1, SERIAL_BUF0.2 (V+)
RTS1: SERIAL0.8, SERIAL_BUF0.7 (T2OUT)
RX1: SERIAL0.3, SERIAL_BUF0.13 (R1IN)
TX1: SERIAL0.2, SERIAL_BUF0.14 (T1OUT)

Notes on the sheet:
XIO Serial I/O
For Vcc=3.3v, all caps are 0.1uF (See Table 2, pg 9 in datasheet)
the 'E' designation on the MAX3232 indicates that it has ESD protection built in
D09P33E4GX00LF
