ThrudTheBarbarian/pbxl/boards/xio/xio.brd

## EAGLE design boards/xio/xio.brd (continued)

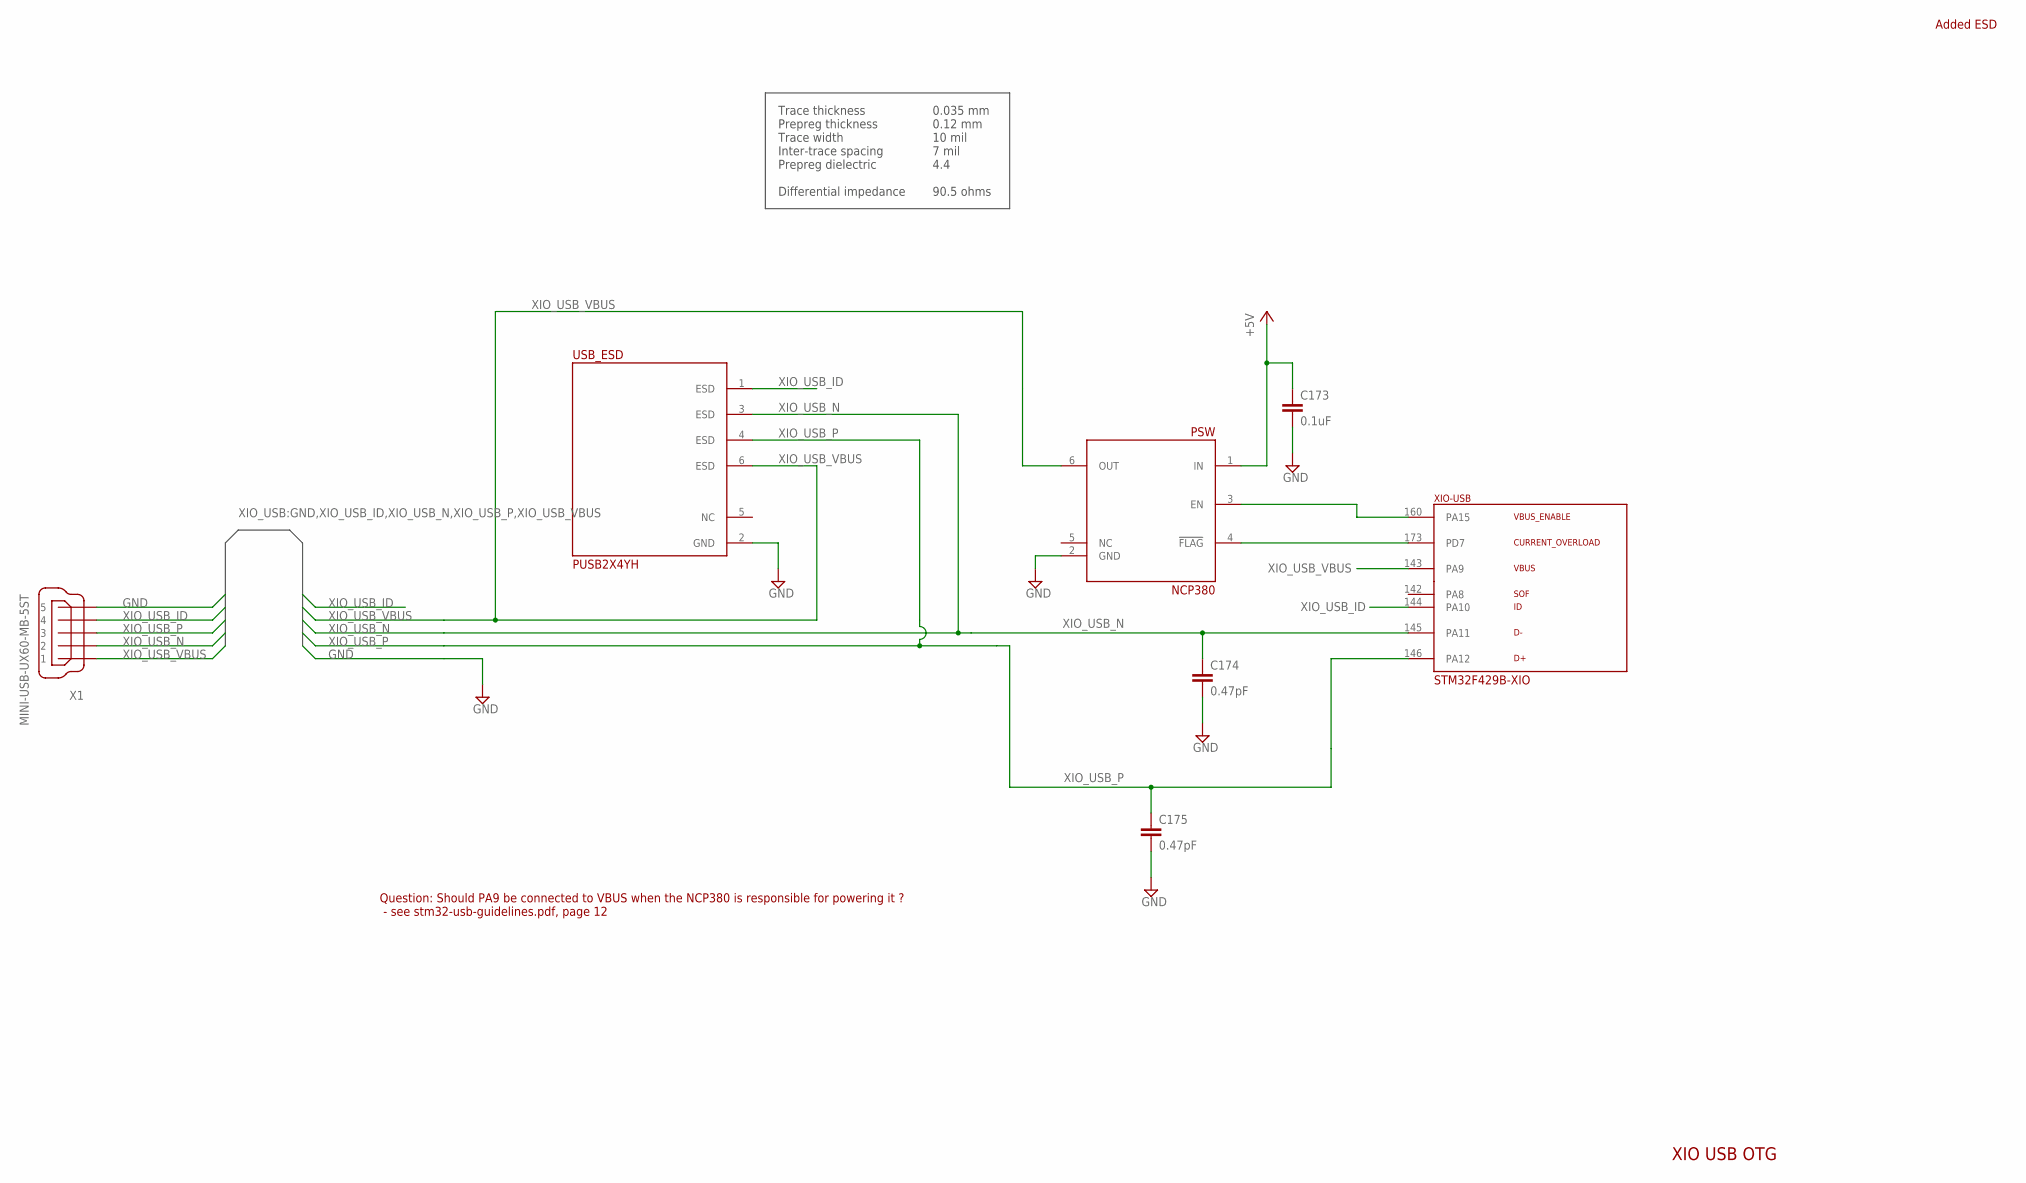
[picture p161: schematic xio.sch, sheet 7, XIO USB OTG]

Parts:
C173: 0.1uF; C0402K
C174, C175: 0.47pF; C0402K
PSW: NCP380; SOT23-6
USB_ESD: PUSB2X4YH; SOT363
X1: MINI-USB-UX60-MB-5ST; UX60-MB-5ST
XIO: STM32F429B-XIO; PQFP208

Connections:
+5V: C173.1, PSW.1 (IN); also elsewhere on the board
GND: C173.2, C174.2, C175.2, PSW.2 (GND), USB_ESD.2 (GND), X1.5; also elsewhere on the board
unnamed: PSW.3 (EN), XIO.160 (PA15)
unnamed: PSW.4 (!FLAG!), XIO.173 (PD7)
XIO_USB_ID: USB_ESD.1 (ESD), X1.4, XIO.144 (PA10)
XIO_USB_N: C174.1, USB_ESD.3 (ESD), X1.2, XIO.145 (PA11)
XIO_USB_P: C175.1, USB_ESD.4 (ESD), X1.3, XIO.146 (PA12)
XIO_USB_VBUS: PSW.6 (OUT), USB_ESD.6 (ESD), X1.1, XIO.143 (PA9)

Notes on the sheet:
Trace thickness Prepreg thickness Trace width Inter-trace spacing Prepreg dielectric Differential impedance
0.035 mm 0.12 mm 10 mil 7 mil 4.4 90.5 ohms
Added ESD
XIO USB OTG
Question: Should PA9 be connected to VBUS when the NCP380 is responsible for powering it ? - see stm32-usb-guidelines.pdf, page 12

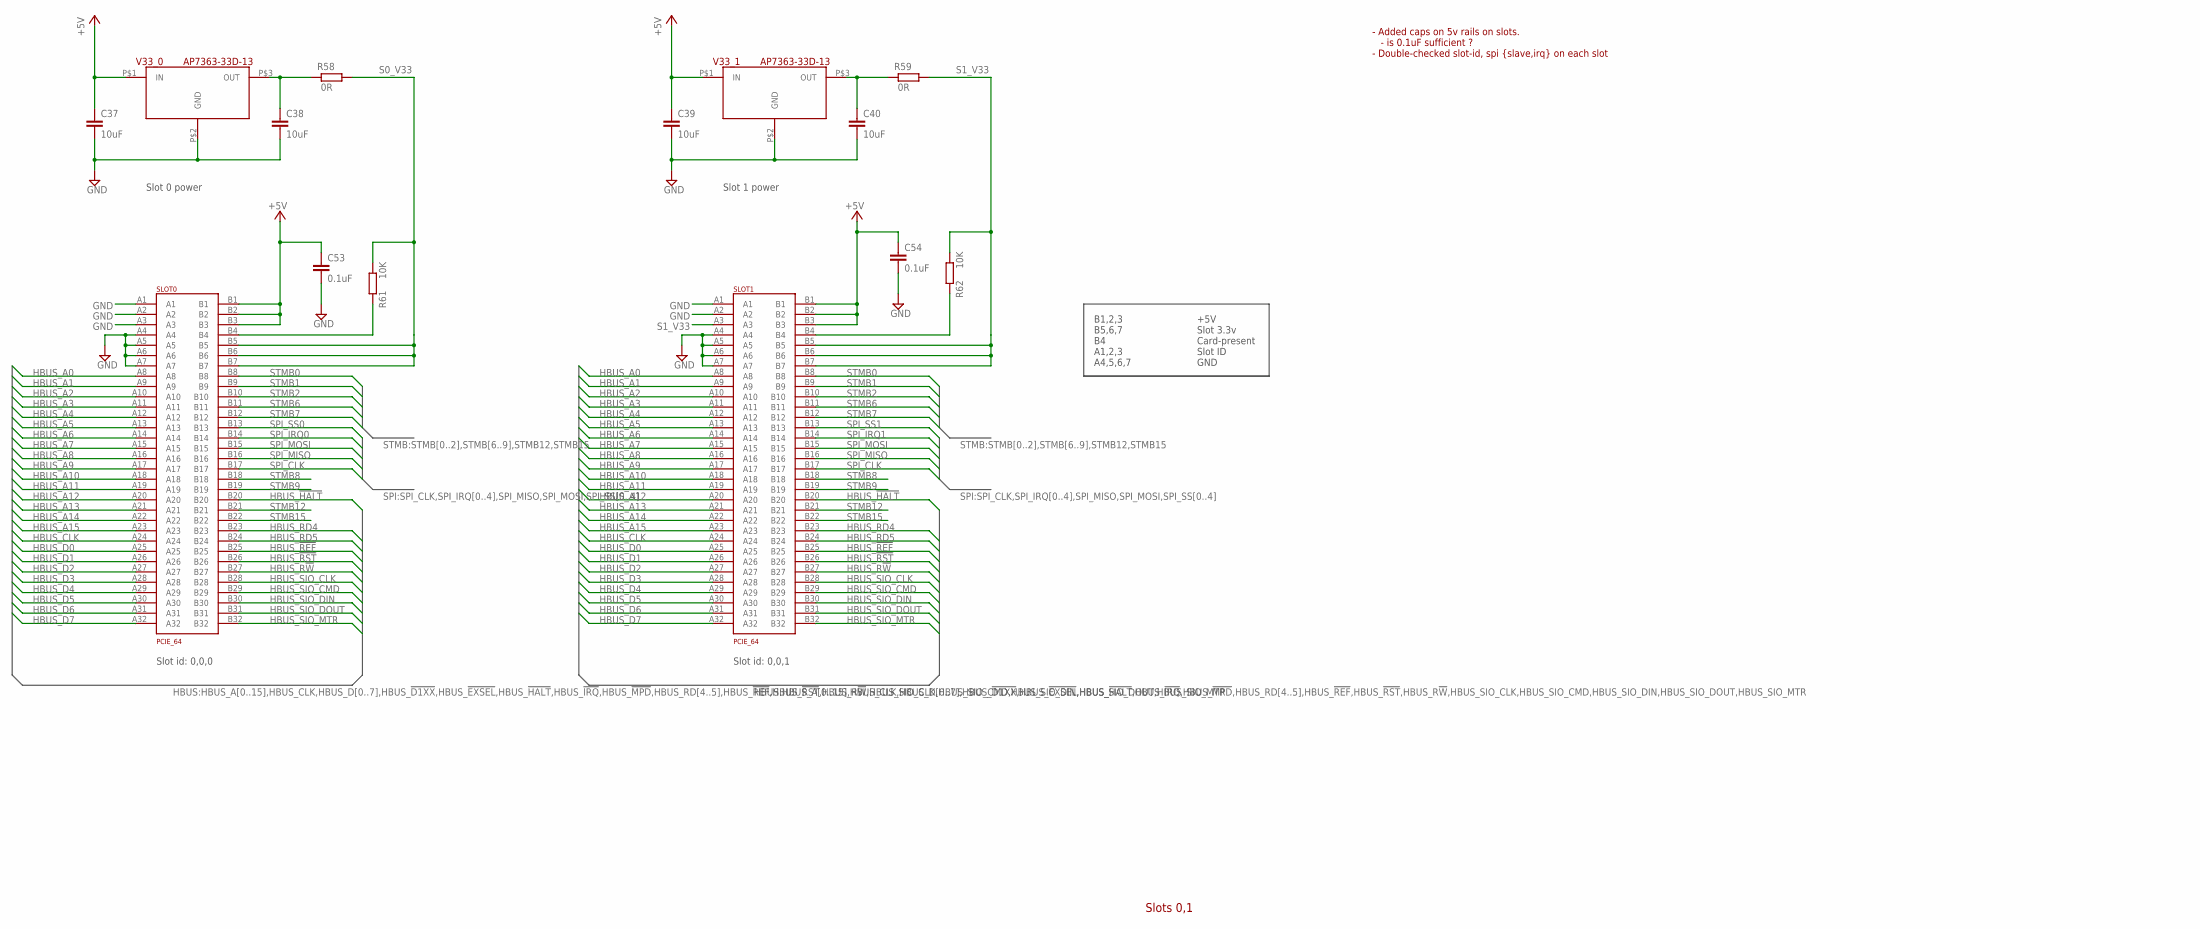
[picture p162: schematic xio.sch, sheet 8, Expansion slots 0 & 1]

Parts:
C37, C38, C39, C40: 10uF; C0402K
C53, C54: 0.1uF; C0402K
R58, R59: 0R; R0402
R61, R62: 10K; R0402
SLOT0, SLOT1: PCIE_64; PCI-E_64
V33_0, V33_1: AP7363-33D-13; TO252-3L

Connections:
+5V: C37.1, C39.1, C53.1, C54.1, SLOT0.B1, SLOT0.B2, SLOT0.B3, SLOT1.B1, SLOT1.B2, SLOT1.B3, V33_0.P$1 (IN), V33_1.P$1 (IN); also elsewhere on the board
GND: C37.2, C38.2, C39.2, C40.2, C53.2, C54.2, SLOT0.A1, SLOT0.A2, SLOT0.A3, SLOT0.A4, SLOT0.A5, SLOT0.A6, SLOT0.A7, SLOT1.A1, SLOT1.A2, SLOT1.A4, SLOT1.A5, SLOT1.A6, SLOT1.A7, V33_0.P$2 (GND), V33_1.P$2 (GND); also elsewhere on the board
HBUS_!HALT!: SLOT0.B20, SLOT1.B20; also elsewhere on the board
HBUS_!REF!: SLOT0.B25, SLOT1.B25; also elsewhere on the board
HBUS_!RST!: SLOT0.B26, SLOT1.B26; also elsewhere on the board
HBUS_A0: SLOT0.A8, SLOT1.A8; also elsewhere on the board
HBUS_A1: SLOT0.A9, SLOT1.A9; also elsewhere on the board
HBUS_A2: SLOT0.A10, SLOT1.A10; also elsewhere on the board
HBUS_A3: SLOT0.A11, SLOT1.A11; also elsewhere on the board
HBUS_A4: SLOT0.A12, SLOT1.A12; also elsewhere on the board
HBUS_A5: SLOT0.A13, SLOT1.A13; also elsewhere on the board
HBUS_A6: SLOT0.A14, SLOT1.A14; also elsewhere on the board
HBUS_A7: SLOT0.A15, SLOT1.A15; also elsewhere on the board
HBUS_A8: SLOT0.A16, SLOT1.A16; also elsewhere on the board
HBUS_A9: SLOT0.A17, SLOT1.A17; also elsewhere on the board
HBUS_A10: SLOT0.A18, SLOT1.A18; also elsewhere on the board
HBUS_A11: SLOT0.A19, SLOT1.A19; also elsewhere on the board
HBUS_A12: SLOT0.A20, SLOT1.A20; also elsewhere on the board
HBUS_A13: SLOT0.A21, SLOT1.A21; also elsewhere on the board
HBUS_A14: SLOT0.A22, SLOT1.A22; also elsewhere on the board
HBUS_A15: SLOT0.A23, SLOT1.A23; also elsewhere on the board
HBUS_CLK: SLOT0.A24, SLOT1.A24; also elsewhere on the board
HBUS_D0: SLOT0.A25, SLOT1.A25; also elsewhere on the board
HBUS_D1: SLOT0.A26, SLOT1.A26; also elsewhere on the board
HBUS_D2: SLOT0.A27, SLOT1.A27; also elsewhere on the board
HBUS_D3: SLOT0.A28, SLOT1.A28; also elsewhere on the board
HBUS_D4: SLOT0.A29, SLOT1.A29; also elsewhere on the board
HBUS_D5: SLOT0.A30, SLOT1.A30; also elsewhere on the board
HBUS_D6: SLOT0.A31, SLOT1.A31; also elsewhere on the board
HBUS_D7: SLOT0.A32, SLOT1.A32; also elsewhere on the board
HBUS_R!W!: SLOT0.B27, SLOT1.B27; also elsewhere on the board
HBUS_RD4: SLOT0.B23, SLOT1.B23; also elsewhere on the board
HBUS_RD5: SLOT0.B24, SLOT1.B24; also elsewhere on the board
HBUS_SIO_CLK: SLOT0.B28, SLOT1.B28; also elsewhere on the board
HBUS_SIO_CMD: SLOT0.B29, SLOT1.B29; also elsewhere on the board
HBUS_SIO_DIN: SLOT0.B30, SLOT1.B30; also elsewhere on the board
HBUS_SIO_DOUT: SLOT0.B31, SLOT1.B31; also elsewhere on the board
HBUS_SIO_MTR: SLOT0.B32, SLOT1.B32; also elsewhere on the board
unnamed: R62.2, SLOT1.B4
unnamed: R61.2, SLOT0.B4
unnamed: C38.1, R58.2, V33_0.P$3 (OUT)
unnamed: C40.1, R59.2, V33_1.P$3 (OUT)
S0_V33: R58.1, R61.1, SLOT0.B5, SLOT0.B6, SLOT0.B7
S1_V33: R59.1, R62.1, SLOT1.A3, SLOT1.B5, SLOT1.B6, SLOT1.B7
SPI_CLK: SLOT0.B17, SLOT1.B17; also elsewhere on the board
SPI_IRQ0: SLOT0.B14; also elsewhere on the board
SPI_IRQ1: SLOT1.B14; also elsewhere on the board
SPI_MISO: SLOT0.B16, SLOT1.B16; also elsewhere on the board
SPI_MOSI: SLOT0.B15, SLOT1.B15; also elsewhere on the board
SPI_SS0: SLOT0.B13; also elsewhere on the board
SPI_SS1: SLOT1.B13; also elsewhere on the board
STMB0: SLOT0.B8, SLOT1.B8; also elsewhere on the board
STMB1: SLOT0.B9, SLOT1.B9; also elsewhere on the board
STMB2: SLOT0.B10, SLOT1.B10; also elsewhere on the board
STMB6: SLOT0.B11, SLOT1.B11; also elsewhere on the board
STMB7: SLOT0.B12, SLOT1.B12; also elsewhere on the board
STMB8: SLOT0.B18, SLOT1.B18; also elsewhere on the board
STMB9: SLOT0.B19, SLOT1.B19; also elsewhere on the board
STMB12: SLOT0.B21, SLOT1.B21; also elsewhere on the board
STMB15: SLOT0.B22, SLOT1.B22; also elsewhere on the board

Notes on the sheet:
Slots 0,1
Slot 0 power
Slot 1 power
Slot id: 0,0,0
Slot id: 0,0,1
- Added caps on 5v rails on slots. - is 0.1uF sufficient ? - Double-checked slot-id, spi {slave,irq} on each slot
B1,2,3 B5,6,7 B4 A1,2,3 A4,5,6,7
+5V Slot 3.3v Card-present Slot ID GND

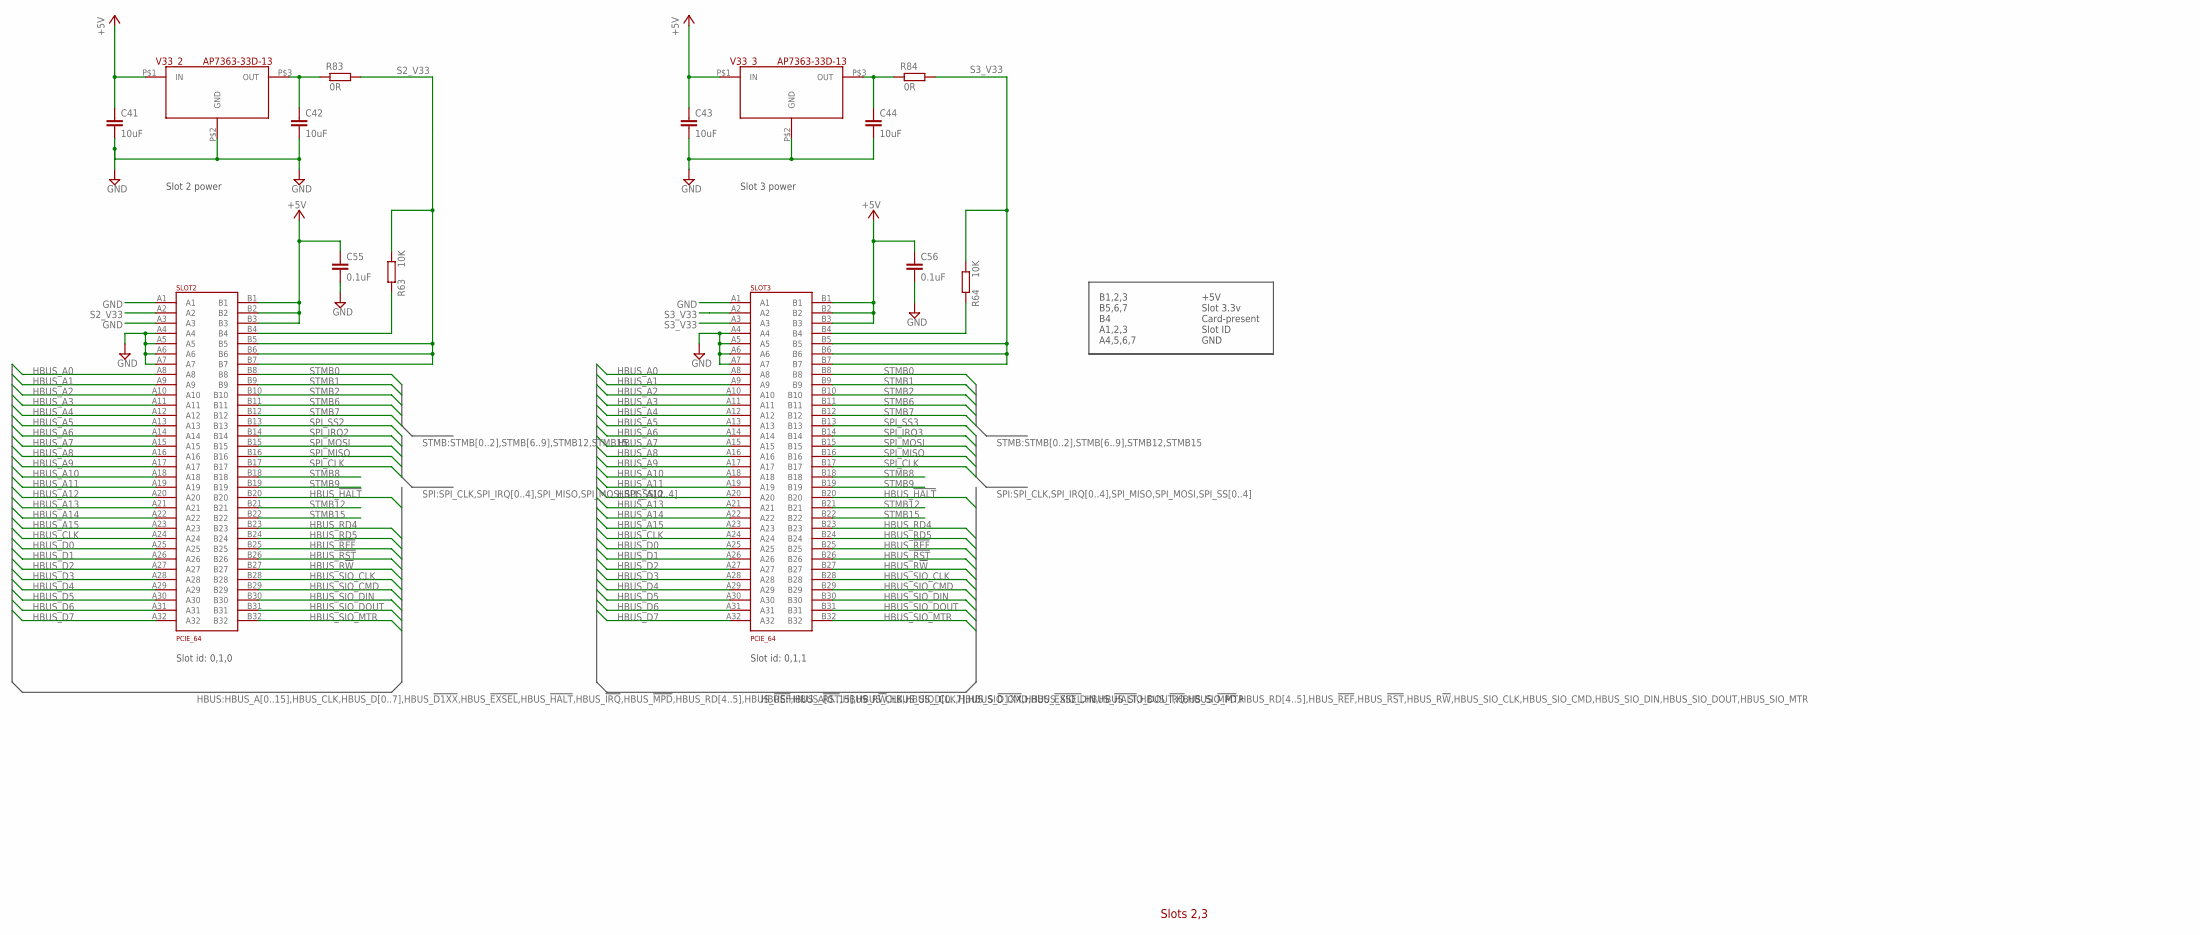
[picture p163: schematic xio.sch, sheet 9, Expansion slots 2 & 3]

Parts:
C41, C42, C43, C44: 10uF; C0402K
C55, C56: 0.1uF; C0402K
R63, R64: 10K; R0402
R83, R84: 0R; R0402
SLOT2, SLOT3: PCIE_64; PCI-E_64
V33_2, V33_3: AP7363-33D-13; TO252-3L

Connections:
+5V: C41.1, C43.1, C55.1, C56.1, SLOT2.B1, SLOT2.B2, SLOT2.B3, SLOT3.B1, SLOT3.B2, SLOT3.B3, V33_2.P$1 (IN), V33_3.P$1 (IN); also elsewhere on the board
GND: C41.2, C42.2, C43.2, C44.2, C55.2, C56.2, SLOT2.A1, SLOT2.A3, SLOT2.A4, SLOT2.A5, SLOT2.A6, SLOT2.A7, SLOT3.A1, SLOT3.A4, SLOT3.A5, SLOT3.A6, SLOT3.A7, V33_2.P$2 (GND), V33_3.P$2 (GND); also elsewhere on the board
HBUS_!HALT!: SLOT2.B20, SLOT3.B20; also elsewhere on the board
HBUS_!REF!: SLOT2.B25, SLOT3.B25; also elsewhere on the board
HBUS_!RST!: SLOT2.B26, SLOT3.B26; also elsewhere on the board
HBUS_A0: SLOT2.A8, SLOT3.A8; also elsewhere on the board
HBUS_A1: SLOT2.A9, SLOT3.A9; also elsewhere on the board
HBUS_A2: SLOT2.A10, SLOT3.A10; also elsewhere on the board
HBUS_A3: SLOT2.A11, SLOT3.A11; also elsewhere on the board
HBUS_A4: SLOT2.A12, SLOT3.A12; also elsewhere on the board
HBUS_A5: SLOT2.A13, SLOT3.A13; also elsewhere on the board
HBUS_A6: SLOT2.A14, SLOT3.A14; also elsewhere on the board
HBUS_A7: SLOT2.A15, SLOT3.A15; also elsewhere on the board
HBUS_A8: SLOT2.A16, SLOT3.A16; also elsewhere on the board
HBUS_A9: SLOT2.A17, SLOT3.A17; also elsewhere on the board
HBUS_A10: SLOT2.A18, SLOT3.A18; also elsewhere on the board
HBUS_A11: SLOT2.A19, SLOT3.A19; also elsewhere on the board
HBUS_A12: SLOT2.A20, SLOT3.A20; also elsewhere on the board
HBUS_A13: SLOT2.A21, SLOT3.A21; also elsewhere on the board
HBUS_A14: SLOT2.A22, SLOT3.A22; also elsewhere on the board
HBUS_A15: SLOT2.A23, SLOT3.A23; also elsewhere on the board
HBUS_CLK: SLOT2.A24, SLOT3.A24; also elsewhere on the board
HBUS_D0: SLOT2.A25, SLOT3.A25; also elsewhere on the board
HBUS_D1: SLOT2.A26, SLOT3.A26; also elsewhere on the board
HBUS_D2: SLOT2.A27, SLOT3.A27; also elsewhere on the board
HBUS_D3: SLOT2.A28, SLOT3.A28; also elsewhere on the board
HBUS_D4: SLOT2.A29, SLOT3.A29; also elsewhere on the board
HBUS_D5: SLOT2.A30, SLOT3.A30; also elsewhere on the board
HBUS_D6: SLOT2.A31, SLOT3.A31; also elsewhere on the board
HBUS_D7: SLOT2.A32, SLOT3.A32; also elsewhere on the board
HBUS_R!W!: SLOT2.B27, SLOT3.B27; also elsewhere on the board
HBUS_RD4: SLOT2.B23, SLOT3.B23; also elsewhere on the board
HBUS_RD5: SLOT2.B24, SLOT3.B24; also elsewhere on the board
HBUS_SIO_CLK: SLOT2.B28, SLOT3.B28; also elsewhere on the board
HBUS_SIO_CMD: SLOT2.B29, SLOT3.B29; also elsewhere on the board
HBUS_SIO_DIN: SLOT2.B30, SLOT3.B30; also elsewhere on the board
HBUS_SIO_DOUT: SLOT2.B31, SLOT3.B31; also elsewhere on the board
HBUS_SIO_MTR: SLOT2.B32, SLOT3.B32; also elsewhere on the board
unnamed: C42.1, R83.2, V33_2.P$3 (OUT)
unnamed: C44.1, R84.2, V33_3.P$3 (OUT)
unnamed: R63.2, SLOT2.B4
unnamed: R64.2, SLOT3.B4
S2_V33: R63.1, R83.1, SLOT2.A2, SLOT2.B5, SLOT2.B6, SLOT2.B7
S3_V33: R64.1, R84.1, SLOT3.A2, SLOT3.A3, SLOT3.B5, SLOT3.B6, SLOT3.B7
SPI_CLK: SLOT2.B17, SLOT3.B17; also elsewhere on the board
SPI_IRQ2: SLOT2.B14; also elsewhere on the board
SPI_IRQ3: SLOT3.B14; also elsewhere on the board
SPI_MISO: SLOT2.B16, SLOT3.B16; also elsewhere on the board
SPI_MOSI: SLOT2.B15, SLOT3.B15; also elsewhere on the board
SPI_SS2: SLOT2.B13; also elsewhere on the board
SPI_SS3: SLOT3.B13; also elsewhere on the board
STMB0: SLOT2.B8, SLOT3.B8; also elsewhere on the board
STMB1: SLOT2.B9, SLOT3.B9; also elsewhere on the board
STMB2: SLOT2.B10, SLOT3.B10; also elsewhere on the board
STMB6: SLOT2.B11, SLOT3.B11; also elsewhere on the board
STMB7: SLOT2.B12, SLOT3.B12; also elsewhere on the board
STMB8: SLOT2.B18, SLOT3.B18; also elsewhere on the board
STMB9: SLOT2.B19, SLOT3.B19; also elsewhere on the board
STMB12: SLOT2.B21, SLOT3.B21; also elsewhere on the board
STMB15: SLOT2.B22, SLOT3.B22; also elsewhere on the board

Notes on the sheet:
Slot 2 power
Slot 3 power
Slots 2,3
Slot id: 0,1,0
Slot id: 0,1,1
B1,2,3 B5,6,7 B4 A1,2,3 A4,5,6,7
+5V Slot 3.3v Card-present Slot ID GND

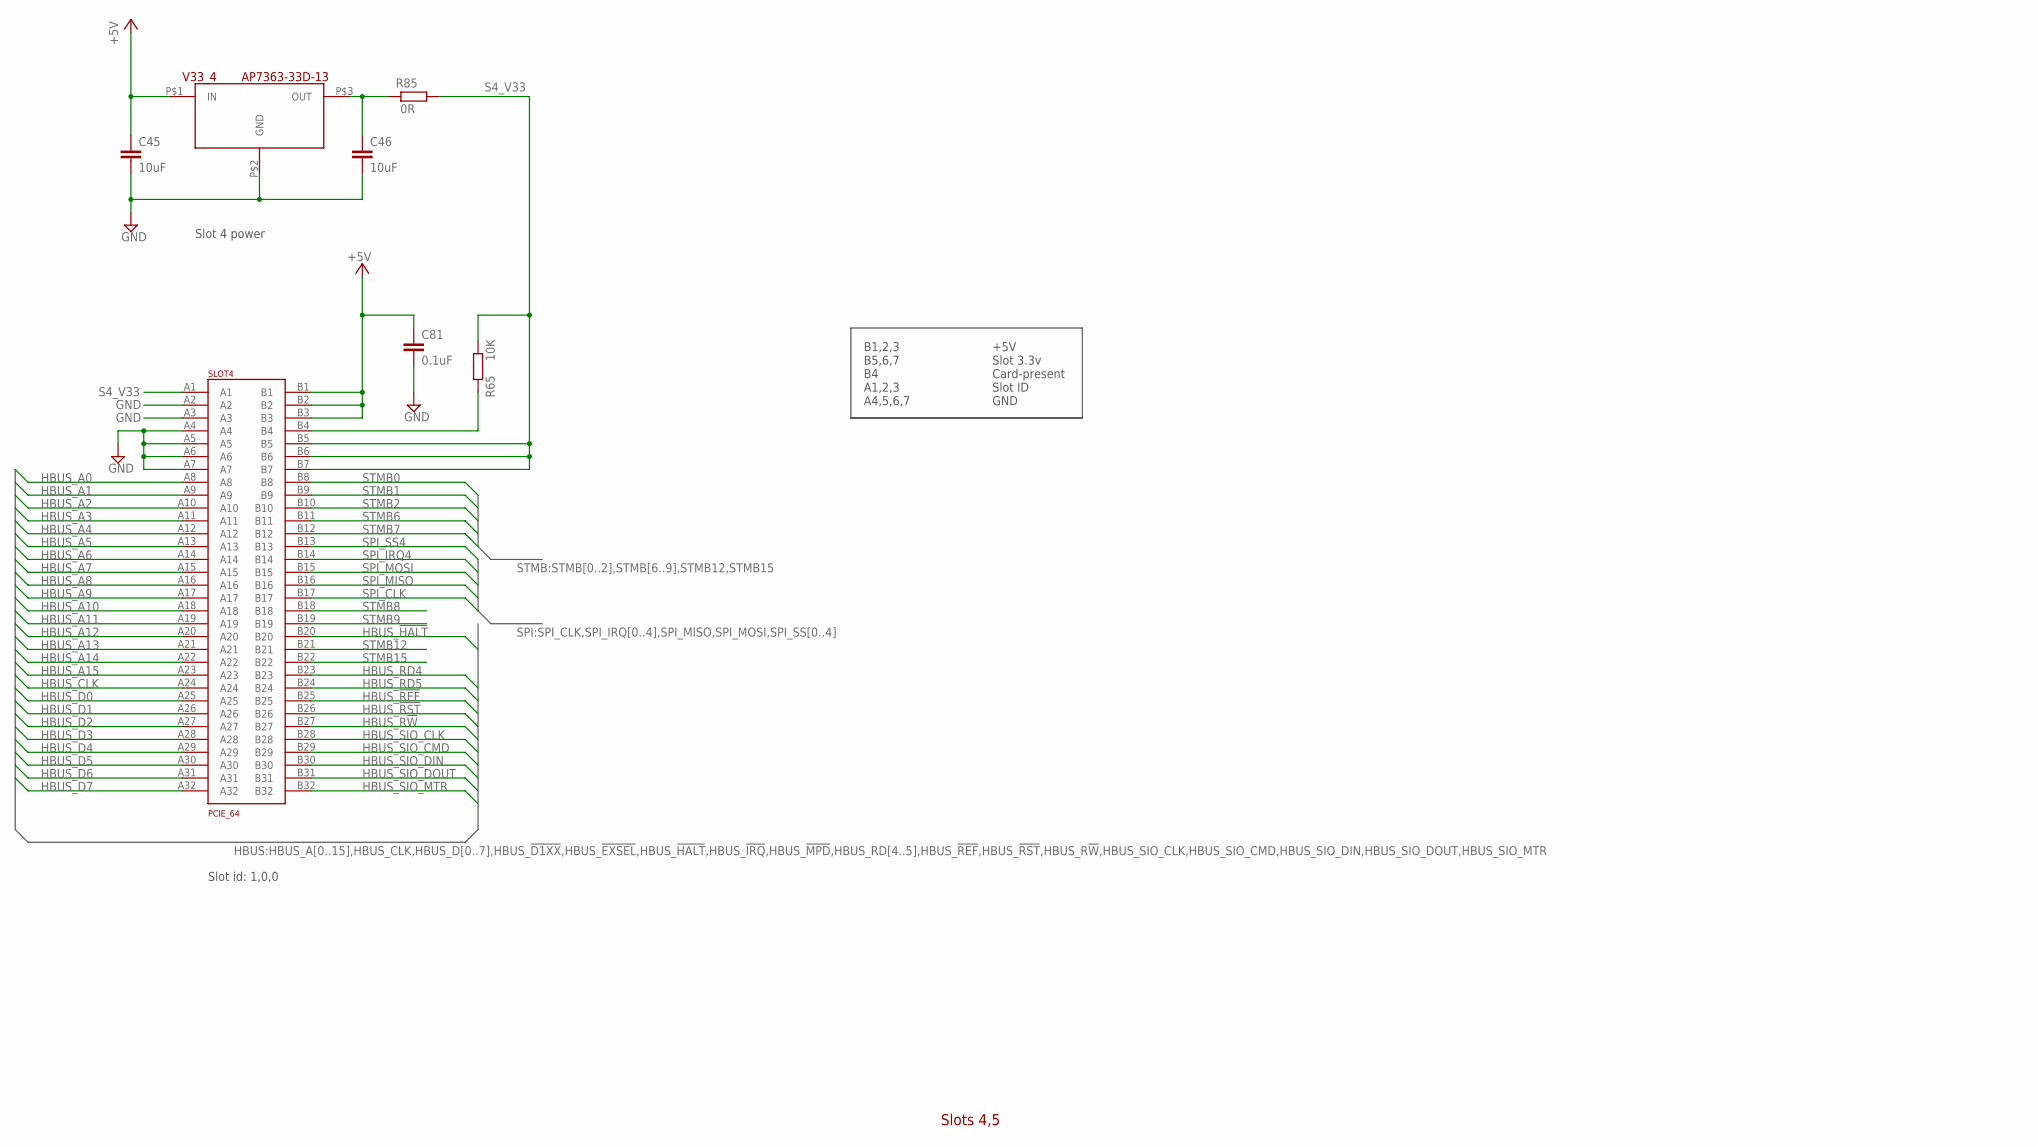
[picture p164: schematic xio.sch, sheet 10, Expansion slots 4 & 5]

Parts:
C45, C46: 10uF; C0402K
C81: 0.1uF; C0402K
R65: 10K; R0402
R85: 0R; R0402
SLOT4: PCIE_64; PCI-E_64
V33_4: AP7363-33D-13; TO252-3L

Connections:
+5V: C45.1, C81.1, SLOT4.B1, SLOT4.B2, SLOT4.B3, V33_4.P$1 (IN); also elsewhere on the board
GND: C45.2, C46.2, C81.2, SLOT4.A2, SLOT4.A3, SLOT4.A4, SLOT4.A5, SLOT4.A6, SLOT4.A7, V33_4.P$2 (GND); also elsewhere on the board
HBUS_!HALT!: SLOT4.B20; also elsewhere on the board
HBUS_!REF!: SLOT4.B25; also elsewhere on the board
HBUS_!RST!: SLOT4.B26; also elsewhere on the board
HBUS_A0: SLOT4.A8; also elsewhere on the board
HBUS_A1: SLOT4.A9; also elsewhere on the board
HBUS_A2: SLOT4.A10; also elsewhere on the board
HBUS_A3: SLOT4.A11; also elsewhere on the board
HBUS_A4: SLOT4.A12; also elsewhere on the board
HBUS_A5: SLOT4.A13; also elsewhere on the board
HBUS_A6: SLOT4.A14; also elsewhere on the board
HBUS_A7: SLOT4.A15; also elsewhere on the board
HBUS_A8: SLOT4.A16; also elsewhere on the board
HBUS_A9: SLOT4.A17; also elsewhere on the board
HBUS_A10: SLOT4.A18; also elsewhere on the board
HBUS_A11: SLOT4.A19; also elsewhere on the board
HBUS_A12: SLOT4.A20; also elsewhere on the board
HBUS_A13: SLOT4.A21; also elsewhere on the board
HBUS_A14: SLOT4.A22; also elsewhere on the board
HBUS_A15: SLOT4.A23; also elsewhere on the board
HBUS_CLK: SLOT4.A24; also elsewhere on the board
HBUS_D0: SLOT4.A25; also elsewhere on the board
HBUS_D1: SLOT4.A26; also elsewhere on the board
HBUS_D2: SLOT4.A27; also elsewhere on the board
HBUS_D3: SLOT4.A28; also elsewhere on the board
HBUS_D4: SLOT4.A29; also elsewhere on the board
HBUS_D5: SLOT4.A30; also elsewhere on the board
HBUS_D6: SLOT4.A31; also elsewhere on the board
HBUS_D7: SLOT4.A32; also elsewhere on the board
HBUS_R!W!: SLOT4.B27; also elsewhere on the board
HBUS_RD4: SLOT4.B23; also elsewhere on the board
HBUS_RD5: SLOT4.B24; also elsewhere on the board
HBUS_SIO_CLK: SLOT4.B28; also elsewhere on the board
HBUS_SIO_CMD: SLOT4.B29; also elsewhere on the board
HBUS_SIO_DIN: SLOT4.B30; also elsewhere on the board
HBUS_SIO_DOUT: SLOT4.B31; also elsewhere on the board
HBUS_SIO_MTR: SLOT4.B32; also elsewhere on the board
unnamed: C46.1, R85.2, V33_4.P$3 (OUT)
unnamed: R65.2, SLOT4.B4
S4_V33: R65.1, R85.1, SLOT4.A1, SLOT4.B5, SLOT4.B6, SLOT4.B7
SPI_CLK: SLOT4.B17; also elsewhere on the board
SPI_IRQ4: SLOT4.B14; also elsewhere on the board
SPI_MISO: SLOT4.B16; also elsewhere on the board
SPI_MOSI: SLOT4.B15; also elsewhere on the board
SPI_SS4: SLOT4.B13; also elsewhere on the board
STMB0: SLOT4.B8; also elsewhere on the board
STMB1: SLOT4.B9; also elsewhere on the board
STMB2: SLOT4.B10; also elsewhere on the board
STMB6: SLOT4.B11; also elsewhere on the board
STMB7: SLOT4.B12; also elsewhere on the board
STMB8: SLOT4.B18; also elsewhere on the board
STMB9: SLOT4.B19; also elsewhere on the board
STMB12: SLOT4.B21; also elsewhere on the board
STMB15: SLOT4.B22; also elsewhere on the board

Notes on the sheet:
Slots 4,5
Slot 4 power
Slot id: 1,0,0
B1,2,3 B5,6,7 B4 A1,2,3 A4,5,6,7
+5V Slot 3.3v Card-present Slot ID GND

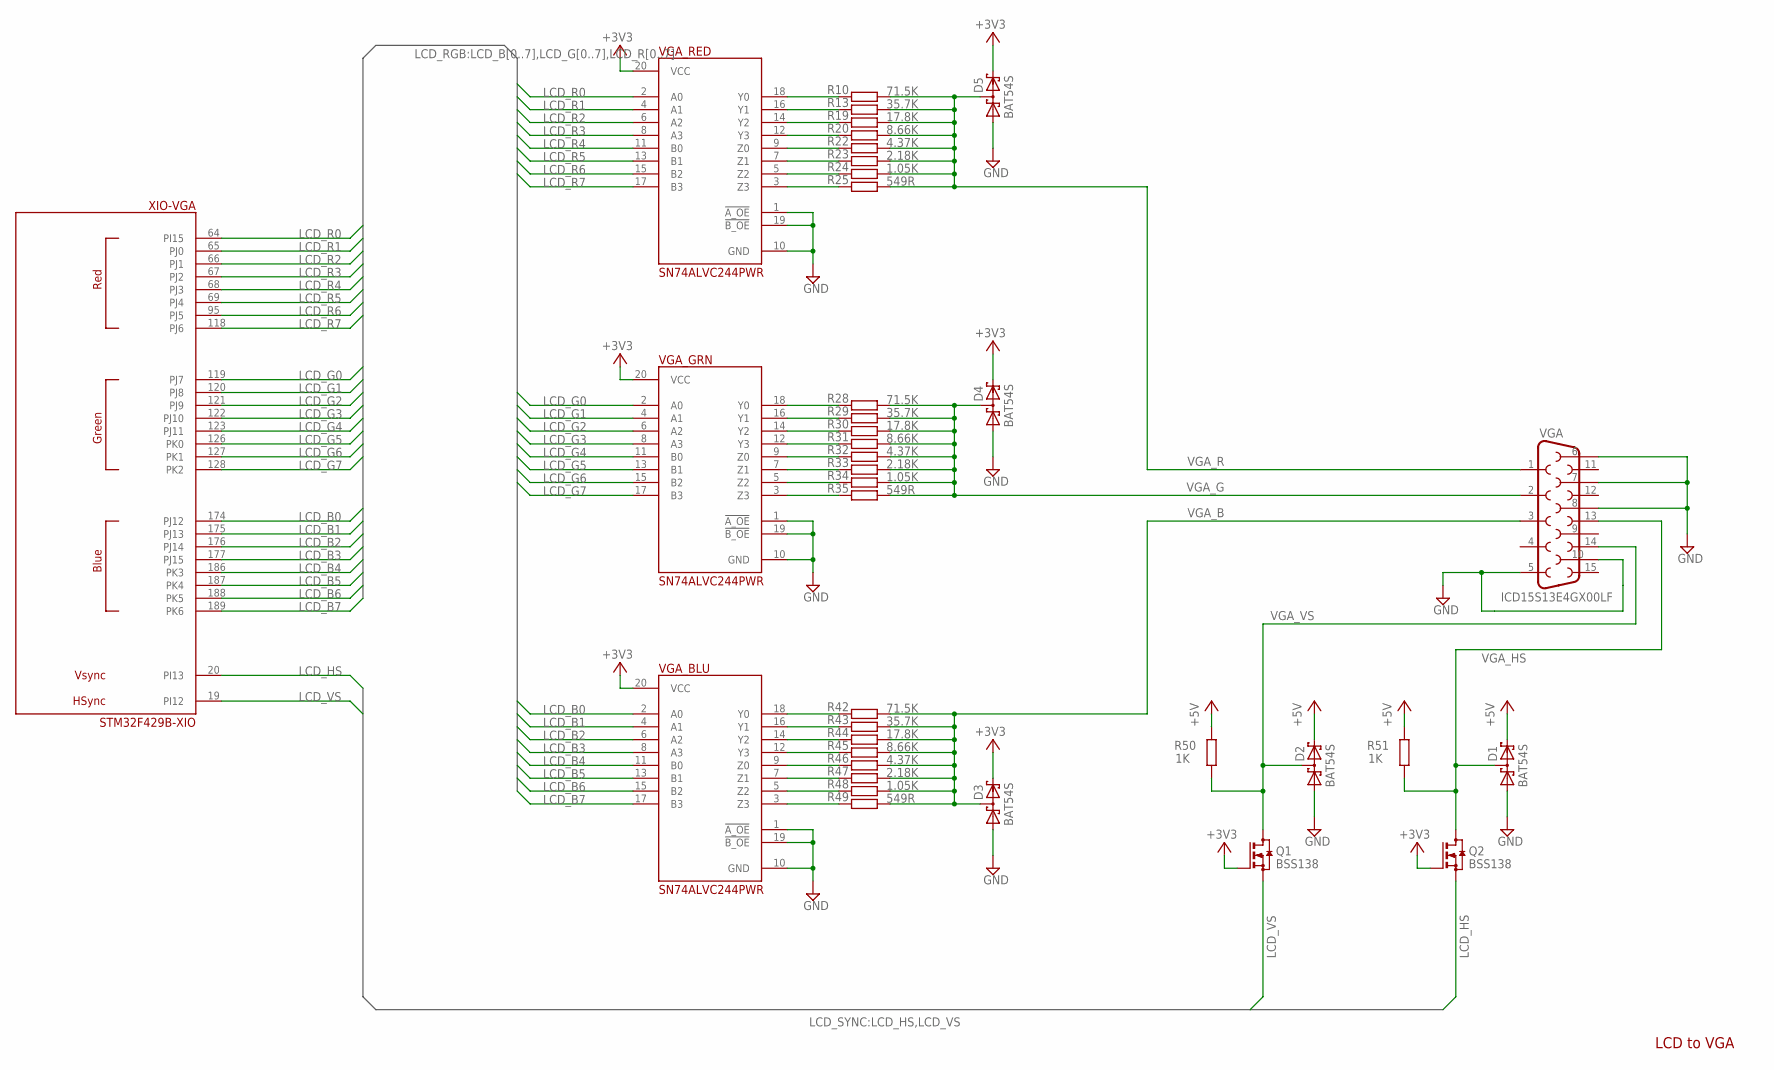
[picture p165: schematic xio.sch, sheet 11, LTDC VGA]

Parts:
D1, D2, D3, D4, D5: BAT54S; SOT23
Q1, Q2: BSS138; SOT23
R10, R28, R42: 71.5K; R0402
R13, R29, R43: 35.7K; R0402
R19, R30, R44: 17.8K; R0402
R20, R31, R45: 8.66K; R0402
R22, R32, R46: 4.37K; R0402
R23, R33, R47: 2.18K; R0402
R24, R34, R48: 1.05K; R0402
R25, R35, R49: 549R; R0402
R50, R51: 1K; R0402
VGA: ICD15S13E4GX00LF; DB15
VGA_BLU: SN74ALVC244PWR; TSSOP20
VGA_GRN: SN74ALVC244PWR; TSSOP20
VGA_RED: SN74ALVC244PWR; TSSOP20
XIO: STM32F429B-XIO; PQFP208

Connections:
+3V3: D3.2 (C2), D4.2 (C2), D5.2 (C2), Q1.1 (G), Q2.1 (G), VGA_BLU.20 (VCC), VGA_GRN.20 (VCC), VGA_RED.20 (VCC); also elsewhere on the board
+5V: D1.2 (C2), D2.2 (C2), R50.1, R51.1; also elsewhere on the board
GND: D1.1 (A1), D2.1 (A1), D3.1 (A1), D4.1 (A1), D5.1 (A1), VGA.5, VGA.6, VGA.7, VGA.8, VGA.10, VGA_BLU.1 (!A_OE!), VGA_BLU.10 (GND), VGA_BLU.19 (!B_OE!), VGA_GRN.1 (!A_OE!), VGA_GRN.10 (GND), VGA_GRN.19 (!B_OE!), VGA_RED.1 (!A_OE!), VGA_RED.10 (GND), VGA_RED.19 (!B_OE!); also elsewhere on the board
LCD_B0: VGA_BLU.2 (A0), XIO.174 (PJ12)
LCD_B1: VGA_BLU.4 (A1), XIO.175 (PJ13)
LCD_B2: VGA_BLU.6 (A2), XIO.176 (PJ14)
LCD_B3: VGA_BLU.8 (A3), XIO.177 (PJ15)
LCD_B4: VGA_BLU.11 (B0), XIO.186 (PK3)
LCD_B5: VGA_BLU.13 (B1), XIO.187 (PK4)
LCD_B6: VGA_BLU.15 (B2), XIO.188 (PK5)
LCD_B7: VGA_BLU.17 (B3), XIO.189 (PK6)
LCD_G0: VGA_GRN.2 (A0), XIO.119 (PJ7)
LCD_G1: VGA_GRN.4 (A1), XIO.120 (PJ8)
LCD_G2: VGA_GRN.6 (A2), XIO.121 (PJ9)
LCD_G3: VGA_GRN.8 (A3), XIO.122 (PJ10)
LCD_G4: VGA_GRN.11 (B0), XIO.123 (PJ11)
LCD_G5: VGA_GRN.13 (B1), XIO.126 (PK0)
LCD_G6: VGA_GRN.15 (B2), XIO.127 (PK1)
LCD_G7: VGA_GRN.17 (B3), XIO.128 (PK2)
LCD_HS: Q2.2 (S), XIO.20 (PI13)
LCD_R0: VGA_RED.2 (A0), XIO.64 (PI15)
LCD_R1: VGA_RED.4 (A1), XIO.65 (PJ0)
LCD_R2: VGA_RED.6 (A2), XIO.66 (PJ1)
LCD_R3: VGA_RED.8 (A3), XIO.67 (PJ2)
LCD_R4: VGA_RED.11 (B0), XIO.68 (PJ3)
LCD_R5: VGA_RED.13 (B1), XIO.69 (PJ4)
LCD_R6: VGA_RED.15 (B2), XIO.95 (PJ5)
LCD_R7: VGA_RED.17 (B3), XIO.118 (PJ6)
LCD_VS: Q1.2 (S), XIO.19 (PI12)
unnamed: R10.2, VGA_RED.18 (Y0)
unnamed: R13.2, VGA_RED.16 (Y1)
unnamed: R19.2, VGA_RED.14 (Y2)
unnamed: R20.2, VGA_RED.12 (Y3)
unnamed: R22.2, VGA_RED.9 (Z0)
unnamed: R23.2, VGA_RED.7 (Z1)
unnamed: R24.2, VGA_RED.5 (Z2)
unnamed: R25.2, VGA_RED.3 (Z3)
unnamed: R35.2, VGA_GRN.3 (Z3)
unnamed: R34.2, VGA_GRN.5 (Z2)
unnamed: R33.2, VGA_GRN.7 (Z1)
unnamed: R32.2, VGA_GRN.9 (Z0)
unnamed: R31.2, VGA_GRN.12 (Y3)
unnamed: R30.2, VGA_GRN.14 (Y2)
unnamed: R29.2, VGA_GRN.16 (Y1)
unnamed: R28.2, VGA_GRN.18 (Y0)
unnamed: R49.2, VGA_BLU.3 (Z3)
unnamed: R48.2, VGA_BLU.5 (Z2)
unnamed: R47.2, VGA_BLU.7 (Z1)
unnamed: R46.2, VGA_BLU.9 (Z0)
unnamed: R45.2, VGA_BLU.12 (Y3)
unnamed: R44.2, VGA_BLU.14 (Y2)
unnamed: R43.2, VGA_BLU.16 (Y1)
unnamed: R42.2, VGA_BLU.18 (Y0)
VGA_B: D3.3 (C1A2), R42.1, R43.1, R44.1, R45.1, R46.1, R47.1, R48.1, R49.1, VGA.3
VGA_G: D4.3 (C1A2), R28.1, R29.1, R30.1, R31.1, R32.1, R33.1, R34.1, R35.1, VGA.2
VGA_HS: D1.3 (C1A2), Q2.3 (D), R51.2, VGA.13
VGA_R: D5.3 (C1A2), R10.1, R13.1, R19.1, R20.1, R22.1, R23.1, R24.1, R25.1, VGA.1
VGA_VS: D2.3 (C1A2), Q1.3 (D), R50.2, VGA.14

Notes on the sheet:
LCD to VGA

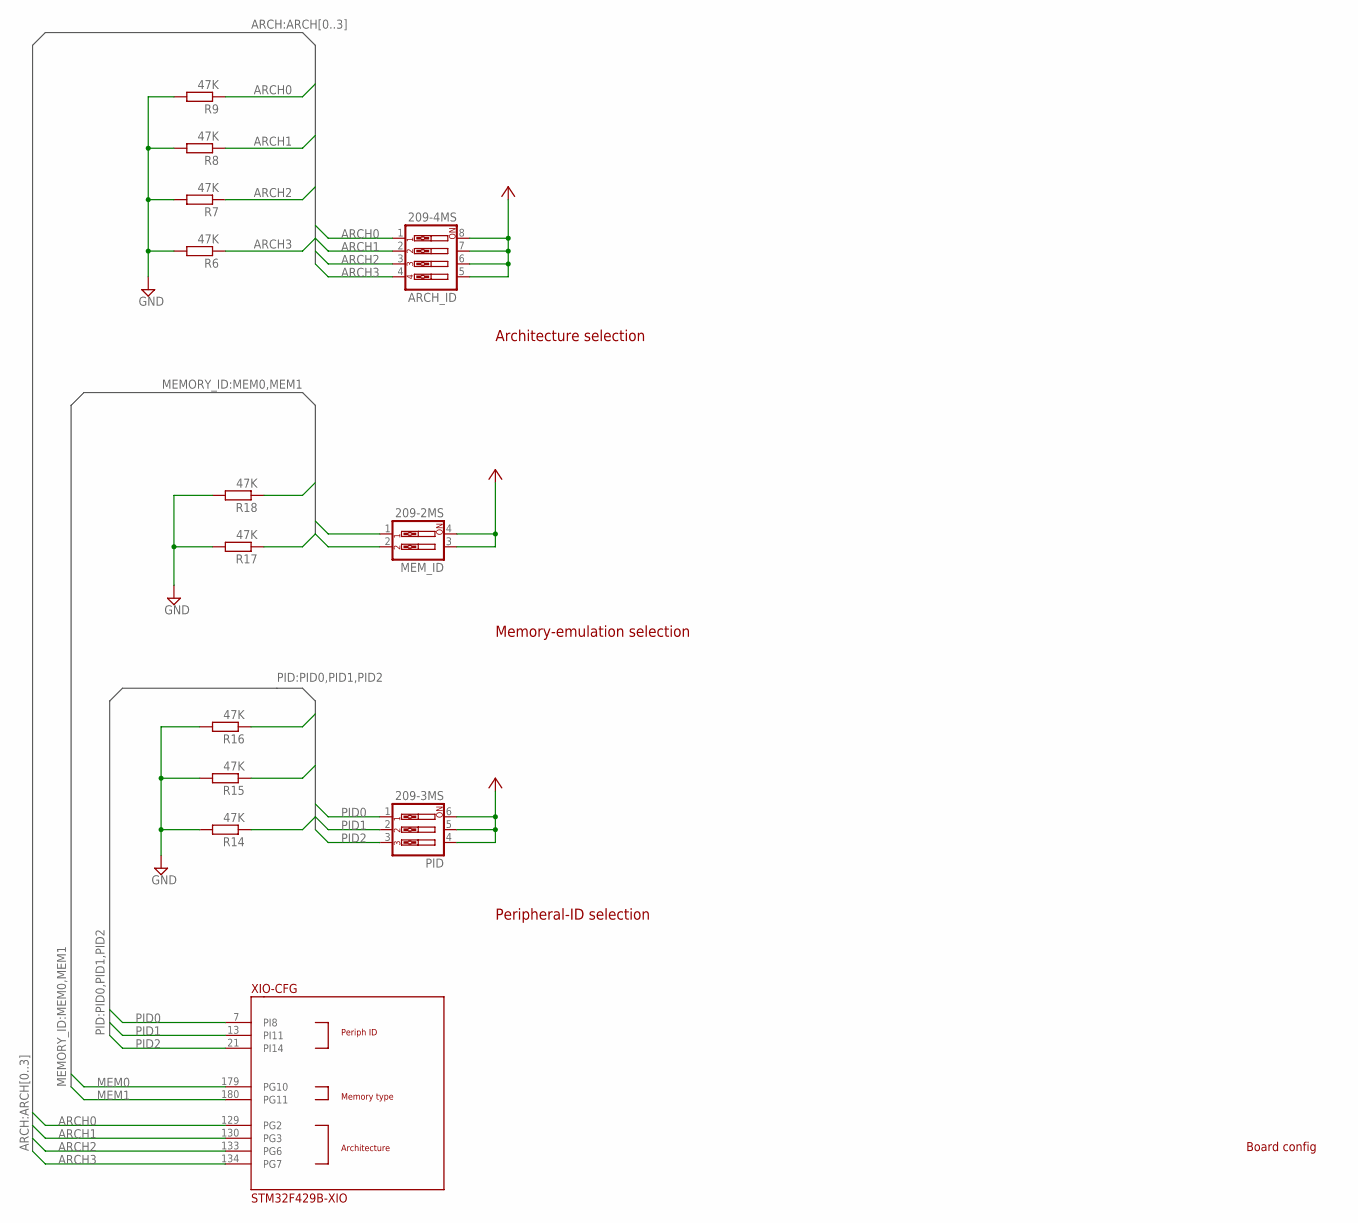
[picture p166: schematic xio.sch, sheet 12, Board config]

Parts:
ARCH_ID: 209-4MS; EDG-04
MEM_ID: 209-2MS; EDG-02
PID: 209-3MS; EDG-03
R6, R7, R8, R9, R14, R15, R16, R17, R18: 47K; R0402
XIO: STM32F429B-XIO; PQFP208

Connections:
+3V3: ARCH_ID.5, ARCH_ID.6, ARCH_ID.7, ARCH_ID.8, MEM_ID.3, MEM_ID.4, PID.4, PID.5, PID.6; also elsewhere on the board
ARCH0: ARCH_ID.1, R9.1, XIO.129 (PG2)
ARCH1: ARCH_ID.2, R8.1, XIO.130 (PG3)
ARCH2: ARCH_ID.3, R7.1, XIO.133 (PG6)
ARCH3: ARCH_ID.4, R6.1, XIO.134 (PG7)
GND: R6.2, R7.2, R8.2, R9.2, R14.2, R15.2, R16.2, R17.2, R18.2; also elsewhere on the board
MEM0: MEM_ID.1, R18.1, XIO.179 (PG10)
MEM1: MEM_ID.2, R17.1, XIO.180 (PG11)
PID0: PID.1, R16.1, XIO.7 (PI8)
PID1: PID.2, R15.1, XIO.13 (PI11)
PID2: PID.3, R14.1, XIO.21 (PI14)

Notes on the sheet:
Architecture selection
Peripheral-ID selection
Memory-emulation selection
Board config
