ThrudTheBarbarian/pbxl/boards/xio/xio.brd

## EAGLE design boards/xio/xio.brd (continued)

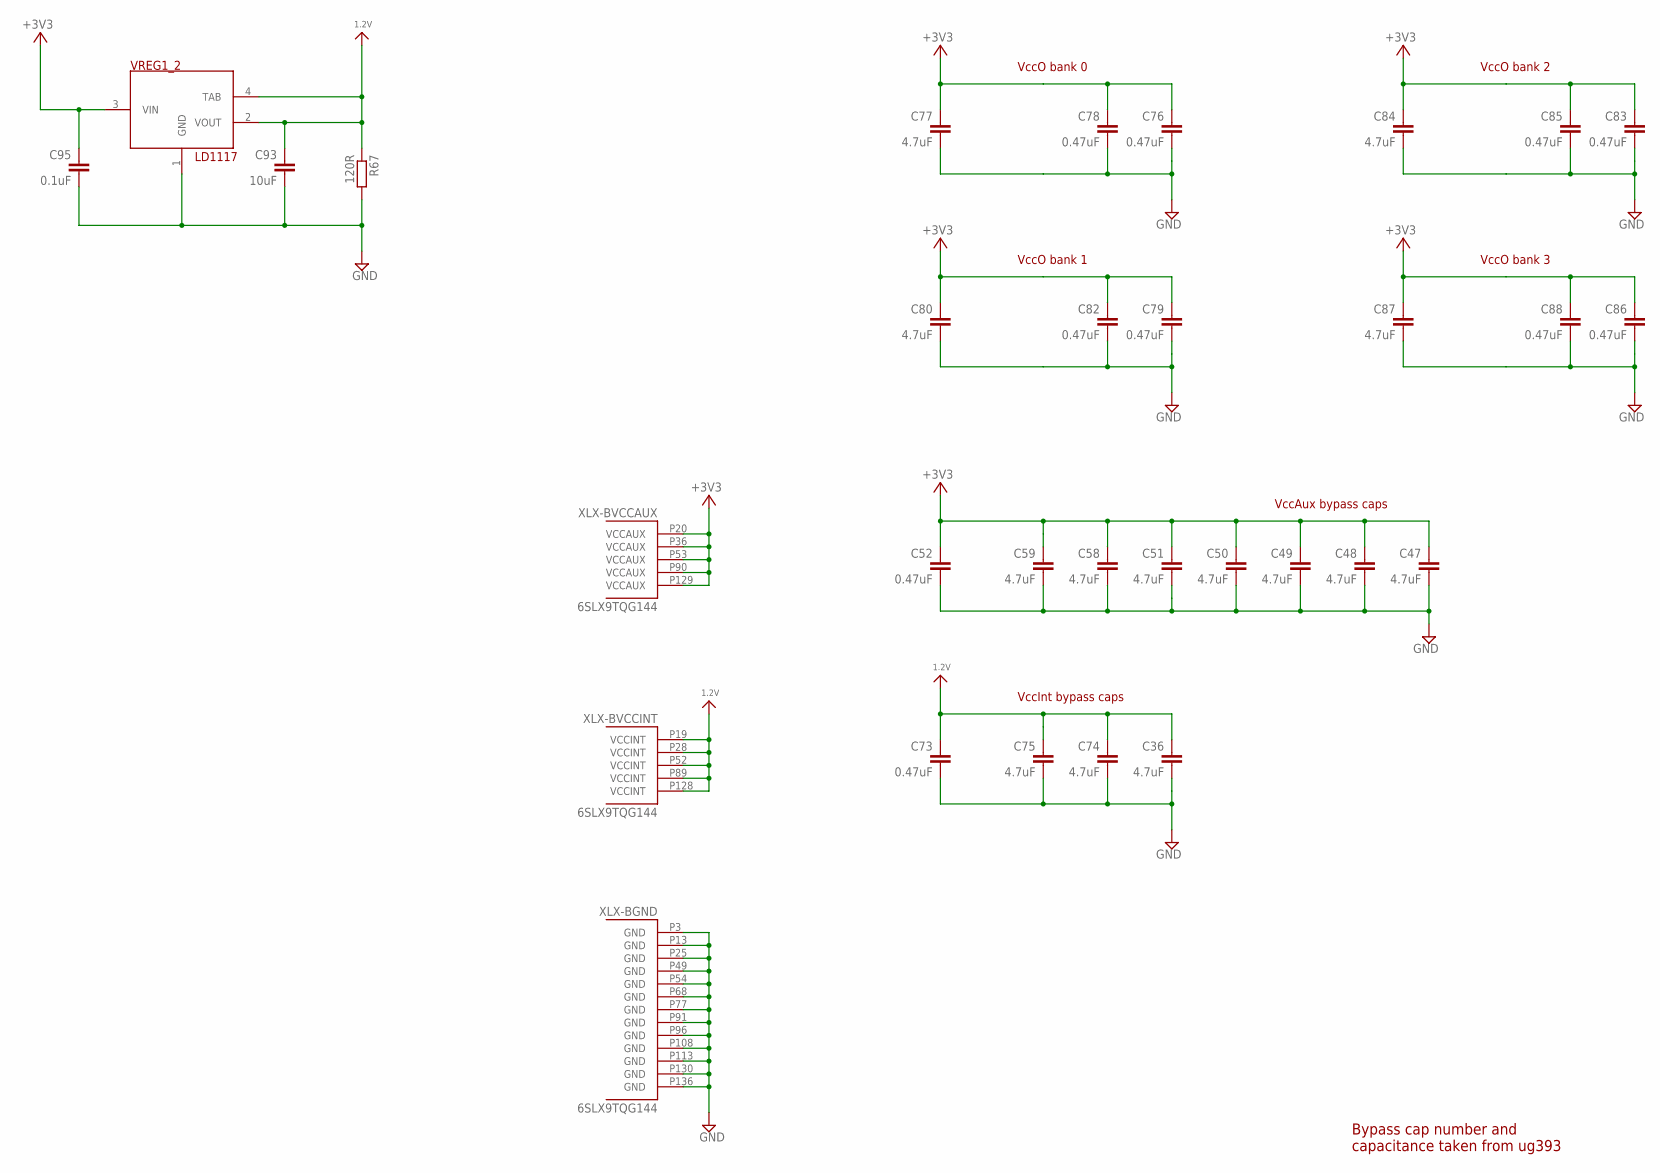
[picture p167: schematic xio.sch, sheet 13, FPGA Power]

Parts:
C36, C47, C48, C49, C50, C51, C58, C59, C74, C75, C77, C80, C84, C87: 4.7uF; C0402K
C52, C73, C76, C78, C79, C82, C83, C85, C86, C88: 0.47uF; C0402K
C93: 10uF; C0402K
C95: 0.1uF; C0402K
R67: 120R; R0402
VREG1_2: LD1117; SOT223
XLX-: 6SLX9TQG144; TQ144

Connections:
1.2V: C36.1, C73.1, C74.1, C75.1, C93.1, R67.1, VREG1_2.2 (VOUT), VREG1_2.4 (TAB), XLX-.P19 (VCCINT), XLX-.P28 (VCCINT), XLX-.P52 (VCCINT), XLX-.P89 (VCCINT), XLX-.P128 (VCCINT)
+3V3: C47.1, C48.1, C49.1, C50.1, C51.1, C52.1, C58.1, C59.1, C76.1, C77.1, C78.1, C79.1, C80.1, C82.1, C83.1, C84.1, C85.1, C86.1, C87.1, C88.1, C95.1, VREG1_2.3 (VIN), XLX-.P20 (VCCAUX), XLX-.P36 (VCCAUX), XLX-.P53 (VCCAUX), XLX-.P90 (VCCAUX), XLX-.P129 (VCCAUX); also elsewhere on the board
GND: C36.2, C47.2, C48.2, C49.2, C50.2, C51.2, C52.2, C58.2, C59.2, C73.2, C74.2, C75.2, C76.2, C77.2, C78.2, C79.2, C80.2, C82.2, C83.2, C84.2, C85.2, C86.2, C87.2, C88.2, C93.2, C95.2, R67.2, VREG1_2.1 (GND), XLX-.P3 (GND), XLX-.P13 (GND), XLX-.P25 (GND), XLX-.P49 (GND), XLX-.P54 (GND), XLX-.P68 (GND), XLX-.P77 (GND), XLX-.P91 (GND), XLX-.P96 (GND), XLX-.P108 (GND), XLX-.P113 (GND), XLX-.P130 (GND), XLX-.P136 (GND); also elsewhere on the board

Notes on the sheet:
VccAux bypass caps
VccInt bypass caps
VccO bank 0
VccO bank 1
VccO bank 2
VccO bank 3
Bypass cap number and capacitance taken from ug393

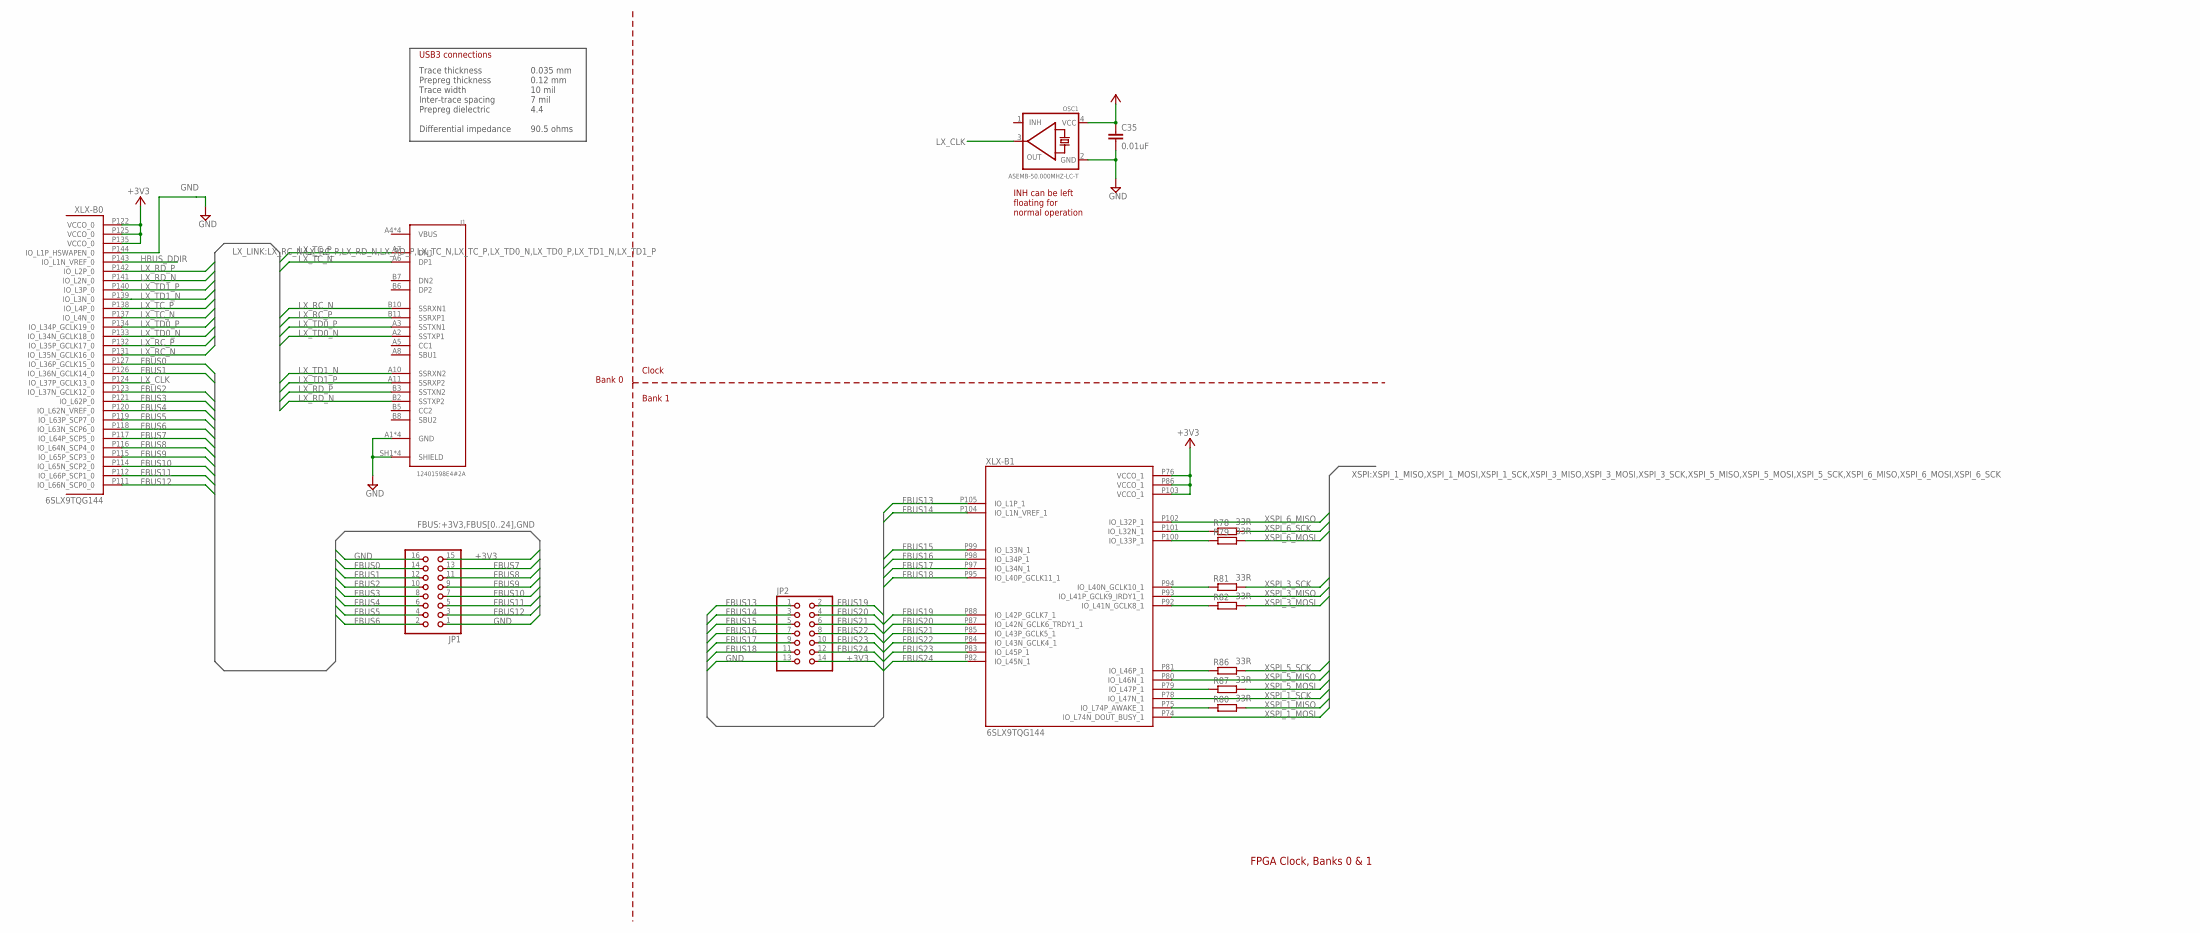
[picture p168: schematic xio.sch, sheet 14, FPGA Clock, Banks 0,1]

Parts:
C35: 0.01uF; C0402K
J1: 12401598E4#2A; AMPHENOL_12401598E4#2A
JP1: PINHD-2X8; 2X08
JP2: PINHD-2X7; 2X07
OSC1: ASEMB-50.000MHZ-LC-T; OSC_3.2X2.5MM
R78, R79, R80, R81, R82, R86, R87: 33R; R0402
XLX-: 6SLX9TQG144; TQ144

Connections:
+3V3: C35.1, JP1.15, JP2.14, OSC1.4 (VCC), XLX-.P76 (VCCO_1), XLX-.P86 (VCCO_1), XLX-.P103 (VCCO_1), XLX-.P122 (VCCO_0), XLX-.P125 (VCCO_0), XLX-.P135 (VCCO_0); also elsewhere on the board
FBUS0: JP1.14, XLX-.P127 (IO_L36P_GCLK15_0)
FBUS1: JP1.12, XLX-.P126 (IO_L36N_GCLK14_0)
FBUS2: JP1.10, XLX-.P123 (IO_L37N_GCLK12_0)
FBUS3: JP1.8, XLX-.P121 (IO_L62P_0)
FBUS4: JP1.6, XLX-.P120 (IO_L62N_VREF_0)
FBUS5: JP1.4, XLX-.P119 (IO_L63P_SCP7_0)
FBUS6: JP1.2, XLX-.P118 (IO_L63N_SCP6_0)
FBUS7: JP1.13, XLX-.P117 (IO_L64P_SCP5_0)
FBUS8: JP1.11, XLX-.P116 (IO_L64N_SCP4_0)
FBUS9: JP1.9, XLX-.P115 (IO_L65P_SCP3_0)
FBUS10: JP1.7, XLX-.P114 (IO_L65N_SCP2_0)
FBUS11: JP1.5, XLX-.P112 (IO_L66P_SCP1_0)
FBUS12: JP1.3, XLX-.P111 (IO_L66N_SCP0_0)
FBUS13: JP2.1, XLX-.P105 (IO_L1P_1)
FBUS14: JP2.3, XLX-.P104 (IO_L1N_VREF_1)
FBUS15: JP2.5, XLX-.P99 (IO_L33N_1)
FBUS16: JP2.7, XLX-.P98 (IO_L34P_1)
FBUS17: JP2.9, XLX-.P97 (IO_L34N_1)
FBUS18: JP2.11, XLX-.P95 (IO_L40P_GCLK11_1)
FBUS19: JP2.2, XLX-.P88 (IO_L42P_GCLK7_1)
FBUS20: JP2.4, XLX-.P87 (IO_L42N_GCLK6_TRDY1_1)
FBUS21: JP2.6, XLX-.P85 (IO_L43P_GCLK5_1)
FBUS22: JP2.8, XLX-.P84 (IO_L43N_GCLK4_1)
FBUS23: JP2.10, XLX-.P83 (IO_L45P_1)
FBUS24: JP2.12, XLX-.P82 (IO_L45N_1)
GND: C35.2, J1.A1 (GND), J1.A12 (GND), J1.B1 (GND), J1.B12 (GND), J1.SH1 (SHIELD), J1.SH2 (SHIELD), J1.SH3 (SHIELD), J1.SH4 (SHIELD), JP1.1, JP1.16, JP2.13, OSC1.2 (GND), XLX-.P144 (IO_L1P_HSWAPEN_0); also elsewhere on the board
HBUS_DDIR: XLX-.P143 (IO_L1N_VREF_0); also elsewhere on the board
LX_CLK: OSC1.3 (OUT), XLX-.P124 (IO_L37P_GCLK13_0)
LX_RC_N: J1.B10 (SSRXN1), XLX-.P131 (IO_L35N_GCLK16_0)
LX_RC_P: J1.B11 (SSRXP1), XLX-.P132 (IO_L35P_GCLK17_0)
LX_RD_N: J1.B2 (SSTXP2), XLX-.P141 (IO_L2N_0)
LX_RD_P: J1.B3 (SSTXN2), XLX-.P142 (IO_L2P_0)
LX_TC_N: J1.A6 (DP1), XLX-.P137 (IO_L4N_0)
LX_TC_P: J1.A7 (DN1), XLX-.P138 (IO_L4P_0)
LX_TD0_N: J1.A2 (SSTXP1), XLX-.P133 (IO_L34N_GCLK18_0)
LX_TD0_P: J1.A3 (SSTXN1), XLX-.P134 (IO_L34P_GCLK19_0)
LX_TD1_N: J1.A10 (SSRXN2), XLX-.P139 (IO_L3N_0)
LX_TD1_P: J1.A11 (SSRXP2), XLX-.P140 (IO_L3P_0)
unnamed: R82.1, XLX-.P92 (IO_L41N_GCLK8_1)
unnamed: R81.1, XLX-.P94 (IO_L40N_GCLK10_1)
unnamed: R79.1, XLX-.P100 (IO_L33P_1)
unnamed: R78.1, XLX-.P101 (IO_L32N_1)
unnamed: R80.1, XLX-.P75 (IO_L74P_AWAKE_1)
unnamed: R86.1, XLX-.P81 (IO_L46P_1)
unnamed: R87.1, XLX-.P79 (IO_L47P_1)
XSPI_1_MISO: R80.2; also elsewhere on the board
XSPI_1_MOSI: XLX-.P74 (IO_L74N_DOUT_BUSY_1); also elsewhere on the board
XSPI_1_SCK: XLX-.P78 (IO_L47N_1); also elsewhere on the board
XSPI_3_MISO: XLX-.P93 (IO_L41P_GCLK9_IRDY1_1); also elsewhere on the board
XSPI_3_MOSI: R82.2; also elsewhere on the board
XSPI_3_SCK: R81.2; also elsewhere on the board
XSPI_5_MISO: XLX-.P80 (IO_L46N_1); also elsewhere on the board
XSPI_5_MOSI: R87.2; also elsewhere on the board
XSPI_5_SCK: R86.2; also elsewhere on the board
XSPI_6_MISO: XLX-.P102 (IO_L32P_1); also elsewhere on the board
XSPI_6_MOSI: R79.2; also elsewhere on the board
XSPI_6_SCK: R78.2; also elsewhere on the board

Notes on the sheet:
INH can be left floating for normal operation
Trace thickness Prepreg thickness Trace width Inter-trace spacing Prepreg dielectric Differential impedance
0.035 mm 0.12 mm 10 mil 7 mil 4.4 90.5 ohms
USB3 connections
Bank 0
Bank 1
Clock
FPGA Clock, Banks 0 & 1

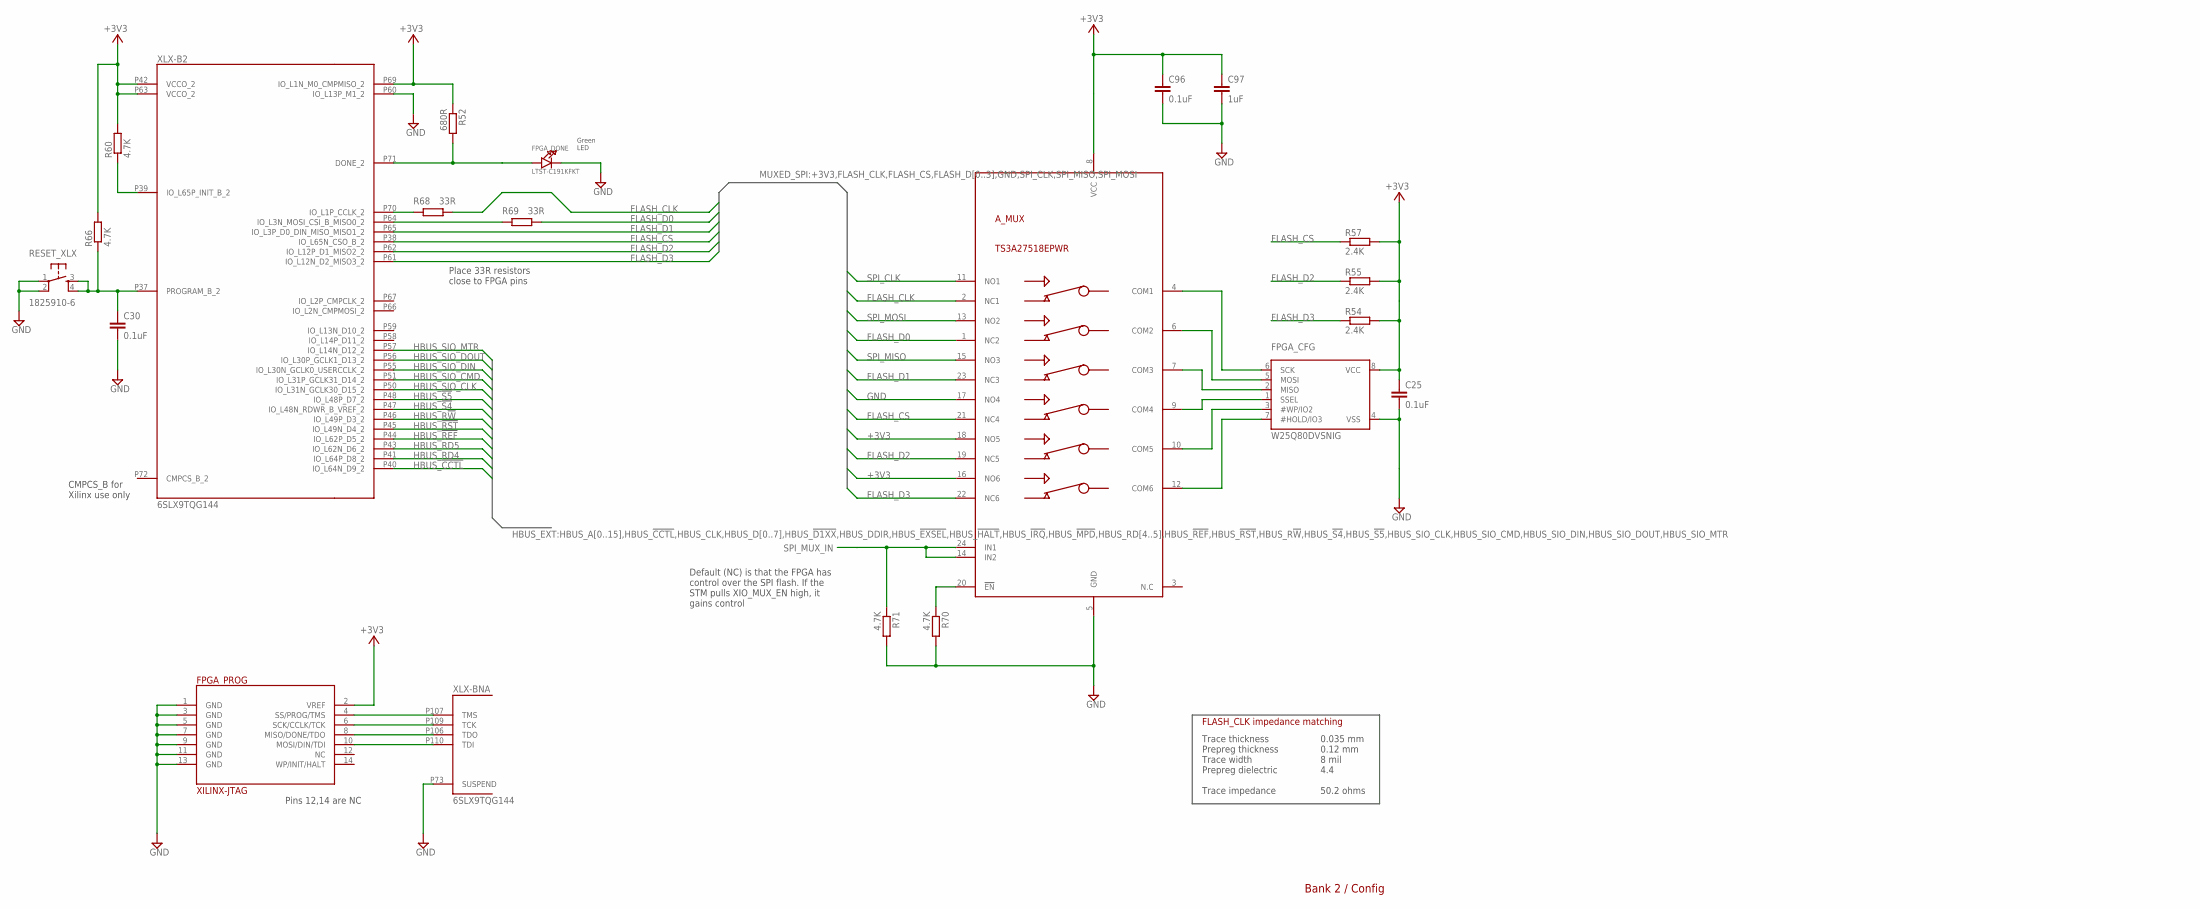
[picture p169: schematic xio.sch, sheet 15, FPGA Bank2]

Parts:
A_MUX: TS3A27518EPWR; TSSOP24
C25, C30, C96: 0.1uF; C0402K
C97: 1uF; C0402K
FPGA_CFG: W25Q80DVSNIG; SOIC8_150MIL
FPGA_DONE: LTST-C191KFKT; CHIPLED_0603
FPGA_PROG: XILINX-JTAG; 332-14
R52: 680R; R0402
R54, R55, R57: 2.4K; R0402
R60, R66, R70, R71: 4.7K; R0402
R68, R69: 33R; R0402
RESET_XLX: 1825910-6; TACTILE-PTH
XLX-: 6SLX9TQG144; TQ144

Connections:
+3V3: A_MUX.8 (VCC), A_MUX.16 (NO6), A_MUX.18 (NO5), C25.1, C96.1, C97.1, FPGA_CFG.8 (VCC), FPGA_PROG.2 (VREF), R52.1, R54.2, R55.2, R57.2, R60.2, R66.2, XLX-.P42 (VCCO_2), XLX-.P63 (VCCO_2), XLX-.P69 (IO_L1N_M0_CMPMISO_2); also elsewhere on the board
FLASH_CLK: A_MUX.2 (NC1), R68.2
FLASH_CS: A_MUX.21 (NC4), R57.1, XLX-.P38 (IO_L65N_CSO_B_2)
FLASH_D0: A_MUX.1 (NC2), R69.2
FLASH_D1: A_MUX.23 (NC3), XLX-.P65 (IO_L3P_D0_DIN_MISO_MISO1_2)
FLASH_D2: A_MUX.19 (NC5), R55.1, XLX-.P62 (IO_L12P_D1_MISO2_2)
FLASH_D3: A_MUX.22 (NC6), R54.1, XLX-.P61 (IO_L12N_D2_MISO3_2)
GND: A_MUX.5 (GND), A_MUX.17 (NO4), C25.2, C30.2, C96.2, C97.2, FPGA_CFG.4 (VSS), FPGA_DONE.C, FPGA_PROG.1 (GND), FPGA_PROG.3 (GND), FPGA_PROG.5 (GND), FPGA_PROG.7 (GND), FPGA_PROG.9 (GND), FPGA_PROG.11 (GND), FPGA_PROG.13 (GND), R70.2, R71.2, RESET_XLX.1, RESET_XLX.2, XLX-.P60 (IO_L13P_M1_2), XLX-.P73 (SUSPEND); also elsewhere on the board
HBUS_!CCTL!: XLX-.P40 (IO_L64N_D9_2); also elsewhere on the board
HBUS_!REF!: XLX-.P44 (IO_L62P_D5_2); also elsewhere on the board
HBUS_!RST!: XLX-.P45 (IO_L49N_D4_2); also elsewhere on the board
HBUS_!S4!: XLX-.P47 (IO_L48N_RDWR_B_VREF_2); also elsewhere on the board
HBUS_!S5!: XLX-.P48 (IO_L48P_D7_2); also elsewhere on the board
HBUS_R!W!: XLX-.P46 (IO_L49P_D3_2); also elsewhere on the board
HBUS_RD4: XLX-.P41 (IO_L64P_D8_2); also elsewhere on the board
HBUS_RD5: XLX-.P43 (IO_L62N_D6_2); also elsewhere on the board
HBUS_SIO_CLK: XLX-.P50 (IO_L31N_GCLK30_D15_2); also elsewhere on the board
HBUS_SIO_CMD: XLX-.P51 (IO_L31P_GCLK31_D14_2); also elsewhere on the board
HBUS_SIO_DIN: XLX-.P55 (IO_L30N_GCLK0_USERCCLK_2); also elsewhere on the board
HBUS_SIO_DOUT: XLX-.P56 (IO_L30P_GCLK1_D13_2); also elsewhere on the board
HBUS_SIO_MTR: XLX-.P57 (IO_L14N_D12_2); also elsewhere on the board
unnamed: A_MUX.4 (COM1), FPGA_CFG.6 (SCK)
unnamed: FPGA_DONE.A, R52.2, XLX-.P71 (DONE_2)
unnamed: R60.1, XLX-.P39 (IO_L65P_INIT_B_2)
unnamed: C30.1, R66.1, RESET_XLX.3, RESET_XLX.4, XLX-.P37 (PROGRAM_B_2)
unnamed: FPGA_PROG.4 (SS/PROG/TMS), XLX-.P107 (TMS)
unnamed: FPGA_PROG.6 (SCK/CCLK/TCK), XLX-.P109 (TCK)
unnamed: FPGA_PROG.8 (MISO/DONE/TDO), XLX-.P106 (TDO)
unnamed: FPGA_PROG.10 (MOSI/DIN/TDI), XLX-.P110 (TDI)
unnamed: A_MUX.6 (COM2), FPGA_CFG.5 (MOSI)
unnamed: A_MUX.7 (COM3), FPGA_CFG.2 (MISO)
unnamed: A_MUX.9 (COM4), FPGA_CFG.1 (SSEL)
unnamed: A_MUX.10 (COM5), FPGA_CFG.3 (#WP/IO2)
unnamed: A_MUX.12 (COM6), FPGA_CFG.7 (#HOLD/IO3)
unnamed: R68.1, XLX-.P70 (IO_L1P_CCLK_2)
unnamed: R69.1, XLX-.P64 (IO_L3N_MOSI_CSI_B_MISO0_2)
unnamed: A_MUX.20 (!EN!), R70.1
SPI_CLK: A_MUX.11 (NO1); also elsewhere on the board
SPI_MISO: A_MUX.15 (NO3); also elsewhere on the board
SPI_MOSI: A_MUX.13 (NO2); also elsewhere on the board
SPI_MUX_IN: A_MUX.14 (IN2), A_MUX.24 (IN1), R71.1; also elsewhere on the board

Notes on the sheet:
Green LED
Bank 2 / Config
CMPCS_B for Xilinx use only
Trace thickness Prepreg thickness Trace width Prepreg dielectric Trace impedance
0.035 mm 0.12 mm 8 mil 4.4 50.2 ohms
FLASH_CLK impedance matching
Place 33R resistors close to FPGA pins
Default (NC) is that the FPGA has control over the SPI flash. If the STM pulls XIO_MUX_EN high, it gains control
Pins 12,14 are NC

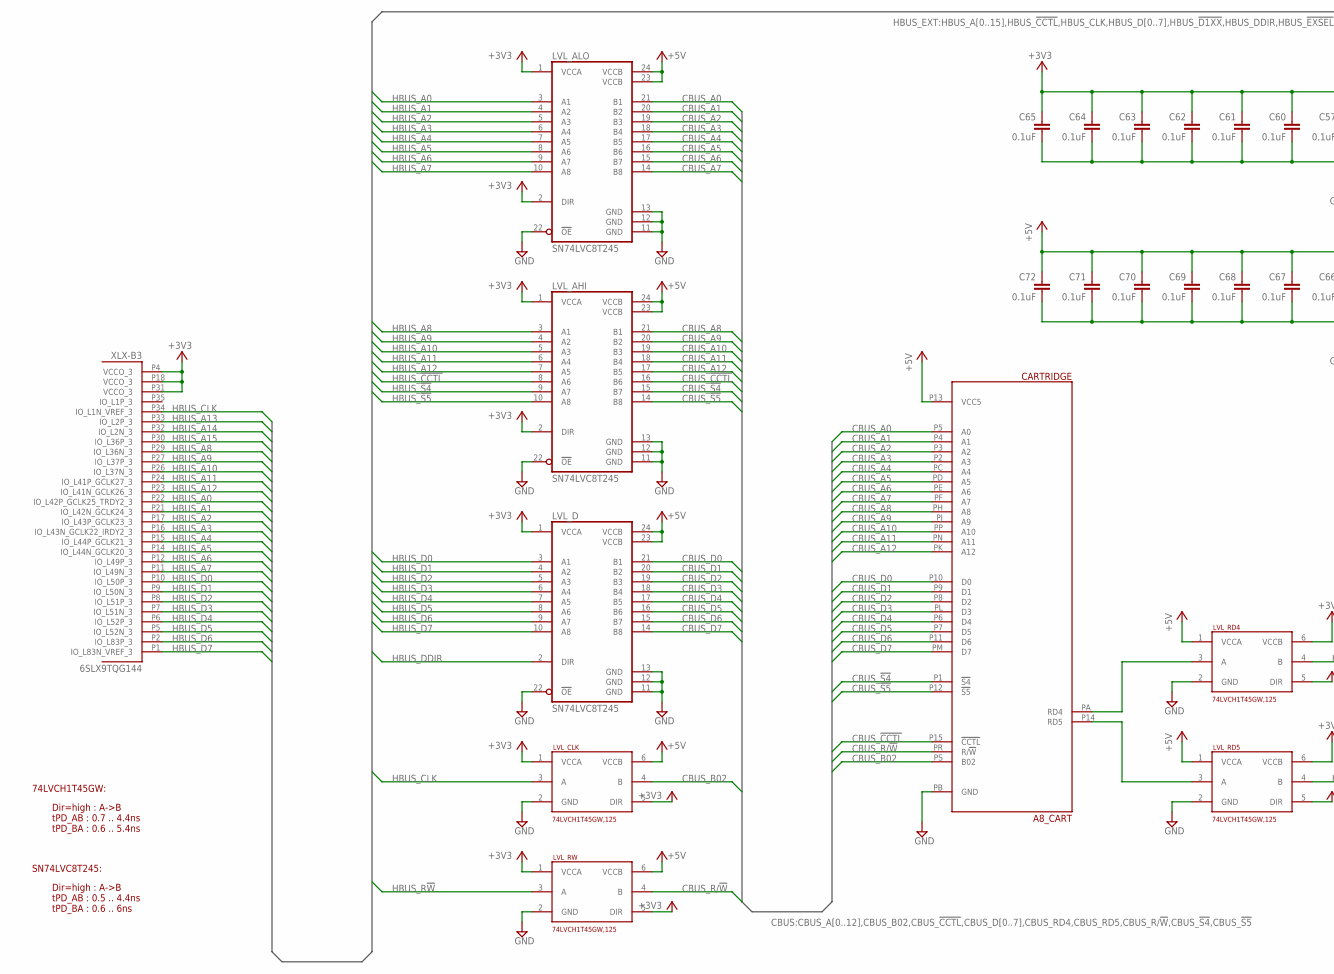
[picture p170: schematic xio.sch, sheet 16, FPGA Bank3, part in row 1, column 1]

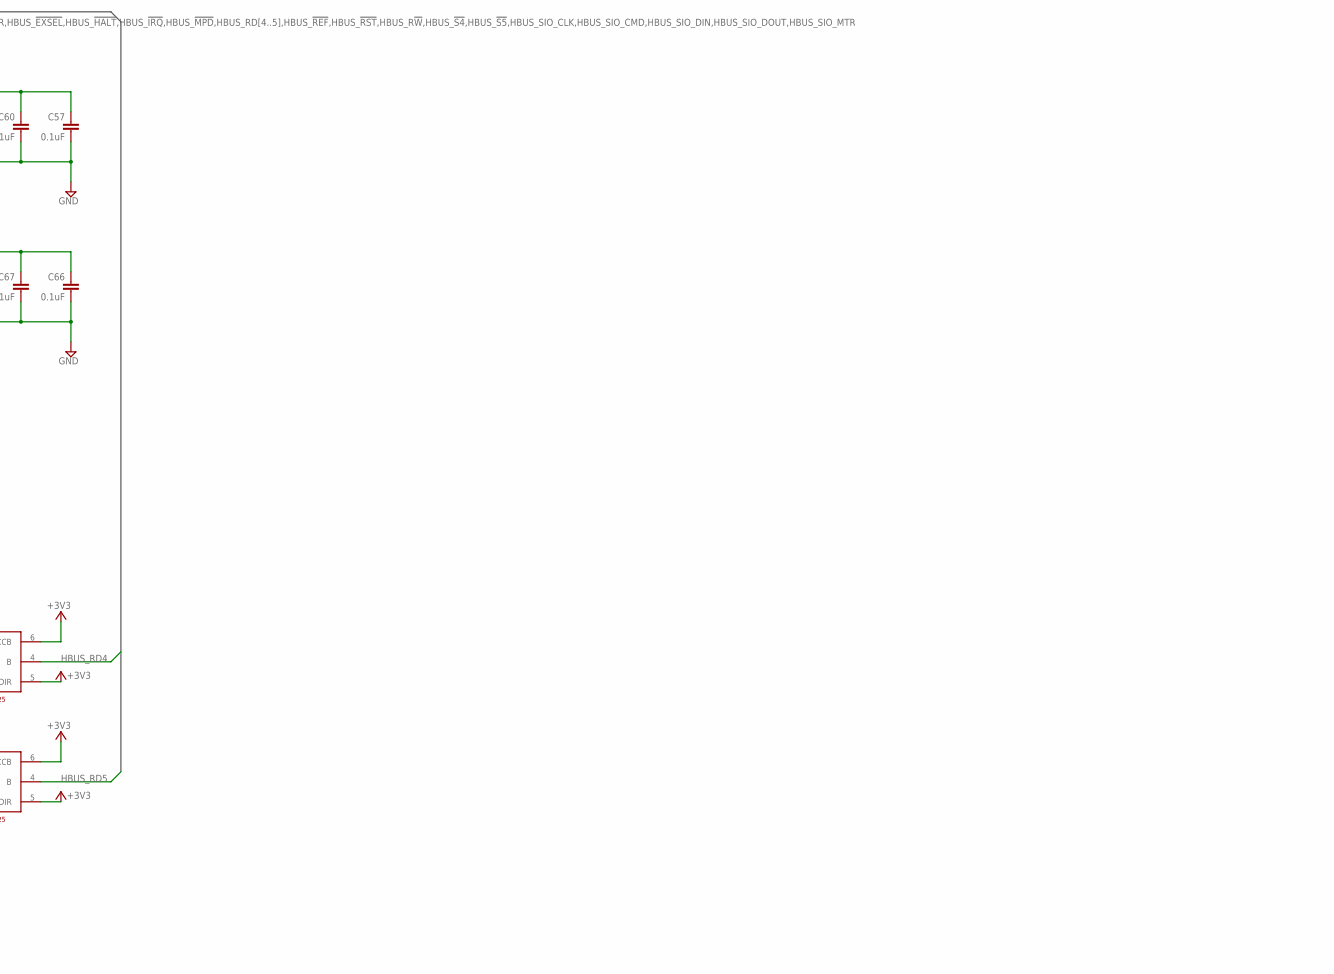
[picture p171: schematic xio.sch, sheet 16, FPGA Bank3, part in row 1, column 2]

Parts:
C57, C60, C61, C62, C63, C64, C65, C66, C67, C68, C69, C70, C71, C72: 0.1uF; C0402K
CARTRIDGE: A8_CART
LVL_AHI: SN74LVC8T245; TSSOP24
LVL_ALO: SN74LVC8T245; TSSOP24
LVL_CLK: 74LVCH1T45GW,125; SOT363
LVL_D: SN74LVC8T245; TSSOP24
LVL_RD4, LVL_RD5: 74LVCH1T45GW,125; SOT363
LVL_RW: 74LVCH1T45GW,125; SOT363
XLX-: 6SLX9TQG144; TQ144

Connections:
+3V3: C57.1, C60.1, C61.1, C62.1, C63.1, C64.1, C65.1, LVL_AHI.1 (VCCA), LVL_AHI.2 (DIR), LVL_ALO.1 (VCCA), LVL_ALO.2 (DIR), LVL_CLK.1 (VCCA), LVL_CLK.5 (DIR), LVL_D.1 (VCCA), LVL_RD4.5 (DIR), LVL_RD4.6 (VCCB), LVL_RD5.5 (DIR), LVL_RD5.6 (VCCB), LVL_RW.1 (VCCA), LVL_RW.5 (DIR), XLX-.P4 (VCCO_3), XLX-.P18 (VCCO_3), XLX-.P31 (VCCO_3); also elsewhere on the board
+5V: C66.1, C67.1, C68.1, C69.1, C70.1, C71.1, C72.1, CARTRIDGE.P13 (VCC5), LVL_AHI.23 (VCCB), LVL_AHI.24 (VCCB), LVL_ALO.23 (VCCB), LVL_ALO.24 (VCCB), LVL_CLK.6 (VCCB), LVL_D.23 (VCCB), LVL_D.24 (VCCB), LVL_RD4.1 (VCCA), LVL_RD5.1 (VCCA), LVL_RW.6 (VCCB); also elsewhere on the board
CBUS_!CCTL!: CARTRIDGE.P15 (!CCTL!), LVL_AHI.16 (B6)
CBUS_!S4!: CARTRIDGE.P1 (!S4!), LVL_AHI.15 (B7)
CBUS_!S5!: CARTRIDGE.P12 (!S5!), LVL_AHI.14 (B8)
CBUS_A0: CARTRIDGE.P5 (A0), LVL_ALO.21 (B1)
CBUS_A1: CARTRIDGE.P4 (A1), LVL_ALO.20 (B2)
CBUS_A2: CARTRIDGE.P3 (A2), LVL_ALO.19 (B3)
CBUS_A3: CARTRIDGE.P2 (A3), LVL_ALO.18 (B4)
CBUS_A4: CARTRIDGE.PC (A4), LVL_ALO.17 (B5)
CBUS_A5: CARTRIDGE.PD (A5), LVL_ALO.16 (B6)
CBUS_A6: CARTRIDGE.PE (A6), LVL_ALO.15 (B7)
CBUS_A7: CARTRIDGE.PF (A7), LVL_ALO.14 (B8)
CBUS_A8: CARTRIDGE.PH (A8), LVL_AHI.21 (B1)
CBUS_A9: CARTRIDGE.PJ (A9), LVL_AHI.20 (B2)
CBUS_A10: CARTRIDGE.PP (A10), LVL_AHI.19 (B3)
CBUS_A11: CARTRIDGE.PN (A11), LVL_AHI.18 (B4)
CBUS_A12: CARTRIDGE.PK (A12), LVL_AHI.17 (B5)
CBUS_B02: CARTRIDGE.PS (B02), LVL_CLK.4 (B)
CBUS_D0: CARTRIDGE.P10 (D0), LVL_D.21 (B1)
CBUS_D1: CARTRIDGE.P9 (D1), LVL_D.20 (B2)
CBUS_D2: CARTRIDGE.P8 (D2), LVL_D.19 (B3)
CBUS_D3: CARTRIDGE.PL (D3), LVL_D.18 (B4)
CBUS_D4: CARTRIDGE.P6 (D4), LVL_D.17 (B5)
CBUS_D5: CARTRIDGE.P7 (D5), LVL_D.16 (B6)
CBUS_D6: CARTRIDGE.P11 (D6), LVL_D.15 (B7)
CBUS_D7: CARTRIDGE.PM (D7), LVL_D.14 (B8)
CBUS_R/!W!: CARTRIDGE.PR (R/!W!), LVL_RW.4 (B)
GND: C57.2, C60.2, C61.2, C62.2, C63.2, C64.2, C65.2, C66.2, C67.2, C68.2, C69.2, C70.2, C71.2, C72.2, CARTRIDGE.PB (GND), LVL_AHI.11 (GND), LVL_AHI.12 (GND), LVL_AHI.13 (GND), LVL_AHI.22 (!OE!), LVL_ALO.11 (GND), LVL_ALO.12 (GND), LVL_ALO.13 (GND), LVL_ALO.22 (!OE!), LVL_CLK.2 (GND), LVL_D.11 (GND), LVL_D.12 (GND), LVL_D.13 (GND), LVL_D.22 (!OE!), LVL_RD4.2 (GND), LVL_RD5.2 (GND), LVL_RW.2 (GND); also elsewhere on the board
HBUS_!CCTL!: LVL_AHI.8 (A6); also elsewhere on the board
HBUS_!S4!: LVL_AHI.9 (A7); also elsewhere on the board
HBUS_!S5!: LVL_AHI.10 (A8); also elsewhere on the board
HBUS_A0: LVL_ALO.3 (A1), XLX-.P22 (IO_L42P_GCLK25_TRDY2_3); also elsewhere on the board
HBUS_A1: LVL_ALO.4 (A2), XLX-.P21 (IO_L42N_GCLK24_3); also elsewhere on the board
HBUS_A2: LVL_ALO.5 (A3), XLX-.P17 (IO_L43P_GCLK23_3); also elsewhere on the board
HBUS_A3: LVL_ALO.6 (A4), XLX-.P16 (IO_L43N_GCLK22_IRDY2_3); also elsewhere on the board
HBUS_A4: LVL_ALO.7 (A5), XLX-.P15 (IO_L44P_GCLK21_3); also elsewhere on the board
HBUS_A5: LVL_ALO.8 (A6), XLX-.P14 (IO_L44N_GCLK20_3); also elsewhere on the board
HBUS_A6: LVL_ALO.9 (A7), XLX-.P12 (IO_L49P_3); also elsewhere on the board
HBUS_A7: LVL_ALO.10 (A8), XLX-.P11 (IO_L49N_3); also elsewhere on the board
HBUS_A8: LVL_AHI.3 (A1), XLX-.P29 (IO_L36N_3); also elsewhere on the board
HBUS_A9: LVL_AHI.4 (A2), XLX-.P27 (IO_L37P_3); also elsewhere on the board
HBUS_A10: LVL_AHI.5 (A3), XLX-.P26 (IO_L37N_3); also elsewhere on the board
HBUS_A11: LVL_AHI.6 (A4), XLX-.P24 (IO_L41P_GCLK27_3); also elsewhere on the board
HBUS_A12: LVL_AHI.7 (A5), XLX-.P23 (IO_L41N_GCLK26_3); also elsewhere on the board
HBUS_A13: XLX-.P33 (IO_L2P_3); also elsewhere on the board
HBUS_A14: XLX-.P32 (IO_L2N_3); also elsewhere on the board
HBUS_A15: XLX-.P30 (IO_L36P_3); also elsewhere on the board
HBUS_CLK: LVL_CLK.3 (A), XLX-.P34 (IO_L1N_VREF_3); also elsewhere on the board
HBUS_D0: LVL_D.3 (A1), XLX-.P10 (IO_L50P_3); also elsewhere on the board
HBUS_D1: LVL_D.4 (A2), XLX-.P9 (IO_L50N_3); also elsewhere on the board
HBUS_D2: LVL_D.5 (A3), XLX-.P8 (IO_L51P_3); also elsewhere on the board
HBUS_D3: LVL_D.6 (A4), XLX-.P7 (IO_L51N_3); also elsewhere on the board
HBUS_D4: LVL_D.7 (A5), XLX-.P6 (IO_L52P_3); also elsewhere on the board
HBUS_D5: LVL_D.8 (A6), XLX-.P5 (IO_L52N_3); also elsewhere on the board
HBUS_D6: LVL_D.9 (A7), XLX-.P2 (IO_L83P_3); also elsewhere on the board
HBUS_D7: LVL_D.10 (A8), XLX-.P1 (IO_L83N_VREF_3); also elsewhere on the board
HBUS_DDIR: LVL_D.2 (DIR); also elsewhere on the board
HBUS_R!W!: LVL_RW.3 (A); also elsewhere on the board
HBUS_RD4: LVL_RD4.4 (B); also elsewhere on the board
HBUS_RD5: LVL_RD5.4 (B); also elsewhere on the board
unnamed: CARTRIDGE.PA (RD4), LVL_RD4.3 (A)
unnamed: CARTRIDGE.P14 (RD5), LVL_RD5.3 (A)

Notes on the sheet:
Dir=high : A->B tPD_AB : 0.7 .. 4.4ns tPD_BA : 0.6 .. 5.4ns
74LVCH1T45GW:
SN74LVC8T245:
Dir=high : A->B tPD_AB : 0.5 .. 4.4ns tPD_BA : 0.6 .. 6ns

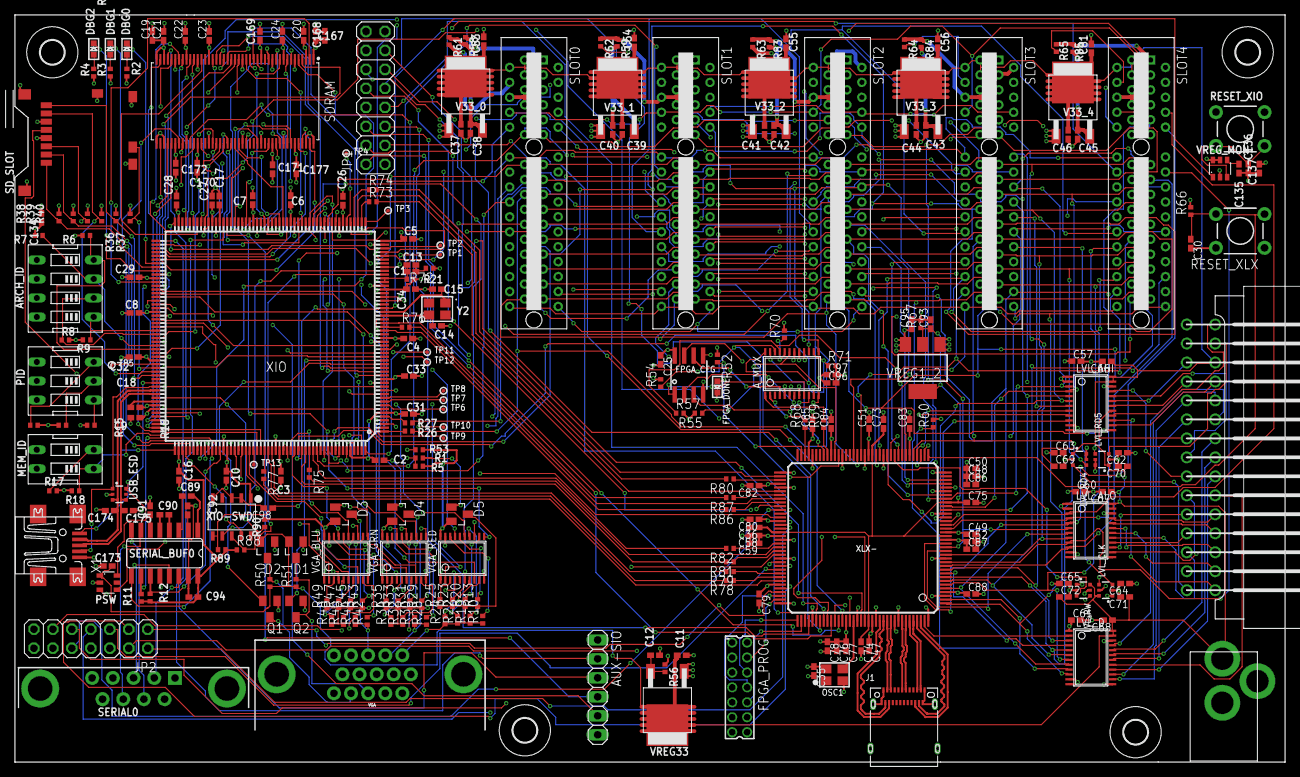
[picture p172: board boards/xio/xio.brd from above]

Board: 6 copper layers, 170.0 x 100.0 mm, 280 parts (0 on the bottom side), 378 nets.
