ThrudTheBarbarian/pbxl/boards/xe-interface/xmosio2.brd

## EAGLE design boards/xe-interface/xmosio2.brd (2018-04-30)

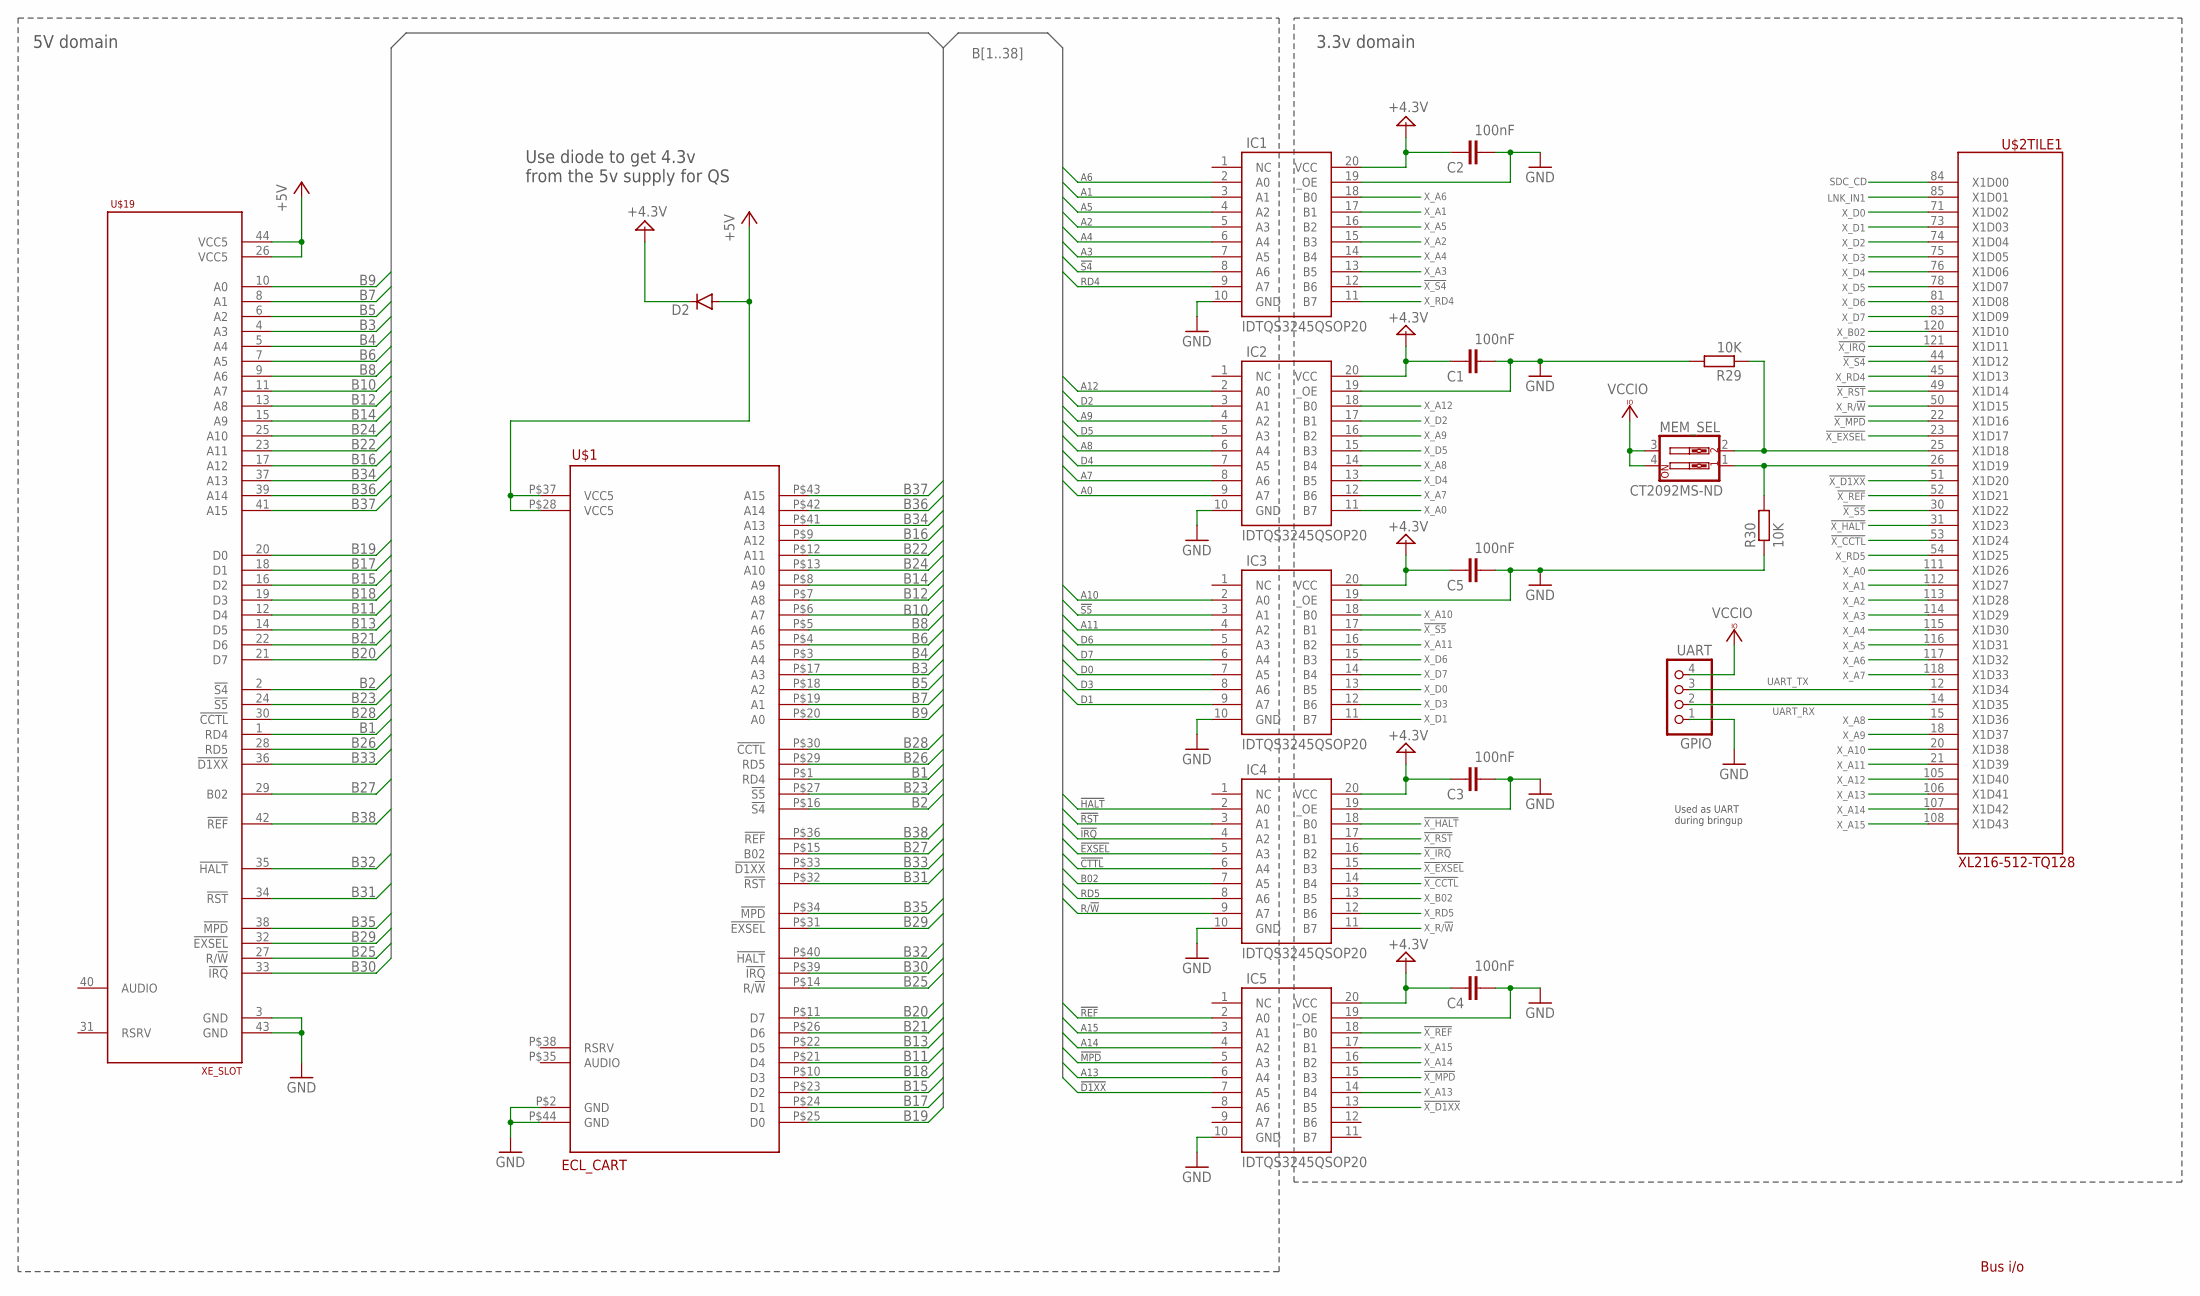
[picture p173: schematic xmosio2.sch, sheet 1, BUS i/o]

Parts:
C1, C2, C3, C4, C5: 100nF; C1206
D2: DIODE; DIODE-1N4001-KIT
GPIO: UART; 1X04
IC1, IC2, IC3, IC4, IC5: IDTQS3245QSOP20; QSOP20
MEM_SEL: CT2092MS-ND; EDG-02
R29, R30: 10K; R1206
U$1: ECL_CART
U$2: XL216-512-TQ128; TQFP128
U$19: XE_SLOT

Connections:
!X_CCTL!: IC4.14 (B4), U$2.53 (X1D24)
!X_D1XX!: IC5.13 (B5), U$2.51 (X1D20)
!X_EXSEL!: IC4.15 (B3), U$2.23 (X1D17)
!X_HALT!: IC4.18 (B0), U$2.31 (X1D23)
!X_IRQ!: IC4.16 (B2), U$2.121 (X1D11)
!X_MPD!: IC5.15 (B3), U$2.22 (X1D16)
!X_REF!: IC5.18 (B0), U$2.52 (X1D21)
!X_RST!: IC4.17 (B1), U$2.49 (X1D14)
!X_S4!: IC1.12 (B6), U$2.44 (X1D12)
!X_S5!: IC3.17 (B1), U$2.30 (X1D22)
+4.3V: C1.1, C2.1, C3.1, C4.1, C5.1, D2.C, IC1.20 (VCC), IC2.20 (VCC), IC3.20 (VCC), IC4.20 (VCC), IC5.20 (VCC)
+5V: D2.A, U$1.P$28 (VCC5), U$1.P$37 (VCC5), U$19.26 (VCC5), U$19.44 (VCC5); also elsewhere on the board
B1: IC1.9 (A7), U$1.P$1 (RD4), U$19.1 (RD4)
B2: IC1.8 (A6), U$1.P$16 (!S4!), U$19.2 (!S4!)
B3: IC1.7 (A5), U$1.P$17 (A3), U$19.4 (A3)
B4: IC1.6 (A4), U$1.P$3 (A4), U$19.5 (A4)
B5: IC1.5 (A3), U$1.P$18 (A2), U$19.6 (A2)
B6: IC1.4 (A2), U$1.P$4 (A5), U$19.7 (A5)
B7: IC1.3 (A1), U$1.P$19 (A1), U$19.8 (A1)
B8: IC1.2 (A0), U$1.P$5 (A6), U$19.9 (A6)
B9: IC2.9 (A7), U$1.P$20 (A0), U$19.10 (A0)
B10: IC2.8 (A6), U$1.P$6 (A7), U$19.11 (A7)
B11: IC2.7 (A5), U$1.P$21 (D4), U$19.12 (D4)
B12: IC2.6 (A4), U$1.P$7 (A8), U$19.13 (A8)
B13: IC2.5 (A3), U$1.P$22 (D5), U$19.14 (D5)
B14: IC2.4 (A2), U$1.P$8 (A9), U$19.15 (A9)
B15: IC2.3 (A1), U$1.P$23 (D2), U$19.16 (D2)
B16: IC2.2 (A0), U$1.P$9 (A12), U$19.17 (A12)
B17: IC3.9 (A7), U$1.P$24 (D1), U$19.18 (D1)
B18: IC3.8 (A6), U$1.P$10 (D3), U$19.19 (D3)
B19: IC3.7 (A5), U$1.P$25 (D0), U$19.20 (D0)
B20: IC3.6 (A4), U$1.P$11 (D7), U$19.21 (D7)
B21: IC3.5 (A3), U$1.P$26 (D6), U$19.22 (D6)
B22: IC3.4 (A2), U$1.P$12 (A11), U$19.23 (A11)
B23: IC3.3 (A1), U$1.P$27 (!S5!), U$19.24 (!S5!)
B24: IC3.2 (A0), U$1.P$13 (A10), U$19.25 (A10)
B25: IC4.9 (A7), U$1.P$14 (R/!W!), U$19.27 (R/!W!)
B26: IC4.8 (A6), U$1.P$29 (RD5), U$19.28 (RD5)
B27: IC4.7 (A5), U$1.P$15 (B02), U$19.29 (B02)
B28: IC4.6 (A4), U$1.P$30 (!CCTL!), U$19.30 (!CCTL!)
B29: IC4.5 (A3), U$1.P$31 (!EXSEL!), U$19.32 (!EXSEL!)
B30: IC4.4 (A2), U$1.P$39 (!IRQ!), U$19.33 (!IRQ!)
B31: IC4.3 (A1), U$1.P$32 (!RST!), U$19.34 (!RST!)
B32: IC4.2 (A0), U$1.P$40 (!HALT!), U$19.35 (!HALT!)
B33: IC5.7 (A5), U$1.P$33 (!D1XX!), U$19.36 (!D1XX!)
B34: IC5.6 (A4), U$1.P$41 (A13), U$19.37 (A13)
B35: IC5.5 (A3), U$1.P$34 (!MPD!), U$19.38 (!MPD!)
B36: IC5.4 (A2), U$1.P$42 (A14), U$19.39 (A14)
B37: IC5.3 (A1), U$1.P$43 (A15), U$19.41 (A15)
B38: IC5.2 (A0), U$1.P$36 (!REF!), U$19.42 (!REF!)
GND: C1.2, C2.2, C3.2, C4.2, C5.2, GPIO.1, IC1.10 (GND), IC1.19 (_OE), IC2.10 (GND), IC2.19 (_OE), IC3.10 (GND), IC3.19 (_OE), IC4.10 (GND), IC4.19 (_OE), IC5.10 (GND), IC5.19 (_OE), R29.2, R30.1, U$1.P$2 (GND), U$1.P$44 (GND), U$19.3 (GND), U$19.43 (GND); also elsewhere on the board
LNK_IN1: U$2.85 (X1D01); also elsewhere on the board
unnamed: MEM_SEL.2, R29.1, U$2.25 (X1D18)
unnamed: MEM_SEL.1, R30.2, U$2.26 (X1D19)
SDC_CD: U$2.84 (X1D00); also elsewhere on the board
UART_RX: GPIO.2, U$2.14 (X1D35); also elsewhere on the board
UART_TX: GPIO.3, U$2.12 (X1D34); also elsewhere on the board
VCCIO: GPIO.4, MEM_SEL.3, MEM_SEL.4; also elsewhere on the board
X_A0: IC2.11 (B7), U$2.111 (X1D26)
X_A1: IC1.17 (B1), U$2.112 (X1D27)
X_A2: IC1.15 (B3), U$2.113 (X1D28)
X_A3: IC1.13 (B5), U$2.114 (X1D29)
X_A4: IC1.14 (B4), U$2.115 (X1D30)
X_A5: IC1.16 (B2), U$2.116 (X1D31)
X_A6: IC1.18 (B0), U$2.117 (X1D32)
X_A7: IC2.12 (B6), U$2.118 (X1D33)
X_A8: IC2.14 (B4), U$2.15 (X1D36)
X_A9: IC2.16 (B2), U$2.18 (X1D37)
X_A10: IC3.18 (B0), U$2.20 (X1D38)
X_A11: IC3.16 (B2), U$2.21 (X1D39)
X_A12: IC2.18 (B0), U$2.105 (X1D40)
X_A13: IC5.14 (B4), U$2.106 (X1D41)
X_A14: IC5.16 (B2), U$2.107 (X1D42)
X_A15: IC5.17 (B1), U$2.108 (X1D43)
X_B02: IC4.13 (B5), U$2.120 (X1D10)
X_D0: IC3.13 (B5), U$2.71 (X1D02)
X_D1: IC3.11 (B7), U$2.73 (X1D03)
X_D2: IC2.17 (B1), U$2.74 (X1D04)
X_D3: IC3.12 (B6), U$2.75 (X1D05)
X_D4: IC2.13 (B5), U$2.76 (X1D06)
X_D5: IC2.15 (B3), U$2.78 (X1D07)
X_D6: IC3.15 (B3), U$2.81 (X1D08)
X_D7: IC3.14 (B4), U$2.83 (X1D09)
X_R/!W!: IC4.11 (B7), U$2.50 (X1D15)
X_RD4: IC1.11 (B7), U$2.45 (X1D13)
X_RD5: IC4.12 (B6), U$2.54 (X1D25)

Notes on the sheet:
A15
A14
A13
A12
A11
A10
!CTTL!
B02
RD5
RD4
!S5!
!S4!
!REF!
!D1XX!
!RST!
!MPD!
!EXSEL!
!HALT!
!IRQ!
R/!W!
Bus i/o
5V domain
3.3v domain
Use diode to get 4.3v from the 5v supply for QS
Used as UART during bringup

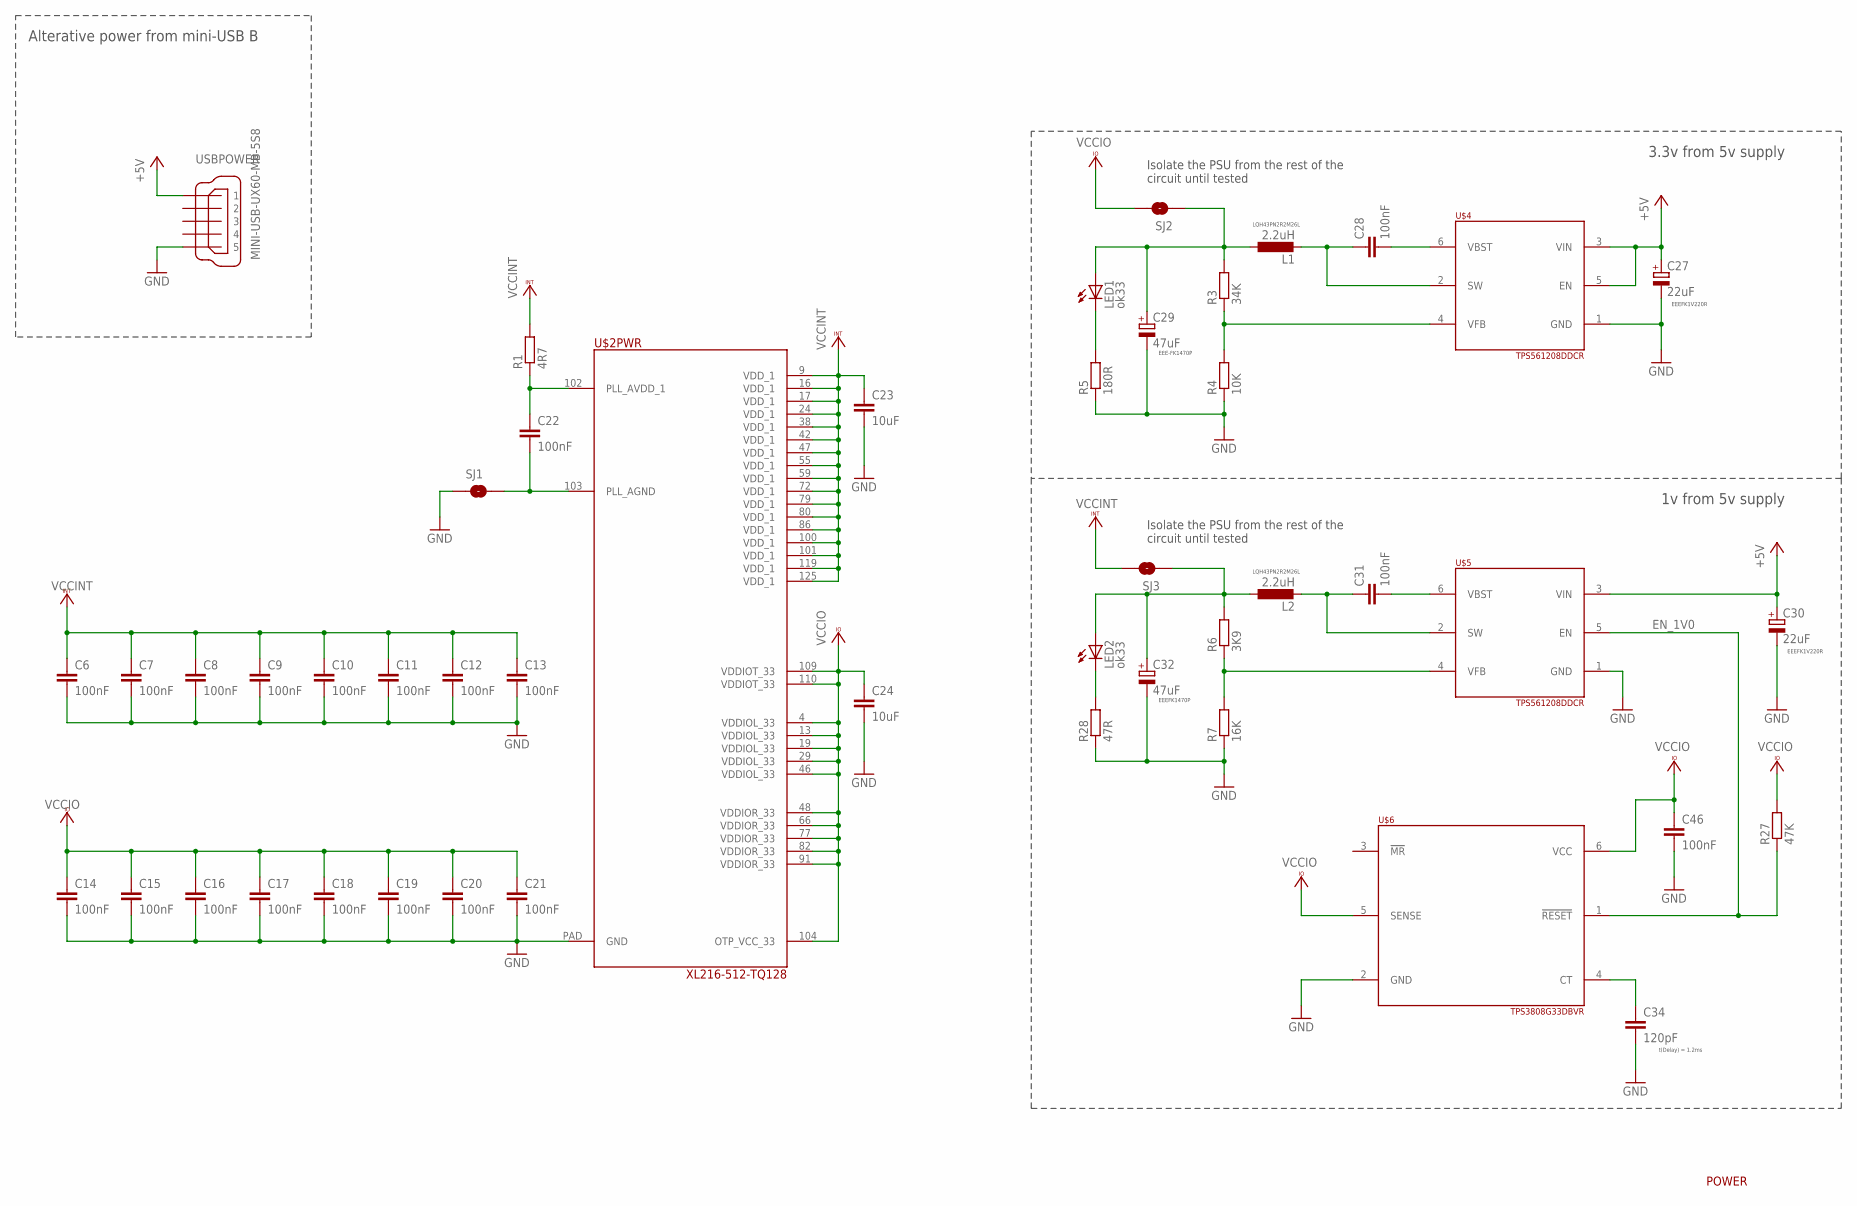
[picture p174: schematic xmosio2.sch, sheet 2, Power]

Parts:
C6, C7, C8, C9, C10, C11, C12, C13, C14, C15, C16, C17, C18, C19, C20, C21, C22, C28, C31, C46: 100nF; C1206
C23, C24: 10uF; C1206
C27, C30: 22uF; PANASONIC_C
C29, C32: 47uF; PANASONIC_D
C34: 120pF; C1206
L1, L2: 2.2uH; L1812
LED1, LED2: ok33; CHIP-LED0805
R1: 4R7; R1206
R3: 34K; R1206
R4: 10K; R1206
R5: 180R; R1206
R6: 3K9; R1206
R7: 16K; R1206
R27: 47K; R1206
R28: 47R; R1206
SJ1: SOLDERJUMPERNC; SJ_2S
SJ2, SJ3: SOLDERJUMPERNO; SJ_2S-NO
U$2: XL216-512-TQ128; TQFP128
U$4, U$5: TPS561208DDCR; TSOT23-6_DDC
U$6: TPS3808G33DBVR; SOT23-6
USBPOWER: MINI-USB-UX60-MB-5S8; UX60-MB-5S8

Connections:
+5V: C27.+, C30.+, U$4.3 (VIN), U$4.5 (EN), U$5.3 (VIN), USBPOWER.1; also elsewhere on the board
EN_1V0: R27.1, U$5.5 (EN), U$6.1 (!RESET!)
GND: C6.2, C7.2, C8.2, C9.2, C10.2, C11.2, C12.2, C13.2, C14.2, C15.2, C16.2, C17.2, C18.2, C19.2, C20.2, C21.2, C23.2, C24.2, C27.-, C29.-, C30.-, C32.-, C34.2, C46.2, R4.1, R5.1, R7.1, R28.1, SJ1.1, U$2.PAD (GND), U$4.1 (GND), U$5.1 (GND), U$6.2 (GND), USBPOWER.5; also elsewhere on the board
unnamed: C22.1, R1.1, U$2.102 (PLL_AVDD_1)
unnamed: C22.2, SJ1.2, U$2.103 (PLL_AGND)
unnamed: C28.2, U$4.6 (VBST)
unnamed: C28.1, L1.2, U$4.2 (SW)
unnamed: C31.2, U$5.6 (VBST)
unnamed: R3.1, R4.2, U$4.4 (VFB)
unnamed: LED1.C, R5.2
unnamed: C31.1, L2.2, U$5.2 (SW)
unnamed: R6.1, R7.2, U$5.4 (VFB)
unnamed: C34.1, U$6.4 (CT)
unnamed: C29.+, L1.1, LED1.A, R3.2, SJ2.1
unnamed: LED2.C, R28.2
unnamed: C32.+, L2.1, LED2.A, R6.2, SJ3.1
VCCINT: C6.1, C7.1, C8.1, C9.1, C10.1, C11.1, C12.1, C13.1, C23.1, R1.2, SJ3.2, U$2.9 (VDD_1), U$2.16 (VDD_1), U$2.17 (VDD_1), U$2.24 (VDD_1), U$2.38 (VDD_1), U$2.42 (VDD_1), U$2.47 (VDD_1), U$2.55 (VDD_1), U$2.59 (VDD_1), U$2.72 (VDD_1), U$2.79 (VDD_1), U$2.80 (VDD_1), U$2.86 (VDD_1), U$2.100 (VDD_1), U$2.101 (VDD_1), U$2.119 (VDD_1), U$2.125 (VDD_1); also elsewhere on the board
VCCIO: C14.1, C15.1, C16.1, C17.1, C18.1, C19.1, C20.1, C21.1, C24.1, C46.1, R27.2, SJ2.2, U$2.4 (VDDIOL_33), U$2.13 (VDDIOL_33), U$2.19 (VDDIOL_33), U$2.29 (VDDIOL_33), U$2.46 (VDDIOL_33), U$2.48 (VDDIOR_33), U$2.66 (VDDIOR_33), U$2.77 (VDDIOR_33), U$2.82 (VDDIOR_33), U$2.91 (VDDIOR_33), U$2.104 (OTP_VCC_33), U$2.109 (VDDIOT_33), U$2.110 (VDDIOT_33), U$6.5 (SENSE), U$6.6 (VCC); also elsewhere on the board

Notes on the sheet:
EEEFK1V220R
LQH43PN2R2M26L
EEE-FK1470P
3.3v from 5v supply
EEEFK1470P
1v from 5v supply
t(Delay) = 1.2ms
POWER
Alterative power from mini-USB B
Isolate the PSU from the rest of the circuit until tested

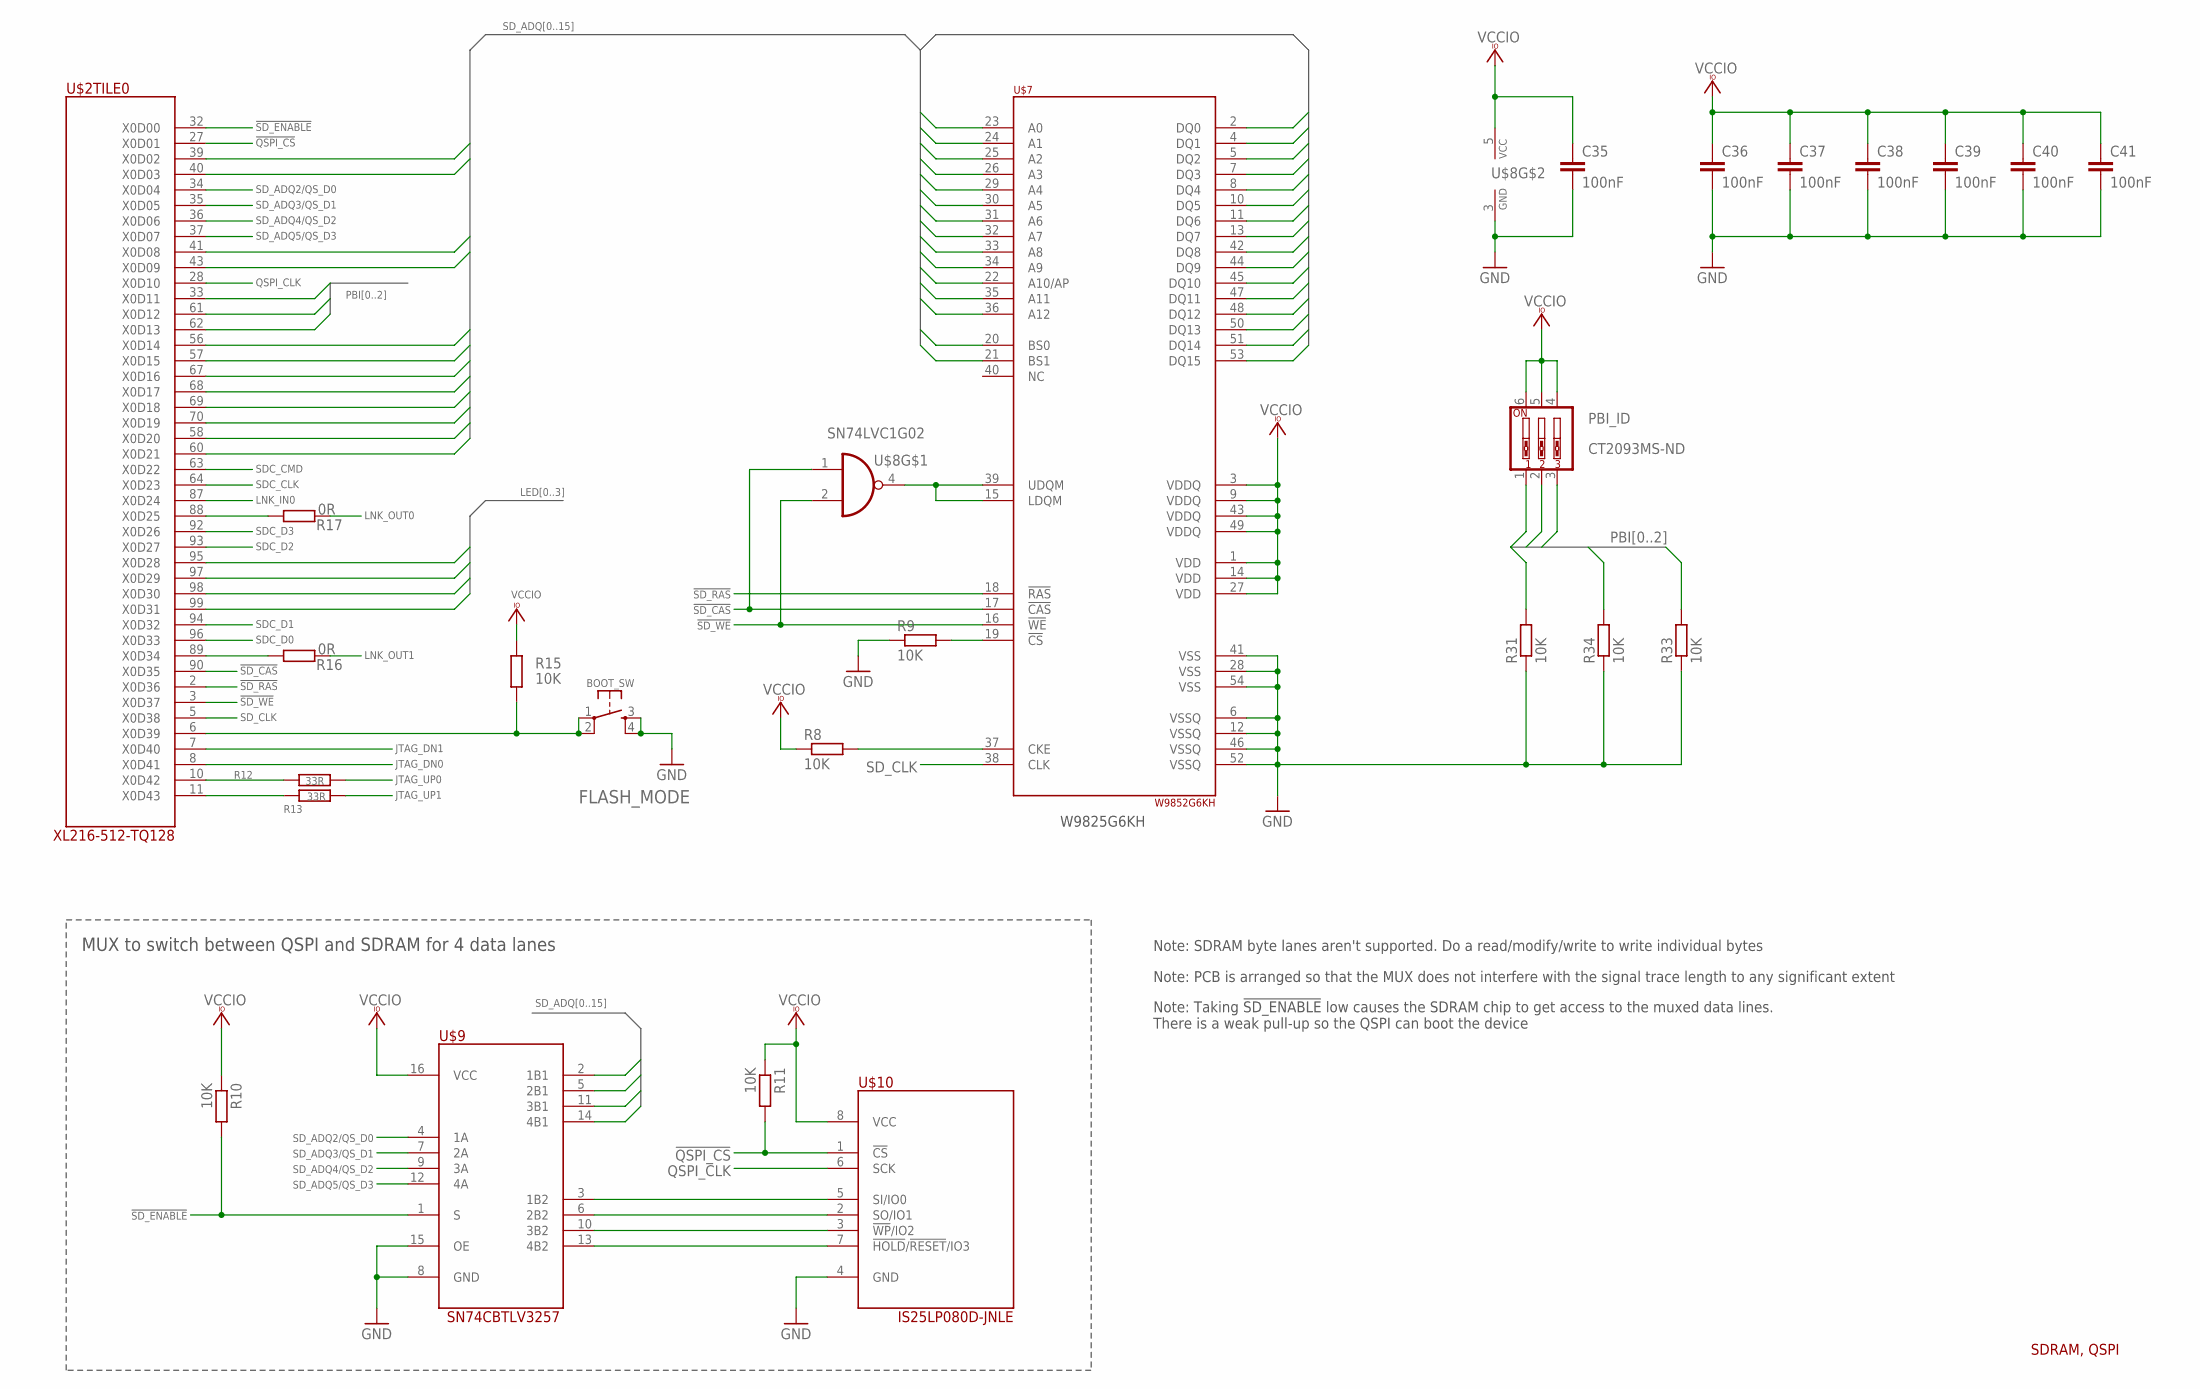
[picture p175: schematic xmosio2.sch, sheet 3, SDRAM / QSPI]

Parts:
BOOT_SW: FLASH_MODE; TACTILE-PTH
C35, C36, C37, C38, C39, C40, C41: 100nF; C1206
PBI_ID: CT2093MS-ND; EDG-03
R8, R9, R10, R11, R15, R31, R33, R34: 10K; R1206
R12, R13: 33R; R1206
R16, R17: 0R; R1206
U$2: XL216-512-TQ128; TQFP128
U$7: W9852G6KH; TSOP54-400
U$8: SN74LVC1G02; SOT23-5
U$9: SN74CBTLV3257; SO16
U$10: IS25LP080D-JNLE; SO-08

Connections:
!QSPI_CS!: R11.2, U$2.27 (X0D01), U$10.1 (!CS!)
!SD_CAS!: U$2.90 (X0D35), U$7.17 (!CAS!), U$8.1 (I0)
!SD_ENABLE!: R10.2, U$2.32 (X0D00), U$9.1 (S)
!SD_RAS!: U$2.2 (X0D36), U$7.18 (!RAS!)
!SD_WE!: U$2.3 (X0D37), U$7.16 (!WE!), U$8.2 (I1)
GND: BOOT_SW.3, BOOT_SW.4, C35.2, C36.2, C37.2, C38.2, C39.2, C40.2, C41.2, R9.1, R31.1, R33.1, R34.1, U$7.6 (VSSQ), U$7.12 (VSSQ), U$7.28 (VSS), U$7.41 (VSS), U$7.46 (VSSQ), U$7.52 (VSSQ), U$7.54 (VSS), U$8.3 (GND), U$9.8 (GND), U$9.15 (OE), U$10.4 (GND); also elsewhere on the board
JTAG_DN0: U$2.8 (X0D41); also elsewhere on the board
JTAG_DN1: U$2.7 (X0D40); also elsewhere on the board
JTAG_UP0: R12.2; also elsewhere on the board
JTAG_UP1: R13.2; also elsewhere on the board
LED0: U$2.95 (X0D28); also elsewhere on the board
LED1: U$2.97 (X0D29); also elsewhere on the board
LED2: U$2.98 (X0D30); also elsewhere on the board
LED3: U$2.99 (X0D31); also elsewhere on the board
LNK_IN0: U$2.87 (X0D24); also elsewhere on the board
LNK_OUT0: R17.2; also elsewhere on the board
LNK_OUT1: R16.2; also elsewhere on the board
unnamed: U$7.15 (LDQM), U$7.39 (UDQM), U$8.4 (O)
unnamed: R8.2, U$7.37 (CKE)
unnamed: U$9.3 (1B2), U$10.5 (SI/IO0)
unnamed: R9.2, U$7.19 (!CS!)
unnamed: U$9.6 (2B2), U$10.2 (SO/IO1)
unnamed: U$9.10 (3B2), U$10.3 (!WP!/IO2)
unnamed: U$9.13 (4B2), U$10.7 (!HOLD!/!RESET!/IO3)
unnamed: R12.1, U$2.10 (X0D42)
unnamed: R13.1, U$2.11 (X0D43)
unnamed: R17.1, U$2.88 (X0D25)
unnamed: R16.1, U$2.89 (X0D34)
unnamed: BOOT_SW.1, BOOT_SW.2, R15.1, U$2.6 (X0D39)
PBI0: PBI_ID.1, R31.2, U$2.33 (X0D11)
PBI1: PBI_ID.2, R34.2, U$2.61 (X0D12)
PBI2: PBI_ID.3, R33.2, U$2.62 (X0D13)
QSPI_CLK: U$2.28 (X0D10), U$10.6 (SCK)
SDC_CLK: U$2.64 (X0D23); also elsewhere on the board
SDC_CMD: U$2.63 (X0D22); also elsewhere on the board
SDC_D0: U$2.96 (X0D33); also elsewhere on the board
SDC_D1: U$2.94 (X0D32); also elsewhere on the board
SDC_D2: U$2.93 (X0D27); also elsewhere on the board
SDC_D3: U$2.92 (X0D26); also elsewhere on the board
SD_ADQ0: U$2.39 (X0D02), U$7.2 (DQ0), U$7.23 (A0)
SD_ADQ1: U$2.40 (X0D03), U$7.4 (DQ1), U$7.24 (A1)
SD_ADQ2: U$7.5 (DQ2), U$7.25 (A2), U$9.2 (1B1)
SD_ADQ2/QS_D0: U$2.34 (X0D04), U$9.4 (1A)
SD_ADQ3: U$7.7 (DQ3), U$7.26 (A3), U$9.5 (2B1)
SD_ADQ3/QS_D1: U$2.35 (X0D05), U$9.7 (2A)
SD_ADQ4: U$7.8 (DQ4), U$7.29 (A4), U$9.11 (3B1)
SD_ADQ4/QS_D2: U$2.36 (X0D06), U$9.9 (3A)
SD_ADQ5: U$7.10 (DQ5), U$7.30 (A5), U$9.14 (4B1)
SD_ADQ5/QS_D3: U$2.37 (X0D07), U$9.12 (4A)
SD_ADQ6: U$2.41 (X0D08), U$7.11 (DQ6), U$7.31 (A6)
SD_ADQ7: U$2.43 (X0D09), U$7.13 (DQ7), U$7.32 (A7)
SD_ADQ8: U$2.56 (X0D14), U$7.33 (A8), U$7.42 (DQ8)
SD_ADQ9: U$2.57 (X0D15), U$7.34 (A9), U$7.44 (DQ9)
SD_ADQ10: U$2.67 (X0D16), U$7.22 (A10/AP), U$7.45 (DQ10)
SD_ADQ11: U$2.68 (X0D17), U$7.35 (A11), U$7.47 (DQ11)
SD_ADQ12: U$2.69 (X0D18), U$7.36 (A12), U$7.48 (DQ12)
SD_ADQ13: U$2.70 (X0D19), U$7.20 (BS0), U$7.50 (DQ13)
SD_ADQ14: U$2.58 (X0D20), U$7.21 (BS1), U$7.51 (DQ14)
SD_ADQ15: U$2.60 (X0D21), U$7.53 (DQ15)
SD_CLK: U$2.5 (X0D38), U$7.38 (CLK)
VCCIO: C35.1, C36.1, C37.1, C38.1, C39.1, C40.1, C41.1, PBI_ID.4, PBI_ID.5, PBI_ID.6, R8.1, R10.1, R11.1, R15.2, U$7.1 (VDD), U$7.3 (VDDQ), U$7.9 (VDDQ), U$7.14 (VDD), U$7.27 (VDD), U$7.43 (VDDQ), U$7.49 (VDDQ), U$8.5 (VCC), U$9.16 (VCC), U$10.8 (VCC); also elsewhere on the board

Notes on the sheet:
Note: Taking !SD_ENABLE! low causes the SDRAM chip to get access to the muxed data lines. There is a weak pull-up so the QSPI can boot the device
SDRAM, QSPI
MUX to switch between QSPI and SDRAM for 4 data lanes
Note: PCB is arranged so that the MUX does not interfere with the signal trace length to any significant extent
Note: SDRAM byte lanes aren't supported. Do a read/modify/write to write individual bytes
W9825G6KH

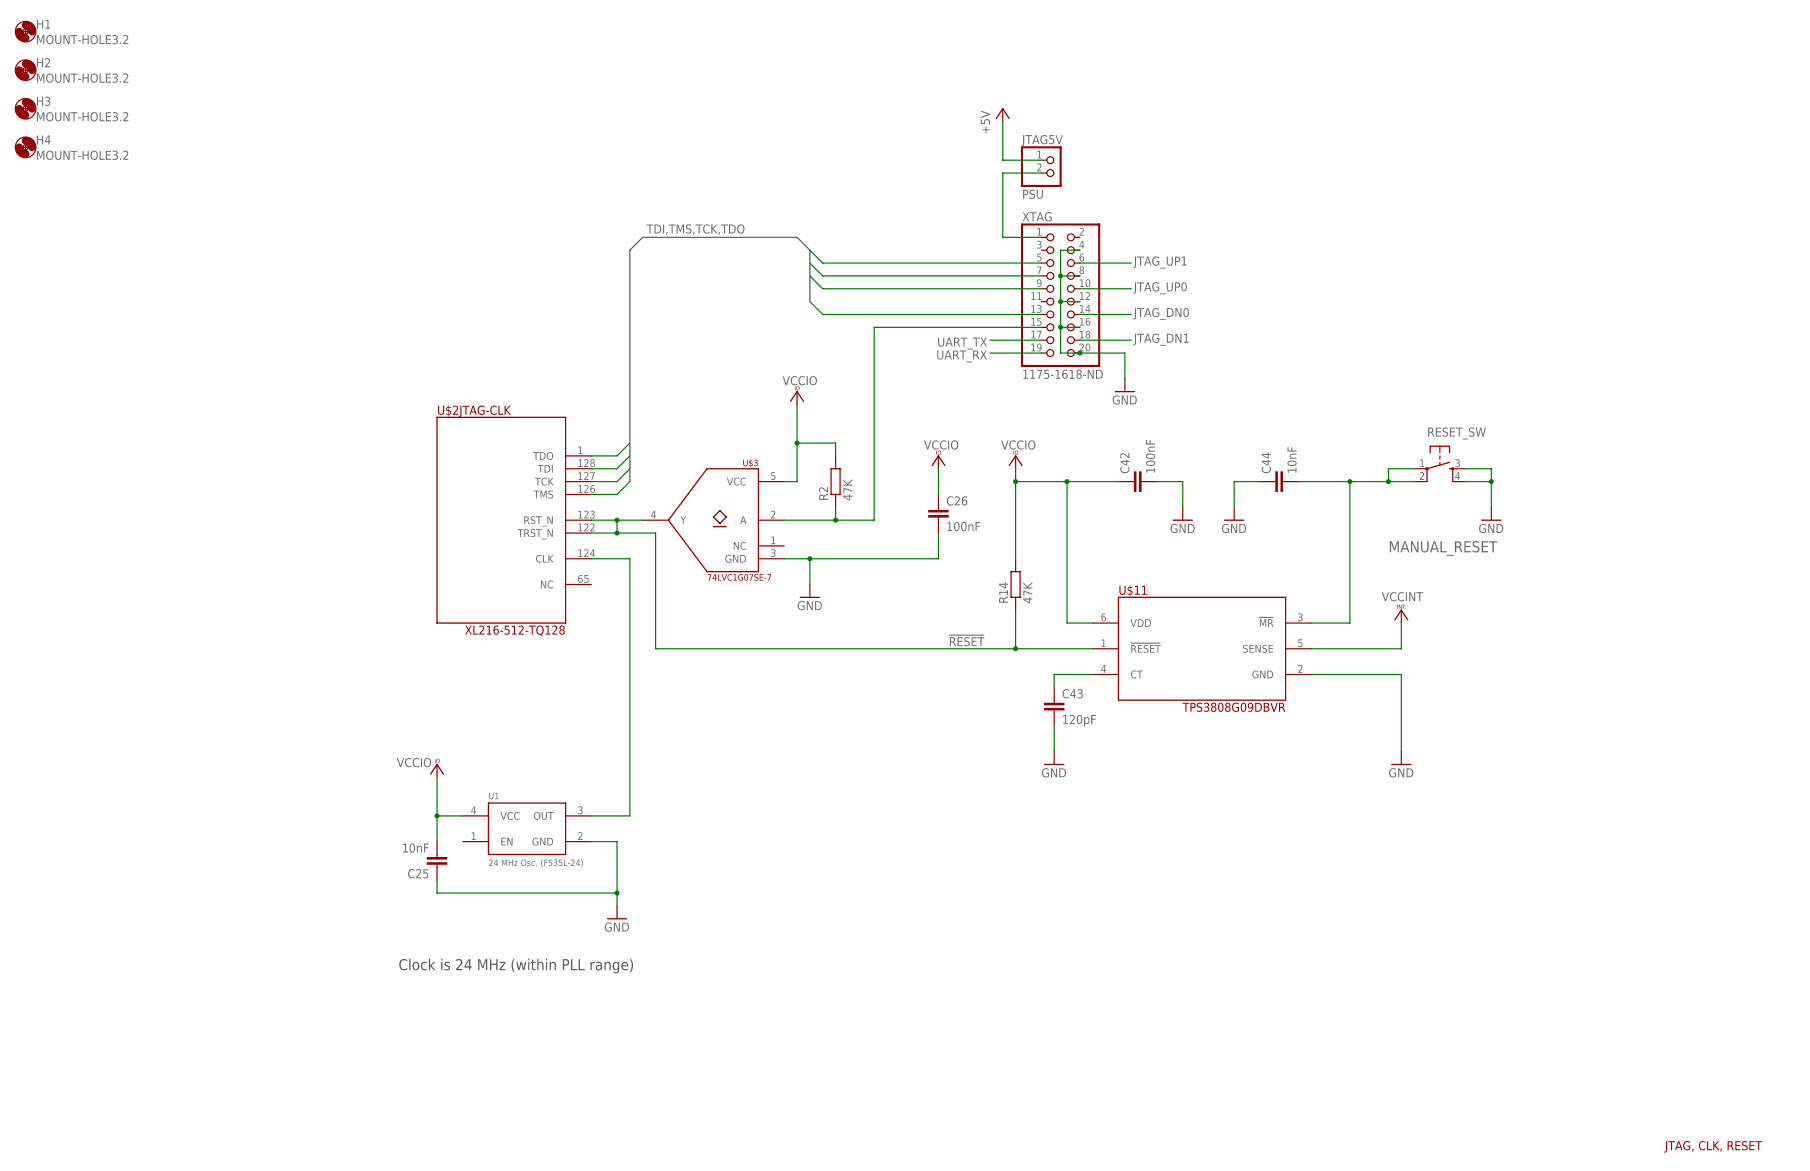
[picture p176: schematic xmosio2.sch, sheet 4, Clock/JTAG]

Parts:
C25, C44: 10nF; C1206
C26, C42: 100nF; C1206
C43: 120pF; C1206
H1, H2, H3, H4: MOUNT-HOLE3.2; 3,2
JTAG5V: PSU; 1X02
R2, R14: 47K; R1206
RESET_SW: MANUAL_RESET; TACTILE-PTH
U1: 24 MHz Osc. (F535L-24); CRYSTAL-OSC-SMD-5X3
U$2: XL216-512-TQ128; TQFP128
U$3: 74LVC1G07SE-7; SOT23-5
U$11: TPS3808G09DBVR; SOT23-6
XTAG: 1175-1618-ND; 2X10/90

Connections:
!RESET!: R14.1, U$2.122 (TRST_N), U$2.123 (RST_N), U$3.4 (Y), U$11.1 (!RESET!)
+5V: JTAG5V.1; also elsewhere on the board
GND: C25.1, C26.2, C42.2, C43.2, C44.1, RESET_SW.3, RESET_SW.4, U1.2 (GND), U$3.3 (GND), U$11.2 (GND), XTAG.4, XTAG.8, XTAG.12, XTAG.16, XTAG.20; also elsewhere on the board
JTAG_DN0: XTAG.14; also elsewhere on the board
JTAG_DN1: XTAG.18; also elsewhere on the board
JTAG_UP0: XTAG.10; also elsewhere on the board
JTAG_UP1: XTAG.6; also elsewhere on the board
unnamed: U1.3 (OUT), U$2.124 (CLK)
unnamed: R2.1, U$3.2 (A), XTAG.15
unnamed: C43.1, U$11.4 (CT)
unnamed: JTAG5V.2, XTAG.1
TCK: U$2.127 (TCK), XTAG.9
TDI: U$2.128 (TDI), XTAG.5
TDO: U$2.1 (TDO), XTAG.13
TMS: U$2.126 (TMS), XTAG.7
TRST_N: C44.2, RESET_SW.1, RESET_SW.2, U$11.3 (!MR!)
UART_RX: XTAG.19; also elsewhere on the board
UART_TX: XTAG.17; also elsewhere on the board
VCCINT: U$11.5 (SENSE); also elsewhere on the board
VCCIO: C25.2, C26.1, C42.1, R2.2, R14.2, U1.4 (VCC), U$3.5 (VCC), U$11.6 (VDD); also elsewhere on the board

Notes on the sheet:
JTAG, CLK, RESET
Clock is 24 MHz (within PLL range)

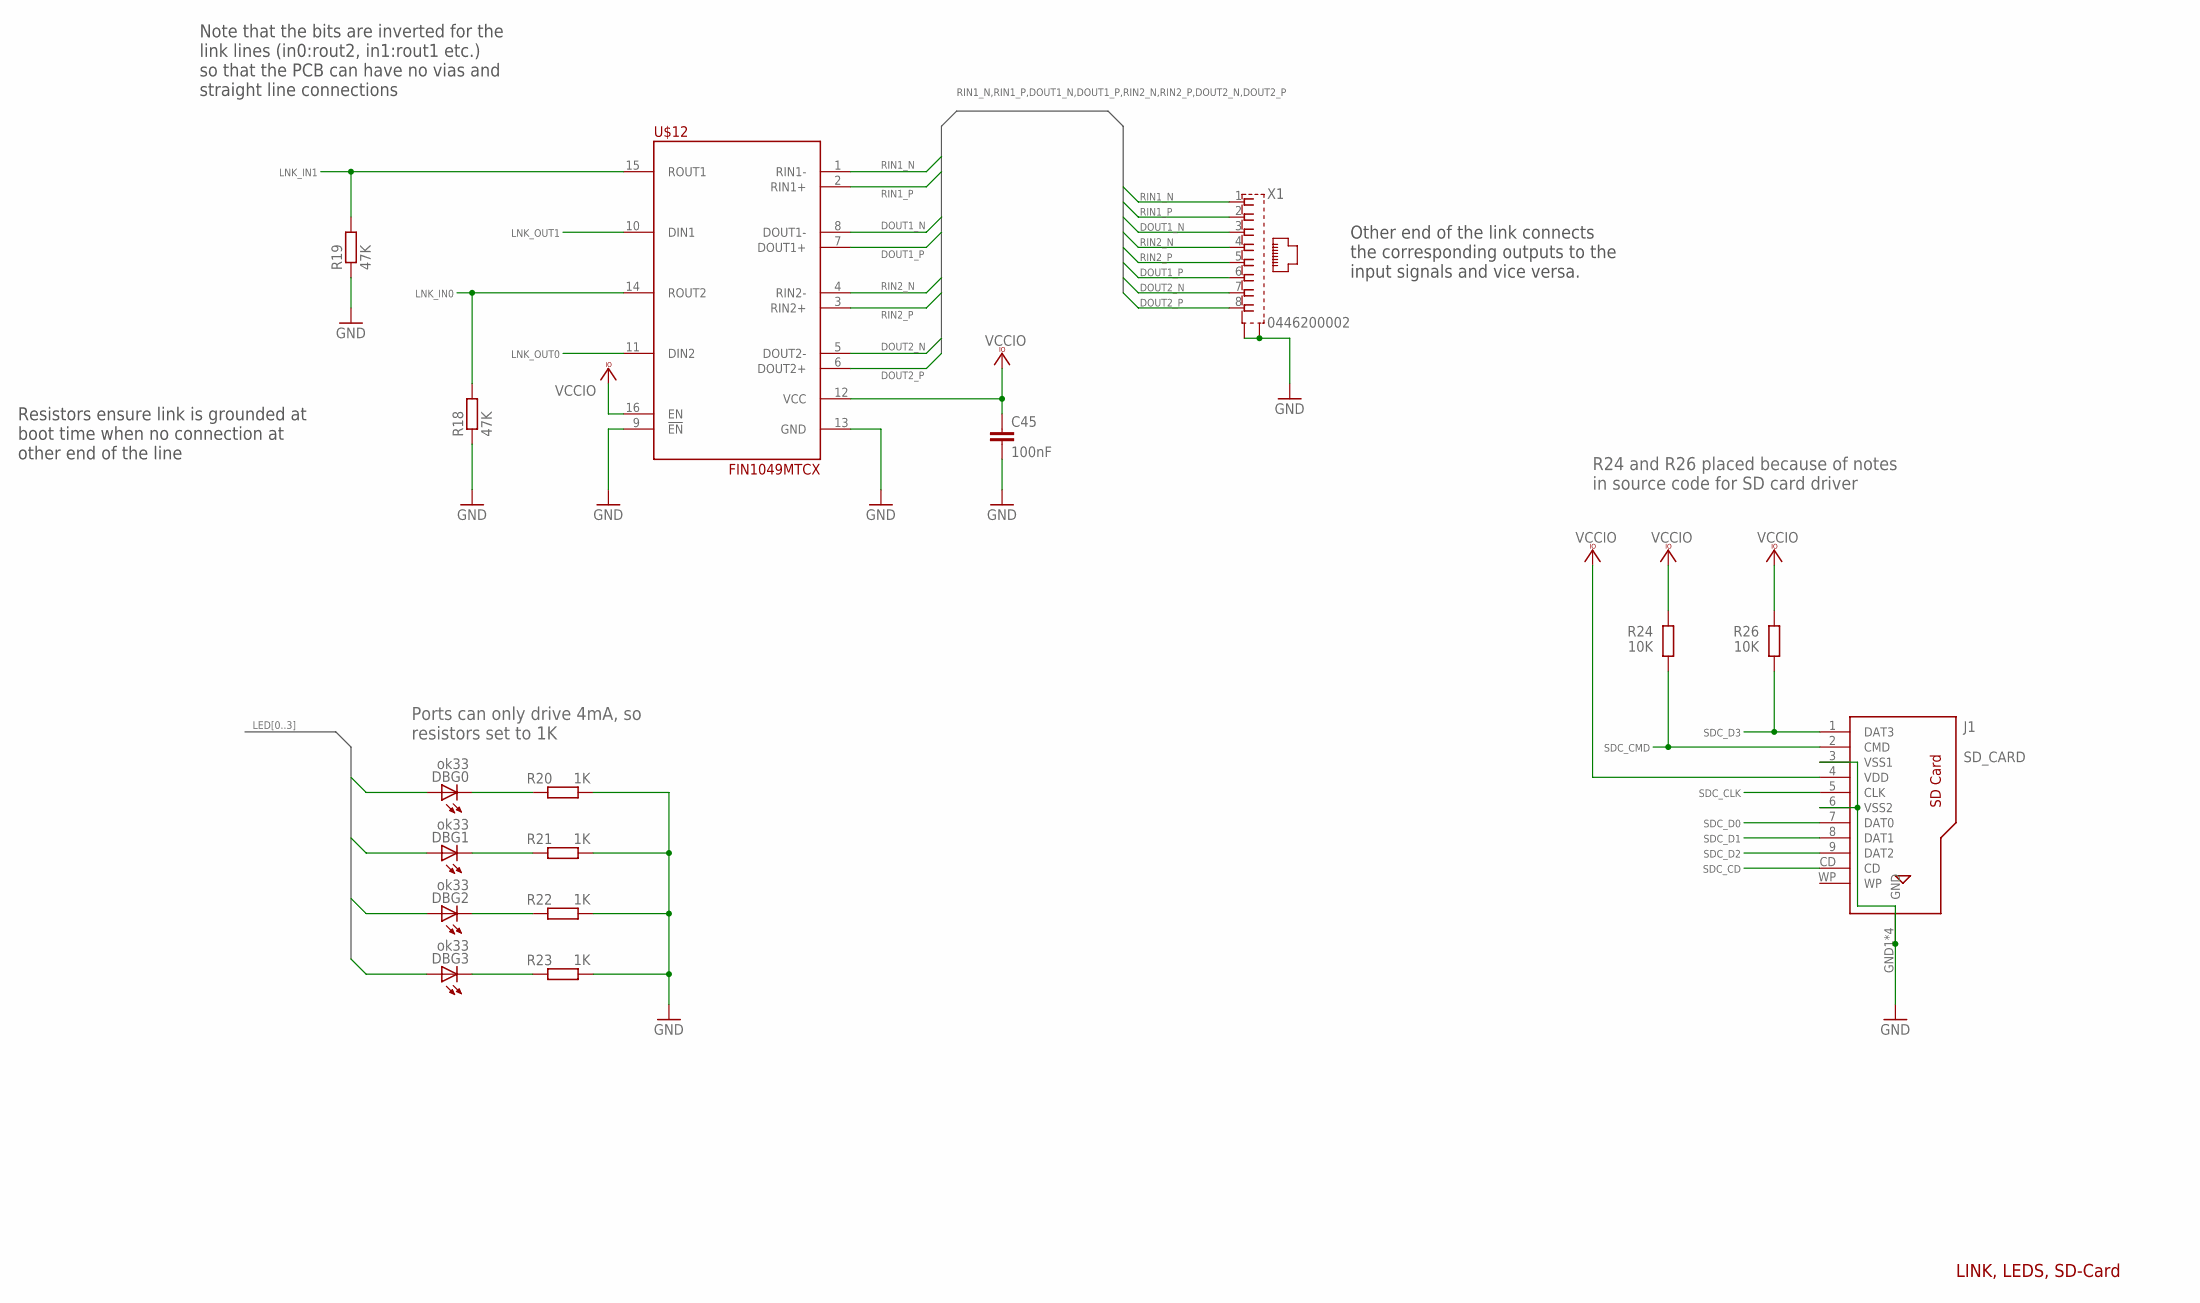
[picture p177: schematic xmosio2.sch, sheet 5, HS Link]

Parts:
C45: 100nF; C1206
DBG0, DBG1, DBG2, DBG3: ok33; CHIP-LED0805
J1: SD_CARD; 693063020911
R18, R19: 47K; R1206
R20, R21, R22, R23: 1K; R1206
R24, R26: 10K; R1206
U$12: FIN1049MTCX; TSSOP16
X1: 0446200002

Connections:
DOUT1_N: U$12.8 (DOUT1-), X1.3
DOUT1_P: U$12.7 (DOUT1+), X1.6
DOUT2_N: U$12.5 (DOUT2-), X1.7
DOUT2_P: U$12.6 (DOUT2+), X1.8
GND: C45.2, J1.3 (VSS1), J1.6 (VSS2), J1.GND1 (GND), J1.GND2 (GND), J1.GND3 (GND), J1.GND4 (GND), R18.1, R19.1, R20.2, R21.2, R22.2, R23.2, U$12.9 (!EN!), U$12.13 (GND), X1.S@1 (S1), X1.S@2 (S2); also elsewhere on the board
LED0: DBG0.A; also elsewhere on the board
LED1: DBG1.A; also elsewhere on the board
LED2: DBG2.A; also elsewhere on the board
LED3: DBG3.A; also elsewhere on the board
LNK_IN0: R18.2, U$12.14 (ROUT2); also elsewhere on the board
LNK_IN1: R19.2, U$12.15 (ROUT1); also elsewhere on the board
LNK_OUT0: U$12.11 (DIN2); also elsewhere on the board
LNK_OUT1: U$12.10 (DIN1); also elsewhere on the board
unnamed: DBG3.C, R23.1
unnamed: DBG2.C, R22.1
unnamed: DBG1.C, R21.1
unnamed: DBG0.C, R20.1
RIN1_N: U$12.1 (RIN1-), X1.1
RIN1_P: U$12.2 (RIN1+), X1.2
RIN2_N: U$12.4 (RIN2-), X1.4
RIN2_P: U$12.3 (RIN2+), X1.5
SDC_CD: J1.CD; also elsewhere on the board
SDC_CLK: J1.5 (CLK); also elsewhere on the board
SDC_CMD: J1.2 (CMD), R24.1; also elsewhere on the board
SDC_D0: J1.7 (DAT0); also elsewhere on the board
SDC_D1: J1.8 (DAT1); also elsewhere on the board
SDC_D2: J1.9 (DAT2); also elsewhere on the board
SDC_D3: J1.1 (DAT3), R26.2; also elsewhere on the board
VCCIO: C45.1, J1.4 (VDD), R24.2, R26.1, U$12.12 (VCC), U$12.16 (EN); also elsewhere on the board

Notes on the sheet:
Resistors ensure link is grounded at boot time when no connection at other end of the line
Note that the bits are inverted for the link lines (in0:rout2, in1:rout1 etc.) so that the PCB can have no vias and straight line connections
Other end of the link connects the corresponding outputs to the input signals and vice versa.
LINK, LEDS, SD-Card
Ports can only drive 4mA, so resistors set to 1K
R24 and R26 placed because of notes in source code for SD card driver
