ThrudTheBarbarian/pbxl/boards/xe-interface/xmosio2.brd

## EAGLE design boards/xe-interface/xmosio2.brd (continued)

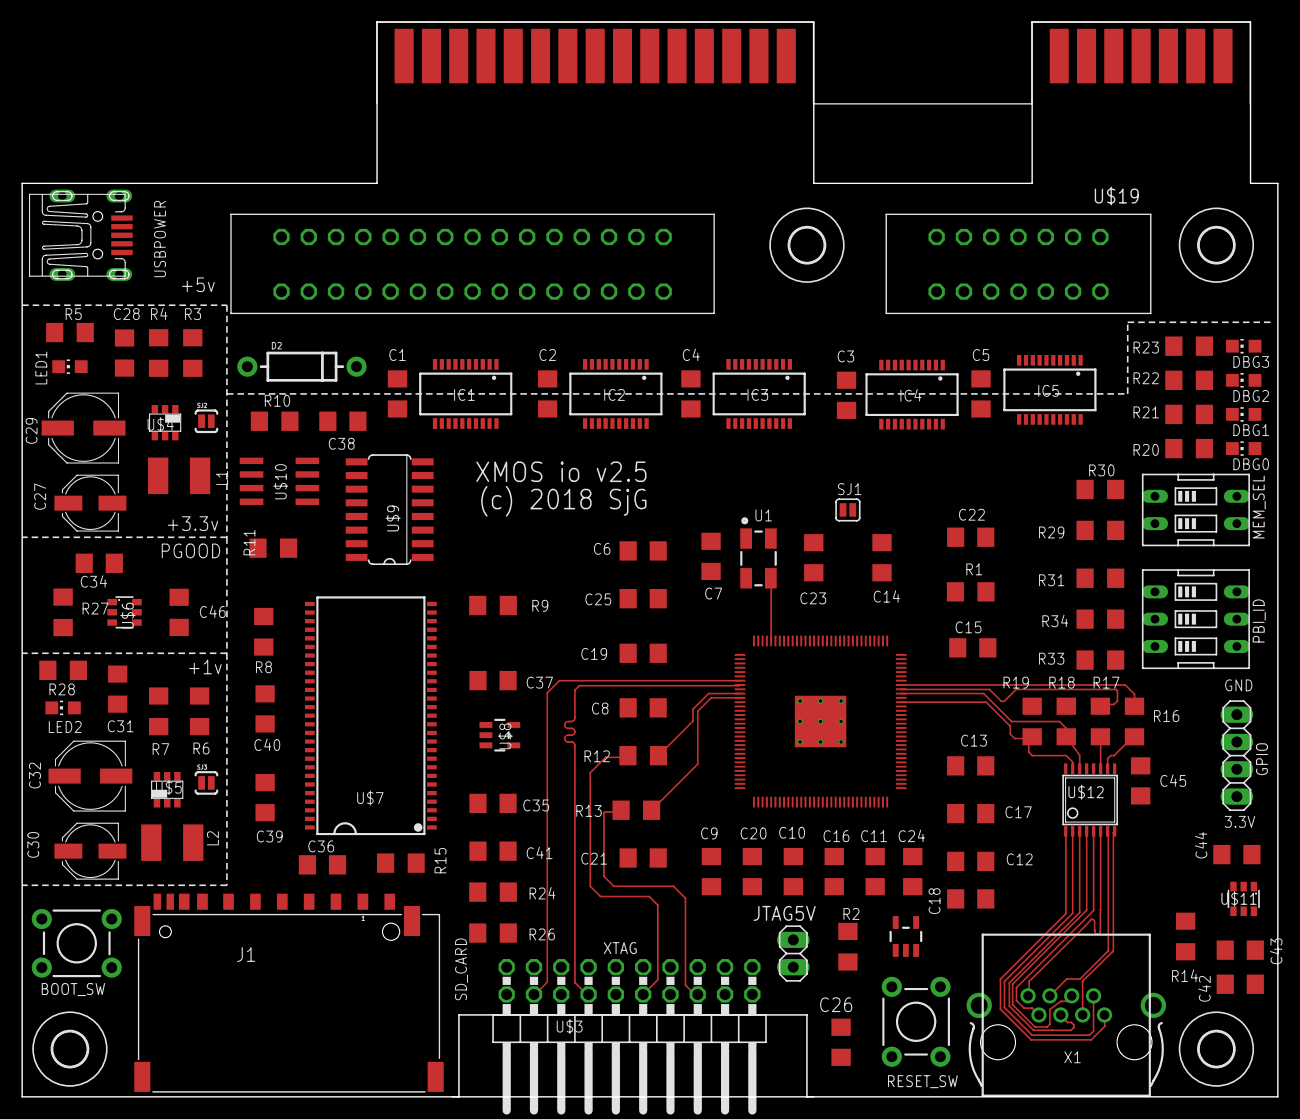
[picture p178: board xmosio2.brd from above]

Board: 4 copper layers, 116.8 x 100.0 mm, 122 parts (0 on the bottom side), 182 nets.
