ThrudTheBarbarian/pbxl/boards/xio6/stm/stm.ioc

Mcu.UserName=STM32MP157AAAx
PA1.Signal=ETH1_CLK
PA15.Signal=CEC
PA7.Signal=SPI6_MOSI
PA8.Signal=RCC_MCO_1
PA9.Signal=SPI2_SCK
PB14.Signal=SPI2_MISO
PB15.Signal=SPI2_MOSI
PB3.Signal=SPI1_SCK
PB4.Signal=SPI1_MISO
PC12.Signal=SPI3_MOSI
PC6.Signal=LTDC_HSYNC
PC7.Signal=LTDC_G6
PD10.Signal=SPI3_MISO
PD3.Signal=LTDC_G7
PE0.Signal=SPI3_SCK
PE12.Signal=SPI4_SCK
PE13.Signal=SPI4_MISO
PE14.Signal=SPI4_MOSI
PE15.Signal=LTDC_R7
PE5.Signal=LTDC_G0
PE6.Signal=LTDC_G1
PG5.Signal=ETH1_CLK125
PH10.Signal=LTDC_R4
PH11.Signal=I2C1_SCL
PH12.Signal=I2C1_SDA
PH13.Signal=LTDC_G2
PH14.Signal=LTDC_G3
PH4.Signal=LTDC_G4
PH8.Signal=LTDC_R2
PH9.Signal=LTDC_R3
PI0.Signal=LTDC_G5
PI13.Signal=LTDC_VSYNC
PI14.Signal=LTDC_CLK
PI15.Signal=LTDC_R0
PJ0.Signal=LTDC_R1
PJ12.Signal=LTDC_B0
PJ13.Signal=LTDC_B1
PJ14.Signal=LTDC_B2
PJ15.Signal=LTDC_B3
PJ4.Signal=LTDC_R5
PJ5.Signal=LTDC_R6
PK3.Signal=LTDC_B4
PK4.Signal=LTDC_B5
PK5.Signal=LTDC_B6
PK6.Signal=LTDC_B7
PK7.Signal=LTDC_DE
