ThrudTheBarbarian/pbxl/stm32/xe-exerciser/src/main.c

/**
  ******************************************************************************
  * @file    main.c
  * @author  Ac6
  * @version V1.0
  * @date    01-December-2013
  * @brief   Default main function.
  ******************************************************************************
*/


#include <sys_lib.h>
			

int main(void)
	{
	/*************************************************************************\
	|* Initialise the HAL
	\*************************************************************************/
	HAL_Init();

	/*************************************************************************\
	|* Initialise LEDs
	\*************************************************************************/
	//sysLedInit(SYS_LED_ALL);

	/*************************************************************************\
	|* Initialise the uart. USART3 is bound to the USB port's serial i/o
	\*************************************************************************/
	UartInit(3);
	printf("Testing printf()\n");

	for(;;)
		{
		char buf[1024];
		printf("command > ");
		while (fgets(buf, 80, stdin) == NULL)
			;
		printf("[%s]\n", buf);
		}
	}
