ThrudTheBarbarian/pbxl/stm32/xio/pbxl/Src/bsp_driver_sdram.c

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
  

#ifdef OLD_CODE
/* Kept to avoid issue when migrating old projects (as some user sections were renamed/changed). */
#else

/* Includes ------------------------------------------------------------------*/
#include "bsp_driver_sdram.h"

/* Extern variables ----------------------------------------------------------*/
extern SDRAM_HandleTypeDef hsdram2;

/* USER CODE BEGIN Init */
/**
  * @brief  Initializes the SDRAM device 
  * @retval SDRAM status
  */
uint8_t BSP_SDRAM_Init(void)
{
  uint8_t sdramstatus = SDRAM_OK;
  
  /* place for custom code */
  
  return sdramstatus;
}
/* USER CODE END Init */

/* USER CODE BEGIN BeforeReadSection */
/* can be used to modify / undefine following code or add code */
/* USER CODE END BeforeReadSection */

/**
  * @brief  Reads an mount of data from the SDRAM memory in polling mode. 
  * @param  uwStartAddress: Read start address
  * @param  pData: Pointer to data to be read
  * @param  uwDataSize: Size of read data from the memory
  * @retval SDRAM status : SDRAM_OK or SDRAM_ERROR.
  */
uint8_t BSP_SDRAM_ReadData(uint32_t uwStartAddress, uint32_t *pData, uint32_t uwDataSize)
{ 
  uint8_t sdramstatus = SDRAM_OK;
  
  if(HAL_SDRAM_Read_32b(&hsdram2, (uint32_t *)uwStartAddress, pData, uwDataSize) != HAL_OK)
  {
    sdramstatus = SDRAM_ERROR;
  }

  return sdramstatus;
}

/**
  * @brief  Reads an mount of data from the SDRAM memory in DMA mode.
  * @param  uwStartAddress: Read start address
  * @param  pData: Pointer to data to be read
  * @param  uwDataSize: Size of read data from the memory
  * @retval SDRAM status : SDRAM_OK or SDRAM_ERROR.
  */
uint8_t BSP_SDRAM_ReadData_DMA(uint32_t uwStartAddress, uint32_t *pData, uint32_t uwDataSize)
{ 
  uint8_t sdramstatus = SDRAM_OK;
  
  if(HAL_SDRAM_Read_DMA(&hsdram2, (uint32_t *)uwStartAddress, pData, uwDataSize) != HAL_OK)
  {
    sdramstatus = SDRAM_ERROR;
  }
   
  return sdramstatus;
}

/* USER CODE BEGIN BeforeWriteSection */
/* can be used to modify / undefine following code or add code */
/* USER CODE END BeforeWriteSection */

/**
  * @brief  Writes an mount of data to the SDRAM memory in polling mode.
  * @param  uwStartAddress: Write start address
  * @param  pData: Pointer to data to be written
  * @param  uwDataSize: Size of written data from the memory
  * @retval SDRAM status : SDRAM_OK or SDRAM_ERROR.
  */
uint8_t BSP_SDRAM_WriteData(uint32_t uwStartAddress, uint32_t *pData, uint32_t uwDataSize)
{ 
  uint8_t sdramstatus = SDRAM_OK;
  
  if(HAL_SDRAM_Write_32b(&hsdram2, (uint32_t *)uwStartAddress, pData, uwDataSize) != HAL_OK)
  {
    sdramstatus = SDRAM_ERROR;
  }

  return sdramstatus;
}

/**
  * @brief  Writes an mount of data to the SDRAM memory in DMA mode.
  * @param  uwStartAddress: Write start address
  * @param  pData: Pointer to data to be written
  * @param  uwDataSize: Size of written data from the memory
  * @retval SDRAM status : SDRAM_OK or SDRAM_ERROR.
  */
uint8_t BSP_SDRAM_WriteData_DMA(uint32_t uwStartAddress, uint32_t *pData, uint32_t uwDataSize)
{ 
  uint8_t sdramstatus = SDRAM_OK;
  
  if(HAL_SDRAM_Write_DMA(&hsdram2, (uint32_t *)uwStartAddress, pData, uwDataSize) != HAL_OK)
  {
    sdramstatus = SDRAM_ERROR;
  }

  return sdramstatus;
}

/**
  * @brief  Sends command to the SDRAM bank.
  * @param  SdramCmd: Pointer to SDRAM command structure
  * @retval SDRAM status : SDRAM_OK or SDRAM_ERROR.
  */
uint8_t BSP_SDRAM_Sendcmd(FMC_SDRAM_CommandTypeDef *SdramCmd)
{ 
  uint8_t sdramstatus = SDRAM_OK;
  
  if(HAL_SDRAM_SendCommand(&hsdram2, SdramCmd, SDRAM_TIMEOUT) != HAL_OK)
  {
    sdramstatus = SDRAM_ERROR;
  }

  return sdramstatus;
}

/* USER CODE BEGIN AdditionalCode */
/* user code can be inserted here */
/* USER CODE END AdditionalCode */

#endif

/************************ (C) COPYRIGHT STMicroelectronics *****END OF FILE****/
