ThrudTheBarbarian/pbxl/stm32/xe-exerciser/src/system/sys_lib.h

/*
 * sys_lib.h
 *
 *  Created on: 5 Mar 2018
 *      Author: simon
 */

#ifndef SYSTEM_SYS_LIB_H_
#define SYSTEM_SYS_LIB_H_

#include <stdint.h>
#include <stdbool.h>

#include "stm32f7xx.h"
#include "stm32f7xx_nucleo_144.h"

#include "sys_fifo.h"
#include "sys_uart.h"


#endif /* SYSTEM_SYS_LIB_H_ */
