ThrudTheBarbarian/pbxl/(commit log)

2018-02-12 Initial Eagle schematics and board layout
    [xmosio2.brd, xmosio2.sch]
2018-02-12 Images of the schematics for ease of browsing
2018-02-12 Added a PDF of the rev-0 schematic. This will be overwritten as changes are made, so it’s up to date with the current version of the schematic
2018-02-12 Latest PDF version of the schematic
2018-02-12 Latest revision. Fixes: - Rename the power line from 4.1 to 4.3v - Make +5v be the only one with a specified width to aid in routing. The PCB traces are sufficiently wide, given they’re in air, and t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
    [xmosio2.brd, xmosio2.sch]
2018-02-12 Update the PDF because I forgot to hide pins before creating the file…
2018-02-12 [sigh] … and also remember to include all the pages…
2018-02-12 Tidy up the board labelling
    [xmosio2.brd, xmosio2.sch]
2018-02-12 Approve the via DRC violations - these are in-pad vias. They’re supposed to trigger a violation
    [xmosio2.brd]
2018-02-12 Image of the routed board
2018-02-12 BRD file that has only the manually-routed traces actually routed out. Makes it easier to revert back when an autoroute followed by save has gone awry.
    [xmosio2-manualroutes.brd]
2018-02-12 Trying to get the board to route with Seeed’s cheaper options. It routes fine at OSH-park, but they’re a bit more expensive…
    [xmosio2.brd]
2018-02-12 - Add in zero-ohm resistor placeholders in case the drivers need 33R (like the JTAG interface does) - Better length matching, now sub-millimeter on all concerned traces - Move the boot-the-fallback-f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
    [xmosio2.brd, xmosio2.sch]
2018-02-12 Latest fully-routed board
    [xmosio2_routed.brd]
2018-02-12 - Add some keepouts for easier soldering - Change the 0805 capacitors to be 0603
    [xmosio2.brd, xmosio2.sch]
2018-02-12 Add the probe interface
    [xmosio3.brd, xmosio3.sch]
2018-02-12 Add the control interface
    [xmos1.sch]
2018-02-12 Update the board now we know we can program the nucleo board
2018-02-12 Updates to the website
    [xmosio2_unrouted.brd]
2018-02-12 Schematic of the exerciser board
2018-02-12 Library for NUCLEO-144 and the ECI/CART slot
2018-02-12 Exerciser board
    [xmos1.brd]
2018-02-12 Add the two spare ports to the top. Just needs power now
    [xmos1.brd, xmos1.sch]
2018-02-12 Add a voltage-regulator option for external power, and clean up the board a bit
    [xmos1.brd, xmos1.sch]
2018-02-12 While I’m consolidating, make the exerciser board name match the rest of the boards
    [xmosio1.brd, xmosio1.sch]
2018-02-12 … and in a fit of efficiency, put things into their own directories…
    [xmosio1.brd, xmosio1.sch, xmosio2-manualroutes.brd, xmosio2.brd, xmosio2.sch, xmosio2_routed.brd, xmosio2_unrouted.brd, xmosio3.brd]
2018-02-12 Add the enclosure page and references
2018-02-12 Fixed some typos, added some more commentary on the enclosure
2018-02-22 Missed a file…
2018-02-22 BOM for the exerciser
2018-02-22 BOM and assembly CSV for the interface
    [assembly.csv]
2018-02-22 Fix the voltage supervisor circuit, so we can bring up the 1v rail
    [xmosio2.brd, xmosio2.sch]
2018-02-23 Move to a SeeedStudio style layout (far cheaper, and we can get assembly as part of the package). We still require the 5/5 spacing though.
    [xmosio2.brd, xmosio2.sch]
2018-02-23 Save the currently-unrouted-apart-from-high-speed-traces board in case something goes wrong
    [xmosio2_unrouted.brd]
2018-02-23 Latest fixes and additions - screw holes - cartridge slot - PBI device selection DIP switch - Memory interface style DIP switch
    [xmosio2.brd, xmosio2.sch]
2018-02-25 Change website theme because the old one wasn’t really working well.
2018-02-25 Latest board (routed and unrolled)
    [xmosio2.sch, xmosio2_routed.brd, xmosio2_unrouted2.brd]
2018-02-25 Latest design changes - Move the XTAG connector back significantly, so the shroud is not overhanging the board - Use the SD card slot, not the micro-SD card, it’s easier to solder - Fix the SD card p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
    [xmosio2.brd, xmosio2.sch, xmosio2_routed.brd, xmosio2_unrouted.brd]
2018-02-26 Use the correct pinouts for the ECI/cartridge port harness
    [xmosio1.brd, xmosio1.sch]
2018-02-26 Add a new progress post
    [xmosio2.brd, xmosio2_routed.brd]
2018-02-27 Information on dynamic link configuration within the XMOS environment. Useful for when there is/isn’t an expansion box plugged in
2018-03-01 - Fix the SD card so that the pins actually connect, even though they seem to be fine in the schematic - Move some of the decoupling capacitors closer to the XMOS chip - Provide JTAG +5V connection t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
    [xmosio2.brd, xmosio2.sch]
2018-03-01 Fix or approve all the ERC warnings in the schematic. Fix all the DRC warnings
    [xmosio2.brd, xmosio2.sch]
2018-03-01 Update the website to account for the board changes
2018-03-01 Add the new board image into the code-control
2018-03-01 Update the routed and unrouted board files, delete an unwanted routed-board file
    [xmosio2.brd, xmosio2_routed.brd, xmosio2_unrouted.brd, xmosio2_unrouted2.brd]
2018-03-02 Create a test-app for the STM32 Nucleo-144 board. We’re going to use one of these boards to exercise the XE interface board, so we can control the environment within which we’re debugging the Xmos in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
    The app included is just a simple led-blinker, but it proves the OpenSTM32 distribution is a useable resource for getting going. To replicate:
    - download and install OpenSTM32 from http://www.openstm32.org/
    - point your workspace at ‘stm32’ in this git distrubution
    - build the app.
    [test Debug.cfg]
2018-03-02 Add the hardware overview for the Nucleo 144 board that we’re using
2018-03-03 Use a 4N4001 diode (even though it’s through-hole) because the forward voltage drop of the original one was only 0.2v, and we actually want to use the diode to drop the voltage by 0.7v.
    [xmosio2.brd, xmosio2.sch]
2018-03-03 Information on the STM32F7 LCDT controller - seems like coupling this with an ADV7123 could produce a VGA display with relatively little CPU overhead, then we just need to monitor the bus for info to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
2018-03-05 Assembly CSV and BOM
    [assembly.csv]
2018-03-05 Latest board files. Submitted board is xmosio2_routed.brd
    [xmosio2.brd, xmosio2_routed.brd, xmosio2_unrouted.brd]
2018-03-05 Editable spreadsheet for BOM assembly
2018-03-05 Gerber files as submitted
    [xmosio2.GBL, xmosio2.GBO, xmosio2.GBP, xmosio2.GBS, xmosio2.GTL, xmosio2.GTO, xmosio2.GTP, xmosio2.GTS]
2018-03-05 Create the exerciser program. This doesn’t compile as yet
    [led-blink Debug.cfg]
2018-03-05 Remove the old ‘sys’ library. The current state is sufficiently different that porting it isn’t any easier than starting over.
2018-03-05 Implement an interrupt-driven fifo-based UART on USART3, which is the one connected on the Nucleo board
    [xe-exerciser Debug.cfg]
2018-03-05 Interface the UART with printf()
2018-03-07 Replace with the new…
2018-03-15 We don’t need the merging code any more, now we can sample all the channels from the bus directly. Replace with a dump of the VCD data files
2018-03-20 “Oops” blog page
2018-03-21 Website “Card Cage” post
2018-03-22 Make some fixes to the back-panel to make the PCIe blanks fit, and move one of the screw-holes slightly up.
2018-03-22 Update the ‘No! Stop’ progress page
2018-03-26 “Home straight” progress update
2018-03-27 Update the BOM
2018-03-27 Update for the “Economies of Scale” progress post
2018-03-29 Update for ‘black is the new black’ post
2018-04-16 Latest website update - board issues with seeed.
2018-04-21 Update for the ‘all-aboard’ post
2018-04-29 Add some XC code for the XMOS chip. Currently: - Xmos is active and available - Powering via the XE bus seems viable - LEDs are active - Flash is active and available
2018-04-30 Change the resistor value in the 1v power supply to 3.9k from 5.1k, which provides a better 1v supply.
    [xmosio2.brd, xmosio2.sch]
2018-05-09 “Thanks for the memory” update
2018-05-14 Start on the new XIO board for the parallel-based interface
    [xio.brd, xio.sch]
2018-05-14 Lump in the reference design so I’m not constantly finding it…
2018-05-15 Progress checkpoint
    [xio.brd, xio.sch]
2018-05-16 Start the parallel i/o board
    [pio.brd, pio.sch]
2018-05-19 Version of PIO to send off for manufacture
    [pio.brd, pio.sch]
2018-05-19 Ok, belay that last. *This* is the one to go to the fab.
    [pio.brd, pio.sch]
2018-05-20 Eclipse being eclipse…
2018-05-21 Quick example of how to offset-bias the audio signal
    [example.sch]
2018-05-21 Start to realise that this board is going to be big…
    [xio.brd, xio.sch]
2018-05-22 Board checkpoint
    [xio.brd, xio.sch]
2018-05-22 Route power to the slots
    [xio.brd, xio.sch]
2018-05-23 Start to route the expansion bus
    [xio.brd, xio.sch]
2018-05-23 Add in the architecture selector
    [xio.brd, xio.sch]
2018-05-23 Change DRU and play with BGA routing (no success as yet)
    [xio.brd]
2018-05-23 Start on the XMOS SDRAM
    [xio.brd, xio.sch]
2018-05-24 Start to add VHDCI interfaces (drivers to PIO board and voltage conversion to 3.3v)
    [xio.brd, xio.sch]
2018-05-24 Add in the voltage-level translation between 5v and 3.3v for the XMOS VHDCI bus
    [xio.brd, xio.sch]
2018-05-27 Add in the STM32 components
    [xio.brd, xio.sch]
2018-05-27 Small fix to make sure both branches of the ‘if’ statement wait for the clock to be high
2018-05-28 Make some changes to try and get the XMOS to handle access to page-6 correctly. Really need to set up a logic analyses…
2018-05-29 Start on STM32 power
    [xio.brd, xio.sch]
2018-05-30 Add the USB:UART bridge docs
2018-05-30 - Implement I2C - Implement SPI - Implement debug leds - Start to implement dual UARTs
    [xio.brd, xio.sch]
2018-05-30 Move to a quad-uart interface, so update the docs
2018-05-30 Start to create the quad interface schematic
    [xio.brd, xio.sch]
2018-06-05 Some work on integrating the ADV9889B
    [xio.brd, xio.sch]
2018-06-05 Add the reference circuit for the ADV9889B
2018-06-06 Work on the I2C/power circuitry for the HDMI
    [xio.brd, xio.sch]
2018-06-06 Complete the digital video section
    [xio.brd, xio.sch]
2018-06-07 All change. Finally realised that I hadn’t designated any pins on the STM32 to handle the i/o from the XMOS… So, re-design:
    - Now we’re going to have the XMOS talk to the peripherals / STM directly.
    - They’ll do this over a shared SPI channel
    - They’ll each have an IRQ line, which they can raise to signify they need service
    - The XMOS will be master, and handle chip-select as required for the peripheral to respond
    - At boot, the XMOS will send out a message clocked at 1MHz, asking how fast the peripheral can go
    - Thereafter, that peripheral channel will run at the specified speed (up to 100MHz)
    Changes to the STM configuration:
    Remove all PIO (SEL, IREQ, incoming, o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
    [xio.brd, xio.sch]
2018-06-08 Start to make the changes necessary for allowing communication between the STM and the XMOS chips.
    We now have 2x54 Mbit SPI channels between the XMOS and the STM, and we don’t need to send peripheral traffic over that bus because the XMOS deals with it, itself.
    [xio.brd, xio.sch]
2018-06-10 Add the ethernet schematic
    [xio.brd, xio.sch]
2018-06-11 Baseline complete
    [xio.brd, xio.sch]
2018-06-11 Latest XIO
    [xio.brd, xio.sch]
2018-06-12 Now with 32-bit access to RAM
    [xio.brd, xio.sch]
2018-06-12 Move to a 6-layer stack-up Fix some bugs in the schematic caught by ERC
    [xio.brd, xio.sch]
2018-06-13 Autorouter route
    [xio.brd]
2018-06-14 Update the docs to reflect the new chip we’re going to use 2 of
2018-06-14 Checkpoint to un-route everything since we’re changing the chip architecture
    [xio.brd]
2018-06-15 Working on migration so we can have an external oscillator. Internal one isn’t good enough for USB
    [xio.brd, xio.sch]
2018-06-15 Start adding in the XIO peripherals
    [xio.brd, xio.sch]
2018-06-16 Some differential pair routing done
    [xio.brd, xio.sch]
2018-06-18 Start attempting to route…
    [xio.brd, xio.sch]
2018-06-19 Routed board!
    [xio.brd, xio.sch]
2018-06-19 Add the cartridge-port header for the daughterboard.
    [xio.brd, xio.sch]
2018-06-21 * Add the block-diagram * Implement the remaining items on the to-do list then route - realise that I need to add vias for power around vRegs
    [xio.brd, xio.sch]
2018-06-21 Things to change ahead of schematic review
    [xio.brd]
2018-06-22 Revision ready for routing for DR
    [xio.brd, xio.sch]
2018-06-23 Latest routed board, change out the solder bridge for a 0-ohm resistor
    [xio.brd, xio.sch]
2018-06-24 Add the stack-up info
    [xio.sch]
2018-06-25 Move some caps to be closer to their pins Add some more information text to the schematics
    [xio.brd, xio.sch]
2018-06-25 Up-to-date PDF of the schematics
2018-06-25 Add values to some of the symbols
    [xio.sch]
2018-06-25 Updated PDF of the schematics
2018-06-26 Add some more documentation to the schematic…
    - Add a diagram showing the bus cycle waveform
    - Add a diagram showing the audio level translation
    [xio.sch]
2018-06-26 Re-route a diff-pair to be better matched
    [xio.brd]
2018-06-26 Some more documentation improvements
    [xio.sch]
2018-06-27 Documentation tweaks
    [xio.sch]
2018-06-27 Add the connector datasheet
2018-06-27 Last minute changes prior to review
    [xio.brd]
2018-06-28 Part-way through the revisions after the schematic review
    [xio.brd, xio.sch]
2018-06-28 Add the voltage supervisor/reset manager documentation
2018-06-28 Latest schematic/board after most things in the review completed
    [xio.brd, xio.sch]
2018-06-28 Move some things around
    [xio.brd]
2018-06-29 Latest routed board. Next up is the change away from PSRAM to SDRAM for the XIO chip.
    [xio.brd]
2018-06-29 Update schematics regarding comments and unroute board
    [xio.brd, xio.sch]
2018-07-03 Add in the documentation for the ‘H’ processor, and the new VHDCI connector
2018-07-03 Remove the ‘xc’ directory since we’re not using the XMOS chip any more.
2018-07-03 Start to patch in the H processor for XIO
    [xio.brd, xio.sch]
2018-07-03 More updates for the ‘H’ XIO part
    [xio.brd, xio.sch]
2018-07-03 More patching in the new CPU
    [xio.brd, xio.sch]
2018-07-05 Moved to H cpu for PIO and added ESD
    [xio.brd, xio.sch]
2018-07-09 Add test points
    [xio.brd, xio.sch]
2018-07-09 Move to a 6-layer board
    [xio.brd, xio.sch]
2018-07-09 Latest board layout
    [xio.brd, xio.sch]
2018-07-10 Routable board
    [xio.brd]
2018-07-10 Routed 6-layer board
    [xio.brd, xio.sch]
2018-07-12 Add a label for the serial part
    [xio.sch]
2018-07-13 Big change.
    Due to not being able to get the parts for the full system, we’re now just laying out the slots. We can add in the video and ethernet as cards rather than them being provided as-is.
    This simplifies things a lot, now we only have 1 STM chip, and its associated SDRAM. The board is a lot smaller as well, and fits into 10cm in the Y dimension, which means making cards can be done using the cheap 10cm x 10cm board sizes that places like Seeed offer.
    Need to define a cartridge port symbol, and remap all the pins to the STM32F746BGT6 (208 pin LQFP) which is available in China.
    Assumption here is that the host-side will have an XPLA3 CPLD sitting on it, which manages the signal dire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
    [xio.brd, xio.sch]
2018-07-13 Latest snapshot
    [xio.brd, xio.sch]
2018-07-13 Routed single-cpu board - no CPLD on-board as yet.
    [xio.brd]
2018-07-15 Routed board with everything except the cartridge isolation
    [xio.brd, xio.sch]
2018-07-16 Latest routed board with cartridge port isolation
    [xio.brd, xio.sch]
2018-07-16 Update the top-level drawing power and stack-up information
    [xio.sch]
2018-07-16 Re-work the dielectric constant calculations
    [xio.sch]
2018-07-16 Simple replication of the port layout to test whether the parts fit
    [fit-test.brd, fit-test.sch]
2018-07-17 Routed board
    [xio.brd, xio.sch]
2018-07-17 Some board/schematic cleanup
    [xio.brd, xio.sch]
2018-07-26 Update to Eagle 1.1 Update the block diagram
    [xio.brd, xio.sch]
2018-07-26 Update the schematic block diagram Start to incorporate the peripherals (SDRAM, LEDs, USB)
    [xio.brd, xio.sch]
2018-07-26 Change to PCIe-64 pin slots
    [xio.brd, xio.sch]
2018-07-27 Link up the slots to the host-bus and SPI-bus
    [xio.brd, xio.sch]
2018-07-27 VGA schematic half-done
    [xio.brd, xio.sch]
2018-07-30 Start to think seriously about placement of parts
    [xio.brd, xio.sch]
2018-07-30 Start connecting up the FPGA
    [xio.brd, xio.sch]
2018-07-31 More on the FPGA and layout
    [xio.brd, xio.sch]
2018-07-31 Move to 6-layers to see if routing is better…
    [xio.brd, xio.sch]
2018-08-01 Start laying out the high speed lanes
    [xio.brd, xio.sch]
2018-08-01 Just about ready to declare an initial “this is complete” version. Needs lots of checking and manual routing over the next few weeks.
    [xio.brd, xio.sch]
2018-08-01 Lock down the USB3 traces
    [xio.brd, xio.sch]
2018-08-01 Start the process of adding GND vias
    [xio.brd, xio.sch]
2018-08-02 Add bias for 5v, 3.3v and GND
    [xio.brd, xio.sch]
2018-08-02 Fully routed board with intact power and ground planes
    [xio.brd]
2018-08-02 Update the block diagram Make the annotations layer visible in the layout
    [xio.brd, xio.sch]
2018-08-06 Lay out the SPI-bus connectivity between FPGA and STM32. There are now 3 high-speed (45 MBit/s) and 1 low-speed (22 MBit/sec) links enabled between the two chips.
    [xio.brd, xio.sch]
2018-08-06 Update the block diagram
    [xio.sch]
2018-08-06 Routed with 3 layers assigned to power/ground planes and 3 layers assigned to signals
    [xio.brd]
2018-08-06 Get rid of the old IOBUS
    [xio.sch]
2018-08-06 Latest routed board
    [xio.brd]
2018-08-06 - Add part1 of the FPGA expansion header - Add connections to the RD$,RD5 direction pins
    [xio.sch]
2018-08-06 Small fixes and part 2 of the FPGA expansion bus
    [xio.brd, xio.sch]
2018-08-07 - Add test points - Add STM bus
    [xio.brd, xio.sch]
2018-08-07 Start a last-ditch attempt to get everything into BGA format again.
    [xio2.brd, xio2.sch]
2018-08-08 Start work on the BGA STMH7
    [xio2.brd, xio2.sch]
2018-08-08 Deleted files
    [example.sch, fit-test.brd, fit-test.sch, pio.brd, pio.sch]
2018-08-08 Test-fit board for the components
    [host-1088xel.brd, host-1088xel.sch]
2018-08-08 Move older boards to a subdir
    [example.sch, fit-test.brd, fit-test.sch, pio.brd, pio.sch]
2018-08-08 Test out the BGA routability
    [xio2.brd, xio2.sch]
2018-08-10 Rotate the BGA STM so Electra can route them.
    [xio2.brd]
2018-08-10 Update the top-level block diagram to suit the new design
    [xio2.sch]
2018-08-10 Reflect changes in the PCIe library, is all
    [xio2.brd]
2018-08-12 Start integrating the S7
    [xio2.brd, xio2.sch]
2018-08-13 More work on the S7. The parallel bus is now alive
    [xio2.brd, xio2.sch]
2018-08-13 Add/Rename the datasheets for the STM32H743
2018-08-13 Work in the new configuration for the STM32H743
    [xio2.brd, xio2.sch]
2018-08-14 Update to a “working board” scenario. Need to cross-check everything, and start to work on layout
    [xio2.brd, xio2.sch]
2018-08-14 Change power resistor/capacitor sizes to prevent overlap of signal wires, given their size for power transmission reasons
    [xio2.brd, xio2.sch]
2018-08-14 Move around some of the connections to allow the pins to be routed on the top level
    [xio2.sch]
2018-08-14 Hand route the USB-3 connections
    [xio2.brd]
2018-08-15 Small changes, nothing of real significance, just doc/prettiness updates
    [xio2.brd, xio2.sch]
2018-08-16 Move some things around to make space for the incoming voltaage-regulators
    [xio2.brd]
2018-08-18 routed board with new 1.5A vcco PSU
    [xio2.brd, xio2.sch]
2018-08-19 Added debugging aids and routed board
    [xio2.brd, xio2.sch]
2018-08-20 Some more tidy-up
    [xio2.brd, xio2.sch]
2018-08-21 Fix up the ERC warnings Add a port expander for the Slot presence lines Add part numbers for debugging LEDs
    [xio2.brd, xio2.sch]
2018-08-22 No changes of note. Just keeping in sync
    [xio2.brd, xio2.sch]
2018-08-22 Add slot signals between slots 1&2 and 3&4. Grounds on S5 Add capacitor to VBUS Removed the old annotations Changed resistors for STM debug leds Add pull-ups on TMDS inputs (TX lines on this schemati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
    [xio2.brd, xio2.sch]
2018-08-22 Change the input clock to 25MHz for STM. This is based on STM32Cube calculations
    [xio2.brd, xio2.sch]
2018-08-22 Tidy-up for PDF release
    [xio2.sch]
2018-08-22 PDF of circuit for design-review 2
2018-08-22 Approve an ERC violation
    [xio2.sch]
2018-08-24 Latest schematic and routed board
    [xio2.brd, xio2.sch]
2018-08-24 Autorouter script to route the board
2018-08-27 Update some BOM-related things
    [xio2.brd, xio2.sch]
2018-08-27 Some small notes on layout
    [xio2.brd, xio2.sch]
2018-08-27 Update the TI vreg
    [xio2.brd, xio2.sch]
2018-08-27 Design review first changes
    [xio2.brd, xio2.sch]
2018-08-27 Simple changes from design reviews completed.
    [xio2.brd, xio2.sch]
2018-08-28 Minor changes
    [xio2.brd]
2018-08-28 Incorporate the changes from the design-review, including switching regulator for 1.0v
    [xio2.brd, xio2.sch]
2018-08-28 routed and vias
    [xio2.brd, xio2.sch]
2018-08-28 Make the 5V switch have a defined area for the XIO_USB_VBUS signal, so there’s a nice path between 5v and the port, via the switch.
    Also add thermal vias to the slot regulators
    Also add thermal/signal vias to the PSU entry
    [xio2.brd]
2018-08-29 Improve the layout by enacting most of the notes-to-self at the bottom of the board
    [xio2.brd]
2018-08-29 Improve the labelling on the board. Will probably need minor tweaks once the board is finally routed
    [xio2.brd, xio2.sch]
2018-08-29 Added ground-loop caps across plane boundaries as per Amrith’s recommendation
    [xio2.brd, xio2.sch]
2018-08-29 Routed board. SDRAM has a long line…
    [xio2.brd]
2018-08-29 Latest routed board. Still needs some work on clearances.
    [xio2.brd, xio2.sch]
2018-08-30 Change power plug footprint Start process of migrating to switching regulator for all of +3v3 supply on main board Perhaps have one more switching regulator for all slots ?
    [xio2.brd, xio2.sch]
2018-08-30 Consolidate all the 3.3v regulators into a single 10A regulator.
    [xio2.brd, xio2.sch]
2018-08-30 Schematic for +3v3 design from TI’s web-bench
2018-08-30 Replace the 1.8v LDO with a switching regulator
    [xio2.brd, xio2.sch]
2018-08-31 Getting towards a release candidate. The PSU side is done, need to test-route.
    [xio2.brd, xio2.sch]
2018-09-03 Start adding the USE attributes to the components
    [xio2.brd, xio2.sch]
2018-09-04 All pins checked vs data sheets All parts provisionally given USE attributes
    [xio2.brd, xio2.sch]
2018-09-05 Catch the last couple of cases where USE attributes or NOSTUFF attributes were not set
    [xio2.brd, xio2.sch]
2018-09-05 Add a facility for external power
    [xio2.brd, xio2.sch]
2018-09-05 Changes for the new inductor in the power-supply section
    [xio2.brd, xio2.sch]
2018-09-05 Updated board and schematic - all parts now from Seeed library
    [xio2.brd, xio2.sch]
2018-09-05 Add script to parse through the BOM generated by Eagle, and create one that is acceptable to Seeed.
    [seeed.csv]
2018-09-12 Updates to the latest revision for the reddit review
    [xio2.brd, xio2.sch]
2018-09-13 Second fit-test board
    [fit-test-2.brd, fit-test-2.sch]
2018-09-13 Update to a supported flash type
    [xio2.sch]
2018-09-13 Notes for implementation
    [xio2.brd]
2018-09-14 Use MAX4382EUD as op-amp note added
    [xio2.sch]
2018-09-17 - Move to a 64MB RAM chip, which meant using a 16-bit port expander - Add an op-amp to the output stage of the VGA connector - change the bus drivers to drive 5v rather than 3.3v on the VGA
    [xio2.brd, xio2.sch]
2018-09-17 Add a discovery-board project to explore video output
2018-09-17 Tweaks to layout to get better part separation Rename XSPI bus properly Add NOSTUFF to fix ERC errors Add some notes to the schematic
    [xio2.brd, xio2.sch]
2018-09-17 Route the XIO_USB_{P,N} now that the STM32 chip is rotated
    [xio2.brd, xio2.sch]
2018-09-18 Move some things around on the board
    [xio2.brd]
2018-09-18 Some minor changes in layout
    [xio2.brd, xio2.sch]
2018-09-24 Text changes
    [xio2.brd]
2018-10-16 Migrate to ADV7125 video out
    [xio2.sch]
2018-10-31 Remove the old board gerber-file and add the ones we used for fabrication
2018-10-31 Changes to make Seeed’s build system accept the BOM.
    [seeed.csv, xio2.brd, xio2.sch]
2018-12-13 xio2 spreadsheet that goes to seeed, along with the warnings from the PHP script
    [xio2.csv]
2018-12-13 Some details on the 3.3v power solution
    [3v3.csv]
2018-12-13 Project from STM32CubeMX
    [New_configuration.cfg]
2018-12-14 Set up the ARM chip eclipse workspace, configure for interactive GUI debug and verify that code can be compiled, flashed down to the chip, and breakpoints are handled
    [New_configuration.cfg, Run config.cfg]
2018-12-14 Quick test to prove the LEDs work
2018-12-18 Get SDRAM memory working, and print out the CPU speed on boot.
2018-12-19 Get malloc working, at least via the pvPortMalloc() call. We may want to have two separate malloc heaps, one for the OS calls, and generally small areas, one for larger areas.
    It seems that malloc() and pvPortMalloc() are separate calls, so could use AXI SRAM (512k) for pvPortMalloc, SDRAM for malloc() if we implement _sbrk() and put the stack growing down from the top of SRAM3 (giving 288k of stack)
    That leaves SRAM4 as a work-area of 64k, and the ITCM and DTCM which we’ll use for interrupts.
2018-12-20 Eclipse stuff that didn’t get checked in 2 checkins ago
2018-12-21 Just to ease routing length matching, put the SD card closer to the MCU and move the switches out the way, they’re essentially static anyway.
2019-08-27 Simplify by using an existing FPGA board
    [seeed.csv, xio3.brd, xio3.sch]
2019-08-28 Attempt at 3rd version of board, this time using a COTS FPGA board
    [xio3.brd, xio3.sch]
2019-08-28 Start to connect up the cartridge port
    [xio3.brd, xio3.sch]
2019-08-31 Before deciding which signals to drop for S4,S5
    [xio3.brd, xio3.sch]
2019-09-01 - Add a +5v plane to cover where useful - Have a better placement of the HBUS extension - Gives at least 10cm of space for cards
    [xio3.brd, xio3.sch]
2019-09-03 Snapshot for trial using Artix board, and move to Z-turn lite board
    [seeed.csv, xe-sas.brd, xe-sas.csv, xe-sas.sch, xio4.brd, xio4.sch]
2019-09-04 Start looking at the mezzanine board
    [seeed.csv, xio4.brd, xio4_mez.brd, xio4_mez.sch]
2019-09-05 Add the HDMI stage
    [xio4_mez.brd, xio4_mez.sch]
2019-09-05 Use the corrected footprint for the Mezzanine board, and route the HDMI critical signals.
    [xio4_mez.brd, xio4_mez.sch]
2019-09-06 Add the SPI routing
    [xio4_mez.brd, xio4_mez.sch]
2019-09-06 First pass at a “finished” board
    [xio4_mez.brd, xio4_mez.sch]
2019-09-06 Almost routed. Fixed tx100 net classes
    [xio4_mez.brd, xio4_mez.sch]
2019-09-06 Fully routed board
    [xio4_mez.brd, xio4_mez.sch]
2019-09-06 Add the CSV files
    [output.csv, xio4_mez.csv]
2019-09-08 Play with pricing
    [out.csv, output.csv, seeed.csv]
2019-09-08 Square 17cm board, using Turn (full) module
    [xio5.brd, xio5.csv, xio5.sch]
2019-09-09 Start adding busses
    [xio5.brd, xio5.sch]
2019-09-09 Reorganise slot signals (ZBUS) and add the internal slot expansion interface (XBUS)
    [xio5.brd, xio5.sch]
2019-09-10 Work on some of the internal expansion stuff
    [xio5.brd, xio5.sch]
2019-09-10 Correct the SPI interface bugs
    [xio5.brd, xio5.sch]
2019-09-11 First pass at a ready-to-go board. Now to debug
    [xio5.brd, xio5.sch]
2019-09-11 Start the process of verifying the schematic
    [xio5.brd, xio5.sch]
2019-09-11 Board parts verified. Circuit to be checked. BOM manipulated a bit, save $500 @ q50, or $140 @ q5
    [xio5.brd, xio5.csv, xio5.sch, xio5_bom.csv]
2019-09-12 Add two connectors to stand in for the Zynq board
    [xio5.brd, xio5.sch]
2019-09-15 Routed at 4/4
    [xio5.brd, xio5.sch]
2019-09-17 Freshen up the software stck
    [Run config.cfg, xio5.cfg, xio5.dsn]
2019-09-18 Take on a new look at the idea, using the STM32MP1 chip. Race the bus on the one hand, and run linux on the other…
    [seeed.csv, xio.brd, xio.sch]
2019-09-19 Get the smaller PCIe slots organised
    [xio.brd, xio.sch]
2019-09-23 More work on the dual-core STM
    [xio.brd, xio.sch]
2019-09-23 Prototype work for the dual-core STM
    [out.csv, xe-lvl.brd, xe-lvl.sch, xio.csv, xio.sch]
2019-09-23 Get the power and DDR parts sorted out. Still needs layout on the DDR.
    [xe-lvl.brd, xe-lvl.sch]
2019-09-23 Started on capacitor/terminator layout for the DDR
    [xe-lvl.brd]
2019-09-23 Latest layout
    [xe-lvl.brd, xe-lvl.sch]
