ThrudTheBarbarian/pbxl/(notices)

Notices in the files:
boards/xio4/xio4.brd:
© 2019 SjG
boards/xio2/xio2.brd:
© 2018 SjG
boards/xe-interface/xmosio2_unrouted.brd:
(c) 2018 SjG
parts and their libraries:
SparkFun: Licensing: CC v3.0 Share-Alike You are welcome to use this library for commercial purposes.
microbuilder: This work is placed in the public domain, and may be freely used for commercial and non-commercial work with the following conditions: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
InputOutputIO: Copyright: Würth Elektronik
